chenxi-z/de-drms/README.md

# DE-DRMS — 双电极直流电阻测量仪

> **2026-11-04：直流首板 + 扫频预留。** 当前固件已接通测量、参考校准、TF记录和双通信口，并提供主机回归与CSV解码工具；实板性能尚待验收。见[固件使用流程](firmware/DE-DRMS-Code/README.md)和[设计入口](docs/design/README.md)。IOC与原理图/PCB本轮未改，旧性能与旧引脚描述不能当验收依据。

本工作区用于研发一套**双电极直流电阻测量仪**，对两端 MWCNTs 导电网络传感层做**结构损伤分级监测**，
涵盖上位机软件、下位机固件、硬件电路、结构件，以及配套的校准、测试与生产工艺。

测量原理为**恒流激励 + 双通道同步实测**：恒流同时流过传感层与精密电阻 Rsense，
ADC 同步采两者压降，按 `R = (V_sample / V_Rsense) × Rsense` 计算电阻，
参考校准后以 `R=k×V_sample/V_Rsense` 计算。后续损伤等级须由该批试件的 **R/R₀** 标定曲线确定；
当前LED表示运行/记录状态，没有虚构分级阈值（详见 [`docs/design/`](docs/design/README.md)）。

## 当前状态

- 当前器件为 **STM32U575RGT6（1 MB Flash / 786 KB SRAM，无SMPS）** + ADS131A02 双通道同步 ADC，
  USB外设为 **USB_OTG_FS**，记录走 **SDMMC1 4-bit**。TF常电，无I²C/TMP117，PA4保持ADS_CS。
  硬件实装与最新引脚以主文档附录F、`docs/design/pin-assignment.md`和用户EDA为准。
- 固件已实现 ADC 上电/回读/CRC/DMA、有界采集、参考校准和双页Flash保存、FileX记录/滚动/容错、
  USB/USART控制、RTC/电池、按键与安全软关机。默认 **4 kSPS**。实板实测 **64 kSPS 是无损上限**
  （16/32/64 kSPS 均零丢样、零 CRC 错）；**128 kSPS 受 ADC 读取时序限制不可用**，采集入口直接拒绝。
  64 kSPS 连续记录约 68.65 s / 4,393,647 帧已在单张卡上通过；其他卡、1 GiB 实物轮转与掉电恢复仍待验收。
- [机器协议](shared/protocol/de-drms-v1.json)与[人读说明](docs/protocol/de-drms-v1.md)成对维护；
  [CSV解码工具](tools/de_drms_log.py)保留坏帧/丢帧诊断，不将正常关闭误当无损采集。
- 尚须实板验证精度、连续吞吐、晶振裕量、实际卡与掉电恢复、USB枚举/挂起/唤醒。
  **BQ24074当前模式接线不能仅靠EN1满足USB挂起取电要求**。无温度补偿，损伤阈值仍需试件标定。
- EDA由用户维护；上位机GUI、结构与生产工艺仍是后续工作。当前可用串口/USB终端控制和命令行导出CSV。

## 仓库结构

| 目录 | 归属 | 内容 |
| --- | --- | --- |
| `host/` | 上位机 | 仪器控制、测量流程编排、数据记录、报告导出 |
| `firmware/` | 下位机 | 激励源控制、电压/电流采集、通信从机、自检 |
| `hardware/` | 硬件 | 原理图、PCB、BOM、器件库、硬件设计说明 |
| `mechanical/` | 结构 | 外壳、电极夹具、装配图与 3D 模型 |
| `shared/protocol/` | 共享 | 上下位机通信协议的**机器可读**定义（报文、命令集、错误码） |
| `docs/spec/` | 文档 | 产品需求与技术规格 |
| `docs/design/` | 文档 | 系统设计与详细设计 |
| `docs/protocol/` | 文档 | 通信协议的**可读**说明，与 `shared/protocol/` 配套 |
| `docs/user_manual/` | 文档 | 用户手册、操作与维护说明 |
| `calibration/` | 质量 | 校准方法、校准记录、标准器溯源信息 |
| `test/` | 质量 | 测试计划、测试用例、自动化测试脚本 |
| `production/` | 生产 | 烧录、工装、产线测试与出厂记录 |
| `tools/` | 研发 | 辅助脚本与工程工具 |

### 单一事实来源

通信协议存在两份载体，用于避免定义漂移：

- `shared/protocol/` 存放机器可读的权威定义，供固件与上位机直接引用或生成代码；
- `docs/protocol/` 存放面向人的说明文档。

**修改协议时必须成对更新，并在同一次提交中完成。**

## 开发约定

- **分支**：`main` 保持可交付基线；功能与修复使用 `feat/…`、`fix/…` 短生命周期分支。
- **提交信息**：采用 Conventional Commits 风格，例如
  `feat(firmware): 增加 R_ref 自校准流程`。
- **行尾**：仓库内文本统一为 LF，由 `.gitattributes` 固定；Windows 批处理脚本保留 CRLF。
- **缩进**：由 `.editorconfig` 约束，提交前请确认编辑器已启用 EditorConfig 支持。
- **入库范围**：只提交源文件与文档。固件产物（`hex` / `bin` / `elf`）、EDA 输出、
  3D 导出件与编译目录一律不入库；**器件手册、论文、厂商参数表等外部资料一律放 Obsidian 库**
  （`20-硬件工程/`），本仓库不存放；正式发布件如需留档，在对应目录用局部
  `.gitignore` 的 `!` 规则单独放行。
- **入库守卫**：`.githooks/pre-commit` 会拒绝外部资料（pdf/Office/压缩包）与单个 >1 MiB 的文件；
  每个克隆执行一次 `git config core.hooksPath .githooks` 启用。唯一例外：
  `docs/design/diagram/*@2x.png` 示意图预览（给人看的交付件，经确认保留）。
- **空目录**：以 `.gitkeep` 占位；新增目录请沿用同一约定。
- **语言**：文档与注释以中文为主；代码标识符、协议字段与目录名使用英文。

## 待办与未决事项

**已决策**（依据见 [`docs/design/`](docs/design/README.md)）：测量拓扑（恒流测电阻，不做电桥）、
激励（8 µA + Rsense 150 kΩ）、ADC（ADS131A02 双通道同步）、**MCU（STM32U575RGT6，2026-10-28 换型）**、
电源（1S 锂电 + **BQ24074** + 双 LDO）、**温度传感（本版不做，无 TMP117）**、通信（USB FS 双角色）、
**记录（外部 TF 卡，SDMMC1 4-bit，常电无电源开关，E.11）**、
R_ref 自校准电路（TMUX110x 切换）、引脚/时钟/电源域/交互（主文档 E.6–E.9、E.11；**引脚 2026-10-14 全表重排 + 二轮复核**）。

**未决 / 待实测**：

1. **分档阈值**：绿/黄/橙/红判定对应的 R/R₀ 值——需该批试件的 R/R₀–位移标定曲线（客户暂留空）。
2. **温度系数标定**：需实测（论文值 −4 ~ −10 %/℃ 仅作参考）。
3. ~~R_ref 自校准电路~~ **已定稿**；E.10 挂起项：✅ **#1–#5、#8–#10 已清**；
   **#11 ADC 待机 IOVDD 电流**（合法性已定案，只剩数值待上板实测）；
   **#6 方向性 BOM**（设计侧规格已定，价格/库存/交期由用户核实，**含 TF 卡座与卡型号**）、
   ~~**#7 TMP117 连接器**~~ → ✅ 2026-10-28 关闭（本版不做 I²C）；
   **🔴 2026-10-14 新增 #12–#17，当日晚二轮复核已清两项**：✅ **#12 DS14216/SLUS941 五项**
   （PC0=ADC1_IN1/PC1=ADC1_IN2、高阻源 100 nF 电荷池合法、低功耗表号 Table 62/65/68/70、
   BQ24074 PG 脚 = pin 7、SDMMC 仅 PC8–PC12/PD2）与 ✅ **#15**（CRS 用内部 SOF，不占引脚）已销号；
   ~~#16 IOC 时钟源与免晶振矛盾~~ ✅ **2026-10-28 关闭**（首板贴 HSE 16 MHz，HSE-PLL 合法）；
   **#14 SDMMC 时钟源需把 PLL2Q（258 MHz，`SDMMCFreq_Value` 现值 80 MHz）重配到 48 MHz**（阻塞生成代码）；
   **#17 RM0456 四项**（片内 BCD 使能路径 / SMPS 脚处置 / 复位默认稳压器 / **ADC1 采样时间离散档**，②阻塞原理图，④不阻塞）；
   **#13 TF 持续写实测**（768 KB/s 是否丢帧，上板后）；
   **PB4 复位态（2026-10-16 新增）**：PB4 复位后 = NJTRST + 内部上拉（Table 27 注 4）→ 默认 500 mA 须外部下拉保证，原理图阶段核。
4. **"R₀ 的 1%"适用区间**与量程下限：待客户确认。
5. **上位机功能范围**：曲线显示、温度补偿、数据导出；**新增：TF 卡记录文件的格式与取数方式**（走 USB 还是拔卡）。
6. ~~物理链路细节~~ USB FS 已定；供电与充电管理协同已定（E.8）；
   **充电固定 500 mA**（2026-10-22 简化，BC1.2 判档逻辑已删；详见 E.8.4）。
7. **引用标准**：是否需符合特定标准（待评估）。
8. **项目命名**：`DE-DRMS` 正式英文展开与产品型号；单位 Ω/cm² 与 Ω/sq 定义待统一。
9. **爆炸试验线**（若客户需求落实）：与论文体系不同，待澄清后另立方案。
10. **示意图再核**：2026-10-17 已按当时 E.6 修正；2026-10-20 二次重排（ADC 控制簇 PA1/PA2/PA3、USART1 PA9/PA10）与 TMUX1134 整合需再核一遍。

## 许可

尚未确定。
