chenxi-z/de-drms/hardware/sim/ccsource/README.md

# 恒流源 LTspice 拓扑验证（2026-10-13）

验证对象：E.2 恒流激励源的两种候选接法（LTspice 26.1.1 / wine，`ltspice-sim` 批处理）。

## 结论

**定稿接法（变体 A）**：运放同相端 = VSET，反相端 = BSS138 源极（B），Rsense 自源极到地（E = GND），
BSS138 漏极（X 节点）接负载回线。I = VSET/Rsense，与 R_sample 无关。

| R_sample | I（推导自 V_sample/R） | V(b)=V_Rsense | V_sample | V_DS 裕量 | V_G |
| --- | --- | --- | --- | --- | --- |
| 10 kΩ | 7.857 µA | 1.17857 V | 78.57 mV | 2.043 V | 2.710 V |
| 20 kΩ | 7.857 µA | 1.17857 V | 157.14 mV | 1.964 V | 2.711 V |
| 60 kΩ | 7.857 µA | 1.17857 V | 471.43 mV | 1.650 V | 2.713 V |
| 120 kΩ | 7.857 µA | 1.17857 V | 942.86 mV | 1.179 V | 2.716 V |

（Rsense 与 Rsample 两路电流互推一致 <0.001%；VSET = 3.3×200k/560k = 1.178571 V，与 E.2.1 一致。）

**证伪接法（变体 B，原 E.3.1/rref 图字面链：Rsense 在漏极路径、B 经调整管到地）**：
环路为**正反馈**——V(b) 随栅压升高而降低，仿真显示其锁死在零电流态（调整管关断、V(b) 顶到 3.3 V），
不能恒流。理论平衡点 I = (V_T−VSET)/(R_sample+Rsense) 随 R 变 13.2→7.8 µA，且该点不稳定。

**CURR_DIS 暂态**（3 ms 拉高关断 / 8 ms 释放使能，R_sample = 10 kΩ）：
- 关断：<0.2 ms（τ≈30 µs），残流谷值 0.163 µA（满度 2%；VSET 残压 24 mV，与 E.2.1 "VSET≈0" 相符）
- 使能：**0.871 ms** 回到 ±0.1%，无过冲无振铃 → E.3.3 的 ~1 ms 换路预算内（不宽裕，测量窗口前预留 ≥1 ms）

## 性能指标（cc2 套件，2026-10-13；最新拓扑：R_top/R_b 顶端偏置 + K1 + 源极采样）

模型升级：BSS138 电容按手册（Ciss 12.2p/Crss 1.43p）、OPA333 输入电容（差分 2p/共模 4p）。
网表 `cc2_*.net`，一键报告 `python3 perf_report.py`（六项全量）。

| 指标 | 结果 | 备注 |
| --- | --- | --- |
| 负载调整率（1–130 kΩ） | **0.00000 %** | 源极深度负反馈 + Aol 2e6，理想 |
| 电压调整率（3.20–3.40 V） | **1:1 随轨**（6.25%/0.2V = ΔVS/VS） | VSET 比例分压的**设计特性**：电流线性跟轨；比值测量 V_sample/V_Rsense 中抵消，非精度项 |
| 环路增益 | **fc ≈ 248 kHz，PM = 70.1°**；\|T\| 0.1 Hz 处 123.7 dB | 运放输出串联注入（上游 100 Ω/下游栅极 1 GΩ 旁路）；PM 充裕，**无需补偿** |
| 电源纹波响应 | ΔI/I = 0.3030（=1/3.3，ratiometric 理论值），10 Hz–10 kHz 恒定 | 电流纹波与轨纹波保持精确比例 → 双通道**同步采样**下比值抵消成立；100 kHz 起轻微劣化（0.3248） |
| 负载阶跃 10k↔120k（2 µs 边沿） | 峰值 −2.5 %/+3.1 %，**±0.1 % 恢复 1.3 µs** | 源极负反馈本地自稳，运放只做微调 |
| 轨阶跃 ±100 mV（20 µs 边沿） | 过渡 ∓2.9 %/+3.0 %（相对各自新稳态），**恢复 9–10 µs** | 新稳态=比例跟轨值（见②）；测量窗口 ms 级，µs 级瞬态无害 |

**对设计的含义**：动态响应比准静态测量需求快 3 个数量级（最差 10 µs vs ms 级窗口）；
E.3.3 换路 ~1 ms 预算主要消耗在使能建立（0.87 ms，见上节），负载/轨扰动恢复都在 µs 级。
**注意**：④/② 的"电流随轨"意味着两通道必须同步采样才能在比值中抵消电流波动——
ADS131A02 双通道同钟同沿（E.4）正是为此。

方法备忘：`.tran` 首参数是**步长**非时长（`.tran 0 15m 1m 1u`）；LTspice 的 `tstart` 会把
PULSE 时序前移 tstart，暂态判据一律从激励波形实际边沿起算；AC raw 的频率行带 `,0` 尾巴。

## GUI 原理图（ccsource.asc，2026-10-13）

**LTspice 双击打开即可看图并仿真**：定稿拓扑的可视化版本（R_top/R_b 偏置、CURR_DIS、
Vsm 电流表）。由 `gen_asc.py` 程序化生成（引脚坐标/正交布线/T 接全部显式计算），
改动请改脚本再生成，勿手编辑后混用。已验证：网表与 cc2_dc.net 逐节点一致（零 NC）、
I(Vsm)=+7.857 µA、CURR_DIS 关断残流 0.163 µA、恢复 1 µs（PULSE 5–10 ms 高电平，
15 ms 窗口内含完整关断+恢复）。注意：`opamp` 符号引脚顺序是 (invin, noninvin, out)，
宏 `opa333t3` 已按此定义（arg1=反相）；U1 为 3 脚行为宏（内部固定 3.3 V 轨）。

## 文件与再生成

- `models.inc`——行为级模型：OPA333 宏（Aol=2e6→GBW 350 kHz、输出钳位）与线性版（暂态用）；
  BSS138 level-1（VTO 1.25 V 典型）。**拓扑级保真度**，非厂商宏模型。
  2026-10-13/14 增补：`opa391t3`（OPA391 评估，GBW 1MHz）、`opa388t`（跟随器，GBW 10MHz/RRIO）、
  `swNO`（TMUX 行为级，Ron 2Ω/断态 60GΩ=50pA@3V；2026-10-18 起实物为**单颗 TMUX1134**，开关行为等价）、`swsh`（采样保持开关）
- `cca.tpl` / `ccb.tpl`——两种拓扑模板；`cca_tran.net`——CURR_DIS 暂态
- `cc4_*_opa391.net`——OPA391 对照套件；`cc5_*`/`cc6_*`——10kHz 纹波/斩波；`cc7_*`——100ns 冲击；
  `cc8_ramp10ms.net`——10ms 斜坡；`cc10_rate_*.net`——变化率拐点；`cc11_noise.net`——噪声谱
- `fs1_static.net`/`fs2_shock.net`/`fs3_seq.net`——全链三场景（fs3=零点/校准/测量完整时序，是 fs1/fs2 的母本）；
  `fs4_upper.net`/`fs5_lower.net`/`fs6_upper2.net`（含 ADC 满量程削波）——上下限
- `bode_loop.png`/`tran_10khz.png`/`limits_report.png`/`fullchain_report.png`/`range_limits.png`——交付图
- 再生成：`sed "s/{RL}/10k/" cca.tpl > cca_10k.net && ltspice-sim run cca_10k.net`
- 产物（*.raw/*.log、按 RL 生成的 .net）不入库

## 恒流源拓扑与运放选型评审结论（2026-10-13 首评，2026-10-14 终审封存）

**拓扑：维持"运放+NMOS 源极采样低边恒流源"定稿**（四路独立证据收敛：解空间推理、联网器件普查、行为宏仿真、OPA391 实测对照）。替代方案逐一评审排除：
- Howland 电流泵（2026-10-14 深审修正理由）：①**破坏"同一电流"前提**——泵入口节点的反馈分压网络是样品电流的旁流通路（绕过 Rsense 回地），要压到 0.1% 需百 MΩ 级网络，1pF×100MΩ≈10Hz 主导极点+PCB 漏电不可实现；②合规栈多吃 I×R_B≥0.4–0.9 V（比 BSS138 VDS(sat) 0.2 V 差 0.2–0.7 V，R_max 支持度 216k→130–190k）；③无天然关断（需串开关=开关器件回来）。四电阻失配本身反而**不是**理由（被比值抵消）——原"失配直进误差"表述有误，2026-10-14 勘误
- 专用恒流芯片（BCR/AL 系 LED 驱动）：最小档 10–15 mA（BCR401W 实查 0.91 V 压降、AL5809 2.5 V），8 µA 不覆盖——不可用
- REF200 电流参考：固定 100 µA 镜，8 µA 需分流且精度降级——不适用
- LM334（2026-10-14 定量出局）：比值测量能赦免其 +0.33%/℃ 温漂，但 ~1 V 起始压降使合规栈 = 1.18+0.94+1.0 = 3.1 V > 2.47 V——量程崩
- 比例式基准（Rsense 接 ADC REF，2026-10-14 手册钉死）：ADS131A02 的 REFEXT 外基准虽内部带缓冲（原 ADS127L11 的"基准输入电流致命"理由消失），但 **REFEXT 合法输入 MIN 2.0 V / MAX AVDD−0.5 V**（SBAS590E EC 表 VREF 行；TYP 列的 2.5 V **不是上限**，2026-10-14 勘误），V_Rsense=1.18 V 低于 2.0 V 下限；强行抬到 2.0 V 则 I=13.3 µA、合规栈只剩 ≈0.27 V 给样品 → **R_max 缩到 ≈20 kΩ**（计管压降；不计则 ≈35 kΩ，原文"~30k"取的是后者），远低于 120 kΩ 需求；收益（消内部基准 6 ppm/℃）已被 R_ref 校准+TMP117 覆盖——三重出局（范围/量程/收益）
- 无 MOS 方案（2026-10-14 全否）：BJT（基极电流 1/β≈0.5–1% 破坏串流前提）、JFET 恒流二极管（±10–20%、无 8 µA 档、无使能、压降 1–3 V）、运放输出直驱（合规更差、无使能、环路需重验）
- cascode 双管提输出阻抗：负载调整率已 0.00000%，无空间——无必要
- 高边 PMOS：破坏 T 节点偏置架构（E.10#8 定稿）——不改
- LM7705 负压轨技巧（2026-10-14 联网检索唯一真杠杆）：压的是 Rsense 压降项——那是测量对象本身，不可用

**运放：维持 OPA333 定稿**，对照分析：
- 更快零漂（OPA189 1MHz/Iq450uA、OPA378 900kHz/Iq350uA）：恢复已富余 3 个数量级（1.3us vs 1ms 预算），GBW 翻倍无收益，Iq 贵 20 倍——劣
- 纳米功耗零漂 LPV821（Iq~325nA/GBW~8kHz，参数待核实）：省 ~16.7uA IQ 对电池待机有吸引力，但环路 fc 降至 ~8kHz、CURR_DIS/换路建立变慢，Vos max 略高——记录为**待验证低功耗候选**（需官方模型仿真验证 PM 与关断动态后再定；注意模拟轨受控占空比下平均收益微小，仅连续监测模式有意义）
- 非零漂精密（OPA2277 类）：温漂回归软件补偿压力——劣
- **OPA391（2026-10-13 实测行为宏 cc4 套件，用户要求评估"更快建立"）**：GBW 1MHz（3×）确实把 fc 从 248 kHz 提到 564 kHz、负载阶跃恢复从 1.28/1.32 µs 提到 0.94/0.96 µs；**但 CURR_DIS 使能建立 0.887 ms vs 0.888 ms 完全无改善**——使能建立的瓶颈是栅极 1 nF 滤波 × M2 释放后的 RC 充电，与运放 GBW 无关。代价：非零漂（Vos 45µV max vs 10µV）、Iq 23.5µA（+38%）、PM 从 70.1° 降至 60.8°。**结论：用户想要的"更快建立"通过换 OPA391 买不到，若真要压缩使能建立需减小栅极滤波电容或改 CURR_DIS 机构（另行评估）。维持 OPA333。**
- ISL28133（2026-10-13 联网检索）：纸面 OPA333 平替（Iq 18µA/Vos 8µV），GBW 未核实到权威数据——不值得折腾

## 动态与冲击能力（cc5–cc11 套件，2026-10-14）

| 套件 | 内容 | 结果 |
| --- | --- | --- |
| cc5 | 10 kHz 轨纹波 ±100 mV 暂态 | 电流纹波 6.07%（两款运放一致；VSET 1:1 跟轨特性，ADC ΣΔ 平均+比值抵消） |
| cc6 | 10 kHz 斩波使能（50µs 通断） | **不可行**：开窗内电流只爬到 33%（2.58 µA），锯齿波——使能建立 0.887 ms 瓶颈；斩波式激励与现有 CURR_DIS 机构互斥 |
| cc7 | 100 ns 边沿负载突变（冲击最坏） | 峰值偏差 −42.9%（寄生电容位移电流，与运放无关：OPA333/OPA391 均同值）；±0.1% 恢复 1.2 µs |
| cc8 | **10 ms 斜坡 R 10k→120k（用户实际冲击场景）** | **跟踪误差 <0.000023%**，电流偏差 0.00015%——零改动胜任；用户确认冲击为 10 ms 级 |
| cc10 | 变化率拐点扫描 | ≥10 µs 变化误差 <0.003%；5 µs→0.013%；1 µs→0.29%（µs 级由比值逐点抵消兜底） |
| cc11 | 输出电流噪声谱 | ~0.5 pA/√Hz → 64 kHz 带宽内 0.13 nA RMS = **0.0016% 噪声底** |

**µs 级突变的机理结论**：−43% 尖峰是 C·dV/dt 位移电流（MOS 管仅占寄生一小份，样品分布电容/布线/ADC 前端占大头，换任何激励源都在）；但比值测量逐点抵消电流畸变——**R=(V_sample/V_Rsense)×Rsense 在每个采样点成立，与恒流恢复与否无关**。

## 全链与极限仿真（fs 套件，2026-10-14）

全链 = 恒流源+K1–K4 开关网络（TMUX 行为级含 50 pA 断态漏电）+R_ref 100k+3×OPA388 跟随器+1k/10n RC+ADC 行为模型（130k 差分负载+500 µV 失调+128kSPS 采样保持+满量程削波）。δ0/k/R 全部由 LTspice 内部采样保持电路实时计算（行为源 B_*），probe 只读数。

| 套件 | 场景 | 结果 |
| --- | --- | --- |
| fs3 | 零点→校准→测量完整时序（E.3.3 固件序列） | **δ0=505.4 µV**（500 ADC+5.4 K2 漏电，与 E.3.4 预算逐项吻合）；修正读数 46999.7Ω @真值 47000Ω = **−0.001%**；未校准 +0.094% |
| fs1 | 静态 R 扫描 10k–120k（六点） | 修正后误差 ≤0.0053%（最差 10k 端）；未校准 +0.60%→+0.011% |
| fs2 | 10 ms 冲击全链（含 ADC 采样） | 表面误差 −1.1%@低端为**相位滞后**（全链群时延 ~15 µs = RC 10 µs+采样孔径）；对齐后 **≤±0.045%**，稳定后 0.0000% |
| fs4/fs6 | 上限 120k→1M（fs6 含 ADC 满量程削波） | 比值把上限从合规墙 215k 推到 **~600k**（ADC FS 2.442 V 处 V_sample=2.408 V 贴满）；600k 处 −0.083%，700k 削顶 −1.7%，1M −7.2% |
| fs5 | 下限 10k→10Ω | **恒定 −0.73Ω 偏置**（K2 漏电 5.4 µV 机制实测复现=E.3.4 预算下沿）；1% 线在 **73Ω** |

**测量能力定版（2026-10-14 按手册 INL 修正位定级）**：设计量程 10–120 kΩ（≤0.005%）；1% 可用范围 **~73 Ω–600 kΩ**（4 个十倍程）；定级**随 R 变**——**@120 kΩ ≈4½ 位精度**（fs1 实测 ≤0.0053 % = 53 ppm，恰贴 4½ 位线 50 ppm；INL 折算 21–52 ppm 同量级）、**@10 kΩ 降到 4 位（typ 248 ppm）/ 3½ 位（max 621 ppm）**，INL 主导；**5½ 位分辨率**（准静态，分辨率≠精度，不可混称）；全速冲击 4 位。绝对精度锚定 R_ref 单点（**Rsense 在 k 校准中约掉**，E.3.2 公式展开）。
> INL 手册值 **TYP 8 / MAX 20 ppm FS**（SBAS590E DC PERFORMANCE，best fit）。原文写"4½ 位精度（0.002–0.01 % 测标准电阻）"有两处问题：① 未按 R 分档，② 0.002 % = 20 ppm **低于 INL 硬底**（@120 kΩ 就有 21–52 ppm），故一并更正。位级约定：4½ 位 ≤50 ppm、5½ 位 ≤5 ppm。

**ADC 噪声定级（手册 SBAS590E Table 1，3.3V/2.442V/Gain=1）**：OSR=32（128kSPS）**96.82 µVrms** → 全速单点绝对分辨率 σ_R=96.82µV/7.857µA=**12.3 Ω 恒定**（与 R 无关：σ_V/I）；64 点滑窗（0.5ms）1.5Ω；OSR=4096（1kSPS）1.82µV→0.23Ω。**10Ω 分辨与全速互斥**（单点 SNR<1）；固件策略：冲击全程 128kSPS 采满、按需数字降采样。

**采样保持实现备忘**：LTspice 无内置 sample()/hold()——用 SW 开关+电容自建；保持电容须 ≥10nF（1pF 会被求解器 gmin 漏掉，τ=1s 拉向邻电位）；.step 多段 raw 按 V(rtrue) 唯一值分段解析；首行必须是标题注释（否则 .inc 被吞）。

## 真实器件模型接入状态（2026-10-13）

| 器件 | 状态 |
| --- | --- |
| U1 OPA333 | ⚠️ **TI 官方 OPAx333.LIB（SBOC084G Rev.G）在 LTspice 判不可用**：DC OP 收敛失败，或收敛到**非物理解**（I=+23.3uA，理论 7.857；V(b)=nan）——1F 级建模电容+浮地 MID 节点与 LTspice 求解器不兼容。官方宏接入结构与 wrapper 保留在 models.inc/OPAx333.LIB 备用；**仿真结论以行为宏 opa333t3 为准**。如需官方宏级验证用免费 PSpice for TI |
| M1/M2 BSS138 | 🔸 onsemi 官方模型反爬未获取（直链 403/Nexperia 加密/Wayback 无存档），暂用 `nmosb` 行为级（VTO/KP/电容按手册） |
| K1-K4 | 🔸 实物已整合为**单颗 TMUX1134**（2026-10-18，替换原 TMUX1101×2+TMUX1102×2）；仿真仍用 `swNO` 行为级。TMUX1101 官方 PSpice（SCDM242）曾接入实测：网表连接正常但开关不导通（I=0.15uA 恒定）——TI 导出模型与 LTspice 兼容性问题，未解决。2Ω 电阻/行为开关等效已足够（Ron 已含） |
| TMUX1134 | 🔸 无官方 PSpice；按 `swNO` 行为级（SEL1/2/3 同沿、SEL4 独立）等效 |

**当前使用行为级模型**（手册典型参数），结论对拓扑判定与 DC 精度充分；官方模型接入只需两步：
`SYMATTR Value` 改型号名 + `.include` 官方库。

已尝试失败的自动获取路径（厂商反爬全被挡）：
- TI OPA333：lit/zip 编号无法确定（tools-software 页 JS 渲染，sbom030 猜测为 ISO120 他件）
- onsemi BSS138：pub/Collateral 与 download 直链全 403
- Nexperia BSS138.prm：下载到的是加密 Challenge HTML
- Diodes Inc：403；mikrocontroller 附件：403；Wayback：429 限流
- LTspice 26 内置库（MDX）：实测无 BSS138、无 OPA333

**人工获取路径**（浏览器 30 秒任选其一，拿到文件放本目录即接入）：
1. TI 官网 OPA333 产品页 → Design & development → Simulation models → 下载 zip
2. onsemi BSS138 产品页 → Simulation models → 下载 .lib
3. SnapEDA（免费注册）两个器件都有 SPICE 模型

## 后续

- 官方模型到手后重跑 cc2 套件复核（重点：真实 Vos/Ib 下 DC 精度、PM 定量、SR 暂态）
- 原理图定稿后按实际网表回归
