chenxi-z/de-drms/docs/design/mcu-selection/README.md

# MCU 选型记录

版本 1.5 · 2026-10-14 · 状态：**已定版 STM32U545RET6Q**

> 本文件记录双电极电阻测量仪主控 MCU 的选型过程、候选对比与决策依据。
> 已定型号写入 [信号链文档 附录 E.5](../2026-10-10-universal-signal-chain.md)。
>
> **v1.1 修订（2026-10-12）**：§4 原以裸列编号引用数据手册
> （`DS14217/DS14216/DS12589/DS12288/DS13122`），未标注归属、易被误读
> （尤其 `DS14217` 属 **STM32U535**，并非定版型号的手册号）。
> 已逐份核对 **ST 官方 PDF 页脚**，改为"型号: 手册号"对应写法。
>
> **v1.2 修订（2026-10-13）**：§2、§3 的低功耗数据改为本板适用值——RGT6 不带 SMPS（型号带 `Q` 后缀才带），
> 按 DS13737 的 LDO 版表格、VDD 3.3 V 取值；§5 第 3 项已销号。
>
> **v1.3 修订（2026-10-14 初版）**：定版型号由 RGT6 改为 RET6Q（SMPS 版）。
>
> **v1.4 修订（2026-10-14 定稿）**：定版型号修正为 **STM32U545RET6Q**（U545 系列、LQFP-64、SMPS 版）。
> U545 与 U575 同族同封装同引脚，区别在 Flash/SRAM 容量（512 KB / 274 KB vs 1 MB / 786 KB）；
> 本设计 512 KB Flash + 274 KB SRAM 已足够，无需 U575 的过剩容量。
> 手册号为 **DS14216**（STM32U545xx），非 DS13737（STM32U575xx）。
>
> **v1.5 修订（2026-10-14 二轮复核）**：§2/§3 低功耗数值按 **DS14216** 更正——v1.2 起沿用的
> Shutdown 0.16 / Standby 0.21 / Stop3 1.9/4.3 µA 出自 U575 的 DS13737，在 DS14216 任何表查无出处；
> USB 外设正名 **USB_DRD_FS**（双角色，设备模式片内支持 BC1.2 BCD，非 F4/F7 系 OTG_FS）。

## 1 选型需求

| 需求 | 说明 |
| --- | --- |
| USB | USB FS（设备）以上，用于上位机通信与数据上传 |
| **大 RAM** | 支持"大内存计算"（用户提出），需显著大于 G4 的 32 KB |
| 低功耗 | 手持便携、锂电供电；用户明确"倾向低功耗设计，做一次尝试" |
| SPI / I²C | SPI↔ADS131A02（ADC）、I²C↔TMP117（温度） |
| 定时器 | 触发 ADC 转换、控制模拟开关/校准切换 |
| 存储 | 校准系数持久化（Flash EEPROM 仿真即可） |
| 封装 | 手持设备，优先 7×7 或 10×10 mm |
| 不需要 | G4 那类内置运放/比较器/12 bit ADC（模拟前端为外置专用高精度方案） |

## 2 候选对比

价格取自立创商城（2026-10-12 查询，单位人民币；**价格与库存随时段变化，采购前须复核**）。
规格中标注"手册核实"者来自 ST 官方数据手册；未标注者**尚未从手册核实**，仅供参考。

| 型号 | 内核 | Flash | **SRAM** | USB | 封装 | 价格 | 库存 | 低功耗 |
| --- | --- | --- | --- | --- | --- | --- | --- | --- |
| **STM32U545RET6Q** ✅ | M33 160 MHz | **512 KB**（手册核实） | **274 KB**（手册核实） | FS 双角色（DRD） | LQFP-64 (10×10) | 待查 | 待查 | 旗舰（3.3 V 下 Shutdown 0.40 µA，DS14216 Table 70） |
| STM32U575RGT6 | M33 160 MHz | 1 MB | 786 KB | OTG FS | LQFP-64 (10×10) | ¥35.16 | 64 | 旗舰（同族，容量过剩） |
| STM32U545CET6Q | M33 160 MHz | 512 KB | 274 KB（同族手册核实） | FS 主机/设备 | LQFP-48 (7×7) | 未取（库存 0） | 0 | 旗舰 |
| STM32U545CEU6Q | M33 160 MHz | 512 KB | 274 KB | FS 主机/设备 | UFQFPN-48 (7×7) | ¥36.95 | 0 | 旗舰 |
| STM32U535CEU6 | M33 160 MHz | 512 KB | *(未核实)* | FS 设备 | UFQFPN-48 (7×7) | ¥59.67 | 21 | 旗舰 |
| **STM32G431CBU6** | M4 170 MHz | 128 KB（手册核实） | **32 KB**（手册核实） | FS 设备 | UFQFPN-48 (7×7) | ¥35.99 | **2575** | 中 |
| STM32G474CBT3 | M4 170 MHz | 512 KB | 128 KB *(未核实)* | FS 设备 | LQFP-48 (7×7) | ¥34.58 | 162 | 中 |

### 2.1 关键发现

1. **SRAM 分水岭明显**：G431 仅 32 KB；U535/U545 为 160–274 KB；U575 为 786 KB。
   用户要求"大内存"，G431 直接出局。
2. **U5 系列普遍缺货**：查询时 U535 库存 21、U545 LQFP-48 变体库存 0；
   U575RGT6 库存 64（相对可用）。最终选定 **U545RET6Q**（LQFP-64 SMPS 版）。
3. **U5 同时满足"低功耗尝试"与"大内存"**，把用户先后提出的两个目标统一了。
4. **U545 vs U575**：同族同封装 pin-to-pin 兼容，U545 的 512 KB / 274 KB 对本设计已足够，
   无需 U575 的 1 MB / 786 KB 过剩容量。

## 3 决策：STM32U545RET6Q

**理由**：

- **274 KB SRAM** 满足大内存需求，是 G431 的 8.5 倍；
- **U5 旗舰低功耗**（DS14216，VDD 3.3 V、25 ℃ 典型、LDO 稳压：Shutdown **0.40 µA**（Table 70）、
  Standby **0.52 µA**（Table 68）、Stop 3 **4.6 µA**（8 KB SRAM2）/ **7.7 µA**（全 SRAM）（Table 62）；
  SMPS 稳压可至 1.55/2.30 µA（Table 65），本设计不启用），契合低功耗目标；
- **USB FS 双角色**（USB_DRD_FS，设备/主机；设备模式片内支持 BC1.2 BCD）满足通信，比纯设备模式灵活；
- **512 KB Flash** 容纳固件 + 校准系数 + 数据缓存；
- **LQFP-64（10×10 mm）** 引脚充裕、好焊；
- **SMPS 版**（型号后缀 Q），本设计用外部双 LDO 供电、内部 SMPS 未启用；
- 模拟前端为外置专用方案，**G4 的内置模拟外设对本设计是冗余**，选 G4 不为这些买单。

**放弃理由**：

- **STM32G431CBU6**：RAM 仅 32 KB，不满足大内存（但其生态最成熟、库存最足，可作降级备选）；
- **STM32U535**：RAM 较小、价格最高、库存少；
- **STM32U575RGT6**：1 MB Flash / 786 KB SRAM 过剩，本设计 512 KB / 274 KB 已足够。

## 4 pin-to-pin 兼容性（重要结论）

**STM32U5 与 STM32G4 之间没有官方 pin-to-pin 兼容的型号对。**
经逐引脚比对官方数据手册（**STM32U535: DS14217** / **STM32U545: DS14216** /
**STM32G431: DS12589** / **STM32G474: DS12288** / **STM32G491: DS13122**；
五个编号均经 ST 官方 PDF 页脚逐一核对）：

> 注：上列 5 份是本次逐引脚比对所依据的手册。
> **本设计定版型号 STM32U545xx 的手册号是 `DS14216`，与 U535 的 `DS14217` 不同，勿混淆**；
> U545 未参与上述 U5↔G4 的逐引脚比对（该比对使用 U535 为代表）。

- ST 未发布 U5↔G4 迁移应用笔记（AN5371 是 L5→U5、AN5766 是 U5 系列内、AN5094 是 F3→G4）；
- 最接近的是 **UFQFPN48 下 U535 ↔ G431**，但存在致命冲突：
  **pin21 在 U5 上是 VCAP（内核 LDO 输出，须接 4.7 µF 到地，禁止外供电），
  在 G4 上是 VDDA（须接模拟电源）**——直接互换会损坏 U5 或使 G4 模拟部分断电；
- 另有 pin20（PB2 vs VREF+）、pin5/6（PH0/PH1 vs PF0/PF1 振荡器）、BOOT0 脚位差异；
- LQFP48/LQFP64 下电源引脚整体错位，更无法互换。

**结论：不存在"PCB 一次设计、U5/G4 互换"的方案，本设计按 U545RET6Q 单一定版。**
若未来需要降级到 G4，必须重新设计 PCB。

## 5 待办 / 未核实项

1. STM32U535、G474 的 SRAM 数值**尚未从数据手册核实**（本文件如实标注）；
2. 采购时需复核 U545RET6Q 的价格与库存（立创渠道，PCB 投板前确认）；
3. ~~引脚分配、时钟方案、电源域划分待细化~~ → **已于 2026-10-12 定稿**（信号链文档 E.6–E.8，E.5.5 已销号）。

## 6 数据手册存档

`STM32U545.pdf`（ST 官方 STM32U545xx 数据手册，DS14216）已推送至
Obsidian 库 `20-硬件工程/datasheets/`（Obsidian 的整理由专门会话负责）。
