chenxi-z/de-drms/docs/design/2026-10-10-universal-signal-chain.md

# 双电极电阻测量仪 通用信号链方案（重构式）

> **当前实施以[附录 F](#dc-prototype)为准。以下旧正文/附录 A–E 为历史分析，不能直接当成已确认性能或当前接线。**

版本 V3.0-signal-chain · 2026-10-10 · 状态：**信号链架构，应用参数挂起**

> 本文档替代 V2.2 的单一应用设计。V2.2（MWCNTs 准静态 SHM，按论文参数）**作为本信号链的
> 一种配置挂起**，未作废，见附录 C。
>
> **背景**：需求存在多个互相冲突且未证实的版本——论文（相对量，无绝对电阻）、
> 客户爆炸试验（口头 200 kΩ + 几 kΩ 变化，未证实）、单位歧义（Ω/sq vs Ω/cm vs Ω/cm²，
> 导致 R₀ 估算差 10 倍）。在这些确认前，不锁定任何单一参数。
>
> **设计哲学**：所有不确定的量——被测电阻 R₀（10 Ω – 1 MΩ）、激励电流（1 µA – 10 mA）、
> 增益（×1 – ×128）、采样率（10 SPS – 100 kSPS）——**全部做成可编程**。
> 硬件一次到位覆盖全部情形，应用落地时仅改配置，不改硬件。

## 1 设计目标

| 维度 | 覆盖范围 | 说明 |
| --- | --- | --- |
| 被测电阻 R₀ | **10 Ω – 1 MΩ**（5 个数量级） | 覆盖论文（估 10²–10³ Ω）到客户（200 kΩ） |
| 相对变化分辨 | 0.1% – 1% @ R₀ | 覆盖阶段 I 亚%预警 |
| 动态范围 | ≥ 100×（ΔR/R₀） | 覆盖论文 121.64 |
| 时间尺度 | 准静态（分钟级）– 瞬态（ms 级） | 双模式固件 |
| 激励电流 | 1 µA – 10 mA 可编程 | 按 R₀ 选档 |
| 采样率 | 10 SPS – 100 kSPS 可设 | 准静态/瞬态双模式 |

## 2 信号链总架构

```
                     ┌───────────────── 模拟高压轨 9–12 V ─────────────────┐
                     │                                                      │
  DAC ──▶ VSET ──▶ ┌──────────┐  I_set   ┌────┐   ┌────┐                  │
 (可编程)          │ 恒流源环路 │─────────▶│左钳│──▶│样品│  Rx              │
                   │ OPA192   │  1µA–10mA └────┘   └────┘                  │
                   │ +Q2+MOS  │              │        │                    │
                   │ +Rsense  │              │  电极根部差分取样              │
                   │ (多档切换) │              ▼        ▼                    │
                   └──────────┘      ┌──────────────────┐                 │
                       │             │ 输入保护(低漏电<1nA) │                 │
                       │             │ + 抗混叠 RC         │                 │
                       │             └────────┬─────────┘                 │
                       │ Rsense                │ 差分 V                     │
                       ▼                      ▼                           │
                   ┌──────────────────────────────────┐                  │
                   │   可编程增益前端 (PGA ×1–×128)       │                  │
                   │   CH0: V_sample                    │                  │
                   │   CH1: V_Rsense (实测 I)            │                  │
                   │   CH2: (预留, 温度/参考)             │                  │
                   └────────────────┬─────────────────┘                  │
                                    │                                    │
                   ┌────────────────▼─────────────────┐                  │
                   │  宽带 24bit ADC (同步/多通道)        │                  │
                   └────────────────┬─────────────────┘                  │
                     └───────────────┼───────────────────────────────────┘
                                     │ SPI/LVDS
                     ┌───────────────▼─────────────────┐
                     │  MCU：选档/增益/采样率配置          │
                     │  双速率引擎(抽取+触发)  温度采集     │
                     │  R(t)=V/I  环形缓冲  USB上传       │
                     └───────────────┬─────────────────┘
                                     │ USB / UART
                     ┌───────────────▼─────────────────┐
                     │  上位机：ΔR/R₀ 曲线  温度补偿       │
                     │  阶段识别  数据导出                 │
                     └──────────────────────────────────┘
```

## 3 信号链各级设计

### 3.1 激励级：可编程恒流源

| 参数 | 设计 | 理由 |
| --- | --- | --- |
| 拓扑 | OPA192 + NMOS(BSS138) + 多档 Rsense | 36 V 耐压，低 Ibias(pA) |
| 电流档 | 1 µA / 10 µA / 100 µA / 1 mA / 10 mA（继电器/模拟开关切换 Rsense） | 覆盖 10 Ω–1 MΩ |
| 设定 | DAC（或 PWM+滤波）给 VSET | 电流细调 |
| 关键约束 | 电流档在**静态校准段选定并冻结**，窗口内不切 | 防毛刺/建立缺口 |

**合规电压与模拟轨**：最高档信号决定模拟轨。
- 1 MΩ × 10 µA = 10 V；200 kΩ × 10 µA = 2 V；10 Ω × 10 mA = 0.1 V。
- 取 **模拟高压轨 12 V** 覆盖最不利组合（留 Vds/开关/引线裕量）。

### 3.2 取样级：电极根部差分 + 低漏电保护

- **取样点**：电极根部（沿用论文导电银胶 + 铜电极两端取样），排除引线与开关电阻。
- **输入保护**：低漏电 ESD 器件，漏电 **< 1 nA**。
  > 高阻端（1 MΩ）下 10 nA 漏电 = 1% 误差，必须严控——这是高 R₀ 端的头号误差源。
- **抗混叠 RC**：截止频率按最高采样率模式配置，高阻节点加**保护环（guard）**。

### 3.3 增益级：可编程增益前端

- **PGA ×1 – ×128 可编程**，增益在静态校准段选定并冻结。
- 目标：使基线信号落在 ADC 满度的 10–80%，动态 100× 后仍留余量。
- **V 与 I 通道可不同增益**（基线信号大、Rsense 信号小），增益比固定 → 校准吸收。

### 3.4 转换级：宽带 24 bit ADC

- **推荐 ADS1262/ADS1263（24 bit、38 kSPS、PGA、多通道、50/60 Hz 抑制）**——
  一颗芯片同时覆盖准静态（低速高分辨）与较快瞬态（38 kSPS）。
- 若确认需要 ≥100 kSPS 真瞬态：换 **AD7175-2（250 kSPS）** 或并联 SAR（AD4003）。
- 模拟供电 5 V + 外部基准；SPI 与 3.3 V MCU 间电平转换。
- **V/I 同步采样**（多通道同时或快速交替），逐点 R(t)=V/I。

### 3.5 数字级：双速率引擎 + 可配置

```
ADC 原始流 ──┬── 抽取滤波 → 低速高分辨流（准静态模式，看亚%渐变）
             └── 环形缓冲 → 斜率触发 → 高速原始段（瞬态模式，抓突变）
```

- 采样率、抽取比、触发阈值全部**软件可设**。
- 同一套硬件：配成低速高分辨 = 论文 SHM 模式；配成高速触发 = 瞬态/爆炸模式。

### 3.6 温度级

- 内置温度传感（TMP117 / NTC），贴近被测件，随测量同步采集。
- 上位机按实测温度系数做 ΔR/R₀ 温度归一化（论文：−4 ~ −10 %/℃）。

## 4 全情形覆盖矩阵

| 情形 | R₀ | 激励档 | 增益 | 采样率 | 配置说明 |
| --- | --- | --- | --- | --- | --- |
| **论文 SHM 准静态** | 10²–10³ Ω（估） | 1–10 mA | ×1–×8 | 10–100 SPS | 低速高分辨 + 温度补偿 |
| **论文 SHM（若 R₀ 上探 kΩ）** | 10³–10⁴ Ω | 100 µA–1 mA | ×1–×4 | 10–1000 SPS | 同上 |
| **客户爆炸（若属实）** | 200 kΩ | 10 µA | ×2–×8 | 高速触发 | 小信号叠加大基线，需高分辨 |
| **未知高阻** | 10⁵–10⁶ Ω | 1–10 µA | ×1–×4 | 视速率 | 严控漏电 |
| **未知低阻** | 10–10² Ω | 10 mA | ×8–×128 | 视速率 | 大电流抬信号 |

**结论：一套可编程硬件覆盖全部已设想情形，应用落地仅改配置。**

## 5 误差预算（通用，按最不利情形）

| 误差来源 | 最不利情形 | 量级 | 对策 |
| --- | --- | --- | --- |
| 保护器件漏电 | 高 R₀（1 MΩ） | 1%/10nA | 低漏电器件(<1nA)+保护环 |
| 温度漂移 | 阶段 I 亚%信号 | −4~−10%/℃ | 温度传感+上位机补偿+现场标定 |
| 恒流源稳定性 | 瞬态/长试验 | 慢漂移 | 实测 I 代入，逐点消除 |
| ADC 噪声 | 低速高分辨 | 亚µV(平均后) | PGA+数字平均 |
| 接触电阻 | 低 R₀ 端 | mΩ级 | 相对 kΩ 基线可忽略 |
| 基准漂移 | 全程 | — | 比例测量 V/I 抵消 |
| R₀ 个体离散 | 低浓度配方 | >±10% | 每次实测 R₀ |

## 6 关键器件方向性 BOM

| 位号 | 器件 | 方向性型号 | 说明 |
| --- | --- | --- | --- |
| U1 | 运放 | OPA192/OPA197 | 恒流源，36 V 耐压 |
| Q2 | NMOS | BSS138 | 调整管 |
| U2 | 电流换档 | TMUX61xx/继电器 | 多档 Rsense |
| U3 | ADC | **ADS1262/3**（或 AD7175-2/AD4003） | 宽带 24 bit |
| U4 | MCU | STM32G4/H5/F7 | 双速率引擎+USB |
| U5 | 前置/PGA | 内置于 ADC 或 OPA388 | 可编程增益 |
| U6 | 温度传感 | TMP117 / NTC | 温度补偿 |
| R_sense | 精密电阻 | 多档，0.1%，低温漂 | 电流选档 |

> ⚠️ 上表是 **V3.0 通用框架**的方向性 BOM（为覆盖多应用而列，含多档电流、宽带 ADC 等）。
> **本设计（附录 D / E）的已定型号与此不同**：ADC = **ADS131A02**、MCU = **STM32U575RGT6**（2026-10-28 换型）、
> 恒流源运放 = **OPA333**、跟随器 = **OPA388 ×3**（1S 锂电低压轨）、激励 = **单档 8 µA + Rsense 150 kΩ**。
> **具体实现一律以附录 E 为准。**

## 7 冻结 vs 待定

**冻结（不随应用变）**：信号链拓扑、可编程激励、可编程增益、宽带 24 bit ADC、
双速率引擎、V/I 同步、温度传感、低漏电保护、电极根部取样。

**待定（随应用配置，需实测/客户确认）**：

1. **R₀ 实际范围**——用实际试件万用表实测两端电阻，一次定死（消除 10 倍单位歧义）。
2. **采样率/时间尺度**——论文准静态 vs 客户爆炸瞬态，定固件默认模式。
3. **精度指标**——阶段 I 分辨目标（0.1% / 0.5% / 1%）。
4. **温度系数**——被测材料体系实测标定。
5. **电源形态**——12 V + 5 V + 3.3 V 的供电方式。
6. **爆炸试验线**——200 kΩ 基线、几 kΩ 变化、µs 瞬态、火工品安全约束，待客户澄清。

## 附录 A 单位与 R₀ 估算的不确度

- 论文浓度图纵轴单位（Ω/sq vs Ω/cm vs Ω/cm²）含义不明，导致 R₀ 估算差 **10 倍**。
- 估算（方阻 × 长宽比）：论文项目传感层总电阻约 **10²–10³ Ω**，上探 10⁴ Ω。
- **此估算仅为量级参考，必须实测确认**（见第 7 节待定项 1）。

## 附录 B 与 V2.2 的关系

| 项 | V2.2（单一应用） | V3.0（信号链） |
| --- | --- | --- |
| 定位 | MWCNTs 准静态 SHM 专用 | 通用可重构信号链 |
| 激励 | 1 µA–1 mA 选档 | 1 µA–10 mA 选档（扩） |
| R₀ | 几 kΩ–200 kΩ | 10 Ω–1 MΩ（扩，含估算不确度） |
| 采样率 | 10–1000 SPS | 10 SPS–100 kSPS（扩） |
| ADC | ADS124S08 | ADS1262/3（或更快） |
| 温度补偿 | 有 | 有（沿用） |
| 状态 | **挂起，作为本链一种配置** | 当前主架构 |

## 附录 C V2.2 配置（挂起的论文 SHM 模式）

激励 1 µA–1 mA / 增益 ×1–×8 / 采样率 10–1000 SPS / 温度补偿开 / 双电极两线制 /
阶段 I 亚%分辨 / 阶段 II 120× / ΣΔ 24 bit。参数依据论文，R₀ 待实测。

---

# 附录 D 配置一：结构损伤分级监测仪（客户已确认需求）

> 来源：客户 2026-10-10 书面回复。这是 V3.0 信号链下**第一个需求明确、可落地的具体配置**。
> 与论文体系（图 5.4 位移—ΔR/R₀ 单调上升）一致。本配置只用到 V3.0 可编程框架的一部分，
> 比通用大框架更省、更实。

## D.1 已确认的指标

| 项目 | 指标 | 客户原话/依据 |
| --- | --- | --- |
| 初始电阻 R₀ | **10 – 20 kΩ**，编程可设、每次实测 | "初始电阻可控制在 10–20 kΩ，R₀ 可通过编程修改" |
| 上限电阻 | **60 – 120 kΩ**（30 mm 位移时 R/R₀ ≈ 6×） | "压缩位移 30 mm 时 R/R₀ 一般是 6 倍，即 60–120 kΩ" |
| 动态范围 | **6×**（R/R₀：1 → 6） | 同上 |
| **测量精度** | **R₀ 的 1%** | "精度要求是 R₀ 的 1%"（对 10 kΩ 即 100 Ω，对 R/R₀ 即 0.01） |
| 测量方式 | 双电极两线制，准静态连续 | 压缩 30 mm 为慢过程 |
| 判定输出 | 绿/黄/橙/红四级（**分档阈值留空，待定**） | "分档还没有，先留空" |
| 温度补偿 | **内置温度传感（确认要加）** | "温度传感器要加" |
| 判断基准 | **R/R₀ 无量纲比值**（解决个体离散） | "不同结构制作电阻无法完全一致，判断标准设成 R/R₀" |

## D.2 由指标推导的信号链配置

### D.2.0 拓扑决策（2026-10-10 已确认）

**被测对象确认为论文那种两端 MWCNTs 传感层（导电银胶 + 铜电极引出的电阻条）。**
因此拓扑定为**恒流测电阻**，**不做电桥**——两端电阻条物理上无法自然成桥，
硬加参考电阻反而引入匹配误差与温度补偿难题。
恒流激励 + 实测电流代入（R = V/I_实测）是最自然、最干净的拓扑。

| 环节 | 配置 | 详见/说明 |
| --- | --- | --- |
| **测量拓扑** | **恒流激励 + 双通道同步实测**（不做电桥） | D.2.0、E.4 |
| 激励电流 | **8 µA 固定**（外部 OPA333+MOS 恒流源，不用 ADC 内置 IDAC） | E.2 |
| Rsense | **150 kΩ，0.1% 精密，低温漂** | E.2、E.3 |
| **ADC** | **ADS131A02**（2 通道**同步采样**、24 bit、128 kSPS、内部 2.442 V 基准） | E.4 |
| 增益 | 用 ADS131A02 内置 PGA；本设计信号 80 mV–1.2 V，**增益 1 即落在量程内**（勘误：原文"±1.2 V"有误，实际量程 ±2.442 V，信号占 40–49 % FS） | E.4 |
| 采样率 | 最高 128 kSPS；准静态按需降速 + 数字平均降噪 | E.4 |
| 动态/增益切换 | **测量窗口内不切换**（固定设置） | D.2.0 |
| 模拟轨 | **3.3 V 单轨**（1S 锂电 + 双 LDO） | E.1 |
| 温度传感 | ~~TMP117~~ **本版不做**（2026-10-28）；无温度补偿，测量按恒温/短时口径 | E.5 |
| **MCU** | **STM32U575RGT6**（2026-10-28 换型；M33 160 MHz，**1 MB Flash**，**786 KB SRAM**，USB FS 双角色，LQFP-64） | E.5 |
| 分档逻辑 | **留空**（阈值标定后由上位机/固件配置） | 客户确认"先留空" |

## D.3 温度补偿（必须做，否则精度达标无意义）

论文实测该类材料温度系数 **−4 ~ −10 %/℃**，而精度要求是 **1%**、绿档阈值附近信号约 5%。
**1℃ 漂移即超过精度指标 4–10 倍，会把绿档冲成黄档。**

对策：

- 内置温度传感，每次测量同步记录温度；
- 上位机按实测温度系数对 R/R₀ 做归一化；
- **温度系数需用该批试件现场标定**（论文值 −4.24 %/℃ 仅作参考）。

## D.4 误差预算（对照 1% 精度）

| 误差来源 | 量级 | 是否满足 1% |
| --- | --- | --- |
| **温度漂移** | −4~−10 %/℃ | **不加补偿则不满足 → 温度补偿为必须** |
| ADC 噪声（24 bit + 平均，10–50 SPS） | < 0.01% | ✓ 富余 |
| ADC 失调（500 µV typ，2026-10-13 补列） | 零点校准后残余：典型 ≈0.03 %、最坏 ≈0.12 % | ✓（E.3.3 零点模式，残余明细见 E.3.4） |
| 恒流源稳定性 | 实测 I 代入消除 | ✓ |
| 基准漂移 | 比例测量 V/I 抵消 | ✓ |
| 保护器件漏电（<1 nA） | 120 kΩ × 1 nA = 0.12 mV ≪ 信号 | ✓ |
| 接触电阻（mΩ） | 相对 10 kΩ 基线 ≪0.01% | ✓ |
| R₀ 个体离散 | 每次实测 R₀ + R/R₀ 比值判定 | ✓（设计上消除） |

**结论：除温度外各项均富余；温度补偿是本配置能否达到 1% 精度的决定性环节。**

## D.5 本配置待确认事项

1. **分档阈值**（绿/黄/橙/红对应的 R/R₀ 值）——客户留空，需用该批试件的 R/R₀–位移标定曲线确定。
2. **温度系数标定**——该批试件的实际温度响应曲线。
3. **"R₀ 的 1%"的适用区间**——是全程 1%，还是仅基线附近？（影响低端 R/R₀≈1 处的分辨要求）
4. ~~电源形态~~ → **已定（E.1、E.8）**：1S 锂电 + **BQ24074**（2026-10-28 由 BQ24040 换料）+ 双 3.3 V LDO，无 5 V 轨。
5. **上位机功能**——R/R₀ 曲线、温度补偿、档位显示、数据导出的范围。

## D.6 本配置与 V3.0 通用框架的关系

本配置只启用 V3.0 的一小部分：激励用 8 µA 单档、增益固定（PGA=1）、双通道同步 ADC、
3.3 V 单轨、无多档切换、无双速率引擎。**V3.0 框架保留**，以便后续论文 SHM（附录 C）、
爆炸试验（待澄清）等情形接入；本配置作为**首个落地实现**优先推进。

> 说明：本附录 D 是**应用需求与指标的来源**；具体硬件实现以附录 E（电源/恒流源/自校准/前端/MCU）为准，
> 两者如有冲突，以 E 为准。

---

# 附录 E 原理图方案（2026-10-10 起逐步确定）

> 本附录记录附录 D 配置的原理图级方案，按功能块逐步确定。已定稿块标注 ✅。

## E.1 电源（✅ 定稿）

| 项 | 定案 |
| --- | --- |
| 电池 | 1S 锂电（3.0–4.2 V），**可充电** |
| 充电管理 | **BQ24074**（2026-10-28 换料；带 PowerPath，见 E.8.1/E.8.4）+ 电芯自带保护板 |
| 稳压 | **双 LDO**：数字 TPS7A0233（常开）+ 模拟 TPS7A2033 低噪声（EN 受控），见 E.8.2 |
| 隔离 | 双 LDO 天然隔离数模，无需磁珠 |
| 模拟轨 | 3.3 V：ADS131A02 AVDD 下限 3.0 V（电荷泵关，SBAS590E）；激励合规栈 2.32 V ≤ 栈顶 T 点 2.97 V − 0.5 V（E.2、E.2.1）。（2026-10-13 勘误：原文"ADC≥2.85 V、激励≥2.0 V"与手册及 E.2.1 不符） |

## E.2 恒流激励源（✅ 定稿；2026-10-12 勘误与理由更正）

| 项 | 定案 |
| --- | --- |
| 拓扑 | 运放 + NMOS + Rsense 的**恒流源（低边拓扑）**，单档（勘误：原文"低边电流沉"为生硬直译，弃用）。**接法：运放同相端 = VSET、反相端 = NMOS 源极（B，即 Rsense 顶），Rsense 自源极到地（底端 E=GND），I = VSET/Rsense**；2026-10-13 LTspice 验证：R_sample 10–120 kΩ 全程 I = 7.857 µA（互推一致），VDS 裕量 ≥1.18 V（`hardware/sim/ccsource/`，T 直接接 3.3 V 时；勘误详情见 E.3.1）；加 T 点顶端偏置后复核：10–120 kΩ 内 I 变化 <0.01 %、VDS ≥0.885 V（同一行为级模型，3.3V_A 取 3.25 / 3.35 V 两角）。**动态指标（同日 cc2 套件）**：环路 fc≈248 kHz / **PM 70.1°（无需补偿）**；负载阶跃 10k↔120k 恢复 1.3 µs；轨阶跃 ±100 mV 恢复 9–10 µs；电流 1:1 随轨（VSET 比例分压，**双通道同步采样下比值抵消**，见 sim README「性能指标」） |
| 运放 | **OPA333（✅ 2026-10-13 落定，销 E.10#2）**：Iq 17 µA typ / **28 µA max**、Vos 2/10 µV、漂移 0.02/0.05 µV/℃、Ib ±70/±200 pA、共模超轨 100 mV、GBW 350 kHz、SR 0.16 V/µs、开通 100 µs（TI SBOS351）。**DC 电流环路不需要带宽**，故不选 OPA388（Iq 1.7–2.6 mA，≈100×；其 10 MHz GBW 归 E.4 的 3 颗跟随器） |
| NMOS | BSS138（逻辑电平，50 V 耐压） |
| 电流 | **8 µA**（Rsense = 150 kΩ → V_Rsense = 1.2 V） |
| Rsense | **150 kΩ，0.1% 精密，低温漂（≤25 ppm/℃）**（见 E.3 自校准） |
| VSET | 3.3V_A 经 **360 kΩ / 200 kΩ（1%）** 分压得 **1.179 V**（固定、单档，分压电流 5.9 µA）；**1% 电阻即可**——比值法下电流精度无关，只要求稳定。关断机构见 **E.2.1** |
| 顶端偏置（T 点） | **3.3V_A ─ R_top 10 kΩ ─ T ─ R_b 150 kΩ ─ GND**（1%，0603；**图纸位号 R30 = 10 kΩ（AVCC↔AFE_T）、R40 = 150 kΩ（AFE_T↔AGND）**；2026-10-13 新增，销 E.10#8）：T 是样品与 R_ref 的共用顶端，工作时 2.97–3.07 V、零电流时 3.04–3.15 V，使 T、S、F 各点距 OPA388 电源轨 ≥0.15 V（E.4）；顺带把样品座 T 脚与模拟轨隔开（短路 / ESD 有 10 kΩ 限流）；偏置电流 ≈21 µA，仅模拟域在线时流动 |
| 电流选型依据 | **3.3 V 单轨合规电压决定**（2026-10-12 更正）：合规栈 V_sample(0.96)+V_Rsense(1.2)+管压降 ≈ 2.36 V；栈顶为 **T 点**（经本表"顶端偏置"接 3.3V_A，工作时 ≥2.97 V），余量 ≈0.6 V、满足 ≥0.5 V（全角落精算见 E.2.1）（2026-10-13 勘误：原按"轨 ≥3.44 V、裕量 ≥1 V"计——3.44 V 是电池截止 3.50 V 减数字 LDO 压差，不是栈顶电压）。~~"正好用满内部 1.2 V 基准"~~ 一说**作废**：手册核实内部基准为 **2.442 V**（E.4.2），1.2/0.96 V 仅约 40–49 % FS；两路同时逼近满量程在 3.3 V 轨下物理不可能（理论上限 ~9–10 µA）。曾复核回升 10 µA：合规栈 ≈2.9 V，对栈顶 T（10 µA 时 ≈2.95 V）几乎无余量，**不满足**「≤ 栈顶电压 − 0.5 V」硬约束（2026-10-13 勘误：原文"裕量 ~0.4 V 合法"有误），且无信噪比收益（预算已 >10×），**维持 8 µA** |
| 信号电平 | V_Rsense = 8 µA × 150 kΩ = **1.2 V**（满度）；V_sample = 8 µA × 10 kΩ = **80 mV**（基线）→ 8 µA × 120 kΩ = **960 mV**（满量程），均在 ±2.442 V 量程内（勘误：原文"±1.2 V"有误） |
| 合规电压 | ≈ 2.36 V ≤ T 点 2.97 − 0.5 = 2.47 V ✓（T 取 3.3V_A −1.5% 下限时的工作值；全角落精算见 E.2.1） |
| 关键原理 | R = (V_样品/V_Rsense)×Rsense，**恒流源电流不准不影响 R 精度，只要求稳定** |

> 注：**电流值 8 µA 与 Rsense 150 kΩ 是配套确定的**。改任一值都必须复核：
> ① V_Rsense = I×Rsense ≤ 2.442 V（ADC 基准）；② V_sample = I×R_sample(max) ≤ 2.442 V；
> ③ 合规栈 ≤ 栈顶（T 点）电压 − 0.5 V 裕量；④ T、S、F、B 各点距电源轨 ≥ 0.15 V（跟随器保证区，E.4）——
> T 点由本节"顶端偏置"决定，改 I、Rsense 或模拟轨电压时须一并复核。

> **终审封存（2026-10-14）**：恒流源选型经四路独立证据（解空间推理、联网器件普查、行为宏仿真、
> OPA391 实测对照）收敛，**维持本节定稿，不再评审**。关键补充结论：
> ① 冲击能力（客户 10 ms 级）：R 10k→120k 斜坡全程跟踪误差 <0.000023%，**零改动胜任**；
> 变化率拐点 ≥10 µs 内误差 <0.003%（µs 级突变由比值逐点抵消兜底，尖峰是寄生电容位移电流、
> 与激励源拓扑无关）；② 使能建立 **0.871–0.887 ms**（cc / cc4 两套仿真口径，见 E.3.3）的瓶颈是栅极 1 nF
> 滤波×M2 释放 RC，**换运放不可改善**（OPA391 实测 0.887→0.888 ms）；③ 上限被比值从合规墙 215 kΩ 推到 **~600 kΩ**（ADC 满量程处），
> 下限受 K2 漏电恒定 −0.73 Ω 偏置（E.3.4）；④ 被否方案终版理由（Howland 三条结构理由、
> REFEXT ≥2.0 V、LM334 合规栈 3.1 V、无 MOS 全否、LM7705 打不到本架构）见
> `hardware/sim/ccsource/README.md`「恒流源拓扑与运放选型评审结论」。

### E.2.1 VSET 网络与关断机构（✅ 2026-10-13 定稿，销 E.10#1）

**电路**：`3.3V_A ── R1 360 kΩ ──┬── VSET（→ OPA333 同相端）── R2 200 kΩ ── GND`；
VSET 节点挂 **BSS138**（漏→VSET、源→GND）作关断开关，**栅极经 1 MΩ 下拉**，由 PB10（`CURR_DIS`）驱动。
`CURR_DIS = 高` → NFET 导通 → VSET ≈ 0 → 环路把电流拉至 0；`CURR_DIS = 低` → NFET 关 → 激励正常。

| 项 | 定值 | 依据 / 验算 |
| --- | --- | --- |
| R1 / R2 | **360 kΩ / 200 kΩ，1%，0603** | E24 常用值；分压比 0.357 → VSET = 1.179 V |
| 设定电流 | **7.86 µA** | = VSET / Rsense(150 kΩ)，与标称 8 µA 一致（电流绝对误差无关，E.3.4） |
| 分压电流 | **5.9 µA** | 仅模拟域在线时流动（`ANA_EN` 关断则为 0） |
| 源阻抗 Zth | 129 kΩ | 抗漏电/EMI；OPA333 Ib ≤ ±200 pA(25 ℃)、±150 pA 典型全温 → VSET 偏差 ≤ 26 µV，可忽略 |
| 关断开关漏电 | BSS138 IDSS ≤ 500 nA（@VDS=50 V/25 ℃；此处 VDS≈1.2 V 更低） | 相对分压电流 5.9 µA < 10 %，且电流偏差在比值法中抵消 |
| 栅极下拉 | **1 MΩ** | 复位/高阻时（U5 Ilkg ≤ 200–500 nA，手册 Table 92）栅极 ≤ 0.5 V < Vgs(th) min 0.8 V → **NFET 确定关断 = 复位默认激励开**；关断态耗 3.3 µA |
| 可选滤波 | **≤ 1 nF**（τ ≈ 0.13 ms） | 必须 ≪ E.3.3 的 ~1 ms 换路预算（10 nF → 4 ms 会超） |

**验算**：合规栈 = V_Rsense 1.179 V + V_sample(120 kΩ) 0.943 V + 管压降 ≈ 0.2 V = **2.32 V ≤ T 点 2.97 − 0.5 = 2.47 V** ✓。全角落（3.3V_A 3.25–3.35 V、各电阻 1%、样品 10–120 kΩ）栈顶余量 ≥0.65 V，恒流可维持到 ≈216 kΩ；LTspice 复核 VDS ≥0.885 V（E.2）。栈顶取 T 点：T 经 R_top 10 kΩ / R_b 150 kΩ 接 3.3V_A，不接电池（2026-10-13 勘误：原按 3.44 V 计、裕量 0.62 V；加顶端偏置后改以 T 点为准）。
**`CURR_DIS` 不是节电手段**（2026-10-13 勘误：原文"关断净收益 ≈10.6 µA，对 Idle 目标可观"有误）：BSS138 导通把 VSET 拉到地后，R1 电流由 5.9 µA **升到 9.2 µA**（3.3 V / 360 kΩ），再加栅极下拉 3.3 µA，抵掉激励 7.9 µA 后净省仅 ≈1.3 µA；且只在模拟域上电时成立（此时模拟域自身约 10 mA）——待机时 `ANA_EN` = 0，激励与分压电流本来就是 0。`CURR_DIS` 的价值在功能：提供确定的零电流状态（E.3.3 零点模式、插拔样品）。

**手册依据（2026-10-13 核实）**：
OPA333（TI SBOS351）Ib ±70/±200 pA(25 ℃)、±150 pA 典型全温，共模范围超轨 100 mV（VSET 1.18 V 无虞），Iq 17 µA typ / **28 µA max**，输出可至轨内 50 mV，开通 100 µs；
BSS138 Vgs(th) 0.80/1.25/**1.50 V**、Ciss 12.2 pF typ、IDSS 25 ℃ max 500 nA@50 V（库内手册）；
STM32U575 I/O Ilkg max **200–500 nA**（DS13737，同族同规格）。

> OPA333 手册已放入 Obsidian `20-硬件工程/datasheets/OPA333.pdf`（2026-10-13 核查：文件在库，但尚未提交、未建笔记，由归档会话处理）。
> 备选（记录未采用）：栅极下拉改 4.7 MΩ 可把关断态耗电降到 0.7 µA，但 U5 漏电上限 500 nA 会把栅极抬到 2.35 V > Vgs(th) max，复位默认态翻转为"激励关"——虽无害却语义不确定，故取 1 MΩ。
> 若要同时满足「空闲零栅极电流 + 复位硬零激励」，应改用**高边 PMOS 切断分压**（+1 器件 +2 电阻，代价是 BOM/面积）。

## E.3 自校准（✅ 定稿；2026-10-12 电路细化）

**方案：0.1% 精密 Rsense 打底 + 板上标准电阻 R_ref 自检；校准对象是"Rsense+ADC 增益综合系数"，不是恒流源电流**（电流永远不需要准）。测量精度最终由 R_ref 决定，基准误差在双通道比值中抵消。

### E.3.1 切换拓扑（顶端共用，仅切两处）

恒流源为低边拓扑，样品与 R_ref 顶端**永久并联在 T 节点**（T 经 R_top 10 kΩ 接 3.3V_A、R_b 150 kΩ 对地，见 E.2；2026-10-13 起不再直接挂在 3.3V_A 轨上）——校准时样品回线断开、自然零电流，故**顶端无需切换**。仅切两处：

- **电流回线**（K1/K2，**2026-10-18 起由单颗 TMUX1134 的 SEL1/2/3 同沿 + SEL4 分别控制**）：样品底（S 节点）或 R_ref 底（F 节点）二选一接 **BSS138 漏极（X 节点）**，零点模式两路都断；
  **源极（B 节点）= Rsense 顶**，Rsense 底 = E = GND；运放反相端接 B、同相端接 VSET → I = VSET/Rsense
  （**2026-10-13 勘误 + LTspice 证伪（销 E.10#10）**：原文"接 Rsense 顶（B）"后接调整管到地的画法把 Rsense
  放在漏极路径——该接法环路为**正反馈**，仿真显示其锁死在零电流态（调整管关断、V 顶到轨），不能恒流；
  定稿接法全 R 范围 I = 7.857 µA 恒定，见 `hardware/sim/ccsource/`。rref 图与前端图已按此统一重画）；
- **测量线**（K3/K4）：ADC 通道 0 负端（经跟随器）选 S 或 F；通道 1 测 **Rsense（B–E=GND）压降**永远在线
  （AIN1P = B，经跟随器；**AIN1N = E，直接经 RC 接 Rsense 底端 Kelvin 引线，不经跟随器**，见 E.4）。

R_ref 经**同一套**保护/跟随器/ADC 通道测量——校准的正是真实测量链。示意图见
[diagram/模拟前端与自校准.svg](diagram/模拟前端与自校准.svg)（含测量 / 校准 / 零点三种模式）。

### E.3.2 器件与状态

| 器件 | 选型 | 关键规格 |
| --- | --- | --- |
| **K1–K4 整合（2026-10-18 定版）** | **单颗 TMUX1134**（4 路 SPDT，整合替换原 TMUX1101×2 + TMUX1102×2 分立方案；原理图网表终验通过） | 漏电/Ron 规格沿用原 TMUX1101/1102 族（SCDS410D：断态 ±50 pA@25 ℃ / ±0.2 nA@85 ℃；Ron typ 1.9 Ω / max 9.8 Ω）；**SEL1/SEL2/SEL3 = PB2 同沿**（测量线对 K3/K4、K5、K1 同沿切换）、**SEL4 = PB0**（K2 R_ref 回线；**2026-10-21 三排由 PB8 迁来**，与 SEL_SENSE/CURR_DIS 聚为 24–27 连续簇）；互锁靠固件：**PB2=1 时 PB0 不得为 0**（否则样品与 R_ref 经 X 并联） |
| ~~K1/K3~~ | ~~TMUX1101（SPST 常开 NO）~~ | 已被 TMUX1134 整合取代（2026-10-18） |
| ~~K2/K4~~ | ~~TMUX1102（SPST 常闭 NC）~~ | 已被 TMUX1134 整合取代（2026-10-18） |
| R_ref | **100 kΩ ±0.02%**（PTFR0805Q100KN9，Q 档）、**≤25 ppm/℃**（0805 薄膜精密）。**图纸位号 = R33**（AFE_T ↔ CH1_NC） | 量程中部兼顾两端；校准时压降 0.8 V（33 % FS）；功耗 6.4 µW |

| 模式 | **SEL1/2/3 (PB2)** | **SEL4 (PB0)** | CURR_DIS (PB10) | 导通 | 电流路径 | ch0 / ch1 |
| --- | --- | --- | --- | --- | --- | --- |
| 测量 | 1 | 1 | 0 | K1、K3 | T→样品→K1→X→BSS138→B→Rsense→GND | V_sample + δ0 / V_Rsense |
| 校准 | 0 | 0 | 0 | K2、K4 | T→R_ref→K2→X→BSS138→B→Rsense→GND | V_Rref + δ0 / V_Rsense |
| 零点 | 0 | 1 | 1 | 仅 K4 | 无（K1、K2 均断，恒流关断） | δ0 / — |

**互锁（固件）**：PB2=1 时 PB0 不得为 0——否则样品与 R_ref 经 X 并联。复位时模拟域不上电（E.6 `ANA_EN`），
开关状态由固件在拉高 `ANA_EN` 前设定；控制脚全低 = 校准态，与 rref 图的默认画法一致。

R = **k** × ((V_ch0 − δ0)/V_ch1) × Rsense_标称；校准得 **k = [V_ch1/(V_ch0 − δ0)]cal × (R_ref/Rsense)**。
δ0 = 零点模式下的 ch0 读数，即 ADC 与两颗跟随器的合成失调（ADS131A02 失调 500 µV typ、手册无 max，且无片内失调校准；2026-10-13 新增）。
ch1 的失调在测量、校准两态相同（电流相同），被 k 完全吸收，无需单独校。

### E.3.3 时序与触发（固件）

- 进校准：`CURR_DIS`=1（关流）→ 断 K1 → **零点**（K2 断、SEL_SENSE 低 → K4 接 F）→ 延时 ~1 ms → 丢弃 ΣΔ 滤波器建立期样本（≥2× 群延时）→ 平均得 **δ0**
  → 通 K2 → 延时 ~0.2 ms → `CURR_DIS`=0 → 延时 ≥1 ms（使能建立实测 **0.871 ms（cc 套件）/ 0.887 ms（cc4 套件）**——
  两套仿真口径差 1.8 %，均 <1 ms 但**不宽裕**，故预算取 ≥1 ms 并按较差值留量，见 `hardware/sim/ccsource/`）→ 丢弃 → 平均 → 算 k → 反序退出。
  **切换电流回线一律先关流、先断后通；任何切换都在测量窗口外**（硬约束）。
  零点时恒流环因无负载路径而饱和、BSS138 全通，X≈0，K2 承受约 3 V，其断态漏电流经 R_ref 形成 δ0 误差（LTspice 复核机理，量级计入 E.3.4）。
- 触发（2026-10-13 统一，与 E.9 一致）：**δ0** 在每次测量会话开始及测量窗口间隙自动刷新，只存 RAM、不写 Flash（数据流留几 ms 空档并打标记）；
  **k** 只由上位机指令触发并写 Flash；上电自检 / 周期自检（默认关、可配）只做**只读比对**——测 R_ref、与已存 k 比较，超差报警，不覆盖 k。
- k 存 **MCU Flash（EEPROM 仿真）**：磨损均衡、双区 CRC、带校准时温度戳。

### E.3.4 误差核算（对照 1% 预算）

| 误差源 | 量级 | 备注 |
| --- | --- | --- |
| Rsense 初始 0.1% | **被 k 消除** | 残余 = R_ref 精度 0.02% + 漂移 |
| 温漂（Rsense−R_ref 差分） | ≤25 ppm/℃，ΔT=10 ℃ → ≤0.025% | 周期自校准进一步压制 |
| TMUX 断态漏电（2 路） | ≤0.4 nA @85 ℃ → ≈0.005% | 25 ℃ 时 pA 级 ≈0 |
| TMUX Ron 及其温漂 | **0** | 压降在比值之外（78 µV @max Ron） |
| ADC 噪声（数字平均后） | <0.01% | 沿用 D.4 |
| 基准 / 恒流漂移 | 比值抵消 | 2.442 V 内部基准两路共用 |
| BAV199 保护漏电 | pA 级 | ≪ 信号 |
| 试件引线电阻（两线共享） | mΩ 级 vs 10 kΩ | <0.0001% |
| ADC + 跟随器失调（ADS131A02 500 µV typ） | **被零点 δ0 消除** | 残余见下三行（2026-10-13 新增） |
| 失调温漂（距上次零点 ΔT = 5 ℃） | 2.5 / 4 µV/℃ → 12.5–20 µV → ≤0.025 % | δ0 随测量会话自动刷新 |
| 零点期间 K2 断态漏电 × R_ref | 50 pA@25 ℃ / 0.2 nA@85 ℃ × 100 kΩ → 5–20 µV → ≤0.025 % | 机理见 E.3.3（K2 承受约 3 V） |
| OPA388 偏置电流 × (R_x − R_ref) | ±30 pA typ / ±600 pA max（0–85 ℃）× ≤90 kΩ → 典型 <0.01 %，最坏 0.07 % | 测量与校准两态之差，k 吸收不掉 |
| **ADC INL（积分非线性）** | **8 ppm FS typ / 20 ppm FS max** → @10 kΩ 折 **0.025–0.062 %**、@120 kΩ 折 0.002–0.005 % | 单点 k 校准消不掉的曲线项；按信号占 FS 比例反比放大，**@10 kΩ 时是本表最大项**（2026-10-14 补入，见下「INL 硬底」） |
| ADC 增益漂移 | 0.5 ppm/℃ typ / 2 ppm/℃ max，ΔT=10 ℃ → ≤0.002 % | k 存 Flash、两次校准之间累积；远小于表内其他项（2026-10-14 补入） |

电气项合计（含 INL）**@R₀ = 10 kΩ：典型 ≈0.10 %、最坏 ≈0.23 %**，对 1% 预算裕量典型 ≈10×、最坏 ≈4×；
**@R₀ = 120 kΩ：典型 ≈0.08 %、最坏 ≈0.17 %**（INL 在此仅 0.002–0.005 %，可忽略），裕量典型 >10×、最坏约 6×。
（2026-10-14 补入 INL 与增益漂移两项后重算；原"典型 ≈0.08 %、最坏 ≈0.17 %"未含 INL，仅在 120 kΩ 端成立。）
**材料温度系数（−4~−10 %/℃）仍是唯一决定性项**（D.3）——它比全部电气项之和大一个数量级。

**全链仿真实测（2026-10-14，fs 套件，`hardware/sim/ccsource/`）**——本表逐项得到定量确认：
- δ0 = 505.4 µV（500 µV ADC 失调建模 + **5.4 µV K2 漏电×R_ref——上表「零点期间 K2 断态漏电 × R_ref」一行的机理逐点复现**，落在 5–20 µV 预算下沿）；
- 校准后静态全量程（10k–120k 六点）误差 ≤0.0053%，未校准 +0.60%→+0.011%（零点+R_ref 两层校准压两个数量级，fs1）；
- 下限呈**恒定 −0.73 Ω 偏置**（非百分比）：5.4 µV 零点多减项折算 5.4 µV×(150k/1.179 V)=0.69 Ω+数值项，fs5 实测 10 kΩ 处 −0.53 Ω→10 Ω 处 −0.73 Ω——**1% 线在 73 Ω**；偏置系统性、固件可修（修正后受噪声/漏电温漂限制，85 ℃ 漏电 ×4 → −2.9 Ω）；
- **测量能力定版**：设计量程 10–120 kΩ（≤0.005%）；1% 可用范围 **~73 Ω–600 kΩ**（上限 = V_sample 顶到 ADC 满量程 2.442 V 处，600 kΩ 时 −0.083%、700 kΩ 削顶 −1.7%，fs4/fs6；**比值把上限从恒流合规墙 215 kΩ 推高 2.8×**——电流跌落在比值中抵消，只要求电流非零且不削顶）；
- **位定级（2026-10-14 按手册 INL 修正；位级约定：4½ 位 = ≤50 ppm、5½ 位 = ≤5 ppm）**：
  **@120 kΩ ≈4½ 位**（fs1 实测 ≤0.0053 % = 53 ppm，恰贴在 4½ 位线 50 ppm 上；INL 折 21–52 ppm 同量级）；
  **@10 kΩ 降到 4 位（typ 248 ppm）/ 3½ 位（max 621 ppm）**——INL 主导，须升级口 A④ 多点线性化才能回到 4½；
  **5½ 位分辨率**（准静态 0.014 Ω，**分辨率非精度**，两者不可混称）、全速冲击 4 位（E.4.3）。
  绝对精度锚定 R_ref（**Rsense 在 k 校准中约掉**，本节公式的推论）；
- 10 ms 冲击全链（fs2）：读数 = 真实 R 滞后 ~15 µs（**按旧 AAF 1 kΩ+10 nF 的 τ=10 µs 计**+采样孔径），对齐后 ≤±0.045%、稳定后 0.0000%——**相位滞后非增益误差**。
  **2026-10-20 复核**：AAF 已改 B 案三级阶梯（Σ R·C ≈ 1.2 µs，比旧方案小一个数量级），fs2 的 15 µs 是**偏保守**估计；
  且 ±0.045% 的幅度误差结论与 AAF 参数无关（比值抵消），**无需重跑 fs2**。

**INL 硬底（2026-10-14 手册核实 SBAS590E；同日二次勘误：原文"~3–8 ppm FS"有误——DC PERFORMANCE 表实为
`INL, Best fit → TYP 8 / MAX 20 ppm`，原文把 TYP 当成了上限，且 3 ppm 查无出处）**：
ADS131A02 积分非线性 **8 ppm FS typ / 20 ppm FS max**，是单点 k 校准消不掉的曲线项。
折算按信号占 FS 的比例反比放大：**@120 kΩ（0.943 V = 38.6 % FS）→ 21–52 ppm**、
**@10 kΩ（0.0786 V = 3.22 % FS）→ 248–621 ppm**
（原文"8–21 ppm @120 k、100–250 ppm @10 k"是按错误的 3–8 ppm 推得，一并更正）。
这是 4½→5½ 的物理底，也是 **@10 kΩ 端位定级掉到 4 位**的原因（升级口见下）。

> 升级口 A——**可选精度包（2026-10-14 记录，不动 1% 主规格；位级约定同上：4½ 位 ≤50 ppm、5½ 位 ≤5 ppm）**：① Rsense/R_ref 换 2–5 ppm/℃ 箔电阻（BOM +$10–20，差分温漂 125→15 ppm@5℃）；② 温度门控重校（TMP117 ΔT>0.5 ℃ 触发 k/δ0）；③ 仪器温漂自补偿（复用 D.3 材料补偿管线，需板温传感——现缺，STM32 内部 ±2–5 ℃ 粗略可用）；④ INL 多点线性化（产线 3–5 标准电阻，把 INL 压到 ~5 ppm FS）。
> **四项全做后的实际天花板（2026-10-14 按 INL 8/20 ppm 重算，原"25–50 ppm 踩线 5½"有误——25–50 ppm 只是 4½ 位）**：
> @120 kΩ 合计约 20–30 ppm → **稳在 4½ 位、逼近但未达 5½**（5½ 需总残差 ≤5 ppm，即 INL ≤1.9 ppm FS）；
> @10 kΩ 即便 ④ 把 INL 压到 5 ppm FS，折回读数仍 ~155 ppm → **仍卡在 4 位**（4½ 需 INL ≤1.6 ppm FS，产线线性化不现实）。
> **变现前提**：仅 R_ref 自检分辨率、恒温标定、同温相对监测三场景有意义（材料温漂把整机测量钉在 4½ 以下）。

> 升级口（记录，本次不做）：2× TMUX1104（USON-10，2.5×1.0 mm，4:1）可留**双点 R_ref 校准**通道（如 30 k+300 k），同封装面积更小且天然先断后合。失调已由零点模式解决（2026-10-13），双点 R_ref 仍可用作线性度检查。

## E.4 电压取样与 ADC 前端（✅ 定稿）

> **2026-10-12 重大修订**：ADC 由 ADS127L11 改为 **ADS131A02**，测量方式由"单通道复用"改为
> **双通道同步采样实测**。选型过程与备选见附录 F。

| 环节 | 定案 |
| --- | --- |
| 测量拓扑 | **恒流源激励 + 双通道同步实测**：恒流 I 流过样品与 Rsense，两路电压分别同步测量，软件算 R = (V_sample / V_Rsense) × Rsense |
| 取样 | 样品两端差分（AIN0P = T、AIN0N = M，M 经 K3/K4 选 S 或 F）→ 各经跟随器 → ADC 通道0；Rsense 压差（**AIN1P = B 即 BSS138 源极/Rsense 顶**，经跟随器；**AIN1N = E = GND，直接经 RC 接 Rsense 底端 Kelvin 引线**）→ ADC 通道1（2026-10-13 勘误：Rsense 在源极路径、非漏极路径，见 E.3.1；AIN1N 不经跟随器，见下行） |
| **ADC** | **ADS131A02**（2 通道**同步采样**、24 bit ΣΔ、128 kSPS、模拟 AVDD 3.0–5.5 V、数字 IOVDD 1.65–3.6 V **3.3 V 直连**、内部 **2.442 V** 基准 6 ppm/℃ typ / 20 ppm/℃ max（勘误：原文"1.2 V"有误）、内置负电荷泵（本设计禁用，VNCP 直接 AVSS）、**动态范围 119.5 dB @1 kSPS / 85.1 dB @128 kSPS**（Table 1，Gain=1；2026-10-14 勘误：原文"SNR 115.2 dB"手册查无此数——EC 表的 115 dB 是 Dynamic range 且条件为 AVDD−AVSS=5 V、VREF=4 V，不适用本配置；本配置数值见 Table 1，标题即"3.3-V Analog Supply, 2.442-V Reference, Gain=1"，且随 OSR 变化，与 E.4.3 引用的 µVrms 一致） |
| 前置缓冲 | **3 颗 OPA388（T、M、B 三线）**（2026-10-13 由 4 颗改为 3 颗，销 E.10#8）：OPA388 输出距轨只能到 5–25 mV，AOL 仅在输出距轨 ≥0.15 V 时有保证（SBOS777D），用跟随器缓冲电源轨或地都会产生 mV 级误差——故 AIN1N（地）不加跟随器，T 点改由 E.2 的顶端偏置拉离电源轨。高阻源（样品 10–120 kΩ、Rsense 150 kΩ、T 点约 9.4 kΩ）经跟随器驱动 ADC 开关电容输入（Zin≈130 kΩ）；恒流源运放 OPA333 另计（E.2） |
| 轨压余量 | 跟随器输入：T 2.97–3.07 V（零点时 3.04–3.15 V）、M 2.03–2.99 V、B 1.15–1.21 V；全角落（3.3V_A 3.25–3.35 V、电阻 1%、样品 10–120 kΩ、三种模式）距电源轨 ≥0.199 V（要求 ≥0.15 V），LTspice 复核 ≥0.203 V；ADC 各输入均在 AVSS–AVDD 内（AIN1N 恰为 AVSS，手册允许） |
| 基准 | **内部 2.442 V 带隙基准**（6 ppm/℃ typ，固定）；V、I 两路共用，增益误差抵消；**复位默认选外部基准，固件必须写 INT_REFEN=1** |
| 抗混叠滤波 | **B 案定版（2026-10-19，R5 四轮仿真定档）：每线三级无源阶梯 6.19 Ω + 68 nF → 6.04 Ω + 68 nF → 13.7 Ω + 27 nF（对地，C0G）+ 末级 12 nF 差分**（R 全 E96 1%，ΣR=25.93 Ω；fc ≈ 80 kHz）。取代旧 1 kΩ + 10 nF 方案（下方原文保留备查）。依据：① 扫频需求（正弦 ≤16 kHz，测相位）要求通带平坦 D4=0.185 dB @16 kHz（旧方案 fc 15.9 kHz 会砍掉扫频带）；② 抗混叠锚点是 fMOD=4.096 MHz 而非 128 kSPS（64k~fMOD 折叠带由片内 sinc³ 负责，−3dB≈33.5 kHz，SBAS590E），无源阶梯守 k·fMOD 折叠 + 开关噪声 + 电荷桶；③ R1=6.19 Ω 兼任 OPA388 容性负载隔离（修 C9 有源谐振：跟随器节点 peaking 10.7→4.8 dB）；④ **两线须按 R·C 乘积异向配对**（R×(1+m) 配 C×(1−m)）：1% 单体失配下 CMRR 95.5 dB，不配对仅 48.5 dB——BOM 须加配对工序。实测（真实 OPA388 模型）：DM@fMOD −84.6 dB、CM@fMOD −79.2 dB、DM@MCLK −132.6 dB、建立 73 Ω–600 kΩ 十六点全过（最坏 30.1 µs @220 kΩ）、无源噪声增量 0.64%（总噪声 12 LSB 系跟随器主导，对 80 mV 最小信号折 0.004%）、−20/+85 ℃ 漂移 <0.001 dB。定版图：`docs/design/diagram/抗混叠滤波电路.svg`；过程与评分（十维 min 制 min=0.700，短板 D4）见 `docs/design/spec/2026-10-18-aa-driver.md`（规格 v4）与 `hardware/sim/aaf/r5_report_r4*.md` |
| ~~抗混叠 RC（旧，已被 B 案取代）~~ | ~~每条 ADC 输入线 1 kΩ 串阻 + 10 nF 到 AGND~~（共 4 组：3 组在跟随器输出端，AIN1N 一组从 Rsense 底端 Kelvin 引线引出）→ fc ≈ 15.9 kHz、τ = 10 µs（2026-10-13 定值，销 E.10#4）。**作废原因（2026-10-19）**：fc 15.9 kHz 与 16 kHz 扫频上限重叠，通带边缘衰减 ~3 dB，扫频幅值/相位不可用；且单级 RC 在 fMOD 处仅 ~48 dB 衰减，不足 |
| 同步性 | 两通道同一时钟沿转换，恒流波动在除法中彻底抵消 |
| 模拟轨 | 3.3 V（A02 模拟 3.0–5.5 V，将来要抬激励电压可升至 5 V——届时 E.2 顶端偏置 R_top / R_b 须按新轨重算） |

### E.4.1 输入保护（双线预留，BOM 阶段取舍）

| 方案 | 器件 | 漏电 | 备注 |
| --- | --- | --- | --- |
| 保护一：低漏电 ESD 阵列 | PESD5V0L1BA / SP3003 类 | ~1 nA 级 | 简单便宜，备选焊盘 |
| 保护二：双二极管钳位（**默认**） | **BAV199** 钳到 AVDD/GND + 限流电阻 | **pA 级（最低）** | 默认贴装，漏电最低 |

PCB 并排预留两路焊盘，贴片时按 BOM 二选一。保护放在跟随器**之前**（高阻侧），漏电必须 <1 nA（120 kΩ 源阻下 100 nA=满度 1%）。

### E.4.2 基准（已定；2026-10-12 勘误）

**用 ADS131A02 内部 2.442 V 基准**（温漂 6 ppm/℃ typ / 20 ppm/℃ max，含基准缓冲漂移；**手册无 1.2 V 选项**，原文有误）。
因 V、I 两路共用同一基准做比例运算，基准绝对精度/温漂在除法中抵消，无需外置基准芯片；
本设计信号 0.08–1.2 V 约占满量程 40–49 %，噪声预算富余。

**基准电压为何"固定"2.442 V（2026-10-14 补依据）**：手册提供 2.442 V / 4.0 V 两档，由 `A_SYS_CFG.VREF_4V` 选择，
**复位默认 VREF_4V = 0 即 2.442 V**；且置 1 的前提是 `AVDD − AVSS > 4.5 V`——本设计 3.3 V 单轨**物理上选不了 4.0 V**，
故 2.442 V 是唯一合法档，固件无需（也不得）动这一位。

**内部基准建立时间（2026-10-14 补，手册 EC 表 Start-up time，条件 REFEXT = 1 µF 至 AVSS）**：
到 1% 需 **0.2 ms**、到 0.1% 需 **1.2 ms**、到 0.01% 需 **250 ms**。
比值法下 V_ch0、V_ch1 与 k 的表达式都含同一 VREF，**基准未完全沉降在除法中抵消，对本设计无害**；
但固件上电序列仍应在写 `INT_REFEN = 1` 后留 ≥1.2 ms 再取数（避免任一通道瞬时顶到满量程），
若将来改成单通道或绝对电压测量，则必须按 250 ms 等待。

**外围按手册（引脚表逐字核对，2026-10-14 补全）**：

| 脚 | 手册要求 | 本设计 |
| --- | --- | --- |
| REFP (12) | 模拟输出，"Connect a 1-µF capacitor to REFN" | 1 µF → REFN ✓ |
| REFN (13) | "Connect to AVSS" | 接 AVSS ✓ |
| REFEXT (14) | "Connect a 1-µF capacitor to AVSS **when using the internal reference**" | 1 µF → AVSS ✓（本设计用内部基准） |
| VNCP (11) | 负电荷泵输出；不用时"Connect **directly** to AVSS"；用时需 270 nF | 电荷泵禁用 → 直接接 AVSS ✓ |
| **RESV (16)** | "Reserved pin; **connect to IOVDD**" | **必须接 3.3V_D，不得悬空**（§11.4 解耦图把它画在 AVDD–RESV–IOVDD 之间） |
| **CAP (28)** | "Digital LDO regulator output. **Connect a 1-µF capacitor to GND**" | **必须接 1 µF 到 GND**（内部数字 LDO 输出，漏接会影响数字域） |
| AVDD (9) | "Connect a 1-µF capacitor to AVSS"；§11.4 要求 ≥1 µF 解耦 | 1 µF + 就近去耦，接 3.3V_A |
| IOVDD | §11.4 要求 ≥1 µF 解耦 | 1 µF + 就近去耦，接 3.3V_D |
| **NC (24)** | 是 **digital output**："leave floating or tie to GND through a **10-kΩ pulldown**" | 按 10 kΩ 下拉到 GND（不当普通 NC 处理） |
| **NC (5–8)** | "Leave floating or connect directly to AVSS" | 悬空或直接接 AVSS |

> 2026-10-14 勘误：原文"外围按手册"只列了 REFP/REFN/REFEXT/VNCP 四项（四项本身正确），
> **漏了 RESV、CAP 两个必接脚与 NC(24)/NC(5–8) 的处置**——这类漏项会在原理图/上板阶段才暴露，故补成上表。
> 另 §11.4 建议"模拟地与数字地在器件附近单点相连"，属 PCB 阶段要求，见 E.10#6 之后的布局约定。

若未来需要绝对电压测量，可切换外部基准（REF5025 = 2.5 V；**手册 VREF 合法范围 MIN 2.0 V / TYP 2.5 V / MAX AVDD−0.5 V**，
即 3.3 V 轨下 2.0–2.8 V）。

**接口要点（固件/原理图，2026-10-12 手册核实）**：SPI 仅支持**模式 1**（CPOL=0/CPHA=1）；
IOVDD≥2.7 V 时 SCLK 最高 25 MHz；DOUT 需 100 kΩ 上拉至 IOVDD；M[2:0] 模式脚 **POR 锁存**，
须 <1 kΩ 拉接——本设计 M0=IOVDD（异步中断）、M1=GND（24-bit 字长）、M2=GND（无 Hamming）；
低功耗走 STANDBY/WAKEUP 命令；**无 SYNC 引脚**；无内部振荡器，时钟方案见 E.7。

### E.4.3 噪声、采样率与分辨率定级（✅ 2026-10-14 定稿）

**ADC 噪声（手册 Table 1，3.3 V 供电 / 2.442 V 基准 / Gain=1，输入参考 µVrms）**：
OSR=4096（1 kSPS）1.82 µV；OSR=1024（4 kSPS）3.49 µV；**OSR=32（128 kSPS）96.82 µV**
（OSR<48 时 ΣΔ 环路增益不足、噪声超 √N 劣化）。

**全速 128 kSPS 的绝对分辨率恒定为 12.3 Ω**（与被测 R 无关）：
σ_R = σ_V/I = 96.82 µV / 7.857 µA——电压噪声折回电阻的唯一"汇率"是激励电流，
分子分母的 R 相消。相对值 = 12.3/R：@10k 为 0.12%、@120k 为 0.010%。

| 工作模式 | 绝对分辨率 | 适用 |
| --- | --- | --- |
| 128 kSPS 单点 | 12.3 Ω | 冲击流 R(t) 每点 |
| 全速 64 点滑窗（0.5 ms/点） | 1.5 Ω | **10 ms 冲击推荐工作点**（20 点/曲线） |
| OSR=4096 单点（1 kSPS） | 0.23 Ω | 准静态 |
| OSR=4096 + 256 平均（0.26 s） | 0.014 Ω | 标定/自检 |

**固件策略（定稿）**：冲击试验全程 128 kSPS 采满、按需数字降采样——时间分辨率与电阻分辨率在
数据获取后再选，硬件层不预决策。**10 Ω 级分辨与全速互斥**（单点 SNR=78.6/96.8<1），
10 Ω 场景须降速（OSR≥1024 + 平均）。10 ms 冲击的全链群时延按旧 AAF ~15 µs（τ=10 µs+采样孔径），**B 案 AAF 下约 1–2 µs**（Σ R·C≈1.2 µs，E.4.4）
为读数时间轴偏移 0.15%、幅度无失真（fs2 实测）。

### E.4.4 抗混叠滤波定版与扫频扩展（✅ 2026-10-19 定档，R5 四轮仿真）

**新增需求（用户 2026-10-18 确认）**：直流之外叠加单相正弦（不换向），扫频上限 **16 kHz**
（每周期 8 点 @128 kSPS 实用下限；精密区 ≤8 kHz = 每周期 16 点），**扫频目的是测相位**
（复阻抗谱）——因此通道间群延迟匹配同为硬指标。本节只定「跟随器输出 → ADC 引脚」段
（含跟随器）；规格全文见 `docs/design/spec/2026-10-18-aa-driver.md`（v4，2026-10-24 与实施计划合一）。

**定版 B 案（三级无源阶梯，用户按能力包线选定）**：

| 项 | 值 |
| --- | --- |
| 每线阶梯 | 6.19 Ω + 68 nF → 6.04 Ω + 68 nF → 13.7 Ω + 27 nF（对地）+ 末级 12 nF 差分 |
| 器件 | R 全 E96 1%（ΣR=25.93 Ω）；C 全 C0G/NP0（68/68/27 nF E12 + 12 nF） |
| fc | ≈ 80 kHz（D4 通带平坦 0.185 dB @16 kHz；及格线 0.5 dB） |
| 衰减（真实 OPA388 模型实测） | DM@fMOD −84.6 dB、CM@fMOD −79.2 dB、DM@MCLK −132.6 dB |
| CMRR @通带 | **95.5 dB（前提：两线 R·C 乘积异向配对**，R×(1+m) 配 C×(1−m)，1% 单体；不配对仅 48.5 dB）→ **BOM 必须加配对工序** |
| C9 有源谐振 | R1 2.74→6.19 Ω 修复：跟随器节点 peaking 10.7→4.8 dB（≤6 dB 限，278.6 kHz 处）；成因 = OPA388 闭环输出阻抗中频负实部 × 阶梯电容（手册曲线不可见，须 TI 模型实测） |
| 建立时间 | 73 Ω–600 kΩ 十六点全建立（最坏 30.1 µs @220 kΩ，0.01% 带，含 600 kΩ∥8.5 pF 与容差角；三种数值设置交叉验证） |
| 噪声 | 无源网络增量 D6a=0.64%（限 10%）；总噪声 12.0 LSB ≈3.5 µVrms 为跟随器主导（9.9 nV/√Hz × 16 kHz 通带的物理下限 4.3 LSB 砖墙极限之上），对最小信号 80 mV 折 0.004%，软参考不淘汰 |
| 温度 | −20/+85 ℃ 全维漂移 <0.001 dB（C0G ±30 ppm/℃），免补偿 |
| 评分 | 规格 v4 十槽位 min 制：**min=0.700**（短板 D4 距满分线 0.135 dB）；C 案（四级）min=0.710 但 C9/D5 硬约束不成立被否；A 案（二级）D1 结构性上限 77.9 dB 判死 |

**四轮迭代要点（防重蹈）**：① 0 Ω 理想源口径在 fMOD 处偏差 16–22 dB，**所有 AC 评分必须用
真实 OPA388 模型**（TI 宏模型 lib/ 不入库，仿前从 TI 官网取）；② 原 D6「总噪声 ≤1 LSB」与
16 kHz 通带物理冲突 16.5×，经用户裁决拆为 D6a（无源增量，硬）+ D6b（总噪声，软参考）；
③ 无源 RC 阶梯第一级电阻兼任跟随器容性负载隔离——**取值由 C9 peaking 约束决定，不是自由参数**；
④ LTspice 中间源阻抗（50–220 kΩ）出现过宏模型大信号极限环，须以多数值设置交叉验证甄别真伪。

## E.5 MCU、温度传感与数据接口（✅ 定稿）

### E.5.1 主控：STM32U575RGT6（2026-10-28 换型，原 U545RET6Q 缺货）

**规格（依据 ST 数据手册 STM32U575xx DS13737）**：

| 参数 | 数值 | 对比原 U545RET6Q |
| --- | --- | --- |
| 内核 | Arm Cortex-M33 + TrustZone + FPU，160 MHz | 相同 |
| Flash | **1 MB** | 512 KB → **翻倍** |
| **SRAM** | **786 KB** | 274 KB → **2.9 倍** |
| USB | **USB 2.0 full-speed 双角色**（外设 USB_DRD_FS） | 相同（同名同型） |
| 封装 | **LQFP-64（10 × 10 mm）** | **相同封装** |
| 内部电源 | **仅 LDO，无 SMPS**（无 VLXSMPS/VDDSMPS/VDD11 脚） | 简化 |

**换型原因（2026-10-28）**：STM32U545RET6Q 立创库存 **0**（C20033865，已查证），
STM32U575RGT6（**C5270980**）现货可购。**Flash/RAM 双双翻倍，属升级。**

**pin-to-pin 兼容性（按 CubeMX DB 逐脚比对 + PCB 焊盘实测，均已通过）**：

> 两片 LQFP-64 **共 11 脚定义不同**，但本工程只撞到 **4 个 GPIO**，
> 且都是"物理脚位不变、只换信号名"——**PCB 走线一根不改**。

| 脚位 | 原 U545 | 现 U575 | 本工程实际连接（PCB 焊盘实测） |
| --- | --- | --- | --- |
| 24 | PB0 | **PC4** | **CURR_DIS**（原 PB0 的功能移到 26 脚） |
| 25 | PB1 | **PC5** | **PWR_BTN**（保留 PWR_WKUP5 唤醒） |
| 26 | PB2 | **PB0** | **SEL_K2** |
| 27 | PB10 | **PB1** | **SEL_SENSE** |
| 28 | VLXSMPS | **PB2** | 悬空（NC） |
| 29 | VDDSMPS | **PB10** | 悬空（NC） |
| 30 | VSSSMPS | **VCAP** | **2.2 µF 到 GND**（C4，已布） |
| 31 | VDD11 | **VSS** | 接地 |
| 32 | VSS | **VDD** | 接 VCC |
| 33 | VDD | **PB12** | 接 VCC（可作 GPIO） |
| 62 | VDD11 | **PB9** | 悬空（NC，可作 GPIO） |

**换型的附带收益**：PB9/PB12/PC4/PC5 全部可用（原 545 的 LQFP64_SMPS 上四脚未引出或作电源）；
且**不再需要 SMPS 切换流程**（REGSEL、升频前降 <110 MHz 那一整套 E.10 #16/#17 待办
随 575 无 SMPS 而自动作废）。

**选型理由**（沿用）：

1. **786 KB SRAM** 远超"大内存计算"需求，128 kSPS 环形缓冲余量充足；
2. **USB FS 双角色**满足数据上传；
3. **1 MB Flash** 容纳固件 + 校准系数（EEPROM 仿真）+ 触发数据缓存；
4. 模拟前端为外置专用高精度方案（ADS131A02 + 跟随器），不需要内置运放/ADC。

**放弃的候选**：STM32G431CBU6（RAM 仅 32 KB）；STM32U535（RAM 160 KB、贵且库存少）；
STM32U545RET6Q（原定版，**现已缺货**）。

> ⚠️ **pin2pin 提示**：STM32 的 U5 与 G4 **无官方 pin-to-pin 兼容对**，
> 不存在"PCB 一次设计、U5/G4 互换"的方案。

### E.5.2 温度传感（⚠️ 2026-10-28 用户决定：**本版不做**，不装 TMP117）

> **决定（2026-10-28，用户原话"这次 I2C 就先不要了"）**：直流首板**不贴 TMP117、不布 I²C**，
> PB6/PB7 保留为空（不做 I²C 复用，主程序不初始化 I2C1）。
> **后果须记录在案**：D.3 的材料温度系数为 −4 ~ −10 %/℃，而精度指标 1%，
> **无温度补偿时，样品温漂会直接吃掉精度指标**。因此本版测量结果按"恒温/短时"口径使用，
> 或降温后再读；温度补偿留作后续版本升级项（引脚已预留，加装不需要改 MCU 侧布线与固件架构）。
> 下表保留完整选型论证，供后续恢复时直接沿用。

**TMP117**（I²C，±0.1 ℃，SMBus 兼容），**外置四线探头（VDD/GND/SDA/SCL），贴装于被测样品附近，测样品侧温度**（用户定稿：外置探头、连接器自选）；与电阻测量**同步采集**。
用途见 D.3：该类材料温度系数 −4 ~ −10 %/℃，而精度指标仅 1%，温度补偿是达标的关键环节。
温度系数需用该批试件现场标定。

**（以下为选型记录，本版不实施）**

**传感器选型决策（2026-10-14 定稿：维持 TMP117，不上 PT100）**——温度补偿误差账：
传感器与样品的**贴装温差（野外 0.5–2 ℃）→ 2–8%**，是 TMP117 精度项（±0.1 ℃ → 0.4%）
的 5–20 倍；PT100 AA 级元件精度与之持平，且需自带模拟子系统（激励/开尔文四线/参考电阻/
专用 ADC 通道——A02 两通道已被电阻测量占用），系统链误差（引线、自热 25–100 µW）反吃掉
纸面优势。**钱应花在贴装工程**（同面、同辐射环境、导热接触）而非传感器升级。
PT100 唯一合理场景：薄膜型（2×2 mm）直接贴试件、紧贴传感层——**若标定数据证明温度跟踪
滞后是主因再走此路，理由是贴装不是精度**。

> 升级口 B——**同位参考试件（2026-10-14 记录，架构级选项）**：同一夹具上放一片未受损
> 同批材料，开关阵列加一对（K5/K6，TMUX 同款）复用同一测量链。两片同温同批，
> 温度与批次差异在 R_被测/R_参考 比值中**构造性抵消**（Rsense 比值技巧在材料端的复制），
> 把整个温度补偿问题勾销。代价：两开关+一夹具位。损伤分级监测若遭遇温补瓶颈，此为首选解。

### E.5.3 数据接口

**USB FS**（设备模式，外设 USB_DRD_FS；片内 BC1.2 BCD 见 E.8.4）直连上位机：上传测量曲线、接收配置、下发校准指令。
USB 供电与 1S 锂电充电管理协同（见 E.1）。

### E.5.4 存储

**两层，各司其职（2026-10-14 定）**：

| 层 | 介质 | 存什么 | 理由 |
| --- | --- | --- | --- |
| **校准系数** | **MCU Flash（EEPROM 仿真）** | Rsense+ADC 综合增益系数、零点系数、R_ref 自检结果 | 数据量小、写频率极低（仅上位机下发校准时写）；含磨损均衡；U5 无独立 EEPROM，不使用外部 EEPROM 芯片 |
| **测量数据** | **外部 TF (micro SD) 卡** | 冲击全程 128 kSPS 原始波形、准静态时序记录、事件快照 | 768 KB/s 级突发与长时间记录远超 512 KB Flash 容量与擦写寿命；详见 **E.11** |

MCU RAM 274 KB 作触发前环形缓冲（E.4.3），写卡由 SDMMC 4-bit 承担。

### E.5.5 本块待细化（✅ 2026-10-12 全部销号）

1. ~~引脚分配~~ → **已完成，见 E.6**；
2. ~~时钟方案~~ → **已完成，见 E.7**；
3. ~~电源域划分~~ → **已完成，见 E.8**。

## E.6 引脚分配（✅ 2026-10-28 按 STM32U575RGT6 已布线图纸重写）

**STM32U575RGT6 LQFP-64。本节以 PCB 焊盘网络表为准**（2026-10-28 用 EDA API 逐焊盘实测，
115 个网络 / U10 全部 64 焊盘），不再沿用 U545 时期的旧映射。

> ⚠️ **与旧表的差异来源**：U545RET6Q 与 U575RGT6 虽同为 LQFP-64，但 **24–27 脚信号名不同**
> （545: PB0/PB1/PB2/PB10 → 575: PC4/PC5/PB0/PB1）。**物理脚位不变**，图上走线未改，
> 只是同一根铜线在 575 上叫另一个名字。旧表按 545 命名写的功能对不上实物，本表已按 575 改正。

| 引脚 | 网络 | 方向/模式 | 连接与说明 |
| --- | --- | --- | --- |
| **PA1**（15） | ADS_DONE | 输入 | 无内部上下拉；经 33 Ω（R61）至 ADC DONE |
| **PA2**（16） | ADS_RESET | 输出 Low | 经 33 Ω（R62）；外部 10 kΩ 下拉（R78） |
| **PA3**（17） | ADS_DRDY | EXTI3 下降沿 | 内部上拉；经 33 Ω（R60） |
| **PA4**（20） | ADS_CS | 输出 High | 经 33 Ω（R56）；软件 NSS。**本版不作 DAC**（575 上 PA4 具备 DAC1_OUT1，但不用） |
| **PA5/PA6/PA7**（21/22/23） | ADS_CLK / ADS_MISO / ADS_MOSI | SPI1 AF5 | 模式 1（CPOL=0/CPHA=1，即 2Edge）；各经 33 Ω（R57/R58/R59） |
| **PC4**（24） | **CURR_DIS** | 输出 High | 恒流源抑制（BSS138 拉低 VSET）。**原 545 用 PB0，575 上 PB0 在 26 脚，24 脚改 PC4** |
| **PC5**（25） | **PWR_BTN** | 输入 上拉 | 内部上拉、下降沿；**PWR_WKUP5** 可从低功耗唤醒。**原 545 用 PB1** |
| **PB0**（26） | **SEL_K2** | 输出 Low | TMUX1134 SEL4（K2 回线）。**原 545 用 PB2** |
| **PB1**（27） | **SEL_SENSE** | 输出 Low | TMUX1134 SEL1/2/3（测量线对 K3/K4）。**原 545 用 PB10** |
| **PB2**（28） | — | NC | 575 上是普通 GPIO；**545 时代此处为 VLXSMPS** |
| **PB10**（29） | — | NC | 575 上是普通 GPIO；**545 时代此处为 VDDSMPS** |
| **VCAP**（30） | — | **2.2 µF 到 GND** | C4（CL21B225KAFNNNE）。575 内核稳压器输出，**必须接电容，不可接地短路** |
| **PB12**（33） | VCC | — | 575 上此脚是 GPIO，图上接 VCC；**545 时代此处为 VDD** |
| **PB13/PB14/PB15**（34/35/36） | LED_GREEN / LED_YELLOW / LED_ORANGE | 输出 High（低亮） | 灌电流驱动 |
| **PC6 / PC7**（37/38） | LED_RED / PWR_LED | 输出 High（低亮） | 五灯簇 34–38 连续 |
| **PC8/PC9/PC10/PC11**（39/40/51/52） | SD_D0 / SD_D1 / SD_D2 / SD_D3 | SDMMC1 AF12 | 各经串阻（R44/R45/R13/R39）+ 10 kΩ 上拉（R53/R63/R16/R49）到 VCC |
| **PC12**（53） | SD_CLX（=SD_CK） | SDMMC1 AF12 | 经 R43 + 上拉 R52。**网络名为 `SD_CLX`（图上笔误，实为 CK）** |
| **PD2**（54） | SD_CMD | SDMMC1 AF12 | 经 R41 + 上拉 R50 |
| **PA15**（50） | SD_CD | EXTI15 双沿 | 内部上拉；经 R46 至卡座 CD，R64 上拉 VCC。插卡低 |
| **PA8**（41） | — | **NC** | **本版不用**（原计划 SD_PWR_EN，已取消——TF 卡常电，见 E.11.3） |
| **PB4**（56） | — | NC | 预留 |
| **PB6 / PB7**（58/59） | — | **NC** | **不接 I²C**（本版无 TMP117，见 E.5.2）。保留为将来温度补偿升级口 |
| **PB8**（61） | — | NC | 预留 |
| **PB9**（62） | — | NC | 575 上可用；**545 时代此处为第二 VDD11** |
| **PA9 / PA10**（42/43） | USART1_TX / USART1_RX | AF7 | 调试串口 115200 |
| **PA11 / PA12**（44/45） | PA11 / PA12（USB_DM/DP） | USB_DRD_FS | Type-C；网络名沿用引脚别名 `PA11`/`PA12` |
| **PA13 / PA14 / PB3**（46/49/55） | SWDIO / SWCLK / SWO | 调试 | Trace_Asynchronous_SW |
| **PA0**（14） | MEAS_BTN | EXTI0 下降沿 上拉 | **WKUP1** |
| **PC13**（2） | PC13 | 输入 上拉 | USB_VBUS 检测（外部 NPN 集电极，低 = VBUS 在） |
| **PC0**（8） | VBAT_MON | ADC1_IN1 | 电池分压；采样 68 周期 |
| **PC1**（9） | BQ_EN | 输出 Low | BQ24074 EN1 |
| **PC2**（10） | BQ_CHG | 输入 上拉 | 低 = 充电中 |
| **PB5**（57） | BQ_PG | 输入 上拉 | 低 = 输入电源有效 |
| **PC3**（11） | ANA_EN | 输出 Low | 模拟 LDO（U4）EN + R81 100 kΩ 下拉 |
| **VREFINT** | 内部通道 | — | 反推 VDDA；采样 391 周期（≥320 判据） |
| **PH3**（60） | BOOT0 | — | 10 kΩ 下拉 |
| **PC14/PC15、PH0/PH1** | 晶振扩展焊盘 | — | 不贴；系统 MSI→PLL，USB/SD 用 HSI48 |

**MCU 电源脚映射（STM32U575RGT6 LQFP-64，按 PCB 焊盘实测）**：

| 脚 | 名称 | 连接 |
| --- | --- | --- |
| 1 | VBAT | VCC（无后备电池） |
| 12 / 13 | VSSA / VDDA | GND / VCC（各 100 nF + 1 µF） |
| 18 / 19 | VSS / VDD | GND / VCC |
| 30 | **VCAP** | **2.2 µF 到 GND（C4）** |
| 31 / 32 | VSS / VDD | GND / VCC |
| 47 / 48 | VSS / VDDUSB | GND / VCC |
| 63 / 64 | VSS / VDD | GND / VCC |

> **VDDUSB（48 脚）接 VCC**：2026-10-28 确认，**USB 电源不单独断电**（用户决定）。
> VDDUSB 与 VCC 同轨合法（DS13737 要求 1.8–3.6 V），代价是 USB 外设无法独立断电省电；
> 若将来要极致低功耗，此处需改成受控轨（会增加"数字脚失电倒灌"的固件约束，不推荐）。
>
> **与 545 的关键差异**：575 **无 SMPS**，所以没有 545 的 VLXSMPS(28)/VDDSMPS(29)/VSSSMPS(30)/VDD11(31,62)。
> 取而代之：28/29 变 GPIO（本设计 NC）、30 变 **VCAP（须接电容）**、31 变 VSS、62 变 PB9。
> **不再需要任何 SMPS 切换流程**（REGSEL / 升频前降频那一套作废）。

**预留脚（2026-10-28 按 PCB 实测）**：PB2(28)、PB10(29)、PA8(41)、PB4(56)、PB6(58)、PB7(59)、PB8(61)、PB9(62) 全部 NC。

> **PB6/PB7 的用途说明**：原规划为 I²C1 + TMP117 温度补偿。**2026-10-28 用户决定本版不做 I²C**
> （见 E.5.2），两脚保留为空。将来若要补温度补偿，只需加 4.7 kΩ 上拉 + TMP117 探头，
> **不需要改 MCU 侧布线**，固件里 GUI 重新启用 I2C1 即可。

> **PB2/PB10 说明**：575 上这两脚是普通 GPIO（545 时代为 VLXSMPS/VDDSMPS）。本设计不启用内部 SMPS，
> 故悬空即可。**注意**：将来若换回 545 系列（SMPS 版），这两脚需按 SMPS 手册处置。

## E.7 时钟方案（✅ 2026-10-28 修订：首板贴 HSE）

> **2026-10-28 用户决定**：**首板验证贴装 HSE 16 MHz 晶振**（板上 X4 + C1/C2 20 pF + R1 1 MΩ 全部已布）。
> 原"免晶振、HSE 焊盘不贴"的结论**改为"首板贴装、PLL 源按实测选定"**。
> 对应地，原 **E.10 #16（"IOC 用 HSE-PLL 但 HSE 不贴"矛盾，阻塞固件）就此关闭**——
> 既然贴了晶振，IOC 里 `RCC_PLLSOURCE_HSE` 不再自相矛盾，**两种时钟源都可用**。

```
首选（默认）：HSE 16 MHz → PLL1 → SYSCLK 160 MHz
              └ 板上 X4 = 16 MHz（YSX321SL 3225 12 pF），C1/C2 = 20 pF，R1 = 1 MΩ 反馈
备选（晶振异常时）：MSIS 16 MHz → PLL1 → SYSCLK 160 MHz（固件一行改 PLL 源即可回退）
USB（两条路都必须有）：HSI48 ──CRS ← USB SOF──→ 48 MHz
              └ USB 精度只认 CRS，与 SYSCLK 用 HSE 还是 MSI 无关
ADS131A02：XTAL1/XTAL2 自挂 16.384 MHz 晶振（X1，C40/C44 = 33 pF）
          （手册规定晶振模式 16.384–16.5 MHz 且 IOVDD>3.0 V，3.3 V 满足；
          ⚠️ ADS131M02 的 8.192 MHz 是另一家族规格，勿混用）
LSE 32.768 kHz（X2 + C15/C16 20 pF）：RTC 掉电计时用，已布已贴
测量为比例法，时钟精度不进误差预算
```

**为什么仍然必须保留 CRS**：USB FS 要求 ±0.25 %，而 HSE 16 MHz 晶振虽好（±10~30 ppm），
但 USB 用的是 **HSI48**（不是 PLL 分频出来的），HSI48 出厂精度 ±1 %，**必须靠 CRS 从主机 SOF 校准**。
只有把 USB 时钟源改成 PLL 的 48 MHz 输出才能免 CRS——本设计不走这条路（CRS 成本为零，且是 ST 官方免晶振路径）。

**HSE 负载电容注意**：X4 规格负载电容 12 pF，板上 C1/C2 = 20 pF。
按 `CL = C1×C2/(C1+C2) + Cstray` 反算，**20 pF 对 12 pF 晶振偏大**（实际负载 ≈10 pF + 杂散 3–5 pF ≈ 13–15 pF，
略高于 12 pF），频偏约 +10~30 ppm——对 SYSCLK 应用无影响，但**若日后切 USB 时钟到 PLL，需把 C1/C2 改到 10 pF**。
实测时若发现 HSE 起振慢或不稳，优先怀疑此处。

## E.8 电源域与电池管理（✅ 2026-10-12 定稿）

### E.8.1 电源树（2026-10-28 修订：充电 IC 改 **BQ24074**）

> **2026-10-28 换料（采购原因）**：原定 BQ24040 改为 **BQ24074**（QFN-16 3×3，1.5 A，
> 带**电源路径管理 PowerPath**）。此前的"OUT 脚即电池节点"结论基于 BQ24040，
> BQ24074 是**真 PowerPath**：系统输出与电池由芯片内部自动切换，系统侧不再与电池直接并联。
> 依据 PCB 焊盘实测接线：`VBAT`(2/3) = 电池、`VOUT`(10/11) = 系统输出、`IN`(13) = 输入。

```
Type-C VBUS 5 V ──D1── BQ24074 IN(13)
                        ├─ VBAT(2,3) ── 1S 电芯（经 CN3 1x3P，含 NTC → TS(1)）
                        └─ VOUT(10,11) ─┬─ U18（3.3 V 500 mA）── VCC / 3.3V_D（数字域，常开）
                                        └─ L2 磁珠 ── U4（3.3 V 300 mA, EN=ANA_EN）── AVCC / 3.3V_A
```

**PowerPath 的实际好处**：电池深度亏电时系统仍可由 USB 立即供电（不必等电池充到可用电压），
且充电电流与系统负载解耦——这对"插上 USB 就要能连上位机"的场景比 BQ24040 更合适。

**BQ24074 关键脚（PCB 实测）**：

| 脚 | 名称 | 连接 |
| --- | --- | --- |
| 1 | TS | CN3 电池座 NTC（电芯自带） |
| 2,3 | BAT | VBAT（电芯 + 10 µF C8 + 100 nF C6） |
| 4,5,8,17 | GND / EP | GND |
| 6 | EN1 | `BQ_EN` ← MCU PC1；R47 10 kΩ 下拉（默认关闭） |
| 7 | PG | `BQ_PG` ← MCU PB5（开漏，100 kΩ 上拉 VCC） |
| 9 | CHG | `BQ_CHG` ← MCU PC2（开漏，100 kΩ 上拉 VCC） |
| 10,11 | OUT | VOUT（系统输出；2.2 µF C30） |
| 12 | ILIM | **R8+R10+R11 = 3 kΩ 串联到 GND**（输入限流） |
| 13 | IN | VBUS 经 D1（40 V/1 A） |
| 16 | ISET | **R2+R9 = 2 kΩ 串联到 GND**（充电电流编程） |
| 14,15 | NC | 未接 |

### E.8.2 LDO 选型与压降（手册核实）

| 域 | 器件 | **Iq** | 规格（手册核实） | 负载 | 预算 |
| --- | --- | --- | --- | --- | --- |
| 3.3V_D | **TPS7A0233PDBVR** | **25 nA** | 200 mA、Iq 25 nA（nanopower）、输出噪声 ≈130 µVrms（@0.8 V/30 mA；3.3 V 条件 ≈270 µVrms）、PSRR 55 dB@1 kHz、压差 max 270 mV@200 mA（→50 mA 时 ≈68 mV）、精度 ±1.5%（全温）、VIN 1.5–6.0 V、UVLO max 1.41 V、EN VIH 1.1 V + smart pulldown、SOT-23-5（DBV）或 X2SON-4（DQN 1×1 mm）、1 µF 稳定 | MCU 13.5 mA typ@160 MHz、ADS131A02 IOVDD 0.6 mA、TMP117、LED 峰值 ~20–30 mA | <50 mA |
| 3.3V_A | **TPS7A2033PDBVR** | **6.5 µA** | 300 mA、7 µVrms、PSRR 95 dB@1 kHz、压差 max 145 mV@300 mA（→15 mA 时 ≈7 mV）、精度 ±1.5% max、VIN 1.6–6.0 V、UVLO max 1.59 V、EN VIH 0.9 V + smart pulldown、SOT-23-5、1 µF 稳定 | ADS131A02 AVDD 3.2 mA typ、OPA388×3 + OPA333、TMUX×4、VSET 分压、T 点偏置 ≈21 µA | <15 mA |

压降按**Rds(on) 上界换算**（非手册直接保证值，量产前用板上监测实测标定）：
TPS7A0233 Rds ≈1.35 Ω（270 mV@200 mA 反推）→ 50 mA 时 ≈68 mV；TPS7A2033 Rds ≈0.48 Ω（145 mV@300 mA）→ 15 mA 时 ≈7 mV。
两轨在电池截止 3.50 V 下允许 200 mV，**均裕量充足**；充电时 OUT 最高 4.23 V，裕量更大。

**2026-10-13 决策：数字轨 TPS7A0233 + 模拟轨 TPS7A2033**（原 3.3V_D 用 SGM2210-3.3，同日换掉）。判据：
① **只有常开轨的静态电流才真计费**：3.3V_D 常开，Iq 6.5 µA → 25 nA，已知待机项由 ≈24 µA 降到 ≈17.6 µA（**−27 %**，口径见 E.8.6；原文"≈23 → 16.5 µA、−28 %"漏计 BQ24040、TMP117 等小项）；
② **模拟轨由 `ANA_EN` 门控**，其 LDO 静态电流只在测量窗口内计费（≈0），3.3V_A 用 25 nA 器件**无收益**；
③ 相反 3.3V_A 需要低噪声。**论据（2026-10-14 更正）**：手册 EC 表**确实有** AVDD PSRR 规格——
   `AVDD supply, fPS = 50 Hz 和 60 Hz → 80 dB typ`（IOVDD 为 105 dB），但**只在 50/60 Hz 两个点上给值、宽带无保证**；
   更关键的是 **PSRR 管不住 LDO 自身的输出噪声**——那是直接串进 AVDD 的，不经"抑制"这一环：
   TPS7A2033 输出噪声 **7 µVrms**，TPS7A0233 ≈**270 µVrms**（3.3 V 条件），**差约 39×**，
   且后者 PSRR 也低 40 dB。对数字轨这些无所谓，对模拟轨则是白白让出裕量。
   （原文引修订记录"Deleted separate AVDD PSRR specification for the ADS131A02"推出"AVDD 有多脏会被抑制多少
   **无手册依据**"——引文本身无误（Rev C→D，p.10），但该结论**过强**：删掉的是 A02 专属条目，
   家族通用行仍在表内。结论不变、论据换成上面这条。）
落选备选（记录，手册已核）：**TLV755P**（500 mA、Iq 25 µA、压差 238 mV@500 mA、噪声 71.5 µVrms）；
SGM2210（Iq 36 µA，20 V VIN 余量对本设计无用）；**两轨全用 TPS7A0233**（模拟轨纯亏，已排除）；
TPS7A8033（1 A 过剩、噪声反高）、TPS7A3901（±双路，无负轨需求）、TPS7A2050（5.0 V 版本，电压不符）。

**域划分**：ADS131A02 AVDD→3.3V_A、IOVDD→3.3V_D；TMUX110x VDD→3.3V_A（SEL 由 3.3V_D 驱动，
Fail-Safe 逻辑容忍）；OPA/VSET→3.3V_A；MCU 全部电源脚、LED、TMP117→3.3V_D。

### E.8.3 电池工作区间与电压监测（核心策略）

**不在电池尾段工作**——低电即报警停测，换取所有器件全程在规格中央区：

| 阈值（电池电压） | 动作 | 依据 |
| --- | --- | --- |
| ≤3.65 V | 低电报警（状态灯 + 上位机提示） | 约剩 20–30 % 容量 |
| ≤3.50 V | **停止测量、软关机** | 两轨仍在稳压区（数字轨 3.50 V − 68 mV ≈ 3.43 V > 3.3 V，TPS7A0233 @50 mA；模拟轨压差仅 ≈7 mV）；AVDD = 3.3V_A（3.25–3.35 V），距 ADS131A02 下限 3.0 V 余 ≥0.25 V；合规栈相对栈顶 T 点余量 ≥0.65 V（满足 ≥0.5 V，见 E.2.1）。（2026-10-13 勘误：原文"AVDD ≥3.43 V、余 0.43 V，合规栈裕量 >1 V"把 LDO 输入侧余量当成了轨压） |
| 充电在线（USB） | 不报警不关机，仅上报电池电压 | 低电动作仅在电池供电状态执行 |

监测通道：**轨压**用 STM32 内部 VREFINT 通道反推（ADC 基准即 VDDA，外部分压测轨是恒等式测不出）；
**电池电压**用 PC0 分压（2×1 MΩ + 100 nF，常通 ~2 µA）；
**USB 在线状态**用 **PC1 的 VBUS 分压**（1 MΩ / 1 MΩ + 100 nF，比 0.5）→ 同一 ADC1 读，
判据阈值 **3.70 V**（对应 ADC 节点 1.85 V、12-bit 码 ≈2296），阈值做成固件可配置常量。

> **VBUS 检测方式勘误（2026-10-14）**：原设计写"PA9 = OTG_FS_VBUS 检测"。实测与核查均不成立：
> ① **STM32U5 的 USB_OTG_FS 在 CubeMX 里没有 VBUS sensing 选项**（该勾选框属 F4/F7 系），
>    用户已在 CubeMX 6.18.1 现场确认；
> ② 原附注"PA9 为 5 V 容忍脚"**未经 DS14216 核实**，属我此前凭记忆写入的失实断言。
> 故改用**电阻分压 + 内部 ADC**：阈值自定、USB 未枚举时也能读、与 USB 协议栈状态解耦，
> 且不占死 PA9。分压电流 2.6 µA **仅在 VBUS 存在时流通**，不计入电池供电的待机口径（E.8.6）。
>
> 曾评估的两条替代路：**纯软件判 SOF/枚举**——不成立，插充电头不接 PC 时无 SOF，
> 会被误判为"未插 USB"，本条"在线不报警"逻辑失效；**复用 OTG 硬件 VBUS**——该功能在本芯片不可用。

启动无门槛：LDO 的 VIN/EN/UVLO 下限
（TPS7A0233：VIN 1.5 V / UVLO 1.41 V；TPS7A2033：VIN 1.6 V / UVLO 1.59 V；EN VIH 均 ≤1.1 V，手册值）远低于电池任何合法电压，深放电池插入照样上电，MCU 起来后读 PC0 决策。

### E.8.4 充电管理（2026-10-28 换料 **BQ24074**，采购原因）

> **型号变更**：原定 BQ24040DSQR（C81080）改为 **BQ24074**（QFN-16 3×3 + EP，1.5 A，
> 输入 4.35–10.2 V，**带 PowerPath 电源路径管理**）。采购原因，非设计变更。
> **两者引脚不可互换**（BQ24040 是 WSON-10 2×2；BQ24074 是 QFN-16），
> 选型比较与引脚细节见 E.8.1 表。**以下参数按 BQ24074 的实际接线陈述**。

- **选型结论**：BQ24074 相比 BQ24040 多出**真 PowerPath**（系统与电池自动切换、充电与负载解耦），
  价格略高但换来"电池亏电也能立即上电通信"。原 BQ24040 的"OUT 即电池节点"简化在 BQ24074 上不适用。
- **备选梯队**（切换触发条件）：成本极限→TP4056（立创该料号库存 0、杂牌风险）；
  需 I²C 智能充电→SGM41511。排除：I²C 类依赖固件存活；TP5000 开关式充电纹波窜模拟域。
- **充电电流与输入限流（2026-10-28 按图纸实测 + BQ24074 手册核实）**：
  依据 TI **BQ24074 手册**（SLUS812）电气表与 §9.3.5：
  `I_CHG = K_ISET / R_ISET`（K_ISET = **890 A·Ω** typ，797–975），`I_IN-MAX = K_ILIM / R_ILIM`
  （K_ILIM = **1610 A·Ω** @500 mA–1.5 A 档 / 1525 @200–500 mA 档）。

  | 参数 | 图纸实际 | 计算值 | 手册有效范围 |
  | --- | --- | --- | --- |
  | **R_ISET** | **R2+R9 = 1 kΩ+1 kΩ = 2 kΩ**（串联到 GND） | **I_CHG = 445 mA**（typ；398–488 mA） | 590 Ω – 8.9 kΩ ✅ |
  | **R_ILIM** | **R8+R10+R11 = 1 kΩ×3 = 3 kΩ**（串联到 GND） | **I_IN-MAX = 508–537 mA** | 1.1 kΩ – 8 kΩ ✅ |

  **结论：充电电流 ≈445 mA、输入限流 ≈520 mA，`I_IN > I_CHG` 成立**（手册要求输入限流必须大于充电电流，
  否则按输入限流充）。这与原"固定 500 mA"的设计意图高度一致，属**可用配置**。
  > ✅ **E.10 #18 就此关闭**（2026-10-28 按 BQ24074 手册核实）。
  > 注意：串联电阻链（2 kΩ / 3 kΩ）是图纸实现方式，**BOM 上是 5 个 1 kΩ**，
  > 若日后要改电流只需改其中一颗，无需改走线。
- - **EN1（6 脚）**：`BQ_EN` ← MCU **PC1**，R47 10 kΩ 下拉（**默认关闭充电**，固件拉高使能）。
  > 注意 BQ24074 有两个使能脚 EN1/EN2，本设计**只接 EN1**（EN2 在本板上未单独引出，按手册默认即可）。
- **TS（1 脚）**：电芯自带 NTC 经 CN3（1×3P）直连。BQ24074 的 TS 逻辑与 BQ24040 同为 JEITA 温区监测；
  **若改用不带 NTC 的电芯，TS 需接固定电阻到地**（具体阻值按 BQ24074 手册）。
- - **充电状态监测（2026-10-22 重构）**：**CHG / PG 双开漏信号接入 MCU**——
  **BQ_CHG（U2-8）→ PC2**、**BQ_PG（U2-5）→ PB5**，各经 **100 kΩ 上拉到 VCC**（图上 R11/R10）；
  两脚同时直驱 LED（灌电流，LED 阳极接 BQ_x、阴极经 10 kΩ 到 VBAT），灯态与 MCU 读数一致。
  固件读法：**PB5 低 = USB 插入且 VBUS 正常**；**PC2 低 = 正在充电**、PC2 高阻（读高）= 未充/已充满。
  配合 VBUS_MON（E.8.3）分压阈值可区分"插充电头"与"插 PC"。
  > CHG 是"正在充电"而非"输入有效"：电充满时 CHG 释放，故不能用 CHG 判"USB 是否插着"——
  > 该职责由 **PB5=BQ_PG**（输入电压窗口指示）与 VBUS_MON 共同承担。

### E.8.5 软开关与保护

开/关机（2026-10-13 勘误：原文"PWR_BTN 经二极管强制拉高 ANA_EN（及数字域保持路径）→ MCU 上电"与定稿矛盾——
按键对地、低有效，经二极管拉不高 EN；数字轨 TPS7A0233 常开，MCU 始终有电，不存在按键上电。该二极管路径删除）：
**数字域常开，"关机"即 MCU 关模拟域（`ANA_EN` = 0）后进入低功耗模式**；PWR_BTN（PB1 = WKUP4）唤醒 MCU，
固件确认后拉高 `ANA_EN` 开机；长按关机。电芯自带保护板（过充/过放/过流）。
低功耗策略：**只预留手段不深做**（2026-10-28 用户决定"不需要极致低功耗"，TF 卡改常电）。
模拟轨 EN 受控、LED 可关、MCU 可进 Stop 3；**不追求 µA 级待机指标**，
待机预算见 E.8.6（已按 575 + TF 常电口径重算）。续航指标待装机实测。

### E.8.6 待机电流预算（2026-10-13 新增，手册核实）

口径：电池供电、无 USB；`ANA_EN` = 0（模拟域断电）；MCU Stop 3（GPIO 输出不保持，控制脚靠下拉为低）；
**本版无 TMP117**；**TF 卡常电（无 SD_PWR_EN，见 E.11.3）**；LED 全灭；VDD 3.3 V、25 ℃ 典型值，电池按 3.8 V 计。

> ⚠️ **2026-10-28 口径变更**：本表从"追求 µA 级待机"改为"工程实用口径"。
> 用户明确不需要极致低功耗，**TF 卡不再断电**（省掉高边开关与 PA8 控制），
> 代价是待机电流增加 TF 卡自身待机（50–100 µA，**且卡不在位时为 0**）。
> 下表数值保留原实测依据，但**合计已不再代表设计目标**，仅供参考。

| 项 | 电流 | 依据 |
| --- | --- | --- |
| MCU Stop 3 | **7.7 µA**（全部 SRAM）/ **4.6 µA**（只留 8 KB SRAM2） | DS14216 **Table 62**（Stop 3 on LDO、RTC 停、3.3 V/25 ℃，2026-10-14 二轮复核；原 4.3/1.9 与 14.5/5.3 两组值均非本芯片手册数值）。内部 SMPS 稳压可降至 2.30 / 1.55 µA（Table 65），本设计不启用 |
| VBAT_MON 分压（2×1 MΩ） | 1.9 µA（电池 3.5–4.2 V 时 1.75–2.1 µA） | 计算 |
| **VBUS_MON 分压（1 MΩ/1 MΩ）** | **≈ 0 µA** | 接在 VBUS 上；本口径"无 USB"→ VBUS 侧无源、无回路，**不计入电池预算**。USB 插着时 2.6 µA，但那会儿设备由 USB 供电 |
| BQ24074（VIN = 0，BAT 端漏电） | ≤ 1 µA（按上限计） | BQ24074 手册 IQ(off)；**换料后需按新手册复核**（原 SLUS941 为 BQ24040 数据） |
| ~~TMP117 关断~~ | **0 µA（本版不装）** | 2026-10-28 取消 I²C/TMP117，见 E.5.2 |
| TPS7A2033 关断（EN = 0） | 0.07 µA（max 0.2） | TPS7A20 手册 ISHDN |
| TPS7A0233 静态电流 | 0.025 µA | TPS7A02 手册 |
| **TF 卡（常电，2026-10-28 改）** | **50–100 µA（卡在位）/ 0 µA（无卡）** | 已取消 SD_PWR_EN 高边开关，TF 卡直连 VCC。**这是本版最大待机项**，属用户明确接受的取舍（不需要极致低功耗）。若要恢复 µA 级待机，需重新加回高边开关 |
| **已知项合计（旧口径，仅供参考）** | ~~≈ 10.8 µA~~ | **2026-10-28 旧口径作废**：现口径下 TF 卡常电 +50–100 µA、TMP117 取消 −0.15 µA，**实际合计约 60–110 µA（卡在位）** |
| ADS131A02 IOVDD（AVDD 断电、IOVDD 常开） | **未知，待实测** | **此工况合法**（§11.3 原文："The power supplies can be sequenced in any order"），手册只是没给该工况的电流数；工作态 IOVDD 0.5–0.8 mA，带 16.384 MHz 时钟的待机态整片功耗 2.6 mW（SBAS590E）。若断 AVDD 后晶振与数字核仍在运行，此项会比上面合计大一个数量级以上 |
| 电芯保护板 | 待电芯选定 | E.10#6 |

> 在 ADS131A02 IOVDD 一项实测或定方案之前，**不能**按上面合计估算续航；E.8.2 的"−27 %"也只对已知项成立。
> **2026-10-28 变化说明**：本表口径已从"µA 级待机"改为"工程实用"。主要变化：
> ① MCU 换 575（无 SMPS，Stop 3 取 DS13737 值，与 545 同族水平）；② **TF 卡改常电**（取消 SD_PWR_EN，
> 这是 +50–100 µA 的最大单一项，但用户明确接受）；③ TMP117 取消（−0.15 µA）。
> **旧版"≈10.8 µA 合计"不再适用**，保留该行仅为追溯历史决策。
> 若将来要回到低功耗路线，第一优先恢复 TF 卡断电（收益 50–100 µA，远大于其他项）。
>
> **合法性已定（2026-10-14，手册核实，销 E.10#11 的安全性部分）**：§11.3 Power-Supply Sequencing 原文
> *"The power supplies can be sequenced in any order but the analog or digital inputs must never exceed the
> respective analog or digital power-supply voltage limits."* → **AVDD 由 `ANA_EN` 门控、IOVDD 常开是允许的**，
> 唯一约束是"输入不得超过各自电源"，本设计**天然满足**：
> ① 数字脚（SCLK/CS/MOSI/M[2:0]/RESET）对标 IOVDD——IOVDD 常开 3.3 V，MCU 照常驱动，不违规；
> ② 模拟脚（AIN0P/0N、AIN1P/1N）对标 AVDD——3.3V_A 断电时整个前端（R_top 偏置、3 颗跟随器、恒流源）
>    都失电，T/M/B 经 R_b 与各 RC 自然归零、E 本就是 AGND，**没有别的电源能把它们抬起来**，故 ≤AVDD = 0 V 成立。
>
> 因此 **E.10#11 缩窄为纯功耗数值实测项**：只需测"AVDD 断电后 IOVDD 还剩多少电流"。
> 原备选"把 IOVDD 改接受控轨"**建议放弃**——它反而会引入"断电期间 MCU 不得向 ADC 数字脚输出高电平"的
> 固件约束（数字脚失电时输出高会经 ESD 二极管倒灌），比现状更麻烦且无收益。
> 若实测待机 IOVDD 过大，对策改为：待机前发 **STANDBY** 命令并保持 nRESET 低（Stop 3 下需用 PWR 下拉维持），
> 必要时停掉 16.384 MHz 晶振（`CLK_SRC` 相关位），仍不改电源走线。

## E.9 交互、指示与连接器（✅ 2026-10-12 定稿）

| 项 | 定案 |
| --- | --- |
| 按键 | 2 键：电源（长按开/关机）+ 测量（启停记录/锁定读数）；校准仅上位机指令触发（防现场误触发写坏系数）。**电气（2026-10-13 定值）**：按键对地，每键 **100 nF 硬件去抖**（τ≈4 ms，配固件 20 ms 确认）；上拉用 MCU 内部（固件配置，省 2 电阻；低功耗模式下需在 PWR 中保持上拉）；两键接 WKUP 脚（PB1 = WKUP4、PA0 = WKUP1，见 E.6），无二极管软开机路径（E.8.5） |
| LED | 档位 4 颗 **0603 AlInGaP**（红/黄/橙/绿，Vf 2.0–2.2 V；**不可用 InGaN 绿/蓝**——Vf≈3.0 V 在 3.3 V 轨上电流不足）+ **1 kΩ** → If 1.1–1.3 mA，四档亮度一致；灌电流驱动（阳极经 R 到 3V3_D，GPIO 低电平点亮），同一时刻只亮一档。电源/USB 状态 1 颗同族 1 kΩ；充电 1 颗见 E.8.4（VBUS+2.2 kΩ→CHG）。**引脚（2026-10-14 重排，二轮复核修正）**：绿=PC2、黄=PC3、橙=**PB14**、红=PC6、状态=PC7（LQFP64_SMPS 无 PC4/PC5；DRDY 已改 PA9，橙灯改 PB14，见 E.6） |
| 被测件接入 | **4 × SMA 母座（J5–J8），两线/四线兼容**（2026-10-17 用户定）：J5=I+（→T）、J6=V+（→OPA388(T)→AIN0P）、J7=I−（→K1/K2→X）、J8=V−（→K3/K4→M→OPA388(M)→AIN0N）；**JP1（J5↔J6）/ JP2（J7↔J8）跳线**：焊上 = 两线制（只接 J5、J7 两根线），不焊 = 四线制（4 根线 + 2 只 Kelvin 夹）；接线示意与误差表见 `docs/design/diagram/两电极四线制接法.svg` |
| USB | **Type-C 母座**，CC1/CC2 各 5.1 kΩ 下拉（纯 UFP） |
| 调试 | 6P 排针（3V3/GND/SWDIO/SWCLK/NRST/SWO）+ LPUART1 TX/RX 预留焊盘（U545 无 USART2，见 E.6） |
| 温度探头 | **外置成品 TMP117 探头，4 线到板**（VDD/GND/SCL/SDA）；连接器**用户自选**（板侧留 4P 焊盘，建议 1.25 mm 间距）；采购要求 ADD0 接地版（地址 0x48，否则固件扫 0x48–0x4B） |
| **TF 卡座** | **micro SD 8P 卧贴**（含卡检测开关，CD 接 **PA15**；**不接 WP**，写保护由固件标志承担）。供电**直连 VCC（常电）**——2026-10-28 取消高边开关；详见 **E.11**。料号由用户在 E.10#6 BOM 阶段定 |
| ~~NTC 备选~~ | ❌ **2026-10-14 撤销**：原占位 PC1 让给 **VBUS_MON**（E.8.3）——TMP117 已定稿、PT100 已否（E.5.2），板载 NTC 备选的实用价值低于"USB 在线检测"这一功能需求。PT100+MAX31865 的预留 SPI2 亦因 PB9/PB13 转予 SDMMC 而失效，见 E.6 |

## E.10 挂起项（定版前需清；2026-10-12 用户挂起 → 2026-10-13 起逐项清理）

| # | 项 | 结论 / 推荐值（2026-10-13 更新） |
| --- | --- | --- |
| ~~1~~ | ~~VSET 分压网络细化 + 关断机构~~ | ✅ **2026-10-13 定稿 → 见 E.2.1**（360 kΩ/200 kΩ 1%；BSS138 + 1 MΩ 栅极下拉；信号由 `CURR_EN` 正名 `CURR_DIS`） |
| ~~2~~ | ~~恒流源运放落定~~ | ✅ **2026-10-13 落定 OPA333**（Iq 17 µA vs OPA388 1.7–2.6 mA；DC 环路不需要 10 MHz GBW）→ 见 E.2 |
| ~~3~~ | ~~TS 脚网络 R 值~~ | ✅ 已定：**本设计用带 NTC 的电芯**，TS 经 CN3 直连电芯 NTC，**板上不设固定电阻**（E.8.4）。2026-10-28 换 BQ24074 后此结论不变 |
| ~~4~~ | ~~抗混叠 RC 定值~~ | ✅ **2026-10-13 定值**：每线 **1 kΩ + 10 nF 到 AGND** → fc≈15.9 kHz、τ=10 µs（原 100 nF → 7τ≈700 µs 过紧；E.4 与 E.10 原值互相矛盾，已统一） → 见 E.4 |
| ~~5~~ | ~~LED/按键参数（颜色、限流、去抖）~~ | ✅ **2026-10-13 定值**：AlInGaP 0603 + 1 kΩ（1.1–1.3 mA，禁 InGaN 绿/蓝）；按键 100 nF 去抖 + 内部上拉；充电灯 VBUS+2.2 kΩ→CHG → 见 E.9 / E.8.4 |
| 6 | 方向性 BOM 核实 | 🔸 **设计侧已定（2026-10-13）**：Rsense 150 kΩ/0.1%/≤25 ppm/℃、R_ref 100 kΩ/0.02%/≤25 ppm/℃（R33 = PTFR0805Q100KN9，0805 薄膜精密）；**晶振按 ADS131A02 手册 Table 5 推荐料**（ECS-163-18-5PXEN-TR / Abracon ABM3C-16.384MHZ-D4Y-T / ABLS-16.384MHZ-L4Q-T，负载电容按手册 Figure 36b）；Type-C 16P（USB2.0 + CC×2 5.1 kΩ）；电芯 103450 1S + 保护板（**是否带 NTC 决定 E.8.4 主/备方案**）；K2/K4 的 NC 开关如需二供，可选 pin 兼容的 TPTMUX1102 类。**价格/库存/交期由用户负责核实** |
| ~~7~~ | ~~TMP117 探头连接器选型~~ | ✅ **2026-10-28 关闭**：本版**不做 I²C/TMP117**（用户决定），该连接器取消；将来恢复温度补偿时重新选型 |
| ~~8~~ | ~~前端跟随器轨压余量（2026-10-13 审查新增）~~ | ✅ **2026-10-13 定稿**：T 点加顶端偏置 R_top 10 kΩ / R_b 150 kΩ（E.2）；跟随器 4 → 3 颗，AIN1N 直接经 RC 接 Rsense 底端（E.4）；全角落距电源轨 ≥0.199 V（要求 ≥0.15 V），LTspice 复核 ≥0.203 V。原问题：T 即 OPA388 正轨、E 即负轨、基线时 S 距正轨仅 80 mV，ch0 误差 mV 级 |
| ~~9~~ | ~~ADC 失调校准（2026-10-13 审查新增）~~ | ✅ **2026-10-13 定稿**：新增零点模式（K1、K2 均断 + `CURR_DIS` = 1，ch0 读 δ0）；SEL_CURR 拆为 SEL_K1 / SEL_K2（**2026-10-14 引脚重排：原 PC5/PC3 → 现 PB5/PB8**，见 E.6）；残余典型 ≈0.03 %、最坏 ≈0.12 % R₀ → 见 E.3.2–E.3.4。原问题：ADS131A02 失调 500 µV typ、无片内失调校准，单点 R_ref 只校增益 |
| ~~10~~ | ~~恒流源 / Rsense 拓扑与两张图统一（2026-10-13 审查新增）~~ | ✅ **2026-10-13 LTspice 定案（变体 A）**：运放反相端接 BSS138 **源极（B=Rsense 顶）**、Rsense 底端 E=GND、漏极经 K1/K2 接 S/F——I=VSET/Rsense 全 R 恒定 7.857 µA；**Rsense 在漏极路径的画法为正反馈、锁死零电流（仿真证伪）** → 见 E.3.1 勘误与 `hardware/sim/ccsource/`；rref 图与前端图已按此重画，并同步 #8、#9 结论（2026-10-13） |
| 11 | ADS131A02 待机 IOVDD 电流（2026-10-13 新增；**2026-10-14 缩窄**） | 🔸 **合法性已定、只剩数值待实测**：§11.3 明示 "power supplies can be sequenced in any order"，**AVDD 门控 + IOVDD 常开合法**，且"输入不得超过各自电源"本设计天然满足（逐条推导见 E.8.6）。故**"改 IOVDD 供电方式"备选已放弃**（反而引入数字脚倒灌约束、无收益），本项**不阻塞原理图**；上板后测待机 IOVDD 电流，过大则改用 STANDBY + 停晶振对策（不改电源走线） |
| ~~12~~ | ~~DS14216 / SLUS941 待核项~~ | ✅ **2026-10-14 二轮复核全清（均按手册原文，不再凭记忆）**：① PC1 = **ADC1_IN2**、PC0 = **ADC1_IN1**（Table 27，E.6 已改）；② **ADC 高阻源合法**：Table 106 的 RAIN 上限注 3 明示 "Values without external capacitor"，两路监测节点 100 nF ≫ 2^12×CADC(5 pF)≈20.5 nF；代价转为采样间隔约束（τ=50 ms，≥100 ms 级轮询，已写入 E.6）；**采样时间的离散档 DS14216 未列 → 转 #17④**；③ 低功耗表号已补：**Stop3 LDO=Table 62（4.6/7.7 µA）**、SMPS=Table 65（1.55/2.30 µA）、**Standby=Table 68（0.52 µA）**、**Shutdown=Table 70（0.40 µA）**，E.8.5/E.8.6 已按 Table 62 更正；④ ~~BQ24040 确有 PG 脚~~ → 2026-10-28 换 **BQ24074**，PG 为 **7 脚**（开漏低有效）；⑤ SDMMC1 D0–D3/CK/CMD **全手册仅映射 PC8–PC12/PD2**（Table 28），E.11.2"只能落 PC 口"成立。**另清出 4 处换脚**（LQFP64_SMPS 无 PC4/PC5/PB9/PB12：DRDY→PA9、SD_CD→PA15、ANA_EN→PB15、LED 橙→PB14）与电源脚更正（无 VCAP；VDD=19/33/64、VSS=18/32/47/63），均见 E.6 |
| ~~18~~ | ~~BQ24074 ISET/ILIM 系数待核~~ | ✅ **2026-10-28 关闭（按 TI BQ24074 手册 SLUS812 核实）**：K_ISET = **890 A·Ω** typ、K_ILIM = **1610 A·Ω**（500 mA–1.5 A 档）/1525（200–500 mA 档）。图纸实测 **R_ISET = R2+R9 = 2 kΩ** → **I_CHG = 445 mA**（398–488）；**R_ILIM = R8+R10+R11 = 3 kΩ** → **I_IN ≈508–537 mA**。**输入限流 > 充电电流，配置合法**，与原"固定 500 mA"意图一致。详见 E.8.4 |
| **13** | **TF 卡持续写性能实测（2026-10-14 新增）** | 🔸 冲击态需求 **768 KB/s**（128 kSPS × 2 ch × 3 B，E.4.3）。4-bit SDMMC @ 24 MHz 纸面 1.5–2 MB/s，但 FatFS 簇对齐、擦除阻塞、卡质量差异都可能吃掉余量。**上板实测**：连续写 60 s 无丢帧 + 平均吞吐 ≥1 MB/s。不合格对策（按序）：加大 RAM 环形缓冲 → 冲击态降采样存储 → 分片写多文件避免单簇擦除长阻塞。见 E.11 |
| **14** | **SDMMC 时钟源配置（2026-10-14 新增；2026-10-16 补现值）** | 🔸 SDMMC1 kernel clock **不能取 PLL1R（SYSCLK）**。现 IOC 中 `RCC.PLL2QoutputFreq_Value = 258 MHz`、**`RCC.SDMMCFreq_Value = 80 MHz`**（2026-10-16 直接读 IOC 文件核实）——**80 MHz 远超 24 MHz 限值，比"PLL2Q=258"本身更直白地说明现在是错的**。需在 Clock Configuration 里把 PLL2Q 重配到 48 MHz（或改选 CLK48/HSI48 供 SDMMC），并确认改后不影响其它 PLL2 负载。**原理图不受阻，生成代码前必须处理** |
| ~~15~~ | ~~USB SOF 与 PA8 冲突检查~~ | ✅ **2026-10-14 二轮复核销号**：CRS 的 SOF 同步走**内部信号**、不占引脚；PA8 的 USB_SOF(AF10) 仅为可选观测输出，本设计不使能 → **PA8 = ADC_nRESET 无冲突** |
| ~~17~~ | ~~RM0456 待核项~~ | ✅ **2026-10-22 全清**：① BCD 使能路径——随 BC1.2 判 DCP 逻辑删除作废；② SMPS 不启用的 VLXSMPS/VDDSMPS 处置——随 SMPS 启用（IOC `PWR_SMPS_SUPPLY`，与图上 L1 一致）作废；③ **复位后默认稳压器 = LDO（范围 4）**（RM0456 §10.5.2 明文），固件经 REGSEL 切 SMPS，**切换前须先把系统频率降至 110 MHz 以下**（同节；适用型号条款未明写 U545，固件照此流程最稳）；④ **ADC12 采样时间 8 档（SMP[2:0]）= 5 / 6 / 12 / 20 / 36 / 68 / 391 / 814 周期**（RM0456 §33）——对照 E.6 判据：**VBAT/VBUS 选 68 档**（≥64）、**VREFINT 选 391 档**（≥320）；CubeMX 清单里的 47.5/247.5 Cycles 系凭惯例误填 |
| ~~16~~ | ~~IOC 时钟源与 E.7 定稿矛盾~~ | ✅ **2026-10-28 关闭**：用户决定**首板贴装 HSE 16 MHz 晶振**（板上 X4/C1/C2/R1 已布已贴），E.7 已改写为"首板贴 HSE、MSIS 作备选"。**既然晶振实装，IOC 里 `RCC_PLLSOURCE_HSE` 不再自相矛盾**——HSE-PLL 与 MSIS-PLL 两条路都可用，固件改一行即可切换。**注意仍需 CRS**：USB 用的是 HSI48（非 PLL 分频），HSI48 ±1 % 必须靠 CRS 从 SOF 校准到 ±0.25 % |

**外部输入依赖（不阻塞原理图）**：分档阈值（R/R₀–位移标定曲线）、温度系数实测、"R₀ 1%"适用区间。

## E.11 TF 卡数据记录子系统（✅ 2026-10-14 定稿）

### E.11.1 为什么需要外置存储

| 场景 | 数据量 | 512 KB Flash / 274 KB RAM 够吗 |
| --- | --- | --- |
| 冲击全程采满（E.4.3） | 128 kSPS × 2 ch × 3 B = **768 KB/s**；10 ms 冲击 ≈ 7.7 KB，但若需记录前后各 50 ms ≈ 77 KB | RAM 勉强够单次事件，**Flash 存不了历史**（512 KB 含固件+校准+磨损均衡余量） |
| 准静态长期监测 | 1 kSPS ≈ 6 KB/s，连续 1 h = **21.6 MB** | 完全不够 |
| 多次冲击事件归档 | 视现场试验次数 | 不够 |

→ **必须外置大容量非易失存储**。TF 卡相对 QSPI NAND / eMMC：免焊死、可现场换卡取数、成本极低、FatFS 生态成熟。

### E.11.2 接口选择：SDMMC 4-bit（否决 SPI 模式）

| 方案 | 实测可持续吞吐 | 判定 |
| --- | --- | --- |
| SPI 模式（SPI2 @ 20 MHz） | 250–500 KB/s | ❌ **低于 768 KB/s 需求，冲击态必丢样**；且 SPI 模式卡内时序退化 |
| **SDMMC 1-bit @ 24 MHz** | 1.5–2 MB/s | ✅ 够用，仅 3 信号脚；曾作首选 |
| **SDMMC 4-bit @ 24 MHz** | 3–8 MB/s | ✅ **2026-10-14 用户定稿采用**，余量 4–10×，为后续提高记录通道数/采样率留空间 |

> 1-bit → 4-bit 的引脚代价：D0–D3 / CK / CMD 在本芯片**全手册仅映射 PC8–PC12 / PD2**（DS14216 Table 28，
> 2026-10-14 二轮复核；原注"PB4/PB10/PB3 备选被占用"系误记——这三脚**根本没有** SDMMC 映射），
> 因此把 LED_ORANGE、LED_RED 从 PC8/PC9 挪走（E.6）。
> 这是本次重排的唯一"被动改动"，其余均为主动聚堆优化。

### E.11.3 电气与走线规则

```
3.3V_D ── TF 卡 VDD          ← 2026-10-28：取消高边开关，TF 常电

PC8 D0 ──33 Ω──┐
PC9 D1 ──33 Ω──┤
PC10 D2 ──33 Ω─┼──→ TF 卡座（走线等长 ±5 mm）
PC11 D3 ──33 Ω─┤
PC12 CK ──33 Ω─┤   （CK 单独 ±10 mm，是时序参考）
PD2  CMD ─33 Ω─┘   + CMD 10 kΩ 上拉到 VCC
PA15 CD  ←── 卡座内置机械开关（插卡拉低），内部上拉，EXTI15 下降沿
```

| 项 | 定值 / 规则 |
| --- | --- |
| 串阻 | 每根 **33 Ω**，**靠 MCU 端**放置（不是卡座端） |
| 等长 | D0–D3 + CMD **±5 mm**；CK **±10 mm**（CK 为参考，允许略短不允许长） |
| CMD 上拉 | 10 kΩ 到 **VCC**（TF 常电后不再有断电倒灌问题）；图上为 R41 串阻 + R50 上拉 |
| 卡电源去耦 | 卡座 VDD 处 **1 µF + 100 nF**（写瞬态 80–100 mA） |
| ~~高边开关~~ | **2026-10-28 取消**：TF 卡直连 VCC（用户不需要极致低功耗，见 E.8.6）。PA8 悬空 |
| 参考时钟 | SDMMC kernel clock 走 PLL2Q=48 MHz 或 CLK48，**不得用 SYSCLK**（E.10#14） |
| CKIN | **不接**——SDR12/SDR25 以下不需反馈时钟，本设计 24 MHz 起步 |
| WP | **不接**（E.9） |
| 布局 | 卡座靠板边便于换卡；6 根信号**不跨板分区**，从 MCU PC 端口一侧直接扇出；**不得穿越模拟区**（RS 级噪声对数字线无所谓，但走线占位会挤压模拟布局） |

### E.11.4 软件栈与数据组织

| 层 | 选择 | 说明 |
| --- | --- | --- |
| 驱动 | CubeMX **SDMMC1** + **FATFS**（Interface = SDMMC） | 启用 SDMMC DMA（SDMMC 自带），避免 CPU 搬运拖累 768 KB/s |
| 文件系统 | **FAT32**（exFAT 在 FatFS 需授权且 MCU 端支持参差） | 簇大小 **32 KB**：大簇减少 FAT 链遍历与擦除频次，利于持续写 |
| 组织 | 按会话建目录/文件；冲击波形与准静态时序分文件类型 | 上位机解析格式在 `shared/protocol/` 定义（改协议须成对更新，见 AGENTS.md） |
| 写入策略 | **双缓冲 + 空闲时刷盘**；卡不在位则退回 RAM 环形缓冲并可经 USB 补传 | 防止擦除阻塞卡住采样中断链 |
| 掉电安全 | TF 常电后**无 MCU 侧断电动作**，掉电安全只剩"正常卸载（`fx_media_close` / flush）"一道防线 | 异常掉电（拔电池）仍可能丢 FAT 表，建议定期 flush；这是常电方案的固有代价 |
| 卡状态 | PA15 CD 中断 → 触发挂载/卸载；固件在卡不在位时**禁止任何写路径**并把记录改走 USB/RAM | 避免空转报错 |

### E.11.5 待验证（不阻塞原理图）

E.10 **#13**（持续写实测）、**#14**（SDMMC 时钟源）。
卡型号建议 A2 级 / 支持 4-bit high-speed 的工业级 TF（写吞吐与耐用度显著好于普通消费卡）；
**具体料号与库存由用户在 BOM 阶段核实**（E.10#6 口径）。

## 附录 F 直流首板实施基线（2026-10-24，优先于旧正文与附录 D/E）

### F.1 范围与证据

> **2026-11-04 固件更新**：已实现直流首板采集、参考校准/持久化、SD记录、USB/串口控制、RTC/电池和安全软关机，
> 见[固件说明](../../firmware/DE-DRMS-Code/README.md)与[实施记录](2026-11-04-firmware-implementation.md)。
> 原文的硬件/EDA快照保留用于追溯，不能将其“只有初始化/没有代码”的状态沿用到当前工作区。
> 默认4 kSPS，高速采集与约2.048 MB/s@128 kSPS记录、精度、待机唤醒均未做实板验收；不增加性能承诺。

用户选择先做直流工程验证板，预留扫频扩展。本节与当前引脚表、重绘说明图为本轮目标；
旧正文和附录 A–E 保留设计历史，不再代表当前 BOM、引脚或已经达到的性能。
原理图/PCB 由用户修改；此次没有修改 `.epro2`。核查基线为 `9aa1a5f`，其中 V1.2 工程仍与
`1efa97a` 相同，U10 17/18 脚本地修正尚未进入该工程。本节不是投板放行记录。

- 客户反馈初始电阻约 10–20 kΩ，最大电阻未定；120 kΩ 是分析点，不是确认的上限。
- 分辨率、绝对准确度、动态跟踪误差分别验收；不再承诺旧文中的 0.005%、4½ 位或 600 kΩ 量程。
- 爆炸试验动态要求待客户定案，128 kSPS 是采集设计目标，不证明事件带宽已满足。
- 16 kHz 本机 DAC 扫频留后续阶段；直流偏置叠加小正弦可测该偏置点附近的复阻抗，
  但须交流电压/电流相量之比、线性与稳定性验证、频带覆盖及模型辨识，不能拿瞬时 V/I 当 CPE。
- 首板无 TMP117、无 TF 电源开关、无 VBUS ADC 分压；不沿用原低待机功耗预算。

### F.2 直流链路与控制

> **2026-10-25 用户确认，以当前已布线图纸为准：** PA4=ADS_CS，PA8预留；
> PB0=CURR_DIS、PB2=SEL_K2、PB10=SEL_SENSE。四根均用GPIO，SPI1软件NSS。
> 本节旧PB2/PB0控制表应按SEL_SENSE/SEL_K2语义读，即新表头PB10/PB2；
> 旧“CS迁PA8、PA4留DAC”计划取消。固件宏及已有IOC引脚配置已同步，
> 完整CubeMX复存/重新生成仍须核验，不能把旧IOC直接覆盖到当前源码。

AVCC=3.3 V，R27=360 kΩ、R28=200 kΩ，名义 VSET=1.17857 V；
R26=150 kΩ，名义电流约 7.857 µA。OPA333+BSS138 为低边恒流源。
T 顶端由 10 kΩ/150 kΩ 偏置；有限合规电压约束量程，不能把 600 kΩ 当成该电流下的恒流量程。
三颗 OPA388 缓冲 V_P、AFE_M、AFE_B；Rsense 底端 Kelvin 地直接进第二通道的 RC，不能缓冲地电位。
U7 物理通道名用 AIN1P/N、AIN2P/N；仿真 CH0/CH1 是同两通道的零基编号。

首板保留激励抑制管（V1.3 为 Q3，V1.4 重编号为 **Q2**）：D→VSET，S→AGND，G→PB10；高电平压低激励设定，不宣称精确零电流。
**激励抑制管栅极偏置从 1 MΩ 下拉改为 100 kΩ 上拉到数字 VCC**（V1.3 位号 R29，V1.4 重编号为 **R17**，管子 Q2），使 MCU 复位时默认抑制激励；
ANA_EN 外加 100 kΩ 下拉。此选择适用于固定分压直流首板，未来接 DAC 时须重新设计隔离/限流，
不可把 DAC 输出直接并到仍受 Q3 钳位的 VSET。当前固件保持 ANA_EN=0、CURR_DIS=1、ADS_RESET=0。

U10 连接（待用户在新版工程落实并复核）：PB2→SEL1/3/4（1/11/20 脚），PB0→SEL2（10 脚）。
17 脚 S4B→Rref 下端 F，18 脚 D4→AFE_M，19 脚 S4A→V_N。

| PB2 | PB0 | 目标状态（按 SEL=0 选 A、1 选 B，最终须核器件真值表） |
| --- | --- | --- |
| 0 | 0 | 测量：样品回流接 X，参考回流断开 |
| 1 | 1 | 参考：样品回流断开，参考接 X |
| 1 | 0 | 中间隔离/零点候选：两条回流均断开；零点有效性与恢复待验证 |
| 0 | 1 | 禁止：样品和参考同时接入 |

换路顺序：测量→PB2=1→PB0=1；参考→PB0=0→PB2=0。
换路前抑制激励、屏蔽数据有效标志，完成切换和恢复建立后再放行样本；建立时间须包含运放恢复与数字滤波。
**2026-11-04**：固件已按当前 SEL_SENSE/SEL_K2 真值表实现测量/参考切换；
隔离支路仍是未验证零点候选，不提供自动零点校准。
R32/R33 保留焊盘：四线 Kelvin 接法不贴，二线接法可装 0 Ω；两电极接触阻抗仍包含在测量中。

### F.3 AAF：T2 为首板候选，未全项达标

每根输入线：100 Ω 串联→10 nF 对 AGND→120 Ω 串联→10 nF 对 AGND；
每通道末端 P/N 间 820 pF。两通道共 8 颗电阻、8 颗 10 nF、2 颗 820 pF。
电容 C0G/NP0；0402 封装按已确认采购条件。电阻采用精密薄膜，容差与温漂记录进 BOM。
这组器件替换原 RC 群，不叠加在旧滤波器后面。两线镜像、末端电容靠 ADC、Kelvin 回路短，
完整地平面，远离 SPI/SDMMC/SMPS 高频回流；尚未完成板内布线和 DRC。

来源：六方案报告（本机 `hardware/sim/signalchain/aaf_pkg_review/REPORT.md`；该目录按 .gitignore 不入库，可由套件内 `gen_*.py`/`run_all.py` 重跑再生）。
T2：D1=62.33 dB（要求80，失败），D2=61.05 dB（要求60），D3=94.74 dB（要求100，失败）；
16 kHz 衰减标称0.412 dB、A5角0.461 dB，建立约32 µs均为该台架结果。
D6 正交增量 ch1=44.6% 超30%，不能只摘线性口径的通过值。
D8 理想整线配对约90.5 dB，不代表普通贴装量产；脚本精确相关偏差没有覆盖实际选配误差。
Kelvin 结构 L2 约56 dB仍未达80 dB。D10 是单通道群延迟平坦性，不是通道间时延。
选择 T2 是工程折中，禁止修改报告门槛或改写历史 FAIL 为 PASS。

台架 `pkg_subs.inc` 有 VSET 对地100 pF、Q2栅极对地1 nF，`ac_family.py` 有 F 对地100 pF，
原 V1.2 三处均无电容。**这三颗不进入必补清单**：先核稳定性与最终网表的一致性；
尤其 F 对地电容会使交流参考支路不再是纯100 kΩ。OPA333仍是行为模型，OPA388的PM不等于恒流环PM。
整链 AC 的串联 Vex 注入也不等于 DAC 调 VSET；未重跑 LTspice，报告数值仅做源码/CSV口径核对。

### F.4 电源与 USB 检测（已接受方案）

USB 原始 VBUS→D1 阳极，外部受限5 V→D16阳极，阴极汇合→BQ24074 IN；
BQ OUT直接供数字 TLV75533，并经原磁珠供模拟 TPS7A2033。OUT不加串联二极管。
外部5 V可供整机，也可能充电；本方案不保证外部5 V禁止充电。不并联调试器3.3 V与VCC。
BQ_PG仅说明BQ输入电源状态，不能区分 USB 与外部5 V，也不能授予USB取电电流。

数字VBUS检测参考：**MMBT3904（SOT-23）**或同类普通NPN（具体厂牌脚序、低电流饱和和漏电须按采购手册复核）：
USB插座原始VBUS、D1之前→100 kΩ→B；B→1 MΩ→E；E→GND；C→PC13；C→10 kΩ→VCC。
低=检测到USB供电，高=未检测到。PC13仅作输入，不作负载驱动。
约5 V时基极电流约42 µA、集电极上拉约330 µA，为器件选型核算点，并非全温保证。
这是存在检测，不是精密VBUS有效电压监控。不要接二极管OR之后，否则外5 V会误报USB。

**2026-11-04**：当前用户生成描述符为自供电 `bmAttributes=0xC0`、`bMaxPower=250`（500 mA），
VBUS附着/脱离和枚举后500 mA授权已接入固件；复位/挂起/未配置时撤销授权。
**BQ24074 EN2接地、EN1由PC1控制时，Low=USB100，High=USB500，Low不是禁止充电**。
仅此控制脚无法进入EN1=EN2=1的Standby；USB挂起取电合规及整机电流预算仍需硬件解决与实测，
不能仅凭描述符或软件分支宣称合规。

### F.5 用户改图清单

| 类别 | 元件/信号 | 操作与连接 |
| --- | --- | --- |
| 新增上拉 | ADS_CS | 10 kΩ→VCC，33 Ω的ADC侧；CS迁PA8，PA4留DAC |
| 新增下拉 | ADS_RESET | 10 kΩ→GND，33 Ω的ADC侧；固件完成启动后再释放 |
| 新增下拉 | SEL_SENSE、SEL_K2 | 各100 kΩ→AGND，共2颗 |
| 新增下拉 | ANA_EN | 100 kΩ→GND |
| 新增上拉 | BQ_CHG | 10 kΩ→VCC，LED支路不替代逻辑上拉 |
| 新增上拉 | SD_DAT0/1/2/3 | 各10 kΩ→VCC，共4颗（2026-10-24 用户定：与既有 10 kΩ 同料，不再引入 47 kΩ 新料；CMD 同为 10 kΩ） |
| 新增上拉 | SD_CD | 10 kΩ→VCC，卡座switch就是CD检测 |
| 修改 | 激励抑制管栅极偏置（V1.3 为 R29，V1.4 重编号为 **R17**，管子为 Q2） | 100 kΩ 上拉 VCC（原 1 MΩ 下拉取消；复位期 Q2 默认导通压低 VSET） |
| 修改 | R48 BQ_PG | 保留10 kΩ，把上端从VOUT移至VCC |
| 保留 | R25、R47 | MISO100 kΩ上拉、BQ_EN10 kΩ下拉 |
| 保留 | R56–R62 | 全部33 Ω；MCU输出信号靠MCU，ADS输出信号靠ADS |
| 删除 | C41 | 原两端同为AGND，无电气作用；C40有效去耦保留 |
| 替换 | AAF旧RC群 | 按F.3；不要沿用旧三/四级梯形值 |
| 新增 | USB检测 | NPN×1 +100 kΩ串基极 +1 MΩ基极下拉 +10 kΩ集电极上拉 |
| 修改 | U10（V1.4 重编号为 **U8**） | 17/18脚网络按F.2；已在 V1.3/V1.4 工程落实 |
| 预留 | PA4、VSET、AGND | 测试点；VSET固定分压路径留可断开0 Ω，DAC侧默认不接 |

明确必补的逻辑上下拉是11颗；USB检测另3颗电阻+1颗NPN；激励抑制栅极偏置（R17，旧编号R29）与R48为修改现有件。
AAF数量为替换后总数，不是额外叠加数量。暂不强制增加其他补偿/去耦电容。
C9/C10/C57现1 µF X7R须结合具体料号直流偏压与LDO稳定性要求复核；不据“可能不够”统一改值。
**Rref 精度冲突已解决（V1.3/V1.4）**：旧 R17 库料号 PTFR0805A100KN9（±0.05%）与旧图 ±0.01% 不符，
V1.4 已换 **R33 = PTFR0805Q100KN9（100 kΩ，Q 档）**，图注按该实际料号口径。
**2026-11-12 用户据实物核定：Q 档为 ±0.02%，不是 ±0.01%**（早前记录有误，已同步全文与 E.10 #6）。
因此校准后全量程的绝对精度天花板 = **0.02%**，`firmware/DE-DRMS-Code/README.md` 的能力描述按此口径。

**V1.4 对齐记录（2026-10-24）**：图纸 `hardware/ProPrj_双电极电阻仪_2026-10-24_V1.4.epro2` 已入库；
F.5 清单除预留测试点（暂留）外全部落实。全图重编号后的关键映射：激励抑制管 Q3→**Q2**、
其栅极上拉 R29→**R17**（100 kΩ→VCC 已改对）、TMUX U10→**U8**、Rref→**R33**（Q 档）、
OPA333 U13→**U3**；恒流源参数不变，V1.4 位号为 VSET 分压上臂 **R26=360 kΩ**、下臂 **R27=200 kΩ**、
Rsense **R32=150 kΩ**，Kelvin 焊盘 R28/R29=0 Ω（旧 R32/R33）；顶端偏置 R30=10 kΩ / R40=150 kΩ。
SD 数据线上拉按用户决定统一 10 kΩ（不新增 47 kΩ 料）；原“删除 C41”随重编号失效，
该位号已作 T2 对地电容，不得再按旧清单删除。

### F.6 软件状态与首板待验证

本轮修正GPIO方向、上电电平、PC1与ADC冲突，CS迁PA8、PA4保留模拟态；启用已有SMPS硬件的供电配置，
在升频前调用HAL供电切换；不再初始化不存在的温度探头。SPI引脚改High速率，33 Ω保留，上板检验20 MHz边沿。
SD初始化改在FileX打开介质时进行；无卡/初始化失败返回存储错误，挂载失败工作线程退出，不再关中断卡死整机。
卡热插拔恢复、错误上报、自动重试尚未实现，后续应在线程中实现，不能在CD中断中挂载文件系统。

~~`.ioc`仍是旧GUI基线，未手工增删IP；按[CUBEMX_SETUP](../../firmware/DE-DRMS-Code/CUBEMX_SETUP.md)复存后再生成代码，
否则覆盖本轮外设初始化修复。本轮编译通过只证明构建一致性，不证明仪器功能完整。~~
**2026-11-03 更新**：固件工程已按 STM32U575RGT6 重建为 `firmware/DE-DRMS-Code/DE-DRMS-Code.ioc`（TrustZone 关、
外设已在 GUI 勾选），上述"旧 IOC 复存"问题随之作废；但旧 545 源码里本节列出的手工修复（GPIO 上电电平、
SDMMC 无卡容错、FileX 挂载失败退出、SPI 输出速率）**不会自动带过来**，需向新生成的源码树逐条移植。
CubeMX 无 UI 的能力边界见 [CUBEMX_SETUP](../../firmware/DE-DRMS-Code/CUBEMX_SETUP.md) 顶部 2026-11-03 小节。

出板/上板待办：最终网表与模型一致性、U10切换/开短路恢复、参考校准、全链噪声/温漂、USB充电干扰、
真实PCB DRC与回流、输入保护漏电、低电与写卡尖峰时LDO余量。
固件尚缺ADS初始化与连续采样/DMA、校准状态机、记录格式和缓冲管线、USB电源状态机。
双通道128 kSPS仅6字节原始值已768 kB/s；12字节记录达1.536 MB/s，不能承诺USB FS同步全量上传。
TF保全量，USB做控制与降采样显示；主RAM256 KiB与SRAM4 16 KiB须按链接布局实际安排。
标记校准/建立/丢帧窗口，记录序号与配置版本；不能靠10 µF电容保证掉电刷盘。

### F.7 本轮验证记录

- ARM GCC编译、链接并生成ELF/HEX/BIN成功：text 63912、data 182、bss 36904字节。
- `python3 -m unittest discover -s test -p 'test_sd_startup.py' -v`：3项通过，编译实际`sdmmc.c`并模拟HAL，覆盖无卡、初始化错误/忙/超时、失败后再次初始化成功；不代表实物卡验证。
- 七张当前说明图的SVG门禁通过（XML、文字、缺字、导线和结点），同步更新生成器与2倍PNG并目视检查。
- 原理图/PCB、旧仿真CSV/报告和IOC未修改；无LTspice重跑、无硬件运行测试。
- 复核确认BQ_EN实际连BQ24074 EN1（6脚），EN2（5脚）与CE#（4脚）当前接地。
  因此不能把BQ_EN当作通用充电开关；需按具体数据手册真值表核实该接法能覆盖哪些USB限流/挂起状态，未核前不编写自动切档逻辑。
