chenxi-z/de-drms/docs/design/2026-11-04-firmware-implementation.md

# 2026-11-04 固件修复与验证记录

依据：用户授权处理复核中发现的软件问题；附录 F、当前引脚表、CubeMX 配置清单。
不修改 IOC、EDA、历史仿真，不自动提交或推送。

## 实施顺序

1. 恢复 SD 初始化状态的定义和声明；无卡、坏卡可返回并重试，FileX 等待期间让出 CPU。
2. 修正 RGT6 的 Flash 链接容量；接通 USBX 栈、OTG FIFO、PCD 启停及 PC13 检测。
3. 接上持续运行的应用线程、可观察的诊断状态和 CDC 通信；保持模拟电源和激励默认安全。
4. 对实际生产代码运行主机回归测试，进行 ARM 完整构建，再独立复核错误路径和重新生成边界。

## 用户追加：继续全部完成

2026-11-04 用户明确要求继续完成应用层，后续阶段纳入：

5. ADS131A02 上电、寄存器回读、固定 24-bit 帧与 CRC、DRDY/SPI DMA、丢帧统计。
6. 默认保持模拟电源关闭；通过命令启动，安全切换样品/参考；参考校准与 Flash 持久化。
7. 有界采集/记录缓冲，FileX 文件写入、正常停止 flush、错误降级；机器与人读协议成对更新。
8. 内部 ADC 电池检测、RTC 设置/有效标志、按键与诊断集成；扩展主机测试和完整构建。

实现默认采用低速上板调试采样档，128 kSPS 是可选待验收目标，不承诺逐帧 HAL DMA 路径已达到。
零点支路仍是附录 F 的待实测候选，不能通过软件将未验证的物理状态标为已校准零点。

## 验收边界

这些修复须通过无硬件测试与交叉编译。USB 枚举、电流预算、SD 卡实物兼容性、晶振启动、
ADS131A02 采样与持续记录吞吐量必须另外上板验证；不得以编译成功代替。
测量、校准、掉电持久化与记录协议需有可测试实现后才能声明完成；不虚构损伤分级阈值。

## 执行记录

- 修复前：`test_sd_startup.py` 编译生产 `sdmmc.c` 失败，`sd_init_status` 未定义。
- 已恢复状态定义/导出；无卡、坏卡、后续恢复可返回，FileX失败退让重试，取消/卸载不再被坏卡状态拦住。
- 独立审查发现并已修复：USB旧CONFIGURED快照恢复授权；首次插卡抖动导致NULL SD Instance清理；
  USBX实际软件超时返回码与残留端点/完成信号问题。CDC改为独立线程无限等待并用取消唤醒。
- 随后逐层复核修复：SD残留IDMA清理、DCD“已取消请求重新arm”竞态、CDC参数/会话边界、UART溢出重同步与DMA缓冲归属。
- 已实现源模块 `Core/Src/drms_*.c`：采集/DMA、CRC、比值测量、参考校准、双页Flash日志、
  FileX记录与约1GiB滚动、RTC/电池、命令队列、双通信口、按键/低电/安全Standby。
- 采集队列溢出主动抑制激励并停采，防止未经验证的高采样档造成IRQ饱和；记录队列溢出明确计数。
- 机器协议与人读协议已成对新增；C编码器产物交给Python解码器回归，损坏/丢帧/截断不伪装成有效测量。
- 测试覆盖真实生产C代码与真实SDK关键驱动；HAL、卡、USB主机、Flash介质通过边界替身模拟。
  测试包含并发SPSC、序号回绕、每个校准提交前缀中断、记录切换期间收样、低电/按键释放/迟到USB取消待机。
- 最终补充保护：SDMMC 在未进行高速模式协商时使用 24 MHz；ADS 启动前校验 SPI 为
  8-bit、Mode 1、MSB、软件 NSS，并先配置数字帧/CRC，再写模拟配置。
- 2026-11-04 最终本机门禁：`python3 -m unittest discover -s test -p 'test_*.py'`
  共 104 项全部通过；`python3 tools/firmware_postgenerate.py` 只读检查通过。
- ARM 构建通过，构建日志无 `warning:` / `error:`；ELF 的 text=114888 B、data=320 B、
  bss=709088 B。构建目录为 `/tmp/de-drms-release-check-20261104`，未把产物放入仓库。
- `git diff --check` 通过。本轮未修改 IOC/EDA，未自动提交或推送；本机测试不代替下述实板验收。

## 实施取舍

- 默认4 kSPS；128 kSPS只是可选待验收档。代价：首板不能把高速采集配置当成已经无损。
- 记录保留12字节完整ADC帧和4字节序号。代价：128 kSPS写卡约2.048 MB/s，须按此更高负载验收，不能沿用768 KB/s的纯通道载荷预算。
- 零点模式仍未进行物理验证；仅做参考比例校准，不虚构零点系数或损伤分档阈值。
- Flash仅接受本器件默认双Bank未交换映射，不自动改Option Bytes；不支持的布局返回显式保存失败。
- BQ24074当前EN2接地，软件无法进入USB Standby电流模式；这项留作硬件整改/验收，不称代码已解决。
