chenxi-z/de-drms/docs/design/2026-10-25-信号链论文构思.md

# 信号链设计论文构思（素材整理 + 可发表性评估）

> 2026-10-25。素材截止：V1.4 图纸、aaf_pkg_review/fo1_rc_review 两轮复核完成、首板未出。
> 本文按 howtoSCI 流程的"选题与构思"阶段整理：A 素材总表 → B 三个候选定位 → C 推荐定位与 IMRaD 骨架 → D 图表规划 → E 期刊候选 → F 缺口与两阶段策略 → G 下一步。

---

## A. 素材总表：设计过程与细节（逐项映射证据）

### A.1 测量原理层（为什么这样测）

| 决策 | 结论与理由（否决项） | 证据 |
| --- | --- | --- |
| 测量原理 | 恒流激励 + 双通道同步比值测量 R=(V_sample/V_Rsense)·R_sense；冲击 10ms 跟踪误差 <0.000023% | 主文档附录 E.1–E.4 |
| 否决电桥 | 两端电阻条物理上无法成桥 | AGENTS 已否决清单 |
| 否决分压激励 | 电流随 R 变 50%、自热不一致、断裂输出不定 | 同上 |
| 否决比例式（R_sense 即 ADC 基准） | ADS127L11 基准输入电流 ±2 µA 致命；换 ADS131A02 后 REFEXT 合法窗口 2.0–2.8 V vs V_Rsense 1.18 V，抬则量程崩——三重出局（范围/量程/收益） | sim README、aaf/ |
| 应用需求 | MWCNTs 导电网络结构损伤分级；R₀ 10–20 kΩ 起步、量程 10–120 kΩ、1% 精度、−4~−10 %/℃ 温度系数是决定性误差源（→比值+自校准） | 附录 D |

### A.2 恒流源（拓扑筛选全程）

| 候选 | 结局 | 一句话理由 |
| --- | --- | --- |
| OPA333 + BSS138 低边（**定稿**） | ✅ C3 双档终案 | 使能建立 0.093 ms（10.8× 余量）、PM 66.9–79.8°（288 步）、关断残流 0.195 nA |
| 改进型 Howland 电流泵 | ❌ | 反馈分压网络是样品电流旁路（破坏"同一电流"比值前提）；合规栈 +0.2–0.7 V；无天然关断 |
| LM334 | ❌ | ~1 V 起始压降 → 合规栈 3.1 V > 2.47 V，量程崩 |
| JFET 恒流二极管 | ❌ | ±10–20%、无 8 µA 档、无使能 |
| BJT 电流沉 | ❌ | 基极电流 0.5–1% 破坏串流前提 |
| 运放输出直驱 | ❌ | 合规差、无使能 |
| OPA391 换装 | ❌ | 实测使能建立无改善（瓶颈是栅极 1 nF 非 GBW），代价非零 |
| 真问题闭环 | ✅ | 校准态 147 kHz 自持振荡的判别实验（fs_disc A–D）：源阻抗阈值型，F 节点 100 pF 完全消振 | 

证据：`hardware/sim/ccsource/`、`signalchain/cc_*`、`fs_fullchain/README`。

### A.3 模拟前端与自校准

- 3×OPA388 跟随器（T/M/B 三线），**第 4 颗不做**：AIN1N 经 RC 直连 Rsense 底端 Kelvin 地——真实非对称接线，后成为 CMRR 结构地板的来源（A.6）。
- T 顶端 R_top 10 kΩ / R_b 150 kΩ 偏置；BAV199 低漏保护；R32/R33 Kelvin 焊盘（四线不贴/二线 0 Ω）。
- 自校准三层：0.1% R_sense 打底 + 0.02% R_ref（PTFR0805Q100KN9）+ 零点模式；单颗 TMUX1134 切换；k 校准中 R_sense 约掉、绝对精度锚定 R_ref。
- 证据：附录 E.2/E.3、`模拟前端与自校准.svg`。

### A.4 ADC 选型（否决链）

ADS131A02 定稿（2 ch 同步、24 bit、128 kSPS、内基准 2.442 V、3.3 V 直连、sinc³、fMOD 4.096 MHz）；否决 ADS127L11（比例式致命，见 A.1）、ADS1262（需 4.75 V）、AD779x（无基准缓冲）、ADS1235（500 nA + 5 V）。采样策略：冲击全程 128 kSPS 采满、按需数字降采样；768 kB/s → TF 记录（SDMMC 4-bit）。证据：附录 E.4、`adc-selection` 历史。

### A.5 AAF 四轮演进（本文最有发表价值的暗线）

| 轮 | 方案 | D1/D2/D3 (dB) | 件/通道对 | 状态 |
| --- | --- | --- | --- | --- |
| r1–r5 引擎寻优 | lad4r 四级（定案） | 91.3 / 90.7 / 149.9 | 17 | 全门槛过，面积大 |
| BOM 简化 | k3b 三级 FIN | 83.9 / 77.6 / 131.7 | 13 | 备选 |
| 布局极限 | 一阶 FO1（47Ω+47n+820p） | 40.7 / 46.4(F) / 62.7(F) | 5 | D1–D3 天花板 ≈−45 dB |
| 小封装六方案 | **二阶 T2（100+120Ω/10n×2/820p 全 0402）** | 62.3(F) / **61.05(P)** / 94.7(F) | 9 | Pareto 首选（首板采纳） |

证据：`aaf/`（r1–r5）、`signalchain/aaf_first_order/`、`fo1_rc_review/`、`aaf_pkg_review/`。

### A.6 验证方法学（论文的"方法"核心）

1. **十维门槛框架** D1–D10 + C9（衰减/通带/建立/噪声增量/容差 σ/CMRR/kickback/群延迟/peaking），门槛全程不降、FAIL 如实保留。
2. **三层验证**：L1 理想 RC（解析/线性 MC）→ L2 真实宏模型 LTspice（TI OPAx388.LIB + 恒流源 + 3 跟随器 + Kelvin 非对称接线 + ADC 等效负载与采样开关）→ L3 离线 sinc³ 系统层（比值链、折叠风险）；纪律：**理想 RC 结果不得冒充 LTspice 结果**。
3. **T00 回归锚定**：每轮复跑基线对锚定值（六项全中，偏差 <0.03 dB）。
4. **容差双配对口径**：未配对量产（R±1%C±5% MC n=1000 + ≥30 LTspice 角点）vs 配对（逐级各自配 / **整线同 m**）；发现二阶 R1·C2 交叉乘积项 → 逐级配对只 51 dB，整线同 m 恢复 90.5 dB。
5. **CMRR 双口径**：RC 自身（配对可控）vs 整链 Kelvin 结构地板 56.08–56.31 dB（拓扑决定、配对不可修复）。
6. **kickback**：3.5 pF 差分采样开关、4.096 MHz 双相 50%、Ron 扫 1/100/1000 Ω（声明假设）。
7. **混叠有界风险**：4.096/16.384 MHz ±{1k,8k,16k} 注入；16.384M 族瞬态实测为交流预测 1.65–8.5×；sinc³ 合成仅 −61~−64 dB。
8. **真实占地 vs 本体面积**：EasyEDA 工程副本实画六方案布局（184 焊盘读回验证），发现二阶全 0402 真实占地反小于一阶含 0805（32.62 vs 39.05 mm²/通道，−16.5%）。
9. **物理极限定量**：D4≤0.5 dB 把 fc 钉死 50–70 kHz → 4.096M/fc≈1.8 dec → 无源二阶理想极限 ~76 dB < 80；D1/D3 与 D4 在无源一/二阶内互斥（参数微调无解，需三阶/有源/数字合成口径）。

### A.7 系统集成素材（阶段二用）

MCU/存储/电源/USB/引脚/SMPS/六层叠层——首板 V1.4 已入库；附录 F 为实施基线。

---

## B. 三个候选定位

| 定位 | 内容 | 素材充分性 | 缺口 |
| --- | --- | --- | --- |
| **P1 方法学论文**：ΣΔ ADC 前端 AAF 的门槛化多目标选型与三层验证框架 | A.5+A.6 为主，A.1–A.3 做背景 | **现在就齐**（全部有 CSV/网表可复现） | 无实物数据（可定位为 design/methodology） |
| **P2 仪器论文**：面向压敏 CNT 网络 SHM 的双电极直流电阻测量仪设计 | A 全部 + 首板实测（噪声底、线性度、温度实验、标定） | 设计+仿真齐 | **实物实测全缺**（首板未出） |
| **P3 应用论文**：MWCNTs 传感层损伤分级的 R/R₀ 标定与监测 | P2 + 试件实验 | 最远 | 试件、拉伸台、分级阈值（需外部输入） |

**判断：素材完全支撑 P1 立即成文；P2 是更强的最终形态但必须等首板；P3 依赖客户试件。** P1 与 P2 不构成切香肠（salami）——P1 的对象是选型方法学（含物理极限证明），P2 的对象是整机与实测，二者问题不同、数据不同、结论不同；P1 发表后 P2 引用它即可。

> **2026-10-26 起本节为 v1 历史**——正式大纲已按文献终盘（168 条/A 级 19）重排，见论文独立仓库 `paper/outline.md`（IMRaD 大纲 v2，含逐段引用槽位与幽灵引用门禁；2026-10-29 起 `paper/` 为独立本地仓库）。

## C. 推荐定位与 IMRaD 骨架（P1，英文题名草稿）【v1 历史】

**题名草稿**（label 式、无废词、具体到器件与判据）：
- "Gated multi-objective selection of passive anti-aliasing filters for a 24-bit ΣΔ dual-channel resistance measurement front end: passband–attenuation–CMRR–area trade-offs verified by macro-model simulation"
- 备选（更短）："Passive anti-aliasing filter selection for ΣΔ ADC front ends under simultaneous passband, attenuation, CMRR, and footprint constraints"

| IMRaD | 内容（素材映射） |
| --- | --- |
| **Introduction** | SHM/压敏 CNT → 两端电阻测量 → ΣΔ 前端 AAF 设计困境（通带平坦 vs 高频衰减 vs 共模 vs 面积）；文献缺口：商用 ΣΔ 手册只给"RC>0.5·Rd"式粗则，系统化的多目标门槛化选型与 Kelvin 非对称通道的 CMRR 结构极限鲜有定量报告；本文目标与主要结论（T2 折中 + 无源一/二阶物理不可达证明） |
| **Methods** | ① 装置背景一段（恒流+双通道比值，引 P2/附录）；② 十维门槛定义表；③ 三层验证架构（L1/L2/L3、T00 锚定）；④ 容差 MC 双配对口径；⑤ CMRR 双口径定义；⑥ kickback 与混叠注入协议；⑦ 真实占地测量法（EDA 副本实画+读回验证） |
| **Results** | ① 基线回归表；② 六方案判定总表（D1–D10/C9）；③ CMRR 配对矩阵（交叉乘积项发现）；④ Kelvin 结构地板；⑤ Pareto（占地/电气）；⑥ 物理极限推导与实测印证；⑦ 混叠有界风险 |
| **Discussion** | 无源一/二阶 D1/D3–D4 互斥的机理与推广条件；Kelvin 单端直连通道的 CMRR 上界对同类双通道比值系统的意义；出路四方向（三阶/有源/数字合成/系统对策）；局限（仿真-only、宏模型温度窗、Ron/vcm 无手册值、真实板内落位未验证） |
| **Conclusions** | 三条：框架可复现（全部网表/CSV 开源式列出）；T2 为该约束族的首选折中；物理极限结论 |

## D. 图表规划（DRAW 轨道，全部英文重绘，Times New Roman，tpl_* 模板）

| 编号 | 内容 | 数据源 | 模板 |
| --- | --- | --- | --- |
| Fig.1 | 测量架构框图（恒流+双通道+Kelvin 非对称标注） | 整体方案框图重绘 | schematic |
| Fig.2 | AAF 拓扑族（一阶/二阶 T2/四级）与节点定义 | 现有 SVG 重绘 | schematic |
| Fig.3 | 验证流程（三层+T00 锚定+门槛） | 方法节 | `tpl_protocol_flowchart.py` |
| Fig.4 | 六方案差模/共模 Bode 矩阵 | `t01/t02 CSV` | `tpl_curve_matrix.py` |
| Fig.5 | D8 配对矩阵 MC 分布（未配对/逐级/整线同 m） | `t06 CSV` | `tpl_notched_boxes.py` |
| Fig.6 | 占地–电气 Pareto（真实 vs 本体面积） | `layout_area_report` | `tpl_fit_panel.py` 变体 |
| Table.1 | 门槛定义 D1–D10/C9 | spec | — |
| Table.2 | 六方案判定总表 | REPORT §③a | — |
| Table.3 | 方案演进与件数/占地 | A.5 | — |

## E. 期刊候选（按 skill 原则：先匹配读者群，再看声望/速度）

| 期刊 | 匹配度 | 备注 |
| --- | --- | --- |
| **Measurement（Elsevier）** | ★★★ | 设计+仿真验证友好，仪器读者群对口 |
| **IEEE TIM** | ★★★（若等首板并入实测升为 P2 投此） | 声望最高，纯仿真偏弱 |
| **Review of Scientific Instruments** | ★★ | 设计型论文传统阵地 |
| **Sensors & Actuators A** | ★★ | 偏 MEMS/传感执行器 |
| 仪器仪表学报 / 电子测量与仪器学报 | ★★ | 中文快通道，设计+仿真接受度高 |
| 会议：IEEE I2MTC | ★★ | 快、可先行发布再扩刊（注意不与期刊版重复投稿） |

**建议主攻：Measurement（P1 现在写）；TIM 留给 P2。**

## F. 缺口清单与两阶段策略

**P1 现在可写，缺的只有**：英文正文（方法/结果已在库）、图 D 节 9 项重绘、文献综述段（ΣΔ AAF 设计惯例、CMRR 配对工艺文献——需补 10–20 篇近文）；伦理项：作者/单位/ORCID 定案，仿真值与实测值在文中严格分层（现有 NOT VERIFIED 纪律直接映射为 Limitations）。
**P2 等首板**：噪声底、线性度（标准电阻箱）、温度实验、恒流建立、SD 连续写、USB 供电干扰；投稿 TIM/Measurement。
**P3 等试件**：R/R₀–位移标定、分级阈值（客户输入）。

## H. 文献侦察（2026-10-25 联网检索，六条轴）

| 轴 | 现状 | 对本文的意义 |
| --- | --- | --- |
| H1 ΣΔ 前端 AAF 设计 | **应用笔记/论坛层**：TI E2E FAQ（fMOD 附近抑制、建立 vs 衰减）、ADI Analog Dialogue 驱动指南、Microchip AN699、StackExchange/EDABoard；学术侧仅 Rogillio 2007（OSTI 技术报告）。主流共识"单极 RC 通常够用" | **与本文定量结论直接冲突**（单极在平坦度+CMRR+面积同时约束下不可达）→ gap 成立，且有一句好打的靶子 |
| H2 差分 RC 失配→CMRR 退化 | 经验法则层："共模转差模 ≈ 相对失配量"（EEVblog/StackExchange/TI E2E THP210 帖）+ 一篇老 IEEE 基础文（Basics of Analog Differential Filters）+ ADI 差分滤波器文 | **多级梯形配对机制（R1·C2 交叉项、整线同 m 不变量）无人系统分析** → SQ2 是真空区 |
| H3 CT-ΣΔ 内在抗混叠 | **真学术热点**：Breems 2023 IEEE 综述、级联 CT 调制器隐式抗混叠论文、ADI CTSD 系列、多项专利 | 属**芯片架构层**解法；本文面对的是 COTS 离散开关电容 ADC 的板级问题 → 最佳相关工作锚点 + Discussion 出口（"换 CT-ΣΔ 芯片"作为出路之一引用） |
| H4 多目标滤波器选型方法学 | 学术侧多目标滤波器选型在**光谱成像**（Styles 2008 Applied Optics、MDPI Sensors 2018 MLI 法）；AAF 只有 TI SBOA114/ADI/Microchip 的配方式 app note | **AAF 域无系统化多目标框架** → P1 方法论新颖性成立 |
| H5 输入 kickback/建立 | TI sprpeo2（SAR/ΣΔ 驱动）、ADI CTSD 教程（电荷注入机理）、kickback 专利、JSSC 芯片级 Switched-RC | 系统级"Ron 不确定扫值 + 半周期回稳双判据"处理无人做 → SQ5 支点 |
| H6 CNT-SHM 测量硬件 | 应用文献丰富（Sánchez-Romate 2021、MDPI Electronics 2018、Augustin 博士论文 2018、Paleari 2021）但测量环节**全部商品化**（万用表/DAQ/静电计）；通用无线感知平台（Nedelcu 2022、Khalifeh 2022 综述）无前端方法学 | P2 定位成立：专用仪器的 ΣΔ 前端严谨设计是该应用域空白 |

### 由现状提炼的科学问题（写 Intro/讨论用）

- **SQ1（可达性极限）**：通带平坦度约束下，面向离散开关电容 ΣΔ 的 N 阶无源 RC 抗混叠网络，衰减上界的解析形式是什么？（本文已给 N=1,2 的实测印证：两阶理想 ~76 dB < 80 dB @ 4.096M/fc≈1.8 dec）
- **SQ2（配对不变量）**：多级差分 RC 梯形的共模抑制由什么配对不变量决定？（发现：级间独立配对不保持 R1·C2 交叉乘积 → 逐级配 51 dB vs 整线同 m 90.5 dB）
  **2026-10-26 校准**：单级失配公式已有（TI SBAA230 app note），差分网络共模响应已有定性分析（Hornero Ocaña 2021, AEU）——SQ2 的新颖性收窄为多级配对不变量 + Kelvin 结构地板 + 可达性边界，写作时 SBAA230/Hornero 为最近前作正面引用；go/no-go = 精读此二者及其引文链。
- **SQ3（结构地板）**：双通道比值系统中，负端 Kelvin 无源直连接道的 CMRR 是否存在与配对无关的拓扑上界？（实测 ~56 dB）
- **SQ4（比较度量学）**：衰减/平坦/CMRR/噪声/建立/kickback/真实 PCB 占地互相冲突时，候选滤波器如何被公平裁决？（门槛框架 + 三层验证 + EDA 实画占地 Pareto）
- **SQ5（残余风险定界）**：模拟段不达标而依赖 sinc³ 数字滤波时，fMOD/MCLK 邻域折叠风险如何定界？（16.384M 族瞬态为交流预测 1.65–8.5× 的有界评估方法）

### 竞争与风险

未发现与本文组合重合的工作。风险两处：① 检索为广域 web 扫描，**写作前仍需 Google Scholar/IEEE Xplore 定向深扫**（沿 Rogillio 2007 与 Breems 2023 的引文链向前向后），排除细分期刊遗漏；② TI/ADI app note 覆盖部分子结论，写作时按"工程配方 vs 系统验证"定位引用，不贬低。

## G. 下一步（howtoSCI 流程）

0. **Scholar 定向深扫**（H 节风险①）：沿 Rogillio 2007 / Breems 2023 / Sánchez-Romate 2021 引文链扫 IEEE Xplore + Google Scholar，确认无撞车后再动笔。
1. 定期刊（Measurement？）与作者名单 → 2. 英文 Methods 起草（按 `drafting-contract.md` 逐段过 `lint_contract.py` 门禁 + 三专家面板 L/G/F）→ 3. Results 段 → 4. 图按 D 节出（DRAW 轨道门禁）→ 5. Intro/Discussion/Abstract/Title 收尾 → 6. 投稿材料。Methods 最易先写：素材=A.6 直接翻译扩写。
