chenxi-z/de-drms/hardware/sim/Zcode_LTspice_一阶RC四方案复核任务书.md

# Zcode 任务书：ADS131A02 一阶抗混叠 RC 参数替代方案的 LTspice 复核

> **交付对象**：Zcode（能够操作本机文件、终端与 LTspice 的编码 Agent）  
> **任务类型**：真实执行仿真、提取结果、分析并推荐参数；**不是**让 Agent 仅编写仿真计划或凭公式口头判断。  
> **优先级**：面积受限，`47 nF C0G` 只能取得 `1210`；接受 `0805`，优先兼顾性能和面积；`820 pF C0G` 可用 `0603`。  
> **关键纪律**：真实跑 LTspice；区分已仿真、理论估算、未验证；不得伪造波形、性能或实验结果。

---

## 0. 你的任务与成功标准

你是 **Zcode**，可操作装有 **LTspice** 的电脑。请在当前工程目录中查找既有信号链模型、网表、原始仿真记录和器件模型，**复用真实 OPA388 宏模型以及现有完整信号链**，对下列四个一阶 RC 方案进行公平的、可复现的完整复核。若缺少模型/数据，标注缺失并完成可执行的其余部分，不要自行捏造。

请做到：
1. 找到现有 LTspice 可运行项目和真实 TI OPA388 模型，梳理实际 ADC 接线。
2. 构建四个**仅改变 RC 参数，其余条件完全相同**的变体。
3. 先做理想线性 RC/理想源交叉检查，再在**真实 OPA388 + 已有恒流源/前端 + ADC 等效负载**下复测。
4. 逐项跑 AC、共模转换、瞬态、稳定性、噪声、容差角、蒙特卡洛、双通道幅相匹配、ADC 采样 kickback 以及 MHz 注入/潜在混叠风险验证。
5. 导出网表、批处理命令/脚本、数据 CSV、关键曲线、报告；**保留未通过项**，按实际结果推荐或不推荐。
6. **不要未经确认直接修改生产原理图/BOM**。在单独工作目录生成试验版本。

## 1. 必须先阅读的工程材料

按以下优先级查找并阅读；若路径不同，全文搜索文件名/关键词：

- `docs/design/2026-10-23-signal-chain-variants.md` —— 最新方案对比，FO1 原始 LTspice 结果与未测项。
- `docs/design/2026-10-10-universal-signal-chain.md` —— 主文档；硬件实现以**附录 E** 为权威。
- `docs/design/spec/2026-10-18-aa-driver-design.md` —— D1–D10 评判定义，M1–M7，V1–V9 测试思路。
- `docs/design/diagram/抗混叠滤波电路_一阶.svg` —— 一阶接法（若有其生成器/网表，也读取）。
- `docs/design/diagram/模拟前端与自校准.svg` —— 当前完整前端连接。
- `hardware/sim/signalchain/` —— 全链仿真工程、2026-10-22 结果和现成模型。
- `hardware/sim/signalchain/aaf_first_order/` —— 2026-10-23 一阶方案原始仿真。
- `hardware/sim/aaf/` —— 先前 AAF 测试引擎、元件模型、核实记录。
- `hardware/sim/aaf/r5_datasheet_facts.md`（若存在）—— ADC/OPA388 的手册核对值。

**优先采用本机现存真实电路和 TI 模型，不要重新画一个简化电路后冒充“整链复测”。**
若不同文档相互冲突：记录冲突；以附录 E 为硬件连接的默认权威，但 2026-10-23 文件对**最新候选参数**更晚，用户此次明确允许更改一阶参数。不得悄悄采用旧三级/四级方案。

### 特别核对 ADC 实际连接

ADS131A02 为**2 路同步差分**采样：

- `AIN0P`：测量 T 节点，经 OPA388；
- `AIN0N`：测量 M 节点，经 OPA388；
- `AIN1P`：测量 B / Rsense 顶端，经 OPA388；
- `AIN1N`：Rsense 底端 E / Kelvin 地，**不经过第四颗 OPA388**。

因此共有 **3 颗 OPA388** 而不是 4 颗。`AIN1N` 需要保留真实的接地回路/源阻抗及 RC 接法；请勿把四条线全部改成理想对称运放输出。完整通道归一化以及 `Vsample/VRsense` 测量必须按实际接线。

## 2. 四组待测方案：必须全部跑完

保持同一个一阶差分结构：

```text
前端驱动 P ─ R_P ─●───────── ADC AINxP
                  │
                 C_GP
                  │
                 AGND

                    C_D
           AINxP ──||── AINxN

前端驱动 N ─ R_N ─●───────── ADC AINxN
                  │
                 C_GN
                  │
                 AGND
```

为避免 ASCII 图歧义：**每条输入线各串一颗 R、各有一颗对地 C_G；C_D 仅跨接 ADC 的 AINxP 与 AINxN，位置在串联电阻之后。** 每个差分通道共 2 R + 2 C_G + 1 C_D = 5 件；两个通道共 10 件。所有器件值对两个差分通道一致，仅角差/容差测试时偏移。

| ID | 方案 | 每线 R | 每线对地 C_G | 每差分通道 C_D | 面积假设 | 说明 |
|---|---|---:|---:|---:|---|---|
| `FO1_BASE` | 原始基线 | 47 Ω | 47 nF | 820 pF | C_G 为 1210；C_D 为 0603 | 作为回归校验，不可跳过 |
| `FO1_A` | **首选待证** | **100 Ω** | **22 nF** | **820 pF** | C_G 暂按 0805；C_D 为 0603 | 差模/共模时间常数都接近原方案 |
| `FO1_B` | 0603 保留 Cd | **200 Ω** | **10 nF** | **820 pF** | C_G、C_D 都可考虑 0603 | 需格外检查 ADC 负载、kickback、失真 |
| `FO1_C` | 0603 改差分 C | **100 Ω** | **10 nF** | **6.8 nF** | 两类 C 均考虑 0603 | 差模接近，但共模截止频率显著变高 |

**器件库存/封装都是待核实的采购假设**，不能以此表代替 BOM 验证。尤其检查 22 nF/0805、10 nF/0603、6.8 nF/0603 的实际 C0G/NP0 料号、耐压、SRF/阻抗曲线、容差、焊盘面积。若 22 nF 0603 C0G 真实可得，可以额外增加 0603 子变体，**但不可替代上述四组必测**。

### 理想 RC 自检基准（不是 LTspice 验收真值）

使用下式，差模与共模**分别**检查：

\[
C_{\mathrm{DM}} = C_G+2C_D,\qquad
f_{c,\mathrm{DM}}=\frac{1}{2\pi R(C_G+2C_D)},\qquad
f_{c,\mathrm{CM}}=\frac{1}{2\pi RC_G}
\]

| ID | 理想差模 fc | 理想共模 fc | 理想差模衰减 @16 kHz（约） |
|---|---:|---:|---:|
| FO1_BASE | 69.62 kHz | 72.05 kHz | −0.224 dB |
| FO1_A | 67.32 kHz | 72.34 kHz | −0.239 dB |
| FO1_B | 68.37 kHz | 79.58 kHz | −0.232 dB |
| FO1_C | 67.44 kHz | 159.15 kHz | −0.238 dB |

这些数基于理想对称 RC 且忽略 ADC 输入负载、运放闭环输出阻抗及 PCB 寄生。若实测偏离较大，**首先检查接线、单位、模型、激励归一化与测点**，不能为了对齐数值修改仿真数据。

## 3. 模型、激励和计算口径

### 3.1 主仿真模型

- MCU/采样链工作目标：`fCLKIN = 16.384 MHz`，ADC `fMOD = 4.096 MHz`，输出 `128 kSPS`，`OSR = 32`。
- ADC：**ADS131A02**（不要与 ADS131M02/M04 混淆）。
- ADS131A02 参考：内部基准约 `2.442 V`；手册中 ADC 输入采样电容 `C_S≈3.5 pF`（差分）、输入等效阻抗 `Zin≈130 kΩ typ`。**均需核对现有设计文档及官方手册的适用条件**。
- 采样开关模型的 `Ron` 未由文档确证：只允许作为**声明过的参数假设**扫值，不得称为手册实测。
- 缓冲器：使用真实 **TI OPA388 SPICE 宏模型**。切忌只用 0 Ω 理想源给出最终结论。
- 真实完整链路包含恒流源、Rsense、OPA388、AIN1N 的 Kelvin 地路径；沿用工程已有拓扑。
- 频率扫描建议：`0.1 Hz ~ 100 MHz`（必要时分段加密），保存 8 kHz、16 kHz、64 kHz、128 kHz、4.096 MHz、16.384 MHz 的精确插值值。
- 工况：常温标称先跑，再运行供电、输入共模、源阻抗、R/C 容差等角点；高源阻抗样品工况须涵盖 600 kΩ（若工程实际模型另有限值，记录来源）。
- R 容差参考 ±1%，C0G 电容容差参考器件真实规格（优先 ±5%，另跑 ±1% 目标/配对方案），不要默认所有电容零误差。

### 3.2 三层结果不得混为一谈

对每种方案分别输出：

**层 L1（理想无源网络）**：确认拓扑/截止频率/幅相。

**层 L2（模拟实际网络）**：OPA388 / 恒流源 / ADC 等效电路，测 ADC 引脚前的模拟信号，完成原 D1–D10 口径。**D4 仅评价模拟段相对 DC 的通带衰减，不纳入 sinc³**，遵守原规格。

**层 L3（系统测量）**：考虑 ADC sinc³ 数字滤波、两测量通道比值 `R = (Vsample/VRsense)*Rsense`、扫频相位与高频可能折叠后的误差。可用离线 Python 按 datasheet 传递函数处理，但必须注明这不是 LTspice 直接包含 ADC 全数字内核的仿真。

对 ADC 的数字滤波，特别检查 **4.096 MHz 附近注入可能在采样阶段折叠回低频**：不能把“sinc³ 在数字域有阻带”当成 fMOD 附近模拟抗混叠已通过的证明。没有可信开关采样/数字滤波模型时，只给出有界风险与测试建议，不宣称“验证了混叠”。

### 3.3 比值和共模指标定义

要求输出以下复数频率响应及幅相：

- `H0(f)`：ADC CH0 差分输出 `V(AIN0P)-V(AIN0N)` 相对 CH0 对应模拟激励的传递函数。
- `H1(f)`：ADC CH1 差分输出 `V(AIN1P)-V(AIN1N)` 相对 CH1 对应模拟激励的传递函数。
- `Hratio(f) = H0(f)/H1(f)`：直接用于 V/I 比值链的相对幅频与相频误差；说明归一化定义，不能简单用不同幅度激励的两个原始电压相除。
- `H_DM(f)`：单个差分通道的差模输入→差模输出，记录幅度/相位。
- `H_CM→DM(f)`：共模输入→差模输出；定义 `CMRR_RC = 20log10(|H_DM/H_CM→DM|)`，必要时另列 CM→DM 抑制比。**不要把输出共模衰减 D2 误写为 CMRR D8**。
- 对真实 CH1 的 AIN1N Kelvin 接地结构，另给出“真实接线”结果，不能依靠假设的全对称 P/N 覆盖这一问题。

## 4. 必跑仿真项目及交付数值

每项均应对 4 组方案运行，除非明确说明物理模型不足并保留未验证标记。

| 测试 | 仿真/分析 | 必须输出 |
|---|---|---|
| T00 环境/回归 | 找到可运行原模型，复跑 `FO1_BASE`；对比 2026-10-23 报告 | LTspice 版本、模型哈希/来源、网表路径、基线差异表 |
| T01 差模 AC | `.ac`，理想源与真实 OPA388 两套 | fc、8k/16k 幅度和相位、D1@4.096M、D3@16.384M、峰值/peaking |
| T02 共模 AC | `.ac`，共模输入 1 V AC，注意偏置/输入范围 | D2@4.096M、CM→DM 泄漏；分别写绝对传递函数和 dB 归一化 |
| T03 通道匹配 | CH0、CH1 同条件与实际模拟源条件 | `H0/H1` 在 DC、1k、8k、16k 的幅度比误差与相位差；含 AIN1N 特殊连接 |
| T04 瞬态建立 | `.tran`，标称 + 高 R + 温度/供电与容差角 | 0.1% / 0.01% 建立时间；阶跃幅度与判稳方法 |
| T05 噪声 | `.noise`，必要时后处理积分 | 带内及宽带噪声；RC 增量；与 OPA388/ADC 噪声区分 |
| T06 RC 容差 | Monte Carlo ≥1000 组 **线性 RC 计算** + ≥30 组完整 LTspice 角点/抽样（能力允许增加） | 每项均值/σ/P1/P99，16k 衰减、Hratio 幅相、CMRR；注明分布 |
| T07 运放稳定性 | 真实 OPA388 反馈环路稳定性 + 闭环峰值 | 相位裕量（说明断环方式、注入点）、全频 peaking、瞬态过冲；真实 AIN1N 不当作运放 |
| T08 ADC kickback | 3.5pF 差分采样开关模型，4.096MHz，双相 50%，`Ron` 扫值 | 稳态时每半周期(约122ns)的回稳误差；不同 R、Cd、ADC输入共模下结果 |
| T09 高频耦合/折叠 | 对 4.096MHz ± {1k,8k,16k}、16.384MHz ±{1k,8k,16k} 做模拟 AC/瞬态注入 | ADC 引脚残余干扰及可折叠风险；**只有具有可信采样模型才声称算出折叠后的输出** |
| T10 频相 / 群延迟 | `.ac` + 展相位 + 数值微分 | 0.1Hz–16kHz 的群延迟变化、CH0/CH1 相位失配；至少报 1k/8k/16k |
| T11 温度与供电角 | 相关器件模型允许的温度/供电扫描 | 低/常/高温、模拟轨角点下 D4/幅相/PM 及异常 |
| T12 BOM / 面积 | 真实厂商料号与 footprint；独立于电路计算 | R、C_G、C_D 的容差、介质、额定电压、封装、SRF(如有)、本体/焊盘面积及可采购性 |

### 必须跑的两类容差模型

**A. 未配对量产**：P/N 两路的电阻/电容独立随机偏差，C_G 取料号实际容差（例如 ±5%）。汇报频率响应与 CMRR 的真实散布。

**B. 匹配/标定后**：以可实施的 P/N 配对精度（例如电容 ±1% 或实测 RC 时间常数配对）重算；说清楚其工艺成本与如何验证。不能因原报告写“一阶免配对”就跳过未配对 CMRR 测试。

## 5. 评分与硬约束

### 5.1 原规格门槛：保留、不擅自放宽

沿用 `2026-10-18-aa-driver-design.md` 中 D1–D10 / C1–C9 原定义，至少列出：

| 旧指标 | 判定依据 |
|---|---|
| D1 差模 @4.096 MHz | 衰减 ≥80 dB；满分目标 120 dB |
| D2 共模 @4.096 MHz | 衰减 ≥60 dB；满分目标 100 dB |
| D3 差模 @16.384 MHz | 衰减 ≥100 dB；满分目标 150 dB |
| D4 模拟段 @16 kHz | 相对 DC 幅度衰减 ≤0.5 dB；满分 ≤0.05 dB |
| D5 0.01% 建立 | ≤900 µs，满分 ≤500 µs |
| D6a 无源噪声增量 | ≤30%，满分 ≤10%；按源文档口径测 |
| D7 @16 kHz 容差引起增益 σ | ≤0.05 dB，满分 ≤0.01 dB |
| D8 CMRR @10Hz–16kHz | ≥80 dB，满分 100 dB；必须注明匹配条件 |
| D9 ADC kickback | fMOD 半周期内回稳到 0.01%；Ron 不确定需扫值 |
| D10 群延迟变化 | ≤5 µs，满分 ≤1 µs |
| C9 运放峰值 | 真实 OPA388 模型下 peaking ≤6 dB |

**注意：原一阶基线报告已经明确 D1–D3 不达标。** 新方案也可能失败；请**如实保留 FAIL**，不能为了选一个方案而更改指标。

### 5.2 本次设计决策的额外视图（与原规格 PASS/FAIL 分开）

因为用户明确存在 PCB 面积约束，须额外给出一个**实际取舍矩阵**，但不得把“面积上更合适”写成“全部原指标通过”。

至少评估：
- 47nF/1210 → 22nF/0805 的实际面积收益；
- 22nF/0805 对比 10nF/0603 的面积收益是否值得增加 R 或 C_D；
- `FO1_A` 相对 BASE 的差模、共模、Hratio、CMRR、kickback、噪声、稳定性差异；
- `FO1_B` 200Ω 的 ADC 输入加载/畸变风险；
- `FO1_C` 共模 fc 明显变高的风险；
- 高 fMOD alias 风险：需提出 PCB 和实物测试措施，不能虚构数字滤波“兜底”。

最终建议可为 `FO1_A` / `FO1_B` / `FO1_C` / `保留基线` / `一阶不满足需求，须重新设计`，但要有完整数据支撑。

## 6. 自动化执行方法（Zcode 操作 LTspice）

1. **探测实际工具环境**：列出操作系统、LTspice 可执行文件和版本、模型库位置、Python 版本、当前 repo 路径。
2. **先执行现成基线**：直接运行工作目录现有 FO1 案网表/原图；记录原始曲线与结果，核验 `D1≈−40.7dB / D2≈−46.4dB / D3≈−62.7dB / D4≈0.230dB / t≈21µs / PM≈98.6°`。偏差明显时先排查测试口径，不得直接写“复现成功”。
3. **创建隔离目录**：如 `hardware/sim/signalchain/fo1_rc_review/`，避免覆盖旧 `.asc/.net/.raw/.log` 和生产图。
4. **克隆基线并参数化**：将每方案电阻、电容做成参数或网表副本；维持所有其余电路、模型、供电、激励、分析设置一致。
5. **批量调用本机 LTspice**：优先使用本机可用的批处理能力，支持 `.net` 时优先直接运行网表（既有计划注明 `.asc` 有时依赖 GUI 解锁）。**先查询本机 LTspice 版本的实际 CLI 支持**，例如支持时可采用 `LTspice.exe -b <netlist>`；`-ascii` 仅在本机版本确认有效时使用。若命令行不可用，Zcode 通过 UI 打开/运行并导出，记录步骤。
6. **结果解析**：`.meas`/`.log` 输出定量值；`.raw` 可通过 LTspice 导出文本/CSV 或经可靠解析程序处理。对复数 AC 结果要正确处理 dB、相位 unwrap、群延迟微分和幅度归一化。
7. **一致性校验**：同一方案抽查 `.raw`、`.log`、CSV 三者数值；独立 RC 理论基准用于发现错误但不能替代 LTspice 结果。
8. **异常处理**：仿真不收敛、模型缺失、数字采样模型不足、宏模型不支持 `.noise` 时必须标记并归因；先把其他项目跑完，再提出补救，而不是宣告全部通过。
9. **禁止误导**：不要自动复制历史三阶/四阶仿真数据冒充一阶；不要把 47Ω+47nF 的结果直接套给其他三组；不要只画图不导出可重复计算的数值。

## 7. 交付物：请全部保存在隔离目录

建议输出：

```text
hardware/sim/signalchain/fo1_rc_review/
├── README.md                 # 环境、复现方法、模型来源与路径
├── models/                   # 可再分发的模型；无法再分发的写明获取步骤
├── netlists/                 # 4方案×各项测试，或参数化可复现源
├── run_all.*                 # 一键批量运行的 .py/.ps1/.bat 等
├── logs/                     # LTspice 原始 .log
├── raw/                      # LTspice 原始 .raw
├── csv/                      # 提取的 AC、瞬态、噪声、容差及比值数据
├── plots/                    # 差模/共模频响、相位、Hratio、kickback、容差图
├── bom_footprint_check.md    # 器件与占地核实（附料号/来源）
├── assumptions.md            # 模型简化、未证实参数、风险清单
└── REPORT.md                 # 最终报告
```

`REPORT.md` 必须包含：
1. **结论摘要**：是否建议采用 `100Ω+22nF+820pF`，与其他方案相比的实测优缺点。
2. **回归表**：原 FO1 数值 vs 本轮 FO1_BASE 复测，所有明显偏差说明。
3. **四案总表**：D1–D10、C9、8k/16k 幅相、共模、Hratio、实际 CMRR、采样回稳、ADC 加载、噪声、PCB 占地、PASS/FAIL/NOT VERIFIED。
4. **方案排序**：原规格是否合格、面积约束下建议、牺牲了哪些指标。
5. **关键问题**：4.096MHz 附近混叠风险、AIN1N Kelvin 接地非对称、16kHz 双通道幅相误差、是否需要匹配/标定。
6. **数据证据**：每个重要结论的日志/CSV/图像/网表链接；显示运行命令或 UI 操作步骤。
7. **遗留/未测**：不隐瞒模型限制，清楚写出 PCB 寄生、真实 ADC THD、射频耦合、实物 EMC、温度实物测试等不能由当前仿真证明的项目。

## 8. 最终给用户的回答格式

先给一张表（四个方案为行），至少包含：

| 方案 | C_G 实际封装 | 差模 fc | 模拟衰减@16k | D1/D2/D3 | D8/比值相位 | PM / peaking | kickback | 占地 | 判断 |
|---|---|---:|---:|---|---|---|---|---|---|

然后按优先级回答：

1. **100 Ω + 22 nF + 820 pF，是否可替代现有 47 Ω + 47 nF + 820 pF？**
2. 如果仍失败，限制来自 D1–D3 的一阶先天不足、CMRR、真实 ADC 输入，还是其他？
3. 若 0805 允许，是否值得为了 0603 改用 B/C？如果不值得，说清楚。
4. PCB 推荐布置（C_D 靠 ADC AIN，P/N 尽量对称，对地电容接完整地平面，不在敏感区下方穿高速线）。
5. 哪些结论必须首板实测才能最终关闭。

**执行要求：**现在开始在本机查找工程并实际操作 LTspice；不需要等待额外确认。若找不到整个工程，至少用可信的真实 OPA388 模型与明确声明的 ADC 负载模型完成可运行的二级复核，并在报告中标为“简化模型”，**不能冒充完整信号链已验证**。
