chenxi-z/de-drms/docs/design/2026-10-10-dual-electrode-dc-resistance-meter-design.md

# 双电极直流电阻测量仪 技术设计文档

版本 V2.2-draft · 2026-10-10 · 状态：**草案，待评审**

> 本文档依据文杰《基于多壁碳纳米管的紫外光/热双固化修复材料的力学及传感性能研究》
> 学位论文（下称"论文"）的实测参数修订。V1.0/V2.0/V2.1 中的部分设想（CR2032 直供、
> 5000× 变化、<5 ms 高速瞬态、固定 10 kΩ 基线）与论文不符，已在附录 B 逐条标注废弃理由。
> 保留的核心设计思想：比例测量、实测电流代入、钳口/电极根部取样。
> 器件型号为方向性建议；精度数值为预算量级，以实测标定为准。

## 1 概述

本文档定义一款双电极直流电阻测量仪的技术方案。仪器用于 **MWCNTs（多壁碳纳米管）导电网络
传感层**的结构健康监测（SHM）：复合材料修复层在加载损伤过程中，导电网络被逐步破坏，
电阻由基线 R₀ 上升。仪器记录该过程的 **ΔR/R₀–时间曲线**，重点分辨两个阶段：

- **阶段 I（0–极限载荷）**：电阻缓慢渐变，变化仅 **0.5%–1.84%**（论文图 5.4、4.4 节）。
  这是损伤预警价值最高的区间，也是测量最难的区间。
- **阶段 II（超过极限载荷）**：电阻**指数级**上升，最大 **ΔR/R₀ = 121.64（≈120×）**（论文摘要）。

测量方法为**双电极两线制直流激励**（与论文一致：传感层两端涂导电银胶 + 粘铜电极），
仪器输出恒定电流，同步采样样品压降 V(t) 与回路电流 I(t)，逐点计算 R(t) = V(t)/I(t)。

## 2 规格指标（依据论文实测）

| 项目 | 指标 | 论文依据 |
| --- | --- | --- |
| 测量对象 | MWCNTs 导电网络传感层总电阻 | 论文 2.3 节 |
| 基线 R₀ | **几 kΩ – 200 kΩ 宽范围**（每次实测） | 几何/浓度不同导致，见 2.1 |
| 阶段 I 分辨 | **0.5% @ R₀**（亚%级，重点指标） | 论文：顶层仅 0.54%/1.84% |
| 阶段 II 动态 | **≥ 120×**（ΔR/R₀ = 121.64），指数增长 | 论文摘要 |
| 激励电流 | 1 µA – 1 mA **自动选档**（按 R₀） | 见 3.2 |
| 采样率 | 10 – 1000 SPS **可设** | 准静态，见 3.4 |
| 测量方式 | 双电极两线制 | 论文 2.3.1 节 |
| 温度补偿 | 内置温度传感，按 −4.24 %/℃（无水）参考 | 论文摘要，**关键** |
| 数据接口 | USB / UART | |
| 电源 | 9 V + 5 V + 3.3 V 三轨 | 由最高 R₀ 反推 |

### 2.1 为什么 R₀ 是宽范围而非固定值

论文试件为细长弧状（跨距 155 mm、宽 15 mm、长宽比 ~10），总电阻 = 方阻 × 长宽比。
浓度图（图 a）显示材料本征电阻 ~1–10（Ω/cm² 或 Ω/sq 量级），经几何放大后：

- 论文典型试件 R₀ ≈ **几 kΩ – 几十 kΩ**；
- 客户爆炸试验元件 R₀ ≈ **200 kΩ**（几何/浓度不同的同体系元件）。

低浓度（0.2 wt%）配方电阻最高且**压阻灵敏度最高**（GF 达 14.76），做传感恰恰选高阻配方，
故 R₀ 偏大是常态。且 0.2 wt% 时个体电阻误差棒 >±10%，**R₀ 一致性差，必须每次实测**。

## 3 关键设计决策与理由

### 3.1 阶段 I（亚%级分辨）是设计的重心，不是阶段 II

阶段 II 的 120× 突变信号巨大，任何方案都能抓到。**真正难的是在几 kΩ–200 kΩ 基线上
稳定分辨 0.5% 的缓慢变化**——这要求低噪声、低温漂、以及最关键的温度补偿（见 3.3）。

### 3.2 激励电流自动选档

R₀ 宽范围（几 kΩ–200 kΩ），单一电流无法兼顾信号大小与功耗/合规电压：

| R₀ 区间 | 激励电流 | 满度信号 | 说明 |
| --- | --- | --- | --- |
| < 10 kΩ | 1 mA | ~10 V 上限按 10 V 轨 | 大电流抬信号 |
| 10 – 100 kΩ | 100 µA | 1 – 10 V | |
| > 100 kΩ | 1 – 10 µA | 0.2 – 5 V | 小电流防超压 |

**选档在静态校准段一次性完成并冻结，测量窗口内不切档**（避免毛刺/建立缺口）。
恒流源绝对精度不构成误差——实测 I 代入计算。

### 3.3 温度补偿是头等大事（论文揭示）

论文实测材料温度系数 **−4.24 %/℃（无水）、−10.67 %/℃（有水）**，
而阶段 I 机械信号仅 0.5%–1.84%。**1℃ 波动即淹没机械信号**。

对策：

- 仪器内置**温度传感器**（贴近被测件），每次测量同步记录温度；
- 上位机按论文温度响应曲线做**温度归一化/补偿**；
- 现场标定：被测材料体系的具体温度系数需用该批试件实测（论文值仅作参考）；
- 温度剧烈波动的现场，数据需标注温度有效性。

### 3.4 采样率按准静态设计

论文用**普通数字万用表 DM3068（低速）**即完成准静态加载监测，论文中**没有任何
µs/ms 级高速瞬态**。因此采样率按准静态设计：**10 – 1000 SPS 可设**，
对应加载速率从极慢到较快。高采样率用于数字平均降噪声，而非捕捉瞬态。

> 注：客户爆炸试验若确有 µs/ms 瞬态需求，属另一应用线，待需求澄清后另行评估，
> 不影响本方案（见第 10 节）。

### 3.5 固定增益 + 宽动态 ADC

窗口内一切模拟设置冻结（不跳档、不换向、不改增益）。基线随 R₀ 变化大，
选档后单档内需覆盖阶段 II 的 120×：选 **24 bit ADC**，在选定的电流档下，
用增益使基线信号落在 ADC 满度的 10–80%，120× 后仍留有余量（顶端开路判定见 5）。

### 3.6 ADC 选型回归 24 bit ΣΔ

准静态 + 高分辨（亚%）+ 需 50/60 Hz 抑制 → **ΣΔ 路线重新成为最优**，
V2.0/V2.1 为捕捉 5 ms 瞬态而选的 SAR 路线**废弃**（该需求论文不支持）。

- **推荐：ADS124S08（24 bit、4 kSPS、5 V、PGA、多通道、50/60 Hz 抑制）**；
- 备选：AD7124-8（24 bit、19.2 kSPS）；低成本：ADS1220（2 kSPS，速率偏紧）。
- 24 bit + PGA + 数字平均，在 10–100 SPS 下噪声可达亚 µV，满足 0.5% @ 几 kΩ 分辨。

## 4 系统架构

```
        ┌─────────────────────────────────────────────┐
        │              9–10 V 模拟轨                    │
        │  ┌──────────┐  I(选档)  ┌────┐  ┌────┐       │
VSET ──▶│ 恒流源环路  │─────────▶│左钳│─▶│样品│       │
        │ OPA192+Q2  │ (1µA–1mA) └────┘  └────┘       │
        │ +Rsense    │              │        │         │
        └──────────┘              │        │         │
                                   │  电极根部取样      │
                                   ▼        ▼         │
        ┌──────────────────────────────────────┐     │
        │  保护(低漏电<10nA) → 增益=1/PGA         │     │
        │  I通道: V(Rsense) ────────────┐        │     │
        │                               ▼        │     │
        │         24bit ΣΔ ADC (ADS124S08)       │     │
        └──────────────────────────────────────┘     │
                                   │ SPI             │
                                   ▼                 │
        ┌──────────────────────────────────────┐     │
        │  MCU：选档控制、采样、数字平均、          │     │
        │       温度采集、USB/UART 上传            │     │
        │  温度传感器(NTC/数字) ──────────┘        │     │
        └──────────────────────────────────────┘     │
                                   │                 │
                                   ▼                 │
                    上位机：ΔR/R₀ 曲线 + 温度补偿 + 拟合 │
```

## 5 测量原理

- **恒流激励**：I = VSET / Rsense，电流档按 R₀ 自动选定。实测 I 代入计算。
- **逐点比值**：R(t) = V(t) / I(t)。恒流源绝对精度与慢漂移被实测 I 消除。
- **静态校准段**（试验前）：正反测得 R₀、失调 V_os、选电流档；测量窗口内冻结。
- **正反平均（可选）**：对阶段 I 的亚%测量，可周期性 ±I 正反平均消热电势；
  对快速阶段 II，固定极性连续采。
- **开路/超量程判定**：逾渗网络完全断裂时 R → ∞，输出开路指示而非简单超量程。
- **温度记录**：每次测量同步记录温度，供上位机补偿。

## 6 硬件设计

### 6.1 电源（需求由最高 R₀ 反推）

| 轨 | 电压 | 用途 |
| --- | --- | --- |
| 模拟高压轨 | 9–10 V | 恒流源激励（200 kΩ × 10 µA = 2 V，1 mA × 10 kΩ = 10 V 上限） |
| ADC 轨 | 5 V | ADC 模拟供电 + 基准 |
| 数字轨 | 3.3 V | MCU、接口 |

> 若需支持 1 mA × 高 R₀，满度信号大，需相应抬高模拟轨；具体上限待 R₀ 范围确认后定。

### 6.2 恒流源（多档）

- 拓扑：运放（**OPA192/OPA197**，36 V、低 Ibias）+ NMOS + 可切换 Rsense。
- 多档 Rsense 对应 1 µA / 10 µA / 100 µA / 1 mA。
- 切换在静态校准段完成，窗口内冻结。
- 运放耐压 ≥ 模拟轨；输入偏置 ≪ 最小电流档（1 µA）。

### 6.3 ADC（ΣΔ 回归）

- **ADS124S08**：24 bit、4 kSPS、5 V、PGA 1–128、多通道、50/60 Hz 抑制。
- 5 V 模拟供电 + 外部基准；SPI 与 3.3 V MCU 间电平转换。

### 6.4 电压取样与保护

- 取样点：**电极根部**（沿用论文导电银胶+铜电极的两端取样）。
- 保护：低漏电 ESD 器件，漏电 **< 1–10 nA**（200 kΩ 源阻下 100 nA = 5% 误差，必须严控）。
- 高阻节点 + 保护环 + 屏蔽，工频拾取靠布局 + ADC 50/60 Hz 抑制。

### 6.5 温度传感

- NTC 或数字温度传感器（如 TMP117），贴近被测件安装，随测量同步采集。

### 6.6 关键器件方向性 BOM

| 位号 | 器件 | 方向性型号 | 说明 |
| --- | --- | --- | --- |
| U1 | 运放 | OPA192/OPA197 | 恒流源 |
| Q2 | NMOS | BSS138 | 调整管 |
| U2 | 电流换档开关 | TMUX61xx | 多档 Rsense 切换 |
| U3 | ADC | **ADS124S08** | ΣΔ 24 bit |
| U4 | MCU | STM32（待定） | USB/UART + 选档控制 |
| U6 | 温度传感 | TMP117 / NTC | 温度补偿 |
| R_sense | 精密电阻 | 多档，0.1%，低温漂 | 电流选档 |

## 7 软件设计

### 7.1 测量状态机

```
休眠 → 静态校准段（实测 R₀、选电流档、测 V_os、记录初始温度）
     → 测量段（固定档/增益，10–1000 SPS 连续采 V/I/T）
     → 上位机：R(t)、ΔR/R₀(t)、温度补偿、阶段 I/II 识别
```

### 7.2 数据处理

- 逐点 R(t) = V(t)/I(t)，扣 V_os。
- 数字平均降噪声（高采样率换取平均增益）。
- **温度补偿**：按实测温度系数对 ΔR/R₀ 归一化，分离机械信号与温度干扰。
- 阶段识别：阶段 I 斜率分析（预警），阶段 II 指数拟合（破坏）。
- 输出：ΔR/R₀–时间曲线、GF（灵敏度系数）、断裂时刻、温度曲线。

## 8 误差预算（量级，待实测标定）

| 误差来源 | 量级 | 处理方式 |
| --- | --- | --- |
| **温度漂移** | **−4 ~ −10 %/℃（最大项）** | **内置温度传感 + 上位机补偿 + 现场标定** |
| 保护器件漏电 | <1–10 nA | 低漏电器件 + 保护环 |
| 钳口接触电阻 | mΩ 级 | 相对 kΩ 基线可忽略 |
| 恒流源稳定性 | 慢漂移 | 实测 I 代入，逐点消除 |
| ADC 噪声 | 亚 µV（平均后） | 满足 0.5% @ 几 kΩ |
| 基准漂移 | — | 比例测量抵消 |
| R₀ 个体离散 | >±10%（低浓度） | 每次实测 R₀，不假定标称值 |

## 9 风险与对策

| 风险 | 影响 | 对策 |
| --- | --- | --- |
| 温度淹没机械信号 | 阶段 I 误判 | 温度补偿 + 现场标定 + 恒温环境 |
| R₀ 范围过宽 | 单档信号不佳 | 多档激励 + 自动选档 |
| 爆炸瞬态需求 | 本方案速率不够 | 另立应用线评估，不影响本方案 |
| 漏电超标 | 高 R₀ 端误差 | 严控保护器件漏电 |
| 24 bit 指标虚高 | 实际有效位不足 | 按选定 ADC 数据表核有效位与噪声 |

## 10 待确认事项

1. **爆炸试验线**：200 kΩ 基线、几 kΩ 变化、µs/ms 瞬态——与论文体系不同，待客户澄清后另立方案。
2. **R₀ 实际上限**：决定最高模拟轨电压与激励档划分。
3. **温度系数标定**：被测材料体系的具体温度响应需用该批试件实测。
4. **采样率需求**：实际加载速率决定 10–1000 SPS 的具体取值。
5. **电源形态**：9–10 V + 5 V + 3.3 V 的供电方式（适配器/USB PD/电池）。
6. **上位机功能**：曲线显示、温度补偿算法、数据导出、GF 计算的范围。

## 附录 A 依据论文的关键参数

| 参数 | 论文值 | 章节 |
| --- | --- | --- |
| 测量方法 | 双电极两线制，导电银胶+铜电极 | 2.3.1 |
| 测量仪器 | 数字万用表 DM3068 + 鳄鱼夹 + 计算机 | 表 2.2 |
| 试件 | 弧状，宽 15 mm，跨距 155 mm | 5.x |
| 传感层厚度 | 0.90 mm | 4.4.1 |
| 最大 ΔR/R₀ | 121.64（≈120×），指数增长 | 摘要 |
| 阶段 I 变化 | 0.54% / 1.84%（顶层） | 图 5.4、4.4 |
| 压阻灵敏度 GF | 最大 14.76（0.2 wt%） | 4.4.1 |
| 温度系数 | −4.24 %/℃（无水）、−10.67 %/℃（有水） | 摘要 |
| 浓度—电阻 | 0.2 wt% 最高、误差棒最大（近逾渗阈值） | 图 4.2、图 a |

## 附录 B 相对 V2.1 的变更与废弃理由

| 项 | V2.1 | V2.2 | 变更理由 |
| --- | --- | --- | --- |
| 动态范围 | 50× | **120×** | 论文摘要 ΔR/R₀=121.64 |
| R₀ | 固定 ~10 kΩ | **几 kΩ–200 kΩ 宽范围** | 论文几何放大 + 客户 200 kΩ |
| 阶段 I | 未强调 | **亚%分辨为重点** | 论文：极限载荷前仅 0.5–1.84% |
| 温度补偿 | 无 | **新增（头等大事）** | 论文：−4~−10 %/℃ ≫ 机械信号 |
| 采样率 | ≥100 kSPS | **10–1000 SPS** | 论文用万用表，无高速瞬态依据 |
| ADC | SAR 18 bit（AD4003） | **ΣΔ 24 bit（ADS124S08）** | 准静态+高分辨+工频抑制 |
| 双速率采集 | 抽取+触发 | **废弃** | 无 5 ms 瞬态需求 |
| 5 ms 高速 | 核心需求 | **废弃** | 论文不支持，属爆炸线（待澄清） |
| 通道 B（×32） | 可选 | **废弃** | 选档后基线信号足够 |
| 激励电流 | 固定 10 µA | **1 µA–1 mA 自动选档** | R₀ 宽范围 |
