chenxi-z/de-drms/hardware/sim/signalchain/fo1_rc_review/assumptions.md

# assumptions.md — 声明假设、未证实参数与风险清单（终版 2026-10-24，T00–T12 全量跑完）

> 原则（任务书 §3.1 / r5_datasheet_facts.md:238）：手册没给的值一律
> 「显式假设 + 明示」，不得伪装成手册实测。下表每条注明来源层级。
> 层级标记：**[LTspice]** 本轮实跑 ｜ **[解析]** 理论估算未仿真 ｜ **[假设]** 声明参数 ｜ **[手册]** 页码级可查。

## A. 声明假设（工程口径，非手册值）

| # | 参数 | 采用值 | 来源 / 层级 | 处置与实测结果 |
| --- | --- | --- | --- | --- |
| A1 | ADC 采样开关 Ron | 手册无规格；扫 **1 / 100 / 1k Ω** | SBAS590E grep 0 命中（r5:158）；spec V8 缺省 1Ω（aa-driver:140,184）；fs_subs.inc fsadc 实际用 swsh 100Ω（models.inc:85） | T08 已扫三档 × vcm 三档（`csv/t08_kickback.csv`）；D9 通道判据对 Ron 不敏感（最坏 ron1000 余量仍 ≥4×） |
| A2 | ADC 引脚电容 C_pin | **5 pF/端** | lad4b FIN 工程口径（aaf_lad4b/README:116），fsadc 沿用 | [假设] 维持；D1/D4 对其不敏感（R≪130k） |
| A3 | Z_IN 差分输入阻抗 | **130 kΩ**（typ） | SBAS590E p10 EC 表（r5:113）；Eq.5 复算 139.5k 差 +7.3%（r5:114-115） | 主口径 130k；敏感性档未加（影响 CH1 DC 分压 −0.18~−0.75% 量级，t08 dm_ss_v） |
| A4 | DUT 线缆寄生 | CTOT 200p/端、CTT 30p 线间（集总） | fs_fullchain 保守假设（fs_subs.inc:18-27） | [假设] 维持（整链网表用；台架口径未含） |
| A5 | Cff 稳定电容 100p（F 节点对地） | 挂载 | fs_fullchain 判别 D 定档（147kHz 自持振荡消振） | [假设] 回填 E.3.2/BOM 前须设计 Owner 确认 |
| A6 | 理想 fc 自检基准（任务书 §2 末表） | C_DM=C_G+2C_D 等公式 | 任务书给定；忽略 ADC 负载/运放闭环输出阻抗/PCB 寄生 | ✅ 已闭环：L1 重算与表格一致（0.0066%）；2 节点 MNA 第二路径自洽（`csv/l1_ideal_rc.csv`） |
| A7 | **600 kΩ 高源阻抗角** | 跟随器输入侧串联 600 kΩ（r5 V9f 家法，TI 宏自带输入电容 → τ≈6 µs 主导） | [假设]（tran 族声明） | ⚠️ 8 µA×600 kΩ=4.8 V 超 3.3 V 合规栈——该 DUT 值**系统里不可运行**，台架极限角；结果见 t04 600k 行（ts01 ≤30.5 µs 仍 PASS） |
| A8 | **ADC 采样电容复位电位 vcm** | 扫 **0 / 0.6 / 2.0 V** | 手册无值（与 A1 同查无果） | T08 已扫（`csv/t08_kickback.csv`）；vcm2 角 kick 最大（C 案 243.9 µV），通道判据仍 PASS |
| A9 | **R 温漂** | ±100 ppm/℃（厚膜档） | [假设]——AAF 电阻料号未定稿无法取实测 TCR（薄膜档 ±50 ppm/℃ 已列 BOM 备选） | T11 代入（−20/85 ℃ → D4 ∓1.1%/+1.5%）；C0G ±30 ppm/℃ 为 spec 值（spec:93） |
| A10 | **MC 分布形态** | 均匀独立（uniform），R±1%、C±5%/±1% 三档；模式 B = R·C 乘积异向配对 m~U±1% | 任务书 §3.1/§4 两类容差模型 | `csv/t06_mc_all.csv`（n=1000×12 组合）+ LTspice 31 确定性角点（A5）/8 角点（A1）；分布形态声明于 dist 列 |
| A11 | **sinc³ 数字滤波器** | H(z)=[(1−z⁻³²)/(32(1−z⁻¹))]³，fMOD=4.096M、OSR=32 全局同设 | SBAS590E 手册闭式（r5_datasheet_facts §数字滤波器）；[解析] | 四锚点自证过（f3dB 33487.6 Hz / 8k −0.1675 / 16k −0.6726 / DC 群延迟 11.3525 µs）；**非 LTspice 数字内核仿真** |
| A12 | **孔径衰减 / 折叠增益** | 孔径时间无手册规格 → 不建模；折叠增益按最坏 0 dB（理想冲激采样） | [假设]（最坏界） | 真实折回幅度只可能低于本界；上板注入实测关闭 |
| A13 | **共模 AC 台架直流工作点 2 V** | gen_fo 母本口径 | [假设] | 整链真实共模（CH0≈2.4V / CH1≈0.6V）偏置依赖未专项扫描（LTI 假设下预期极小） |
| A14 | **D6a 判罚口径** | r4 冻结线性口径 (n1−n3)/n3（r5_results_r4_B.json D6_detail 同式、lad4b 定案同法） | 工程 冻结口径 | 正交口径 √(n1²−n3²)/n3 并列列出（`csv/t05_noise.csv` note_3）：fo1_b CH1=36.78% 超 30%——判罚维持线性，分歧交裁决方 |
| A15 | **D9 双判据** | ownss（字面：残余≤0.01%·本脚 v_ss）+ chan（物理主判据：≤0.01%·通道差分稳态） | 任务书字面 + Kelvin na1 脚 v_ss≈1mV 近地致 ownss 退化的实测发现 | 双判据并列保留（`csv/t08_kickback.csv` pass01_ownss / pass01_ch 列）；主判罚 = chan |

## B. 层级标记约定（三层不得混谈，任务书 §3.2）

- **L1 理想无源网络**：理想源 + 纯 RC——`csv/l1_ideal_rc.csv`（自检基准，非验收真值）；
- **L2 模拟实际网络**：TI OPAx388 宏 + 恒流源基座（fs_subs）+ fsadc 等效负载，
  D1–D10/C9 原口径（**D4 仅模拟段相对 DC，不含 sinc³**，spec §5.3 口径边界）；
- **L3 系统测量**：sinc³ 数字滤波 + Vsample/VRsense 比值——离线 Python（`l3_hratio_alias.py`），
  **非 LTspice 直接仿真**；4.096 MHz 折叠只给有界风险，不宣称「验证了混叠」。

## C. 勘察阶段缺口的闭环状态（原 C1–C5，2026-10-24 终版）

1. ~~fo_results.json 空字段 / T00 须重跑~~ ✅ **已闭环**：T00 六项锚定复现（`csv/t00_regression.csv`）；
   根因三项（.meas dB 元组格式 / ts01 物理不可达 / ltspice-sim 复数 raw 崩溃）实测确认并记录；
2. ~~fs_fullchain 场景网表缺失~~ ⚠️ **部分闭环**：`netlists/full_fo1_{base,a,b,c}_static.net`
   已生成过静态 lint，**整链场景 .tran 未运行**（本轮 L2 为通道台架口径）——遗留项，见 REPORT §7.1；
3. ~~AIN1N Kelvin 接线保真~~ ✅ **已闭环**：kelvin 口径贯穿 T01–T10（RKN/CGN 直连 E，无第四运放），
   结构性代价已量化（D1 −2.3 dB、CMRR_RC 56 dB、CM→DM 1279–1327 ppm/V@16k）；
4. ~~.noise 支持性未验证~~ ✅ **已闭环**：TI 宏 Final 1.4 实测可用（40 网表 + 逐器件归属
   attr_xcheck=0.0%），T05 全跑；
5. ~~PCB 寄生/真实 ADC THD/EMC/温度实物~~ ❌ **仿真不可证明**——REPORT §7.10–15，首板实测关闭。

## D. 器件库存/封装假设（T12 已独立核实，2026-10-24 快照）

- 22nF/0805 C0G：可采购（LCSC 现货仅 ±1% 档 521 只 = GCM21B5C1H223FA16L；±5% 商用档在
  DigiKey）——样机够用，量产 ±5% 需锁渠道；
- 10nF / 6.8nF / 820pF 三档 0603 C0G：村田 GRM1885C1H 系大量现货（207,500 / 85,750 / 4,600 只）；
- 47nF/1210 C0G：**LCSC 今日 0 库存**（现货仅 DigiKey/Mouser/Arrow）；
- **冲突记录**：任务书「47nF C0G 只能取得 1210」与事实不符——47nF/1206（村田
  GRM31M5C1H473JA01L，C21812）现货 51,375 只，生产 BOM 自用 68nF/1206；选档归用户；
- 全部库存为快照，下单前复核（E.10 #6 归用户）。详见 `bom_footprint_check.md`。

## E. 已实测排除的「伪 NOT VERIFIED」（避免重复排查）

- 宏模型 .noise 支持性：已实测可用（C.4）；
- ltspice-sim AC 复数 raw rc=1：环境缺陷非仿真失败（logs 完整、以 LTspice 产物判定）；
- OPAx388 宏 .temp 25–27 ℃ 窗口限制：宏模型缺陷（DC 环路增益塌 1000×，与方案无关），
  PM 温度趋势不报告——不是电路问题，勿在电路侧排查。
