chenxi-z/de-drms/hardware/sim/aaf/README.md

# 抗混叠滤波 LTspice 验证（2026-10-18，两轮迭代）

验证对象：E.4 ADS131A02 前端抗混叠滤波器。LTspice 24.1（`LTspice.exe -b -ascii` 批处理，Windows 路径），
网表 `.net` 纯文本，结果 `.log`（.meas）+ `.raw`（ASCII，`parse_and_plot.py` 解析出图与评分）。

## 结论（三轮迭代，2026-10-18 最终）

**定稿 FIN1**（第四轮升级，覆盖 W9）：每通道 `330 Ω-(47 nF + 47 nF 差分)-2.7 kΩ-(6.8 nF + 5.6 nF 差分)`，引脚侧 C 靠 ADC；
回退位 W9（少 20 dB 裕量但建立快 95 µs）、V0（最简最快）。

| 指标 | W9 实测 | 目标线 | 裕量 |
| --- | --- | --- | --- |
| DM @ fMOD 4.096 MHz | **−102.0 dB** | 80 dB | +22 dB |
| CM @ fMOD | **−85.1 dB** | 60 dB | +25 dB |
| DM @ MCLK 16.384 MHz | **−126.1 dB** | 120 dB | +6 dB |
| 建立 0.1% / 0.01% | **494 / 649 µs** | ≤900 µs（真实预算） | 1.4× |
| 部件/通道 | 10 件无源 | — | 无感无运放，四线同构可镜像 E 线 |

W9 = V6r **只改一个值**（引脚侧 Ccm 10n→15n）——共模从 −48 直接跳到 −85 dB（新极点落在 220 Ω
低阻节点，几乎不花建立时间），差模再 +2 dB，建立 510→649 µs 仍在预算内。
这是本设计空间的可达最优：分数构成 58/60 中唯一失分项"部件"（8/10）是两级结构的固有代价，
砍部件必回 V0 家族（衰减项丢 15+ 分），数学上无解。

评分制说明：v1 保守制（建立 300 µs 满分、衰减封顶）下 V0 仍居首——若量产追求最简/最快，V0 回退位保留。

## 设计依据：香农落点

模拟域采样在 fMOD = 4.096 MHz（16.384 MHz ÷ 4），128 kSPS 只是数字抽取（OSR=32）输出——
抽取级抗混叠由数字滤波器阻带承担，模拟 RC 只需覆盖 k·fMOD ± fB 折叠区与开关噪声。
教科书式"64 kHz 前深阻带"对一阶 RC 既不必要也做不到（fc 须压到 640 Hz，τ=250 µs，冲击跟踪报废）。

## 最终实测（六强）

| 变体 | 拓扑（每通道） | DM@fMOD | CM@fMOD | DM@MCLK | 建立 0.1%/0.01% | v1 分 | v2 分 |
| --- | --- | --- | --- | --- | --- | --- | --- |
| **V0** | 1k-(10n‖10nd) | −57.8 | −48.2 | −69.8 | 235 / 298 µs | **59.6** | 51.0 |
| V1 | 容量 ×2.2 | −64.6 | −55.1 | −76.7 | 495 / 654 µs | 54.6 | 53.7 |
| V3 | 备用运放隔离两级 | −115.6 | −96.4 | −139.6 | 308 / 373 µs | 49.1 | 51.0（同构 ✗） |
| V5r | 三级交错 1k(2.2n)1k(6.8n)1k(10n) | −112.3 | −93.1 | −137.9 | **>1.59 ms 慢尾** | 44.6 | 44.6 |
| **V6r** | 两级交错 1k(8.2n+8.2nd)220Ω(10n+10nd) | **−100.4** | −48.4 | **−131.6** | 399 / 510 µs | 55.4 | **56.9** |
| V6r2 | V6r 中段 15n+5.6nd / 330Ω | −104.0 | −48.9 | −135.6 | 385 / 421 µs | 55.7 | 56.3 |

采样 kick 纹波（Q=3 pC @ fMOD）：V0 实测 89 µVpp（0.007% FS）；V6r 储罐更大，只会更好。
网络噪声：V0 积分 0.52 µV rms（ADC 底噪 ~412 µV @128 kSPS 的 1/800）；V6r 的 R 串阻同量级。

## 两轮迭代与教训

**第一轮（V0–V4，5 变体）**：V1（容量 ×2.2）建立掉到 654 µs；V4（仅差分加大）负收益；
**π 型无源两级（V2/V2b）证伪**——AC +25 dB 诱人，但无隔离的两级 RC 电荷再分配产生慢极点（480 µs 仍差 0.8%）。

**第二轮（V5–V9 + 精修，响应"切比雪夫/巴特沃斯"需求）**：
- **复数极点在纯 RC 里物理不存在**（无源 RC 极点全在负实轴）——巴特沃斯/切比雪夫只有三条路：
  LC、有源、或 RC 交错实极点近似。
- **LC（V8/V8r/V9，巴特沃斯/切比雪夫 LC）两次失败**：直流耦合精密前端不能终接（双端接 1 kΩ 会把
  DC 增益砍半），不终接则 CM 模 Q≈20 欠阻尼振铃；V8r 改旁路臂阻尼后 droop@1 kHz 恶化到 −8 dB。
  加上磁件容差/磁拾取/BOM ×4——**LC 在本仪器判死**。
- **有源（Sallen-Key/MFB）**：全项目仅 1 颗备用运放，且 ch1 的 E 线（地参考）无法镜像 → 破坏四线
  同构（V3 的 1 kHz ch0/ch1 失配 ~1.7%），弃用。
- **RC 交错实极点（V5r/V6r/V6r2）**：唯一的胜出路线。三级（V5r）慢尾仍超窗；**两级交错（V6r）
  恰好是"RC 世界里的巴特沃斯替身"**——实极点最平坦配置，通带内影响被比值吸收。
- **twin-T 陷波（V7）**：被后级负载化（fMOD 处仅 +5.3 dB）且元件容差敏感（±1% → 频点漂移），
  慢尾拖累建立，弃用。

**收敛判据**：第三轮打磨（V6r2）未超越 V6r（部件扣分 > CM 微增益）→ 收敛。

**第三轮（W1–W11，响应"提阶/多方案"）——低阻节点提阶法**：
弱项分析锁定 V6r 的短板是共模（−48 dB），而提阶的正确姿势不是加级数（V5 三级已证慢尾死路），
而是**把新极点放在低阻抗节点**——220 Ω 后面加电容，τ = R_node×C 几乎不花建立时间：

| 变体 | 结构 | DM@fMOD | CM@fMOD | DM@MCLK | 建立0.01% | 分 |
| --- | --- | --- | --- | --- | --- | --- |
| W1 | V6r 钉端 Ccm 10→22n | −103.6 | **−88.5** | −127.6 | 722 µs | 58.0* |
| W2 | 钉端 Ccm→47n | −107.7 | −95.0 | −131.7 | 1019 µs ✗ | 48 |
| W3 | 真三阶几何递减 R（1k/470/100） | **−137.5** | **−118.5** | −173.6 | 864 µs | 56.0 |
| W4 | 真四阶（1k/470/100/47） | −155.6 | −127.1 | −203.7 | 1044 µs ✗ | 44 |
| W7 | W1 一级差分 8.2→4.7n | −100.7 | −88.5 | −124.7 | 658 µs | 58.0* |
| **W9** | **V6r 钉端 Ccm 10→15n** | **−102.0** | **−85.1** | **−126.1** | **649 µs** | **58.0** ✅ |
| W10 | W1 二级 R 220→150 | −100.3 | −85.1 | −124.3 | 701 µs | 57.6 |
| W11 | W9 减去一级差分 8.2n | −92.5 | −85.1 | −116.5 | 492 µs | 57.7 |

（*W1/W7 与 W9 同分 58.0；W9 以两项占优胜出：DM −102>−100.7、建立 649<658/722。）

结论：**阶数确实能提性能，但只在低阻节点堆**；真三阶（W3）虽把衰减推到 −137 dB，
建立贴预算上限（864 µs）且 14 件/通道——分数反而不及 W9。四阶（W4）越界出局。
勘误：第二轮 V6r 与 V6r2 的部件分统计有误（两者同为 10 件/通道，此前误计 V6r 7 件），
本轮统一口径后 V6r=56.1、V6r2=56.2，排名不受影响但分差归零。

## 三个反哺设计文档的发现

1. **Zin 直流分压 −1.5%**：ADS131A02 差分输入阻抗 130 kΩ 与串阻构成分压（实测 g_100 吻合）。
   E.4"串阻压降可忽略"指采样瞬态压降；直流项由 k 校准 + ch0/ch1 同构比值双重吸收。建议 E.4 补一句。
2. **建立与使能并行而非串行**：RC 建立与恒流源使能（0.871–0.887 ms）由同一 CURR_DIS 释放触发，
   预算 = max(0.887 ms, RC 建立) ≤ 1 ms ✓。V6r 的 510 µs 在此口径下成立。
3. **kick 纹波是 fMOD 周期性纹波**，由调制器开关电容采样产生、被 sinc 抽取滤波天然平均，不是误差项；
   ≥10 nF 储罐使其 <0.01% FS。

## W9 全指标验证套件（verify_w9.py，2026-10-18）

标称 AC / 噪声 / 阶跃（最坏 + 实际换路幅度）/ 10 ms 斜坡 / kick / 蒙特卡洛（R ±1%、C ±5%，60 AC + 30 tran）：

| 指标 | 实测 | 备注 |
| --- | --- | --- |
| DC 增益 | −0.162 dB | Zin 130 kΩ 分压，k + 比值吸收 |
| DM fc(−3 dB) | 2.52 kHz | 两交错极点（~1.9k/12k）复合 |
| droop | 100 Hz −0.007 dB；1 kHz −0.48 dB（相对）；10 kHz −12.2 dB | ch0/ch1 同构 → 比值抵消 |
| DM@fMOD / @MCLK | −101.8 / −125.9 dB | |
| CM@fMOD / @MCLK | −84.9 / −109.0 dB | |
| DM−CM 差 @fMOD | 16.9 dB | 共模是较弱侧，但绝对值已达标 |
| 群延迟 @1 kHz | 47.4 µs | ch0/ch1 同构 → 比值中抵消 |
| 噪声积分 10 Hz–1 MHz | 0.438 µV rms（4.3 nV/√Hz @1 kHz） | ADC 底噪（~412 µV @128 kSPS）的 1/900 |
| 阶跃 2.4 Vpp（最坏） | 0.1% 484 µs / 0.01% 639 µs，误差单调降无过冲，底 17.9 µV | |
| 阶跃 0.71 V（真实换路幅度） | 0.1% 450 µs / 0.01% 601 µs | 模式切换的真实等待 |
| 10 ms 斜坡跟踪 | 单通道最大 15.6 mV | ch0/ch1 同构 → R(t)=比值逐点精确，不影响 R |
| kick @引脚 | 单次物理 kick = Q/C_local ≈ 140 µV @4.096 MHz | 注入模型含直流堆积伪影（PP 3.9 mV 不可直接引用）；周期性纹波被 sinc 平均，非误差项 |
| **MC DM@fMOD**（60 样本） | min −102.4 / max −101.2 dB | ±5% C 全部吃下 |
| **MC CM@fMOD** | min −85.9 / max −84.3 dB | |
| **MC DM@MCLK** | min −126.5 / max −125.3 dB | |
| **MC 建立 0.01%**（30 样本） | min 621 / 均值 641 / max 663 µs | worst 663 < 900 µs 预算 ✓ |

**裁决**：全部指标过线且蒙特卡洛分布极紧（容差不侵蚀任何裕量）——W9 从"仿真最优"升级为"容差验证最优"。
唯二注意项：① DM@MCLK 裕量 +6 dB 依赖钉端 15 nF 的低感接地，布局纪律项；② kick 的精确量化需要
ADC 采样开关行为模型，一阶验证已给出上限。

## 第四轮（goal 复测）：理论引擎 + 参数/结构联合优化 → 新冠军 FIN1

方法升级：**解析理论引擎**（对称网络模态分解——CM 差分电容开路、DM 差分电容 ×2 + Rin/2 虚地，
任意阶梯网络的传函/建立时间全部解析可算，极点全实）与 LTspice 互证后，用理论引擎做
Nelder-Mead 连续寻优（目标 = 最大最小裕量 min(DM/80, CM/60, MCLK/120, 900µs/建立_worst)，
硬约束 = 容差最坏角建立 ≤900 µs、C0G ≤47 nF、总串阻 ≤5 kΩ、部件 ≤14、四线同构），
连续最优解 snap 到 E24/E12 实际值，再回 LTspice 终验 + MC30。

**过程中修掉的引擎 bug**（理论 vs 仿真差 46 dB 的根源）：阶梯节点数少一层（末级 R 被接成对地分流）、
H() 返回了中间节点、以及一轮**建立时间单位错误**（秒 vs µs，导致约束失效、优化器退化成纯衰减最大化）。

**新冠军 FIN1**（每通道）：`330 Ω-(47 nF + 47 nF 差分)-2.7 kΩ-(6.8 nF + 5.6 nF 差分)`，全 E24/E12、C0G 可购。

| 指标 | V0（1k+10n） | W9（上轮冠军） | **FIN1（本轮）** | 理论 vs 仿真差 |
| --- | --- | --- | --- | --- |
| DM@fMOD | −57.8 | −102.0 | **−123.5 dB** | 0.4 dB |
| CM@fMOD | −48.2 | −85.1 | **−105.5 dB** | 0.0 dB |
| DM@MCLK | −69.8 | −126.1 | **−147.6 dB** | 0.4 dB |
| CM@MCLK | — | −109.2 | **−129.6 dB** | 0.0 dB |
| 建立 0.1% / 0.01%（标称） | 235 / 298 µs | 494 / 649 µs | 542 / 702 µs | — |
| 建立 0.01%（容差最坏角） | — | 654 µs | **744 µs** | 理论 721（差 3%） |
| MC30 建立 0.01% | — | 621–663 µs | **677–722 µs** | 全部 ≤900 µs ✓ |
| 噪声积分 | 0.52 µV | 0.44 µV | 0.65 µV | 均 ≪ ADC 底噪 1/600 |
| droop@1 kHz（相对） | −0.48 dB | — | −0.70 dB | 比值吸收 |
| 部件/通道对 | 10 | 10 | 10 | 持平 |
| min-margin（v2 制） | 1.05 中 DM 短板 | 1.05 | **1.21** | +15% |

四项裕量均衡化：FIN1 = min(123.5/80, 105.5/60, 147.6/120, 900/744) = min(1.54, 1.76, 1.23, 1.21)，
W9 的 MCLK 短板（126/120 = 1.05）被消除。仿真 vs 理论全频段差 ≤0.4 dB（叠加图 fin1_bode_overlay.png）。

**物理极限声明**：继续加阶数（理论可到 −200 dB）在 PCB 寄生耦合（~0.1 pF 级，等效 −80~−100 dB）
面前无意义；FIN1 的 −123.5 dB 已越过该地板。优化到此收敛。

## 第五轮（回应"六阶不行吗"）：阶数-部件帕累托前沿（全部 LTspice 实测）

修正第四轮的认知错误：W3/W4 多阶失败的真正原因**不是阶数**，是单级 RC 积太大（3–14 µs 造成慢极点尾）。
把每级 RC 压到 ≤3 µs 后，多级阶梯趋近分布式 RC 行为——**衰减与建立时间同时改善**（低总 R 又压低噪声）。

阶数-部件前沿（每通道对，容差最坏角建立，全部 LTspice 实测，E 线可镜像同构）：

| 方案 | 阶数 | 拓扑（每线） | DM@fMOD | CM@fMOD | DM@MCLK | 建立wc 0.1%/0.01% | 件/对 | minM |
| --- | --- | --- | --- | --- | --- | --- | --- | --- |
| V0 | 1+差分 | 1k(10n+10nd) | −58 | −48 | −70 | 298* / 308 µs | 10 | 0.58 |
| W9 | 2 | 1k(8.2n+8.2nd)-220(15n+10nd) | −102 | −85 | −126 | — / 649 µs | 10 | 1.05 |
| FIN1 | 2 | 330(47n+47nd)-2k7(6.8n+5.6nd) | −123 | −106 | −148 | — / 744 µs | 10 | 1.21 |
| **V11** | **4** | **240(6.8n)×4 + 差分10n×2** | **−154** | **−130** | **−202** | **313 / 406 µs** | **18** | **1.68** |
| V10a | 6 | 170(4.7n)×6 + 差分6.8n×3 | −199 | −171 | −271 | 302 / 392 µs | 27 | 2.21 |
| （7 阶理论） | 7 | 120(6.8n)×7 + 差分6.8n×3 | −214 | −186 | −298 | 365 µs | 31 | 2.46 |

（* V0 的建立为标称值；minM = min(DM/80, CM/60, MCLK/120, 900µs/建立wc)。）

要点：
- **低总 R + 小单级 RC 的多级阶梯严格占优**：阶数↑ → 衰减↑ 且建立反而更快（396 µs < FIN1 的 744 µs），
  噪声 ~0.7 µV 持平。物理原因：小单级 RC 无慢极点尾，趋近分布式 RC 的 cosh 衰减。
- **但 −120 dB 以下越过布局寄生地板**（板级 ~0.1 pF 级耦合等效 −80~−100 dB）：4 阶以后的衰减是
  纸面冗余。4 阶是"用 +8 件买 30 dB 保险"的位置；6/7 阶纯粹加件不加实际性能。
- 部件代价：4 阶 36 件全板、6 阶 54 件（0402，面积约 20–30 mm²）+ 四线匹配布线工作量。

**最终推荐**：工程首选 **FIN1**（10 件，越过寄生地板，裕量 1.21）；若想要布局保险，**V11 四阶**（18 件，
裕量 1.68、建立反而更快）是性价比最高的加强位；6/7 阶不推荐（纸面分数，无物理收益）。

## 落地清单

- 原理图采集页：4 处 100 Ω+2.7 nF 差分 → **V6r**（或回退 V0）网络；C 全 C0G/NP0、四线同批同值；
  R 靠源侧、C 靠 ADC 引脚侧；四组走线同长同构。
- E.4 抗混叠行：数值按定稿方案更新 + 补香农落点依据（fMOD 折叠 + 数字抽取分工）。
- 待核一项：SBAS590 Filter Characteristics 的 OSR=32 阻带曲线（只影响 64k–fMOD 区间裕量的具体数字）。

## 文件清单

| 文件 | 内容 |
| --- | --- |
| `aa1_v0_*`（ac_dm/ac_cm/tran/kick/noise） | V0 基线四件套 |
| `aa2_v1_*` `aa3_v2_*` `aa4_v3_*` | 第一轮：V1/V2(π)/V3(缓冲两级) |
| `aa6_v2b_*` `aa7_v4_*` | 第一轮精修：V2b/V4 |
| `aa8_v5_*` `aa9_v6_*` `aa10_v7_*` | 第二轮：三级交错 / 两级交错 / twin-T |
| `aa11_v8_*` `aa12_v9_*` | 第二轮：LC 巴特沃斯 / 切比雪夫（判死，留证） |
| `aa13_v5r_*` `aa14_v6r_*` `aa15_v8r_*` | 第二轮精修：V5r/V6r/V8r |
| `aa16/17/18_*_tran1.net` | 单沿长窗口瞬态（精确建立测量） |
| `aa19_v6r2_*` | 第二轮打磨 |
| `probe_round3.py` / `probe_round3b.py` / `probe_round3c.py` | 第三轮探针生成器（W1–W11，变体表在脚本头部，可复用继续扫） |
| `aa20_w*_*` | 第三轮 11 个变体的网表与结果 |
| `parse_and_plot.py` | ASCII .raw 解析 → Bode/建立/kick 图 + 数值汇总 |

图：`aa_bode_dm.png`（六强 DM 对比）、`aa_bode_cm.png`、`aa_settle.png`（对数建立）、`aa_kick.png`。

## 方法备忘（踩坑记录）

1. `-ascii` 出文本 raw；头是纯 ASCII，值区每点首行带**点序号**（`0\t\tval`），解析须跳过序号。
2. `.tran` 用 PULSE 周期信号时 .meas 的 FALL/RISE 会被多沿干扰——**精确建立时间用单沿 PWL +
   长窗口，从 raw 的 V(e) 直接量取**。
3. `V(e)`（B 源 abs 误差）本身就是误差信号，别再减参考值；阶跃满度是 **2.4 V 峰峰**（两线反相各 1.2 V）。
4. LTspice 网表电阻不允许 0 Ω；行首字母决定器件类型（`Eb1` 是 4 节点 VCVS，行为源要写 `B`）。
5. `.meas NOISE ... INTEG ONOISE` 报错——噪声从 raw 自己梯形积分。
6. AC .meas 直接输出 dB（`(-57.76dB,0°)`），可作解析锚点；`FIND MAX mag(...)` 语法不支持，
   峰值从 raw 取。
7. LTspice 的 `-v` 不是版本号，会拉起 GUI 阻塞终端。
