chenxi-z/de-drms/docs/design/2026-11-05-msc-plan.md

# 只读 MSC Implementation Plan

> **For agentic workers:** REQUIRED SUB-SKILL: Use superpowers:subagent-driven-development or superpowers:executing-plans to implement this plan task-by-task. Steps use checkbox (`- [ ]`) syntax for tracking.

**Goal:** 在保留 CDC 和采集能力的同时，安全地将 TF 卡作为只读磁盘导出。

**Architecture:** 存储线程保持介质唯一所有者，MSC 回调通过有界请求访问它。
导出前关闭 FileX，释放导出时等待在途读完成，再重新挂载。

**Tech Stack:** C、ThreadX、USBX、FileX、STM32U5 HAL、Python unittest、ARM GCC。

**Spec:** [已确认规范](2026-11-05-msc-design.md)

## Global Constraints

- 不改 IOC、EDA、历史仿真或已有 BIN 布局。
- CDC 保持可用；MSC 只读；记录中拒绝导出，导出中禁止所有记录入口。
- 不在中断上下文执行 SD 或 FileX 操作；只有存储线程操作 TF 外设。
- 逻辑扇区 512 字节，FIFO 总量不超过 320 个 32-bit 字。
- 队列有界；超时不能导致仍在使用的缓冲或请求槽被复用。
- 不实现新二进制协议、R₀、分档或实时数据订阅。
- 当前工作区大量文件已有用户修改；仅提交本任务明确拥有的改动，不打包用户文件，不推送。

## Review Focus

- 导出接受与按键启动同一时刻发生：记录只能被接受一次且不能穿过导出屏障（任务 1、4）。
- USBX 读超时后晚到完成：旧代次不能写入新请求缓冲（任务 2）。
- 换入不同容量卡：旧容量与旧请求不能用于新介质（任务 2、3）。
- reset/unconfigure/物理断线发生在读取中：撤销就绪并排空后再挂载（任务 3、4）。
- CubeMX 重生成恢复了可写默认值：保护检查应拒绝验收（任务 5）。

## 文件职责

- 新增 `Core/Inc/drms_msc.h`、`Core/Src/drms_msc.c`：导出状态、代次、单请求邮箱及取消/完成协议。
- 修改 `drms_storage.c/.h`：存储线程中的 FileX 交接、原始 SD 初始化、轮询读取、清理和重挂载。
- 修改 `USBX/App/ux_device_msc.c/.h`：SCSI 回调、LUN 只读、实际容量更新。
- 修改 `drms_usb.c`、`USBX/App/app_usbx_device.c`：FIFO、类初始化及连接状态通知。
- 修改 `drms_command.c/.h`、`drms_application.c`、`drms_console.c`、`FileX/App/app_filex.c`：调试命令、状态、所有记录入口互锁及存储服务。
- 修改 `tools/firmware_postgenerate.py`、Makefile、协议定义/说明、固件 README：生成保护和操作说明。
- 新增 `test/test_msc_lifecycle.py`、`test/test_msc_callbacks.py`；扩展现有存储、应用、USB 和生成保护测试。
- SDK 若需适配，只修改实际验证不足的状态/容量路径，补实际源码测试并将恢复规则纳入工具。

### Task 1: 导出状态及记录互锁

**Interfaces:** `int drms_msc_request_export(void)`、`int drms_msc_request_release(void)` 返回接受/忙/未就绪；
`int drms_msc_blocks_recording(void)` 查询互锁；`void drms_msc_service(void)` 仅存储线程调用。
状态使用规范中的五个值，错误独立；对外头文件明确枚举，值发布后不复用。

- [ ] 先添加生命周期失败用例；断言 `export_accepted => recording_rejected`，LOCAL 且卡可用时记录仍能开始；记录 state=1/2/3 均拒绝导出。
- [ ] 运行 `python3 -m unittest discover -s test -p 'test_msc_lifecycle.py' -v`，确认因缺失生产实现失败。
- [ ] 实现原子请求接纳与重复请求规则；应用线程和按键共用记录互锁，存储线程复查后才 flush/close；覆盖转换中反向请求和 flush 失败。
- [ ] 运行该测试及 `test_application.py`、`test_storage_lifecycle.py`，确认通过后审查任务差异，只提交本任务自有文件。

### Task 2: 存储所有者中的有界读取

**Interfaces:** `int drms_msc_read(uint32_t lba, uint32_t blocks, uint8_t *out)` 是 USBX 线程同步入口，
不直接访问 HAL；任务 1 的 service 消费请求。`void drms_msc_cancel(void)` 撤销就绪并请求排空；
`int drms_msc_media_info(uint32_t *blocks)` 只在已导出时提供当前容量。

- [ ] 添加用例：最后一个合法扇区内容正确；`lba=UINT32_MAX, blocks=2` 拒绝；读超时后的旧完成不能覆盖新请求；清理前必须确认在途读结束。
- [ ] 运行任务 1 的测试文件，确认上述新增行为失败。
- [ ] 实现单在途邮箱、对齐专用 512 字节缓冲、代次及取消确认；轮询读每扇区有界等待，初始超时 1000 ms；每步检查掉卡和取消并让出 CPU。调用方总等待按块数有界计算，超时后不重用未确认释放的槽。
- [ ] 导出使用已关闭 FileX 的 SD 外设；重新初始化保留 24 MHz；读取卡实际逻辑容量。释放时先撤销就绪、排空读、deinit，再挂载 FileX。
- [ ] 测试读错误、初始化失败、掉卡、无卡、卡容量变化、重新挂载失败和关机等待，全部通过后审查并仅提交本任务改动。

### Task 3: USBX 回调与双类运行

**Interfaces:** 继续使用 CubeMX 生成的 `USBD_STORAGE_*` 签名；读取调用任务 2 API，
状态/容量使用同一导出代次。`void drms_msc_usb_lost(void)` 可在 IRQ 中仅投递取消，不操作介质。

- [ ] 添加生产回调测试：未导出 NOT READY、导出后读取真实内容、写入 DATA PROTECT 且 HAL 写次数为 0、非法 LUN 拒绝、通知响应不含未初始化数据。
- [ ] 运行 `python3 -m unittest discover -s test -p 'test_msc_callbacks.py' -v`，确认模板无法通过。
- [ ] 实现回调与只读标记；注册阶段块大小固定 512，实际容量在导出就绪前写入有效 LUN 实例。无卡不阻止 CDC 初始化。
- [ ] 审查并测试 USBX READ CAPACITY、TEST UNIT READY、读写和 START STOP 实际路径；只为缺失的介质就绪检查补 SDK 适配；不在主机弹出路径直接重挂载 FileX。
- [ ] 按 RX128/TX0=32/TX1=64/TX2=16/TX3=64 配置并验证 FIFO 最小值，总量 304；MSC OUT4 用共享 RX。双类注册、FIFO 和线程分配失败均不附着。
- [ ] 扩展实际 SDK/USB 测试覆盖 suspend 保留所有权、reset/unconfigure/断线撤销导出、在途取消、重连不自动导出；通过后审查并提交本任务改动。

### Task 4: 命令和存储工作流闭环

**Interfaces:** 新命令 ID 追加在现有 ID 之后，不更改旧编号；解析 `MSC EXPORT`、`MSC RELEASE`。
STATUS 追加 msc_state、msc_error，继续沿用当前接受/最终结果语义。

- [ ] 添加命令和应用测试：语法精确匹配、记录中拒绝导出、导出请求与按键记录竞争、导出时 STOP 不隐式收回磁盘、释放不自动开始记录。
- [ ] 运行相应 command/application/storage 测试，确认新增用例失败。
- [ ] 接入存储循环与命令调度；所有本机记录入口先检查互锁，FileX 在原始介质所有权期间不调用 log_poll 或自动挂载；关机先排空读取。
- [ ] 在真实生产模块集成测试中执行 LOCAL→EXPORTING→EXPORTED→RELEASING→LOCAL，以及每一步故障；确认 CDC 和采集仍可推进，FileX/原始 SD 从不同时操作。
- [ ] 同步机器/人读控制协议；不将未来协议能力误称已实现；审查并仅提交本任务改动。

### Task 5: 生成保护、全量验证与交付

- [ ] 扩展 postgenerate 失败夹具：类数量回退 1、只读标记丢失、MSC 回调钩子丢失、MSC 源文件缺失及 SDK 保护回退必须被检测。
- [ ] 更新已知模板恢复和 USER 钩子验证，未知模板继续拒绝；执行 --apply 两次，第二次不得产生改动。
- [ ] 更新固件说明：导出/释放示例、记录互锁、掉卡恢复、只读限制及 Windows/Linux 实板验收清单。
- [ ] 运行 `python3 -m unittest discover -s test -p 'test_*.py'`、`python3 tools/firmware_postgenerate.py`、`make -C firmware/DE-DRMS-Code -j6 BUILD_DIR=/tmp/de-drms-msc-final`、`git diff --check`；测试全部通过，构建无新警告。
- [ ] 复核超时/取消时的内存归属、类注册和状态边界；记录软件验证证据与未进行的实板验收，不声明已通过实际枚举或复制测试。

## 执行选择

建议在本会话由主 agent 顺序执行，任务间验证共享接口，最后进行整体复核。
也可由子 agent 分任务实现与复核；需要用户选择执行方法并审阅本计划后开始。
