chenxi-z/de-drms/hardware/sim/AAF_基于已确认封装的候选参数与Zcode复核_2026-10-24.md

# AAF 一阶/二阶小封装候选参数与 Zcode 复核指令

> 版本：2026-10-24。**本文件只提出电气候选参数；封装是否真正可采购、型号、库存、价格，由设计者自行核实和最终确定。**

## 1. 已由设计者确认的可找到封装

| 电容容量 | 已确认可找到的封装 |
|---|---|
| 820 pF | 0402、0603 |
| 2.2 nF | 0402、0603、0805 |
| 4.7 nF | 0402、0603、0805 |
| 6.8 nF | 0402、0603、0805 |
| 10 nF | 0402、0603、0805 |
| 22 nF | 0805、1206、1210 |
| 47 nF | 0805 及以上，无 0603 |

所有候选电容继续限定 C0G/NP0。电阻优先 0402，但是否可买到满足容差及 TCR 的器件也由设计者确认。最大电容封装不超过 0805；更优先全 0402。

## 2. 需测试的参数方案

所有 R、CG 都是**每条 P/N 输入线各一份**；Cd 为每个差分通道 P/N 之间共用的一只差分电容。两路差分 ADC 通道共计两套。

一阶：OPAx388 → R1 → ADC；在 ADC 输入节点 CG 对地，P/N 间跨 Cd。

二阶：OPAx388 → R1 → 节点1 → R2 → 节点2/ADC；CG1 在节点1对地，CG2 在节点2对地，Cd 跨节点2 P/N。

| ID | 拓扑 | 每线 R1 | 每线 CG1 | 每线 R2 | 每线 CG2 | 每通道 Cd | 目标封装 | 器件数/差分通道 |
|---|---|---:|---:|---:|---:|---:|---|---:|
| S0 | 一阶原基线重新封装 | 47 Ω | 47 nF | — | — | 820 pF | CG 0805，其余优先0402 | 5 |
| S1 | 一阶 Zcode 已验证 | 100 Ω | 22 nF | — | — | 820 pF | CG 0805，其余优先0402 | 5 |
| T1 | 二阶平坦度优先 | 100 Ω | 10 nF | 100 Ω | 10 nF | 820 pF | **全0402** | 9 |
| T2 | 二阶均衡（优先） | 100 Ω | 10 nF | 120 Ω | 10 nF | 820 pF | **全0402** | 9 |
| T3 | 二阶分阻值 | 68 Ω | 10 nF | 150 Ω | 10 nF | 820 pF | **全0402** | 9 |
| T4 | 二阶高抑制边界 | 82 Ω | 10 nF | 160 Ω | 10 nF | 820 pF | **全0402** | 9 |

T4 的16 kHz通带容差余量较小，专门用来检测边界；不是预定胜者。不需要因为 4.7 nF、6.8 nF、2.2 nF 也有0402，就先加入十余组几乎同占地的新组合。只有 T1–T4 出现真实电气问题时，再以这些较小电容为优化变量。

## 3. 独立理想 RC 数值对照（非 LTspice）

模型：完全对称 P/N；ADC 130 kΩ 典型**差分电阻**、不含ADC采样开关；C0G视作理想电容；源为理想低阻电压源。增益以 DC 归一化。最坏角只指**R全+1%、C全+5%** 的简化同向高时间常数角，而非全面蒙特卡洛，也不包括运放模型。

| ID | @16kHz 衰减 (dB) | @16kHz 相位 (°) | @4.096MHz DM 衰减 (dB) | @4.096MHz CM 衰减 (dB) | @16.384MHz DM 衰减 (dB) | +1%R/+5%C 时16kHz衰减 (dB) |
|---|---:|---:|---:|---:|---:|---:|
| S0 | 0.223 | -12.93 | 35.39 | 35.10 | 47.43 | 0.250 |
| S1 | 0.238 | -13.35 | 35.67 | 35.06 | 47.71 | 0.267 |
| T1 | 0.366 | -18.66 | 57.76 | 56.47 | 81.80 | 0.410 |
| T2 | 0.412 | -19.90 | 59.33 | 58.04 | 83.38 | 0.461 |
| T3 | 0.335 | -18.08 | 57.92 | 56.63 | 81.97 | 0.375 |
| T4 | 0.423 | -20.31 | 60.10 | 58.81 | 84.15 | 0.473 |

**注意：** S0 与 S1 已有的 Zcode 实际 TI OPAx388 模型仿真给出更好的高频抑制；上表理想源结果**不能**与旧报告真实模型的 D1/D2/D3 横向混为一个实测排名。二阶同样要进行真实模型实测。各方案均不能事先声明满足原 D1≥80、D2≥60、D3≥100 dB。

## 4. 面积对照规则

以统一封装估算**仅本体面积**，不代表真实 PCB 放置面积：0402 为1.0×0.5=0.5 mm²；0805 为2.0×1.25=2.5 mm²。

- S0/S1：2×0402 电阻 + 2×0805 对地电容 + 1×0402 Cd = **6.5 mm²/差分通道**。
- T1–T4：4×0402 电阻 + 4×0402 对地电容 + 1×0402 Cd = **4.5 mm²/差分通道**。
- 两个差分通道分别 **13.0 与 9.0 mm² 本体面积**。但二阶多四个元件/通道，需要更多焊盘、过孔、间距与布线，**真实占地不一定更小**。
- S0 与 S1 在 CG 都选 0805 时，**占地应作为同一封装等级比较**，不能再因为旧 S0 用1210就把 S1 算作有面积优势。实际是否同面积由 EasyEDA 布局确认。

## 5. 要求 Zcode 做的事情

1. 从 `hardware/sim/signalchain/fo1_rc_review/` 复用经过 T00 回归校验的真实 LTspice 26.1.1 及 TI OPAx388 库，复制原网表创建候选；不得改坏基线。
2. 用完整的恒流源 + 3×OPA388 + ADS131A02 130kΩ/3.5pF/采样开关负载运行，**CH1 AIN1N 必须保留 Kelvin RC 直连，不能假造第四颗运放**。
3. 逐一测 D1/D2/D3、16kHz D4、D5、D6a、D7、D8（未配对和实际匹配两种）、D9 Kickback、D10 双通道延迟、C9 peaking、OPA388相位裕量、4.096MHz±{1k,8k,16k} 高频注入折回；标注适用模型、测点、频率和条件。CMRR 必须区分“RC自身”和“整链Kelvin”口径。
4. 在同样真实 TI 模型条件下检查各案未失稳，检查开关电容输入驱动和 THD；不能把理想 RC 结果称为 LTspice 结果。
5. 同时评估双通道 V/I 比值幅度及相位误差，并对 10k–120kΩ 工作量程和合理扩展工况做必要检查。
6. 将 S0 的 CG 改成 0805 只用于*模拟相同理想参数的封装方案*；要核实实际供方所选 47nF/0805 的 SRF、ESL、温度及容差，不得默认 1210 与 0805 在MHz频率下完全等效。
7. 在 EasyEDA 工程**副本**中，用用户确认的封装画出 S0/S1/T1/T2/T3/T4 的可制造布局，完整考虑焊盘、地过孔、P/N对称性和模拟敏感区，分别报告每差分通道面积与两通道合计面积；不可直接改写原图纸。
8. 给出 Pareto 候选：最小真实面积、最优电气折中、以及未满足原D1-D3要求的原因。不得用“更小封装”替代“实际 PCB 总占地”测量。

## 6. 当前建议

- **若面积优势需要立即落地而不想增加新的仿真风险：**一阶 S0 =47Ω/47nF/820pF，47nF 换为用户核实的 **0805**，先核实电容型号寄生；再和 S1 相同0805布局比较。一阶 S0 既有仿真数据在部分指标上优于 S1，但实际0805器件需再次验证。
- **若希望通过级数换高频抑制：**优先 T1/T2（全0402）；T3 作为不同首级阻值的稳定性对照；T4 作为高频抑制边界。
- **仍然以 D1-D3 原指标判定通过与否，不擅自降低。**
