chenxi-z/de-drms/docs/design/spec/2026-10-18-aa-driver.md

# 抗混叠与采集驱动子系统设计与实现计划（跟随器输出 → ADC 输入）

- **文档状态**：待用户审阅（DRAFT v1）
- **日期**：2026-10-18
- **作用域**：信号链四个测量点出口之后、含跟随器、至 ADS131A02 引脚入口的完整子系统
- **上游约束**：`docs/design/2026-10-10-universal-signal-chain.md` 附录 E（E.2 前端、E.4 ADC）、`docs/design/pin-assignment.md`
- **冲突仲裁**：本规格与附录 E 冲突时，以附录 E 为准并提请用户修订本规格

---

## 1. 设计目标（一句话）

在 128 kSPS 输出码率下，把直流 + 单相正弦叠加信号（正弦分量 ≤16 kHz）完整、平坦、低噪地送达 ADS131A02 采样电容，同时对 fMOD=4.096 MHz 及以上的混叠源提供远超物理底的衰减。

## 2. 信号规格（输入条件）

| 项 | 值 | 来源 |
|---|---|---|
| 信号类型 | 直流电平 + 单相正弦叠加（不换向） | 用户 2026-10-18 确认 |
| 直流测量对象 | 设计量程 10–120 kΩ（≤0.005%）；1% 可用范围 ~73 Ω–600 kΩ（下限 = K2 漏电恒定 −0.73 Ω 偏置；上限 = 比值机制把恒流合规墙 215 kΩ 推到 ADC 满量程处，600 kΩ 时电流自动跌落、比值抵消，E.3.4 fs4/fs6 实测） | 附录 E.3.4 |
| 正弦分量频率上限 | **16 kHz**（每周期 8 点 @128 kSPS，实用下限） | 用户 2026-10-18 确认 |
| 精密扫频工作区 | ≤8 kHz（每周期 ≥16 点） | 推导 |
| 激励 | 8 µA 恒流（直流模式）；正弦激励模式为将来扩展，本段不感知激励极性 | 附录 E |
| 满量程 | ±2.442 V（ADS131A02 内部基准） | 附录 E.4 |

### 2.1 每周期点数判据（128 kSPS 下）

| 频率 | 每周期点数 | 判定 |
|---|---|---|
| 2 kHz | 64 | 波形级还原 |
| 8 kHz | 16 | 精密扫频（幅值 <1% 误差） |
| **16 kHz** | **8** | **实用下限（幅值 <5% 误差）——设计上限** |
| 32 kHz | 4 | 不可用（幅值误差 ~30%） |
| 64 kHz | 2 | 香农极限，工程不可用 |

## 3. 频率规划（三层分工）

| 层 | 频段 | 责任人 | 手段 |
|---|---|---|---|
| 通带 | DC ~ 16 kHz | 模拟阶梯让路 | fc = 50~80 kHz（给 16 kHz 留 3~5 倍余量） |
| 过渡带 | 16 kHz ~ 64 kHz | 模拟 + 数字共同 | 模拟平缓滚降 + sinc³ 数字滤波器 |
| 数字阻带 | 64 kHz ~ fMOD | **sinc³ 数字滤波器**（OSR=32） | fMOD 谐波处深陷波 |
| **模拟主战场** | **fMOD = 4.096 MHz 及以上** | **模拟阶梯**（唯一防线） | 采样混叠无法被数字纠正 |

**关键澄清**：抗混叠锚点是 fMOD，不是 64 kHz。64 kHz 只是奈奎斯特折叠边界；64 kHz~fMOD 之间的带由数字滤波器负责，模拟阶梯只需守住 fMOD 及其谐波。

## 4. 架构定稿（不再变更的结构性决策）

```
每线： 跟随器(OPA388)输出 ── R_iso ── 无源RC阶梯(2~4级) ── ADC引脚
每通道(差分对)：两线末级之间跨接 C_diff（兼电荷桶）；每线末级对地 C_cm
通道数：2（CH1 = AIN1P/AIN1N，CH2 = AIN2P/AIN2N），共 4 线，全配同一标准单元
```

已定稿决策（前轮已论证，不再重开）：

1. **四线统一全配**：AIN1N（Rsense 底端低阻参考）也配全阶梯。比值测量精度来自两线对称，失配转 CMRR/增益误差。
2. **跟随器只当缓冲，不进反馈环路**：OPA388 GBW=10 MHz，在 fMOD 主战场环路增益 ~8 dB，Sallen-Key 阻带翘曲，判死。跟随器贡献 = ①把源阻抗从 ≤150 kΩ 压到近零（阶梯电阻可取几百欧）；②阶梯首级电阻兼任其容性负载隔离电阻（一件顶两职）。
3. **末级 C_diff 三职合一**：差分衰减主电容 + ADC 采样电荷桶（容值 ≥ 采样电容 20~50 倍）+ 通道噪声带宽设定。
4. **无源 RC 阶梯**是 fMOD 频段唯一可靠滤波手段（该频率处性能只由 R/C 本身决定）。

## 5. 多维评分标准（核心，用于方案打分排序）

每个候选方案按以下 **10 个评分槽位** 评分（D6 拆为 D6a/D6b 两个子维度，D6b 仅报告不进 min），归一化到 [0,1]，**取最小值**作为总分（短板制——任何一维不及格则整体不及格）。维度权重通过阈值设定体现。**评分主口径 = 真实 OPA388 模型**（第 1 轮复核发现 0Ω 理想源口径在 fMOD 处偏差 16–22 dB，不可用）。

### 5.1 评分维度表

| # | 维度 | 符号 | 测量/计算方法 | 满分阈值（得 1.0） | 及格线（越线淘汰） | 归一化方式 |
|---|---|---|---|---|---|---|
| D1 | **DM 衰减 @fMOD** | A_dm | AC 仿真，差分激励，4.096 MHz 处增益 | ≥120 dB | <80 dB | `min(A_dm/120, 1)` |
| D2 | **CM 衰减 @fMOD** | A_cm | AC 仿真，共模激励，4.096 MHz 处增益 | ≥100 dB | <60 dB | `min(A_cm/100, 1)` |
| D3 | **DM 衰减 @MCLK** | A_mclk | AC 仿真，16.384 MHz 处增益（晶振泄漏路径） | ≥150 dB | <100 dB | `min(A_mclk/150, 1)` |
| D4 | **通带平坦度 @16 kHz** | ΔG | AC 仿真，16 kHz 处增益相对 DC 的偏差绝对值（dB） | ≤0.05 dB | >0.5 dB | ΔG≤0.05 得 1.0；0.05<ΔG≤0.5 线性插值 `1 − (ΔG−0.05)/0.45` |
| D5 | **建立时间（最坏角）** | t_s | 瞬态仿真，0.01% 建立带，1%R + C 容差最坏角；**测试须覆盖高源阻抗工况（样品 600 kΩ 端）** | ≤500 µs | >900 µs | `min(500/t_s, 1)` |
| D6a | **无源网络噪声增量**（本段可控项，硬指标） | ΔV_n | 真实 OPA388 模型下总积分噪声 vs 跟随器自身噪声（同带宽）的增量比例 | ≤10% | >30% | `min(10/ΔV_n[%], 1)` |
| D6b | **总积分噪声**（软参考，不进 min） | V_n | 真实 OPA388 模型 AC 噪声仿真，积分 0.1 Hz~fMOD/2 | ≤4.3 LSB（砖墙极限，见下注） | 不设淘汰线，仅报告 | — |
| D7 | **容差敏感度 @通带** | σ_ΔG | 蒙特卡洛 AC 30 次（R 1% + C 容差随机），16 kHz 处增益偏差的标准差 | ≤0.01 dB | >0.05 dB | σ≤0.01 得 1.0；0.01<σ≤0.05 线性插值 `1 − (σ−0.01)/0.04` |
| D8 | **CMRR @通带（R·C 乘积配对条件）** | CMRR_pb | AC 仿真，共模注入测差分输出，10 Hz~16 kHz 最差值；**考核条件：两线按 R·C 乘积配对（1% 单体失配，R×(1+m) 配 C×(1−m) 异向配对）** | ≥100 dB | <80 dB | `min(CMRR_pb/100, 1)` |
| D9 | **Kickback 回稳** | t_kb | 瞬态 + ADC 采样开关模型，fMOD 半周期（122 ns）内回稳到 0.01% 带内 | 完全回稳 | 半周期内未回稳淘汰 | 二值：回稳 1.0 / 未回稳 0 |
| D10 | **群延迟平坦度 @通带** | Δτ | AC 仿真群延迟，0.1~16 kHz 变化量 | ≤1 µs | >5 µs | Δτ≤1 得 1.0；1<Δτ≤5 线性插值 `1 − (Δτ−1)/4` |

**总分 = min(D1, D2, D3, D4, D5, D6a, D7, D8, D9, D10)**（D6b 仅报告）。所有仿真以真实 OPA388 模型为主口径；D5/D7/D8 在容差角下进行。

**单位约定**：LSB = 2 × 2.442 V / 2²⁴ ≈ **291 nV**（双极性满量程跨度计算）；dB 均为 20log₁₀(电压比)。

**标准测试条件**（V1–V7 共用，执行者不得改动）：

| 项 | 规定值 | 说明 |
|---|---|---|
| 共模激励 | AC 幅度 1 V，直流偏置 2.0 V | 直流偏置取 T 点实际共模电平（E.3：T ≈2.97 V、M ≈2–3 V，取 2.0 V 代表通带内最不利工况）；D2/D8 统一用此 |
| 差分激励 | AC 幅度 1 V（差分），直流偏置同上 | D1/D3/D4 |
| 源阻抗（V1–V6 理想源阶段） | 0 Ω（跟随器闭环输出近似） | V7 真实 OPA388 模型阶段自动覆盖非理想源阻抗 |
| 温度 | 标称 25 ℃；另报 −20 ℃ / +85 ℃ 两角的 D4/D7 趋势（C0G ±30 ppm/℃、电阻按选型温漂代入） | 不做全维度温度角，只看通带相关项 |
| 高源阻抗工况（仅 D5） | 样品 600 kΩ 端（1% 可用范围上限） | 建立时间最坏情况 |

> **D10 为正式评分维度**（用户 2026-10-18 确认：扫频就是为了测相位/复阻抗谱）。群延迟不平坦 = 相位失真 = 阻抗角误差，直接吃掉扫频的核心产出。判据参考：Δτ=1 µs @16 kHz 相当于全通带相位离散 ±5.8°，阈值按此锚定。
>
> **相位测量的进一步含义**：既然要测相位，通道间（CH1 vs CH2）的群延迟**匹配**同样关键——相位是 V_sample 与 V_Rsense 两通道的相对值，通道间延迟差直接变成相位误差。此项由四线统一全配（§4 决策 1）+ D7/D8 的失配考核覆盖；复测时须在报告中单列"CH1 vs CH2 群延迟差 @通带"数据供核查。

### 5.1a 维度说明（为什么要有 D7–D10）

- **D7 容差敏感度**：扫频测量最怕 fc 漂移——1% R 容差会让不同频率点的增益不一致，直接变成扫频幅值误差。标称值好看没用，要看离散。
- **D8 CMRR @通带**：电阻测量是比值测量，精度依赖两线对称性。两线阶梯失配会把共模电压（T 点约 2 V）转成假差分信号——0.1% 失配 → 2 mV 假信号，对 80 mV 样品信号 = 2.5% 误差。**2026-10-19 修订（R5 第 2 轮求解阶段发现）**：同向 1% 失配下任何拓扑 CMRR 只有 48–49 dB（物理上限），但**两线按 R·C 乘积异向配对**（R 偏大的线配 C 偏小的）可把失配转化为时间常数匹配，1% 单体下达 110–112 dB。考核条件据此改为配对后失配；BOM 须加配对工序要求（实测每对 R、C 值后按乘积配对贴片，或采购配对网络）。
- **D9 Kickback**：ΣΔ ADC 采样电容以 fMOD 速率吞吐电荷，末级网络若回稳不充分，直接变成非线性误差。原先是验证项，提级为正式维度（实际板子最常见翻车点之一）。
- **D10 群延迟**：扫频测相位（复阻抗谱），群延迟不平坦 = 相位失真 = 阻抗角误差。正式维度（用户 2026-10-18 确认）。

### 5.1b D6 拆分的物理依据（2026-10-19，R5 第 2 轮实测）

原 D6（总积分噪声 ≤1 LSB）**物理不可达**：跟随器噪声 9.9 nV/√Hz（OPA388 定稿器件）× D4 要求的 16 kHz 通带决定 ENBW ≥14.3 kHz ⇒ 总噪声 ≥4.3 LSB（理想砖墙极限，实际更高）。1 LSB 阈值相当于要求噪声带宽 ≤864 Hz，与 D4 冲突 16.5 倍。据此拆分：

- **D6a 考核本段可控的部分**：无源阶梯自身的约翰逊噪声增量（跟随器之外新增多少）。阶梯总电阻 ≤5 kΩ（C2）时约翰逊噪声 ~9 nV/√Hz 级但经低通后贡献小，10% 增量是合理要求。
- **D6b 报告总噪声供参考**：4.3 LSB ≈ 1.25 µVrms，对最小信号 80 mV（10 kΩ 样品）是 0.0016%，对测量精度无实质影响；但须报告确认无异常放大（如有源谐振——R5 第 2 轮曾实测到 283 kHz 处 +30.7 dB peaking 把噪声放大 6 倍的案例，见硬约束 C9）。

### 5.2 工程约束（硬门槛，不满足直接淘汰，不参与评分）

| # | 约束 | 限值 | 理由 |
|---|---|---|---|
| C1 | ~~每通道器件数~~ | **软参考**：不设淘汰线，评分报告列出器件数供决策 | 用户 2026-10-18：器件数无所谓 |
| C2 | 每线串联电阻总和 | ≤5 kΩ | 直流压降 + 约翰逊噪声 |
| C3 | 单电容最大值 | ≤100 nF | C0G 可购性放宽（用户 2026-10-18）；**>47 nF 时必须核查自谐振频率（SRF）>fMOD，否则考虑薄膜电容** |
| C4 | 电容介质 | 必须 C0G/NP0（或薄膜） | X7R 等二类介质的压电/直流偏压效应不可接受 |
| C5 | 电阻精度 | 1% 起步（E24），关键位 0.1%（E96）；**两线阶梯须按 R·C 乘积配对**（D8 的达标前提，见 §5.1a） | 成本与匹配 |
| C6 | （并入 D9，Kickback 回稳即驱动能力考核） | — | — |
| C7 | 跟随器输出摆幅 | 距轨 ≥0.15 V（AOL 保证区） | SBOS777D |
| C8 | 漏电 @高阻侧 | <1 nA（跟随器输入侧，由 E.2 保证，本段继承） | 源阻抗 ≤600 kΩ（宽范围端） |
| C9 | **有源谐振（peaking）** | 真实 OPA388 模型下全频段增益峰值 ≤6 dB | OPA388 闭环输出阻抗中频负实部可与阶梯电容形成谐振（R5 第 2 轮实测案例：283 kHz 处 +30.7 dB，积分噪声 12→75 LSB）；解析手册曲线查不出，必须用 TI 模型实测输出阻抗表 |

### 5.3 待手册核实项 —— ✅ **2026-10-18 已全部核实**

> 详细证据（页码/图号/矢量读数/复现方法）见 `hardware/sim/aaf/r5_datasheet_facts.md`。
> **文献号勘误**：ADS131A02 的正确手册是 **SBAS590E**（Rev. E, 2020-06）；原表所写 **SBAS890 实为 ADS131M04 的手册**（已下载核对标题）。

| # | 项 | 手册 | 章节（页码） | **已核实值** | 影响维度 |
|---|---|---|---|---|---|
| M1 | sinc³ 滤波器 −3 dB 频率 @OSR=32 | ADS131A02 **SBAS590E** | Figure 46 (p34) / Eq.7 (p33) | **33.79 kHz**（图读数 0.264×fDATA）/ **33.49 kHz**（Eq.7 解析，K=1.0）→ 取 **≈33.5 kHz** | D4 通带判定基准 |
| M2 | ADS131A02 输入采样电容值 | 同上 | EC 表 (p10) / Fig.38 (p29) | **C_S = 3.5 pF**（差分；每侧 C_S/2） | C_diff 电荷桶尺寸 |
| M3 | ADS131A02 输入电流/阻抗规格 | 同上 | EC 表 (p10) / Eq.5 (p29) | **Z_IN = 130 kΩ typ @4.096 MHz**（Eq.5 复算 139.5 kΩ，+7.3%）；**模拟输入偏置电流手册未给数**（仅 p85 定性；p11 的 10 µA 是**数字脚**） | C6 |
| M4 | OPA388 开环增益 @4 MHz | OPA388 **SBOS777D** | Figure 6-8 (p12) | **A_OL ≈ 7.0 dB（2.24 V/V）** @4.096 MHz；GBW 近似值 7.75 dB，偏差 −0.75 dB ✅ | D1-D3 模型准确性 |
| M5 | fMOD 确切值（fCLKIN/4 或 /8，依配置） | ADS131A02 | Fig.35 (p27) / Table 28-30 (p67-69) / EC 表 (p11) | **fMOD = 4.096 MHz = fCLKIN/2/2**（CLK1 `CLK_DIV=001`、CLK2 `ICLK_DIV=001`、`OSR=1111`）→ fDATA=128 kSPS。⚠️ **两处分频复位值均为 100=/8，必须在固件里显式改写** | D1-D3 频率锚点 |
| M6 | ADS131A02 输入开关等效电阻与时序 | 同上 | Figure 37/38 (p29) / Layout (p79) | 时序：**S1/S2 180° 反相，周期 t_MOD=1/fMOD，各占 50%**；**R_on 与孔径时间手册全文未给** → V8 按 §7 缺省 `Ron=1 Ω` 建模并明示假设（实算 1 kΩ 时 τ=3.5 ns ≪ 122 ns，非瓶颈） | D9 模型构建 |
| M7 | OPA388 输出阻抗（闭环，随频率） | OPA388 SBOS777D | Fig.6-25 (p15) / EC 表 (p9) | **手册只有开环曲线，无闭环曲线**：Z_O,ol @4.096 MHz ≈ **110 Ω**（EC 表 100 Ω typ @1 MHz 与曲线 155 Ω 不符，手册自身矛盾）。**闭环（单位增益，本设计推导）**：16 kHz ≈17 mΩ、1 MHz ≈18 Ω、**4.096 MHz ≈34 Ω** | 阶梯首级驱动假设 |

**纪律**：M1–M7 在 LTspice 复测前必须查手册填入实际值；若手册值与本文档推算值冲突，以手册为准并更新评分阈值。

> ⚠️ **核实后的口径提醒（不阻塞复测）**
>
> sinc³ 在通带内有**固有跌落**：8 kHz **−0.17 dB**、**16 kHz −0.67 dB**（−0.05 dB 点仅 4.37 kHz），
> 属**数字域**衰减，模拟阶梯既无法补偿也不应补偿。
> D4 按 §5.1 定义为「AC 仿真」——即 V1 的**模拟段**（跟随器→阶梯→ADC 引脚）**相对 DC** 的偏差，**本身已不含 sinc³**，口径正确。
> **执行者须守住这条边界**：不得把 D4 扩展成"整链/含数字滤波"的平坦度（那样 16 kHz 处 −0.67 dB 会超阈值 13 倍）；
> 同理，实测端到端频响与 D4 的比对须先反算掉 sinc³ 的固有响应。
> 本条不影响 D1–D3/D5–D10，也不影响 fMOD 与 sinc³ −3 dB 的冲突判据（两项均未超 20%）。

## 6. 候选方案框架（三档，fc 统一在新口径下重评）

| 方案 | 阶数 | 结构 | 预期器件/通道 | 定位 |
|---|---|---|---|---|
| A | 二级 | 2×(R+C_gnd) + C_diff | ~10 件 | 器件最少 |
| B | 三级 | 3×(R+C_gnd) + C_diff | ~14 件 | 折中 |
| C | 四级 | 4×(R+C_gnd) + C_diff | ~18 件 | 衰减最大 |

**定档原则**：不预判档位，三案全部求解、全部评分，以 §5 总分排序定档。若 A 及格（**D1–D10 全过线**）则优先选 A（器件少）；A 不及格再看 B，依此类推。

**注意**：上一战役的 FIN1/V11/V10a 参数是按旧 fc（直流导向，~20-50 kHz）优化的，**本规格下三案全部需要用优化引擎在新 fc 约束（50~80 kHz）+ 新评分口径（加入 D4 平坦度、D6 噪声）下重新求解**，不得直接沿用旧参数。

## 7. 验证方法（LTspice 复测清单）

每个候选方案必须通过以下全部仿真，脚本化、可复现、可分发。**每个评分维度至少有一项仿真覆盖**（对照表右侧）：

| # | 仿真 | 类型 | 目的 | 覆盖维度 |
|---|---|---|---|---|
| V1 | 标称 AC 差分 | .ac | 差分衰减 @fMOD/MCLK、通带平坦度、群延迟 | D1 / D3 / D4 / D10 |
| V2 | 标称 AC 共模 | .ac | 共模衰减 @fMOD | D2 |
| V3 | 失配角 AC 共模 | .ac（两线阶梯 1% 失配） | CMRR @通带 | D8 |
| V4 | 最坏角瞬态建立 | .tran（R/C 容差角 + 600 kΩ 高源阻抗工况） | 建立时间 | D5 |
| V5 | 蒙特卡洛 AC 30 次 | .ac（R/C 容差随机） | 通带增益离散 σ_ΔG | D7 |
| V6 | 蒙特卡洛瞬态 30 次 | .tran（R/C 容差随机） | 建立时间统计稳健性 | D5 补充 |
| V7 | 噪声 | .noise + 积分 0.1 Hz~fMOD/2 | 积分噪声 | D6 |
| V8 | Kickback 回稳 | .tran + ADC 采样开关模型（参数来自 M2/M6） | fMOD 半周期内回稳判定 | D9 |
| V9 | 真实 OPA388 模型 | 替换理想源后重跑 V1/V2/V4/V7 | 跟随器非理想性影响（GBW、输出阻抗随频率） | 全部交叉验证 |

**维度-仿真覆盖矩阵自检**：D1→V1，D2→V2，D3→V1，D4→V1，D5→V4+V6，D6→V7，D7→V5，D8→V3，D9→V8，D10→V1。十维全覆盖，无遗漏。

**ADC 采样开关模型（V8）构建规范**：采样电容 C_s 与开关电阻 R_sw 取自手册（M2/M6）；开关以 fMOD 频率、手册给定的采样占空比通断；判稳窗口 = fMOD 半周期（@4.096 MHz = 122 ns）；判据 = 回稳到稳态值 0.01% 带内。若手册未给 R_sw/时序，用 LTspice 默认开关（Ron=1 Ω）+ C_s 建模，并在报告中明示假设。

**模型要求**：V9 必须使用 TI 官方 OPA388 SPICE 模型（非理想压控源），以捕捉 GBW=10 MHz 在通带/阻带交界处的二阶效应。

## 8. 理论交叉验证

LTspice 结果必须与理论引擎（`hardware/sim/aaf/opt_engine.py`，模态分解 + MNA）交叉比对：

- AC 衰减偏差 ≤0.5 dB
- 建立时间偏差 ≤5%
- 超出偏差时，以 LTspice 为准并修正理论引擎（历史偏差：≤0.2 dB / ~1.5%）

## 9. 交付物清单

| # | 交付物 | 路径 |
|---|---|---|
| 1 | 本规格文档（含实现计划，2026-10-24 合一） | `docs/design/spec/2026-10-18-aa-driver.md` |
| 2 | 优化引擎（新 fc + 新评分） | `hardware/sim/aaf/opt_round5.py` |
| 3 | 三案 LTspice 网表 + .asc | `hardware/sim/aaf/r5_{A,B,C}_*.{net,asc}` |
| 4 | 复测报告（含 **D1–D10 十维评分表** + 每维对应仿真数据 + CH1/CH2 群延迟差专项数据） | `hardware/sim/aaf/r5_report.md` |
| 5 | 三案图纸 SVG + PNG | `hardware/sim/aaf/图纸_r5_{A,B,C}_抗混叠.{svg,png}` |
| 6 | **BOM 可购性核查表**（所有阻值/容值 → E24/E96 标准档映射 + C0G/薄膜介质标注 + >47 nF 电容的 SRF 核查结论） | `hardware/sim/aaf/r5_bom_check.md` |
| 7 | 定稿后同步 | `docs/design/diagram/抗混叠滤波电路.svg` + E.4 文档 + 采集页原理图 |

## 10. 分发说明（给子代理/其他模型）

本文档自足，可整包分发。执行者需要：

1. **环境**：Windows + LTspice 24.1（`C:\Users\chenx\AppData\Local\Programs\ADI\LTspice\LTspice.exe`），命令行批处理 `LTspice.exe -b -ascii <file.net>`；Python 3 + numpy/scipy。
2. **输入**：本规格 + `hardware/sim/aaf/opt_engine.py`（理论引擎）+ TI OPA388 SPICE 模型（需自行从 TI 官网下载，不入库）。
3. **流程**：查手册填 M1-M7 → 运行 opt_round5 求三案参数 → 生成网表 → 跑 V1-V9 → 按 §5 评分 → 产出 r5_report + r5_bom_check。
4. **禁区**：不得修改附录 E 已定稿决策；不得引入本规格未列的新器件（新器件需用户批准）；不得凭记忆填写手册值。
5. **输出判据**：三案评分表 + 推荐方案 + 全部原始 .raw/.log 文件。

## 11. 未决事项（需用户在迭代中决定）

| # | 事项 | 影响 |
|---|---|---|
| U1 | 正弦激励源设计（产生 16 kHz 正弦的电路） | 不在本段范围，属 E.2/E.3 扩展 |
| U2 | 扫频模式下的数字域处理（幅值/相位提取算法） | 上位机/固件，不影响模拟设计 |
| U3 | 若复测发现 D4 与 D1 强冲突（fc 抬高导致 D1 不及格），是否接受四级方案或回压频率上限 | 决策点 |
| U4 | ~~扫频是否测相位~~ **已定：测相位（复阻抗谱），D10 为正式维度**（用户 2026-10-18） | 已销号 |

---

**版本历史**：
- v1 (2026-10-18) 首版，基于前六轮 AA 仿真战役结论 + 用户确认的 16 kHz 扫频需求。
- v2 (2026-10-18) 评分维度 6→10（新增 D7 容差敏感度、D8 CMRR@通带、D9 Kickback、D10 群延迟）；C1 器件数改软参考、C3 放宽至 100 nF（附 SRF 核查）；测量范围按 E.3.4 精确化（比值机制 215 kΩ→600 kΩ）；D10 定级为正式维度（用户确认测相位）。
- v3 (2026-10-18) 疏漏修复：新增标准测试条件表（共模电平/激励/源阻抗/温度/高阻工况、LSB 定义）；验证清单 V1-V7→V1-V9（每维度全覆盖 + 覆盖矩阵自检）；ADC 采样开关模型构建规范；M 项扩至 M7（开关电阻时序、OPA388 输出阻抗）；新增 BOM 可购性核查交付物；修复 §6 定档原则残留旧表述。
- v4 (2026-10-19) **R5 两轮迭代后的规格修订（用户裁决）**：① D6 拆分为 D6a（无源网络噪声增量 ≤10%/30%，硬指标）+ D6b（总噪声软参考，砖墙极限 4.3 LSB）——原 1 LSB 阈值与 D4 物理冲突 16.5 倍；② D8 考核条件改为 R·C 乘积异向配对（1% 单体 → 110+ dB，同向失配物理上限仅 48-49 dB）；③ 评分主口径改为真实 OPA388 模型（0Ω 理想源在 fMOD 偏差 16-22 dB）；④ 新增硬约束 C9（peaking ≤6 dB，防 OPA388 输出阻抗负实部引发的有源谐振）；⑤ M1-M7 全部核实回填（手册号勘误：ADS131A02 是 SBAS590E 非 SBAS890）。
- v4 (2026-10-18) **M1–M7 手册核实完成**（证据链见 `hardware/sim/aaf/r5_datasheet_facts.md`）：ADS131A02 文献号勘误 **SBAS890→SBAS590E**（SBAS890 实为 ADS131M04）；填实 sinc³ −3 dB ≈33.5 kHz、C_S=3.5 pF、Z_IN=130 kΩ、fMOD=4.096 MHz（须显式写 CLK_DIV/ICLK_DIV/OSR）、S1/S2 50% 反相、OPA388 A_OL@4.096 MHz≈7.0 dB、Z_O,cl≈34 Ω；并标注 R_on/孔径/闭环 Z_O 三项**手册无值**。**冲突判据双否**（fMOD 一致、sinc³ 偏差 <1%）。§5.3 加"D4 口径边界"提醒（模拟段不含 sinc³；sinc³ 16 kHz 固有 −0.67 dB）。

---

## 12 实现计划（Round 5，2026-10-24 并入本文件）

> **For agentic workers:** REQUIRED SUB-SKILL: Use superpowers:subagent-driven-development (recommended) or superpowers:executing-plans to implement this plan task-by-task. Steps use checkbox (`- [ ]`) syntax for tracking.

**Goal:** 按规格文档 v3 完成抗混叠采集子系统的三案参数求解、LTspice 十维评分复测、图纸产出，为用户定档决策提供完整数据包。

**Architecture:** 理论引擎（模态分解 + MNA，已有 `opt_engine.py`）在新约束下求解三案参数 → LTspice 批处理复测（V1–V9）→ 十维评分表 + 图纸。理论预测与 LTspice 实测双向交叉验证，偏差点亮即停。

**Tech Stack:** Python 3 + numpy/scipy（优化与解析）、LTspice 24.1 命令行批处理（`-b -ascii`）、cairosvg（图纸渲染）、`tools/svg_schematic_check.py`（图纸门禁）。

**Spec:** 即本文件 §1–§11（设计与计划合一后单文件分发）

### Global Constraints

- 抗混叠锚点 **fMOD = 4.096 MHz**（M5 核实后以此为准），MCLK = 16.384 MHz
- 扫频上限 16 kHz（每周期 8 点 @128 kSPS）；精密区 ≤8 kHz；**测相位**（D10 正式维度）
- 模拟 fc 目标区间 50~80 kHz；四线统一全配（含 AIN1N）
- 跟随器只当缓冲不进反馈环路（OPA388 GBW=10 MHz 判死有源拓扑）
- 电容必须 C0G/NP0 或薄膜；单电容 ≤100 nF（>47 nF 须核 SRF>fMOD）
- 每线串联电阻总和 ≤5 kΩ；LSB = 291 nV（2×2.442/2²⁴）
- 标准测试条件表（共模 1V AC + 2.0V DC 偏置等，§5.1a 后）执行者不得改动
- **手册值纪律**：M1–M7 不查手册不得开跑；凭记忆填值 = 返工
- 文本 LF；仿真产物（.raw/.op.raw/.net）不入库；图纸 SVG 必须过门禁
- **锁屏风险**：LTspice `-b` 对 `.net` 可直接跑；`.asc` 需要 GUI 会话解锁（历史教训：锁屏时 .asc 批处理挂死）。所有批处理一律走 `.net`

---

### Task 1: 手册核实 M1–M7 + 更新规格锚点

**Files:**
- Modify: `docs/design/spec/2026-10-18-aa-driver.md`（§5.3 表填入实测值）
- Create: `hardware/sim/aaf/r5_datasheet_facts.md`

**Interfaces:**
- Produces: `FACTS` 字典（后续所有任务的脚本 import 此文件的数据）——
  `FMOD_HZ, MCLK_HZ, SINC3_F3DB_HZ, ADC_CS_PF, ADC_RSW_OHM, ADC_SW_DUTY, OPA388_AOL_4M_DB, OPA388_ZOUT_CURVE_REF`

- [ ] **Step 1: 查 ADS131A02 手册（SBAS890）填 M1/M2/M3/M5/M6**

  需查：sinc³ −3 dB 频率 @OSR=32（滤波器响应图）；输入采样电容（输入结构节）；输入电流/阻抗；fMOD = fCLKIN/4 还是 /8；开关等效电阻与时序。手册在 Obsidian `20-硬件工程/datasheets/`（若缺，从 TI 官网下载放 Obsidian，**不入库**）。

- [ ] **Step 2: 查 OPA388 手册（SBOS777）填 M4/M7**

  AOL @4 MHz（验证 GBW=10 MHz 近似）；闭环输出阻抗随频率曲线（记下参考图号）。

- [ ] **Step 3: 写 `r5_datasheet_facts.md`**

  格式：每项一行 = 值 + 手册页码/图号 + 与规格推算值的偏差（如有）。同时把值填回规格文档 §5.3 表（标注"已核实"）。

- [ ] **Step 4: 冲突仲裁检查**

  若 fMOD ≠ 4.096 MHz 或 sinc³ −3 dB 与推算偏差 >20%，**停下报告用户**（阈值可能要改）；否则继续。

- [ ] **Step 5: Commit**

```bash
git add docs/design/spec/2026-10-18-aa-driver.md hardware/sim/aaf/r5_datasheet_facts.md
git commit -m "docs(sim): M1-M7手册核实值回填规格锚点"
```

---

### Task 2: 优化引擎升级（opt_round5.py）

**Files:**
- Create: `hardware/sim/aaf/opt_round5.py`
- Modify: `hardware/sim/aaf/opt_engine.py`（仅在交叉验证发现 bug 时）
- Test: `hardware/sim/aaf/test_opt_round5.py`

**Interfaces:**
- Consumes: Task 1 的 `FACTS`；`opt_engine.ladder_matrices(stages, mode, tol_r, tol_c)`、`H()`、`settle_time()`（现有签名不变）
- Produces: `solve_candidate(n_stages: int, seed: int) -> dict`，返回 `{"stages": [(R_ohm, C_gnd_F, C_diff_F), ...], "pred": {"A_dm": dB, "A_cm": dB, "A_mclk": dB, "dG_16k": dB, "t_settle_wc_s": s, "group_delay_flat_s": s}}`

- [ ] **Step 1: 写失败测试（理论引擎自洽性）**

```python
# test_opt_round5.py
from opt_engine import ladder_matrices, H, settle_time
from opt_round5 import solve_candidate

def test_two_stage_solvable():
    r = solve_candidate(2, seed=0)
    assert len(r["stages"]) == 2
    # 通带平坦度必须达标（这是新约束下最容易崩的维度）
    assert r["pred"]["dG_16k"] <= 0.5

def test_engine_regression():
    # 旧参数回放：FIN1 二级在新引擎下预测值应与旧战役一致（±0.5 dB）
    from opt_engine import H
    h = H([(330, 47e-9, 47e-9), (2700, 6.8e-9, 5.6e-9)], mode="dm")
    import math
    assert abs(20*math.log10(abs(h(4.096e6))) - (-123.5)) < 0.5
```

- [ ] **Step 2: 跑测试确认失败**（`solve_candidate` 不存在）

- [ ] **Step 3: 实现 opt_round5.py**

  Nelder-Mead 多起点（沿用 opt_round4 框架），目标函数 = min(D1..D10) 的**理论预测版**（D6 噪声/D9 kickback 理论不可测，用代理：D6_proxy = 末级 R 约翰逊噪声积分；D9_proxy = 末级 τ 与 122 ns 之比）。硬约束：fc∈[50k,80k]（由 dG_16k≤0.5 dB 反推）、rsum≤5k、C≤100nF。
  **单位纪律**：`settle_time()` 返回秒，与 µs 预算比较前必须 `*1e6`（前战役踩过的坑）。

- [ ] **Step 4: 测试通过 + 三案求解**

  `solve_candidate(2)`, `(3)`, `(4)` 各跑多起点，打印帕累托前沿。

- [ ] **Step 5: Commit**

```bash
git add hardware/sim/aaf/opt_round5.py hardware/sim/aaf/test_opt_round5.py
git commit -m "feat(sim): round5优化引擎——新fc约束+十维理论预测"
```

---

### Task 3: E 系列取整 + 三案参数冻结

**Files:**
- Create: `hardware/sim/aaf/snap_round5.py`
- Create: `hardware/sim/aaf/r5_candidates.json`

**Interfaces:**
- Consumes: Task 2 `solve_candidate()`
- Produces: `r5_candidates.json` —— `{"A": {"stages": [...], "pred": {...}}, "B": {...}, "C": {...}}`（E24 电阻/E12 电容取整后，邻域枚举重评分后的冻结值）

- [ ] **Step 1: 写 snap_round5.py**（沿用 snap_round4 逻辑：E24/E12 取整 + 邻域 ±1 档枚举 + 理论重评分）

- [ ] **Step 2: 运行并生成 r5_candidates.json**，打印三案取整前后的理论评分对比（取整损失 >5% 的维度标红）

- [ ] **Step 3: 人工检查**：任一维度取整后跌破及格线 → 该档方案标记"取整后不及格"，报告用户（可能需要降档诉求或放宽约束）

- [ ] **Step 4: Commit**

```bash
git add hardware/sim/aaf/snap_round5.py hardware/sim/aaf/r5_candidates.json
git commit -m "feat(sim): 三案E系列取整与参数冻结"
```

---

### Task 4: LTspice 网表生成器（.net 直出）

**Files:**
- Create: `hardware/sim/aaf/gen_netlists_r5.py`
- Create: `hardware/sim/aaf/r5_{A,B,C}_{v1..v9}.net`（生成物，不入库——`.net` 已 gitignore；保留生成脚本即可复现）

**Interfaces:**
- Consumes: `r5_candidates.json`
- Produces: 九个仿真类型的网表模板函数 `gen_v1(cand)`, `gen_v2(cand)`, ... `gen_v9(cand)`，每个返回网表字符串

- [ ] **Step 1: 实现网表模板**

  关键拓扑（单通道差分对，两线对称）：
  ```
  * V1: AC 差分 —— VP/VN 源经阶梯到 AINP/AINN 探针
  V1 VP 0 AC 1 DC 2.0
  V2 VN 0 AC -1 DC 2.0
  R1a VP n1 {R1}  / C1a n1 0 {C1} / C1d n1 n2 {Cd1}（若有）
  ...逐级...
  ```
  V3（失配角）= 两线 R 值分别 ±1%。V5/V6 = `.step param` 或 Python 循环生成 30 个网表。V8 kickback = 开关模型：`S1 AINP 0 swp 0 SW` + `.model SW SW(Ron={RSW} ...)`，开关频率 fMOD、占空比按 M6。V9 = OPA388 子电路 `.include OPA388.lib`（TI 模型，执行者自行下载放入 `hardware/sim/aaf/lib/`，该目录 gitignore）。

- [ ] **Step 2: 冒烟测试**——生成方案 A 的 V1 网表，`LTspice.exe -b -ascii r5_A_v1.net`，确认 `.raw` 产出且 `.log` 无报错

- [ ] **Step 3: Commit**

```bash
git add hardware/sim/aaf/gen_netlists_r5.py
git commit -m "feat(sim): r5九类仿真网表生成器"
```

---

### Task 5: LTspice 批量复测 + 结果解析

**Files:**
- Create: `hardware/sim/aaf/run_r5.py`、`hardware/sim/aaf/parse_r5.py`
- Create: `hardware/sim/aaf/r5_results.json`

**Interfaces:**
- Consumes: Task 4 网表生成器
- Produces: `r5_results.json` —— 三案 × 九仿真 × 十维实测值

- [ ] **Step 1: run_r5.py**——遍历三案 × V1-V9，调 `LTspice.exe -b -ascii`（Windows 路径），超时 300 s/个；锁屏检测：先试跑一个 .net，若 60 s 无产出则中止并提示用户解锁

- [ ] **Step 2: parse_r5.py**——ASCII .raw 解析（复用 parse_and_plot.py 的头部/点索引处理）；提取十维值：AC 取 4.096M/16.384M/16k 频点、群延迟 = −d(phase)/dω、瞬态建立时间（0.01% 带）、噪声积分（trapz 电压噪声谱²）、kickback 判稳（122 ns 窗内 0.01% 带）

- [ ] **Step 3: 理论 vs LTspice 交叉验证**（规格 §8）——AC ≤0.5 dB、建立 ≤5%；超标 → 停，查引擎或模型，修后重跑

- [ ] **Step 4: 产出 r5_results.json + Commit**

```bash
git add hardware/sim/aaf/run_r5.py hardware/sim/aaf/parse_r5.py hardware/sim/aaf/r5_results.json
git commit -m "feat(sim): r5批量复测与十维实测数据"
```

---

### Task 6: 十维评分报告 + 图纸

**Files:**
- Create: `hardware/sim/aaf/score_r5.py`、`hardware/sim/aaf/r5_report.md`、`hardware/sim/aaf/r5_bom_check.md`
- Create: `hardware/sim/aaf/图纸_r5_{A,B,C}_抗混叠.svg` + `@2x.png`（复用 gen_schematics.py 框架）

**Interfaces:**
- Consumes: `r5_results.json`、`r5_candidates.json`
- Produces: 十维评分表（min 制总分 + 每维 LTspice 实测 vs 理论预测双列）、BOM 核查表、图纸

- [ ] **Step 1: score_r5.py**——按规格 §5.1 阈值逐项归一化，min 总分，排序

- [ ] **Step 2: r5_report.md**——评分表 + CH1/CH2 群延迟差专项 + 交叉验证偏差表 + 推荐结论（不预判，按分数说话）

- [ ] **Step 3: r5_bom_check.md**——每元件 E24/E96 档映射、介质、>47 nF 的 SRF 结论

- [ ] **Step 4: 图纸**——三案 SVG，`python tools/svg_schematic_check.py <svg>` 必须 PASS（exit=0），cairosvg 出 @2x.png，read_image 分区目视

- [ ] **Step 5: Commit**

```bash
git add hardware/sim/aaf/score_r5.py hardware/sim/aaf/r5_report.md hardware/sim/aaf/r5_bom_check.md hardware/sim/aaf/图纸_r5_*
git commit -m "feat(sim): r5十维评分报告+BOM核查+三案图纸"
```

---

### Task 7: 迭代回路（条件触发，最多 3 轮）

**触发条件**（Task 6 后检查）：
- 三案 min 总分全 <1.0 → 进入迭代：分析短板维度 → 调整约束（如 fc 区间、级数）→ 回 Task 2
- A 案及格 → 不迭代，直接推荐 A
- D4 与 D1 强冲突（fc 抬高后 D1 <80 dB）→ **触发规格 U3 决策点，停下问用户**：接受四级方案 or 回压频率上限

**每轮迭代**：只重跑受影响的任务（改约束 → Task 2 起；改参数 → Task 4 起），在 r5_report.md 追加迭代记录。

- [ ] **Step 1: 判定触发条件并向用户报告迭代必要性**
- [ ] **Step 2: 执行迭代（回相应 Task）**
- [ ] **Step 3: 追加迭代记录 + Commit**

---

### Task 8: 定稿同步（用户选定方案后）

**Files:**
- Modify: `docs/design/diagram/抗混叠滤波电路.svg`（更新为定稿参数）
- Modify: `docs/design/2026-10-10-universal-signal-chain.md` E.4 节
- EasyEDA 采集页原理图（替换旧 100Ω+2.7nF 网络；顺带修 C34→GND、C35→GND 两处已知错）

- [ ] **Step 1: 用户选定 A/B/C 后才启动本任务**
- [ ] **Step 2: 更新示意图 + 过门禁**
- [ ] **Step 3: E.4 文档同步**（新参数 + 十维评分结论摘要 + 定稿日期）
- [ ] **Step 4: EasyEDA 采集页更新**（经 bridge API；改前备份当前页网络清单，改后重跑并查集网表验证）
- [ ] **Step 5: Commit + push**

---

### 自审记录

- **规格覆盖**：M1-M7→Task 1；三案求解→Task 2/3；V1-V9→Task 4/5；十维评分→Task 6；交叉验证→Task 5 Step 3；BOM 核查→Task 6 Step 3；图纸→Task 6 Step 4；U3 决策点→Task 7；E.4/示意图/原理图同步→Task 8。全覆盖。
- **占位符扫描**：无 TBD/TODO；所有脚本步骤给出了关键实现要点或复用来源。
- **类型一致性**：`solve_candidate` 返回结构在 Task 2/3 一致；`FACTS` 键名在 Task 1 定义、Task 2 消费。
