chenxi-z/de-drms/docs/design/spec/2026-10-23-signal-chain-variants.md

# 信号链方案对比总表（新旧全部留档 · 2026-10-23）

- **作用域**：恒流源 / 跟随器 / 抗混叠滤波（AAF）三段的全部候选方案，供综合取舍
- **数据来源**：`hardware/sim/signalchain/`（工作流全链寻优 2026-10-22）+ `hardware/sim/signalchain/aaf_first_order/`（一阶补充实测 2026-10-23）；数值全部 ltspice-sim 实测，未测项如实标注
- **图纸索引**（`docs/design/diagram/`，新旧并存互不覆盖）：

| 文件 | 方案 | 状态 |
| --- | --- | --- |
| `抗混叠滤波电路.svg` | lad4r 四级（R1A=10 Ω 整链落地） | **定案** |
| `抗混叠滤波电路_k3b三级.svg` | k3b 三级 FIN | BOM 简化备选 |
| `抗混叠滤波电路_一阶.svg` | 一阶（47 Ω+47 nF+Cd 820 p） | 布局最紧凑档 |
| `一阶方案影响对比.svg` | 四案实测衰减伯德图 + 实测值表/图注（SCI 版式；B 案曲线来源勘误为 `baseline_aaf/aaf_b_ac_dm.raw`，−84.6/−132.6 dB 与锚定值一致） | 选型参考 |
| `抗混叠滤波电路_旧B案三级.svg` | B 案三级（旧定版） | 零改动回退档 |
| `恒流源电路图.svg` | C3 整合终案（双档） | **定案** |
| `恒流源电路图_旧版单档.svg` | 旧版单档（Cf 1 n 单档） | 留档对照 |
| `模拟前端与自校准.svg` | v4（C3 双档 + Cff + AAF lad4r） | **定案** |
| `模拟前端与自校准_旧版v3.svg` | 旧版 v3 | 留档对照 |
| `整体方案框图.svg` / `电源树.svg` / `两电极四线制接法.svg` / `四线制前端接法.svg` | 系统级框图 | 同规格重绘 |

> **图纸规格（2026-10-23 统一）**：`docs/design/diagram/` 下全部图为 800×800 视图框（A4 单栏幅面），
> 西文 Times New Roman + 中文 Noto Serif CJK SC（按字符脚本拆 run），字号下限 11 pt；
> 生成器在 `docs/design/diagram/_lib/`（`scistyle.py` 公共排版 + 每图一个 `gen_*.py`）。
> 交付前跑 `python3 tools/svg_schematic_check.py <svg>`，必须 PASS。

---

## 一、AAF 四案对比（每通道对口径；十维阈值：D1≥80 / D2≥60 / D3≥100 dB、D4≤0.5 dB）

| 指标 | **lad4r 四级（定案）** | k3b 三级 FIN | 一阶 FO1 | B 案三级（旧） |
| --- | --- | --- | --- | --- |
| 拓扑/线 | 10+4.3+8.2+45.3 Ω / 33+33+33+22 nF + Cd 820 p | 7.5+6.04+13.7 Ω / 82+56+22 nF + Cd 12 n | 47 Ω+47 nF + Cd 820 p | 6.19+6.04+13.7 Ω / 68+68+27 nF + Cd 12 n |
| 件/通道对 | 17 | 13 | **5** | 13 |
| D1 DM@fMOD | **91.3 dB** | 83.9 dB | ❌ −40.7 dB | 84.6 dB |
| D2 CM@fMOD | **90.7 dB** | 77.6 dB | ❌ −46.4 dB | 79.2 dB |
| D3 DM@MCLK | 149.9 dB | 131.7 dB | ❌ −62.7 dB | 132.6 dB |
| D4 @16 kHz | 0.195 dB | 0.190 dB | **0.230 dB** | 0.185 dB |
| D5 建立(0.01%) | 29.1 µs | 28.4 µs | **≈21 µs** | 30.1 µs |
| 环路 PM | 59.4°（72.3°@整链 10 Ω） | 57.0° | **98.6°** | 49.9° |
| C9 peaking | 4.67 dB（wc） | **4.85 dB（wc，余 1.15）** | +1.4 dB | 5.77 dB（wc 贴线） |
| D8 CMRR(配对) | 92.1 dB | 95.4 dB | 免配对（单级） | 95.5 dB |
| fc | 74.6 kHz | 78.4 kHz（贴窗沿） | 72.3 kHz | 80.0 kHz（贴窗沿） |
| 十维 min 分 | **0.679–0.725** | 0.688 | 不适用（D1–D3 不过） | 0.700 |

### AAF 各案优缺点

**lad4r 四级（定案）**——`抗混叠滤波电路.svg`
- ✅ 唯一 D1/D2/D3 三项衰减都有 ≥10 dB 实裕量的档；PM/C9/fc 三项同步有余量；短板 D4 仍远过线
- ✅ 低阻节点堆级法：单级 RC ≈0.3–1 µs 无慢极点尾，建立反而比三级快
- ❌ 17 件/通道对最多；−120 dB 以下衰减受 PCB 寄生地板（~0.1 pF 级）限制属纸面冗余
- ❌ 需 R·C 乘积配对工序（不配对 CMRR 掉到 ~46 dB）

**k3b 三级 FIN**——`抗混叠滤波电路_k3b三级.svg`
- ✅ 件数 13（比定案少 4 件/通道）；C9 余量全场最好；配对 CMRR 95.4 略高
- ❌ D1 83.9 dB 裕量薄（余 3.9）；R−1%/C−5% 负角 fc 出窗 3.6%
- ❌ C1=82 nF SRF 未核——须改 0603 或 10n∥68n 后才能进 BOM

**一阶 FO1（47 Ω+47 nF+Cd 820 p）**——`抗混叠滤波电路_一阶.svg`
- ✅ **5 件/通道对，布局面积约 1/3**；建立 21 µs 最快；PM 98.6° 最厚；C9 仅 +1.4 dB；ΣR 47 Ω 噪声最低；免配对
- ✅ D4 0.230 dB 与定案相当——16 kHz 扫频幅相仍可用
- ❌ **D1/D2/D3 三项衰减全不过线**（−40.7/−46.4/−62.7 dB）：fMOD 折叠带防护只剩 sinc³ 一层
- ❌ 一阶物理天花板 ≈−45 dB：Cd 加到 12 n（FO1c）仅 −44 dB 且 D4 恶化到 0.469；22 Ω+100 nF（FO3）−44.3 dB 触容值上限
- 适用：准静态/低频测量 + 布局极端受限；不适用于 16 kHz 扫频混叠环境苛刻或 MCLK 泄漏敏感场合

**B 案三级（旧）**——`抗混叠滤波电路_旧B案三级.svg`
- ✅ 零改动回退（已冻结、有 R5 全套历史数据）；D4 0.185 最优
- ❌ PM 49.9° 最低、C9wc 5.77 dB 贴线（余 0.23）；fc 80.0 kHz 贴窗沿
- ❌ 被 lad4r 在衰减/稳定性两方向同时超越，无独立优势位

## 二、恒流源三案对比

| 指标 | **C3 整合终案（定案）** | C1/B′ 快建立 | 基线+P4（旧定稿） |
| --- | --- | --- | --- |
| 变化点 | Cf 100 p+1n 占位、Rx=20 k 双档、M2 nmosw | Cf 1n→100 p | Cf=Cg=1 n（原值）+ nmosw 勘误 |
| 电流 | 7.86 / 1.06 µA 双档 | 7.86 µA | 7.86 µA |
| 使能建立 | **0.093 ms**（10.8× 余量） | 0.092 ms | 0.89 ms（吃预算 89%） |
| 环路 PM | 66.9–79.8°（288 步） | 61.7–81.9° | 68.7° |
| 量程 | 高档 215 k / 低档 ≈2.31 MΩ | 215 k | 215 k |
| 关断残流 | 0.195 nA typ（≤0.6 max-Rds） | 同 | 0.195 nA（P4 勘误后） |

- **C3（定案）**：✅ 能力超集 + 全门禁过线；❌ 代价项 PSRR 6.3×/噪声 2.9×（比值抵消，仍 ≪ADC 底噪）、新增 RNG 开关与固件互锁、低档 fs6 台架须按 Rx=20 k 重跑（挂账 B2）
- **C1/B′**：✅ 快建立与 C3 同源（是其子集）；❌ 无双档
- **基线+P4**：✅ PSRR/噪声最优、结构最简（零新增件）；❌ 使能 0.89 ms 吃掉换路预算 89%，nmosb 旧宏残流 2.07%FS 数据作废（P4 勘误）

## 三、跟随器三案对比（R1 = AAF 首级电阻，兼任容性负载隔离）

| 指标 | **R1=10 Ω+C1=68 nF（定案档）** | R1=10 Ω+C1=47 nF | R1=8.25 Ω+Ccomp 15 pF |
| --- | --- | --- | --- |
| PMmin | 51.0° | 52.5° | **57.6°** |
| C9 | 3.21 dB | 3.06 dB | 3.54 dB |
| D1 / D4 | 85.1 / 0.313 dB | 82.0 / 0.282 dB | 未补测（须联动改 AAF） |
| 噪声 | 基准 | 同 | 降 10–43% |
| 附注 | 68 nF SRF 已核（0603） | 免 SRF | 600 k 档带宽收窄 13 kHz；漏贴 Ccomp 则 42.4° FAIL |

- 三案全过门；基线 6.19 Ω **出局**（PMmin 30.25° FAIL + C9 5.82 dB 贴线）——R1=10 Ω 是必须的 PM 门修复
- 47 n/68 n 之争在整链定案（lad4r C1=33 nF）形态下自动消解；三级回退形态默认 68 nF、免-SRF 互换 47 nF
- 8.25 Ω+Ccomp 仅作 PM 厚化 fallback，须与 AAF R1 联动改值 + 补测 D1/D4

## 四、选择指引（综合考虑速查）

| 场景 | 推荐 |
| --- | --- |
| 全指标求稳（默认） | **lad4r 四级 + C3 双档 + R1=10 Ω**（当前定案） |
| BOM/布局求简、接受衰减裕量变薄 | k3b 三级（先清 82 nF SRF 与负角 fc 两条） |
| 布局极端受限 / 纯准静态低频 | **一阶 FO1**（接受 D1–D3 不过线，靠 sinc³+窄带宽兜底） |
| 只想不动已冻结设计 | B 案三级零改动回退 |

## 五、未测/挂账项（如实声明）

- 一阶：D7 蒙特卡洛 / D9 kickback / D10 群延迟未专项实测（预期宽松，未验证）；噪声仅解析估算
- k3b：82 nF SRF 未核；负角 fc 出窗 3.6% 容差策略未定
- 全部方案：PCB 寄生提取未做（−120 dB 以下无意义）；温度全角仅 AAF 通带项
- 挂账总表见 `hardware/sim/signalchain/REPORT.md` §5（B 组：低档 fs6 重跑、残流口径统一、C3 PSRR/噪声复测、Cff 回填 E.3.2 等）

---
**版本**：v1（2026-10-23）；一阶台架与代码：`hardware/sim/signalchain/aaf_first_order/gen_fo.py`、`fo_results.json`
