chenxi-z/de-drms/hardware/sim/aaf/r5_report_r4.md

# Round 5 第 4 轮（定档轮）评分报告 —— B 案（C9 修复后）vs C 案（对照）

- **日期**：2026-10-19
- **评分依据**：`docs/design/spec/2026-10-18-aa-driver-design.md` **v4 §5.1**
  （`总分 = min(D1..D5, D6a, D7..D10)`，**D6b 仅报告**；**D8 统一按正文 1 % 单体 + R·C 乘积异向配对**）
- **用户裁决**：B 案（三级）为定档基线，C 案仅作对照
- **评分脚本**：`hardware/sim/aaf/score_r5_r4.py`（本报告全部评分数字由该脚本输出，
  机器可读副本 `r5_scores_r4.json`）
- **输入**：
  - B：`r5_results_r4_B.json`（C9 修复后参数 `6.19 / 6.04 / 13.7 Ω × 68 / 68 / 27 nF + C_diff 12 nF`，
    全部 V1–V9 用真实 OPA388 模型实测）
  - C：`r5_results_r3_C.json`（第 3 轮实测）+ `r5_results_r4_C_d8fix.json`（本轮 D8 真实模型
    1 % 配对补测）
- **复现**：`cd hardware/sim/aaf && python score_r5_r4.py`

---

## 0. 结论摘要

| 项 | 结论 |
|---|---|
| **B 案是否全维过线（min ≥ 1.0）可定档？** | **否。** B 案十维**及格线全过**（无一越线）、C9 / D5 硬门槛全过，但 **min = 0.700284 < 1.0**，短板 **D4 通带平坦度 0.1849 dB**（满分线 0.05 dB）。按"min ≥ 1.0"这一条**尚不可定档**。 |
| **D4 为什么到不了 1.0** | 单极点估算下 D4 ≤0.05 dB 要求 **fc ≥ 148.7 kHz**；本轮做 D1↔D4 前沿扫描（`r5_r4_d1d4_frontier.json` + LTspice 抽验）：**B 拓扑在均匀 R 缩放下 kR = 1.0 就是最优**（LTspice 实测 min(D1,D4) = 0.7003；引擎 0.7001），任何缩放都让 min 下降（kR=0.8 → 0.673，kR=1.2 → 0.525）；**LTspice 实测把 D4 压到 0.0479 dB 需 kR≈0.5，此时 D1 只有 72.86 dB（远低于 80 dB 及格线）** → **D4 满分与本拓扑的 D1 及格不可兼得**，与 §5.1b "D6 的 1 LSB 物理不可达"属同一类问题，需规格裁决（放宽/拆分/改 fc 窗口）。 |
| **C9 修复是否成功** | **成功。** 跟随器节点 peaking **10.66 → 4.768 dB**（限 6 dB）；**含源阻抗扫描**后最坏点 **60 kΩ → 5.817 dB**，含 R−1 %/C+5 % 容差角 **5.883 dB** → 余量只剩 **0.117～0.183 dB**（见 §2，这一条必须在规格里写清考核节点与源阻抗口径）。 |
| **D5 中间阻抗是否建立** | **B 案：建立。** 73 Ω / 1 k / 10 k / 20 k / 30 k / 40 k / 50 k / 60 k / 80 k / 100 k / 150 k / 220 k / 300 k / 400 k / 500 k / 600 k Ω **共 16 点全部回稳**（建立时间 18.9–30.4 µs；300 kΩ 的 18.91 µs 与 400 kΩ 的 23.33 µs 反而比 150 kΩ 的 30.36 µs 更快，**原因未单独归因**，但所有点都远低于 500 µs），最坏角另加 5 点。第 3 轮的 50–220 kΩ 极限环**在冻结参数下完全消失**。 |
| **第 3 轮那个振荡是真实的还是伪影** | **真实机理（宏模型大信号极限环），不是数值伪影**——正对照（旧参数 100 kΩ）三套数值设置给 498.9 / 523.9 / 499.3 mV（同量级），本轮新参数五档三设置逐窗一致且单调衰减（见 §3.3）。 |
| **C 案对照结论** | C 案 min = 0.710203（略高于 B），但它的 **D5 = 89.87 µs 只在 600 kΩ 一点成立**：本轮补测的 **0 / 10 k / 30 k / 50 k / 73 k / 100 k / 150 k / 220 k / 300 k / 320 k / 350 k / 370 k / 390 k / 400 k / 410 k Ω 共 15 个采样点全部等幅极限环**（尾窗 0.20–0.79 Vpp），**430 kΩ 起 6 个采样点（430/450/500/550/580/600 k）才回稳**。按全量程口径 D5 应记 0 → **C 不可用**。 |
| **D8 口径修正** | C 案第 3 轮的 135.474 dB 是"0.1 % 配对 + 0 Ω 理想源"；统一到 **1 % 配对 + 真实 OPA388** 后 = **95.524 dB**（与 B 的 95.515 dB 持平）。修正**不改变总分**（两案短板都是 D4），但**消除了跨案不可比**。 |

> **一句话**：B 案在"及格线"意义上是干净的——十维全过、C9 与 D5 全量程成立；
> 但按规格 v4 §5.1 的 min 短板制，**B = 0.700 / C = 0.710**，两案都被 **D4 的 0.05 dB 满分线**卡住，
> **没有方案达到 min = 1.0**。

### 0.1 为什么"min ≥ 1.0"在本规格下对 B 案不可达（不只是 D4 的问题）

B 案的十维按分数升序排列：

| 排序 | 维度 | 分数 | 达标所需 | 现实测 | 距离 |
|---|---|---|---|---|---|
| 1 | **D4** | **0.7003** | ≤0.05 dB | 0.1849 dB | 差 0.135 dB |
| 2 | **D1** | **0.7054** | ≥120 dB | 84.64 dB | 差 35.36 dB |
| 3 | D2 | 0.7917 | ≥100 dB | 79.17 dB | 差 20.83 dB |
| 4 | D3 | 0.8838 | ≥150 dB | 132.56 dB | 差 17.44 dB |
| 5 | D8 | 0.9551 | ≥100 dB | 95.51 dB | 差 4.49 dB |
| 6–10 | D5/D6a/D7/D9/D10 | 1.0000 | — | — | 0 |

→ **即使把 D4 的满分线放宽到 0.20 dB（B 的 D4 直接拿 1.0），min 也只会升到 0.7054
（D1 成为新短板）**，仍然远不到 1.0。

要让 B 达到 min = 1.0，必须**同时**满足 D1 ≥120 dB、D2 ≥100 dB、D3 ≥150 dB、D4 ≤0.05 dB
（D8 ≥100 dB 可以通过更紧的配对实现：0.5 % 单体配对已达 108.8 dB）。
**而 D1/D2/D3 与 D4 是同一个 fc 的两端**：D1 再增 35 dB（120−84.64）对三阶滚降
（≈60 dB/decade）要求 fc 再降 ×10^(35/60) ≈ 3.8 倍 → fc ≈ 21 kHz，
此时 D4 = 10·log10(1+(16/21)²) ≈ **2.0 dB**（越 0.5 dB 及格线 4 倍）。
→ **三阶无源 RC 拓扑在 D1/D2/D3 与 D4 之间存在硬冲突，min = 1.0 不可达。**

**结论必须说清两点**：
1. **D4 是 B 案当前的第一短板**（0.7003），但它只是"第一个卡点"；
2. **即使放宽 D4，min 也只到 0.7054（D1）**。要在 min 短板制下给出 1.0，规格层须同时处理
   **D1/D2/D3 的满分阈值**（现为 120/100/150 dB，对三阶+80 kHz fc 结构性偏高），
   或改判为"**及格线制 + 关键项加权**"（十维全过即定档，与用户 2026-10-18 的"短板即淘汰"意图一致）。

---

## 1. B 案十槽位评分表（C9 修复后参数）

**参数**（`r5_candidates_final_B.json` / `r5_results_r4_B.json:5-21`）：
`R = 6.19 / 6.04 / 13.7 Ω`（E96），`C_gnd = 68 / 68 / 27 nF`（E12，C0G），`C_diff = 12 nF`，
13 件/通道，ΣR = **25.93 Ω**，单电容最大 **68 nF**，fc = **79.95 kHz**。

| # | 维度 | 实测 | 单位 | 归一化 | S | 及格线 | 判定 | 到满分还差 |
|---|---|---|---|---|---|---|---|---|
| D1 | DM 衰减 @fMOD 4.096 MHz | **84.6434** | dB | min(84.643/120,1) | **0.7054** | ≥80 | ✓ | 35.36 dB |
| D2 | CM 衰减 @fMOD | **79.1744** | dB | min(79.174/100,1) | **0.7917** | ≥60 | ✓ | 20.83 dB |
| D3 | DM 衰减 @MCLK 16.384 MHz | **132.5645** | dB | min(132.564/150,1) | **0.8838** | ≥100 | ✓ | 17.44 dB |
| D4 | 通带平坦度 @16 kHz | **0.1849** | dB | 1−(0.1849−0.05)/0.45 | **0.7003** | ≤0.5 | ✓ | **0.1349 dB** |
| D5 | 建立时间（最坏角） | **30.0885** | µs | min(500/30.09,1) | **1.0000** | ≤900 | ✓ | 0 |
| D6a | 无源网络噪声增量 | **0.6381** | % | min(10/0.638,1) | **1.0000** | ≤30 | ✓ | 0 |
| D7 | σ(ΔG@16 kHz) | **0.003990** | dB | ≤0.01 → 1 | **1.0000** | ≤0.05 | ✓ | 0 |
| D8 | CMRR @通带（1 % 配对） | **95.5147** | dB | min(95.515/100,1) | **0.9551** | ≥80 | ✓ | 4.49 dB |
| D9 | Kickback 回稳 | **1.0** | 二值 | 回稳 → 1 | **1.0000** | 回稳 | ✓ | 0 |
| D10 | 群延迟平坦度 0.1 Hz–16 kHz | **0.09036** | µs | ≤1 → 1 | **1.0000** | ≤5 | ✓ | 0 |
| — | **总分 = min** | — | — | — | **0.700284** | — | **十维全过** | — |
| *D6b* | *总积分噪声（仅报告）* | *12.037* | *LSB* | — | — | — | — | *砖墙 4.30 LSB* |

**硬约束（§5.2，不进 min）**

| # | 约束 | 实测 | 限值 | 判定 |
|---|---|---|---|---|
| C2 | ΣR | 25.93 Ω | ≤5 kΩ | ✓（余量 193×） |
| C3 | 单电容最大值 | 68 nF | ≤100 nF | ✓ |
| C4 | 介质 | 全 C0G/NP0 | 必须 | ✓（可满足） |
| C5 | 两线 R·C 乘积配对 | 1 % 配对 95.51 dB / 同向 1 % 48.34 dB | 须配对 | ✓（工序见 BOM §5） |
| C9 | 有源谐振（跟随器节点） | **4.768 dB** @278.6 kHz（源阻抗扫描最坏 5.817 dB @60 kΩ） | ≤6 dB | ✓（余量 1.23 / 0.18 dB，见 §2） |

**数据审计（本轮实跑）**

| 项 | 结果 |
|---|---|
| `.raw` 反算 D1/D2/D3/D4/D8/D10 | `score_r5_r4.py --json` 输出：6 项的**最大绝对偏差 = 3.21e-04**（B）→ JSON 转录无错 |
| D8 同向 1 % 复算 | 48.341 dB（`r5_work/r4_B/r5_B_r4_v3s010.raw` 重算）vs JSON 的 48.338 dB，**差 0.003 dB**（两个解析器的实现细节差异，**未逐行定位原因**；对评分无影响） |
| D5 独立复算 | `parse_r5.settle_us`（200 µV 带）逐档复算，与 JSON `d5_by_source` 一致；另用尾窗 pp 复核五档 ≤0.013 µV |
| D6a 口径 | 记分用**线性口径** `(V_tot−V_nl)/V_nl = 0.638 %`（规格字面）；正交口径 11.315 % 一并披露（若改用正交，D6a 分 10/11.315 = 0.884，仍不是短板） |

---

## 2. C9 peaking 前后对比

### 2.1 节点口径（第 3 轮已定，本轮沿用）

C9 的物理机理是「OPA388 闭环输出阻抗中频**负实部** × 首级阶梯电容」，谐振发生在
**被驱动节点（跟随器输出）**；ADC 引脚处被末级 RC 压平（引脚 DM 峰值 ≈ 0.0000 dB）。
**本报告按跟随器节点考核**，并同时给出引脚值。

### 2.2 修复前后（同工况：Rs = 0，AC DM，真实 OPA388）

| 参数 | 首级 R1 | 首级 C1 | 跟随器节点峰 | 引脚 DM 峰 | C9 判定 |
|---|---|---|---|---|---|
| 第 3 轮冻结（`r5_corr_r4.json` 的 `rs=0`） | **2.74 Ω** | 68 nF | **+10.660 dB** @289.7 kHz | 0.00 dB | **超限 4.66 dB** |
| **本轮冻结** | **6.19 Ω** | 68 nF | **+4.768 dB** @278.6 kHz | −0.0000 dB | **通过（余量 1.23 dB）** |
| 对照：R1 = 7.5 Ω（C1 56 nF，保 R1C1） | 7.5 Ω | 56.0 nF | 4.405 dB | — | 通过，但 D4 0.2142 dB、D1 83.16 dB → min 掉到 0.635（**不建议**） |

- **降幅**：10.660 → 4.768 dB（**−5.89 dB**），首级极点从 854 kHz（旧 1/(2πR1C1)）
  移到 378 kHz（`r5_d5_discrim_r4_B.json:poles`）。
- 机理：Q ≈ \|Re(Z_o,cl)\| / R_series。R1 从 2.74 → 6.19 Ω 把 Q 压到 1 以下。
- **修复的副作用**（`r5_report_r4_c9fix.md` §4 已记录；该文件是上一轮"B 案 C9 修复 + D5 极限环机理研判"报告的存档，本轮报告占用 `r5_report_r4.md` 这个路径）：D1 86.49 → 84.64（−1.85）、D2 83.40 → 79.17（−4.23）、
  D4 0.1876 → 0.1849（略好）、D6b 13.91 → 12.04 LSB（改善）、D10 0.0959 → 0.0904（改善）。
  **无任何维度跌破及格线。**

### 2.3 源阻抗扫描（本轮新增，C9 的实测口径应含源阻抗）

`gen_netlists_r5_r4.gen_ac_rs` + `LTspice -b -ascii`，扫 `V(fpa)/V(fna)` 相对 DC 的峰值
（数据：`r5_r4_c9_source_sweep.json` / `..._corner.json`）：

| Rs | 0 | 20 k | 30 k | 40 k | **50 k** | **60 k** | 80 k | 100 k | 150 k | 220 k | 300 k | 600 k |
|---|---|---|---|---|---|---|---|---|---|---|---|---|
| **B 标称** | 4.768 | 5.281 | 5.498 | 5.666 | 5.774 | **5.817** | 5.722 | 5.433 | 4.244 | 2.281 | 0.201 | 0.0 |
| **B 最坏角** R+1 %/C+5 % | 4.719 | 5.222 | 5.434 | 5.599 | 5.703 | **5.745** | 5.649 | 5.362 | 4.183 | 2.235 | 0.166 | 0.0 |
| **C 标称** | 11.191 | — | 14.876 | — | 17.810 | — | — | 23.731 | **24.621** | 20.877 | 16.424 | 7.077 |
| **C 最坏角** | 11.339 | — | 15.077 | — | 18.110 | — | — | 24.645 | **26.066** | 22.188 | 17.458 | 7.740 |

**读法**

1. **B 的 C9 最坏点不在 Rs = 0，而在 Rs ≈ 60 kΩ**（5.817 dB）。原因是输入侧 Rs∥C_in 极点
   改变了到达跟随器输入的边沿形状，使首级谐振被更强地激发。
   **只看 Rs = 0 会漏掉这个点**（0 Ω 只有 4.768 dB，比最坏点低 1.05 dB）。
2. **容差方向对 C9 不利的是 R−1 %**（R 变小 → Q 升高）：R−1 %/C+5 % 时 Rs=60 kΩ 达 **5.883 dB**，
   余量仅 **0.117 dB**。按 BOM 的 **0.1 % 电阻**实际最坏值是 **5.820 dB @60 kΩ（余量 0.180 dB）**
   （`r5_r4_c9_sensitivity.json` 的 `R-0.1%_C+5%`）。**这是 B 案最紧的一项硬约束**，
   比 D5 的 30 µs（对 900 µs 及格线余量 30×）紧得多。
3. **C 案**：最坏 24.6 dB @150 kΩ，**超限 18.6 dB**；即使 Rs = 0 也有 11.19 dB（超限 5.19 dB）。
   C 案的 C9 在任何源阻抗下都不达标。

### 2.4 与 D5 的关系（同一根杠杆）

| | 第 3 轮（R1=2.74） | 本轮（R1=6.19） |
|---|---|---|
| C9 跟随器峰（Rs=0） | 10.66 dB（超限） | 4.77 dB（通过） |
| D5 中间阻抗（50–220 kΩ） | 44.9–77.2 mV 极限环 | **全部回稳** |
| D5 全量程（73 Ω–600 kΩ，16 点） | 未覆盖 | **16/16 回稳** |

→ **C9 达标 ⇒ D5 中间阻抗缺口自动消失**。但**反向不成立**：C 案把 R1 提到 3.3 Ω 后
D5 在 gear 下回稳、trap 下 100 kΩ 仍振（见 §3.4），C9 也只降到 **6.13 dB（标称 Rs=0，仍超 6 dB）**
——**门槛在 C9**。

---

## 3. D5 五档源阻抗明细（重点：中间阻抗是否建立 / 振荡真伪）

### 3.1 规格工况（R×1.01 / C×1.05 最坏角，真实 OPA388，2 V 差分阶跃 / 10 ns 沿 / 0.01 % = 200 µV 带）

**B 案（冻结参数）** —— 数据：`r5_results_r4_B.json` 的 `d5_by_source` / `D5_detail`

| Rs | gear20n 400 µs | trap 60 µs | gear 5 n 150 µs | 三设置离散 | 尾窗 pp | 判定 |
|---|---|---|---|---|---|---|
| 10 kΩ | 26.834 µs | 26.720 µs | 26.835 µs | 0.43 % | 0.0021 µV | ✓ 建立 |
| 50 kΩ | 27.166 µs | 27.046 µs | 27.162 µs | 0.44 % | 0.0021 µV | ✓ 建立 |
| 100 kΩ | 29.064 µs | 29.035 µs | 29.056 µs | 0.10 % | 0.0038 µV | ✓ 建立 |
| **220 kΩ** | **30.089 µs** | 30.067 µs | 30.082 µs | 0.07 % | 0.0053 µV | ✓ 建立（**记分值**） |
| 600 kΩ | 28.179 µs | 28.251 µs | 28.180 µs | 0.25 % | 0.0131 µV | ✓ 建立 |

### 3.2 本轮补测的中间/边界阻抗（`r5_r4_d5_gap_sweep.json` / `r5_r4_B_d5_full_coverage.json`）

| Rs | 73 Ω | 1 kΩ | 20 kΩ | 30 kΩ | 40 kΩ | 60 kΩ | 80 kΩ | 150 kΩ | 300 kΩ | 400 kΩ | 500 kΩ |
|---|---|---|---|---|---|---|---|---|---|---|---|
| tset（µs） | 27.87 | 27.87 | 27.76 | 27.66 | 27.68 | 28.20 | 28.89 | 30.36 | 18.91 | 23.33 | 25.60 |
| 尾窗 pp（µV） | 0.0023 | 0.0023 | 0.0023 | 0.0024 | 0.0025 | 0.0026 | 0.0044 | 0.0070 | 0.0116 | 0.0058 | 0.0068 |
| 判定 | ✓ | ✓ | ✓ | ✓ | ✓ | ✓ | ✓ | ✓ | ✓ | ✓ | ✓ |

**结论：B 案在 1 % 可用范围（73 Ω–600 kΩ）的 16 个采样点全部建立**，
最慢 **30.36 µs**（150 kΩ），远低于 500 µs 满分线。

> **记分口径说明（如实标注）**：`r5_results_r4_B.json` 的 `dims.D5 = 30.0885 µs` 是
> **规格 §5.1 点名的 5 档（10k/50k/100k/220k/600k）内的最大值**（220 kΩ）。
> 本轮补测把采样点扩到 16 个后，全样本最大值是 **30.36 µs**（150 kΩ）。
> 两者都远低于 500 µs，**D5 归一化分均为 1.0**，不影响评分；但若规格采纳"扩到 16 点"的口径，
> **D5 的披露值应改为 30.36 µs**。

另做**C9 最坏角方向**（R−1 %/C+5 %）复核（`r5_r4_d5_negcorner.json`）：
0 / 50 k / 100 k / 220 k / 600 k = 27.67 / 27.93 / 29.62 / 30.80 / 28.40 µs，**全部回稳**。

> **中间阻抗"是否建立"的判定：建立。** 不是"只测了两端所以看起来没问题"——
> 除规格点名的 10 k / 50 k / 100 k / 220 k / 600 k 之外，本轮另实跑了
> **73 Ω、1 k、20 k、30 k、40 k、60 k、80 k、150 k、300 k、400 k、500 k 共 11 个点**，
> 全部有对应 `.raw`（`r5_work/r4_B/r5_B_r4_v9f_s*.raw`、`r5_work/r4_gap/B_gap_s*.raw`、
> `r5_work/r4_B/Bfull_s*.raw`）。

### 3.3 振荡真伪判定（第 3 轮 50–220 kΩ 那个 0.5 Vpp 现象）

**判据链与正对照**（`r5_d5_discrim_r4_B.py` → `r5_d5_discrim_r4_B.json`）：

| 检验 | 做法 | 结果 | 结论 |
|---|---|---|---|
| **正对照（判据敏感性）** | 旧参数 R1=2.74，Rs=100 kΩ，**三套独立数值设置** | 498 930 / 523 925 / 499 323 µV（FFT 峰 205 / — / 240 kHz）→ **三设置全报失稳** | 判据不是只在某一积分法下才报警 |
| **积分方法** | gear reltol 1e-5 vs trap reltol 1e-4 | 498.93 vs 523.93 mV（同量级，差 5 %） | **不是积分方法伪影** |
| **步长** | maxstep 20 ns vs 5 ns | 498.93 vs 499.32 mV | 不是步长伪影 |
| **同窗一致性** | gear vs trap 在 30–60 µs 的 6 个 5 µs 窗 | 逐窗一致（100 kΩ：45–50 µs 28.90 vs 28.85 µV；55–60 µs 5.16 vs 5.13 µV）且**单调衰减** 8429→1258→102→29→9→5 µV | 是**指数衰减尾**，不是积分器纹波 |
| **本轮新参数** | 5 档 × 3 设置 | 尾窗 pp 最大 **43.5 µV**（trap 60 µs 窗的 45–60 µs 段）；gear 400 µs 窗末降到 **0.004 µV** | 新参数**无极限环** |
| **自治性（F1）** | 输入纯 DC 不阶跃 | 尾段 **0.0033 µV**（完全安静） | 平衡点本身稳定 → 是**边沿激发的极限环**，不是自激 |
| **单腿振幅** | 对称激励下分开看两条腿 | `V(fpa)` 9.57 mV vs `V(fna)` **986.6 mV** | **只有一条腿振** → 必是大信号非线性（线性对称网络不会） |
| **幅度/边沿依赖** | 0.05/0.1/0.2 V 稳定；10 µs 沿稳定 | 1.0 V 失稳；10 ns/1 µs 沿失稳 | 阈值型非线性 |

**判定：**
> **是（a）真实的失稳机理，但只在 TI 宏模型的大信号非线性区被激发；不是（b）数值伪影。**
>
> 机理：OPA388 宏模型的单位增益跟随器闭环输出阻抗在 **100 kHz–1 MHz 为负实部**
> （−0.9 Ω@100 k、−2.78 Ω@275 k，`r5_zout_opa388_ti.json`），与首级 C_gnd 构成负阻谐振；
> R1 = 2.74 Ω 时 Q > 1（跟随器峰 10.66 dB），2 V 快沿把输出级推进钳位/限幅区后形成自持极限环。
> **R1 ≥ 6.19 Ω 时 Q < 1（峰 4.77 dB），极限环消失**——这与 C9 是同一根杠杆。
>
> **对真实硅片：** 未做硅验证。但 Re(Z_o,cl) < 0 是单位增益反馈在 A_OL→1 处相位裕度不足的
> 物理表现，**不依赖"硅片可能不会振"来做设计**（保持 R1 ≥ 6.19 Ω 即可）。

### 3.4 C 案对照：同样的判据用在 C 上

| 检验 | 结果（`r5_r4_C_d5_discrim.json`） | 结论 |
|---|---|---|
| C 冻结 R1=1.8，Rs=0，三设置 | 203 392 / 205 151 / 203 214 µV（387/395/395 kHz）→ **三设置全失稳** | **真实振荡，非伪影** |
| C 冻结 R1=1.8，Rs=100 k，三设置 | 691 732 / 697 235 / 692 966 µV（272/—/218 kHz）→ **三设置全失稳** | 真实振荡 |
| C 缓解 R1=3.3（C1 18 nF），Rs=0 | gear 0.0015 µV / trap 26.5 µV / gear5n 0.014 µV → **稳** | 该点稳 |
| C 缓解 R1=3.3，Rs=100 k | gear 0.003 µV **稳** / trap **102 784 µV 失稳** / gear5n 0.015 µV 稳 | **三设置不一致 → 处于临界，不可靠** |

C 案 D5 稳定性边界（`r5_r4_C_d5_sources.json` / `_bracket.json` / `r5_r4_d5_gap_sweep.json`）：

| Rs | 0 | 10 k | 30 k | 50 k | 73 k | 100 k | 150 k | 220 k | 300 k | 320 k | 350 k | 370 k | 390 k | 400 k | 410 k | **430 k** | 450 k | 500 k | 550 k | 580 k | 600 k |
|---|---|---|---|---|---|---|---|---|---|---|---|---|---|---|---|---|---|---|---|---|---|
| 尾窗 pp (V) | 0.20 | 0.25 | 0.32 | 0.41 | 0.52 | 0.69 | 0.70 | **0.79** | 0.74 | 0.74 | 0.74 | 0.74 | 0.73 | 0.73 | 0.73 | **<1e-6** | <1e-6 | <1e-6 | <1e-6 | <1e-6 | <1e-6 |
| 判定 | 振 | 振 | 振 | 振 | 振 | 振 | 振 | 振 | 振 | 振 | 振 | 振 | 振 | 振 | 振 | **稳** | 稳 | 稳 | 稳 | 稳 | 稳 |

→ **C 案受影响区间 = 0–410 kΩ（15 个采样点全部等幅极限环，0.20–0.79 Vpp），
430 kΩ 起（6 个采样点）才回稳。** 设计量程 10–120 kΩ **整段落在失稳区内**。
C 的 D5 = 89.87 µs 是**只在 600 kΩ 一点**取到的——按第 3 轮本报告提出的"扩到中间阻抗"口径，
C 的 D5 应记 **0**（淘汰）。

---

## 4. C 案 D8 口径修正对照

| 口径 | 模式 | 源模型 | CMRR | 说明 |
|---|---|---|---|---|
| 第 3 轮 `dims.D8` | 0.1 % 配对 | **0 Ω 理想源** | **135.474 dB** | 原网表 `gen_v3` 从未实例化 OPA388（`grep -c OPAx388 = 0`） |
| 第 3 轮 1 % 配对 | 1 % 配对 | 0 Ω 理想源 | 94.660 dB | 同网表族 |
| 第 3 轮 1 % 同向 | 1 % 同向 | 0 Ω 理想源 | 48.512 dB | 物理上限 |
| **本轮 1 % 配对（记分）** | **1 % 配对** | **真实 OPA388** | **95.524 dB** | `r5_work/r4_C_d8/r4_C_d8_v9b_p010.raw`，理论 95.503，Δ=0.021 dB ✓ |
| 本轮 0.5 % 配对 | 0.5 % 配对 | 真实 OPA388 | 108.624 dB | 参考 |
| 本轮 0.1 % 配对 | 0.1 % 配对 | 真实 OPA388 | 138.093 dB | 参考（与 B 的 136.88 同量级） |
| 本轮 1 % 同向 | 1 % 同向 | 真实 OPA388 | 48.471 dB | 对照（配对收益 **+47.05 dB**） |

**修正的影响**

| 项 | 修正前 | 修正后 | 变化 |
|---|---|---|---|
| C 的 D8 实测 | 135.474 dB（0.1 % 档） | **95.524 dB**（1 % 档） | −39.95 dB |
| C 的 D8 归一化分 | 1.0000（封顶） | **0.9552** | −0.0448 |
| **C 的总分（min）** | 0.710203 | **0.710203** | **不变**（短板仍是 D4） |

→ **口径修正不改变排序与总分**，但**改变了"两案可比"这件事**：修正前 B（95.51 dB @1 %）
与 C（135.47 dB @0.1 %）不是同一档位，任何"B 的 D8 比 C 差 40 dB"的读法都是错的；
修正后两案 **95.515 vs 95.524 dB，差 0.009 dB，实质持平**。

**同向对照的价值**：1 % 同向只有 48.3–48.5 dB（物理上限 48–49 dB，与规格 §5.1a 一致）。
**配对把 1 % 单体从"必淘汰"抬到 95 dB（+47 dB）——配对工序是 D8 过线的唯一途径，不是优化项。**

---

## 5. B vs C 最终对比表

**同口径**：真实 OPA388、D8 = 1 % 配对；D5 = 规格 5 档最坏角实测（B = 220 kΩ 的 30.089 µs；
C = 600 kΩ 的 89.872 µs）。B 的全 16 点最慢值是 30.36 µs（150 kΩ），差别不影响归一化分。

| 维度 | B（3 级，定档基线） | C（4 级，对照） | 差（B−C） | B 分 | C 分 |
|---|---|---|---|---|---|
| D1 DM@fMOD | 84.643 dB | **93.223 dB** | −8.58 | 0.7054 | 0.7769 |
| D2 CM@fMOD | 79.174 dB | **89.127 dB** | −9.95 | 0.7917 | 0.8913 |
| D3 DM@MCLK | 132.564 dB | **152.202 dB** | −19.64 | 0.8838 | 1.0000 |
| D4 平坦度@16 kHz | 0.1849 dB | **0.1804 dB** | +0.0045（B 略差） | **0.7003** | **0.7102** |
| D5 建立时间 | **30.089 µs**（16 点全稳） | 89.872 µs（**仅 600 kΩ 稳**） | −59.78 | 1.0000 | 1.0000¹ |
| D6a 噪声增量 | 0.638 % | 0.594 % | +0.044 | 1.0000 | 1.0000 |
| D7 σ(ΔG) | 0.003990 dB | 0.004915 dB | −0.0009 | 1.0000 | 1.0000 |
| D8 CMRR@通带（1 % 配对） | 95.515 dB | 95.524 dB | −0.009 | 0.9551 | 0.9552 |
| D9 Kickback | 1.0 | 1.0 | — | 1.0000 | 1.0000 |
| D10 群延迟 | 0.0904 µs | 0.0865 µs | +0.0039 | 1.0000 | 1.0000 |
| *D6b 总噪声* | *12.037 LSB* | *13.740 LSB* | *−1.70* | *仅报告* | *仅报告* |
| **总分 = min** | **0.700284** | **0.710203** | −0.0099 | 短板 **D4** | 短板 **D4** |
| **C9（跟随器节点，硬约束）** | **4.77 dB（最坏 5.82）** ✓ | **11.19 dB（最坏 24.62）** ✗ | — | — | — |
| **D5 全量程（73 Ω–600 kΩ）** | **16/16 稳** ✓ | **0–410 kΩ 振，≥430 kΩ 稳** ✗ | — | — | — |
| 件数/通道 | **13** | 17 | −4 | — | — |
| ΣR | 25.93 Ω | 37.70 Ω | — | — | — |

¹ C 的 D5 = 89.87 µs **只在 600 kΩ 一个点上成立**；按全量程口径应记 0（详见 §3.4）。

**读法**

1. **纯评分看，C 略高 0.0099**（D4 好 0.0045 dB + D1/D2/D3 余量更大），但这个差距
   **小于 D4 的测量/模型不确定度**，不构成选型依据。
2. **加上硬约束后 B 明显更优**：C9 与 D5 全量程两项 C 都不成立，且这两项是**上板必翻车**的项
   （C9 是噪声放大器，D5 是量程内的建立失败）。
3. **B 的代价是 D1/D2 余量较小**（D1 距及格线 +4.64 dB，D2 +19.17 dB）——仍有余量，
   但若后续再为 D4 动 R/C，要盯住 D1 不得跌破 80 dB。
4. **D1/D4 前沿（本轮新增，`r5_r4_d1d4_frontier.json` + `r5_r4_d1d4_frontier_ltspice.json`）**：

   | 全局 R 缩放 kR | fc | D1（LTspice） | D4（LTspice） | min(D1,D4) 归一化 |
   |---|---|---|---|---|
   | 0.50 | — | 72.86 dB | 0.0478 dB（**D4 满分**） | 0.607（D1 越 80 dB 及格线） |
   | 0.65 | — | 77.19 dB | 0.0797 dB | 0.643（D1 越线） |
   | 0.75 | — | 79.63 dB | 0.1054 dB | 0.664（D1 **越线**） |
   | 0.80 | — | 80.74 dB | 0.1196 dB | 0.673（D1 距及格线 0.74 dB） |
   | **1.00（冻结）** | 79.95 kHz | **84.64 dB** | **0.1849 dB** | **0.700** |
   | 引擎：kR=1.05 | 71.4 kHz | 85.17 dB | 0.2034 dB | 0.659 |
   | 引擎：kR=1.20 | 64.7 kHz | 87.55 dB | 0.2635 dB | 0.525 |

   → **kR = 1.0 就是 B 拓扑 D1↔D4 的平衡点**（两条约束的归一化分几乎相等：0.7054 / 0.7003）。
   继续缩 R 抬 fc 会让 **D1 跌破 80 dB 及格线**（kR=0.8 时 D1=80.74，kR=0.75 时 79.63 已越线）；
   继续增 R 压 fc 会让 D4 迅速恶化。**没有第二组参数能把 min 推过 0.71。**
   对 C 做同样扫描（`r5_r4_d1d4_frontier.json` 的 `C`），kR=0.9 时 min14 = **0.754**
   （D1 90.43 dB / D4 0.1469 dB）——**若 C 将来复用，应先把 R 整体缩 10 %**。

---

## 6. 定档建议

### 6.1 判定（明确回答）

> **B 案没有达到 min ≥ 1.0，按该条不可"全维过线定档"。**
>
> - **十维及格线：全过**（D1–D10 无一越线）；**C9 / C2 / C3 / C4 硬约束：全过**；
>   **D5 全量程：16/16 建立**；**D8 配对 1 %：95.51 dB（≥80）**。
> - **总分 min = 0.700284**，短板 **D4 = 0.1849 dB**（满分线 0.05 dB，距满分 0.1349 dB）。
> - **D4 的 0.05 dB 与 D1 的 80 dB 及格线在三阶拓扑下不可同时满足**（LTspice 实测，真实 OPA388）：
>   把全局 R 缩到 kR = 0.80 时 **D4 降到 0.1196 dB 但 D1 只剩 80.74 dB**（距及格线 0.74 dB）；
>   再缩到 kR = 0.75 → D1 = 79.63 dB（**越线**）；kR = 0.65 → D4 才 0.0797 dB，而 D1 = 77.19 dB。
>   单极点估算下 D4 ≤0.05 dB 需 fc ≥ 148.7 kHz，此时 B 的 D1 按前沿外推只有 ~73 dB。
>   → **这是规格阈值问题，不是方案缺陷**，与 §5.1b 已裁决的"D6 的 1 LSB 不可达"同构。

### 6.2 建议

| # | 建议 | 理由 |
|---|---|---|
| **1** | **B 案（6.19 / 6.04 / 13.7 Ω × 68 / 68 / 27 nF + 12 nF）作为定档基线冻结** | 十维全过、C9 与 D5 全量程成立、13 件/通道、全 E96/E12。它是本轮唯一"硬约束全过"的方案。 |
| **2** | **把 D4 的处理方式提交规格裁决**（三项择一）：(a) 满分线由 0.05 dB 放宽到 **0.20 dB**（B=0.1849 → 满分）；(b) 拆成 D4a（及格/硬指标 ≤0.5 dB）+ D4b（报告值，不进 min，同 D6a/D6b 先例）；(c) 保持 0.05 dB 但明确"该项仅对 fc ≥149 kHz 的方案可满分"，即承认三阶在 50–80 kHz 窗口内的 D4 得分上限 ≈0.70（fc=80 kHz 时） | 现 min 完全由 D4 定义，而 D4 的满分线与 D1 的满分线在三阶/四阶无源 RC 下互斥。**不裁决，任何方案都定不了档。** |
| **3** | **C9 的实测口径写死为「跟随器输出节点 + 0–600 kΩ 源阻抗扫描 + R−1 % 容差角」** | B 在 Rs=0 时 4.77 dB，最坏 5.88 dB——**只测 0 Ω 会漏掉 1.05 dB**；0.1 % 电阻实配下最坏 5.82 dB，余量 0.18 dB。这条必须在规格与 BOM 里同时约束。 |
| **4** | **D5 的工况点写死为「73 Ω / 10 k / 50 k / 100 k / 220 k / 600 k」六点** | 第 3 轮 0 Ω + 600 kΩ 两点恰好都在稳定区，会漏判 C 案；B 用六点全过，C 用六点有 5 点失稳。 |
| **5** | **不采用 C 案**（即使它的 min 高 0.0099） | C9 24.6 dB、D5 全量程 0–410 kΩ 失稳——两项硬约束不成立；且 17 件/通道。 |
| **6** | **不建议为追 D4 调 R** | kR=1.0 已是前沿；任何缩放都让 min 下降（§5 读法 4）。R1 再加大（7.5 Ω）虽把 C9 降到 4.41 dB，但 D4 升到 0.2142 → min 掉到 0.635。 |

### 6.3 若"D5 中间阻抗判定为真实不稳定"这一前提成立（假设性回答）

本轮的实测**否定**了该前提（B 案 16/16 建立）。但若把第 3 轮的判定原样套到各案：

| 案 | 受影响源阻抗区间（实测） | 缓解选项 | 代价 |
|---|---|---|---|
| **B（冻结）** | **无**（73 Ω–600 kΩ 全稳；含 R±1 %/C+5 % 角） | 无需 | — |
| **C（R1=1.8）** | **0–410 kΩ 失稳**，≥430 kΩ 稳定 | ① R1 1.8 → **4.7 Ω** 且 C1 33 → **12.64 nF**（保 R1C1）：D5 0/10 k/30 k/50 k/100 k/220 k/600 k **全部回稳**（18.9–29.9 µs）；C9 4.49 dB（Rs=0）/ **5.42 dB**（最坏 50 kΩ） | D4 0.1804 → **0.2561**、D1 93.22 → **88.70** → **min ≈ 0.541**（D4 主导）；C9 合格。**代价是把 C 从 0.710 拉到 0.541。** |
| **C** | 同上 | ② R1 = 3.3 Ω（C1 18 nF）：gear 下稳、trap 下 100 kΩ 仍振（三设置不一致＝临界）；C9 **6.13 dB（Rs=0）/ 7.70 dB（100 kΩ）** | **不可靠，不推荐** |
| **C** | 同上 | ③ 限制使用范围到 ≥430 kΩ | 与 1 % 可用范围（73 Ω–600 kΩ）冲突，**不可接受** |

数据：`r5_r4_C_mitigation.json` / `r5_r4_C_mitigation_d5_sweep.json` /
`r5_r4_C_mitigation_c9_sweep.json`。

---

## 7. 复现与新增文件

| 文件 | 内容 |
|---|---|
| **`score_r5_r4.py`** | **本报告全部评分**（十槽位 + D8 口径对照 + C9 源阻抗扫描汇总 + D5 明细 + B/C 对比） |
| `r5_scores_r4.json` | 机器可读评分副本（cases + extra.d5_B / extra.c9_source_sweep / extra.c_d8_calibration） |
| `r5_r4_c9_source_sweep.json` / `_corner.json` | B 案 C9 跟随器峰 vs 源阻抗（标称 / 最坏角） |
| `r5_r4_c9_source_sweep_C.json` / `_C_nominal.json` | C 案同一扫描（对照） |
| `r5_r4_c9_sensitivity.json` | C9 对 R±/C+5 % 容差的敏感性（含 0.1 % 电阻实配点） |
| `r5_r4_d5_gap_sweep.json` | B/C 的 D5 中间阻抗补测（20–300 kΩ） |
| `r5_r4_B_d5_full_coverage.json` | B 的 73 Ω / 1 k / 400 k / 500 k 补点 |
| `r5_r4_d5_negcorner.json` | B 在 C9 最坏角方向（R−1 %/C+5 %）的 D5 复核 |
| `r5_r4_C_d5_sources.json` / `_bracket.json` | C 的 D5 全量程 + 稳定/失稳边界（410/430 kΩ） |
| `r5_r4_C_d5_discrim.json` | C 的振荡真伪判别（R1=1.8 / 3.3 各三套数值设置） |
| `r5_r4_C_mitigation*.json` | C 的缓解方案（R1=4.7 / 6.19 / 7.5）的 C9、D5、D4、D1 |
| `r5_r4_B_c9_margin_options.json` | B 的 C9 余量增强选项（R1=7.5 / 9.09）及其 D4/D1 代价 |
| `r5_r4_d1d4_frontier.json` / `_ltspice.json` | D1↔D4 前沿（引擎 + LTspice 三点抽验） |
| `r5_r4_corner_c9_d4.json` | 0 / 50 k / 600 k 的最坏角 C9+D1/D3/D4 |
| `r5_r4_B_c1_direction.json` | B 首级 C1 偏离方向（62 / 68 / 75 nF）对 C9/D4/D1 的影响 |
| `r5_r4_C_highz_d4.json` | C 在 600 kΩ 端的 D4（0.4878 标称 / 0.5045 最坏角） |
| `r5_bom_esl_esr_r4.json` | **冻结参数的 ESL/ESR 敏感性重跑**（L 只串在电容支路，与 r3 BOM 同构） |
| `r5_work/r4_B/`、`r5_work/r4_gap/`、`r5_work/r4_C_d5/`、`r5_work/r4_C_mit/`、`r5_work/r4_C_c9/` | 上述全部仿真的网表、`.raw`、`.log` |

**复现命令**

```bat
cd hardware\sim\aaf
python score_r5_r4.py                       :: 评分 + .raw 反算 + 全部对照表
python score_r5_r4.py --no-recheck          :: 跳过 .raw 反算
```

**数据来源标注**：B 的十维主数据来自 `r5_results_r4_B.json` 的 `dims`（该文件 `sources` 段逐项列出
对应的 `.raw` 名），本轮已用 `parse_r5.py` 从 `.raw` 独立复算 6 项（max|Δ| = 3.21e-04）；
C 的 D1–D7/D9/D10 来自 `r5_results_r3_C.json`、D8 来自 `r5_results_r4_C_d8.json` 的
`D8_detail_r4`（已从 `r5_work/r4_C_d8/r4_C_d8_v9b_p010.raw` 复算，5.29e-04）。

---

## 8. 本轮未做 / 不能确认的项（如实标注）

| 项 | 状态 |
|---|---|
| **硅验证** | **未做**。C9/D5 的结论全部基于 TI 宏模型（`lib/OPAx388.LIB`，SBOS777D Rev D）。宏模型的大信号块是行为级近似，"真实 OPA388 是否同样在 60 kΩ 处到 5.8 dB"需上板实测。 |
| **D6b 的砖墙极限 4.30 LSB 是否可达** | 未评估。B 实测 12.037 LSB（2.8×），由跟随器 9.9 nV/√Hz 决定，**无优化空间**（规格 §5.1b 已裁决为仅报告）。 |
| **CH1 vs CH2 通道间群延迟差** | **未做**。现有网表是同一差分通道的两条腿（p/n），不是两个独立通道。§5.1a 点名的"CH1 vs CH2 群延迟差"仍需四线全仿。 |
| **电阻温漂** | **未代入**。温度角只折 C0G −30 ppm/℃（`r5_results_r4_B.json` 的 `temperature_corners.note`）；R 温漂待 E.10 #6 定料后补。 |
| **D7 的 C 容差 5 %** | 按 §7 V5 规定，未含介质老化/焊接漂移。 |
| **B 案 E96 实配值** | 冻结参数三值 **6.19 / 6.04 / 13.7 本身就是 E96 的精确标称值**（619 / 604 / 137 均在 E96 24 点表内）→ **无需取整，实物即可照仿真值采购**。仅当供应商只给三位有效数字（6.19→6.19、6.04→6.04、13.7→13.7）时才有 ±0.5 % 的显示误差，不影响设计。 |
| **D4 的 600 kΩ 端** | 按 §5.1 记分口径是 0 Ω；600 kΩ 端实测 **0.4924 dB**（`highz`，距 0.5 及格线 **0.0076 dB**），来源是 600 kΩ×(OPA388 C_in≈4.5 pF) 的输入极点，**与本段阶梯无关**，属必须向用户披露的使用工况项。 |
| **C 案温度角** | 未跑（无 `r4_C` 温度角网表）。 |
| **C 案 600 kΩ 端的 D4** | 本轮补测（`r5_r4_C_highz_d4.json`）：**0.4878 dB（标称）/ 0.5045 dB（R+1 %/C+5 %）**——最坏角**越 0.5 dB 及格线**。按 §5.1 的 0 Ω 记分口径不计入 D4，但与 B 的 0.4924 dB 一样属使用工况披露项，且 C 在容差角下已越线。 |
| **规格未裁决项** | D4 满分线、C9 考核节点、D8 严格倒数口径（1 % 时 111.10 dB vs 字面 95.51 dB）——**三项均需规格方定**，本报告按现行正文执行。 |
