chenxi-z/de-drms/hardware/sim/signalchain/aaf_pkg_review/REPORT.md

# aaf_pkg_review REPORT — 六方案小封装 AAF 全轮次汇总（2026-10-24）

> 任务书：`hardware/sim/AAF_基于已确认封装的候选参数与Zcode复核_2026-10-24.md` §5(8)/§6。
> **门槛一律不降**：D1≥80 dB、D2≥60 dB、D3≥100 dB、D4≤0.5 dB（满分线 ≤0.05）、D5≤900 µs、
> D6a≤30%、D7 σ≤0.05 dB、D8≥80 dB、D9 半周期残余≤0.01%、D10≤5 µs、C9≤6 dB。
> 所有数值逐条出自本目录 `csv/`（22 份）与 `raw/`/`logs/`（LTspice 26.1.1 实跑产物），
> 或本目录并行线报告 `layout_area_report.md`（EasyEDA 占地）与 `parasitic_0805_0402.md`（器件寄生），
> 每表标注证据文件。环境已知缺陷（ltspice-sim 对 AC 复数 ASCII raw 后处理崩溃 rc=1，
> 仿真本体完成、以 LTspice 产物判定成功）沿用 fo1_rc_review/README，全程记 note 不判失败。
> 上一轮已定论限制（OPAx388 宏 .temp 仅 25–27 ℃、Ron/vcm 无手册值等）沿用
> `../fo1_rc_review/REPORT.md` §7，不重推。

---

## ① 结论摘要（六方案排序与推荐）

**判罚底线先说清：六方案无一满足原 D1≥80 dB 与 D3≥100 dB，门槛未放宽，FAIL 如实保留。**
能跨线的门槛指标只有 D2（T2/T3/T4）与 D4–D10/C9（全案或按口径，见 ③）。

**电气能力排序（门槛跨线数 + 抑制量 + D4 余量综合）**：

| 排名 | 方案 | 一句话 |
|---|---|---|
| 1 | **T2**（100+120 Ω/10nF×2/820pF，全 0402） | **最优电气折中**：D2=61.05 dB 跨线；D1=62.33 dB 六案第二、D3=94.74 dB 六案第三（T4=96.40/T3=95.14 更高）；D4 标称 0.4121/A5 角 0.4609 dB 余量可控（85℃ 叠架 0.4183 dB）；PM 96.34°；真实占地 32.62 mm²/通道 |
| 2 | T4（82+160 Ω） | 抑制最强（D1=63.53/D2=62.25/D3=96.40 dB 全列最高）但 **D4 A5 角 0.4735 dB 距 0.5 淘汰线仅 0.027 dB**（任务书 §2 预判的边界案坐实），量产 C0G 实容差劣于 ±5% 即越线 |
| 3 | T3（68+150 Ω） | D2=60.55 dB 勉强跨线（余量最小 0.55 dB）；D4=0.336/0.376 dB 最平；D1 略低于 T2（61.84 vs 62.33）、D3 反高于 T2（95.14 vs 94.74） |
| 4 | T1（100+100 Ω） | **D2=59.47 dB 边缘 FAIL（差 0.53 dB）**；其余指标与 T2 同型 |
| 5 | S0（47 Ω/47nF/820pF，0805 CG） | 一阶内抑制最高（D1=40.68/D3=62.67 dB）但 D2 差 ~20 dB；**47nF/0805 C0G 无目录料号（阻断项是料号不存在而非寄生，见 ⑤-4）** |
| 6 | S1（100 Ω/22nF/820pF，0805 CG） | 六案全列最低（D1=38.72/D2=38.11/D3=59.08 dB） |

**推荐**（Pareto 明细见 ④）：

1. **首选 T2**。理由：D2 唯一同时跨线且余量（1.05 dB）与 D4 余量（0.039 dB 至淘汰线，A5 角口径）平衡最好；全 0402 真实占地 32.62 mm²/通道比 S 系省 6.43 mm²/通道（−16.5%）；任务书 §2 亦标注 T2 为「优先」。**代价两条必须接受**：(a) D6a 正交口径 44.6% 超 30% 淘汰线（判罚口径=线性口径 9.48% PASS，双口径并列如实，见 ③ 注）；(b) D8 配对必须走「整线同 m」四元件选配工序（R1/R2 同偏 + C1/C2 同偏），逐级各自配只到 51.1 dB FAIL（见 ⑤-3）。
2. **T4 仅作抑制边界备选**：需最高 D1/D2/D3 且量产容差受控（±5% C0G 实测筛选）时才取。
3. **S0/S1 出局**：D2 差 ~20 dB（一阶斜率不够）、真实占地反而大 16.5%、S0 另有料号阻断；S0 与 S1 占地等同（39.05 vs 39.06 mm²，落盘舍入差），**面积不能作为 S0/S1 的取舍依据**。
4. **若 D1≥80/D3≥100 是硬规格**：无源 RC 一阶/二阶在 D4≤0.5 dB 通带约束下**物理不可达**（差距量级与重新设计方向见 ④ 第三行）——这是设计决策点，不是参数微调能解决的。

---

## ② 冒烟锚定表（S0/S1 与旧轮电气等同的证明）

证据：`csv/smoke_anchor.csv`（22 行）；锚口径出处 ask 原文 + `../fo1_rc_review/csv/`。

| 项 | 锚（历史口径） | 本轮实测 | 偏差 | 判定（容差 0.5 dB） |
|---|---:|---:|---:|---|
| S0 D1 @4.096M（DM 1V 衰减） | 40.69 | **40.6891** | −0.0009 | PASS |
| S0 D2 @4.096M（CM **0.5V 激励绝对 dB**，t00 口径） | 46.41 | **46.4104** | +0.0004 | PASS |
| S1 D1 @4.096M（DM 1V 衰减） | 38.72 | **38.7351** | +0.0151 | PASS |
| S1 D2 @4.096M（CM **1V 归一**，t02 口径 = 0.5V 绝对 −6.0206） | 38.11 | **38.1085** | −0.0015 | PASS |
| T2 D4 @16k（§3 理想表，趋势参考不锚定） | 0.412 | **0.4121** | +0.0001 | PASS（同趋势） |

- 最大偏差 0.015 dB ≪ 0.5 dB，无需口径排查；.meas 与 raw 复数插值交叉校验差 ≤0.001 dB。
- **D2 双口径注记（口径隐患实测命中，未用口径差换任何指标）**：S0-D2 锚（46.41）与 S1-D2 锚（38.11）出自两套历史口径，恒差 6.0206 dB（=20log10 2）；本轮 CM 网表统一 0.5V（t00 口径），S1-D2 = 绝对 dB − 6.0206 精确换算对锚。**本报告 D2 判罚一律用 1V 归一口径**（衰减量物理口径：S0=40.39、S1=38.11、T1=59.47、T2=61.05、T3=60.55、T4=62.25 dB）。
- **电气等同 lint 对拍**：S0 dm/cm 网表与 t00_fo1_base_{acdm,accm}.net 除首行注释外逐行字节一致；S1 dm 与 t01 完全一致；S1 cm 仅 2 行激励口径差（AC 1→0.5）。
- **锚定交叉校验（全轮次，tol 族）**：S0-D1 Δ=−0.006 / S0-D2 Δ=0.0000 / S1-D1 Δ=−0.013 / S1-D2 Δ=0.0000 dB；PM@25℃ S0=98.57/S1=96.93 与 fo1 FO1_BASE/FO1_A 完全一致；T04 全部 6 个共有角点（nom/ch1/tol/tolcm/vhi/vlo；本轮 src10k/src120k 为新增无 fo1 对应、fo1 的 600k 本轮未跑）3 位小数全同（S0 tolcm=19.394 µs ≡ FO1_BASE 19.394）；T09 f4m+8k 折回 950.498 µV ≡ 950.498 µV——T1–T4 数值继承同一已验证口径。

---

## ③ 六案总表

### ③a 门槛判罚（门槛一律不降；F=FAIL，P=PASS，△=PARTIAL）

证据列注于每行。**证据层级（逐行标注）**：未特别标注的行 = **L2**（LTspice 26.1.1 + TI OPAx388 宏 md5 `97c4045ef608097ec1f1a67dca97ceae` 实跑）；D7 行与 ③c 标注 MC 的 D8 P1 值 = **L1**（纯 Python 线性蒙特卡洛，理想源 + Rin 130 kΩ + C_pin 5 pF/端，无运放模型，n=1000——`t06_t11.py` 头注层级声明；L1↔L2 共享指标交叉核对 Δ≤0.0002 dB（`csv/t06_l1_l2_xcheck.csv`），L2 确定性角点（A5/B2/B2L）与 L1 P1 同判，判定一致但**不得把 L1 称为 LTspice 结果**）。

| 指标（门槛） | S0 | S1 | T1 | T2 | T3 | T4 | 证据 |
|---|---|---|---|---|---|---|---|
| **D1** @4.096M DM 衰减 ≥80 dB | 40.68 F | 38.72 F | 60.76 F | 62.33 F | 61.84 F | 63.53 F | `csv/t01_dm_ac.csv` D1_atten_dB（opa388 行） |
| **D2** @4.096M CM 衰减 ≥60 dB（1V 归一） | 40.39 F | 38.11 F | 59.47 F | **61.05 P** | **60.55 P** | **62.25 P** | `csv/t02_cm_ac.csv` D2_atten_dB（opa388 行） |
| **D3** @16.384M DM 衰减 ≥100 dB | 62.67 F | 59.08 F | 93.16 F | 94.74 F | 95.14 F | 96.40 F | `csv/t01_dm_ac.csv` D3_atten_dB |
| **D4** @16k 衰减 ≤0.5 dB（满分 ≤0.05）标称 / A5 容差角 | 0.223/0.251 △ | 0.238/0.267 △ | 0.367/0.410 △ | 0.412/0.461 △ | 0.336/0.376 △ | 0.423/**0.474** △ | `csv/t01_dm_ac.csv` D4_16k_dB + `csv/t06_d7_d8_verdict.csv` + `csv/t11_corners.csv` |
| **D5** 0.01% 建立最坏角 ≤900 µs（最坏=CH1 场景） | 23.9 P | 24.7 P | 30.3 P | 32.0 P | 29.0 P | 32.4 P | `csv/t04_settling.csv` ts01_us 全 8 角 max |
| **D6a** ADC 贡献 ≤30%：线性判罚口径 ch0/ch1 | 0.8/1.6 P | 1.7/3.3 P | 4.5/8.8 P | 4.9/9.5 P | 4.4/8.6 P | 5.0/9.8 P | `csv/t05_noise.csv` d6a_linear_pct |
| **D6a** 正交口径 ch0/ch1（并列，不判罚） | 12.6/17.7 P | 18.4/26.0 P | 30.4/**42.9 F** | 31.5/**44.6 F** | 30.0/**42.4 F** | 32.0/**45.2 F** | `csv/t05_noise.csv` d6a_quad_pct |
| **D7** 16k 衰减 MC σ ≤0.05 dB（A5 档最坏） | 0.0087 P | 0.0092 P | 0.0100 P | 0.0122 P | 0.0106 P | 0.0128 P | `csv/t06_d7_d8_verdict.csv` + `csv/t06_mc_summary.csv` |
| **D8** CMRR ≥80 dB | 见 ③c 专表（免配对全 F；配对后一阶 P、二阶须整线同 m；Kelvin 口径全 F） | | | | | | `csv/t06_d7_d8_verdict.csv`（117 行全口径） |
| **D9** kickback 半周期残余 ≤0.01%·通道稳态 | 1.07e-5 P | 1.33e-5 P | 1.77e-5 P | 4.04e-5 P | 2.89e-5 P | 5.02e-5 P | `csv/t08_kickback.csv` rel_to_ch 最坏（Ron∈{1,100,1000}Ω×vcm∈{0,0.6,2.0}V 全扫） |
| **D10** 通道群延迟平坦度 ≤5 µs @16k（舱口径，单通道 0.1 Hz–16k） | 0.116 P | 0.126 P | 0.242 P | 0.290 P | 0.213 P | 0.296 P | `csv/t10_group_delay.csv` CH0_opa388_bench 行 dtau_0p1_16k_us（CH1_kelvin_bench 行 0.115–0.284 亦全过；双通道失配另见 ③b 相位失配行） |
| **C9** 跟随器输出 peaking ≤6 dB（ch0/ch1 取大） | 0.694 P | 0.333 P | 0.326 P | 0.333 P | 0.528 P | 0.431 P | `csv/t07_stability.csv` c9_max_db（pk_ch0 与 pk_ch1 两行取大；ch0 列为 0.691/0.330/0.325/0.332/0.527/0.431） |

D4 判定全案 PARTIAL（>0.05 dB 满分线、≤0.5 dB 淘汰线，判罚口径沿 `csv/t06_d7_d8_verdict.csv`）；T4 余量最小（0.027 dB），85℃ 标称再 +0.006 dB，温度+容差叠架 ≈0.48 dB 仍 <0.5 但量产余量六案最小。D6a 双口径并列落 CSV（`d6a_linear_pct`/`d6a_quad_pct` 两列 + note_3）：**判罚维持 r4 冻结线性口径**（六案全 PASS≤10%）；正交口径二阶四案全超 30% 淘汰线、S0/S1 在线内——机理是二阶每线 2 只串联 R 的 Johnson 噪声（825–831 nV vs 一阶 411–589 nV）+ 二阶 AAF 对运放噪声衰减更强（分母 1841–2773 nV vs 2263–3275 nV）致相对占比放大，**绝对宽带噪声 2020–2896 nV（6.9–9.9 LSB）反而全部低于一阶 S0/S1（2352–3301 nV，8.0–11.3 LSB）**。

### ③b 电气与物理特性明细（证据逐列标注）

| 项 | S0 | S1 | T1 | T2 | T3 | T4 | 证据 |
|---|---:|---:|---:|---:|---:|---:|---|
| fc (kHz, −3dB) | 70.5 | 67.8 | 53.6 | 50.4 | 56.0 | 49.6 | `csv/t01_dm_ac.csv` |
| 相位 @16k (°) | −13.02 | −13.44 | −18.75 | −20.00 | −18.17 | −20.41 | `csv/t01_dm_ac.csv` |
| CH0↔CH1 相位失配 @16k (°) | −0.044 | −0.0451 | −0.0452 | −0.0452 | −0.0452 | −0.0452 | `csv/t10_group_delay.csv` CH0_minus_CH1_bench 行 dphi_16k_deg（t03 的 dphi 为 bench_realsrc 口径 −0.057~−1.60°，随源阻抗变，另见 ⑤-3） |
| Kelvin 口径 D1（对照，@4.096M） | 38.40 | 37.55 | 59.63 | 61.20 | 60.31 | 62.21 | `csv/t01_dm_ac.csv` kelvin 行 |
| CMRR Kelvin 标称最坏 10Hz–16k (dB)，per-1V spec 口径 | 56.31 | 56.10 | 56.08 | 56.08 | 56.08 | 56.08 | `csv/t06_ltspice_corners.csv` c00 cmrr_kelvin_min_db（t02 kelvin 行 62.33/62.12/62.10×4 系 0.5V 激励泄漏直接取比值、未除 0.5，比 per-1V 口径乐观恒 6.02 dB——两组逐案吻合 62.33−6.02=56.31 等；真实 Kelvin CMRR 地板以 ~56 dB 为准，与 ③c 第 5 行同量） |
| 整链线缆 CM→DM 转换 @16k (dB/1V Vint)（六案几乎同） | −5.23 | −5.26 | −5.40 | −5.45 | −5.37 | −5.46 | `csv/t02_cm_full.csv` ch0_cmdm_16k_dB（V(a0p)−V(a0n) per 1V Vint；log 实测 cmdm0_16k=−5.234 dB 佐证） |
| 整链线缆 CM 直通输出 @16k (dB/1V Vint)（对照行） | −12.12 | −12.05 | −12.02 | −12.03 | −11.97 | −12.01 | `csv/t02_cm_full.csv` ch0_cmout_16k_dB（V(a0p) 单端直通，非 CM→DM 差模泄漏） |
| D1 Kelvin −D1 opa388 舱 (dB) | −2.28 | −1.17 | −1.13 | −1.13 | −1.53 | −1.32 | 同上两行差（一阶 S0 −2.3 与 fo1 结论一致） |
| kickback 峰 @Ron=100Ω a1p (µV) | 20.8 | 43.6 | 92.0 | 91.9 | 91.9 | 91.9 | `csv/t08_kickback.csv` |
| kickback 残余最坏 (µV) | 12.6 | 15.7 | 20.7 | 47.2 | 33.7 | 58.6 | `csv/t08_kickback.csv` resid_end_uv |
| THD 真 2–10 次谐波 @16k (%) | 1.8e-6 | 1.5e-6 | 2.0e-6 | 2.1e-6 | 2.0e-6 | 2.3e-6 | `csv/thd_summary.csv` |
| THD "Total" @16k（含开关纹波泄漏口径，%） | 0.0020 | 0.0042 | 0.0087 | 0.0087 | 0.0087 | 0.0087 | `csv/thd_summary.csv`（0.002–0.0087% 由 4.096M 开关纹波主导非模拟失真；真谐波 0.0002–0.038 LSB ≪1 LSB，24bit 下不可测；任务书未给 THD 判决门，双口径并报） |
| 噪声 ch0 宽带 nV (LSB) | 3301 (11.3) | 3255 (11.2) | 2845 (9.8) | 2758 (9.5) | 2896 (9.9) | 2734 (9.4) | `csv/t05_noise.csv` |
| 噪声 ch0 带内 nV | 1245 | 1255 | 1267 | 1268 | 1272 | 1272 | `csv/t05_noise.csv` |
| PM @25℃ (°) | 98.57 | 96.93 | 96.34 | 96.34 | 95.85 | 96.11 | `csv/t07_stability.csv` loop_ch0 |
| UGF (Hz) | 2.79M | 4.60M | 4.60M | 4.60M | 3.65M | 4.12M | `csv/t07_stability.csv` |
| 过冲 (%)（os ch0/ch1 取大） | 0 | 0.0001 | 0.0007 | 0.0011 | 0.0004 | 0.0013 | `csv/t07_stability.csv` overshoot_pct（os_ch0 与 os_ch1 两行取大；单列值 ch0=0/0/0.0007/0.0009/0.0004/0.0013、ch1=0/0.0001/0.0006/0.0011/0.0004/0.0012） |
| T09 折回最坏 @100mV 注入 (LSB，瞬态实测) | 3280 | 4269 | 372 | 318 | 325 | 280 | `csv/t09_fold_check.csv` + `csv/tran_metrics.json` |
| sinc³ 合成折回 4M−16k (dB，AAF+数字) | −41.3 | −39.4 | −61.4 | −63.0 | −62.5 | −64.2 | `csv/l3_sinc3_alias.csv`（OSR=32 全局同设，离线合成非数字核仿真） |
| **本体面积** (mm²/通道，任务书 §4 规则) | 6.5 | 6.5 | 4.5 | 4.5 | 4.5 | 4.5 | 任务书 §4（估算规则非测量） |
| **真实占地** (mm²/通道，铜包围框实测) | **39.05** | **39.06** | **32.62** | **32.62** | **32.62** | **32.62** | `layout_area_report.md` §1（EasyEDA 副本 PCB1_1 实画读回） |
| 两通道合围 (mm²，含 40 mil 通道距) | 81.85 | 81.85 | 70.25 | 70.25 | 70.25 | 70.25 | `layout_area_report.md` §1 |
| 真实/本体面积比 | 6.01× | 6.01× | 7.25× | 7.25× | 7.25× | 7.25× | 同上 |

**S0 与 S1 同为 0805 时占地等同（39.05 vs 39.06 mm²，差 0.1 mil 落盘舍入）——S1 没有面积优势，本报告不重复计入。**
二阶 9 件全 0402 比一阶 5 件（含 0805）**小 6.43 mm²/通道（−16.5%）**：C0805 立式 land（节距 2.0 mm）把通道高度从 6.60 拉到 10.63 mm，是 S 系占地主导项；任务书 §4「二阶真实占地不一定更小」的担心被实测反向否定。

### ③c D8 CMRR 判罚矩阵（门槛 ≥80 dB；MC=L1 n=1000 P1，LTspice=L2 确定性最坏角）

| 配对口径 | S0 | S1 | T1 | T2 | T3 | T4 | 证据 |
|---|---|---|---|---|---|---|---|
| **免配对（模式A R±1%C±5%）** P1 (dB) | 33.7 F | 33.9 F | 33.2 F | 32.9 F | 33.7 F | 32.6 F | `csv/t06_d7_d8_verdict.csv`（L2 角点 28.5–31.8 同判 F） |
| 免配对（模式A R±1%C±1%）P1 (dB) | 44.1 F | 44.1 F | 44.2 F | 43.7 F | 44.5 F | 43.7 F | 同上 |
| **实际配对·各自配**（B2，R·C 异向逐级独立）P1 (dB) | 93.8 P | 94.1 P | 51.5 F | 51.1 F | 54.5 F | 52.8 F | 同上（L2 各自配最坏角 48.2–51.6 同判） |
| **实际配对·整线同 m**（B2L，R1/R2 同偏 + C1/C2 同偏）P1 (dB) | 93.7 P | 93.8 P | **91.2 P** | **90.5 P** | **91.6 P** | **90.7 P** | 同上（L2 配对极值角 110.8–115.7 印证） |
| **Kelvin 口径结构地板**（L2 标称，RC 完美配对亦不可修复）(dB) | 56.31 F | 56.10 F | 56.08 F | 56.08 F | 56.08 F | 56.08 F | 同上（b1–b4 配对极值角实测 Kelvin 恒 ≈56.1） |

- **「免配对不可行」六案一致成立**（沿上一轮一阶定论）。
- **本轮新发现（二阶配对口径）**：二阶 B2「各自配」CMRR 只到 51.1–54.5 dB FAIL——二阶梯形传递函数含 **R1·C2 交叉乘积**，级间独立失配 m 不保持该项（L1 数值实证：T2 各自配极值角 48.2 dB vs 整线同 m 113.4 dB）。「整线同 m」恢复 90.5–91.6 dB PASS。一阶 S0/S1 两口径恒等（无交叉项，自检通过）。
- **Kelvin 口径硬限**：整链 Kelvin CMRR 结构地板 ≈56.08–56.31 dB（六案相同、拓扑决定），**CH1 真实接线（AIN1N 无源 Kelvin RC 直连，无运放隔离）的 D8 口径永远 <80 dB**。D8 及格只能按 CH0（RC 自身）口径判定，或需重新审视 D8 判据对 Kelvin 通道的适用性（沿 fo1 §5.2 定性结论，本轮六方案量化；与 fo1 FO1_BASE 实测 56.31 一致）。
- 「RC 自身」标称舱的 cmdm 输出为求解器数值底（−254~−334 dB，器件完全对称），**真实未配对 CMRR 以容差 MC/角点为准，不以数值底冒充**（CSV caliber_note 已声明）。

---

## ④ Pareto 三行（任务书 §5(8)）

| Pareto 项 | 结论 |
|---|---|
| **最小真实面积** | **T1–T4 并列 32.62 mm²/通道（两通道合围 70.25 mm²）**，比 S0/S1（39.05/39.06、合围 81.85）省 6.43 mm²/通道（−16.5%）。T 系四案同封装同件数（4×R0402+4×C0402+1×C0402），**实测占地完全等同，面积不能区分 T1–T4**，T 内取舍只能按电气。S0 与 S1 亦并列（同 0805 等级，39.05 vs 39.06 为落盘舍入差）。测量口径=铜包围框（焊盘+地过孔+走线外接矩形，内部间距天然包含），184 焊盘+40 过孔+232 走线段逐件读回验证全绿（`aaf_layout_readback.json`/`aaf_layout_verify.json`）；**「真实板内最终落位走线」NOT VERIFIED**（走廊被既有前端 RC 群占据，评测块在板外评测区，属施工阶段）。 |
| **最优电气折中** | **T2**：门槛跨线数并列最多（D2 P）且 D4 余量与抑制量平衡最好——D1=62.33/D2=61.05/D3=94.74 dB（六案第 2/2/3，D3 低于 T4=96.40 与 T3=95.14）、D4 标称 0.4121/A5 角 0.4609（距线 0.039 dB）、**除 D8 外 D5–D10/C9/PM 全 P（D8 仅整线同 m 配对口径 P=90.5 dB；免配对 32.9 与各自配 51.1 均 FAIL，见 ③c）**、绝对宽带噪声第二低（ch0 2758 nV，T4=2734 更低）、折回最坏 318 LSB（二阶最优之一）。T4 电气全列最高（D1/D2/D3=63.53/62.25/96.40）但 D4 A5 角 0.4735 距淘汰线仅 0.027 dB 且 sinc³ 合成只到 −64.2 dB。**注意无论 T2 还是 T4，D1/D3 均 FAIL（见下行）**。 |
| **D1–D3 未满足原因（全六案 FAIL，明说）** | **一阶（S0/S1）与这四个二阶（T1–T4）均不达原规格**。差距量级（对门槛）：D1 差 16.5–41.3 dB（T4 最高 63.53 仍差 16.5；S0 40.68 差 39.3）；D2 一阶差 ~20 dB、二阶 T2–T4 已跨线（60.55–62.25）、T1 差 0.53；D3 差 3.6–41 dB（T4=96.40 差 3.6 最小）。**原因（物理，[解析/理论估算] 层非仿真结论）**：① 无源 RC 梯形滚降上限——二阶实测量级 −40 dB/dec 有效值更低（级间负载 + Cd/Cin 损耗：理想源同参 §3 表 4.096M 仅 57.8–60.1 dB，真实宏模型靠闭环输出阻抗多给 +3 dB 到 60.8–63.5）；② **D4≤0.5 dB 通带约束把 fc 钉死在 ~50–70 kHz**（fc 再低 16k 衰减超线），4.096M/fc ≈ 60–80 倍 ≈ 1.8 dec，两阶理想极限 ~76 dB < 80；16.384M ≈ 2.4 dec 理想 ~95 dB（实测 94–96 已贴上限），仍 <100。**即：D4 与 D1/D3 在无源一/二阶内互斥，参数微调无解。重新设计方向**（均未仿真，供设计决策）：(a) 三阶无源 RC（+1 组 R/CG，占地约 +7–8 mm²/通道，理想 −60 dB/dec 下 4.096M 理论 ~108 dB、扣除损耗后 D1 有望 ≥80 且 16k 衰减可控）；(b) 有源滤波（Sallen-Key/MFB 二阶巴特沃斯改拓扑，Q>0.5 使同 D4 下 fc 更低或同 fc 下高频更陡）；(c) **改口径：D1/D3 由 AAF+sinc³/数字滤波合成承担**——本轮实测合成 4M−16k：T 系 −61.4~−64.2 dB（OSR=32 全局同设、折叠增益按最坏 0dB、孔径衰减未建模），仍未到 −80，需更大 OSR 或 FIR 补齐；(d) 系统级（屏蔽/布局压低实际高频注入幅度——16.384M 族瞬态折回为交流预测的 1.65–8.5 倍，真实风险取决于板级注入）。方向 (a)(b) 属新仿真任务，(c) 属判据口径变更，(d) 属系统对策——**均不改变本轮 FAIL 判罚**。 |

---

## ⑤ 关键问题

1. **混叠抑制是系统级缺口，不是参数问题**：D1/D3 六案全 FAIL（③a）；瞬态折回（T09，100 mV 注入口径）S 系 3280–4269 LSB、T 系 280–372 LSB——二阶把折回压掉一个数量级但仍非零；**二阶 16.384M±8k/±16k 瞬态实测为交流相位模型预测的 1.65–8.5 倍**（相位模型的 P/N 近对消在真实时钟开关电容电路不成立，已以瞬态实测为界，`csv/t09_fold_check.csv`）；全部 4.096M 族与 ±1k 折回与交流预测一致（0.8–1.3 倍）。实际风险取决于板级高频注入幅度（MCLK 16.384M 谐波、SPI 干扰路径），AAF 选型只影响 4.096 MHz 以上。
2. **Kelvin 非对称（CH1 AIN1N 无源 RC 直连）的三重结构性代价**：D1 Kelvin 口径比 opa388 舱低 1.1–2.3 dB（一阶 S0 −2.28 与 fo1 上一轮「−2.3 dB」定量一致）；D8 Kelvin 结构地板 ~56 dB（③c，配对不可修复；t02 kelvin 行的 62 dB 系 0.5V 口径乐观 6.02 dB，真实地板以 ~56 dB 为准，见 ③b 注）；线缆共模 1 V 经 dut 寄生（200 p/端）在 16 kHz 的 CM→DM 转换 **−5.2~−5.5 dB**（per-1V Vint 口径，六方案 −5.23~−5.46 几乎相同；t 侧源阻抗 10k∥150k≈9.4k 与 s 侧恒流环低阻不对称主导；CM 单端直通输出另为 −12.0 dB 附近）——**该共模泄漏必须靠屏蔽/线缆/系统级对策解决，RC 参数与级数均无法改善**（`csv/t02_cm_full.csv` ch0_cmdm_16k_dB 列）。
3. **配对要求（量产工序）**：D8 免配对全 FAIL；一阶配对 R·C 异向各自配即达 93.7–94.1 dB；**二阶必须「整线同 m」四元件选配**（每线 R1/R2 同偏 + C1/C2 同偏），逐级各自配只到 51.1–54.5 dB（交叉项 R1·C2 失配，`csv/t06_d7_d8_verdict.csv`）——二阶配对工序严格度高于一阶，选 T2 即接受该工序。通道间（CH0↔CH1）不配对（D8 只考核同通道 P/N；通道间配对属 Hratio 采购动作，CH0↔CH1 相位失配 @16k 全案 −0.044~−0.045°（`csv/t10_group_delay.csv` CH0_minus_CH1_bench 行）、幅度失配 p99 0.032–0.047 dB（`csv/t06_mc_summary.csv` A5 档 hr_mag_16000 p99，L1 MC）；t03 的 dphi 为 bench_realsrc 口径 −0.057~−1.60°、随源阻抗 rs 变，非通道间舱失配）。
4. **0805↔1210 等效性结论对 S0 的影响——阻断项是料号而非寄生**（证据 `parasitic_0805_0402.md`）：村田全库（mlcc.csv 25,626 行）与 TDK 目录内 **47nF/0805 无 C0G 料号**（0805/47nF 只有 U2J/SL/X7R；U2J=0±750 ppm/℃，ΔT=30℃ 容值漂 ±2.25%，破坏 D8 配对与 D4/C9 精度，**不构成 C0G 替代**）；唯一 C0G 候选 KEMET 25V 档仅 broker 渠道无现货证据。寄生层面 47nF 三档（0805/1206/1210）在 **4.096 MHz 段电气等效**（SRF 均 ≥4.7×fMOD、ESL 修正 <3%）；16.384 MHz 段 0805 档（SRF≈28–29 MHz 双参照）余量 1.7–1.8×，1210 档无官方 SRF（理论 19–21 MHz 仅 1.2–1.3×，ESL>1.47 nH 即跌破 MCLK）**不得默认等效**。**出路（归设计者裁决）**：1206 档 C0G ±5%/±2% 均有量产料号（GRM31M5C1H473JA01 SRF 24.5 MHz、LCSC 现货，±2% 档 GRM31M5C2A473GA01）；或容值改 68nF/0805/C0G（GRM2195C2A683JE01 SRF 27.3 MHz 量产 B，电气覆盖 MCLK 1.67×）。T1–T4 全 0402 前提（10nF SRF 84.5 MHz、820pF 310 MHz、22nF/0805 43.1 MHz）全部成立（22nF/0805 为 S1 前提，最小余量位仍安全）。
5. **S0/S1 面积与电气取舍**：占地等同（③b），电气 S0 全面优于 S1（D1 +1.96/D3 +3.59 dB），但 S0 有料号阻断（上条）→ **S1 比 S0 更无存在理由**；若坚持一阶路线，S0+1206（放宽封装）是唯一在产 C0G 方案，但占地将进一步大于 39.05 mm²/通道。
6. **T4 边界确认**：任务书 §2「T4 专门用来检测边界」预判成立——A5 最坏角 D4=0.4735 dB 距 0.5 线 0.027 dB，量产 C0G 实容差劣于 ±5% 即越线；T2 0.4609 次之。
7. **THD 双口径**：任务书未给 THD 判决门；.four "Total"（0.002–0.0087%）由 4.096M 开关纹波泄漏（=基波 256/4096 次谐波）主导非模拟失真；真 2–10 次谐波 1e-8–2.3e-6%（0.0002–0.038 LSB，全案 ≪1 LSB，24bit 分辨率下不可测；下限 1e-8% = S0@1k，上限 2.3e-6% = T4@16k）。两口径均落 `csv/thd_summary.csv`，未用任一口径换取结论。
8. **过程修正留痕（终版数据已验证）**：tolcm 阶跃初版误为差分、改纯共模重跑后与上轮锚精确一致；T08 节点1 行键名错已修；T09 折回交流预测交叉表初版键冲突已改 (方案,频点)；run_all.py L1 引擎 Cramer 初版误返回中间节点 v1 已修正并在 CSV 留痕。THD 1kHz 仿真 ASCII raw 1.7–2.0 GB/只（raw/ 合计 7.7 GB 已 gitignore）。

---

## ⑥ 数据证据索引

| 类别 | 文件 |
|---|---|
| 冒烟锚定 | `csv/smoke_anchor.csv` |
| AC 族（D1/D3/D4/幅相/Kelvin/整链 CM） | `csv/t01_dm_ac.csv`、`csv/t02_cm_ac.csv`、`csv/t02_cm_full.csv`、`csv/t03_channel_match.csv`、`csv/t10_group_delay.csv`、`csv/l3_sinc3_alias.csv` |
| 瞬态族（D5/D9/THD/折回） | `csv/t04_settling.csv`、`csv/t08_kickback.csv`、`csv/t09_ac_residual.csv`、`csv/t09_fold_check.csv`、`csv/thd_summary.csv`、`csv/tran_metrics.json` |
| 噪声/稳定性族（D6a/C9/PM） | `csv/t05_noise.csv`、`csv/t07_stability.csv`、`csv/t07_load_decomp.csv` |
| 容差族（D7/D8/温度角） | `csv/t06_mc_all.csv`（24,001 行）、`csv/t06_mc_summary.csv`、`csv/t06_ltspice_corners.csv`、`csv/t06_ltspice_summary.csv`、`csv/t06_l1_l2_xcheck.csv`、`csv/t06_d7_d8_verdict.csv`、`csv/t11_corners.csv` |
| 占地评测（EasyEDA） | `layout_area_report.md` + `aaf_layout_plan.json` / `aaf_layout_readback.json` / `aaf_layout_verify.json`（坐标证据替代截图——EasyEDA API 无 PCB 画布导出图接口） |
| 器件寄生 | `parasitic_0805_0402.md`（村田 SimSurfing 官方数据端点 ds.murata.co.jp/simsurfing_data/data/mlcc.zip 解析 25,626 行 + TDK webReader） |
| 波形图 | `plots/`（84 张：t01/t02/t03/t05/t06/t07/t08/t09/t10/t11/thd/l3/smoke 各族） |
| 网表/日志/原始数据 | `netlists/`（5,421 只）、`logs/`（1,116）、`raw/`（gitignore，LTspice 产物判定成功口径） |
| 台架脚本 | `run_all.py`（冒烟+L1）、`ac_family.py`、`tran_family.py`、`run_t05_t07.py`、`t06_t11.py`、`build_metrics.py`（均过 py_compile） |
| 子电路库 | `pkg_subs.inc`（fo_subs.inc 只读移植 + fsfo1/fsfo2） |
| 复用基线（只读） | `../fo1_rc_review/`（本轮零写入，目录 mtime 与 __pycache__ 均为上一轮；OPAx388.LIB md5 本轮复测同源） |

仿真总量：AC 族 72/72、瞬态族 168/168、噪声/稳定族 64/64、容差族 800/800 完成（0 真失败；ltspice-sim 复数 raw 后处理 rc=1 为已知环境缺陷，以 LTspice .log/.raw 判定成功）。

## ⑦ 遗留未测（NOT VERIFIED，不得引用为已测）

1. **PM@温度（−20/+85 ℃，全六方案）**：OPAx388 宏断环 AC 线性化仅在 .temp 25–27 ℃ 窗口正确（30 ℃ 起直流环路增益塌 ~1000×，宏模型缺陷二分实证）——沿用 `../fo1_rc_review/REPORT.md` §7.2，本轮 t11_t2_t85 一跑复核同缺陷；25 ℃×3 轨 PM 已实测（95.85–98.57°）。D4 温度角为 RC 温漂代入（全同向不破坏对称），CMRR@温度角未单列。
2. **整链 .tran 场景**（`full_*_static.net` 只生成过 lint 未运行）：沿用 fo1 REPORT §7.1 遗留口径；本轮 D5/D9/THD/折回均为 3×OPA388 通道台架口径。
3. **ADC 内部噪声数值对比**：.noise 只含无源等效负载（Rin 130k + 5p/端）；系统口径须查 SBAS590E p23 Table 1（手册在 Obsidian 库不在本仓库）——沿用 fo1 REPORT §7.3；解析补充 kT/C_S=√(kT/3.5pF)=34.4 µV/次采样（声明口径非仿真）。
4. **前端源阻抗噪声**（Rsense 150k Johnson、Rtop 分压、TMUX 通路）：范围外六方案共同项未仿真（解析估算 ≈16 µVrms 量级主导通道噪声底但六案相同，不影响横向对比；沿 fo1 t05 note_1）。
5. **运放单体间失配**（Zo/Aol 逐片差异）未建模（宏模型单一参数组）——真实 CMRR 上界可能低于本轮值，未量化。
6. **MC 分布 = 容差带内均匀独立假设**（非实测/截尾分布）；R±100 ppm/℃ 为声明假设（AAF 电阻料号未定稿无实测 TCR），C0G ±30 ppm/℃ 为 spec 指定。
7. **sinc³ 仅 OSR=32 全局同设口径**（任务书 §5 指定），其他 OSR/滤波器档位未测；折叠增益按最坏 0 dB（理想冲激采样）、孔径衰减未建模。
8. **1210 档官方 SRF/ESL 数值**：TDK product.tdk.com 被 Akamai 拒（curl/WebFetch 403），webReader 仅取到规格表——1210 SRF 仅理论估算层（样机需网络分析仪实测回填）；KEMET 0805/47nF/C0G（±1/2%）SRF/ESL 与授权渠道可购性未验证（K-SIM 未访问）。47nF/0805 实器件 SRF≈28–29 MHz 为同封装 U2J 件+68nF C0G 件几何参照值，非该（不存在的）料号实测。
9. **LCSC/DigiKey 库存时效**：沿用 bom_footprint_check.md 2026-10-24 01:20 CST 快照，下单前须复核（E.10 #6 归用户）；本轮未跑 LTspice 分档 D1/D3 复仿（可复用 r5_bom_esl_esr 框架）。
10. **占地评测的 DRC 与真实落位**：DRC 未在副本跑（评测块在板框外，只会产出板框外噪声）；「真实板内最终落位走线」NOT VERIFIED（走廊被既有前端 RC 群占据，属施工阶段；落位建议已给：替换既有前端 RC 群、P/N 行垂直于 U7 AIN 引脚列、避开右侧 SPI 高速区）；无截图（EasyEDA API 限制），以坐标证据替代。
11. **工程级副本**：EasyEDA API 无 copyProject，改用工程内板级副本 PCB1_1（copyPcb）；原 PCB1 与原理图页零改动已读回证实（AAF_* 焊盘数=0）；真·工程副本手动步骤见 `layout_area_report.md` §2.2。
12. **PSRR 交流传递函数未测**（T11 为 DC 轨角；±1.5% 对 D4/d1/PM 影响 <1e-6 dB 系宏模型轨不敏感的模型口径非物理结论，沿 fo1 §7.5）；600 kΩ DUT 工况未扫（8 µA×600k=4.8 V 超 3.3 V 合规栈，系统物理不可运行，沿 fo1 A7）；整链串模群延迟绝对值不可用（OPA333 恒流环低频动力学污染，D10 判罚采舱口径）。

---

*报告完。判罚口径与声明假设详见 `assumptions.md`；复现方法详见 `README.md`。*

---

## 修订记录

### 2026-10-24 独立复核修订（7 条，只改报告不改原始数据文件）

| # | 严重度 | 问题 | 修订 |
|---|---|---|---|
| R1 | medium | ③b「整链线缆共模→DM @16k」误列 CM 单端直通值（−12.12…−12.01 = `ch0_cmout_16k_dB` = V(a0p) 单端）且证据列写错；真 CM→DM 转换（per-1V Vint）为 −5.23/−5.26/−5.40/−5.45/−5.37/−5.46 dB（`ch0_cmdm_16k_dB`，log `cmdm0_16k=−5.234` 佐证），原报告把 DM 泄漏低估 ≈4.8× | ③b 改为两行分列（CM→DM 转换 −5.23…−5.46 + CM 直通对照行 −12.12…−12.01，各标列名）；⑤-2 量级改「−5.2~−5.5 dB」。定性结论（六案几乎相同、须屏蔽/系统对策）两列均成立，判罚不变 |
| R2 | medium | ③a 前言「数值口径全部为 LTspice 实跑」不实：D7 判罚值（MC σ）与 ③c D8 各 P1 值出自 L1 纯 Python 理想源 MC（n=1000，无运放模型） | 前言改「证据层级逐行标注」：L2（LTspice）为默认、D7 行与 ③c MC 值显式标 L1，附 L1↔L2 交叉核对与「不得把 L1 称为 LTspice 结果」；README 同款措辞同步修正 |
| R3 | low | ③b Kelvin CMRR 62.33/62.12/62.10×4（t02 kelvin 行）与 ③c 结构地板 56.31/56.10/56.08×4（t06 c00）并列未说明恒差 6.02 dB 系 0.5V 激励未归一的口径差，读者易把 62 dB 当真实 Kelvin CMRR | ③b 行改列 per-1V spec 口径值（56.31/56.10/56.08×4，`t06_ltspice_corners.csv` c00）并注明 t02 62 dB 口径差来源；明确「真实 Kelvin 地板以 ~56 dB 为准」 |
| R4 | low | ③b「CH0↔CH1 相位失配 −0.044~−0.045°」证据误指 t03（t03 无此值，其 bench_realsrc dphi@16k 为 −0.057~−1.60° 随 rs 变）；⑤-3 幅度失配 p99 出处误标 t03 | 证据改为 `t10_group_delay.csv` CH0_minus_CH1_bench dphi_16k_deg（−0.044/−0.0451/−0.0452×4）与 `t06_mc_summary.csv` A5 hr_mag_16000 p99（0.032–0.047 dB，L1 MC）；数值本身原报告已正确，仅出处修正 |
| R5 | low | T2 排名四处失实：④「D3 六案第 2」实为第 3（T4=96.40、T3=95.14 更高）；① 第 1 名同错；① 第 3 名「T3 D1/D3 略低于 T2」D3 方向反；④「D5–D10/C9/PM 全 P」漏 D8 限定、「绝对噪声最低档」实为 T4 更低（2734 vs 2758 nV） | ①/④ 排名与方向逐处修正（D1 第 2、D3 第 3；T3 D1 略低/D3 反高）；④ 补 D8 限定（仅整线同 m P=90.5）与噪声第二低。推荐 T2 的结论不变（仍由 D2 跨线 + D4 余量 + 占地支撑） |
| R6 | low | 计数/区间端点小误：②「7 个共有角点」实为 6（nom/ch1/tol/tolcm/vhi/vlo；src10k/src120k 为本轮新增、fo1 600k 未跑）；③a 注「8.1–11.3 LSB」下限实为 8.0（S1 ch1=8.033）；⑤-7「6e-8」下限实为 1e-8（S0@1k） | 三处按实测修正（6 角点全同结论不变；8.0–11.3 LSB；1e-8–2.3e-6%） |
| R7 | low | 口径标签与所用值不一致：③a C9 标「取大」实列 ch0 值（真取大 0.694/0.333/0.326/0.333/0.528/0.431）；③a D10 行名「双通道群延迟失配」而值为单通道平坦度（恰合 spec D10 定义）；③b 过冲行 S1 取 ch1、T2 取 ch0 通道混用 | C9 改列 ch0/ch1 取大值（原 ch0 列注明）；D10 行名改「通道群延迟平坦度（单通道 0.1 Hz–16k）」并注 CH1 值 0.115–0.284 亦全过；过冲行改 os ch0/ch1 取大（0/0.0001/0.0007/0.0011/0.0004/0.0013）并附单列值。判定均不变 |

复核证据均经本轮 python csv 严格解析复核（含 `logs/t02_cm_full_s0.log` .meas 实测值、`t06_ltspice_corners.csv` c00 列、`t10_group_delay.csv` 第 10 列 dphi_16k_deg、`thd_summary.csv` thd_h2_10_pct 全 12 行），未改任何 csv/log/netlist 原始文件。
