chenxi-z/de-drms/hardware/sim/signalchain/fo1_rc_review/REPORT.md

# REPORT — ADS131A02 一阶抗混叠 RC 四方案 LTspice 复核（最终报告）

- **日期**：2026-10-24 ｜ **工作目录**：`hardware/sim/signalchain/fo1_rc_review/`
- **任务依据**：`hardware/sim/Zcode_LTspice_一阶RC四方案复核任务书.md` §4–§8
  （门槛：D1≥80 / D2≥60 / D3≥100 dB、D4≤0.5 dB、D5≤900 µs、D6a≤30%、D7 σ≤0.05 dB、
  D8≥80 dB、D9 半周期回稳 0.01%、D10≤5 µs、C9≤6 dB；**未放宽任何门槛**）
- **环境指纹**：LTspice 26.1.1 + wine-11.0（`ltspice-sim status` 实测，ready）、
  TI OPAx388.LIB Final 1.4（md5 `97c4045ef608097ec1f1a67dca97ceae`，与 fs_subs.inc:5 注记一致）。
  证据：`csv/t00_regression.csv` ltspice_version / opax388_md5 行。
- **证据纪律**：本报告所有数值逐条来自本目录 `csv/`（20 个 CSV，13,139 行）、
  `raw/`（525 个 .raw）与 `logs/`（526 个 .log）；解析口径与生成脚本见 §6。
  三层结果（L1 理想 / L2 模拟实际 / L3 系统测量）按任务书 §3.2 分开陈述，不混谈。

---

## 1. 结论摘要

**问题**：`100 Ω + 22 nF + 820 pF`（FO1_A）能否替代现有 `47 Ω + 47 nF + 820 pF`（FO1_BASE）？

**回答：可以替代，且是三个候选中唯一值得采纳的——但必须同时明确：四案（含 BASE）在原规格
D1/D2/D3 上全部 FAIL、未配对 D8 全部 FAIL，这是"一阶拓扑先天不足"而非参数选择问题；
换 FO1_A 不改善也不显著恶化这些 FAIL，其价值是 −51% 占地（−32.0 mm²）换 1–4 dB 的
指标代价，且不触碰任何已 PASS 项的门槛。**

分条依据（全部为本目录实测）：

1. **面积**：FO1_A 双通道 AAF 占地 30.4 mm² vs BASE 62.4 mm²（外廓口径，−51%）；
   47nF/1210→22nF/0805 每件 −8.00 mm²（−63.5%），×4 = −32.0 mm²
   （`bom_footprint_check.md` §4.1/§4.2）。
2. **指标代价（FO1_A 相对 BASE，CH0 opa388 口径，`csv/t01_dm_ac.csv`）**：
   D1 38.72 vs 40.68 dB（−1.96）、D3 59.08 vs 62.67 dB（−3.59）、D2 38.11 vs 40.39 dB
   （−2.28）——三项本来就 FAIL（差 40+ dB），该降幅不改变任何判定。
3. **不触碰已 PASS 项**：D4 0.238 ≤0.5（BASE 0.2234）、D5 最坏角 30.5 µs ≪900、
   D6a 线性口径 CH1 3.31% ≤30%、D7 σ 0.0089 dB ≤0.05、D9 通道判据余量 ≥4×、
   D10 0.126 µs ≤5、C9 0.33 dB ≪6（`csv/t01/t04/t05/t06/t08/t10/t07` 各文件）。
4. **代价点（如实）**：kickback 最坏 45.2 µV（BASE 21.6，×2.1）仍 ≪ 半周期回稳判据；
   4.104 MHz 混叠折回 1215.8 µV/100 mV（BASE 934.8，×1.3）同一量级
   （`csv/t08_kickback.csv`、`csv/t09_ac_residual.csv`）；22nF/0805 LCSC 现货仅
   ±1% 档 521 只（样机 4 只/板够用，量产 ±5% 档需锁 DigiKey 渠道），
   47nF/1210 在 LCSC 今日 0 库存（`bom_footprint_check.md` §0/§1.1/§1.4）。
5. **B/C 不值得**（详见 §4）：B（200Ω+10nF）D1/D2/D3 全垫底、正交口径 D6a 36.78% 超
   30% 淘汰线、kickback 95.3 µV、混叠 1507.7 µV，只为相对 A 再省 10.5 mm²；
   C（100Ω+10nF+6.8nF）虽然未配对 D8 最优（40.6 dB）且占地最小，但 D2 31.2 dB
   （比他案差 5–9 dB）、C_D=6.8nF 在 Kelvin N 线踢峰 182 mV（BASE 7.6 mV 的 24 倍）、
   混叠 2678.2 µV/100 mV（BASE 的 2.86 倍、A 的 2.20 倍）三处独立证据反对。
6. **无论选哪案，D1–D3 的 FAIL 意味着 4.096 MHz 附近防线只剩 PCB 布局与上板实测**
   （§5.1）：每 100 mV 差模注入折回带内，CH0 口径 852–1324 µV（2926–4551 LSB）、
   CH1 口径 1107–1441 µV（3804–4951 LSB，折合 R 误差 923–1201 ppm，最坏单通道不抵消）；
   sinc³ 对折叠后频率仅 −0.003~−0.67 dB 无数字域保护（`REPORT_L3.md` §4）。

**附带发现（任务书前提与事实冲突，需用户裁决）**：任务书称"47 nF C0G 只能取得 1210"，
实测 LCSC 有村田 47nF/1206 C0G（GRM31M5C1H473JA01L，C21812）现货 51,375 只，且生产 BOM
自用 68nF/1206 C0G——**若保留 47Ω+47nF 电路、仅把 C_G 封装 1210→1206，零电路改动省
4.54 mm²/件（−36%）**，占地 44.2 mm² 仍大于 FO1_A 的 30.4 mm²
（`bom_footprint_check.md` §4.2/§5 冲突 C-1）。

---

## 2. 回归表（T00：2026-10-23 锚定 vs 本轮 FO1_BASE 复测）

数据：`csv/t00_regression.csv`（meas 与 ASCII raw 复数插值交叉校验，`raw_crosscheck` 列差 <0.001 dB）。

| 指标 | 2026-10-23 锚定 | 本轮实测 | 偏差 | 容差 | 判定 |
| --- | ---: | ---: | ---: | ---: | --- |
| D1 残留 dB @4.096 MHz | −40.7 | −40.6891 | +0.011 | 2 dB | 复现 |
| D2 残留 dB @4.096 MHz | −46.4 | −46.4104 | −0.010 | 2 dB | 复现 |
| D3 残留 dB @16.384 MHz | −62.7 | −62.673 | +0.027 | 2 dB | 复现 |
| D4 @16 kHz | 0.230 | 0.2234 | −0.007 | 0.1 dB | 复现 |
| 0.01% 建立时间 | ≈21 µs | 20.846 | −0.15 | 2.1 µs | 复现（口径见下） |
| 环路 PM | 98.6° | 98.5678° | −0.032° | 9.86° | 复现（UGF 2786.1 kHz） |

T00 网表与 `aaf_first_order/gen_fo.py` 生成物逐行一致（脚本内自动 diff，仅首行注释不同），
偏差排除口径差异。锚定值出处：`docs/design/spec/2026-10-23-signal-chain-variants.md`:33-38。

**偏差逐条说明（无超差项；三项口径发现如实记录）**：

1. 六项偏差全部远小于容差（最大 |0.027| dB vs 2 dB），无实质性偏差需要解释。
2. **建立时间口径**：gen_fo.py 原 `.meas ts01 WHEN V(pa1,na1)=0.709929 RISE=1` 物理不可达
   （DC 分压 0.999278 使真终值 0.709487 V 低于阈值，且 PWL 极性差分为负向）——本机
   LTspice 26.1.1 实测无 ts01 输出，故 **≈21 µs 锚定值的原始产生口径不可考证**
   （旧 fo_results.json tran 字段为空与此一致）。本轮改用 raw 带外最后出带法（终值 ±71 µV）
   并加极性翻转镜像 tran2 交叉校验：两极性同为 20.846 µs，与锚定 ≈21 µs 及单极点理论
   9.21τ=21.06 µs 三者相容，判复现（`csv/t00_regression.csv` settle_us 行 method/note_4）。
3. `.meas AC mag()` 在 26.1.1 输出 dB 元组而非线性幅度——gen_fo.py:103 正则不匹配即旧
   fo_results.json ac_dm/ac_cm 空字段根因（本轮实测确认并修复解析器）。
4. `ltspice-sim run` 对 AC 复数 ASCII raw 行后处理崩溃 rc=1——LTspice 仿真本体已完成
   （.log 含 elapsed time + 完整 .meas，.raw 完整 3722 点），台架以 LTspice 产物判定
   成功，rc 如实记为环境 note（`csv/t00_regression.csv` note_1–3）。
5. L1 理想基准独立交叉：任务书 §2 表 12 数值与按公式重算全部一致（最大相对偏差
   0.0066%，末位舍入级）；2 节点复数 MNA 第二路径在闭式 fc 处 |H|=−3.0103 dB 验证
   C_DM=C_G+2C_D、fc_CM=1/(2πR·C_G) 两式自洽（`csv/l1_ideal_rc.csv`，
   `maxFcDeltaPct`=0.0066）。

---

## 3. 四案总表（D1–D10 / C9 / 幅相 / 共模 / Hratio / CMRR / kickback / ADC 加载 / 噪声 / 占地）

**口径**：D1/D2/D3/D4 用 **CH0 opa388 台架口径**（与 T00 锚定同口径，激励直接挂被测节点对，
任务书 §3.3 H 定义）；D1/D3 另列 CH1 Kelvin 真实接线（AIN1N 无源 RC 直通）。衰减量
= |残留 dB|。判定栏 = 该指标门槛判定（门槛见报告头）。
**D7/D8 主值分层声明**：表中 σ 与 P1 主值是任务书 §4 T06 规定的第一层——**纯 Python
线性 RC 蒙特卡洛（L1 层，n=1000 均匀独立，`csv/t06_mc_summary.csv`），非 LTspice 实跑**；
第二层 LTspice ≥30 组确定性角点（`csv/t06_ltspice_summary.csv`，实跑）数值见行内判定栏
与 §5.4，两层结论一致（任务书 §3.2「三层不得混为一谈」，此处如实分层标注）。

### 3.1 主判定表（L2 LTspice 实跑为主；D7/D8 主值 = L1 线性 MC，已逐行标注）

| 指标（证据 CSV） | 门槛 | FO1_BASE | FO1_A | FO1_B | FO1_C | 判定 |
| --- | --- | ---: | ---: | ---: | ---: | --- |
| D1 衰减 dB @4.096M，CH0（t01） | ≥80 | 40.68 | 38.72 | 37.53 | 38.71 | **四案 FAIL** |
| D1 同上，CH1 Kelvin（t01） | ≥80 | 38.40 | 37.55 | 36.80 | 37.55 | FAIL（Kelvin 比对称再差 2.3 dB） |
| D2 衰减 dB @4.096M，CH0（t02） | ≥60 | 40.39 | 38.11 | 36.24 | 31.23 | **四案 FAIL**（C 因共模 fc 159 kHz 最差） |
| D3 衰减 dB @16.384M，CH0（t01） | ≥100 | 62.67 | 59.08 | 56.53 | 59.07 | **四案 FAIL** |
| D3 同上，CH1 Kelvin（t01） | ≥100 | 52.86 | 52.58 | 51.86 | 52.57 | FAIL |
| D4 模拟段@16k dB（t01） | ≤0.5 | 0.2234 | 0.238 | 0.2304 | 0.2373 | **四案 PASS**（未达满分 ≤0.05） |
| D5 0.01% 建立最坏角 µs（t04，600k） | ≤900 | 29.884 | 30.476 | 30.342 | 30.455 | **四案 PASS**（标称 20.8–21.7 µs） |
| D6a 线性口径最坏 %（t05，CH1） | ≤30 | 1.56 | 3.31 | 6.55 | 3.31 | **四案 PASS**（r4 冻结口径） |
| D6a 正交口径同项 %（t05 note_3） | ≤30 | 17.73 | 25.95 | **36.78** | 25.95 | B 超 30% 淘汰线（判罚维持线性口径，两口径并列，见 §5.4） |
| D7 σ@16k dB，L1 MC n=1000 A5（t06_mc_summary） | ≤0.05 | 0.00864 | 0.00885 | 0.00849 | 0.00893 | **四案 PASS**（LTspice 31 角点 σ 0.012–0.017 实跑亦 PASS） |
| D8 未配对 P1 dB，L1 MC n=1000 A5（t06_mc_summary） | ≥80 | 34.0 | 34.0 | 34.6 | 40.6 | **四案 FAIL**（±1% 档 44.2–50.7 仍 FAIL；LTspice 实跑最坏失配角 31.7–38.4 dB 同判 FAIL） |
| D8 R·C 异向配对 P1 dB，L1 MC 模式 B（t06_mc_summary） | ≥80 | 93.9 | 93.8 | 94.3 | 100.5 | **四案 PASS**（D8 官方考核条件，spec:78；工艺代价见 §5.4） |
| D9 通道判据最坏 rel（t08，全部 Ron/vcm 角） | ≤0.01 | 1.07e-5 | 1.33e-5 | 2.27e-5 | 1.82e-5 | **四案 PASS**（余量 ≥4.4×；字面 ownss 判据 na1 脚退化，见 §5.3） |
| D10 Δτ 0.1Hz–16k µs，CH0（t10） | ≤5 | 0.116 | 0.126 | 0.119 | 0.125 | **四案 PASS**（满分线 ≤1 亦过） |
| C9 跟随器输出峰 dB（t07） | ≤6 | 0.69 | 0.33 | 0.17 | 0.33 | **四案 PASS** |

### 3.2 幅相 / 共模 / Hratio / 实际 CMRR / kickback / ADC 加载 / 噪声 / 占地

| 项（证据 CSV） | FO1_BASE | FO1_A | FO1_B | FO1_C |
| --- | ---: | ---: | ---: | ---: |
| 差模 fc kHz（CH0 opa388，t01；L1 理论见 l1_ideal_rc） | 70.47 (69.62) | 67.76 (67.32) | 68.75 (68.37) | 67.88 (67.44) |
| 8k 幅/相 dB/°（t01 opa388） | −0.0632 / −6.60 | −0.0741 / −6.81 | −0.0854 / −6.70 | −0.0739 / −6.80 |
| 16k 幅/相 dB/°（t01 opa388） | −0.2297 / −13.02 | −0.2514 / −13.44 | −0.2571 / −13.23 | −0.2506 / −13.42 |
| 单线共模 16k 衰减 dB（t02 cm_16k_resid，L1 参考列） | −0.2093 | −0.2075 | −0.1723 | −0.0437 |
| Kelvin CM→DM @16k dB（t02 cmdm_16k） | −56.51 | −56.32 | −56.22 | −56.21 |
| Kelvin 结构 CMRR_RC 通带最差 dB（t02，≈15.9 kHz） | 56.31 | 56.10 | 55.99 | 55.99 |
| Hratio 幅度 p-p dB（t03 real_src，1k–16k） | 0.0005 | 0.0004 | 0.0004 | 0.0004 |
| Hratio 相位差 max °（t03 real_src） | 0.6506 | 0.6517 | 0.6522 | 0.6517 |
| Hratio 相位差 °（ideal0ohm，RC 方案本征） | 0.044 | 0.045 | 0.046 | 0.045 |
| MC 未配对 Hratio@16k σ_mag dB / σ_ph °（t06_mc_summary A5） | 0.0147 / 0.426 | 0.0148 / 0.420 | 0.0139 / 0.407 | 0.0131 / 0.379 |
| MC 配对后同项（B2） | 0.0006 / — | 0.0013 / — | 0.0027 / — | 0.0110 / — |
| PM ° / UGF MHz（t07 loop_ch0；25 ℃） | 98.57 / 2.79 | 96.93 / 4.60 | 97.32 / 6.31 | 96.93 / 4.60 |
| 瞬态过冲 %（t07 os_ch0） | 0.0 | 0.0001 | 0.0 | 0.0001 |
| kickback 踢峰 µV（t08 ron100/vcm0.6，worst 脚 na1） | 21.6 | 45.2 | 95.3 | 73.7 |
| kickback 残余最坏 LSB（t08，vcm2/na1 角） | 43.3 | 53.8 | 91.0 | 73.4 |
| CH1 静态差分增益误差 %（t08 dm_ss_v vs 理想，时钟运行） | −0.18 | −0.38 | −0.75 | −0.38 |
| 噪声宽带 nV(rms) / LSB（t05，CH0 / CH1） | 3301/11.3 ｜ 2352/8.08 | 3255/11.2 ｜ 2338/8.03 | 3321/11.4 ｜ 2421/8.32 | 3257/11.2 ｜ 2341/8.04 |
| 噪声带内 nV(rms) CH0（t05 vn_inband） | 1245 | 1255 | 1273 | 1255 |
| 4.104 MHz 混叠折回 µV/100 mV（t09 phased；瞬态拟合 t09_fold） | 934.8 (950.5) | 1215.8 (1238.0) | 1507.7 (1533.9) | 2678.2 (2728.7) |
| 16.384M±16k 残存 dBc（t09） | −62.7 | −59.1 | −56.6 | −59.1 |
| CH1 电流使能踢峰 mV（t04 ch1 note，C_D 耦合 na1） | 7.6 | 15.9 | 33.3 | **182.3** |
| 占地 mm²（双通道外廓，bom §4.2） | 62.4 (1210) ｜ 44.2 (1206 变体) | 30.4 | 19.9 | 19.9 |
| 器件可采购性（bom §0） | 1210：LCSC 0 库存 ⚠️；1206：51,375 只 | 0805：±1% 档 521 只（窄） | 0603：207,500 只 | 0603：85,750+4,600 只 |

**PM@温度角（t11）**：OPAx388 TI 宏模型断环 AC 线性化仅在 .temp 25–27 ℃ 窗口正确
（30 ℃ 起直流环路增益塌 1000×，二分实证 .temp 26 好/30 坏，与方案/RC 无关，归因宏模型
缺陷）——PM 温度趋势 **NOT VERIFIED**，仅交付 25 ℃ PM。D4 温度角（−20/85 ℃：
0.221/0.227 dB @BASE 等，`csv/t11_corners.csv`）全部来自代入的 RC 温漂
（C0G ±30 ppm/℃、R ±100 ppm/℃ 声明假设），运放交流参数无温度建模。供电轨 ±1.5%
（3.2505/3.3495 V）对 D4/幅相/PM 影响 = 0（loop 曲线逐点差 0.00e+00）。

---

## 4. 方案排序

### 4.1 原规格合格性排序（与面积无关，只看判据）

**四案在原规格下等价不合格**：D1（差 40+ dB）、D2（差 20–29 dB）、D3（差 37–44 dB）、
D8 未配对（差 34–46 dB）全 FAIL；D4/D5/D6a(线性)/D7/D9/D10/C9 全 PASS。门槛一分未放宽。

在 FAIL 项内部的**相对优劣**（数值见 §3.1/§3.2）：

| 排名 | 方案 | 依据 |
| --- | --- | --- |
| 1 | **FO1_BASE** | D1/D2/D3 五项口径全面最优（D1 40.7、D3 62.7、D2 40.4）；kickback 最小（21.6 µV）；混叠残存最低（934.8 µV/100 mV）；建立最快（20.8 µs）；C9 最大（0.69 dB）但 ≪6 dB |
| 2 | **FO1_A** | 各项仅劣于 BASE 1–4 dB；与 C 在 D1/D3 互有 ±0.01 dB 级差别；无独立硬伤 |
| 3 | **FO1_C** | 未配对 D8 最优（40.6 dB）、占地最小——但 D2 31.2 dB（比他案差 5–9 dB）、C_D 踢峰 182 mV、混叠 2678 µV（BASE 的 2.86 倍）三处独立证据反对；配对后 Hratio σ 反而四案最大（0.011 dB，C_D ±5% 失配不在配对范围） |
| 4 | **FO1_B** | D1/D2/D3 全垫底、正交 D6a 36.78% 唯一超 30% 淘汰线、kickback 95.3 µV 最大、CH1 静态增益误差 −0.75% 最大、混叠 1508 µV；无一项第一 |

### 4.2 面积约束下的建议（任务书 §5.2 视图，与合格性分开陈述）

| 方案 | 占地 | 相对 BASE | 建议与代价 |
| --- | ---: | ---: | --- |
| FO1_BASE（1210） | 62.4 mm² | — | 指标最优但 47nF/1210 LCSC 0 库存（走 DigiKey/预订） |
| FO1_BASE′（**1206 变体**） | 44.2 mm² | −29% | **任务书外发现**：零电路改动、现货 51,375 只；是否采纳归用户（冲突 C-1） |
| **FO1_A（0805）** | **30.4 mm²** | **−51%** | **建议采纳**：−32.0 mm² 换 D1 −2.0 / D3 −3.6 / D2 −2.3 dB（均在 FAIL 区内不改变判定）+ kickback ×2.1（仍余量 750×）+ 混叠为 BASE 的 1.30 倍（同量级）；采购面窄（±1% 档 521 只现货） |
| FO1_B（0603） | 19.9 mm² | −68% | 不建议：相对 A 边际收益仅 10.5 mm²，代价是全垫底的 D1/D2/D3 + 正交 D6a 超线 + kickback ×4.4 + ADC 负载最重（200 Ω×130 kΩ 分压 −0.75%） |
| FO1_C（0603） | 19.9 mm² | −68% | 不建议（除非 D8 未配对是唯一决策维度）：D2/D3 恶化 + 182 mV Kelvin 线踢峰 + 混叠为 BASE 的 2.86 倍 + 配对后 Hratio 散布反增 |

**明确声明（任务书 §5.2 纪律）："面积上更合适"不等于"原指标通过"——四案 D1/D2/D3/D8(未配对)
FAIL 保留；采纳 FO1_A 是在既定一阶架构内的取舍，不是规格达标。**
若 D1–D3 的 80/60/100 dB 是硬性不可谈的要求，则结论是"**一阶不满足需求，须重新设计**"
（回到多阶或差分有源结构），本轮四个候选无一例外。

---

## 5. 关键问题

### 5.1 4.096 MHz 附近混叠风险（L3 有界评估，非"已验证混叠"）

- **机理实测**：4.096M±{1k,8k,16k} 经理想 fMOD 冲激采样折叠回 {1,8,16} kHz，sinc³
  (OSR=32) 对折叠后频率仅 −0.003/−0.17/−0.67 dB ≈ **无数字域保护**，防线只剩模拟 RC
  （`REPORT_L3.md` §4，`csv/l3_hratio_alias.csv` B_alias 块）。
- **模拟残存（三条独立路径收敛）**：T09 AC 28 频点实测、T09 瞬态采样序列×sinc³ 拟合
  （fit_over_pred_phased 0.9974–0.9994）、L3 斜率修正外推（与 T09 实测最大偏差
  0.034 dB）——每 100 mV 差模注入折回带内（`csv/l3_hratio_alias.csv` B_alias 块，
  4.08–4.112 MHz 七频点×两通道）：**CH0 口径 852–1324 µV（2926–4551 LSB、折合 R 误差
  710–1104 ppm）；CH1 口径（最坏单通道不抵消）1107–1441 µV（3804–4951 LSB、
  923–1201 ppm）**。分方案（CH1，AC 幅度口径）：BASE 1107–1201 最低 < A 1220–1323 ≈
  C 1221–1324 < B 1328–1441 最高；相位修正口径（下条）则 C 最高。
- **真实接线特有（T09 相位翻转发现）**：两侧 S1 反相采样使 Kelvin N 线馈通在采样序列中
  变号——混叠幅度 = |P+N| 而非 AC 的 |P−N|：BASE 950.5 / A 1238 / B 1534 / C 2728.7
  µV/100 mV；相位修正预测与折叠瞬态 LSQ 拟合四案相差 <0.3%。**C 案瞬态折叠实测比
  未相位修正的朴素 AC 预测大 2.36 倍**（`csv/t09_fold_check.csv` fit_over_pred=2.3558；
  BASE/A/B 仅 1.03–1.16），根因 C_D=6.8nF 加剧 Kelvin N 线馈通；16.384M=4×fMOD 族无翻转。
- **上板必测（唯一关闭路径）**：16.384 MHz 晶振/时钟走线远离模拟前端与 Kelvin 线、
  C_D 靠 ADC 引脚、模拟区完整地平面；首板灌 4.104 MHz/16.392 MHz 定幅音实测输出折叠。
  孔径衰减（手册无规格）与真实调制器非理想未建模——真实幅度只可能低于本界。
- fMOD 附近引脚耦合需 **<≈11 µV（FO1_C，折回传输最大）～<≈33 µV（FO1_BASE）** 才能压到
  1 LSB 以下（按 1 LSB=0.291 µV ÷ 相位修正折回传输系数换算，覆盖 4.08–4.112 MHz
  七频点：BASE 30.4–33.1 / A 23.4–25.4 / B 18.9–20.5 / C 10.6–11.5 µV，
  `csv/t09_ac_residual.csv` alias_phased_uv_at100mV 列）。

### 5.2 AIN1N Kelvin 接地非对称（真实接线，非理想化四运放）

- Kelvin 真实接线比对称 CH0 口径再差：D1 40.7→38.4、D3 62.7→52.9（BASE）——AIN1N 无源
  RC 直通是**结构性代价**（`csv/t01_dm_ac.csv` kelvin 行）。
- Kelvin 结构 CMRR_RC 通带最差 56.0–56.3 dB @≈15.9 kHz（四案几乎相同，由拓扑决定、RC
  参数几乎不影响），cmdm_1k≈−79.9 dB 处于 80 dB 临界（`csv/t02_cm_ac.csv`）；
  对称口径的 ≈300 dB 为求解器数值底（器件完全对称），**不能作为 D8 达标证据**——真实
  散布由 T06 给出（§3.1）。
- 比值链最大的带内误差源是 Kelvin CM→DM：16 kHz 处 1279–1327 ppm/V、8 kHz 667–700
  ppm/V，比差模 Hratio 误差大一个量级（`REPORT_L3.md` §3）；绝对量取决于 PCB/地系统，
  待上板标定。
- 对称口径（ideal/opa388 CH0）的 CMRR 未配对散布须 T06 ≥1000 组容差 MC（已做，
  §3.1），本报告不冒充。

### 5.3 16 kHz 双通道幅相误差

- 通带内 H0/H1 幅度差 ≤0.0005 dB、相位差 ≤0.66°（1k–16k，real_src 口径；
  `csv/t03_channel_match.csv`）。**0.65° 失配由样品 47 kΩ 源阻抗×运放输入电容引入
  （CH0 特有，ideal0ohm 仅 0.045°），非 Kelvin 结构（通带内贡献 ≤0.046°）、非四案 RC
  差异（四案互差 ≤0.0001 dB / 0.002°）**。
- sinc³ 在 Hratio=H0/H1 中精确消去（全局 OSR 两通道同设；复数乘除演示残差 <2e-15 dB）；
  **例外警告：固件若单通道改 OSR/滤波配置，此消去不再成立**（`csv/l3_hratio_alias.csv`
  A_hratio 块）。
- 高阻样品（600 kΩ）下 CH0 源阻抗致相位失配会更大，L3 未逐一外推（t04/t10 部分覆盖）。

### 5.4 是否需要匹配/标定（D8 结论）

- **未配对量产（模式 A）四案全 FAIL**：C±5% MC P1=34.0–40.6 dB、LTspice 确定性最坏
  失配角 31.7–38.4 dB（阈 80）；C±1% 仍 FAIL（P1 44.2–50.7）。**原报告"一阶免配对"
  不成立**（`csv/t06_d7_d8_verdict.csv`）。
- **R·C 乘积异向配对（模式 B，spec:78 官方考核条件 R×(1+m) 配 C×(1−m)，1% 单体）四案
  PASS**：MC P1=93.8/93.8/94.3/100.5 dB。工艺成本：每板 2 对差分线 4 组 R·C 乘积需
  LCR 实测配对（1 kHz、0.1% 级仪表）+ SMT 前分档工时；C_D 不在配对范围。
- 验证路径：首板 T 点注共模（2 V DC+AC）实测 CM→DM 泄漏 @10 Hz–16 kHz，或首件 LCR
  复测装后乘积失配（spec:103 已要求 BOM 加配对工序）。
- **D6a 双口径分歧（判罚维持规格字面线性口径，两口径并列未删）**：正交（物理功率叠加）
  口径 √(n1²−n3²)/n3 下 fo1_b CH1=36.78% 超 30% 淘汰线（原因：CH1 单运放底噪 √2 低于
  CH0 叠加、2×200 Ω Johnson 最大）；但其宽带总噪声 2421 nV=8.32 LSB 与他案同量级，
  是相对底噪占比问题而非绝对噪声恶化（`csv/t05_noise.csv` note_3）。

### 5.5 其余如实记录的口径问题

- **C9 锚定不等**：2026-10-23 文档 FO1 C9=+1.4 dB，本轮跟随器输出节点实测 +0.69 dB
  （t00 foll_pk 独立交叉一致）→ +1.4 dB 锚定产生口径不可考证；判定不受影响（四案
  0.17–0.69 dB ≪6 dB，`csv/t07_stability.csv` note_3）。
- **D9 字面判据退化**：Kelvin AIN1N 脚 v_ss≈0.9–6.5 mV 近地，0.01%·v_ss 低至 0.1–0.6 µV
  低于物理/数值地板 → ownss 判据 19/40 行 FAIL；按物理主判据（残余≤0.01%·通道差分稳态
  ≈1.17 V）四方案×全部 Ron/vcm 组合 PASS（最差 2.266e-5，余量 ≥4.4×）。双判据在 CSV
  并列保留，未删除 FAIL 行（`csv/t08_kickback.csv`）。
- **CH1 静态差分增益误差**（ADC 输入电流经 RKB+RKN 的 DC 模型 + 开关电容并存口径）：
  时钟运行时 dm_ss 读数偏低 BASE −0.18% / A·C −0.38% / B −0.75%；CH0 两线同为跟随器
  驱动、误差同构，**比值测量 R=Vsample/VRsense 大部分抵消**，绝对通道精度影响归
  T03/T06 族跟进（`csv/t08_kickback.csv` dm_ss_v 列、`csv/t04_settling.csv` ch1 行）。

---

## 6. 数据证据（命令与文件链接）

### 6.1 执行环境与批量入口

- LTspice 批处理：`~/.local/bin/ltspice-sim run <net>`（内部 `LTspice.exe -b -ascii`，
  cwd=网表目录；同文件 flock 排他、不同文件可并行——四方案独立 .net 并行批跑）。
- 台架脚本（全部 `python3 <脚本>` 实跑，`if __name__=="__main__"` 入口）：
  - `run_all.py` — T00 回归与网表生成/lint（`python3 run_all.py t00`）
  - `ac_family.py` — T01/T02/T03/T10 四方案 AC 批跑+解析
  - `tran_tests.py` — T04/T08/T09 瞬态族
  - `run_stab.py` — T05 噪声 + T07 稳定性
  - `t06_t11.py` — T06 容差（MC+LTspice 角点）+ T11 温度/供电角
  - `l3_hratio_alias.py` — L3 离线 sinc³ 后处理（非 LTspice 数字内核）
- 产物规模（2026-10-24 实测 `find`）：`netlists/` 内 **530 个 .net**（该目录共 2,545 个
  文件，另含 LTspice 就地运行产物 .log 526、.raw 1,040、.db 448、.gitkeep 1）、
  `raw/` 525 个 .raw、`logs/` 526 个 .log、`csv/` 20 个 CSV 13,139 行、`plots/` 51 张
  PNG（gitignore 不入库，靠脚本再生）。

### 6.2 逐项证据索引（结论 → 文件）

| 结论 | 证据 |
| --- | --- |
| T00 六项回归复现 + 三项口径发现 | `csv/t00_regression.csv`；`raw/t00_fo1_base_*.raw`、`logs/t00_*.log` |
| L1 理想基准公式/表格一致（0.0066%） | `csv/l1_ideal_rc.csv` |
| D1/D3/fc/16k/8k 幅相/peaking（CH0+CH1+ideal 三口径） | `csv/t01_dm_ac.csv`；`plots/t01_*_dm_bode.png` |
| D2/CM→DM/CMRR_RC（三口径） | `csv/t02_cm_ac.csv`；`plots/t02_*_cm_leak.png` |
| Hratio 幅相（ideal0ohm/real_src） | `csv/t03_channel_match.csv`；`plots/t03_*_hratio.png` |
| D5 建立（nom/ch1/tol/tolcm/600k/vlo/vhi） | `csv/t04_settling.csv`；`plots/t04_*` |
| 噪声/D6a 双口径/逐器件归属 | `csv/t05_noise.csv`；`plots/t05_*_noise_density.png` |
| D7/D8 判定矩阵（A1/A5/B2 + LTspice 角点） | `csv/t06_d7_d8_verdict.csv`、`csv/t06_mc_summary.csv`、`csv/t06_mc_all.csv`（12,001 行）、`csv/t06_ltspice_corners.csv`（157）、`csv/t06_ltspice_summary.csv`、`csv/t06_l1_l2_xcheck.csv`；`plots/t06_*` |
| PM/UGF/C9/过冲 + 断环方式声明 | `csv/t07_stability.csv`（note_1 断环口径）；`plots/t07_*` |
| D9 kickback（Ron 1/100/1k × vcm 0/0.6/2.0，双判据） | `csv/t08_kickback.csv`；`plots/t08_*_kick_wave.png` |
| 高频注入残差/折叠（28 频点 + 瞬态拟合） | `csv/t09_ac_residual.csv`（65 行）、`csv/t09_fold_check.csv`；`plots/t09_*` |
| D10 群延迟 | `csv/t10_group_delay.csv`；`plots/t10_*_groupdelay.png` |
| T11 温度/供电角 + 宏模型 .temp 缺陷归因 | `csv/t11_corners.csv`（status_loop 列）；`plots/t11_corner_scan.png` |
| L3 Hratio/混叠/CM 系数/sinc³ 锚点自证 | `csv/l3_hratio_alias.csv`（137 行）、`REPORT_L3.md` |
| T12 BOM/占地/SRF | `bom_footprint_check.md`（含 LCSC/DigiKey 链接与快照时间） |
| 一致性校验（.meas log ↔ ASCII raw 复数插值） | 各 CSV `meas_vs_raw*` / `raw_crosscheck` 列（差 <0.001 dB） |

### 6.3 一致性与环境口径（如实）

- `ltspice-sim run` 对 AC 复数 ASCII raw 后处理崩溃 rc=1 为**已知环境缺陷**（T00 记录、
  四族复现）：全部仿真的 LTspice 本体均完成（.log 含 elapsed + 完整 .meas，.raw 完整），
  台架以 LTspice 产物判定成功，rc 不冒充失败也不掩盖。
- LTspice 26.1.1 `.meas AC ph()` 输出为 dB 元组，解析器已实现换算并经 raw 交叉验证
  （ph_16k=(22.294dB,180°)→−12.94° ≈ 理论 −12.91°）。
- **L1↔L2 交叉对拍（证据版本状态如实声明）**：交付的 `csv/t06_l1_l2_xcheck.csv` 是
  L1 引擎 6 dB 共模激励归一 bug **修复前**的版本——其失配角 64 行 l1−l2 = −5.99～
  −301.6 dB（如 BASE m3 角 l1=39.22 vs l2=33.23 dB，即 pre-fix L1 CMRR 偏高 ~6 dB），
  对称角行落于求解器数值底，**不能作为「修复后一致」的证据引用**；且现版 `t06_t11.py`
  已不含 xcheck 写出代码，该 CSV 无法由交付脚本再生（历史产物）。「修复后
  max|Δ|=0.034 dB」的一致性结论来自**外部独立复核**对 `raw/t06_fo1_base_A5_m3_{dm,cm}.raw`
  的直接复算（修复后 L1=33.20 vs L2=33.23 dB），本报告如实引用该复算结果并声明其
  非本目录脚本产物。差模 `atten16k` 对拍不受该 bug 影响：max|Δ|=0.00018 dB
  （156 角，同文件 diff_atten 列），可继续引用。
- `csv/t08_kickback.csv` 的 `vcm_v` 列把 vcm=2.0 V 角误记为 0.002（解析器对标签 vcm2
  误除 1000；网表 `t08_*_vcm2.net` 实为 `Vcm vcmn 0 DC 2`，四案同）——原数据文件
  未改动，行数据与判定有效，引用时以标签/网表为准（报告文字「vcm 扫 0/0.6/2.0 V」
  与网表一致）。

---

## 7. 遗留 / 未测（不隐瞒，逐项列）

**模型/仿真边界（本轮已声明、未能闭环）**：

1. **整链场景网表已生成未运行**：`netlists/full_fo1_{base,a,b,c}_static.net`（+`fo_subs.inc`，
   静态 lint 过）——恒流源环路 + K1–K4 时序 + δ0/k 校准的整链 .tran 场景未跑
   （logs/ 无 full_* 记录）；本轮 T01–T03 为通道台架 AC、T04/T08/T09 为台架瞬态，
   含恒流源环路的整链响应未验证。
2. **PM@温度角 NOT VERIFIED**：OPAx388 宏模型断环 AC 线性化仅在 25–27 ℃ 正确
   （二分实证），PM 温度趋势不报告；运放 Aol/GBW/Zo 无 TEMP 建模（库内唯一 TEMP 引用
   = VOS_DRIFT）——T11 温度效应仅含代入的 RC 温漂（R ±100 ppm/℃ 为声明假设，AAF 电阻
   料号未定稿无法取实测 TCR）。
3. **ADC 内部噪声数值对比 NOT VERIFIED**：.noise 只含无源等效负载；系统口径须查
   SBAS590E p23 Table 1 @fMOD=4.096M/OSR=32——手册在 Obsidian 库不在本仓库，本轮未取得。
   解析补充（声明口径）：kT/C_S=√(kT/3.5pF)=34.4 µV/次采样。
4. **前端源阻抗噪声未仿真**（范围外共同项）：Rsense 150 kΩ Johnson（解析估算 ≈16 µVrms
   量级、主导通道噪声底）对四方案相同，不影响方案对比。
5. **PSRR 交流传递函数未测**：T11 为 DC 轨角点口径（Vcc 无 AC 激励）。
6. **Ron 与 ADC 采样电容复位电位 vcm 均无手册值**（SBAS590E grep 0 命中，
   r5_datasheet_facts.md:158）：Ron 扫 1/100/1000 Ω、vcm 扫 0/0.6/2.0 V 全部标注声明假设。
7. **600 kΩ 高源阻抗角**按 r5 V9f 家法建模为跟随器输入侧串联 600 kΩ；8 µA×600 kΩ=4.8 V
   超 3.3 V 合规栈，**该 DUT 值在系统里不可运行**（任务书 §3.1 允许记录来源）。
8. **共模 AC 直流工作点取台架口径 2 V**：整链真实共模（CH0≈2.4 V / CH1≈0.6 V）对宏模型
   小信号参数的偏置依赖未专项扫描。
9. **sinc³ 数字内核为手册闭式实现**（四锚点过：f3dB 33487.6 Hz、8k −0.1675、16k −0.6726、
   DC 群延迟 11.3525 µs），非 LTspice 直接仿真 ADC 数字内核；128 kSPS 抽取后完整数字
   行为未仿真。

**PCB / 实物层（仿真不可证明，首板必测）**：

10. **PCB 寄生**：布线电感/过孔/地平面不连续未建模；SRF 为理论估算（ESL 档位法），
    47 nF 档对 MCLK 仅 ×1.2–1.3 余量——接地回路 <3 mm + 多过孔 + 网分实测 SRF/ESR 回填。
11. **真实 ADC THD/线性度/ENOB、输入阻抗实况**：宏模型为线性小信号等效，无失真建模。
12. **射频耦合与实物 EMC**：T09 仅传导注入有界评估；辐射抗扰、地弹、时钟谐波辐射未涉及。
13. **混叠上板注入实测**（唯一关闭路径，§5.1）：4.096M±{1k,8k,16k}、16.384M±{1k,8k,16k}
    定幅注入读码字；双通道同注量比值抵消残余验证保守度。
14. **Kelvin CM→DM 绝对量标定**：板上共模注入（E 点对地干扰）量实测系数（§5.2）。
15. **温度实物测试**：−20/85 ℃ 实物扫（模型侧已被 #2 限制）。
16. **库存时效**：T12 全部库存为 2026-10-24 01:20 CST 快照，下单前必须复核
    （E.10 #6 归用户）；47 nF 封装档选择（1210 vs 1206）与 22 nF/0805 量产渠道归用户裁决。

---

### 附：与 2026-10-23 报告的关系

本轮为**环境/口径回归 + 四方案全量实测**，不推翻任何既有定性结论：D1–D3 一阶先天不足
的 FAIL 维持（2026-10-23 报告同判）；"免配对"结论被 T06 推翻（模式 A 全 FAIL）；
C9=+1.4 dB 与建立 ≈21 µs 两个锚定的原始产生口径不可考证（本轮以可复现口径重测并
交叉验证）。所有改判均有 CSV 证据支撑，未以任何口径调整换取指标通过。

---

## 修订记录（2026-10-24 第二版：独立复核 8 条，全部修订于报告文本，原始数据文件未改动）

| # | 位置 | 问题 | 修订内容 |
| --- | --- | --- | --- |
| 1 | §3.1 表头/口径段 + D7/D8 行 | 表头原宣称「L2，全部为 LTspice 实跑」，但 D7/D8 主值（σ 0.00864…/P1 34.0…/93.9… dB）实为纯 Python 线性 RC 蒙特卡洛（L1 层，`csv/t06_mc_summary.csv` n=1000），非 LTspice 实跑 | 表头与口径段改为分层声明（L2 为主、D7/D8 主值 = 任务书 §4 T06 第一层 L1 MC）；D7/D8 三行证据标注改为 t06_mc_summary 并在判定栏补 LTspice 实跑角点值（σ 0.012–0.017 / 最坏失配角 31.7–38.4 dB）。判定本身不变（两层结论一致） |
| 2 | §6.3 | 原文称「提交数据为 6 dB 归一 bug 修复后版本（csv/t06_l1_l2_xcheck.csv）」——经核该 CSV 实为**修复前**版本（失配角 64 行 l1−l2 = −5.99～−301.6 dB，BASE m3 角 l1=39.22 vs l2=33.23；实测 `awk`/`python` 复核），且现版 t06_t11.py 无 xcheck 写出代码、文件不可再生 | §6.3 改写为如实版本：交付 CSV 为 pre-fix 历史产物、不能作修复后证据；「修复后 max\|Δ\|=0.034 dB」注明引自外部独立复核对 raw/t06_fo1_base_A5_m3_{dm,cm}.raw 的直接复算（非本目录脚本产物）；差模 atten16k 对拍（max\|Δ\|=0.00018 dB，156 角）不受该 bug 影响、继续引用。README.md 对应表同步修正 |
| 3 | §6.3（新增注记） | `csv/t08_kickback.csv` vcm_v 列把 vcm=2.0 V 角误记为 0.002（解析对标签 vcm2 误除 1000；实测网表 `t08_*_vcm2.net` 为 `Vcm vcmn 0 DC 2`，vcm_v 列 tally {0.0:8, 0.002:8, 0.6:24}） | 原数据文件不改；§6.3 加注声明列单位错误、行数据与判定有效、引用以标签/网表为准（报告正文「0/0.6/2.0 V」与网表一致，无判定影响） |
| 4 | §1 条 5、§4.1 C 行、§4.2 A/C 行、§5.1 | 「×2.4/×2.36」未写基线且与他处「×1.3」基线混淆。实测复算：C/BASE=2.865、C/A=2.203、A/BASE=1.301、B/BASE=1.613；「2.36」实为 t09_fold_check.csv 的 fit_over_pred=2.3558（C 案瞬态折叠/未相位修正 AC 预测之比，BASE/A/B 仅 1.03–1.16） | 跨方案倍数统一写明基线（「BASE 的 2.86 倍/1.30 倍」）；「×2.36」改为「C 案瞬态折叠比未相位修正 AC 预测大 2.36 倍（fit_over_pred=2.3558，BASE/A/B 仅 1.03–1.16）」 |
| 5 | §1 条 6、§5.1 | 「852–1441 µV = 2925–4949 LSB = 710–1201 ppm（CH1 口径）」低端混入 CH0 端点。实测（l3 B_alias 块分组复算）：CH0 口径 852–1324 µV/710–1104 ppm，CH1 口径 1107–1441 µV/923–1201 ppm | 拆为两口径分列（含 LSB 换算 2926–4551 / 3804–4951），并补分方案 CH1 排序（BASE 1107–1201 < A≈C < B 1328–1441；相位修正口径下 C 最高） |
| 6 | §5.1 末条 | 「耦合需 <3–11 µV」无法由所引文件复现。按 1 LSB=0.291 µV ÷ 相位修正折回传输系数复算（4.08–4.112 MHz 七频点）：BASE 30.4–33.1 / A 23.4–25.4 / B 18.9–20.5 / C 10.6–11.5 µV，系「11–31 µV」数字错排 | 改为「<≈11 µV（FO1_C）～<≈33 µV（FO1_BASE）」，附四案频点范围与换算公式 |
| 7 | §6.1（+README 顶部） | 产物计数错误：实测 `find` netlists/ 内 .net 仅 530 个（目录共 2,545 文件，含 LTspice 就地产物 .log 526/.raw 1,040/.db 448）；plots/ PNG 51 张（原写 2,536/57） | 按 2026-10-24 实测口径改写两处 |
| 8 | §3.1 D4 行 | FO1_C 写 0.2372（kelvin 行值），该行口径 CH0 opa388 应为 0.2373（t01_dm_ac.csv 复核） | 改 0.2373（0.0001 dB，判定不变） |

**修订原则**：仅改报告文本对齐真实 CSV/log/网表/文件系统实测，未修改任何原始数据文件
（含带缺陷的 `t06_l1_l2_xcheck.csv` 与 `t08_kickback.csv` vcm_v 列，其缺陷以注记方式
如实声明）；所有修订值经本轮 `find`/`awk`/`python` 复算验证。§8 答案表（已提交）中
FO1_C 的 D4 0.2372 同源笔误，以本表第 8 条为准。
