chenxi-z/de-drms/docs/protocol/host-integration.md

# 上位机接入指南

供上位机开发者和接续工作的 agent 使用。固件与上位机独立开发，当前尚无上位机程序。本文概述设备工作流及接入现状；消息号、类型、单位、CRC 和测试字节以[CDC v2 协议](de-drms-cdc-v2.md)及[机器定义](../../shared/protocol/de-drms-cdc-v2.json)为准。

## 设备规划与现状

- **使用场景**：双电极电阻监测，依据用户主动建立的基线 R₀ 计算 R/R₀，再按试件的区间配置判断等级。客户阈值和基线稳定容限需要实测标定，不应由客户端臆造。
- **本机交互**：设备没有显示屏，使用两个按键和五个 LED。开机自动监测，不自动记录；无卡仍可监测，有可用 TF 卡才可开始记录。按键和 CDC 均可发起记录，结束后继续监测。USB 断开不应自动终止本机记录。
- **本机验证过的固件能力**：CDC v2 支持握手、状态/操作/记录查询、开始和结束记录、配置读取与修改、基线、参考校准、校时、文件列表和下载、MSC 导出/交还、安全停止、恢复监测，以及 CURVE 周期订阅（`SUBSCRIBE` opcode 64）；具体条件和异步结果以[协议现状](de-drms-cdc-v2.md)为准。模拟测试通过不等于板卡实测通过。
- **尚未接通**：RAW 原始流订阅（显式返回 `INVALID`，不做降级）、故障事件优先发送、USB 固件升级。CURVE 订阅已可用但只做过短时单次验证，客户端仍应以 `GET_STATUS` 轮询为主、订阅为可选加速，依据新鲜度和有效标志显示结果，不能把旧等级当作当前状态。
- **存储互斥**：记录期间不下载历史文件、不导出 MSC；MSC 导出期间继续监测但不能开始记录。本机和上位机共用同一张卡的所有权由固件裁决，客户端应处理 BUSY、失败和介质代次变化。
- **当前卡记录实测（2026-11-12）**：64 kSPS 连续约 68.65 s、4,393,647 帧，记录/采集丢失为零并正常收尾；16/32 kSPS 各约 26.6 s 通过。限定条件与文件核验见[固件实测记录](../../firmware/DE-DRMS-Code/README.md#高速记录吞吐排查与修复2026-11-12)，不能外推其他卡或模拟精度。
- **实物仍需验证**：USB 枚举与拔插、TF 卡读写和持续吞吐、采样完整性、模拟精度及 SRAM4 使用等。协议能力或软件配置成功不代表实测性能达标。

## 客户端工作流

| 工作流 | 客户端责任 |
| --- | --- |
| 接上设备 | 打开 CDC、置 DTR，发送 HELLO。读取硬件身份、启动标识、会话和能力列表，再用 GET_STATUS 建立初始视图。相同设备可多次重启，端口名不能作设备编码。 |
| 打开已有试验 | 按快照中的 record 查询 GET_RECORD。允许记录来自物理按键。进入界面只是观察，不隐式开始、停止或接管试验。 |
| 发起或结束记录 | 分别用 BEGIN_RECORD、END_RECORD；结束请求携带目标记录号。保存请求编号和返回的操作、记录标识。受理后按事件或 GET_OPERATION 查结论；GET_RECORD 查整场试验。显示文件关闭情况和采样损失两项结果。 |
| 超时、重连 | 同会话内原编号重发必须保持内容一致。重连先握手、查快照，比较启动标识。确认同一次启动后可按原业务标识查询，先前未收到回复的启动动作不能自动重放。订阅按新会话重新建立。 |
| 显示读数和曲线 | 默认通过 GET_STATUS 读取有效电阻、基线、区间状态和新鲜度，过期时撤销正常等级。可选用 `SUBSCRIBE`（stream=CURVE）按实际返回周期接收 MEAS_EVENT，按 `sequence`/`lost` 识别缺口，重连后重新订阅；RAW 订阅尚不可用，收到 `INVALID` 时回落到轮询。 |
| 修改配置 | 先读完整配置及版本，带期望版本提交修改。分别展示运行版本和已保存版本；版本冲突先重新读取。记录期间配置修改会被拒绝。 |
| 取历史文件 | 记录空闲时用 FILE_LIST/OPEN/READ/CLOSE，按介质代次校验、绝对偏移读块；或显式 MSC_EXPORT/RELEASE 交接只读磁盘。解析内容按[BIN 文件规格](../design/2026-11-06-record-v2-format.md)识别版本。 |

## U 盘切换交互（2026-11-12 已确认，客户端待实现）

采用**用户发起、客户端自动编排**，固件执行互锁和实际交接。
插入 USB、打开客户端或重连均不自动导出，不打断本机记录。

- **“打开 U 盘”**：记录空闲且没有冲突文件访问时发送 MSC_EXPORT，跟踪操作并核对介质就绪；记录中提示先结束记录，不自动替用户发送 END_RECORD。
- **“交还设备”**：停止客户端磁盘访问，先安全卸载电脑端 MSC 磁盘/卷，再发送 MSC_RELEASE；保持 CDC 通道。卸载被占用时提示关闭文件重试，不强制交还。
- **界面确认**：已受理显示处理中，GET_OPERATION 与 GET_STATUS 确认重挂载完成且介质可用后才显示可记录；超时、失败显示真实状态，不能把电脑端卸载成功当作设备接管成功。
- **自动恢复**：设备有供电时物理拔线，由固件安全撤销导出并尝试收回；成功后不自动记录。USB 唯一供电时按掉电/重新启动处理。USB 挂起、CDC 关闭和磁盘空闲不作为收回依据；复位/取消遵守固件既有规则。

完整边界及验收条件见[MSC 交接交互策略](../design/2026-11-05-msc-design.md#交接交互策略2026-11-12-用户确认)。
当前已有 EXPORT/RELEASE 固件命令；本文按钮、电脑端卸载及异常提示是后续上位机实现要求，不能标为已交付界面。

联调可先用机器定义里的四条向量核对编解码，再回放一条“设备已由按键开始记录”的状态序列，覆盖中途连接与重连。真实 USB 枚举、DTR、拔插及磁盘交接须与支持对应能力的固件联测。现有 ASCII 调试口不能用于验证 v2 互通。

进一步了解业务需求和交互，可阅读[设备行为与验收](../spec/device-behavior.md)；了解记录文件解析，可阅读 [BIN v2 格式](../design/2026-11-06-record-v2-format.md)。固件内部线程与模块规划见[固件架构](../design/2026-11-05-firmware-architecture.md)，其中目标设计不能直接当作已交付能力。

[角色索引](../README.md)
