chenxi-z/de-drms/docs/design/diagram/frontend-ads131a02-final@2x.png

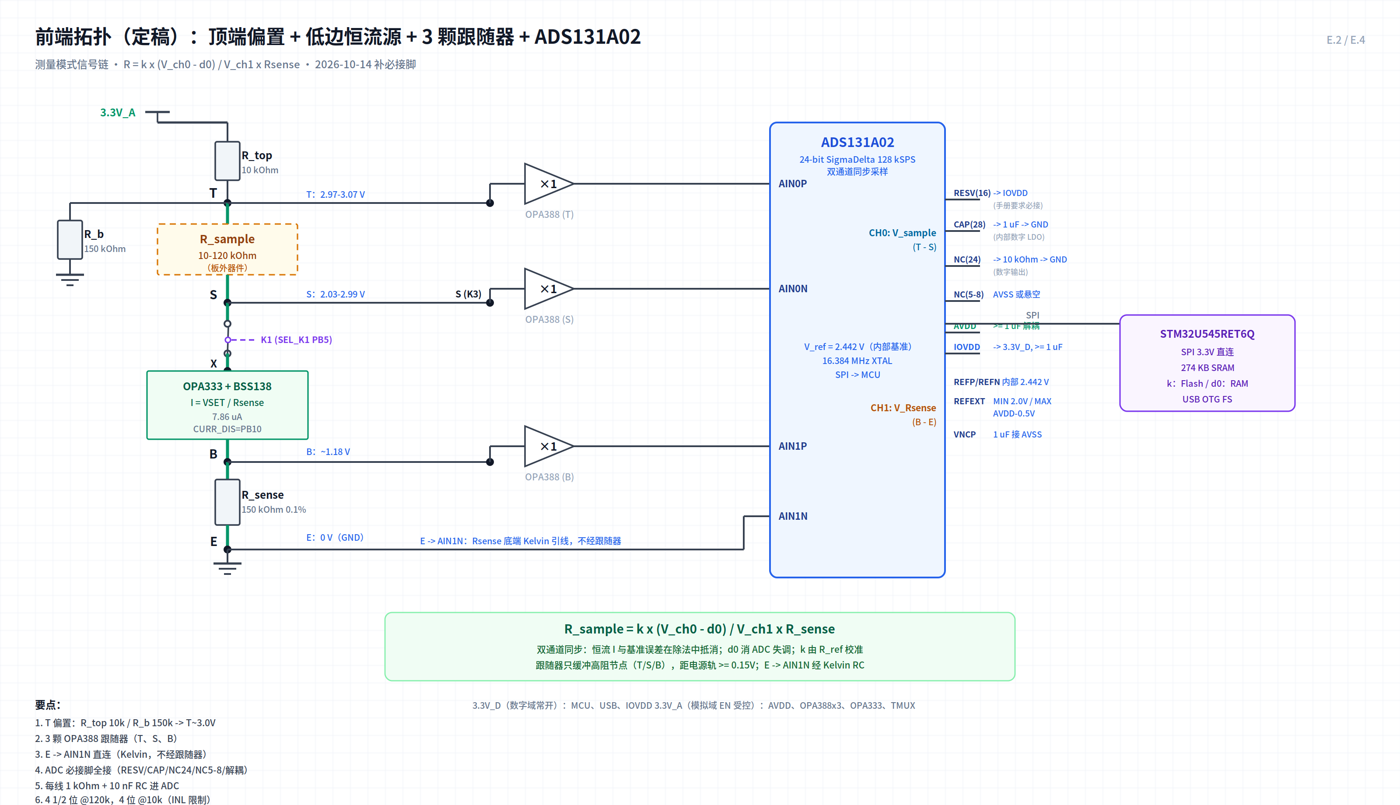
docs/design/diagram/frontend-ads131a02-final@2x.png
