chenxi-z/de-drms/docs/design/diagram/system-block-diagram@2x.png

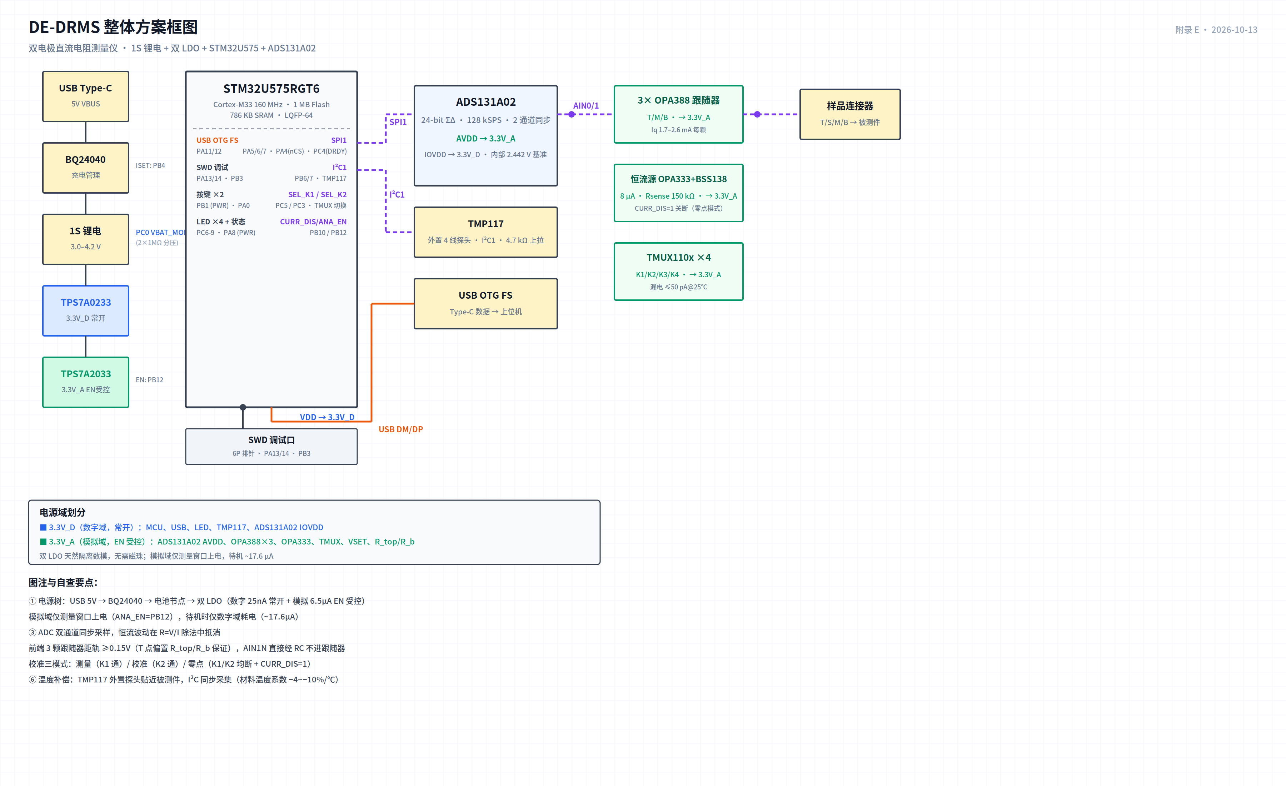
docs/design/diagram/system-block-diagram@2x.png
