chenxi-z/de-drms/docs/design/diagram/一阶方案影响对比@2x.png

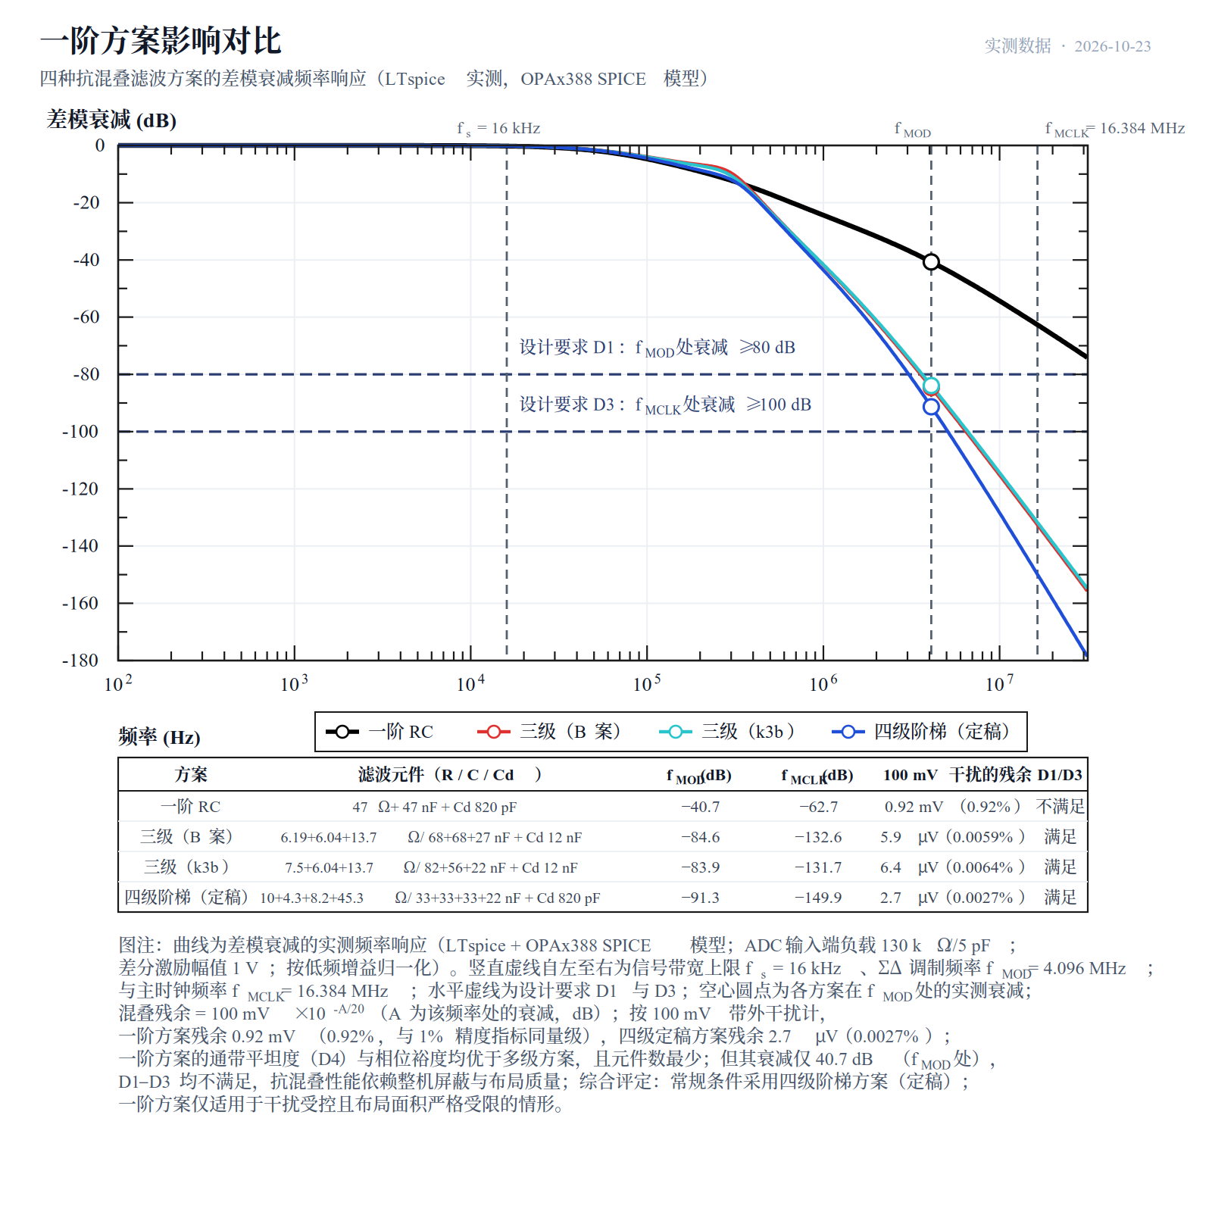
docs/design/diagram/一阶方案影响对比@2x.png
