chenxi-z/de-drms/docs/design/diagram/两电极四线制接法@2x.png

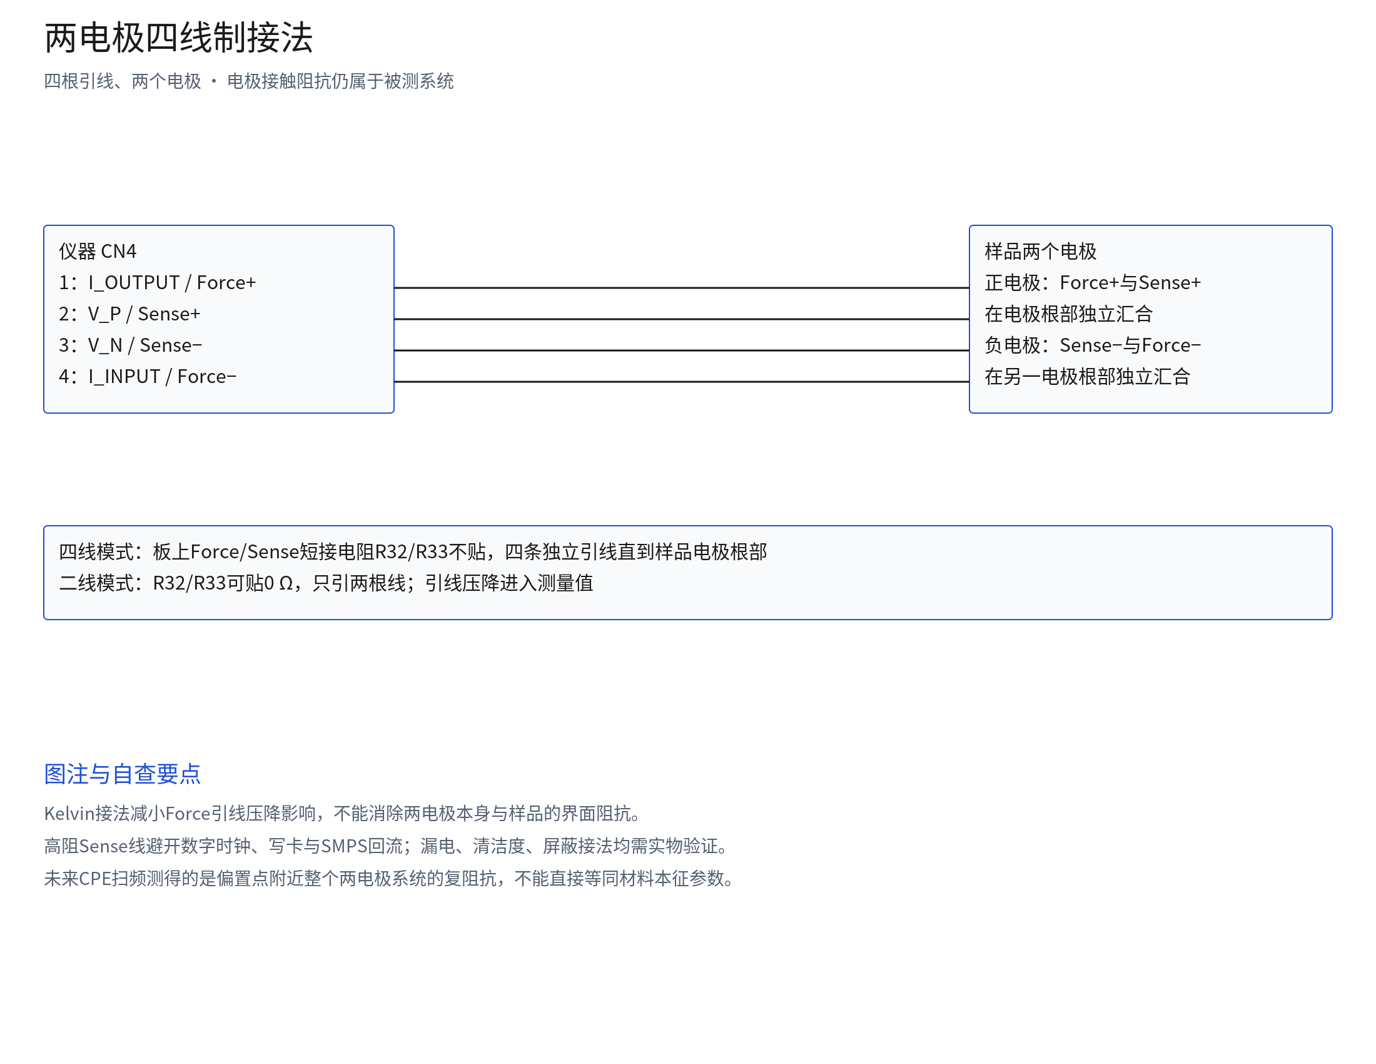
docs/design/diagram/两电极四线制接法@2x.png
