chenxi-z/de-drms/docs/design/diagram/四线制前端接法@2x.png

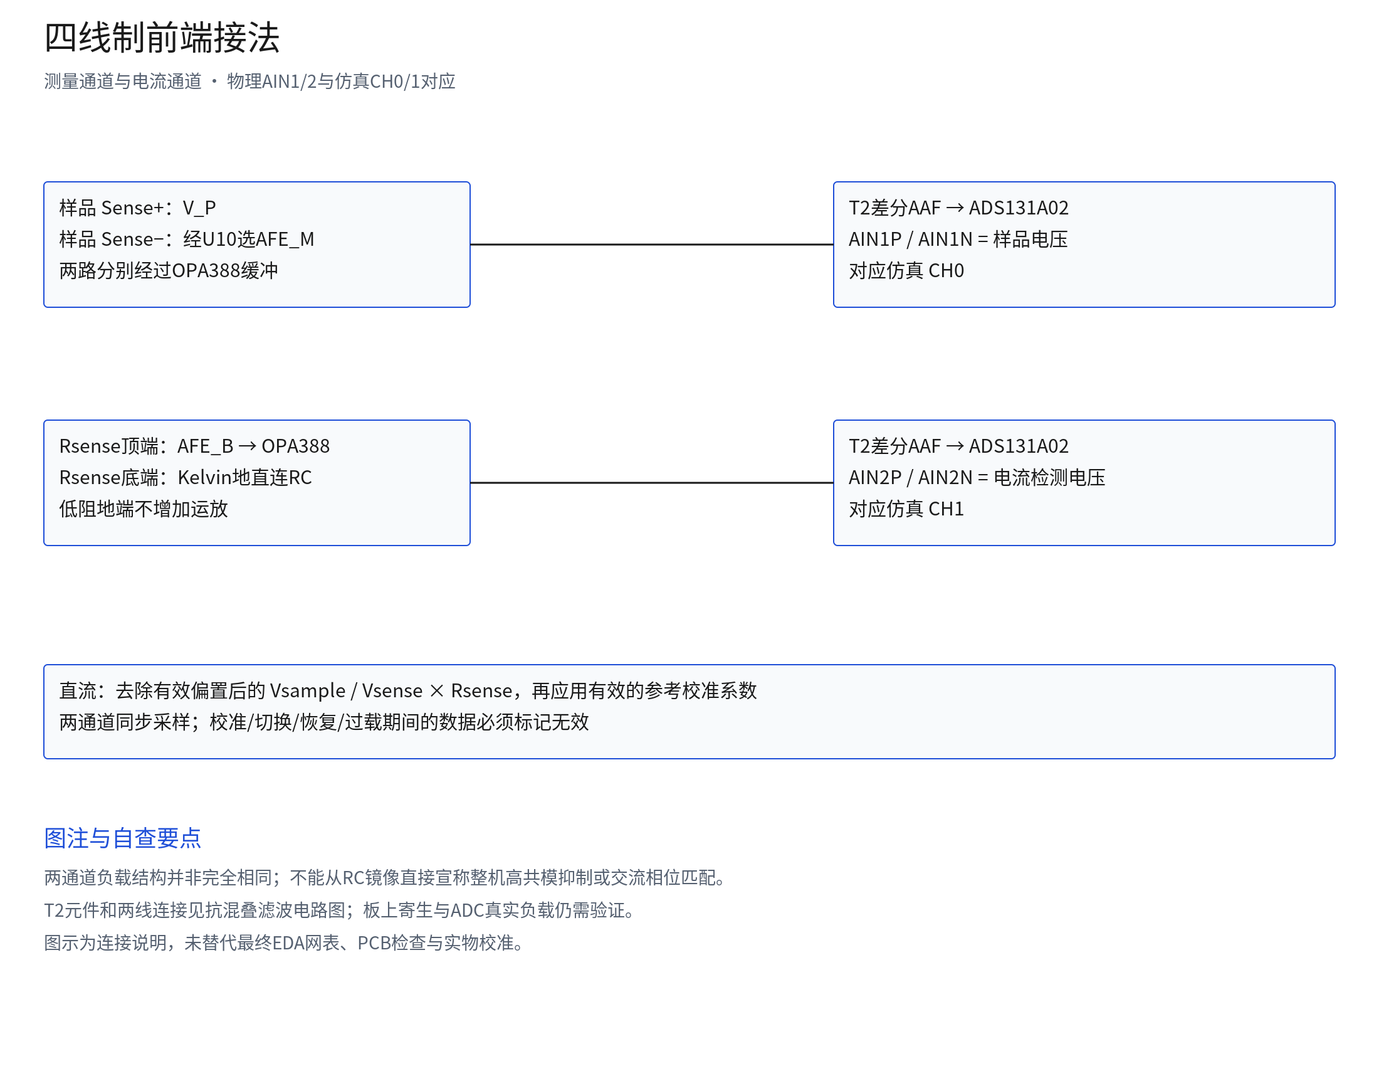
docs/design/diagram/四线制前端接法@2x.png
