chenxi-z/de-drms/docs/design/diagram/固件任务架构@2x.png

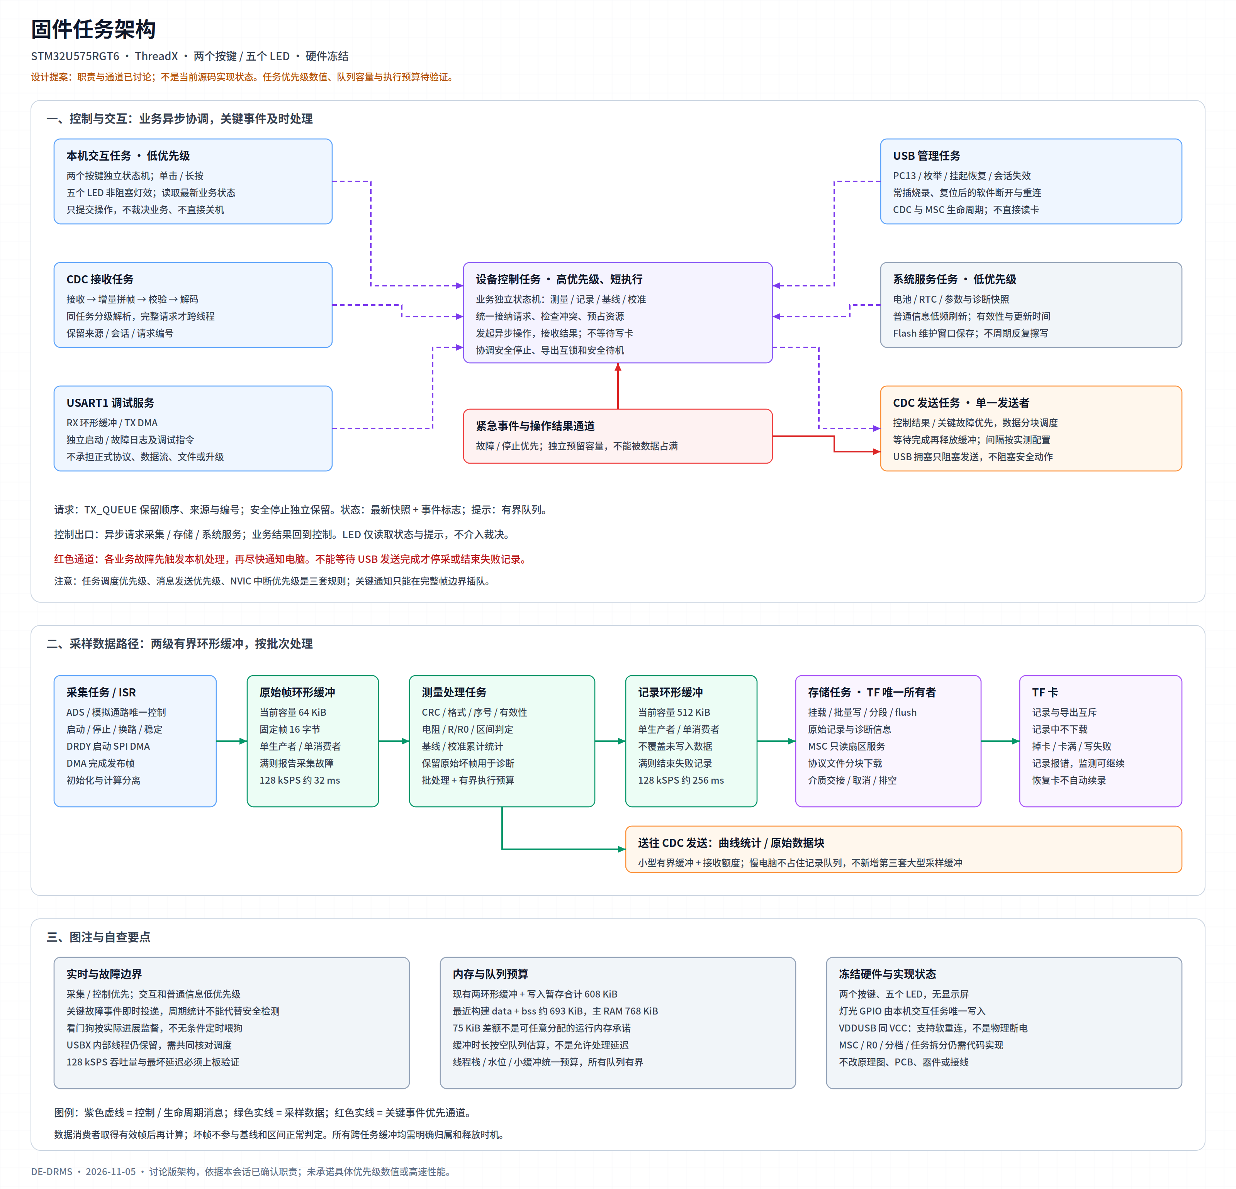
docs/design/diagram/固件任务架构@2x.png
