chenxi-z/de-drms/docs/design/diagram/恒流源拓扑@2x.png

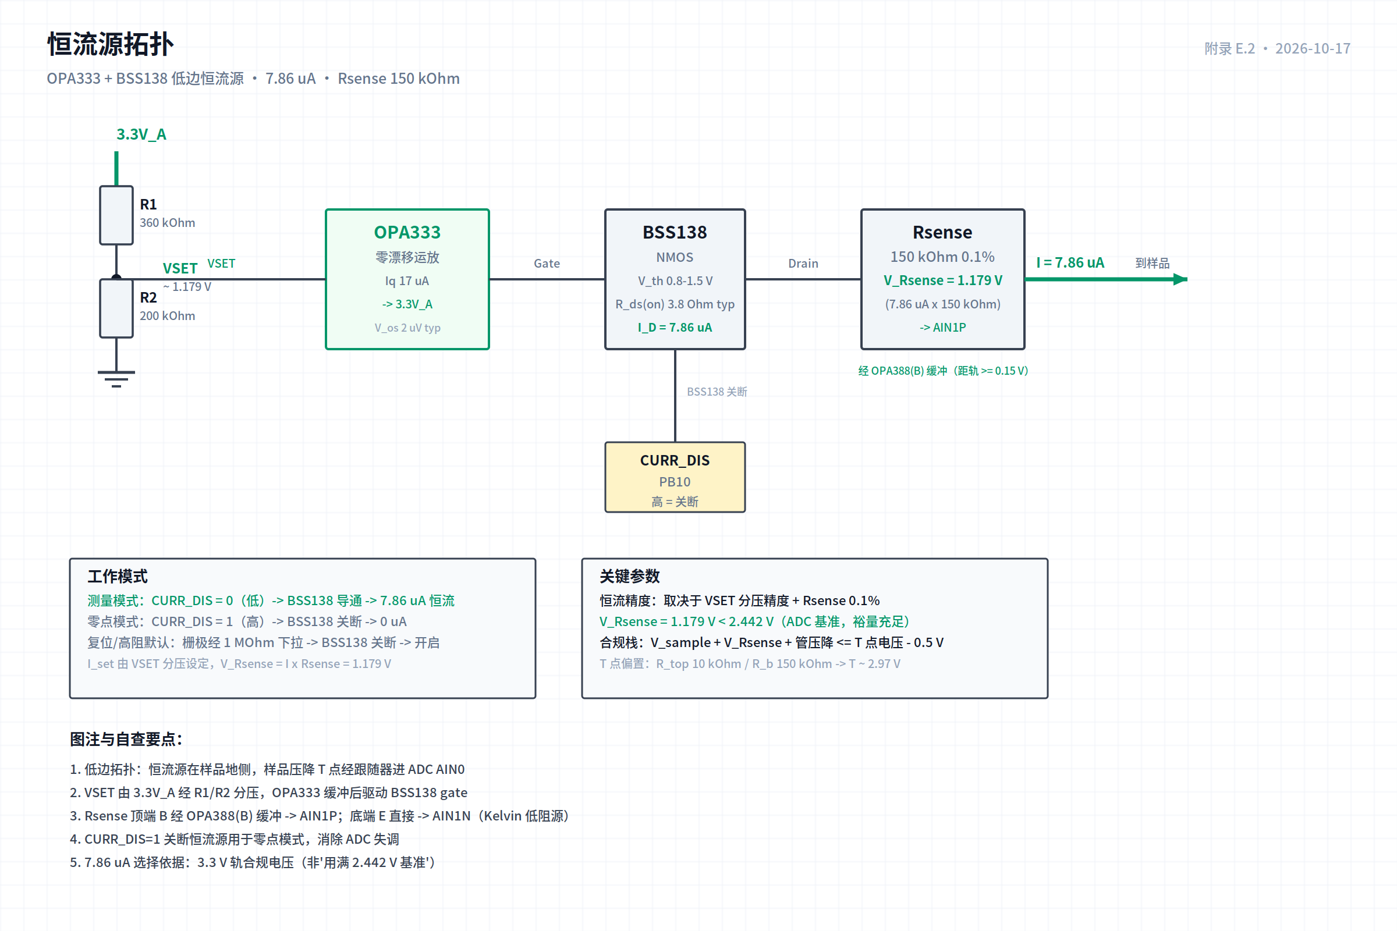
docs/design/diagram/恒流源拓扑@2x.png
