chenxi-z/de-drms/docs/design/diagram/恒流源电路图@2x.png

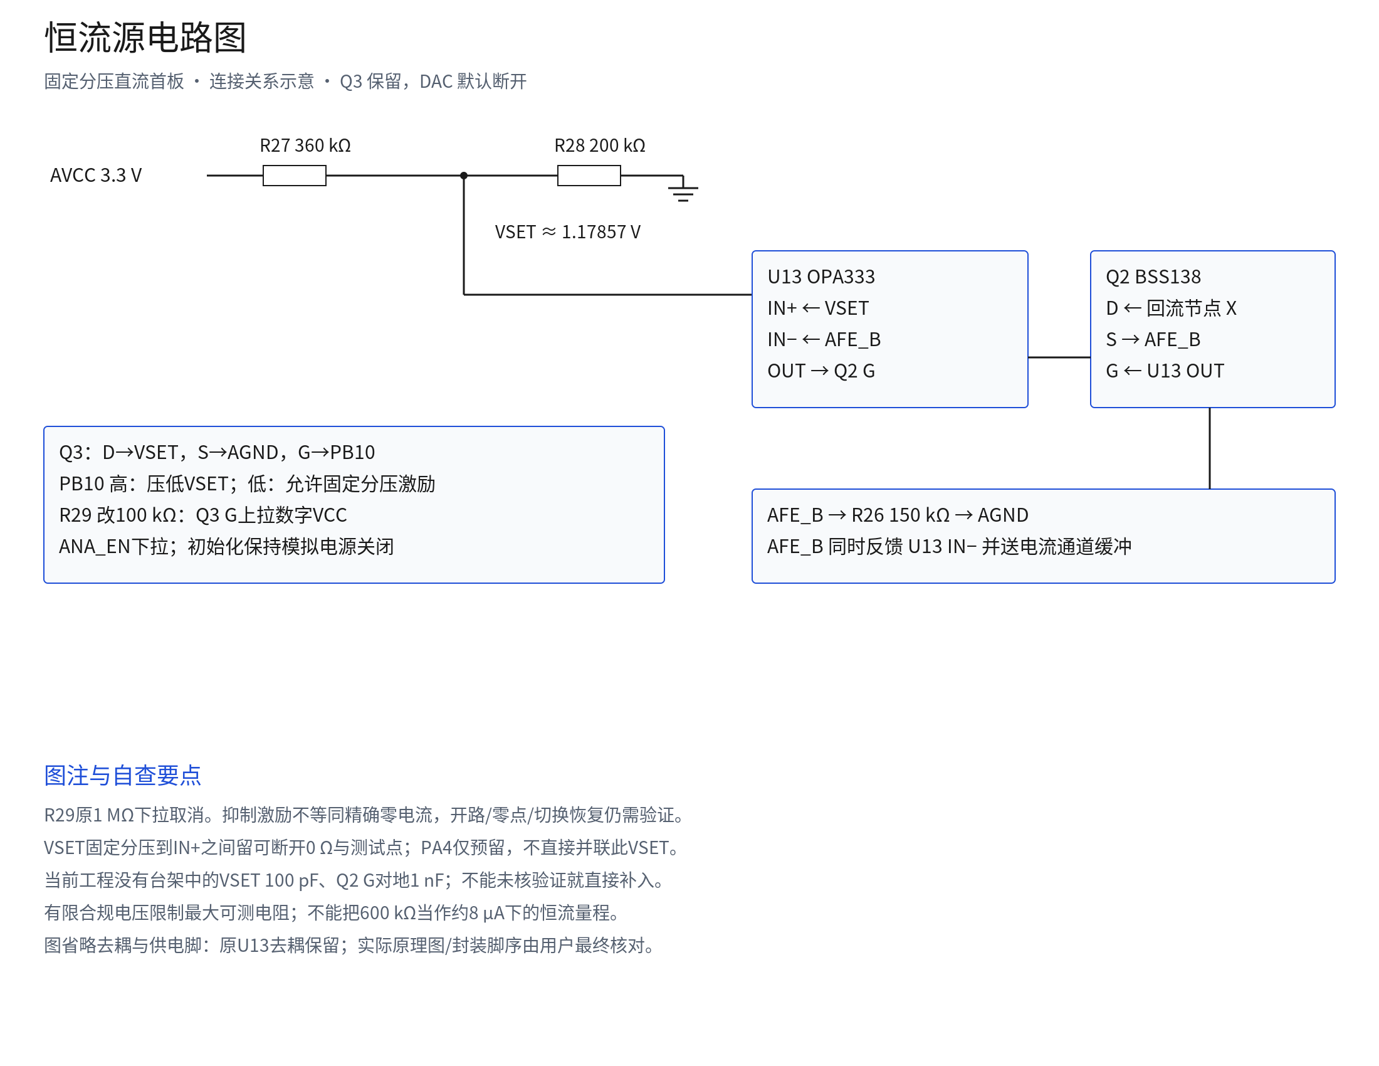
docs/design/diagram/恒流源电路图@2x.png
