chenxi-z/de-drms/docs/design/diagram/抗混叠滤波电路_k3b三级@2x.png

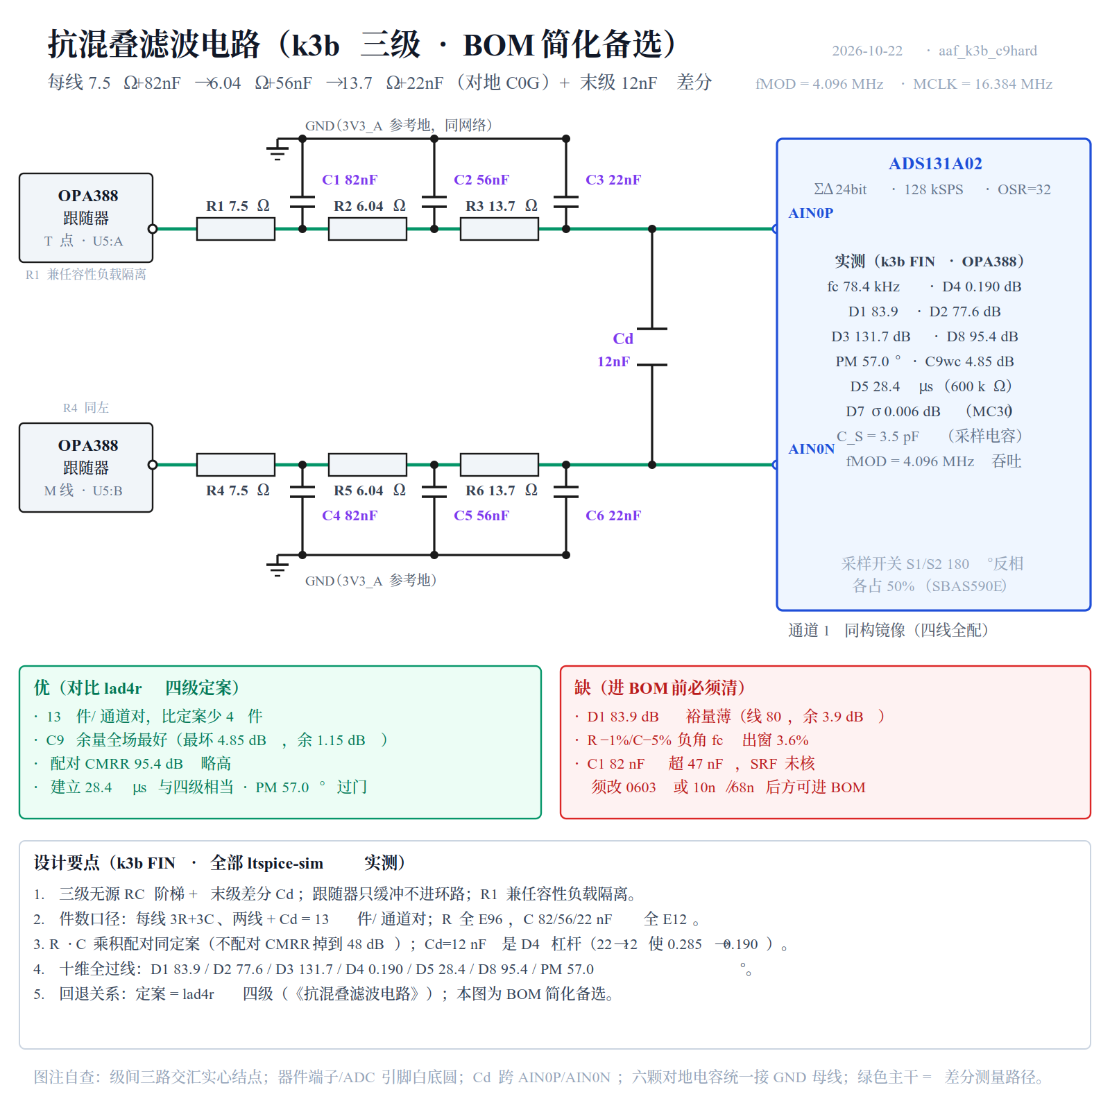
docs/design/diagram/抗混叠滤波电路_k3b三级@2x.png
