chenxi-z/de-drms/docs/design/diagram/抗混叠滤波电路_一阶@2x.png

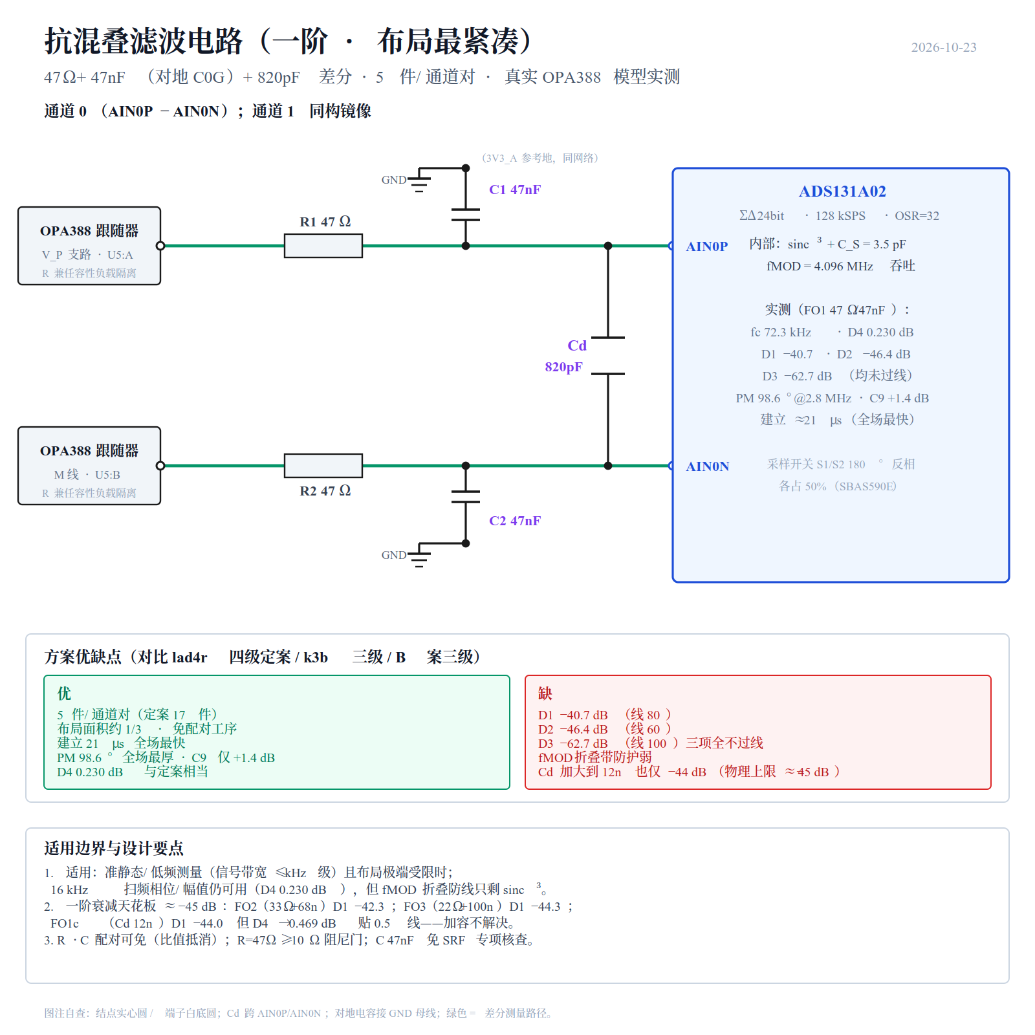
docs/design/diagram/抗混叠滤波电路_一阶@2x.png
