chenxi-z/de-drms/docs/design/diagram/抗混叠滤波电路_二阶T2@2x.png

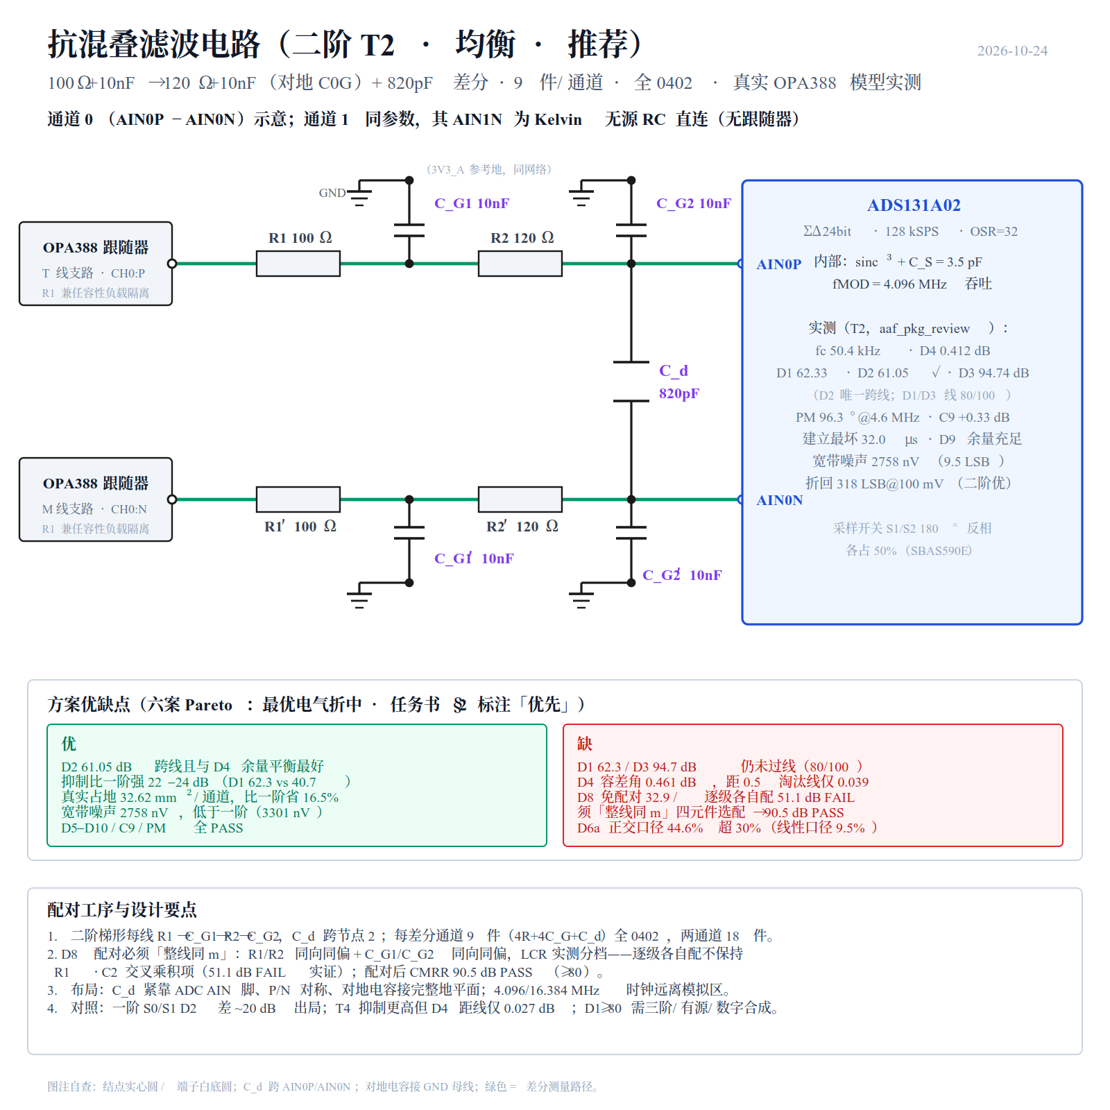
docs/design/diagram/抗混叠滤波电路_二阶T2@2x.png
