chenxi-z/de-drms/docs/design/diagram/整体方案框图@2x.png

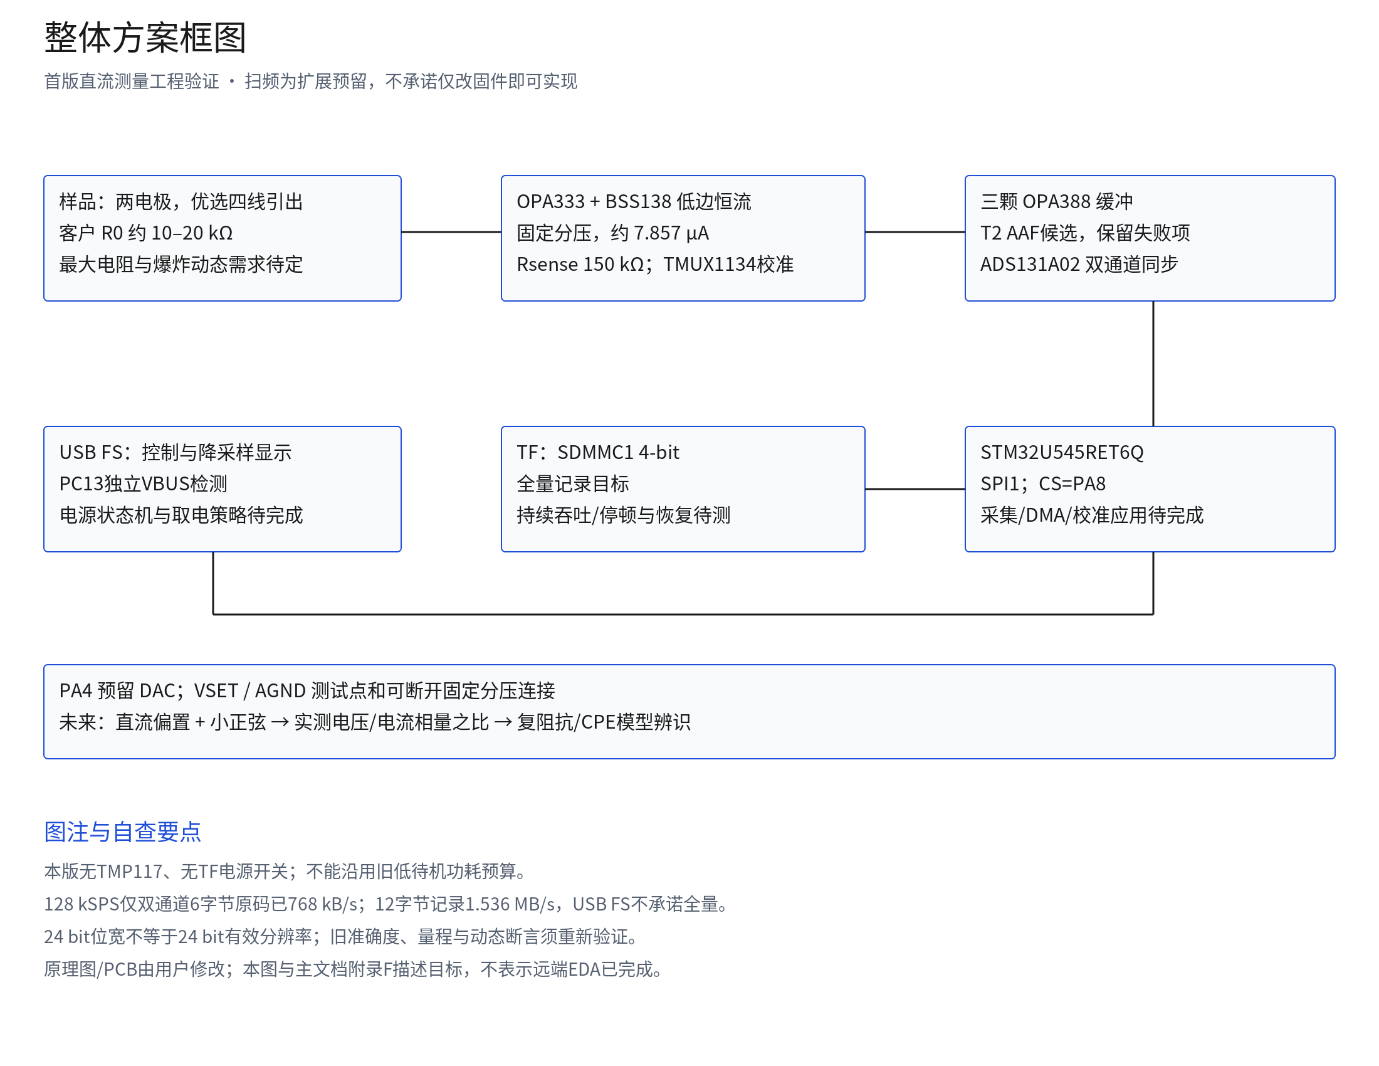
docs/design/diagram/整体方案框图@2x.png
