chenxi-z/de-drms/docs/design/diagram/模拟前端与自校准@2x.png

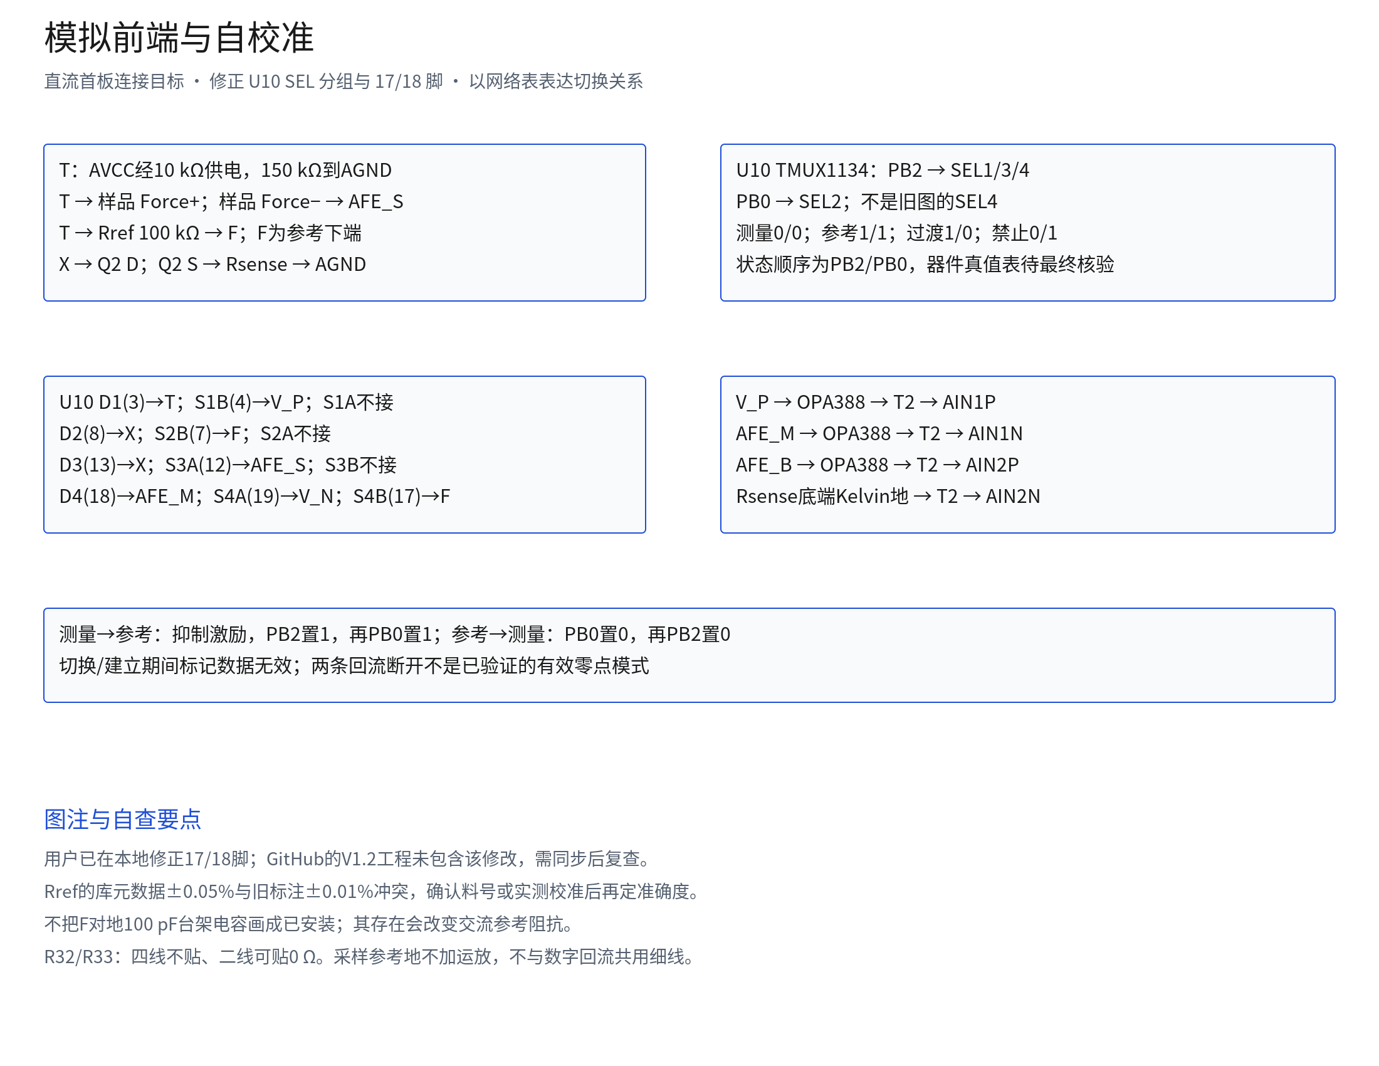
docs/design/diagram/模拟前端与自校准@2x.png
