chenxi-z/de-drms/docs/design/diagram/电源树@2x.png

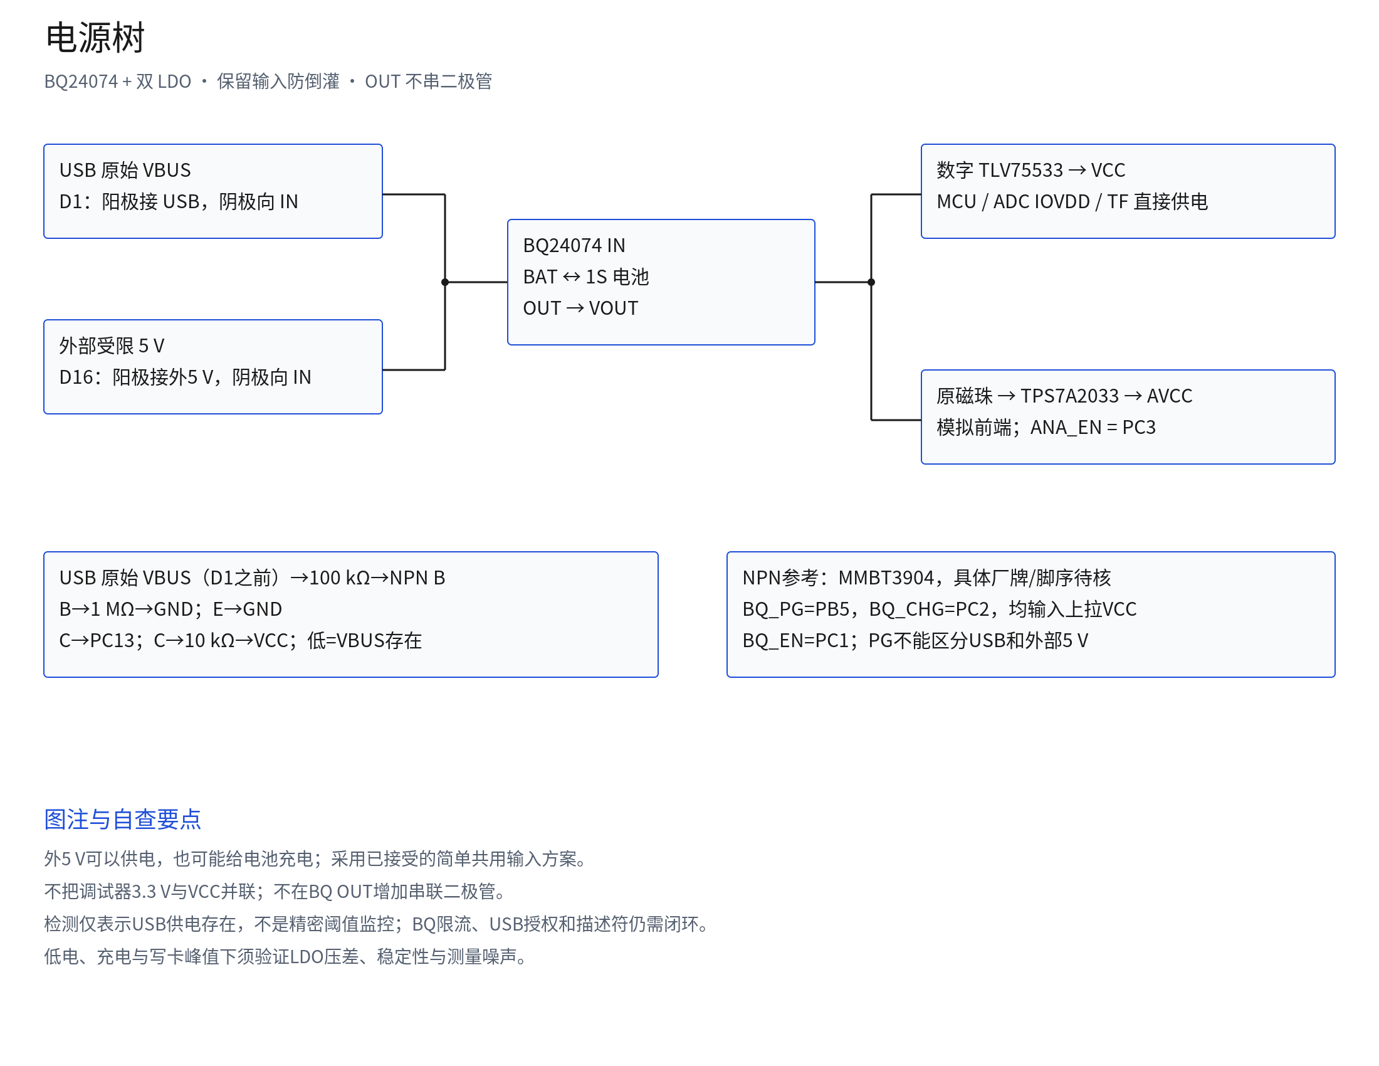
docs/design/diagram/电源树@2x.png
