chenxi-z/de-drms/docs/design/diagram/自校准与零点电路@2x.png

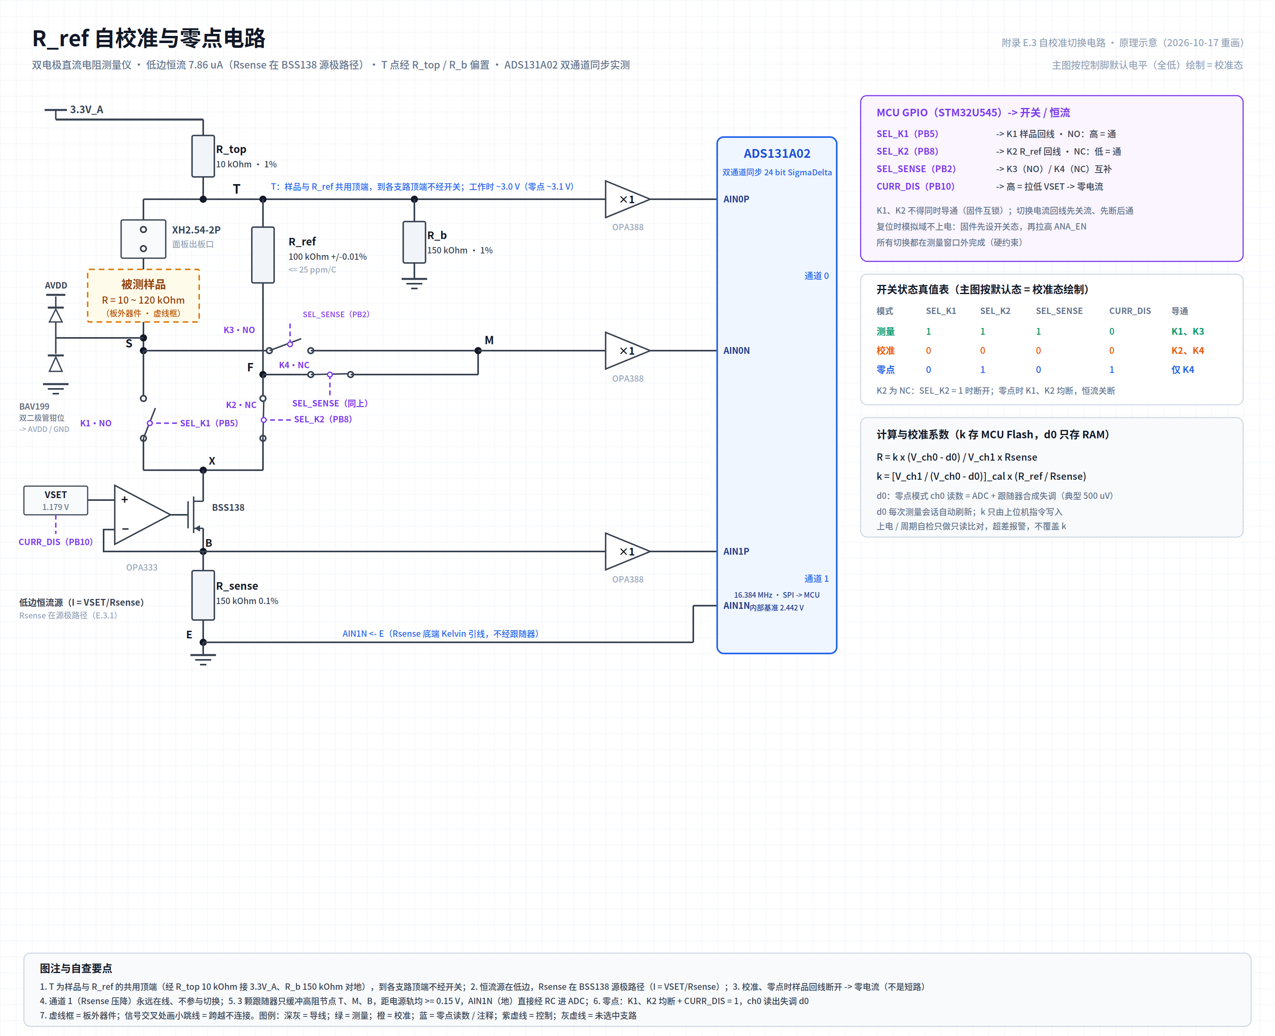
docs/design/diagram/自校准与零点电路@2x.png
