chenxi-z/de-drms/hardware/sim/aaf/aa_bode_cm.png

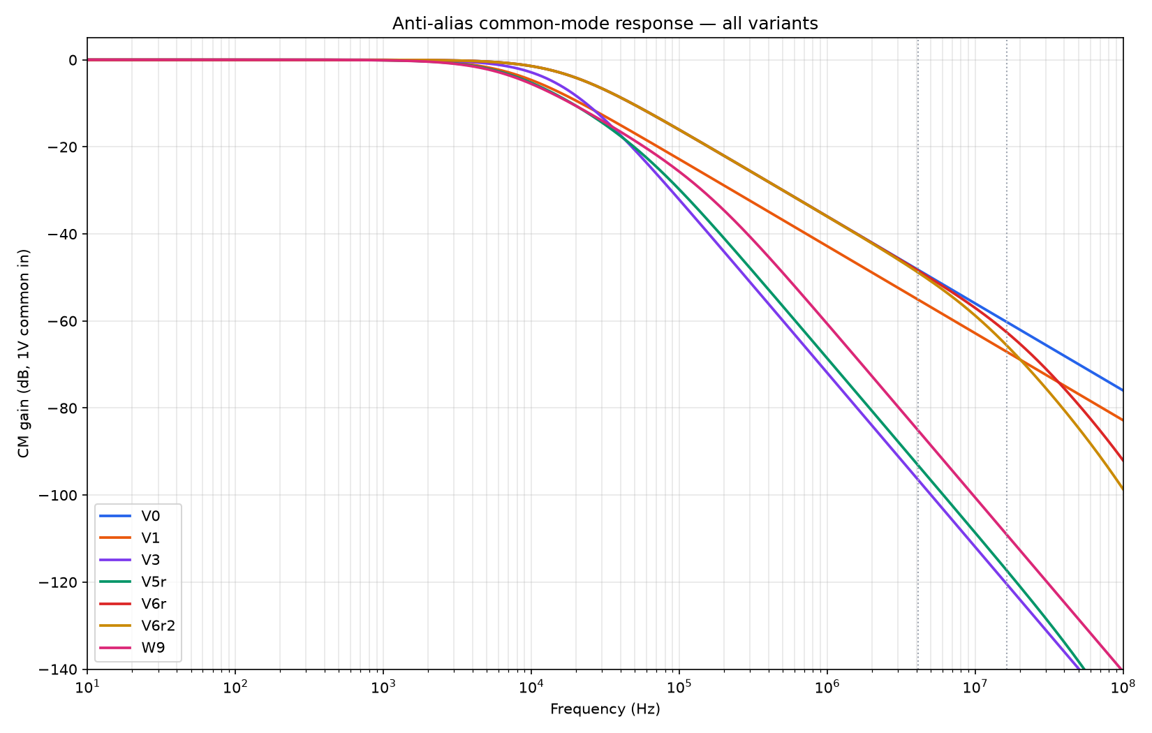
hardware/sim/aaf/aa_bode_cm.png
