chenxi-z/de-drms/hardware/sim/aaf/aa_bode_dm.png

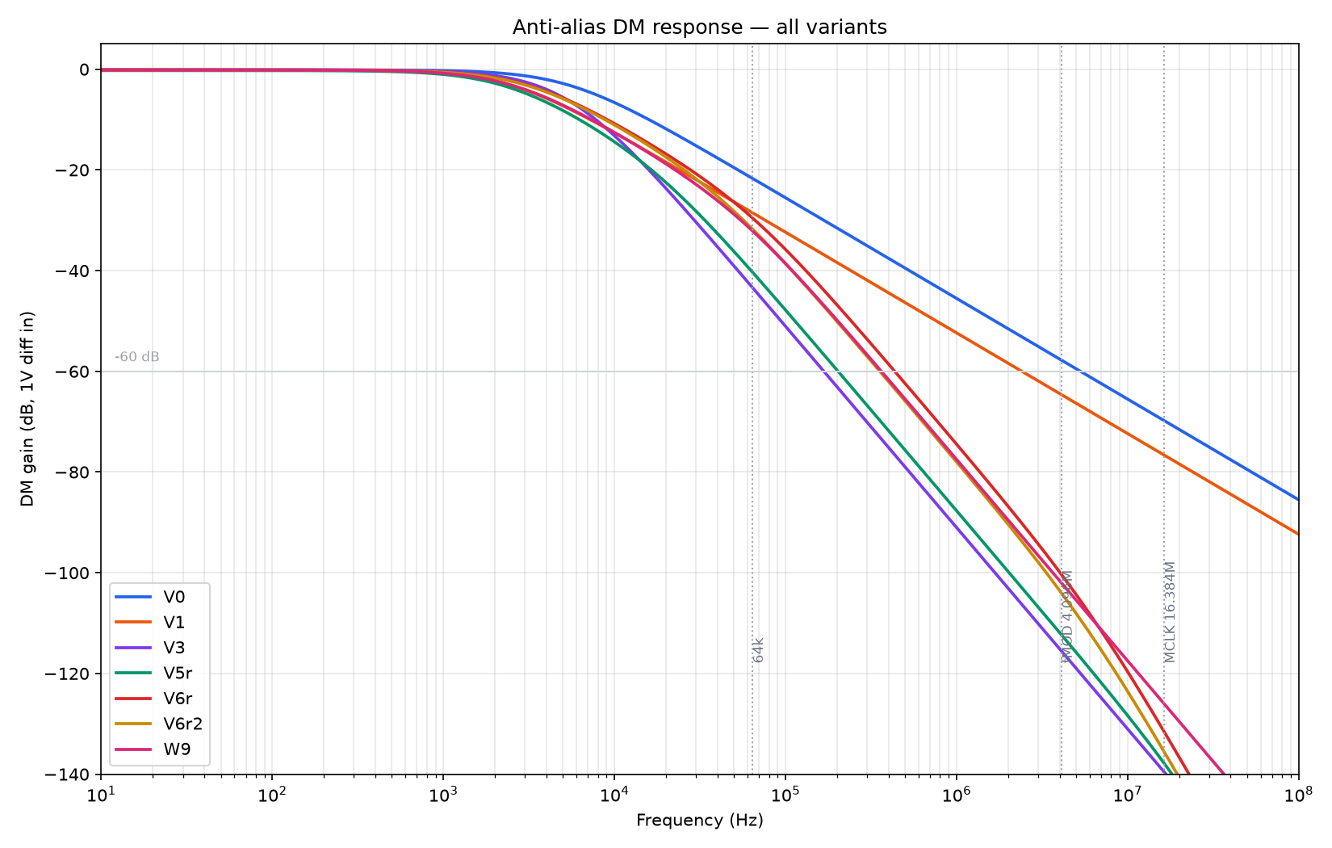
hardware/sim/aaf/aa_bode_dm.png
