chenxi-z/de-drms/hardware/sim/aaf/aa_kick.png

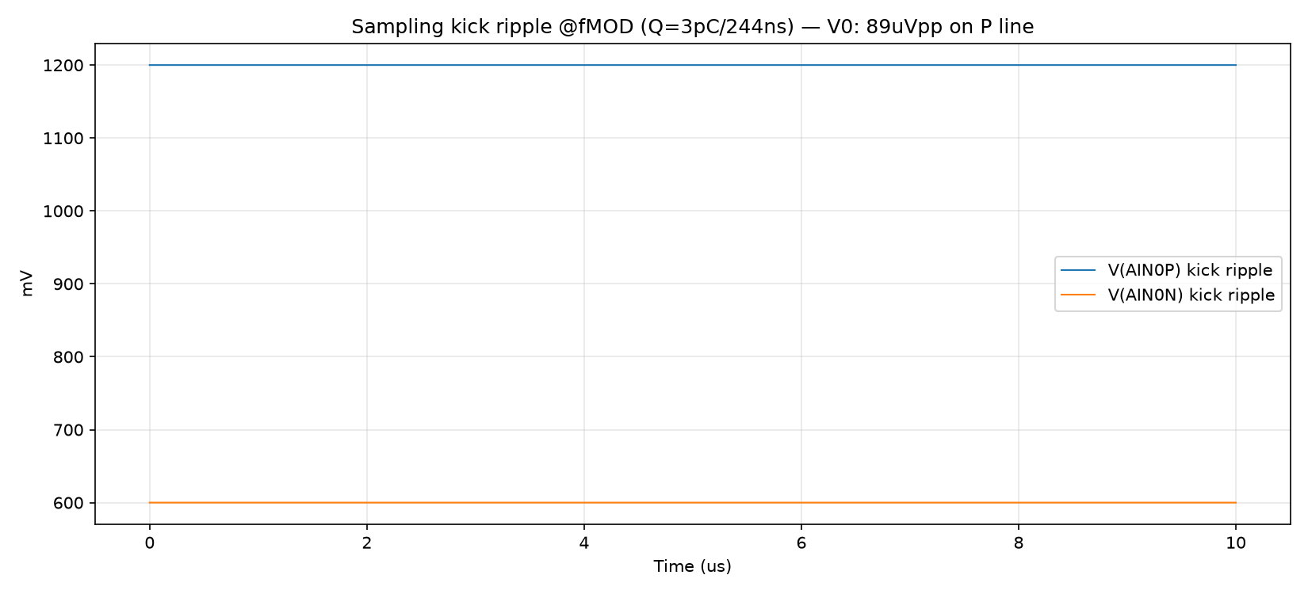
hardware/sim/aaf/aa_kick.png
