chenxi-z/de-drms/hardware/sim/aaf/aa_settle.png

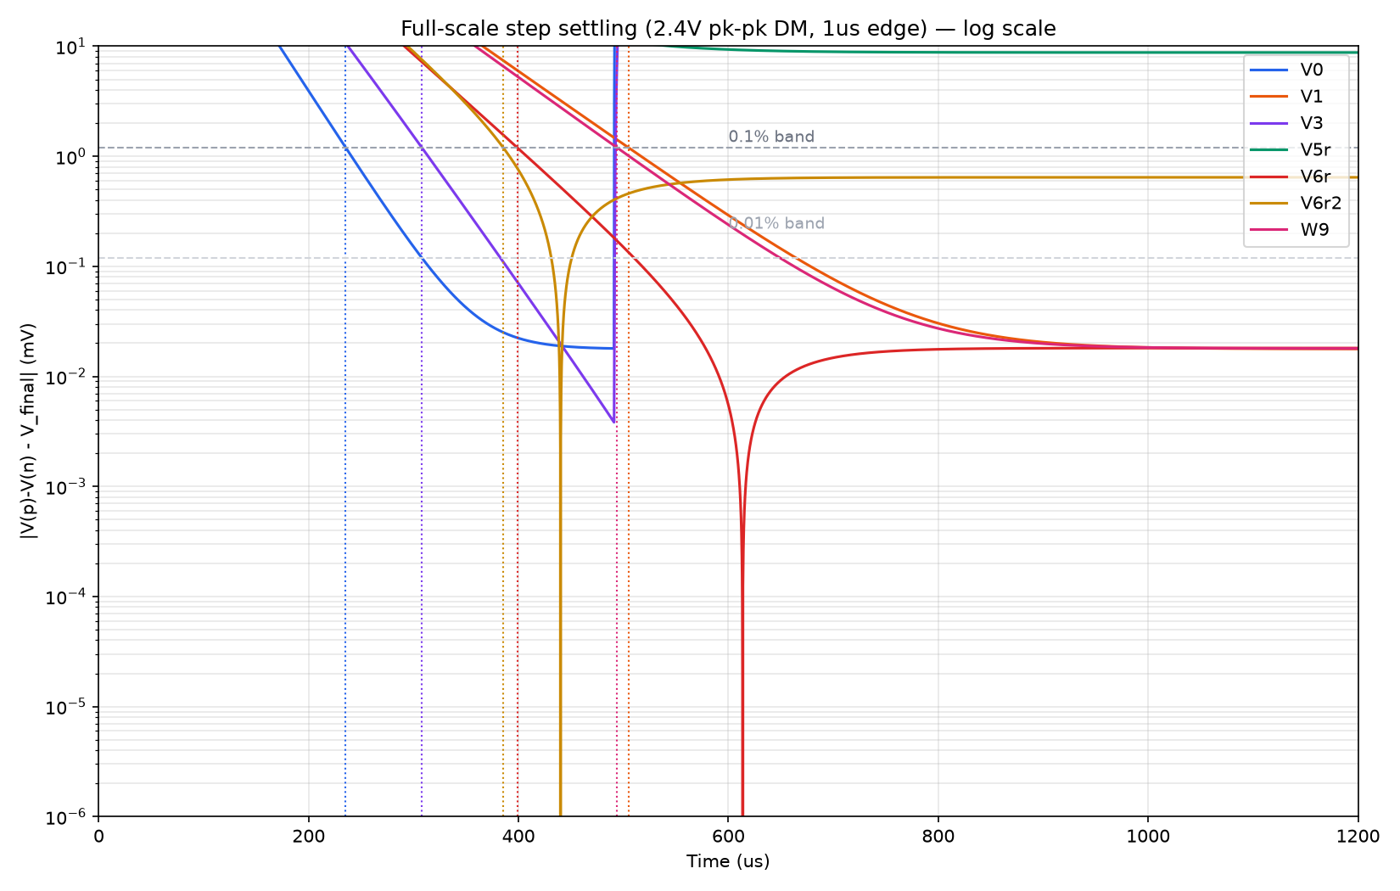
hardware/sim/aaf/aa_settle.png
