chenxi-z/de-drms/hardware/sim/aaf/Fig_aa_filter_b.png

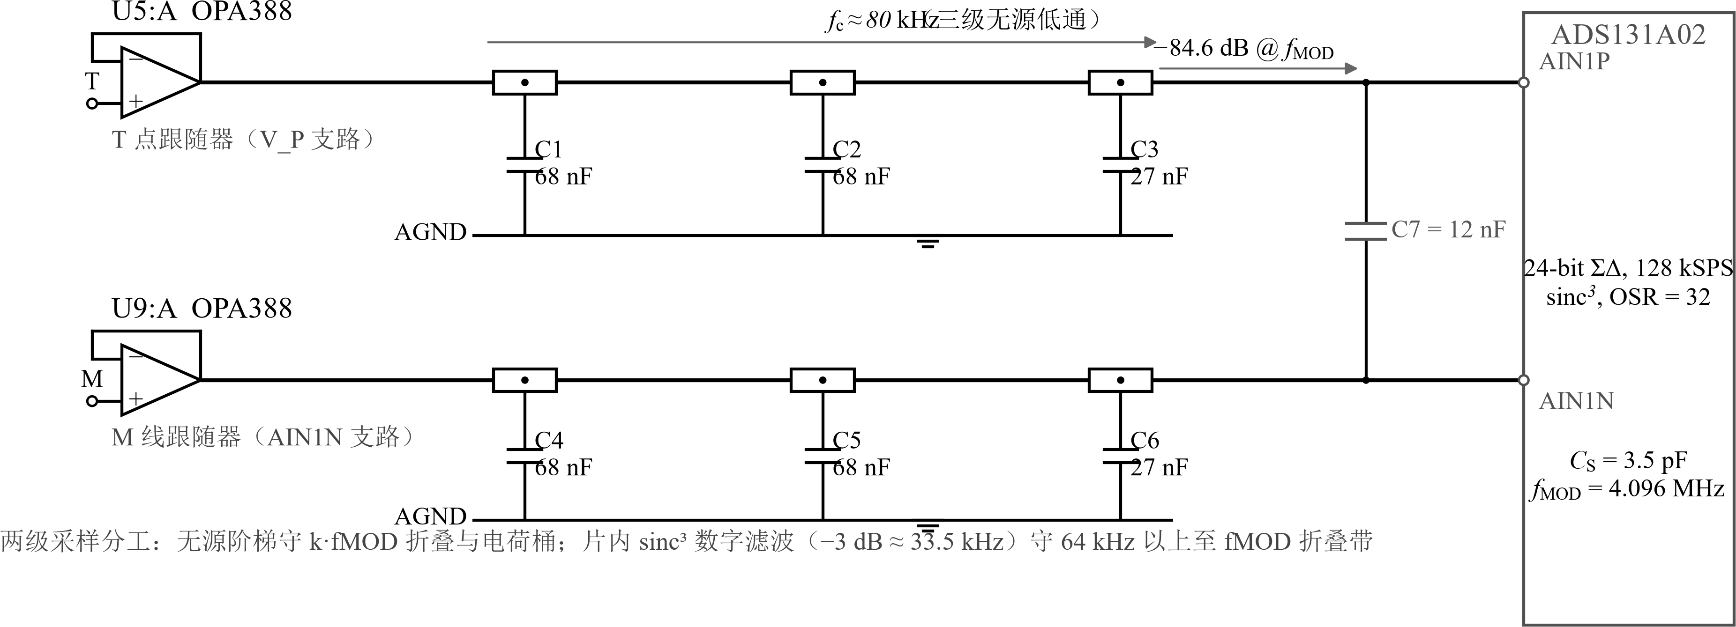
hardware/sim/aaf/Fig_aa_filter_b.png
