chenxi-z/de-drms/hardware/sim/aaf/fin1_bode_overlay.png

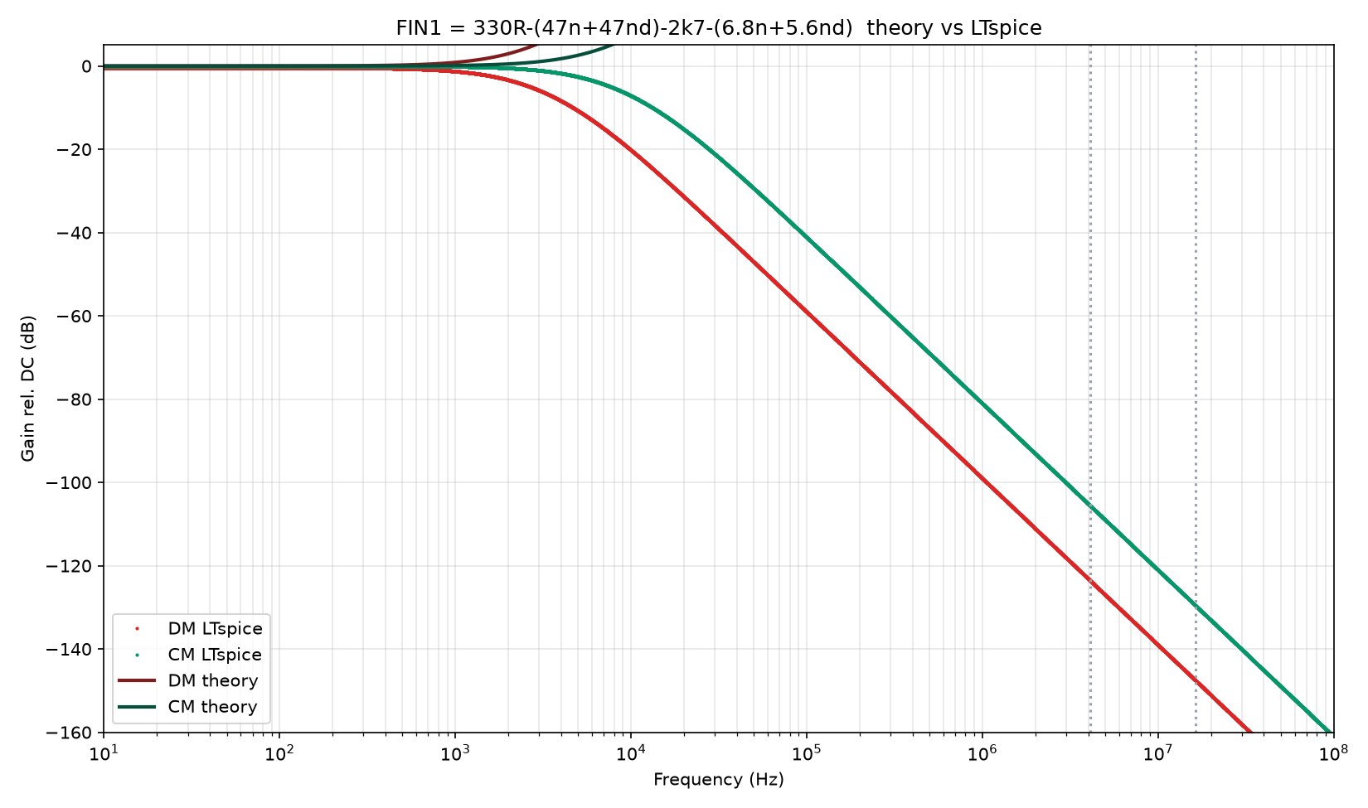
hardware/sim/aaf/fin1_bode_overlay.png
