chenxi-z/de-drms/hardware/sim/aaf/r5_radar.png

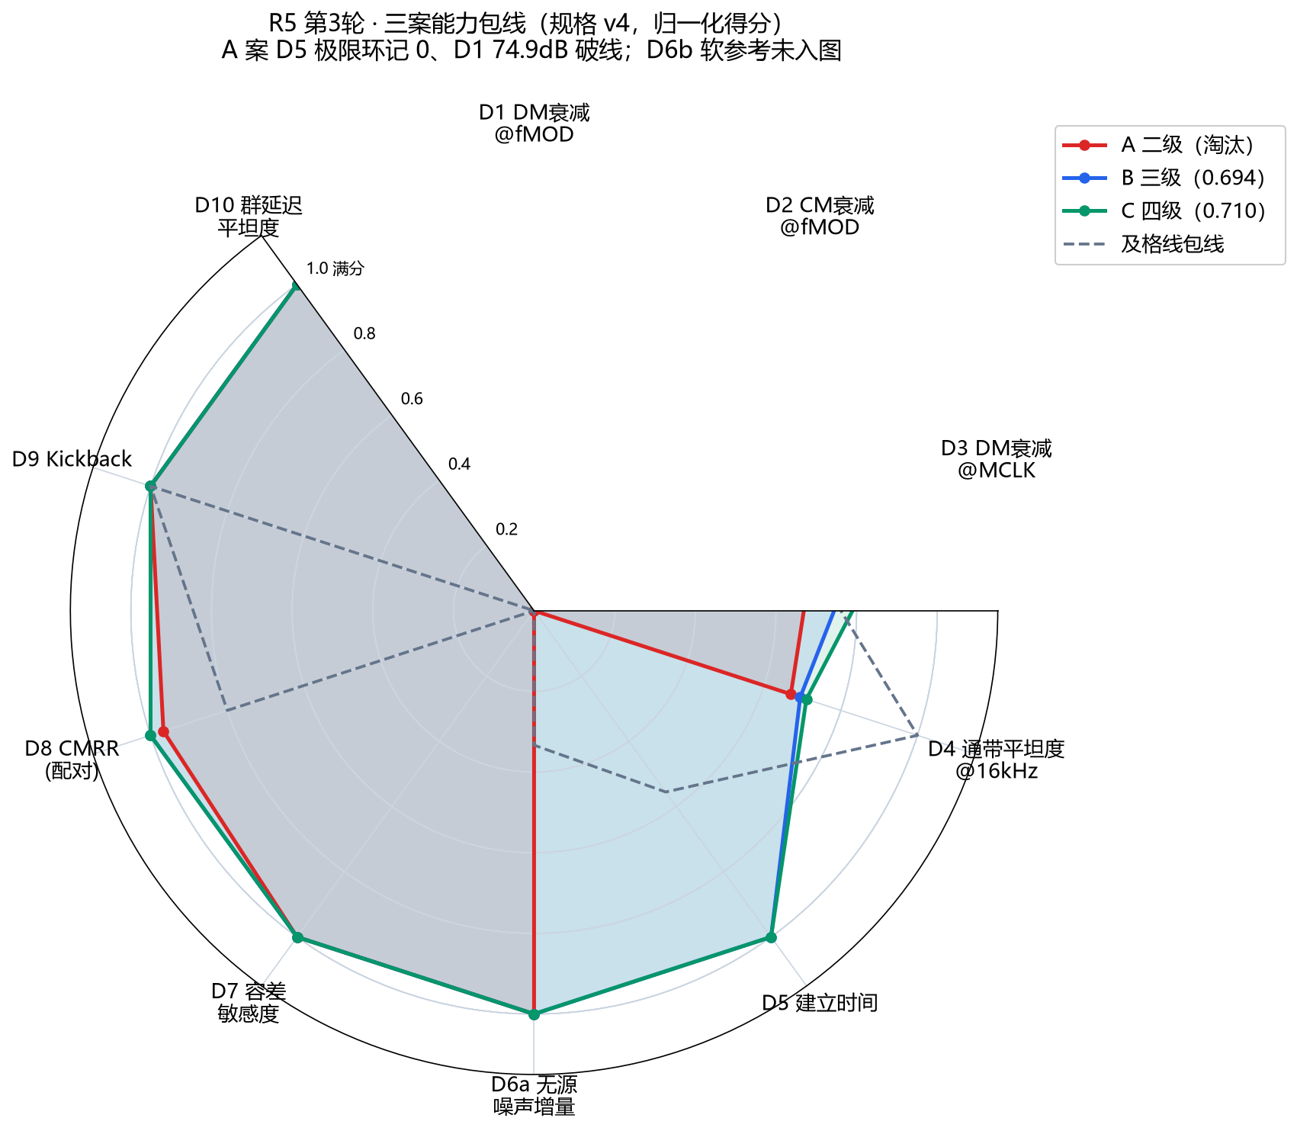
hardware/sim/aaf/r5_radar.png
