chenxi-z/de-drms/hardware/sim/aaf/w9_cmrr.png

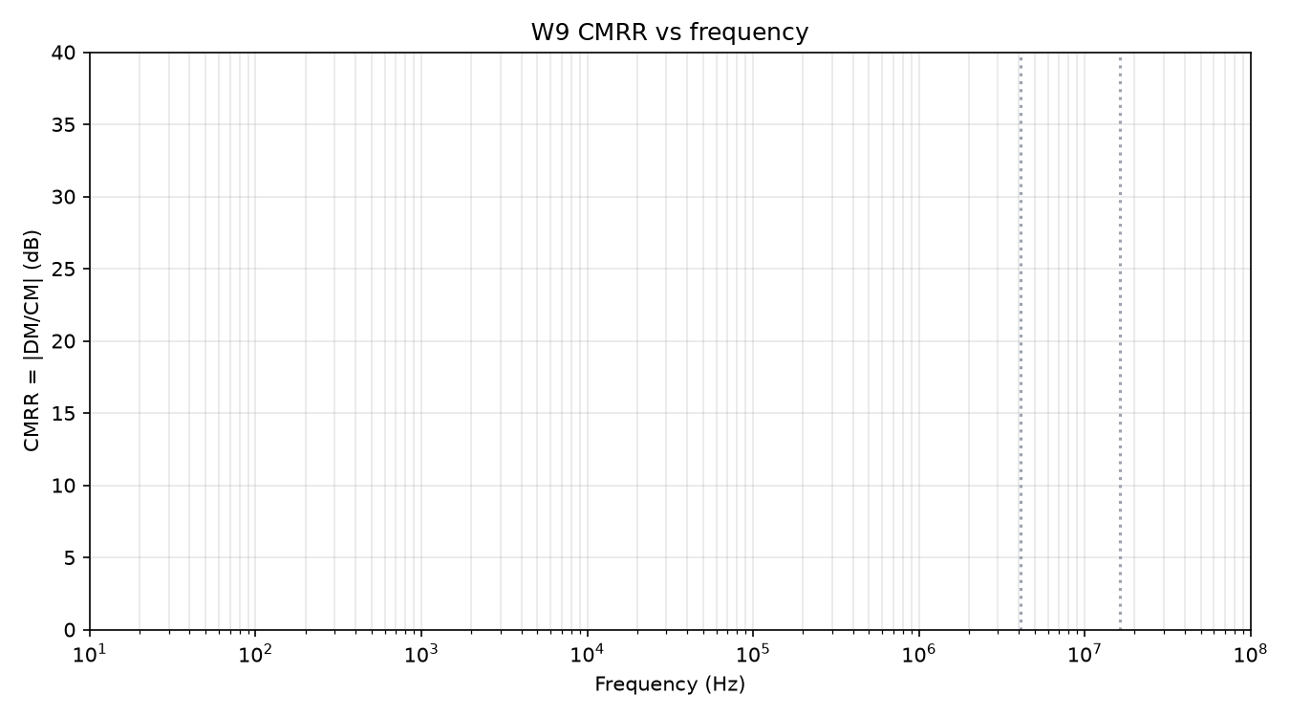
hardware/sim/aaf/w9_cmrr.png
