chenxi-z/de-drms/hardware/sim/aaf/w9_mc_hist.png

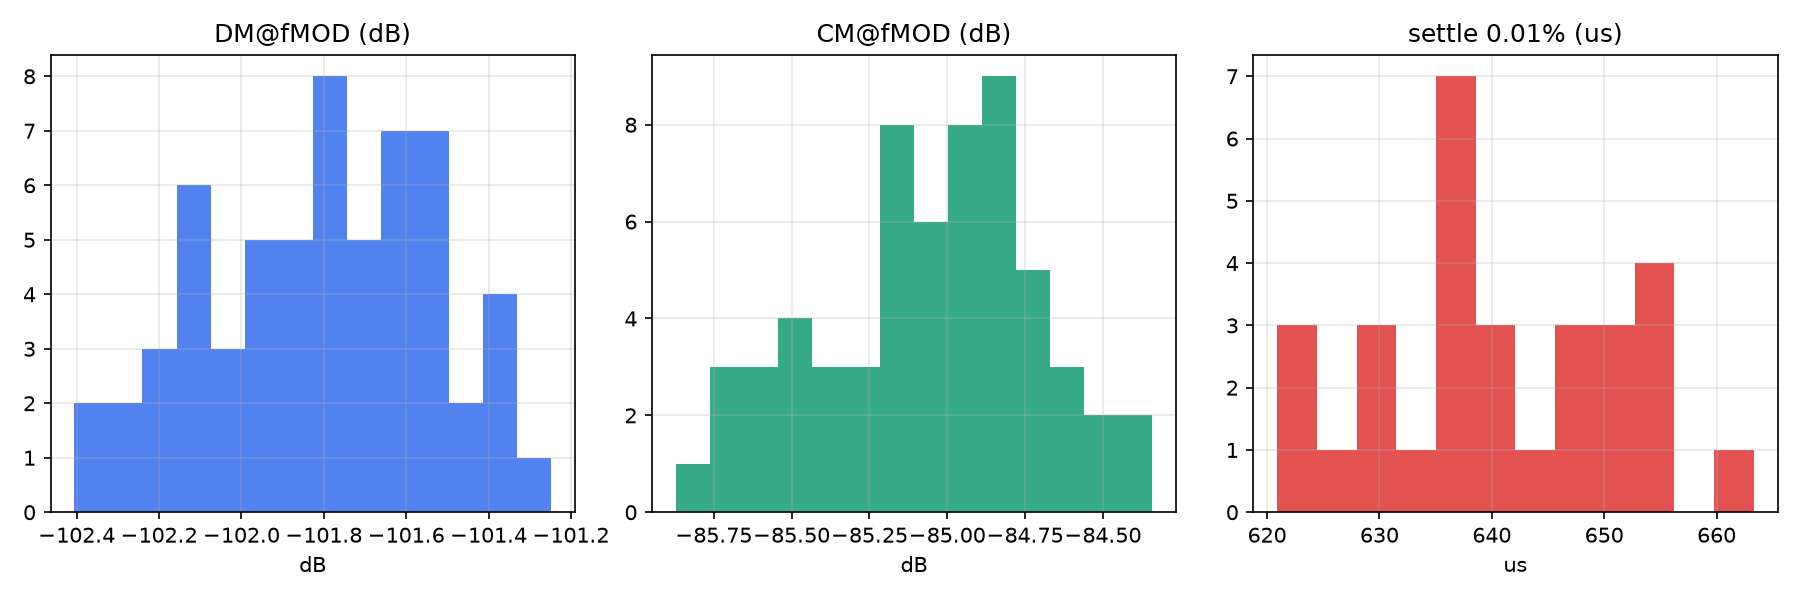
hardware/sim/aaf/w9_mc_hist.png
