chenxi-z/de-drms/hardware/sim/aaf/图纸_FIN1_抗混叠@2x.png

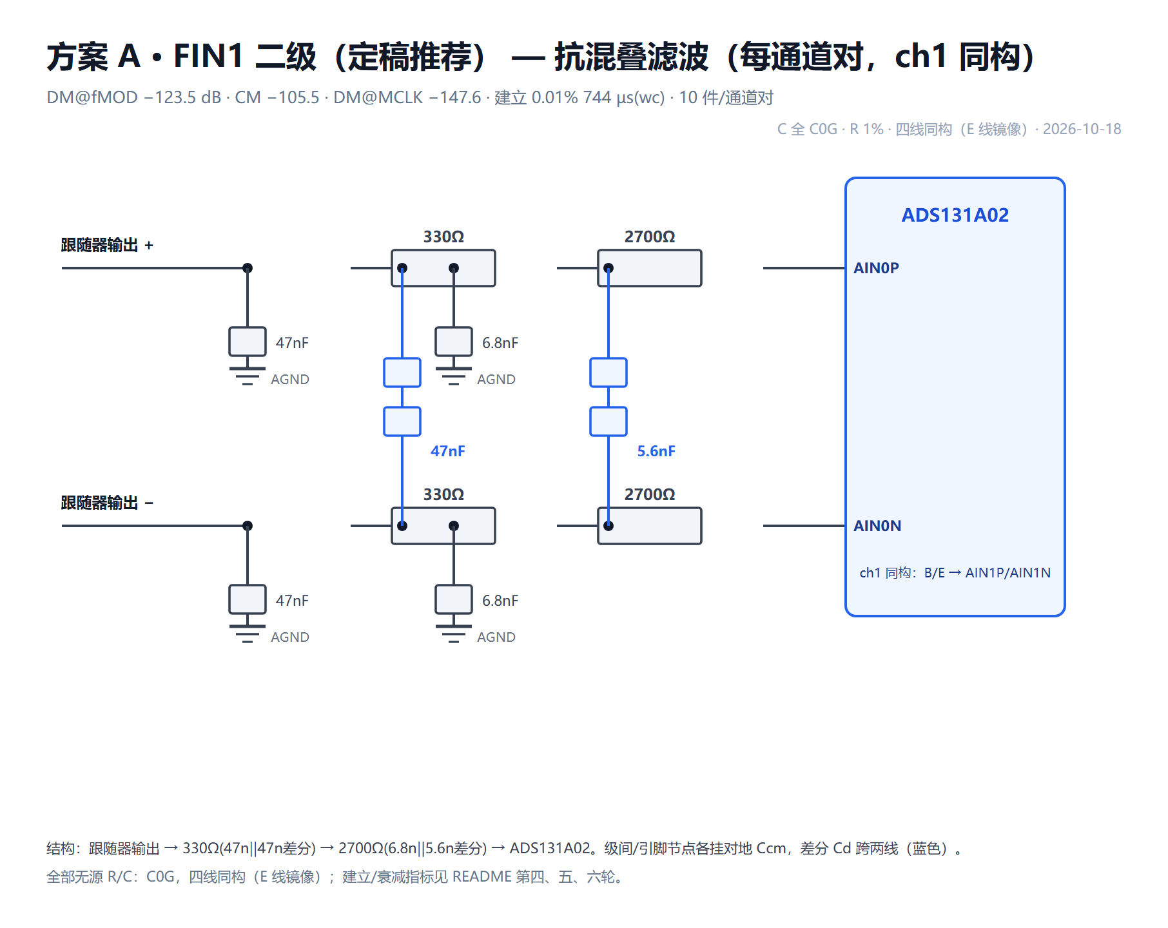
hardware/sim/aaf/图纸_FIN1_抗混叠@2x.png
