chenxi-z/de-drms/hardware/sim/aaf/图纸_V11_抗混叠@2x.png

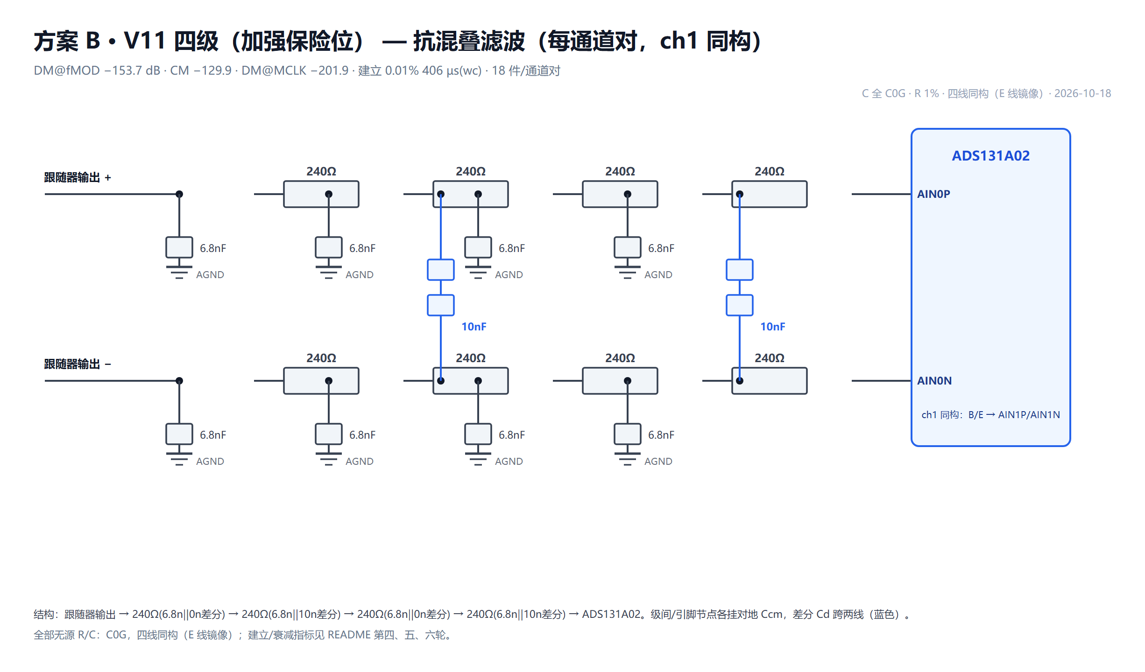
hardware/sim/aaf/图纸_V11_抗混叠@2x.png
