chenxi-z/de-drms/hardware/sim/aaf/抗混叠滤波电路@2x.png

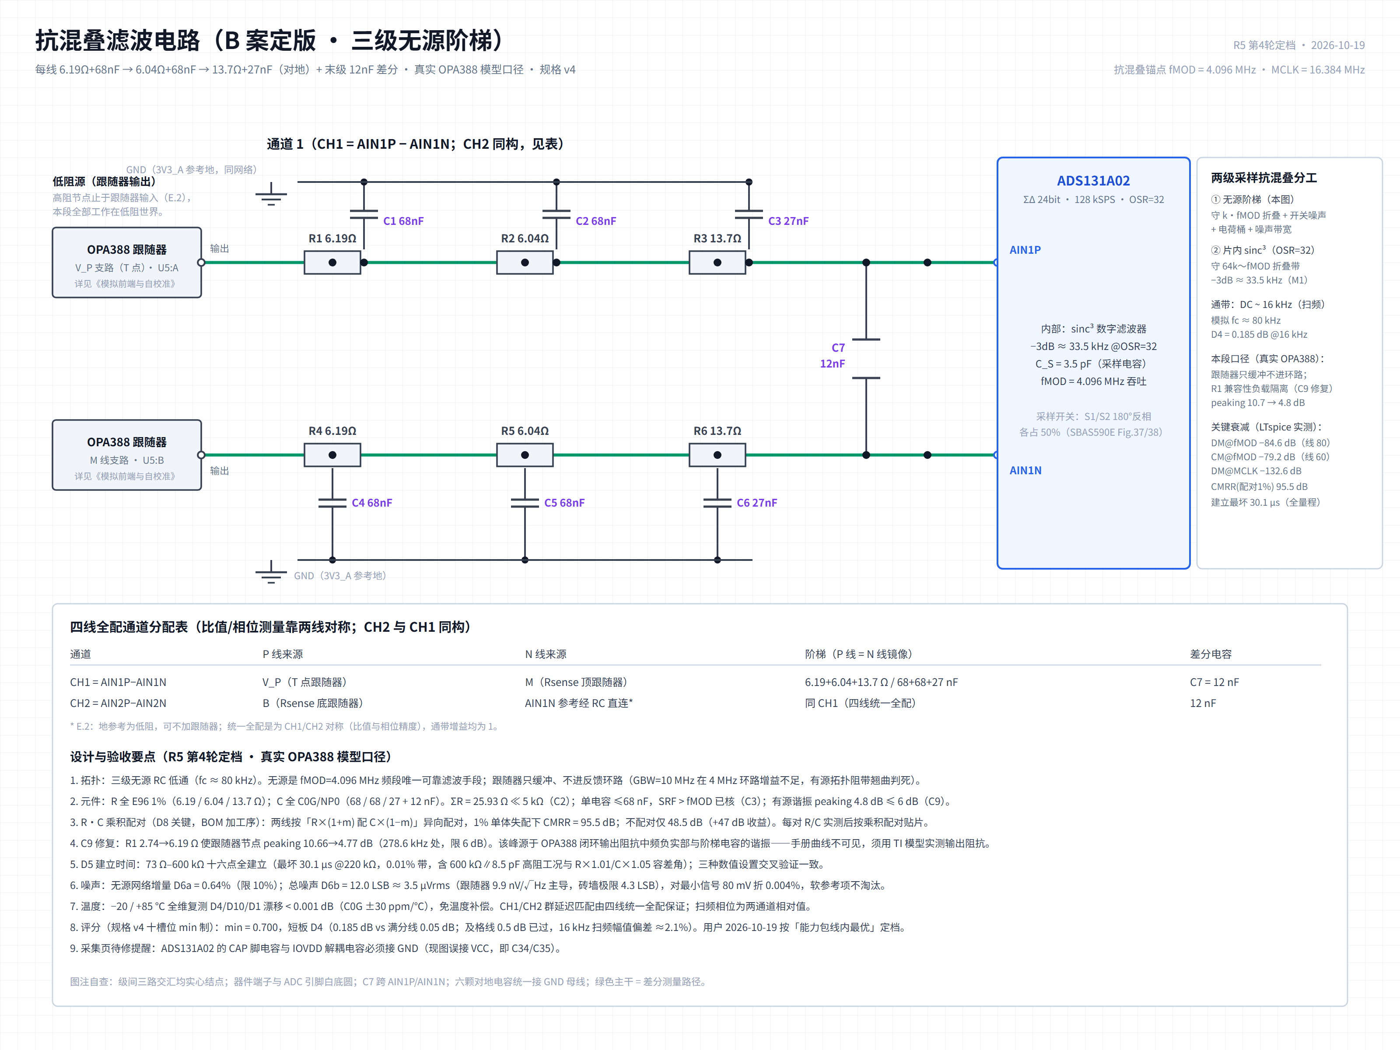
hardware/sim/aaf/抗混叠滤波电路@2x.png
