chenxi-z/de-drms/hardware/sim/ccsource/bode_loop.png

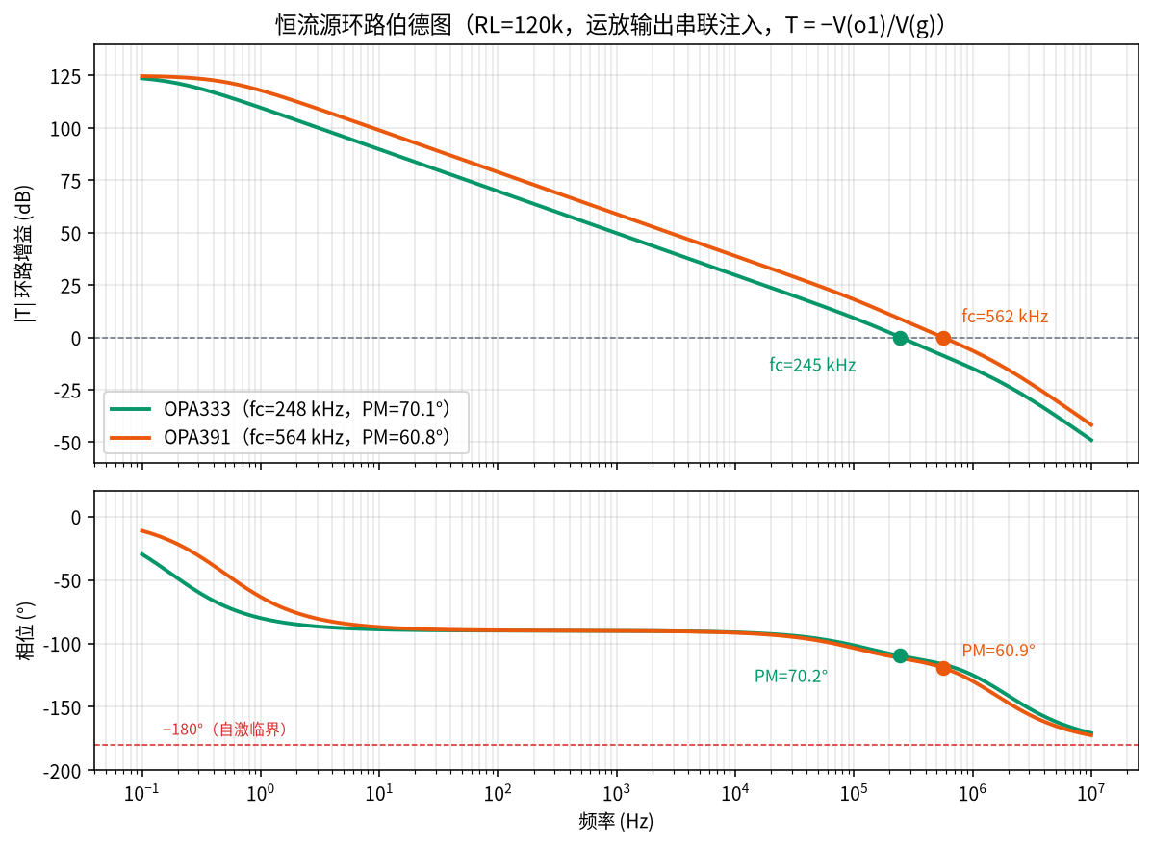
hardware/sim/ccsource/bode_loop.png
