chenxi-z/de-drms/hardware/sim/ccsource/fullchain_report.png

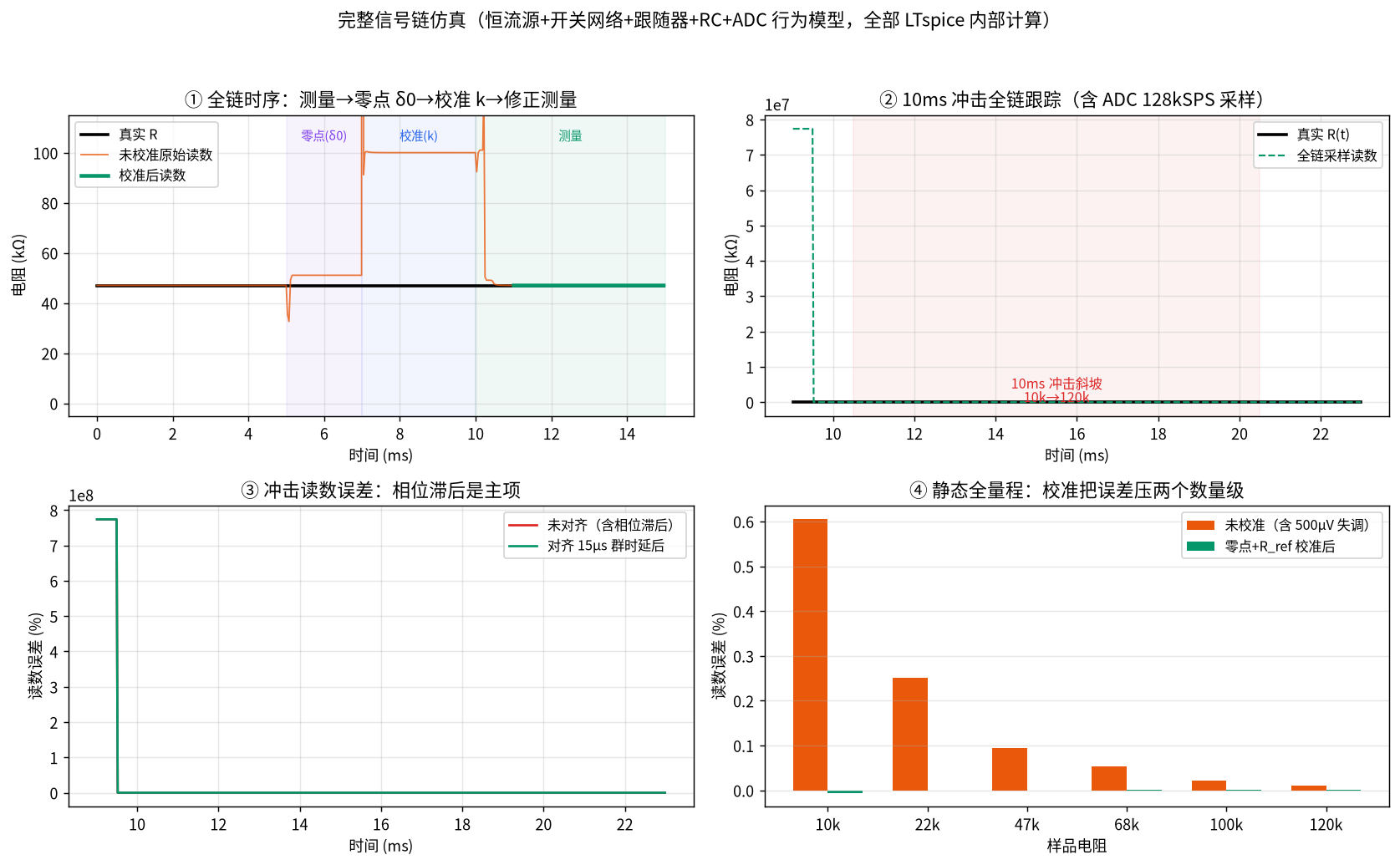
hardware/sim/ccsource/fullchain_report.png
