chenxi-z/de-drms/hardware/sim/ccsource/limits_report.png

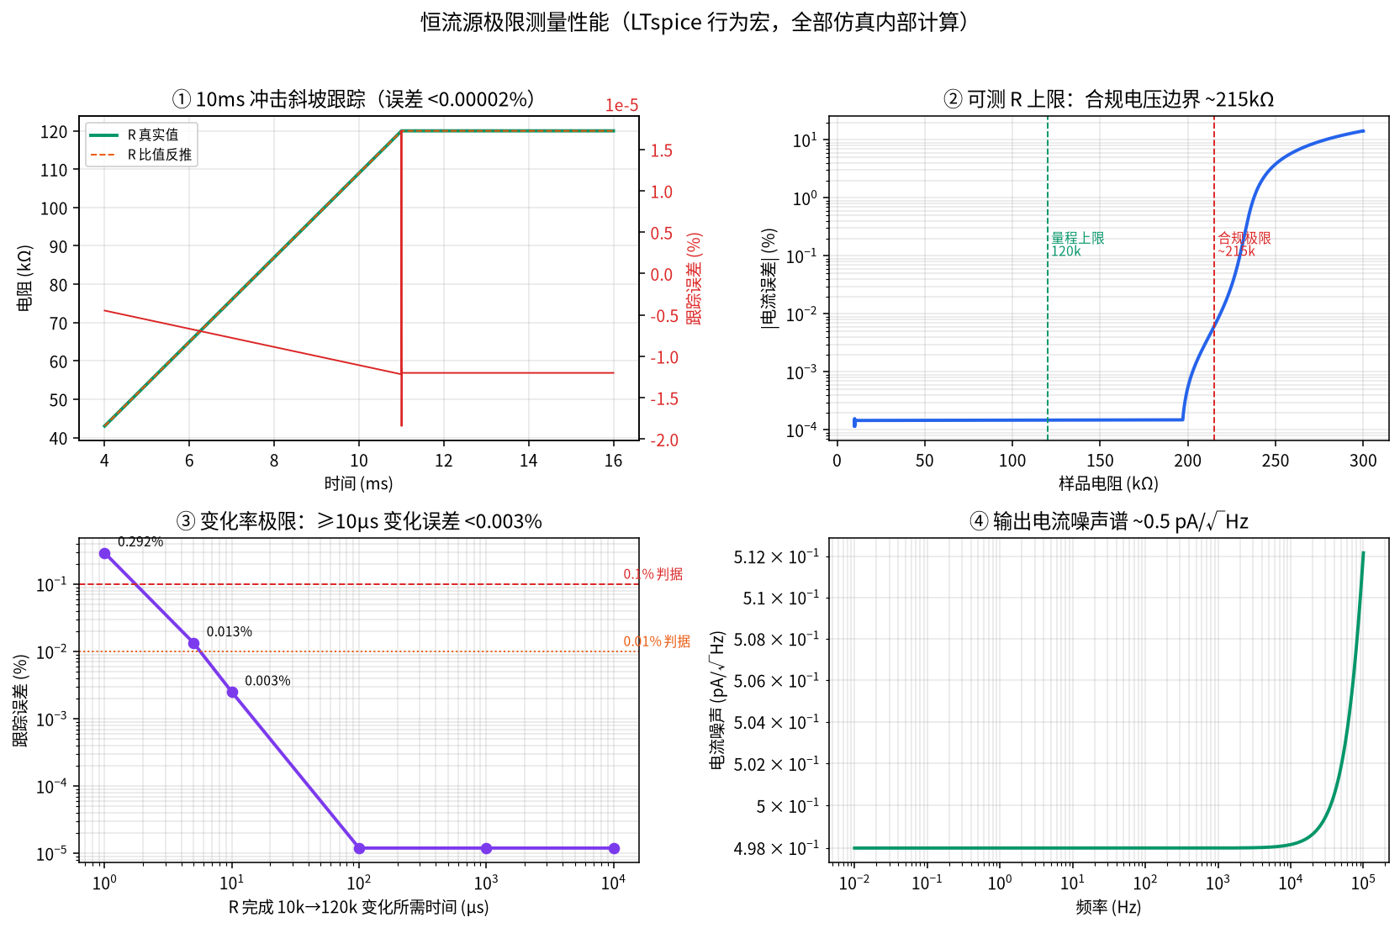
hardware/sim/ccsource/limits_report.png
