chenxi-z/de-drms/hardware/sim/ccsource/range_limits.png

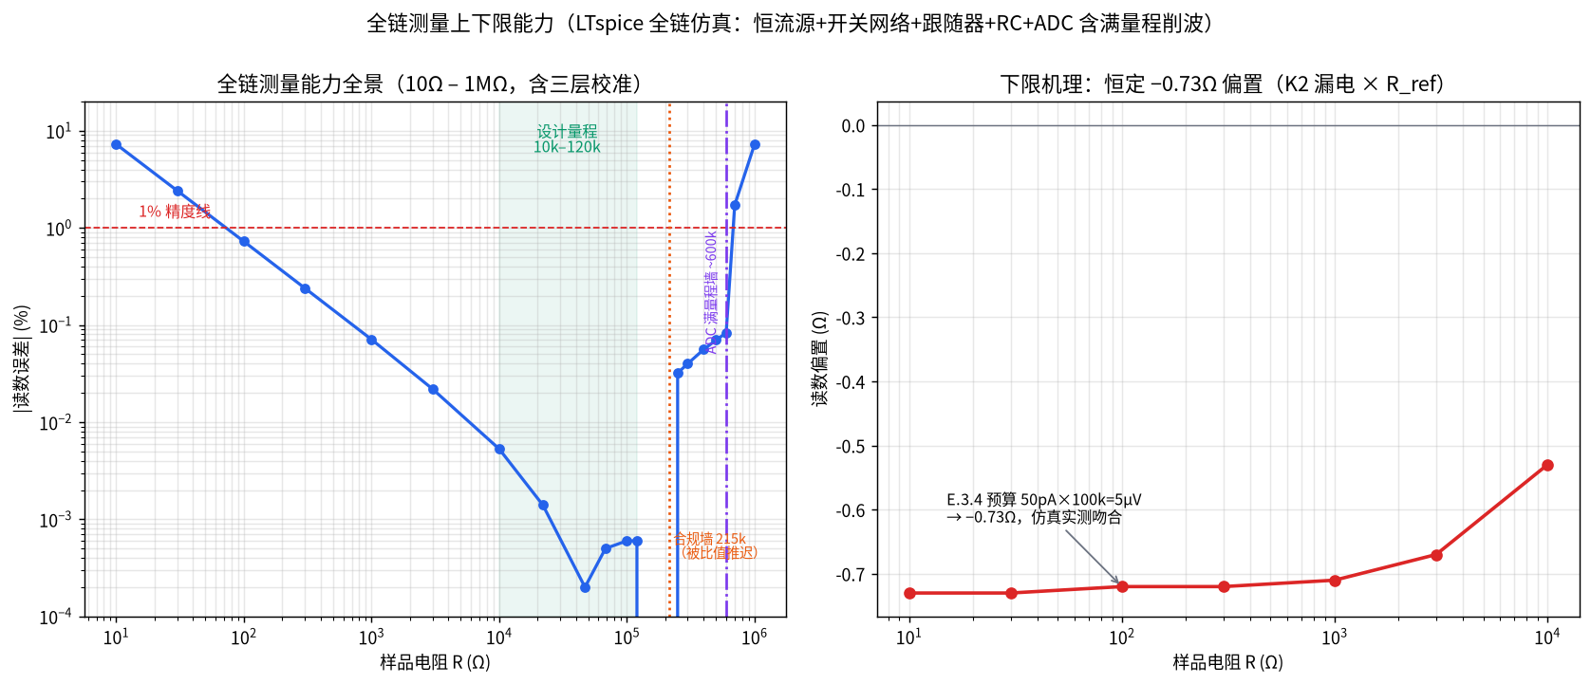
hardware/sim/ccsource/range_limits.png
