chenxi-z/de-drms/hardware/sim/ccsource/tran_10khz.png

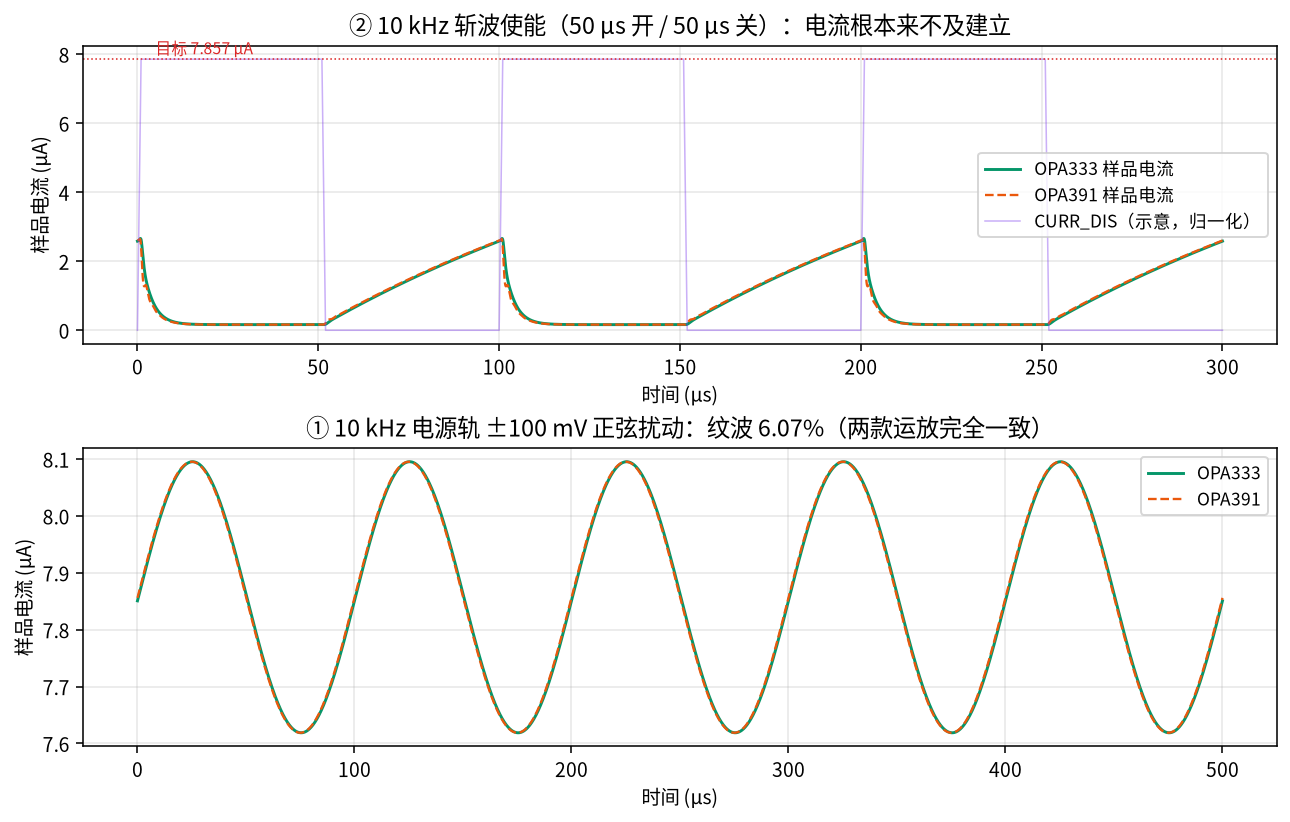
hardware/sim/ccsource/tran_10khz.png
