chenxi-z/de-drms/docs/design/component-selection.md

# 器件选型记录（ADC · MCU）

版本 1.0 · 2026-10-12 · 状态：主方案定稿，备选挂起

> 本文件记录双电极电阻测量仪的器件选型全过程、被否方案及原因、挂起的备选方案。
> （2026-10-24 由 `adc-selection/` 与 `mcu-selection/` 两目录合一，内容原样保留。）
> 主方案见 [信号链文档 附录 E.4](2026-10-10-universal-signal-chain.md)。

## 上篇：ADC 选型（ADS131A02）

### A1 选型约束（硬性）

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

### A2 选型决策链（按时间顺序）

```
ADS1220(太慢) → ADS124S08(多通道复用/4kSPS) → AD7175-2(排除) 
  → ADS127L11(单通道高速, 比例式Rsense当基准) 
      ✗ 否决：基准输入电流 ±2µA(缓冲开)/190µA/V(缓冲关)，对150kΩ源阻抗致命(SBAS946C核实)
  → 换思路：双通道实测，各用固定基准
      → AD7124-4(多通道复用) → ADS131M02(双通道同步, 但用户会加跟随器)
      → ADS131A02(加跟随器后阻抗差异抹平, 综合更优)
  ✓ 定稿 ADS131A02
```

### A3 主方案：ADS131A02（定稿）

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

### A4 备选方案（挂起）

#### 备选一：ADS131M02（挂起）

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

#### 备选二：ADS127L14（评估后未选，记录原因）

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

#### 备选三：AD7124-4（评估后未选，记录原因）

四通道**复用**（非同步），基准缓冲电流 nA 级适合比例式。但复用型 V/I 不同时采样，且用户已定双通道同步实测路线，故未选。

### A5 被否决方案记录

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

### A6 关键教训（存档防重踩）

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

### A7 TI 参数筛选表存档

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

---

## 下篇：MCU 选型（STM32U545RET6Q）

版本 1.5 · 2026-10-14 · 状态：**已定版 STM32U545RET6Q**

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

### M1 选型需求

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

### M2 候选对比

价格取自立创商城（2026-10-12 查询，单位人民币；**价格与库存随时段变化，采购前须复核**）。
规格中标注"手册核实"者来自 ST 官方数据手册；未标注者**尚未从手册核实**，仅供参考。

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

#### M2.1 关键发现

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

### M3 决策：STM32U545RET6Q

**理由**：

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

**放弃理由**：

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

### M4 pin-to-pin 兼容性（重要结论）

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

**结论：不存在"PCB 一次设计、U5/G4 互换"的方案，本设计按 U545RET6Q 单一定版。**
若未来需要降级到 G4，必须重新设计 PCB。

### M5 待办 / 未核实项

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

### M6 数据手册存档

`STM32U545.pdf`（ST 官方 STM32U545xx 数据手册，DS14216）已推送至
Obsidian 库 `20-硬件工程/datasheets/`（Obsidian 的整理由专门会话负责）。
