chenxi-z/de-drms/hardware/sim/signalchain/fo1_rc_review/bom_footprint_check.md

# T12 · BOM / 占地核查 —— 一阶 RC 四方案器件真实可采购性与面积估算

- **日期**：2026-10-24 01:20 CST（LCSC 库存快照时间，见 §7）
- **任务依据**：`hardware/sim/Zcode_LTspice_一阶RC四方案复核任务书.md`
  - §4 T12 行（:156）：「真实厂商料号与 footprint；独立于电路计算 | R、C_G、C_D 的容差、介质、额定电压、封装、SRF(如有)、本体/焊盘面积及可采购性」
  - §5.2（:187–192）：估算 **47nF/1210 → 22nF/0805** 与 **22nF/0805 → 10nF/0603** 的面积收益
- **既有事实来源**：
  - `hardware/sim/aaf/r5_bom_check.md`（B 案 BOM 口径、ESL/SRF 档位表 :120–126、配对工序 §5）
  - `hardware/sim/aaf/r5_datasheet_facts.md`（ADC/OPA388 手册核对值；T12 与电路计算无关，仅背景）
  - `hardware/BOM_Board1_Schematic1_2026-10-22.csv`（**生产 BOM 口径**：AAF 电容=村田 GRM C0G 走 LCSC；
    AAF 串联 R=0603 厚膜 1%（UNI 厚声 0603WAF / YAGEO AC 系）与薄膜（UNI TC 系）混用，:29–36；
    68nF/1206、27nF/0805、12nF/0805 三档 C0G 已在册，:6–9）
- **纪律**：T12 属任务书明确要求逐料核查可采购性；但按 `AGENTS.md` E.10 #6 口径，
  **价格/库存/交期的最终确认仍归用户**——本文库存为 2026-10-24 快照，下单前须复核。
  本文未收到任何回扣/推广激励，链接仅为证据。

---

## 0. 结论摘要

| 核查项 | 结论 | 一句话依据 |
|---|---|---|
| **22nF/0805 C0G** | ✅ **可采购**（现货窄、全球宽） | LCSC 现货仅村田 GCM21B5C1H223FA16L（**±1%**，521 只，C1864305）；商用 GRM21B5C1H223JA01L（±5%）DigiKey 有售（586677）；TDK ±5% 档 LCSC 今日 0–8 只 |
| **10nF/0603 C0G** | ✅ 可采购（量大） | 村田 GRM1885C1H103JA01D，LCSC 现货 207,500 只（C85973） |
| **6.8nF/0603 C0G** | ✅ 可采购（量大） | 村田 GRM1885C1H682JA01D，LCSC 现货 85,750 只（C162241） |
| **820pF/0603 C0G** | ✅ 可采购 | 村田 GRM1885C1H821JA01D，LCSC 现货 4,600 只（C701305） |
| **47nF/1210 C0G** | ⚠️ **全球可采购，LCSC 今日 0 库存** | TDK C3225C0G1H473J200AA：DigiKey ≈3,136 + Mouser ≈1,009 + Arrow 有货；LCSC（C3846358）0 只 preSale |
| **47nF/1206 C0G（任务书外发现）** | ✅ 可采购（量大） | 村田 GRM31M5C1H473JA01L，LCSC 现货 **51,375 只**（C21812）——与任务书「47nF C0G 只能取得 1210」前提**冲突**，见 §5 |
| **R=47/100/200Ω** | ✅ 两口径均大量现货 | 厚膜 1% 0603（YAGEO RC0603FR 系 / UNI 0603WAF 系，47Ω 还是 Basic 料）；薄膜 0.1% 0603（YAGEO RT0603BRE 系，±50ppm） |
| **§5.2 面积收益①** | 1210→0805：外廓 **−8.00 mm²/件（−63.5%）**，双通道 ×4 = **−32.0 mm²** | §4 |
| **§5.2 面积收益②** | 0805→0603：外廓 **−2.62 mm²/件（−57.0%）**，×4 = **−10.5 mm²** | §4 |

---

## 1. 电容逐项核查

> 通用口径：介质一律 **C0G/NP0**（无直流偏压跌落，符合 r5 规格 C4）；耐压全选 **50V** 档
> （本应用节点电压 ≤3.3 V，50V 档余量 >15×；25V 档备选亦可满足，见各行）。
> 本体尺寸取 LCSC 元件库 3D 模型名（如 `C0805_L2.0-W1.3-H1.3`）；焊盘面积取嘉立创EDA
> 标准封装库实测几何（§3，与生产 BOM「Footprint」列同库）。

### 1.1 22 nF / 0805 / C0G（FO1_A 的 C_G）

| 项 | 值 | 来源 |
|---|---|---|
| 主选料（LCSC 现货） | **村田 GCM21B5C1H223FA16L**：±1%、50V、C0G、0805 | LCSC C1864305 |
| 备选（全球渠道） | 村田 GRM21B5C1H223JA01L（±5%，商用 GRM，≈$0.29@1pcs）；GCM21B5C1H223JA16K（±5%）；TDK C2012C0G1H223J125AA/AE（±5%，LCSC 今日 0/8 只） | DigiKey 586677 / 4903978；LCSC C2170238 / C3839805 |
| 容差 | ±1%（GCM 主选）/ ±5%（备选）——±1% 档对 D8 配对是加分项（任务书 §3.1「优先 ±5%，另跑 ±1%」） | LCSC 目录参数 |
| 介质 / 耐压 | C0G（NP0）/ 50V（TDK 25/35/100V 档亦在目录） | LCSC 目录参数 |
| 封装 / 本体 | 0805（2012 公制）/ **2.0 × 1.3 × 1.3 mm**（3D 模型名） | LCSC 库 `C0805_L2.0-W1.3-H1.3` |
| 焊盘（嘉立创EDA `C0805`） | 单焊盘 1.41 × 1.35 mm，中心距 2.00 mm → 图形外廓 **3.41 × 1.35 mm**；铜面积 2×1.90 = **3.81 mm²**；外廓面积 **4.60 mm²** | §3 实测 |
| SRF 估算 | ESL 0.9–1.2 nH → **31–36 MHz**（> fMOD 4.096 MHz ×7.6，> MCLK 16.384 MHz ×1.9）——理论估算，ESL 档取 r5_bom_check.md :120–126 | §4.3 |
| 可采购性 | **可采购**。LCSC 现货 521 只（快照 2026-10-24，$0.331）；TDK ±5% 档 LCSC 0–8 只/preSale；DigiKey/TME 全球有货。样机（4 只/板）够用，量产备货建议锁定 DigiKey 商用 GRM ±5% 或预订 | LCSC C1864305 页 + DigiKey 链接（§7） |

### 1.2 10 nF / 0603 / C0G（FO1_B、FO1_C 的 C_G）

| 项 | 值 | 来源 |
|---|---|---|
| 主选料 | **村田 GRM1885C1H103JA01D**：±5%、50V、C0G、0603 | LCSC C85973 |
| 容差 / 介质 / 耐压 | ±5% / C0G / 50V | LCSC 目录参数（村田 SBAS 系数据手册，页面附 datasheet 链接） |
| 封装 / 本体 | 0603（1608）/ **1.6 × 0.8 × 0.8 mm** | LCSC 库 `C0603_L1.6-W0.8-H0.8` |
| 焊盘（`C0603`） | 单焊盘 0.80 × 0.90 mm，中心距 1.40 mm → 外廓 **2.20 × 0.90 mm**；铜面积 **1.44 mm²**；外廓面积 **1.98 mm²** | §3 实测 |
| SRF 估算 | ESL 0.5–0.9 nH → **53–71 MHz**（> fMOD ×13） | §4.3 |
| 可采购性 | **可采购**：LCSC 现货 207,500 只（$0.0196）；DigiKey 同料 ≈32.5 万只（4421555） | LCSC/DigiKey（§7） |

### 1.3 6.8 nF / 0603 / C0G（FO1_C 的 C_D）

| 项 | 值 | 来源 |
|---|---|---|
| 主选料 | **村田 GRM1885C1H682JA01D**：±5%、50V、C0G、0603 | LCSC C162241 |
| 封装 / 本体 | 0603 / 1.6 × 0.8 × 0.8 mm | LCSC 库 3D 名 |
| 焊盘 | 同 §1.2（`C0603`） | §3 |
| SRF 估算 | ESL 0.5–0.9 nH → **64–86 MHz** | §4.3 |
| 可采购性 | **可采购**：LCSC 现货 85,750 只（$0.0121） | LCSC C162241 页 |

### 1.4 47 nF / 1210 / C0G（FO1_BASE 的 C_G，按任务书指定封装）

| 项 | 值 | 来源 |
|---|---|---|
| 指定料 | **TDK C3225C0G1H473J200AA**：±5%、50V、C0G、1210 | LCSC C3846358 |
| 容差 / 介质 / 耐压 | ±5% / C0G（0±30ppm/℃）/ 50V | LCSC 目录 + DigiKey 页 |
| 封装 / 本体 | 1210（3225）/ **3.2 × 2.5 mm**，厚 ≤2.5 mm（LCSC 3D `H2.5`；DigiKey 摘要写 max 2 mm，**两处不一致，标 NOT VERIFIED**——不影响 X-Y 占地，但影响回流与外壳间隙） | LCSC 库 `C1210_L3.2-W2.5-H2.5` |
| 焊盘（`C1210`） | 单焊盘 1.635 × 2.70 mm，中心距 3.035 mm → 外廓 **4.67 × 2.70 mm**；铜面积 **8.83 mm²**；外廓面积 **12.61 mm²** | §3 实测 |
| SRF 估算 | ESL 1.2–1.5 nH → **19–21 MHz**（> fMOD ×4.6–5.2；> MCLK 仅 ×1.2–1.3，**贴近**，PCB 走线需短） | §4.3 |
| 可采购性 | **⚠️ 全球可采购、LCSC 今日 0 库存**：DigiKey ≈3,136（$4.99 起）、Mouser ≈1,009、Arrow 有货；LCSC 0 只（preSale，$0.074）。本项目 SMT 走嘉立创/LCSC 渠道，**若坚持 1210 需改走 DigiKey/Mouser 或预订** | DigiKey 970469 / Mouser（§7） |
| 同值更小封装（任务书外） | **1206**：村田 GRM31M5C1H473JA01L（C21812，LCSC 现货 **51,375** 只）、TDK C3216C0G1H473J115AA（C2170734，0 只）——见 §5 冲突记录 | LCSC 页 |

### 1.5 820 pF / 0603 / C0G（四方案共用的 C_D）

| 项 | 值 | 来源 |
|---|---|---|
| 主选料 | **村田 GRM1885C1H821JA01D**：±5%、50V、C0G、0603 | LCSC C701305 |
| 封装 / 本体 | 0603 / 1.6 × 0.8 × 0.8 mm | LCSC 库 3D 名 |
| 焊盘 | 同 §1.2 | §3 |
| SRF 估算 | ESL 0.5–0.9 nH → **185–249 MHz** | §4.3 |
| 可采购性 | **可采购**：LCSC 现货 4,600 只（$0.0077） | LCSC C701305 页 |

### 1.6 目录在册但今日 0 库存的 22nF/0805 备选（如实列出）

TDK C2012C0G1H223J125AA（C2170238，preSale）、C2012C0G1V223J060AC（35V，C3839201，preSale）、
C2012C0G1E223J125AA（25V，C3887789，preSale）、C2012C0G2A223J125AC（100V，C2170006，0 只）、
CGA4J2C0G1H223J125AE（车规，C3892060，preSale）、KEMET C0805C223J3GALTU（25V，C2315046，preSale）；
另 KEMET **C0805X473F3GEC（47nF/0805/NP0 ±1% 25V，C19554891）目录在册、0 库存**——
若将来有货，BASE 可直落 0805，**当前不视为可采购**。

---

## 2. 电阻逐项（R = 47 / 100 / 200 Ω，按既有 BOM 口径）

既有 BOM 口径（`BOM_Board1_Schematic1_2026-10-22.csv:29–36` + `r5_bom_check.md` §5.5）：
AAF 串联 R 用 **0603**；普通位厚膜 1%（UNI 厚声 0603WAF / YAGEO AC、RC 系），
D8/C9 关键位薄膜 0.1%（r5_bom_check §5.5 规定首级 0.1% 薄膜）。任务书 §3.1 取 R 容差 ±1%。
→ **两口径都给**：厚膜 1% 为默认（任务书口径），薄膜 0.1% 为 D8 配对升级（r5 口径）。

| 阻值 | 口径 A：厚膜 1%（默认） | 口径 B：薄膜 0.1%（D8 升级） |
|---|---|---|
| 47 Ω | YAGEO **RC0603FR-0747RL**（C114623，现货 850,600，$0.0025）；UNI 厚声 **0603WAF470JT5E**（C23182，现货 952,200，**Basic 料**）；抗硫化 YAGEO AC0603FR-0747RL（C144656，600 只，与 BOM 6.19Ω 同系） | YAGEO **RT0603BRE0747RL**（C705861，现货 2,160，$0.0164） |
| 100 Ω | YAGEO **RC0603FR-07100RL**（C105588，现货 1,350,900） | YAGEO **RT0603BRE07100RL**（C705801，现货 9,700） |
| 200 Ω | YAGEO **RC0603FR-07200RL**（C114664，现货 4,351,300） | YAGEO **RT0603BRE07200RL**（C861744，现货 4,320） |

公共参数（两口径同）：封装 0603；本体 1.6 × 0.8 × 0.8 mm（1.28 mm²）；
额定功率 100 mW；**最大工作电压 75 V**（本应用压降 ≤200Ω×~30µA ≪ 1 mV 量级，毫无压力）；
焊盘（嘉立创EDA `R0603`）：单焊盘 0.806 × 0.864 mm、中心距 1.507 mm → 外廓 **2.31 × 0.86 mm**，
铜面积 1.39 mm²，外廓面积 **2.00 mm²**（§3）。
温漂：厚膜 ±100 ppm/℃、薄膜 ±50 ppm/℃（LCSC 目录参数）。
「介质」对应口径：厚膜（thick film）/ 薄膜（thin film，镍铬溅射）。
**UNI 厚声 0603WAF 的 100Ω/200Ω 精确料号本次未在库中命中**（0603WAF1000JT5E / 0603WAF2000JT5E 查无），
不影响结论——YAGEO RC0603FR 同规格大量现货，且 BOM 中两品牌本就混用。

---

## 3. 焊盘几何原始数据（嘉立创EDA 专业版标准封装库实测）

**取证方法**：本机 EasyEDA Pro 桥接（`http://127.0.0.1:49620/execute`）调
`eda.lib_Footprint.getDocumentSource(footprintUuid)`，读取生产 BOM 所用同名封装
（`C0603` / `R0603` / `C0805` / `C1206` / `C1210`）的 PAD 原始 JSON。
坐标单位 1 unit = 1 mil = 0.0254 mm（库内数值如 39.37 ↔ 1.0000 mm，自洽验证通过）。

| 封装 | PAD 原始值（mil：cx=中心X，w×h=宽×高） | 单焊盘（mm） | 中心距（mm） |
|---|---|---|---|
| `C0603` | cx=±27.56，w=31.496，h=35.433 | 0.800 × 0.900 | 1.400 |
| `R0603` | cx=±29.66，w=31.751，h=34.016 | 0.806 × 0.864 | 1.507 |
| `C0805` | cx=±39.37，w=55.512，h=53.15 | 1.410 × 1.350 | 2.000 |
| `C1206` | cx=±62.70，w=58.465，h=68.031 | 1.485 × 1.728 | 3.185 |
| `C1210` | cx=±59.74，w=64.37，h=106.299 | 1.635 × 2.700 | 3.035 |

**面积口径**（三种，全部按上表几何计算）：

| 封装 | 本体面积（mm²） | 焊盘铜面积（mm²） | 焊盘图形外廓（mm） | 外廓面积（mm²） |
|---|---:|---:|---|---:|
| C0603 | 1.28 | 1.44 | 2.20 × 0.90 | 1.98 |
| R0603 | 1.28 | 1.39 | 2.31 × 0.86 | 2.00 |
| C0805 | 2.60 | 3.81 | 3.41 × 1.35 | 4.60 |
| C1206 | 5.12 | 5.13 | 4.67 × 1.73 | 8.07 |
| C1210 | 8.00 | 8.83 | 4.67 × 2.70 | 12.61 |

> 外廓面积 = 焊盘图形轴向总长 × 宽，**不含丝印/ courtyard 间距**；实际贴装节距收益略小于外廓比例
>（相邻件间至少留 0.2–0.5 mm 间隙，同族件间隙近似常数，大件省的绝对面积略被吃掉一点）。
> 计算脚本与原始输出存证见 §7。

---

## 4. §5.2 面积收益估算

### 4.1 两档指定收益（每件 → 双通道 4 件 C_G）

| 换档 | 本体（mm²） | 焊盘铜（mm²） | 图形外廓（mm²） |
|---|---|---|---|
| **① 47nF/1210 → 22nF/0805** | 8.00 → 2.60，**Δ −5.40/件（−67.5%）**，×4 = **−21.6** | 8.83 → 3.81，**Δ −5.02/件（−56.9%）**，×4 = −20.1 | 12.61 → 4.60，**Δ −8.00/件（−63.5%）**，×4 = **−32.0** |
| **② 22nF/0805 → 10nF/0603** | 2.60 → 1.28，**Δ −1.32/件（−50.8%）**，×4 = −5.3 | 3.81 → 1.44，**Δ −2.37/件（−62.2%）**，×4 = −9.5 | 4.60 → 1.98，**Δ −2.62/件（−57.0%）**，×4 = **−10.5** |

**解读（与「值不值」相关的面积侧事实，非性能结论）**：
档② 相对档① 的**边际**外廓收益只有 10.5 mm²（双通道合计），且是「0805 已拿到」之后的增量；
档② 的真实动机只能是「全链 0603 化」（B/C 案 C_G、C_D 与 R 全部 0603，备料/贴装统一），
单为 10.5 mm² 不值得为它付出 R 47→200Ω 的 ADC 加载/畸变风险或 C_D 改 6.8nF 的共模 fc 代价
——那两笔账归 D 系判据（其他子任务），本文只给面积数字。

### 4.2 四方案占地总表（双通道 = 4R + 4C_G + 2C_D，mm²，外廓口径）

| 方案 | R（0603×4） | C_G（×4） | C_D（0603×2） | 本体合计 | 铜合计 | **外廓合计** |
|---|---|---|---|---:|---:|---:|
| FO1_BASE（47nF/**1210**） | 2.00 | 12.61 | 1.98 | 39.68 | 43.77 | **62.4** |
| FO1_BASE′（47nF/**1206** 变体，§5 冲突发现） | 2.00 | 8.07 | 1.98 | 28.16 | 28.98 | **44.2** |
| FO1_A（22nF/0805） | 2.00 | 4.60 | 1.98 | 18.08 | 23.68 | **30.4** |
| FO1_B（10nF/0603） | 2.00 | 1.98 | 1.98 | 12.80 | 14.21 | **19.9** |
| FO1_C（10nF+6.8nF/0603） | 2.00 | 1.98 | 1.98 | 12.80 | 14.21 | **19.9** |

A 相对 BASE 省 32.0 mm²（−51%）；B/C 相对 BASE 省 42.5 mm²（−68%）；
B/C 相对 A 再省 10.5 mm²（−35%）。**注意任务书 §5.2 纪律：面积更合适 ≠ 指标通过，D1–D3 判定另见 REPORT.md。**

### 4.3 SRF 理论估算（T12「SRF(如有)」，非实测）

f_SRF = 1/(2π√(L·C))，ESL 取 `r5_bom_check.md:120–126` 的封装档位
（0603：0.5–0.9 nH；0805：≈0.9 nH，本文放宽至 0.9–1.2；1206：≈1.2；1210：按 1.2–1.5）：

| 器件 | ESL 档（nH） | SRF 估算 | vs fMOD 4.096 MHz | vs MCLK 16.384 MHz |
|---|---|---|---|---|
| 820pF/0603 | 0.5–0.9 | 185–249 MHz | ×45–61 | ×11–15 |
| 6.8nF/0603 | 0.5–0.9 | 64–86 MHz | ×16–21 | ×3.9–5.3 |
| 10nF/0603 | 0.5–0.9 | 53–71 MHz | ×13–17 | ×3.2–4.3 |
| 22nF/0805 | 0.9–1.2 | 31–36 MHz | ×7.6–8.7 | ×1.9–2.2 |
| 47nF/1210 | 1.2–1.5 | 19–21 MHz | ×4.6–5.2 | **×1.2–1.3（贴近）** |
| 47nF/1206 | ≈1.2 | 21 MHz | ×5.2 | ×1.3 |

全部 ≫ fMOD；47nF 档对 MCLK 只有 1.2–1.3× 余量——沿用 r5_bom_check §3.4 的既有要求：
**接地回路 <3 mm + 多过孔，样机阶段网络分析仪实测 SRF/ESR 回填**。此为理论估算层（非 LTspice、非实测）。

---

## 5. 冲突记录（任务书 vs 仓库/市场事实）

| # | 任务书表述 | 实测事实 | 处理 |
|---|---|---|---|
| C-1 | 优先级行：「47 nF C0G **只能取得 1210**」 | ① 生产 BOM 自己就在用 **68nF/1206 C0G**（GRM31C5C1H683JA01L，C77084，现货 6,000）——更大容值都在 1206；② LCSC 目录 **47nF/1206 C0G** 有村田 GRM31M5C1H473JA01L（C21812，**现货 51,375**）与 TDK C3216C0G1H473J115AA（C2170734，0 只）；③ KEMET 47nF/0805/NP0 ±1%（C19554891）目录在册但 0 库存 | 按任务书指定仍以 **47nF/1210** 出正式行（§1.4），另立 **1206 变体行**（§4.2）：BASE 若改 1206，**零电路改动**即省 4.54 mm²/件（外廓 −36%）、且 LCSC 现货充足。是否采纳归用户/主报告裁决 |
| C-2 | 「47nF/1210」隐含可购 | 该档 **LCSC 今日 0 库存**（TDK C3225C0G1H473J200AA preSale）；现货只在 DigiKey/Mouser/Arrow（≈3.1k/1.0k/有） | 如实标注 ⚠️：走 LCSC/嘉立创 SMT 需预订或改 1206/0805 档 |
| C-3 | 「22nF/0805 C_G 暂按 0805」假设 | 成立但 LCSC 现货只有 **±1%** 档（GCM21B5C1H223FA16L，521 只）；±5% 商用档（GRM21B5C1H223JA01L）在 DigiKey | 面积假设✅；容差比假设更好（±1%），采购面窄，量产需锁渠道 |

---

## 6. NOT VERIFIED 清单（不编造，缺什么写什么）

| 项 | 缺什么 |
|---|---|
| LCSC/DigiKey 库存的**时效性** | 快照 2026-10-24 01:20 CST；下单前必须复核（E.10 #6 归用户） |
| 47nF/1210 的**本体最大厚度** | LCSC 3D 模型 H=2.5 mm vs DigiKey 摘要 "max 2 mm"，两源矛盾；需查 TDK 官方图纸（CGA/C 系列 dimension 表）定案。不影响 X-Y 占地结论 |
| **SRF/ESL 实测值** | §4.3 为理论估算（ESL 用 r5 档位）；厂商 S 参数/阻抗曲线未逐料下载，样机实测前不得当实测值引用 |
| KEMET C0805X473F3GEC（47nF/0805/NP0 ±1%）| 仅目录在册（C19554891），0 库存、无现货渠道证据；**不列为可采购** |
| UNI 厚声 100Ω/200Ω 0603WAF 精确料号 | 库内未命中（YAGEO 同规格替代已覆盖，不影响四方案成立） |
| 1210 档在嘉立创 SMT 的**长期组装可得性**（Basic/Extended 之外的经济性） | 未评；所有候选件均为 Extended Part |
| 22nF/0805 ±5% 档的 LCSC 长期供货 | 今日仅 ±1% 档有货，量产 BOM 若要 ±5% 需改 DigiKey/预订，成本模型未建 |

---

## 7. 证据与复现路径

**本机资料**
- 任务书：`hardware/sim/Zcode_LTspice_一阶RC四方案复核任务书.md`（T12=:156；§5.2=:187–198；四方案表=:73–80）
- BOM 口径：`hardware/BOM_Board1_Schematic1_2026-10-22.csv`（68nF/1206=:6、27nF/0805=:8、12nF/0805=:9、AAF R=:29–36）
- ESL/SRF 方法：`hardware/sim/aaf/r5_bom_check.md:120–126`（§3.2 封装 ESL 档位）、§3.4（样机实测要求）
- 手册背景：`hardware/sim/aaf/r5_datasheet_facts.md`（ADC Cs/Zin——与 T12 无直接耦合，仅链路背景）

**本轮执行的操作（全部真实运行）**
1. LCSC 元件库检索：本机 EasyEDA Pro 桥接 `POST http://127.0.0.1:49620/execute`，
   `eda.lib_Device.search(<MPN 或容值关键词>)`（只读），命中含 `supplierId`（LCSC C 号）、目录参数、3D 模型名、datasheet 链接
2. LCSC 实时库存/价格：`curl -sL https://www.lcsc.com/product-detail/<C号>.html`，解析产品 JSON 块
   `"stockNumber"`/`"isPreSale"`/`"price"`（快照 2026-10-24 01:20 CST；例：C1864305→521、C21812→51375、C3846358→0+preSale）
3. 焊盘几何：同桥接 `eda.lib_Footprint.getDocumentSource(uuid)` 取 `C0603/R0603/C0805/C1206/C1210` PAD 原始 JSON（§3 表即原始值）
4. 面积/SRF 计算：Python 脚本（mil→mm、面积、Δ、SRF），数字见 §3/§4，无手算环节
5. 全球渠道交叉：WebSearch 命中 DigiKey/Mouser/Arrow/TME 产品页（链接如下）

**关键外链（检索所得，2026-10-24 访问）**
- 22nF/0805 C0G ±1%（LCSC 现货）：https://www.lcsc.com/product-detail/C1864305.html
- 22nF/0805 C0G ±5% 商用 GRM（DigiKey）：https://www.digikey.com/en/products/detail/murata-electronics/GRM21B5C1H223JA01L/586677
- 10nF/0603 C0G：https://www.lcsc.com/product-detail/C85973.html ；DigiKey https://www.digikey.com/en/products/detail/murata-electronics/GRM1885C1H103JA01D/4421555
- 6.8nF/0603 C0G：https://www.lcsc.com/product-detail/C162241.html
- 820pF/0603 C0G：https://www.lcsc.com/product-detail/C701305.html
- 47nF/1210 C0G TDK：LCSC https://www.lcsc.com/product-detail/C3846358.html ；DigiKey https://www.digikey.cn/en/products/detail/tdk/C3225C0G1H473J200AA/970469 ；Mouser https://www.mouser.com/en/ProductDetail/TDK/C3225C0G1H473J200AA
- 47nF/1206 C0G 村田（冲突发现主证据）：https://www.lcsc.com/product-detail/C21812.html
- 电阻：RC0603FR-0747RL https://www.lcsc.com/product-detail/C114623.html ；RT0603BRE0747RL https://www.lcsc.com/product-detail/C705861.html （100/200Ω 同系 C105588/C114664/C705801/C861744）
- 生产 BOM 既有 C0G 档对照：C77084（68nF/1206）、C3882413（27nF/0805）、C97906（12nF/0805）
