chenxi-z/de-drms/hardware/BOM_Board1_Schematic1_2026-10-22.csv

No. | Quantity | Comment | Designator | Footprint | Value | Manufacturer Part | Manufacturer | Supplier Part | Supplier
1 | 6 | 20pF | C1,C2,C15,C16,C26,C27 | C0603 | 20pF | CL10C200JB8NNNC | SAMSUNG(三星) | C1648 | LCSC
2 | 10 | 2.2uF | C3,C4,C12,C13,C17,C24,C63,C64,C65,C66 | C0805 | 2.2uF | CL21B225KAFNNNE | SAMSUNG(三星) | C19110 | LCSC
3 | 21 | 100nF | C5,C6,C7,C14,C18,C19,C20,C21,C22,C23,C37,C38,C39,C40,C41,C44,C56,C59,C60,C61,C62 | C0402 | 100nF | CL05B104KB54PNC | SAMSUNG(三星) | C307331 | LCSC
4 | 14 | 1uF | C8,C9,C10,C11,C25,C28,C31,C32,C33,C34,C35,C55,C57,C58 | C0603 | 1uF | CL10B105KB8NQNC | SAMSUNG(三星) | C5199872 | LCSC
5 | 8 | 68nF | C29,C36,C42,C43,C48,C49,C50,C51 | C1206 | 68nF | GRM31C5C1H683JA01L | muRata(村田) | C77084 | LCSC
6 | 1 | 270nF | C30 | C0603 | 270nF | TCC0603X7R274K500CT | CCTC(三环) | C376826 | LCSC
7 | 4 | 27nF | C45,C46,C52,C53 | C0805 | 27nF | GRM2165C1H273JA01D | muRata(村田) | C3882413 | LCSC
8 | 2 | 12nF | C47,C54 | C0805 | 12nF | GRM2195C1H123JA01D | muRata(村田) | C97906 | LCSC
9 | 1 | TF PUSH | CARD1 | TF-SMD_TF-PUSH |  | TF PUSH | SHOU HAN(首韩) | C393941 | LCSC
10 | 1 | HC-ZH1.5-3AW | CN1 | CONN-TH_3P-P1.50_HCTL_HC-ZH1.5-3AW |  | HC-ZH1.5-3AW | HCTL(华灿天禄) | C2845566 | LCSC
11 | 1 | 1.25-8P WT | CN2 | CONN-SMD_8P-P1.25-L4.4-W14.8 |  | 1.25-8P WT | SHOU HAN(首韩) | C2681529 | LCSC
12 | 1 | ZX-XH2.54-4PZZ | CN3 | CONN-TH_4P-P2.50_4PIN |  | ZX-XH2.54-4PZZ | Megastar(兆星) | C7429634 | LCSC
13 | 11 | 0402ESDA-05N | D1,D2,D3,D4,D9,D10,D11,D12,D13,D14,D15 | D0402-BI |  | 0402ESDA-05N | BORN(伯恩半导体) | C316049 | LCSC
14 | 4 | BAV199-QR | D5,D6,D7,D8 | SC-70-3_L2.1-W1.3-P1.30-LS2.2-BR |  | BAV199-QR | Nexperia(安世) | C7507588 | LCSC
15 | 1 | B5819WS | D16 | SOD-323_L1.7-W1.3-LS2.5-FD |  | B5819WS | R+O(宏嘉诚) | C7420331 | LCSC
16 | 1 | 2.2uH | L1 | L0805 | 2.2uH | LQM21PN2R2MGHL | muRata(村田) | C341781 | LCSC
17 | 1 | BLM18KG601SN1D | L2 | L0603 |  | BLM18KG601SN1D | muRata(村田) | C85833 | LCSC
18 | 3 | GL0603UW01 | LED1,LED2,LED5 | LED0603-R-RD |  | GL0603UW01 | Guiguang light(桂光光电) | C51933297 | LCSC
19 | 1 | GL0603UG01 | LED3 | LED0603-RD |  | GL0603UG01 | Guiguang light(桂光光电) | C51933293 | LCSC
20 | 2 | GL0603UR01 | LED4,LED7 | LED0603-FD |  | GL0603UR01 | Guiguang light(桂光光电) | C51933292 | LCSC
21 | 1 | GL0603UO01 | LED6 | LED0603-FD |  | GL0603UO01 | Guiguang light(桂光光电) | C51933298 | LCSC
22 | 2 | BSS138L | Q2,Q3 | SOT-23-3_L2.9-W1.3-P1.90-LS2.4-BR |  | BSS138L | ElecSuper(静芯) | C5224264 | LCSC
23 | 9 | 1MΩ | R1,R2,R3,R6,R7,R15,R29,R53,R70 | R0402 | 1MΩ | 0402WGF1004TCE | UNI-ROYAL(厚声) | C26083 | LCSC
24 | 2 | 5.1kΩ | R4,R5 | R0402 | 5.1kΩ | 0402WGF5101TCE | UNI-ROYAL(厚声) | C25905 | LCSC
25 | 18 | 1kΩ | R8,R9,R10,R11,R12,R14,R16,R18,R19,R20,R31,R42,R52,R63,R64,R65,R66,R67 | R0402 | 1kΩ | 0402WGF1001TCE | UNI-ROYAL(厚声) | C11702 | LCSC
26 | 3 | 100kΩ | R13,R21,R50 | R0402 | 100kΩ | 0402WGF1003TCE | UNI-ROYAL(厚声) | C25741 | LCSC
27 | 1 | 100kΩ | R17 | R0805 | 100kΩ | PTFR0805A100KN9 | RESI(开步睿思) | C19679999 | LCSC
28 | 4 | 6.19Ω | R22,R23,R36,R37
 | R0603 | 6.19Ω | AC0603FR-076R19L | YAGEO(国巨) | C228034 | LCSC
29 | 4 | 6.04Ω | R24,R25,R38,R39 | R0603 | 6.04Ω | TC0325B604KT5F | UNI-ROYAL(厚声) | C53109433 | LCSC
30 | 2 | 150kΩ | R26,R30 | R0805 | 150kΩ | RT0805BRD07150KL | YAGEO(国巨) | C136927 | LCSC
31 | 1 | 360kΩ | R27 | R0805 | 360kΩ | RT0805BRE07360KL | YAGEO(国巨) | C723663 | LCSC
32 | 1 | 200kΩ | R28 | R0805 | 200kΩ | RT0805BRD07200KL | YAGEO(国巨) | C728645 | LCSC
33 | 3 | 0Ω | R32,R33,R51 | R0603 | 0Ω | 0603WAF0000T5E | UNI-ROYAL(厚声) | C21189 | LCSC
34 | 4 | 13.7Ω | R34,R35,R40,R41 | R0603 | 13.7Ω | 0603WAF137JT5E | UNI-ROYAL(厚声) | C22794 | LCSC
35 | 14 | 33Ω | R43,R44,R45,R46,R47,R48,R49,R56,R57,R58,R59,R60,R61,R62 | R0402 | 33Ω | RC-02K33R0FT | FH(风华) | C324773 | LCSC
36 | 2 | 22Ω | R54,R55 | R0402 | 22Ω | RC0402FR-0722RL | YAGEO(国巨) | C114765 | LCSC
37 | 2 | 4.7kΩ | R68,R69 | R0402 | 4.7kΩ | 0402WGF4701TCE | UNI-ROYAL(厚声) | C25900 | LCSC
38 | 4 | - | RF1,RF2,RF3,RF4 | SMA-TH_BWSMA-KWE-Z001 | - | BWSMA-KWE-Z001 | BAT WIRELESS(蝙蝠无线) | C496551 | LCSC
39 | 2 | SKRPACE010 | SW1,SW2 | KEY-SMD_4P-L4.2-W3.2-P2.20-LS4.6 |  | SKRPACE010 | ALPSALPINE(阿尔卑斯阿尔派) | C139797 | LCSC
40 | 2 | SKSCLDE010 | SW3,SW4 | KEY-SMD_4P-SKSCLXX010 |  | SKSCLDE010 | ALPSALPINE(阿尔卑斯阿尔派) | C115362 | LCSC
41 | 1 | BQ24040DSQR | U2 | WSON-10_L2.0-W2.0-P0.40-BL-EP |  | BQ24040DSQR | TI(德州仪器) | C81080 | LCSC
42 | 1 | TPS7A0233PDBVR | U3 | SOT-23-5_L2.9-W1.6-P0.95-LS2.8-BR |  | TPS7A0233PDBVR | TI(德州仪器) | C2887324 | LCSC
43 | 1 | TPS7A2033PDBVR | U4 | SOT-23-5_L2.9-W1.6-P0.95-LS2.8-BR |  | TPS7A2033PDBVR | TI(德州仪器) | C2862740 | LCSC
44 | 2 | OPA2388IDGKT | U5,U9 | VSSOP-8_L3.0-W3.0-P0.65-LS4.9-BL |  | OPA2388IDGKT | TI(德州仪器) | C2876415 | LCSC
45 | 1 | STM32U545RET6Q | U6 | LQFP-64_L10.0-W10.0-P0.50-LS12.0-BL |  | STM32U545RET6Q | ST(意法半导体) | C20033865 | LCSC
46 | 1 | ADS131A02IPBS | U7 | TQFP-32_L5.0-W5.0-P0.50-LS7.0-BL |  | ADS131A02IPBS | TI(德州仪器) | C1520680 | LCSC
47 | 1 | TPS22917DBVR | U8 | SOT-23-6_L2.9-W1.6-P0.95-LS2.8-BR |  | TPS22917DBVR | TI(德州仪器) | C2681320 | LCSC
48 | 1 | TMUX1134PWR | U10 | TSSOP-20_L6.5-W4.4-P0.65-LS6.4-BL |  | TMUX1134PWR | TI(德州仪器) | C2866620 | LCSC
49 | 1 | OPA333AIDBVR | U13 | SOT-23-5_L3.0-W1.7-P0.95-LS2.8-BR |  | OPA333AIDBVR | TI(德州仪器) | C30878 | LCSC
50 | 1 | TYPE-C 16PIN 2MD(073) | USB1 | USB-C-SMD_TYPE-C-16PIN-2MD-073 |  | TYPE-C 16PIN 2MD(073) | SHOU HAN(首韩) | C2765186 | LCSC
51 | 1 | 32.768kHz | X2 | FC-135R_L3.2-W1.5 | 32.768kHz | Q13FC13500004 | EPSON(爱普生) | C32346 | LCSC
52 | 1 | 16.384MHz | X3 | CRYSTAL-SMD_4P-L3.2-W2.5-BL | 16.384MHz | XL2EL89CSI-111YLC-16.384M | YXC(扬兴晶振) | C19711731 | LCSC
53 | 1 | 16MHz | X4 | CRYSTAL-SMD_4P-L3.2-W2.5-BL | 16MHz | X322516MOB4SI | YXC(扬兴晶振) | C12668 | LCSC
