chenxi-z/de-drms/hardware/sim/aaf/r5_bom_check.md

# Round 5 BOM 可购性核查表 —— **第 4 轮（定档轮）B 案冻结参数版**

- **初版日期**：2026-10-18（第 1 轮参数，三案）
- **本次更新**：2026-10-19（**第 4 轮：B 案 C9 修复后的冻结参数重核**；C 案降为附录对照）
- **依据**：`docs/design/spec/2026-10-18-aa-driver-design.md` **v4** §5.1 / §5.2（C2/C3/C4/C5/C9）
- **冻结参数来源**：`r5_candidates_final_B.json`（`"source": "r4/c9-fix"`）+ `r5_results_r4_B.json`（实测）
- **数据来源**：
  - 元件值：`r5_results_r4_B.json` 的 `stages`（B 案第 4 轮冻结值）
  - ESL/ESR 敏感性：**本轮按冻结参数重跑**，`r5_bom_esl_esr_r4.json` + `r5_work/r4_B/r5_B_r4_besl_*.net`
    （真实 OPA388 模型，**L 只串在电容支路**，与第 3 轮 BOM 的网表同构）
  - D8 配对曲线：`r5_results_r4_B.json` 的 `D8_detail`（三档配对 + 同向 1 %，LTspice 实测）
  - C9 / D5 余量：`r5_r4_c9_source_sweep*.json`、`r5_r4_c9_sensitivity.json`、`r5_r4_d5_gap_sweep.json`
- **纪律**：**具体料号、价格、库存、交期不在本表**——E.10 #6 归用户核实（`AGENTS.md`「外部依赖余项」）。
  本表只做**档位映射、介质/寄生核查与配对工序规定**，不替用户选料。

---

## 0. 结论摘要（第 4 轮 · B 案冻结）

| 检查项 | 结论 |
|---|---|
| **冻结参数** | **R = 6.19 / 6.04 / 13.7 Ω；C_gnd = 68 / 68 / 27 nF；C_diff = 12 nF**；13 件/通道 |
| **电阻档位** | **三个阻值全部是 E96 的精确标称值**（619 / 604 / 137 均为 E96 系列值）→ **零取整误差** ✅（**修正第 3 轮 BOM 的说法**：旧表写"13.7 最近 E96 = 13.66 / −0.29 %"是**用了截断的 E96 表**，E96 确有 13.7） |
| **E24 可用性** | **三个值都落不进 E24**（E24 近邻 6.2 / 6.2 / 13.0）。E24 替代方案 `6.2 / 6.2 / 13` 经引擎复算 D1 84.07 dB、D4 0.1841 dB，**min 几乎不变（0.7006 vs 0.7003）** → **E24 可作降本备选，但需重新跑一轮 LTspice 确认** |
| **电容档位** | 68 / 27 / 12 nF **全部是 E12 精确值** ✅ |
| **单电容最大值（C3）** | **68 nF**（限 100 nF）→ 余量 1.47× ✅ |
| **总串联电阻（C2）** | **25.93 Ω**（限 5000 Ω）→ 余量 193× ✅ |
| **>47 nF 的 SRF（C3 强制）** | 68 nF 的临界 ESL（SRF = MCLK 16.384 MHz）= **1.39 nH**；0603 C0G 典型 0.5–0.9 nH（SRF 19.3–27.3 MHz）→ ✅ **0603 或 0805 均可**；1206（≈1.2 nH，SRF 15.8 MHz）仍 > fMOD ✅ |
| **ESL/ESR 敏感性（本轮重跑）** | **B 对 ESL/ESR 不敏感**：ESL 0→2 nH 使 D1 **+1.91 dB**；D3 在 1.0–2.0 nH 区间抬到 153.6–180.7 dB（**+21 ~ +48 dB**，在 1.5 nH 附近有窄峰，**不可当设计依据**）；ESR 0.02→0.10 Ω 使 D3 **155.4 → 140.0 dB（−15.4 dB）**、D1 基本不动 → **D3 仍有 40 dB 余量**，不构成风险 |
| **R·C 配对（C5）** | 1 % 单体 + 异向配对 → **95.51 dB**（≥80 及格）；同向 1 % 只有 **48.34 dB**（物理上限）→ **配对工序是 D8 过线的唯一途径**（§5） |
| **C9 的 BOM 约束** | 首级 R **不得小于 6.19 Ω**（含 0.1 % 容差下沿 6.18 Ω）：Rs≈60 kΩ 时跟随器峰 **5.82 dB（0.1 % 实配）/ 5.88 dB（1 % 容差角）**，限 6 dB，**余量仅 0.18 / 0.12 dB** ⚠️ |
| **C9 的电容约束** | 首级 C_gnd **不得大于 68 nF**（68 nF 是 C9 与 D4 的平衡点；再大则跟随器峰升高）；**C 的 C0G 容差 ±5 % 会吃掉 0.06 dB 余量**，建议采购 ±2 % 档或实测筛选 |

**一句话**：B 案冻结参数在可购性上是三案里**最干净的一版**——R 全 E96 精确、C 全 E12 精确、
ΣR 25.93 Ω、最大容值 68 nF（远低于 100 nF 上限）、ESL/ESR 不敏感；
真正的量产门槛只有两条：**① 首级 R ≥ 6.19 Ω 且 C1 ≤ 68 nF（C9）**、**② R·C 乘积配对工序（D8）**。

---

## 1. B 案元件清单与标准档位映射（**第 4 轮冻结参数**）

### 1.1 逐件映射

| 位号 | 类型 | 设计值 | **E24 最近** | 偏差 | **E96 精确值** | 偏差 | 介质 / 精度 | 备注 |
|---|---|---|---|---|---|---|---|---|
| Ra1/Rb1 | R | **6.19 Ω** | 6.2 Ω | +0.16 % | **6.19 Ω** | **0.00 %** | 薄膜 0.1 % | **C9 关键位**：不得 <6.19 Ω |
| Ra2/Rb2 | R | **6.04 Ω** | 6.2 Ω | +2.65 % | **6.04 Ω** | **0.00 %** | 薄膜 0.1 % | |
| Ra3/Rb3 | R | **13.7 Ω** | 13.0 Ω | −5.11 % | **13.7 Ω** | **0.00 %** | 薄膜 0.1 % | |
| Ca1/Cb1 | C | **68 nF** | 68 nF | 0.00 % | — | — | **C0G/NP0** | **C9 关键位**：不得 >68 nF |
| Ca2/Cb2 | C | **68 nF** | 68 nF | 0.00 % | — | — | **C0G/NP0** | |
| Ca3/Cb3 | C | **27 nF** | 27 nF | 0.00 % | — | — | **C0G/NP0** | |
| Cd | C | **12 nF** | 12 nF | 0.00 % | — | — | **C0G/NP0** | 跨接两线，**不参与逐线配对** |

- **ΣR = 6.19 + 6.04 + 13.7 = 25.93 Ω**（C2 限 5000 Ω，余量 **193×**）✅
- **件数 = 13 件/通道**（3R + 3C）×2 线 + 1 Cd ✅（C1 已软化为参考项）
- **最大电容 = 68 nF**（C3 限 100 nF）✅
- **容值全部 E12**、**阻值全部 E96** → **无任何取整误差**（这是本轮相对第 3 轮的唯一档位改善）

### 1.2 E24 降本备选（**需重新实测确认，本表未验证**）

| 方案 | R1/R2/R3 | 引擎 D1 | 引擎 D4 | min(D1,D4) | 说明 |
|---|---|---|---|---|---|
| **冻结（E96）** | 6.19 / 6.04 / 13.7 | **84.302 dB** | **0.18494 dB** | **0.70013** | 基准 |
| E24 全部取近邻 | **6.2 / 6.2 / 13** | 84.072 dB | 0.18409 dB | 0.70056 | min **略升**（D4 略好、D1 略差，两者几乎抵消） |
| E24 混合 | 6.2 / 6.04 / 13.7 | 84.303 dB | 0.18523 dB | 0.69947 | R1 用 E24、R2/R3 用 E96 |
| E24 备选 | 6.2 / 5.6 / 15 | 84.451 dB | 0.18508 dB | 0.69980 | 需要重解 fc |

> **结论**：`6.2 / 6.2 / 13` 这套纯 E24 组合在引擎口径下 **min 不降反升 0.0004**，
> 是可行的降本路径；但 **R1 从 6.19 → 6.2（+0.16 %）对 C9 有利（Q 降低）**，
> 而 **R3 从 13.7 → 13（−5.11 %）会让末级极点略移**——**上板前须用 LTspice 复跑一次
> D1/D4/D8/C9 四维**（本表只给引擎预测，**未跑**）。

---

## 2. 介质与 C2/C3/C4/C5 合规

| 约束 | 要求 | B 案冻结现状 | 判定 |
|---|---|---|---|
| **C2** 每线串联电阻总和 | ≤5 kΩ | **25.93 Ω** | ✅ 余量 193× |
| **C3** 单电容最大值 | ≤100 nF | **68 nF** | ✅ 余量 1.47× |
| **C3 附则** >47 nF 的 SRF | > fMOD（4.096 MHz） | 68 nF：SRF（ESL 1.2 nH）**15.8 MHz > 4.096 MHz** | ✅ 见 §3 |
| **C4** 介质 | 必须 C0G/NP0（或薄膜） | 68 / 68 / 27 / 12 nF 全 C0G | ✅ 可满足（68 nF 是 C0G 常见上限档，0603/0805 有货） |
| **C5** 电阻精度 | 1 % 起步，关键位 0.1 %；**两线 R·C 乘积配对** | R 全 0.1 % 薄膜；配对工序见 §5 | ✅（工序为前置条件） |
| **C9** 首级 R / C1 | R 不得小、C1 不得大 | **R1 ≥ 6.19 Ω、C1 ≤ 68 nF** | ⚠️ 见 §4.3 |

### 2.1 68 nF C0G 的可购性

- 68 nF 是 C0G 的**常见档**，0603（50 V）/ 0805（50/100 V）/ 1206 均有量产。
- **建议 0603**：ESL 0.5–0.9 nH，SRF 19.3–27.3 MHz，对 fMOD 有 4.7–6.7 倍余量。
- **不接受 X7R/X5R**：直流偏压与压电效应（C4 明令）；且容值随电压掉 30–50 % 会直接击穿 D7/D8。
- **容差**：C0G 常见 ±5 %。实测（`r5_r4_c9_sensitivity.json`）**C+5 % 本身不恶化 C9**
  （Rs=60 kΩ：5.813 dB vs 标称 5.817 dB，略降）；**真正的不利方向是 R 偏小**——
  R−0.1 %/C+5 % 时 5.820 dB、R−1 %/C+5 % 时 **5.883 dB**。故 **C 建议 ±5 % 实测筛选**（不必买 ±2 %），
  **R 必须 0.1 %**。
- **C1 的偏离方向**（`r5_r4_B_c1_direction.json`，R1=6.19 固定）：

  | C1 | C9 最坏峰 | D4 | D1 |
  |---|---|---|---|
  | 62 nF（−8.8 %） | **5.688 dB** | 0.1813 dB | 83.85 dB |
  | **68 nF（冻结）** | 5.817 dB | 0.1849 dB | 84.64 dB |
  | 75 nF（+10 %） | **5.939 dB** | 0.1892 dB | 85.49 dB |

  → **C1 变小同时改善 C9 与 D4，但牺牲 D1**（62 nF 时 D1 = 83.85 dB，距 80 dB 及格线只剩 3.85 dB）；
  **C1 变大则 C9 与 D4 两项都恶化**。
  工艺卡应写「**C1 ∈ [62, 68] nF，不得 >68 nF**」，而不是"标称 68 nF ±5 %"。
  **C1 与 R1 的联合容差角（C1 取下限 + R1 取上限）本轮未测**，若采购到这类组合需补测 D1。

---

## 3. >47 nF 电容的 SRF 核查（C3 强制项）

### 3.1 逐容值：容抗与临界 ESL

| C | Xc@fMOD (4.096 MHz) | Xc@MCLK (16.384 MHz) | 使 SRF = fMOD 的 ESL | **使 SRF = MCLK 的 ESL** |
|---|---|---|---|---|
| **68 nF**（B·C1/C2） | 0.571 Ω | 0.143 Ω | 22.2 nH | **1.39 nH** |
| **27 nF**（B·C3） | 1.439 Ω | 0.360 Ω | 55.9 nH | 3.49 nH |
| **12 nF**（B·Cd） | 3.238 Ω | 0.810 Ω | 125.8 nH | 7.86 nH |

### 3.2 SRF 随封装 ESL 的实测范围（0603 0.5–0.9 nH / 0805 ≈0.9 / 1206 ≈1.2 nH）

| C | ESL 0.5 nH | ESL 1.0 nH | ESL 1.5 nH | ESL 2.0 nH |
|---|---|---|---|---|
| **68 nF** | 27.3 MHz | **19.3 MHz** | 15.8 MHz | 13.6 MHz |
| 27 nF | 43.3 MHz | 30.6 MHz | 25.0 MHz | 21.7 MHz |
| 12 nF | 65.0 MHz | 45.9 MHz | 37.5 MHz | 32.5 MHz |

### 3.3 判定

| 项 | B 案 | 判定 |
|---|---|---|
| 含 >47 nF 的容值 | **68 nF × 2（每线，C1/C2）** | — |
| 0603（0.9 nH）下的 SRF | **19.3 MHz** | ✅ **> fMOD 4.7×**，也 > MCLK 1.18× |
| 0805（1.2 nH）下的 SRF | 15.8 MHz | ✅ > fMOD 3.9×（略低于 MCLK，但 C3 只要求 > fMOD） |
| 1206（≈1.2–1.5 nH）下的 SRF | 17.6–13.0 MHz | ✅ > fMOD 3.2–4.3×，仍满足 C3；**不推荐**（靠近 MCLK） |
| **推荐封装** | **0603**（或 0805） | **接地回路 <3 mm + 多过孔**（§3.4） |

### 3.4 共同要求

1. **PCB 走线电感必须计入**：0402 的 0.4 nH 器件 ESL 容易被 2–3 mm 走线（≈1 nH/mm）翻倍。
   **C1（68 nF）的接地回路应短于 3 mm**，并用多个过孔。
2. **不许用 2×33 nF 并联替代 68 nF**：并联降 ESL 但改变 SRF 以上的容性行为，
   且**会改变 D8 的配对基线**（每线变 2 个电容，配对对象翻倍）——**需重新仿真，本表未验证**。
3. **样机阶段实测 SRF / ESR**（网络分析仪或阻抗分析仪），把实测值回填仿真。
4. **ESR 优先级高于 ESL**：§4.2 显示 ESR 0.02→0.10 Ω 会让 D3 掉 15.4 dB，
   而 ESL 增大在同范围内反而**抬高** D1/D3（不是稳健增益，见 §4.2 第 2 条）。

---

## 4. ESL / ESR 敏感性（**本轮按冻结参数重跑**）

### 4.1 方法与口径

- 网表：`r5_work/r4_B/r5_B_r4_besl_{ESL}_{ESR}.net`，**真实 OPA388 模型**（`lib/OPAx388.LIB`），
  **L 只串在每个电容支路**（`Ra_i → 节点 → La_i → Ca_i → 0`），与第 3 轮 BOM 网表同构；
  C_diff 两侧各 1×ESL（即跨接件共 2×ESL），ESR 用 LTspice `C ... Rser=`。
- 数据：`r5_bom_esl_esr_r4.json`（机器可读）。
- 命令：`LTspice.exe -b -ascii <net>`，`.ac dec 400 0.1 200Meg`。

### 4.2 实测结果（B 案冻结参数）

| ESL | ESR | **D1 @fMOD** | **D3 @MCLK** | D4 @16 kHz |
|---|---|---|---|---|
| 0（理想） | 0 | **84.647** | **132.568** | 0.18489 |
| 0.5 nH | 0 | 85.109 | 141.588 | 0.18489 |
| **1.0 nH** | 0 | **85.581** | **157.454** | 0.18489 |
| 1.5 nH | 0 | 86.064 | **180.694** | 0.18489 |
| 2.0 nH | 0 | 86.557 | 153.606 | 0.18489 |
| 1.0 nH | **0.02 Ω** | 85.642 | 155.394 | 0.18508 |
| 1.0 nH | **0.10 Ω** | 85.643 | **140.014** | 0.18583 |
| 2.0 nH | 0.10 Ω | 86.591 | 141.846 | 0.18583 |

### 4.3 结论（B 案专属）

1. **ESL 对 D1 是单调轻微改善**（84.65 → 86.56 dB @2 nH）：fMOD 远低于所有 SRF，
   +jωL 只是略微增加串联阻抗。
2. **D3 在 ESL ≈ 1.5 nH 附近有窄带峰**（180.7 dB），**这不是稳健增益**：
   0.5 nH 时 141.6 dB、2.0 nH 时 153.6 dB。**量产不能把"落在峰上"当设计依据**；
   **但最差点 132.57 dB（ESL=0）仍远高于 100 dB 及格线**，所以 ESL 对 B 不构成风险。
3. **ESR 是一阶敏感项，但 B 的余量足够**：ESL 固定 1 nH，ESR 0.02 → 0.10 Ω 使
   **D3 155.4 → 140.0 dB（−15.4 dB）**；配合最坏 ESL=0 的本底 132.57 dB，
   **本轮 8 个组合里最低的 D3 = 132.568 dB（ESL = 0、ESR = 0 的理想基准，即最差情况）**，限 100 dB，余量 32.6 dB。**D1 几乎不动（+0.15 dB）**。
4. **D4 对 ESL/ESR 几乎不敏感**（0.18489 → 0.18583 dB，变化 0.0009 dB）——因为 ESL/ESR
   的影响集中在 fMOD 附近，而 D4 在 16 kHz。
5. **C9（首级谐振）与 ESL 的耦合**：本表 ESL 只串在电容支路，**首级 68 nF + 6.19 Ω 的
   跟随器峰对 ESL 不敏感**（谐振频率 279 kHz ≪ SRF 19 MHz）——C9 的余量问题
   来自 **R/C 的容差，不是 ESL**（§4.3 末表）。

### 4.4 C9 余量（BOM 必须写进工艺卡的数字）

| 条件 | Rs | 跟随器峰 | 余量（限 6 dB） |
|---|---|---|---|
| 标称 | 0 | 4.768 dB | +1.232 dB |
| 标称 | **60 kΩ（最坏源阻抗）** | **5.817 dB** | **+0.183 dB** |
| **R−0.1 %/C+5 %（0.1 % 薄膜实配）** | **60 kΩ** | **5.820 dB** | **+0.180 dB** |
| R−1 %/C+5 %（1 % 薄膜的最坏角） | 60 kΩ | **5.883 dB** | **+0.117 dB** |

数据：`r5_r4_c9_source_sweep.json` / `r5_r4_c9_source_sweep_corner.json` / `r5_r4_c9_sensitivity.json`。

**BOM 要求**：
- **Ra1/Rb1 精度必须 0.1 %（薄膜，E96 6.19 Ω）**——用 1 % 料会把 C9 余量从 0.18 dB 压到 0.12 dB；
- **Ca1/Cb1 精度 ≥±5 %，优先 ±2 %**；
- **首级 R 只允许向上偏（6.19 → 6.2 Ω 可接受；不得 <6.19 Ω）**；
- **首级 C 只允许向下偏（68 → 62 nF 可接受；不得 >68 nF）**；
- 若采购到 R < 6.19 Ω 的批次，**必须换料或重测 C9**（跟随器峰对 R 是单调反比）。

---

## 5. **R·C 配对工序要求（D8 的达标前提）**

> 本章是规格 v4 §5.1a / §5.2 C5 的**落地工序**。D8 的达标前提不是"买高精度料"，
> 而是"**每对电阻电容实测后按乘积异向配对贴片**"。

### 5.1 为什么必须是"配对"而不是"高精度"（B 案实测）

第 4 轮实测（`r5_results_r4_B.json` 的 `D8_detail`，真实 OPA388，LTspice）：

| m（单体失配） | **同向失配**（无配对） | **R·C 异向配对** | 配对收益 |
|---|---|---|---|
| 0.1 % | — | **136.884 dB** | — |
| 0.5 % | — | **108.755 dB** | — |
| **1 %** | **48.338 dB** | **95.515 dB** | **+47.18 dB** |

- **同向 1 % 失配的物理上限是 48–49 dB**（与规格 §5.1a 记载一致），**远低于 80 dB 及格线**。
- **只要把 R 偏大的线与 C 偏小的线配成一对（乘积配对），1 % 单体料也能到 95.5 dB**。
- 这不是"买 0.01 % 电阻"能替代的：0.01 % 同向失配也只有约 88 dB（−20 dB/decade 外推），
  而**配对后 0.1 % 单体就能到 136.9 dB**。

### 5.2 工序定义（可照抄进工艺文件；B 案专用数字）

**术语**：一个"标准单元" = 一条线上的 **3 个 R + 3 个 C_gnd**（B 案是三级）；
`C_diff`（12 nF）跨接两线，**不参与逐线配对**（见 §5.6）。

```
步骤 1  入库实测
        每批 R、C 逐件用 4½ 位以上 LCR 表实测，记录到配对表：
            R_meas（Ω）、C_meas（F）、测量温度、仪表编号
        测量条件：1 kHz（C）、DC 四线（R < 100 Ω 必须四线）

步骤 2  计算乘积
        对每个标准单元 i、每一级 k：
            p_ik = R_meas,ik × C_meas,ik        （k = 1,2,3）

步骤 3  异向配对（核心）
        把 4 套标准单元（CH1P / CH1N / CH2P / CH2N）两两配对：
            选 (i, j) 使 max_k |p_ik − p_jk| / p_ik 最小
            —— 即 R 偏大的配 C 偏小的
        配对目标（1 % 单体料）：
            逐级 |Δ(RC)/RC| ≤ 1×10⁻⁴（0.01 %）   → 实测 CMRR ≈ 95.5 dB
            逐级 |Δ(RC)/RC| ≤ 2.5×10⁻⁵（0.0025 %）→ 实测 CMRR ≈ 108.8 dB
            逐级 |Δ(RC)/RC| ≤ 1×10⁻⁶（0.0001 %）  → 实测 CMRR ≈ 136.9 dB

步骤 4  贴片
        按配对结果贴装，**同一对必须贴在同一通道的两条腿上**
        （CH1: Ra1–Ra3 / Rb1–Rb3；CH2: 另两套）。配对表随板归档，与 SN 绑定。

步骤 5  复检
        贴装后测两线对地电容与串联电阻（治具），复核三级 RC 乘积仍在容差内；
        整机做一次共模注入测试（DC 2 V ± 1 V，10 Hz–16 kHz），
        实测 CMRR 应 ≥ 90 dB（留 5 dB 余量对 95.5 dB 仿真值）。
```

### 5.3 配对精度的量化要求（B 案实测锚点）

| 单体失配 m | 配对后**残余 RC 乘积失配** | 实测 CMRR（B） | 相邻档斜率 |
|---|---|---|---|
| 1 % | **0.0100 %** | **95.515 dB** | — |
| 0.5 % | 0.0025 % | 108.755 dB | +22.0 dB/decade |
| 0.1 % | 0.0001 % | 136.884 dB | +20.1 dB/decade |

（字面配对 `R×(1+m)` 配 `C×(1−m)` 的残余乘积误差是 **m²**：1 %→0.01 %、0.5 %→0.0025 %、0.1 %→0.0001 %。）

**反解**（锚定实测的 0.01 % → 95.515 dB，按 **20 dB/decade**）：

| 目标 CMRR | **需要的 RC 乘积匹配** | 等效单体失配 m |
|---|---|---|
| 80 dB（及格线） | ≤ **0.060 %** | 2.44 % |
| 90 dB | ≤ 0.019 % | 1.38 % |
| **95.5 dB（1 % 单体 + 配对实测）** | **0.010 %** | **1.00 %** |
| 100 dB（满分线） | ≤ 0.0060 % | 0.77 % |
| 110 dB | ≤ 0.00060 % | 0.24 % |
| 136.9 dB（0.1 % 单体 + 配对实测） | 0.0001 % | 0.10 % |

**关键推论**：

1. **1 % 单体料 + 配对（残余 0.01 %）落在 95.5 dB**，与实测吻合 —— 这是"1 % 料就能过线"的定量依据。
2. 想要 **100 dB 满分**，只需**单体失配 ≤0.77 %**（残余 0.006 %）——**不必买 0.1 % 电阻**，
   1 % 料筛到 0.8 % 以内即可（E24 厚膜实测分布通常 ±1 %，筛选合格率约 60–70 %）。
3. **B 案实际用的是 0.1 % 薄膜 R**（为了 C9 的余量，见 §4.4）——这使配对更容易：
   0.1 % 单体料配对后可到 **136.9 dB**（远超 100 dB 满分线），**D8 因此不是 B 的短板**。
4. **想要 110 dB 以上必须严格倒数配对**（C/(1+m)）或 0.1 % 单体档 + 配对。

### 5.4 若采用严格倒数配对（B 案第 3 轮实测：110.43 dB）

规格 v4 §5.1a 引用的 "110–112 dB" 对应 `C/(1+m)`（严格倒数）而非 `C×(1−m)`。
第 3 轮 B 案（旧参数）1 % 严格倒数 = **110.43 dB**（vs 字面 95.65 dB）。**本轮未对冻结参数重测该口径**
（`r5_results_r4_B.json` 的 D8 只做字面配对三档 + 同向 1 %）。

**实现方式**：C 不能"按标称值筛"，只能**用可调/并联微调**：
- 方案 A：每个 C_gnd 位并联一个 0–2 pF 微调电容（C0G 或薄膜），贴片后调到目标值；
- 方案 B：**采购 0.1 % 单体 C**（C0G 的 0.1 % 档极贵且交期长），再按 §5.2 配对。

**成本对比**：方案 A 的微调工时 vs 方案 B 的采购成本，**需用户裁决**。

### 5.5 对 BOM 的具体标注要求（B 案）

| 位号类别 | 精度档 | 介质 | 配对要求 | 备注 |
|---|---|---|---|---|
| **Ra1/Rb1（首级）** | **0.1 % 薄膜（E96 6.19 Ω）** | 薄膜（低温度系数、低噪声） | **按 §5.2 配对** | **C9 关键位：不得 <6.19 Ω、不得 >6.2 Ω 太多** |
| **Ra2/Rb2** | **0.1 % 薄膜（E96 6.04 Ω）** | 薄膜 | **按 §5.2 配对** | |
| **Ra3/Rb3** | **0.1 % 薄膜（E96 13.7 Ω）** | 薄膜 | **按 §5.2 配对** | |
| **Ca1/Cb1（首级）** | **±5 % 实测筛选（容值上限 68 nF）** | **C0G/NP0** | **按 §5.2 配对** | **C9 关键位：不得 >68 nF** |
| **Ca2/Cb2** | ±5 % 实测筛选 | **C0G/NP0** | **按 §5.2 配对** | |
| **Ca3/Cb3** | ±5 % 实测筛选 | **C0G/NP0** | **按 §5.2 配对** | |
| **C_diff（12 nF）** | ±5 % | **C0G/NP0** | **不参与逐线配对**（§5.6） | 跨接件，两线共享 |

### 5.6 C_diff 的处理（易错点）

**C_diff 是跨接两线的共享件，不能"每线各贴一个"**。
B 案冻结网表（`r5_work/r4_B/r5_B_r4_v1.net`）里：**`Cd pa3 na3 1.2e-08`（单个，跨接）**。
即**配对只作用于每条腿上的 R 与 C_gnd**。
**如果误把 C_diff 也按"两条腿各一份"配对，会把共享件拆成两个串联电容，容值减半、D8 基线改变**。

### 5.7 工序质量的验收判据

| 检查项 | 判据 | 方法 |
|---|---|---|
| 配对表完整性 | 4 套单元 × 3 级 R/C 逐件实测 | 表格 + 仪表编号 |
| 逐级 RC 乘积匹配 | ≤0.01 %（1 % 单体料）/ ≤0.0001 %（0.1 % 单体料） | 计算 |
| 贴装一致性 | 配对对必同通道 | 目视 + 配对表核对 |
| **整机 CMRR** | **≥90 dB @10 Hz–16 kHz** | 共模注入（DC 2 V ±1 V） |
| 温度跟踪 | 同批同封装，−20~+85 ℃ 漂移 <0.01 % | 抽检（C0G ±30 ppm/℃） |

---

## 6. 汇总核查清单（第 4 轮 · B 案冻结）

| # | 检查项 | B 案现状 | 判定 |
|---|---|---|---|
| 1 | 电阻落 E96 | **6.19 / 6.04 / 13.7 全 E96 精确值** | ✅ 零取整误差 |
| 2 | 电阻落 E24 | 三者均不落 E24（近邻 6.2 / 6.2 / 13.0） | ⚠️ 可降本为 E24 组合（§1.2，需实测确认） |
| 3 | 电容落 E12 | 68 / 27 / 12 nF 全 E12 | ✅ |
| 4 | 单电容 ≤100 nF（C3） | **68 nF** | ✅ 余量 1.47× |
| 5 | 介质 C0G/NP0（C4） | 全部 C0G | ✅ |
| 6 | ΣR ≤5 kΩ（C2） | **25.93 Ω** | ✅ 余量 193× |
| 7 | **>47 nF 的 SRF > fMOD** | 68 nF：0603 下 19.3 MHz（>fMOD 4.7×） | ✅ 推荐 0603/0805 |
| 8 | **ESR 敏感性（D3）** | 0.02→0.10 Ω：155.4 → 140.0 dB（−15.4），**仍 ≥130 dB** | ✅ 余量充足 |
| 9 | **R·C 配对工序（C5/D8）** | 1 % 单体 + 配对 → **95.515 dB** | ✅ **必需工序**（§5） |
| 10 | **首级 R / C1 的 C9 约束** | R1 ≥6.19 Ω、C1 ≤68 nF；最坏 5.82 dB（余量 0.18 dB） | ⚠️ **工艺卡必须写死** |
| 11 | 件数/通道 | **13** | 仅参考（C1 已软化） |
| 12 | 温度角 | C0G −30 ppm/℃ 已折（D4 −20/85 ℃ 为 0.1852/0.1844）；**R 温漂未代入**（待 E.10 #6 定料） | ⚠️ 待料号确定后补 |

---

## 7. 未在本表核查的事项（如实标注）

| 项 | 原因 |
|---|---|
| 具体料号 / 价格 / 库存 / 交期 | **E.10 #6 归用户核实**（`AGENTS.md`）；本表不做选料 |
| 供应商 ESR/ESL 的实测数据 | 需选定料号后查厂商 S 参数或实测；本节用的是**典型值扫描** |
| **E24 降本组合的 LTspice 验证** | §1.2 只给引擎预测，**未跑 LTspice**；上板前须复跑 D1/D4/D8/C9 |
| **严格倒数配对（110 dB）** | 第 3 轮旧参数实测 110.43 dB；**本轮冻结参数未重测** |
| 磁珠 / 磁珠替代方案 | 规格 §4 未列入；未评估 |
| 温度系数对匹配的影响 | C0G ±30 ppm/℃、R 25 ppm/℃；**未做温度角下的 D8 复算** |
| 薄膜电容替代的完整仿真 | §3 只做定性判断，**未跑 LTspice**（只扫 ESL/ESR，不含介质损耗角） |
| 配对工时的成本 | 属工艺成本，本表只给工序与判据，不估工价 |
| **C9 的硅验证** | 宏模型结论，**未上板** |

---

## 附录 A：C 案对照参数（第 3 轮冻结，**仅作对照，不推荐**）

| 位号 | 类型 | 值 | 档位 | 备注 |
|---|---|---|---|---|
| Ra1/Rb1 | R | 1.8 Ω | E24 ✅ | **C9 11.19 dB（超限）**；需提到 4.7 Ω（代价 D4 0.256） |
| Ra2/Rb2 | R | 3.9 Ω | E24 ✅ | |
| Ra3/Rb3 | R | 10 Ω | E24 ✅ | |
| Ra4/Rb4 | R | 22 Ω | E24 ✅ | |
| Ca1–Ca4 | C | 33 / 39 / 39 / 27 nF | E12 ✅ | 最大 39 nF，**无 SRF 约束** |
| Cd | C | 8.2 nF | E12 ✅ | |
| — | — | ΣR = 37.7 Ω，17 件/通道 | — | |

**不推荐的理由**：C9 在任何源阻抗下都 >6 dB（最坏 24.6 dB @150 kΩ）；
D5 在 **0–410 kΩ 全部等幅极限环**（≥430 kΩ 才稳）。
若复用，**必须先把 R1 提到 4.7 Ω 并把 C1 降到 12.64 nF**（D5 全量程回稳、C9 5.42 dB），
代价是 D4 0.1804 → 0.2561、D1 93.22 → 88.70（min ≈ 0.541，由 D4 主导）。
