chenxi-z/de-drms/firmware/DE-DRM/CUBEMX_SETUP.md

# CubeMX 当前修正清单（2026-10-24）

当前源代码已按直流首板目标修正，**DE-DRM.ioc仍为旧GUI基线**，不要直接Generate覆盖源码。
在CubeMX完成以下修改、Save并核对差异后再生成；本轮未手工增删IOC的IP块。

| GUI项 | 目标 |
| --- | --- |
| PA1 | ADS_DONE，GPIO_Input、NoPull |
| PA2 / PA3 | ADS_RESET输出Low；ADS_DRDY下降沿EXTI3、PullUp |
| PA4 / PA8 | PA4模拟态预留DAC；PA8从SD_PWR_EN改ADS_CS输出High |
| PC1 | 从ADC1_IN2释放为BQ_EN输出Low |
| PC2 / PB5 | 从ISET_HI/BQ_TS改BQ_CHG/BQ_PG输入、PullUp |
| PC13 | USB_VBUS_N输入、PullUp（外部NPN检测） |
| PC3 / PB10 | ANA_EN输出Low；CURR_DIS输出High |
| PB0 / PB2 | SEL_K2 / SEL_SENSE输出Low；实际接SEL2与SEL1/3/4 |
| LED | PB13/14/15、PC6/7初始High（低亮） |
| 按键 | PA0/PB1下降沿、PullUp |
| SD_CD | PA15双沿、PullUp |
| ADC1 | 2个rank：IN1采样68周期、VREFINT采样391.5周期；删除IN2，不动PC1 |
| SPI1 | Mode1；SCK/MISO/MOSI引脚High速度，保留33 Ω，上板验证边沿 |
| I²C1 | 无TMP117，不在主程序初始化；以后需要时GUI重新启用 |
| PWR | RET6Q现有SMPS电感；升频前HAL_PWREx_ConfigSupply(PWR_SMPS_SUPPLY) |
| SYSCLK | MSI→PLL 160 MHz，不启用未装的外部晶振 |
| SDMMC1 | 禁止在main外设初始化阶段调用；由FileX打开介质时初始化 |

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

USB描述符/取电策略尚未定稿：不要沿用“自供电+0mA”作验收，也不能仅改数字500mA就算合规。
PC13状态与USBX附着/脱离、BQ输入电流授权需要应用层联动，当前只有GPIO配置。
ADC采集/DMA/校准/TF连续记录尚缺，编译成功不等于整机已可测量。

以下旧清单保留作历史，和上表冲突时以上表为准。

---

# DE-DRM CubeMX 工程配置清单

> STM32U545RET6Q LQFP-64 · 配套 `DE-DRM.ioc` · **2026-10-14 重排定稿 + 二轮复核**
>
> 这份清单是把 `firmware/DE-DRM/DE-DRM.ioc` 配齐到**可生成代码、引脚零警告**
> 所需的全部 CubeMX GUI 操作。设计依据见
> [主文档 E.6–E.11](../../docs/design/2026-10-10-universal-signal-chain.md)、
> [引脚分配总表](../../docs/design/pin-assignment.md)。
>
> **使用方式**：在 CubeMX 里打开 `DE-DRM.ioc`，逐项打勾 `[x]`。
> 全部勾完 → `File → Save Project`（让 CubeMX 重写 IOC，固化格式）
> → `Project Manager → Generate Code`。
>
> ⚠️ **不要手改 IOC 加 IP**：CubeMX 6.18 的 IOC 有内部"指纹"格式，
> 手写 IP 块会被**静默丢弃**（本仓已实测踩坑并回滚，见 AGENTS.md「已被否决」末条）。
> 必须走 GUI 操作。

---

## 0. 工程基础（Project Manager）

- [x] MCU：STM32U545RET6Q（已配）
- [x] Project Name：DE-DRM（已配）
- [x] Toolchain：Makefile（已配）
- [x] Heap 0x800 / Stack 0x800（IOC 已设）
- [ ] 标准库：STM32Cube FW_U5 V1.9.0+
- [ ] `File → Save Project` 后**核对 git diff**，确认 CubeMX 没把你刚配的东西又丢掉

---

## 1. 时钟方案（RCC + Clock Configuration）— 🔴 本节有一处必改错误

设计依据：E.7。**MCU 免晶振**（HSE 焊盘不贴），USB 用 HSI48+CRS 校准。

### 1.1 RCC 模块（System Core → RCC）

- [ ] 🟥 **HSE 必须改为 `BYPASS Clock Source` 或干脆 `Disable`** ——
  **当前 IOC 是 `Crystal/Ceramic Resonator` 且 `RCC_PLLSOURCE_HSE`，但 E.7 定稿 HSE 晶振不贴！**
  照现状生成代码 → HSE 不起振 → PLL 锁不住 → **SYSCLK 无输出，MCU 跑不起来**（主文档 E.10 #16）
- [ ] 🟥 **PLL 源改 `MSIS`（MSI）**：`PLL Source Mux = MSI`，`PLLN` 相应重算使 SYSCLK = 160 MHz
  （MSI 出厂 4 MHz；`4 × N / R = 160`）。改完再确认 `HSE_VALUE` 不再被 PLL 链路引用
- [ ] HSI：**ON**
- [ ] MSI：**ON**（现作 SYSCLK 主路径）
- [ ] HSI48：**ON**（USB / CRS 用）
- [x] LSE：**Crystal/Ceramic Resonator**（PC14/PC15 已配，给 RTC）
- [x] LSI：**ON**
- [ ] 若坚持"贴 16 MHz 晶振走 HSE"，则必须**回改主文档 E.7 的免晶振结论**并在 E.10 记录理由——
  二选一，不可维持"文档说不贴、IOC 用 HSE"的矛盾状态

### 1.2 Clock Configuration 标签页

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

### 1.3 CRS（System Core → CRS）— 当前 IOC 缺这个 IP

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

---

## 2. 外设（Connectivity 栏）

### 2.1 SPI1 — ADS131A02（🟥 当前 IOC 有 PA6/PA7 信号但 **SPI1 IP 未启用** = 孤儿信号，打开会报冲突）

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

### 2.2 USART1 — 调试日志（🟥 当前 IOC 完全没有）

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

### 2.3 USB（USB_DRD_FS）— Type-C 数据上行（🟥 当前 IOC 完全没有）

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

### 2.4 I2C1 — TMP117（已配，核对即可）

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

### 2.5 SDMMC1 — TF 卡 4-bit（2026-10-21 已配置，核对）

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

### 2.6 ADC1 — 电池 + VBUS 监测（2026-10-21 已配置，核对）

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

---

## 3. 系统模块（System & Core）

### 3.1 SYS

- [x] Debug：**SWD**（PA13/PA14/PB3 + NRST）
- [ ] Timebase Source：**SysTick**（不要占用 TIM，本设计要留定时器）

### 3.2 PWR — 唤醒引脚（🟥 决定能否"关机后用按键开机"）

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

### 3.3 RTC（已启用，核对）

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

### 3.4 NVIC — 中断优先级

| 中断 | Enable | Preempt | 说明 |
|---|---|---|---|
| **EXTI15_10** | ✓ | **4** | PA15 SD_CD |
| **SDMMC1** | ✓ | **4** | 持续写吞吐敏感，优先级最高 |
| **EXTI3** | ✓ | 5 | PA3 ADC_DRDY |
| SPI1 | ✓ | 6 | ADS131A02 |
| I2C1 event / error | ✓ | 7 | TMP117 |
| **USART1** | ✓ | 8 | 调试日志（PA9/PA10, AF7） |
| USB | ✓ | 9 | USB（USB_DRD_FS） |
| ADC1 | ✓ | 10 | 电池/VBUS 监测 |
| SysTick | ✓ | **15** | HAL 时基，最低 |

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

---

## 3.5 ADC1 采样时间（2026-10-21 修正）

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

---

## 4. GPIO 配置（按 E.6 重排定稿；Label 必须设，固件 `main.h` 会生成宏）

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

### 4.1 输出（GPIO_Output，Push-Pull，Speed Low）

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

### 4.2 输入（含上拉，按键/开关对地，低有效）

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

### 4.3 复用（勾 IP 后自动占用，只确认无黄/红）

| 引脚 | 信号 | 来自 |
|---|---|---|
| **PA9 / PA10** | **USART1_TX/RX（AF7）** | § 2.2（2026-10-20 由 LPUART1 改，J3 扩 8P） |
| PA5 / PA6 / PA7 | SPI1_SCK/MISO/MOSI | § 2.1 |
| PA11 / PA12 | USB_DM/DP（USB_DRD_FS） | § 2.3 |
| PA13 / PA14 / PB3 | SWDIO / SWCLK / SWO | § 3.1 |
| PB6 / PB7 | I2C1_SCL/SDA | § 2.4 |
| PC0 / PC1 | ADC1 通道（VBAT / VBUS） | § 2.6 |
| PC8–PC12 / PD2 | SDMMC1 D0–D3 / CK / CMD | § 2.5 |
| PC14 / PC15 | LSE | § 1.1 |
| PH0 / PH1 | HSE（焊盘预留不贴，见 § 1.1 红色项） | § 1.1 |

### 4.4 不配置（保持 Reset State 即正确）

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

---

## 5. 电源脚（不在 CubeMX 配置，由原理图保证）

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

---

## 6. 生成代码后必查（逐项人工确认）

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

---

## 7. 待办依赖（不清会导致返工）

| 项 | 状态 |
|---|---|
| ~~**E.10 #12** DS14216/SLUS941 五项待核~~ | ✅ **2026-10-14 二轮复核全清**：① PC0=ADC1_IN1 / PC1=ADC1_IN2；② 高阻源合法（Table 106 注 3，见 § 2.6）；③ 低功耗表号 Table 62/65/68/70；④ BQ24040 PG 确有（pin 5）；⑤ SDMMC 全手册仅 PC8–PC12/PD2。另清出 4 处换脚（PC4/PC5/PB9/PB12 未引出）+ 电源脚更正 |
| **E.10 #16** IOC 时钟源与免晶振矛盾（现配 HSE-PLL，但 HSE 不贴） | 🔴 **阻塞固件**，§ 1.1 已列改法 |
| **E.10 #14** SDMMC 时钟源（现 IOC：PLL2Q 258 MHz、`SDMMCFreq_Value` 实测 **80 MHz** → 需重配到 48 MHz） | 🟥 阻塞生成代码 |
| ~~**E.10 #15** USB SOF 是否占 PA8~~ | ✅ **销号**：CRS 用**内部 SOF** 信号，不占引脚，PA8=ADC_nRESET 无冲突 |
| **E.10 #17**（新增）RM0456 四项：① USB_DRD_FS 片内 BCD 使能路径（固件项）；② SMPS 不启用时 VLXSMPS(28)/VDDSMPS(29) 引脚处置（**原理图前须确认**）；③ 复位后默认稳压器模式；④ **ADC1 采样时间离散档**（DS14216 未列，47.5/247.5 系凭惯例，按 GUI 实际档就近取大：VBAT/VBUS ≥64、VREFINT ≥320） | 🟥 ② 阻塞原理图；①③④ 固件/核对项，④ **不阻塞原理图** |
| **PB4 复位态（2026-10-16 新增，Table 27 注 4）**：PB4 复位后 = NJTRST + **内部上拉使能**，非 Low → "上电默认 500 mA"取决于外部 ISET 网络 | 🟥 **原理图阶段核**（需外部下拉或反相驱动，见 § 4.1） |
| **E.10 #13** TF 持续写实测（768 KB/s 是否丢帧） | 🔸 上板后 |
| 四张示意图按新 E.6 重画（SEL_K1/SEL_K2/LED 簇/ADC_nRESET 标注 + 加 TF 与 VBUS 支路；旧图中 DRDY(PC4)/SD_CD(PB9) 亦需改 PA9/PA15） | 🟥 交付门禁必跑 `tools/svg_schematic_check.py` |

---

## 8. 排障提示

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

---

## 9. 2026-10-21 IOC 集中审查与回填（按官方例程对齐）

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

### 9.1 本轮 IOC 自动修改项（已写入 `firmware/DE-DRM/DE-DRM.ioc`，需 GUI 复存确认）

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

| IRQ | 新优先级 | 原因 |
|---|---|---|
| SDMMC1 | **4** | 持续写吞吐最敏感，**但 < 5 意味着 ISR 内不可调 `tx_*`/`fx_*`**，只能在 ISR 里 `tx_semaphore_put`（允许） |
| EXTI15（SD_CD） | 5 | 拔插卡唤醒 |
| EXTI3（ADS_DRDY） | 5 | 128 kSPS 数据就绪 |
| SPI1 | 6 | ADS131A02 通信 |
| USB | **7** | 官方 U545 CDC_ACM 例程就是 7 |
| I2C1_EV / I2C1_ER | 8 | TMP117 |
| USART1 | 9 | 调试日志 |
| ADC1 | 10 | 慢速电池/VBUS 监测 |
| EXTI0/EXTI1（MEAS_BTN/PWR_BTN） | 11 | 按键，最低 |

### 9.2 未决 / 需 GUI 复存确认项

| 项 | 状态 | 说明 |
|---|---|---|
| **IOC 已被 CubeMX GUI 复存** | 🟥 **必须做** | 手改 IOC 后**首次**用 GUI 打开，GUI 会按键值重绘界面；**Save** 后本表所有改动才真正"入指纹"。若 GUI 打开后某项回落到默认，说明该键被归一化覆盖，需 GUI 重设。 |
| **代码生成** | 🟥 **本机 headless 不可用** | 实测 `xvfb-run STM32CubeMX -s script.txt` / `-q` 在本环境均无法生成代码（脚本加载但不写盘）。请在 GUI 里 File → Generate Code。 |
| `ProjectManager.StackSize=0x800 / HeapSize=0x800` | 🟨 未改 | 主栈+堆各 2 KB 对 ThreadX 偏小；建议 GUI → Project Manager → Project → Linker Settings 把 HeapSize 调到 0x1000 |
| **GPDMA1** | ✅ **不需要配置** | 2026-10-21 查证：SDMMC 用片上 IDMA（`IDMABASER`），不经 GPDMA1/LPDMA1；SPI1 当前是 polling（20 MHz × 8 bit 远低于 GPDMA 必要阈值）；USB_DRD_FS 内嵌专用 DMA 也不经 GPDMA |
| **FreeRTOS/RT-Thread 残留** | ✅ 已清 | `Mcu.ThirdPartyNb=0` |
| **USB Class 已定为 CDC_ACM** | ✅ 与官方例程对齐 | 与 § 2.3 旧文"建议 Custom_HID"冲突——**以本表（CDC_ACM）为准**，理由：U545 官方有完整 CDC_ACM 例程可直接抄，Custom_HID 需自写报告描述符 |
| **E.10 #16 IOC 时钟源** | 🟥 **未修** | 需 GUI → RCC → PLL Source Mux 改 **MSIS**（IOC 里**没有** `RCC.PLLSourceVirtual` 键——已被 GUI 删，符合"HSE 不贴"定稿） |
| **E.10 #14 SDMMC 时钟源** | ✅ **已默认 = CLK48**（`RCC.SDMMCClockSelection=RCC_SDMMCCLKSOURCE_CLK48`，`SDMMCFreq_Value=48000000`） | 与本设计一致，无需改 |

### 9.3 时钟树复核（2026-10-21）

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

### 9.4 已知 Bug 记录（本次修复过程中发现并已改正）

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
