chenxi-z/de-drms/hardware/sim/aaf/FIN1.asc

C1a: cap; 47n
C1b: cap; 47n
C2a: cap; 6.8n
C2b: cap; 6.8n
Cd1: cap; 47n
Cd2: cap; 5.6n
R1a: res; 330
R1b: res; 330
R2a: res; 2700
R2b: res; 2700
Vn: voltage; PWL(0 0.6  9.9u 0.6  10.4u -0.6  1.6m -0.6)
Vp: voltage; PWL(0 -0.6  9.9u -0.6  10.4u 0.6  1.6m 0.6)
Named nets: AGND, 0, sp, sn, AIN0P, AIN0N
.tran 0 1.6m 0 200n
