chenxi-z/de-drms/hardware/sim/aaf/mini.asc

R1: res; 1k
V1: voltage; PWL(0 -0.6  9.9u -0.6  10.4u 0.6  1.6m 0.6)
Named nets: 0, A
.tran 0 1.6m 0 200n
