chenxi-z/de-drms/hardware/sim/aaf/tst.asc

C1: cap; 10n
R1: res; 1k
V1: voltage; PWL(0 -0.6 10m -0.6 10.01m 0.6 20m 0.6)
Named nets: 0, OUT
.tran 0 20m 0 1u
