chenxi-z/de-drms/hardware/sim/aaf/V10a.asc

C1a: cap; 4.7n
C1b: cap; 4.7n
C2a: cap; 4.7n
C2b: cap; 4.7n
C3a: cap; 4.7n
C3b: cap; 4.7n
C4a: cap; 4.7n
C4b: cap; 4.7n
C5a: cap; 4.7n
C5b: cap; 4.7n
C6a: cap; 4.7n
C6b: cap; 4.7n
Cd2: cap; 6.8n
Cd4: cap; 6.8n
Cd6: cap; 6.8n
R1a: res; 170
R1b: res; 170
R2a: res; 170
R2b: res; 170
R3a: res; 170
R3b: res; 170
R4a: res; 170
R4b: res; 170
R5a: res; 170
R5b: res; 170
R6a: res; 170
R6b: res; 170
Vn: voltage; PWL(0 0.6  9.9u 0.6  10.4u -0.6  1.6m -0.6)
Vp: voltage; PWL(0 -0.6  9.9u -0.6  10.4u 0.6  1.6m 0.6)
Named nets: AGND, 0, sp, sn, AIN0P, AIN0N
.tran 0 1.6m 0 200n
