chenxi-z/de-drms/hardware/sim/aaf/V11.asc

C1a: cap; 6.8n
C1b: cap; 6.8n
C2a: cap; 6.8n
C2b: cap; 6.8n
C3a: cap; 6.8n
C3b: cap; 6.8n
C4a: cap; 6.8n
C4b: cap; 6.8n
Cd2: cap; 10n
Cd4: cap; 10n
R1a: res; 240
R1b: res; 240
R2a: res; 240
R2b: res; 240
R3a: res; 240
R3b: res; 240
R4a: res; 240
R4b: res; 240
Vn: voltage; PWL(0 0.6  9.9u 0.6  10.4u -0.6  1.6m -0.6)
Vp: voltage; PWL(0 -0.6  9.9u -0.6  10.4u 0.6  1.6m 0.6)
Named nets: AGND, 0, sp, sn, AIN0P, AIN0N
.tran 0 1.6m 0 200n
