chenxi-z/de-drms/hardware/sim/ccsource/ccsource.asc

M1: nmos; nmosb
M2: nmos; nmosb
R1: res; 360k
R2: res; 200k
R3: res; 10k
R4: res; 150k
Rg: res; 1Meg
Rk1: res; 2
Rsamp: res; 10k
Rsense: res; 150k
U1: opamp; opa333t3
V1: voltage; 3.3
Vdis: voltage; PULSE(0 3.3 5m 10u 10u 5m 15m)
Vsm: voltage; 0
Named nets: 3V3A, 0, VSET, CURR_DIS, T, S, B, VG
DE-DRMS constant current source (E.2/E.2.1): I = VSET/Rsense = 7.857uA
VSET = 3.3V x 200k/560k (R1/R2) ; M1 BSS138 pass ; Rsense 150k source-to-GND
T-node bias R3 10k + R4 150k (E.10#8) ; CURR_DIS: high -> M2 pulls VSET low
U1 = macro opa333t3 (models.inc) ; Vsm = 0V ammeter ; Rg 1Meg = gate bleed (reset-safe)
Nets: 3V3A=analog rail ; VSET=1.179V ref ; T=sample top ; S=sample bottom ;
X=M1 drain ; B=M1 source (=Rsense top, op-amp in-) ; VG=M1 gate
.include models.inc
.tran 15m
.ac dec 100 0.1 10meg
