chenxi-z/de-drms/firmware/DE-DRMS-Code/Core/Src/main.c

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
/* Includes ------------------------------------------------------------------*/
#include "app_threadx.h"
#include "main.h"
#include "adc.h"
#include "gpdma.h"
#include "icache.h"
#include "rtc.h"
#include "spi.h"
#include "usart.h"
#include "usb_otg.h"
#include "gpio.h"


void SystemClock_Config(void);
/**
  * @brief  The application entry point.
  * @retval int
  */
int main(void)
{

  /* MCU Configuration--------------------------------------------------------*/

  /* Reset of all peripherals, Initializes the Flash interface and the Systick. */
  HAL_Init();

  /* Configure the system clock */
  SystemClock_Config();

  /* Initialize all configured peripherals */
  MX_GPIO_Init();
  MX_GPDMA1_Init();
  MX_ADC1_Init();
  MX_SPI1_Init();
  MX_USART1_UART_Init();
  MX_USB_OTG_FS_PCD_Init();
  MX_RTC_Init();
  MX_ICACHE_Init();
  /* USER CODE BEGIN 2 */
  /* Early board bring-up marker, sent before ThreadX starts. */
  static const uint8_t boot_banner[] = "\r\nDE-DRMS: USART1 initialized; starting RTOS\r\n";
  (void)HAL_UART_Transmit(&huart1, boot_banner, sizeof(boot_banner) - 1u, 100u);
  HAL_PWR_EnableWakeUpPin(PWR_WAKEUP_PIN1_LOW_0);
  HAL_PWR_EnableWakeUpPin(PWR_WAKEUP_PIN5_LOW_0);
  /* HAL 毫秒时基（TIM7）必须高于采集中断。
   *
   * 2026-11-12 实机定位：TIM7 原用默认优先级 15（最低），而 4 kSPS 采集时
   * DRDY(EXTI3)=7、GPDMA=6 每秒各来 4000 次，TIM7 每次都被它们抢先，
   * 大量更新中断被压在 pending 里合并，于是 uwTick 每秒只前进约 91 次
   * 而不是 1000 次——HAL_GetTick() 慢了整整一个数量级，所有超时、
   * CDC 推送周期、记录时长都跟着失真（表现为 100 ms 的订阅只发出 2 条/秒）。
   *
   * 提到最高优先级 0 之后，tick 精确回到 1 kHz（实测事件间隔与
   * 设备单调时间逐拍对齐）。TIM7 的 ISR 只是 HAL_IncTick() 加一，
   * 耗时几微秒，放在最高优先级不会挤压采集时间预算。
   *
   * 注意：这与 EXTI3 必须低于 GPDMA(6) 的规则不冲突——那条约束管的是
   * 采集内部两个中断的先后，TIM7 完全在采集环路之外。 */
  HAL_NVIC_SetPriority(TIM7_IRQn, 0, 0);
  /* USER CODE END 2 */

  MX_ThreadX_Init();

  /* We should never get here as control is now taken by the scheduler */

  /* Infinite loop */
  /* USER CODE BEGIN WHILE */
  while (1)
  {
    /* USER CODE END WHILE */

    /* USER CODE BEGIN 3 */
  }
  /* USER CODE END 3 */
}

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
/**
  * @brief  Period elapsed callback in non blocking mode
  * @note   This function is called  when TIM7 interrupt took place, inside
  * HAL_TIM_IRQHandler(). It makes a direct call to HAL_IncTick() to increment
  * a global variable "uwTick" used as application time base.
  * @param  htim : TIM handle
  * @retval None
  */
void HAL_TIM_PeriodElapsedCallback(TIM_HandleTypeDef *htim)
{
  if (htim->Instance == TIM7)
  {
    HAL_IncTick();
  }
}

/**
  * @brief  This function is executed in case of error occurrence.
  * @param None
  * @retval None
  */
void Error_Handler(void)
{
  /* USER CODE BEGIN Error_Handler_Debug */
  /* User can add his own implementation to report the HAL error return state */
  __disable_irq();
  while (1)
  {
  }
  /* USER CODE END Error_Handler_Debug */
}
#ifdef USE_FULL_ASSERT
/**
  * @brief  Reports the name of the source file and the source line number
  *         where the assert_param error has occurred.
  * @param  file: pointer to the source file name
  * @param  line: assert_param error line source number
  * @retval None
  */
void assert_failed(uint8_t *file, uint32_t line)
{
  /* USER CODE BEGIN 6 */
  /* User can add his own implementation to report the file name and line number,
     ex: printf("Wrong parameters value: file %s on line %d\r\n", file, line) */
  /* USER CODE END 6 */
}
#endif /* USE_FULL_ASSERT */
