chenxi-z/de-drms/firmware/DE-DRMS-Code/DE-DRMS-Code.ioc

Mcu.UserName=STM32U575RGTx
PA0.GPIO_Label=MEAS_BTN
PA0.Signal=GPXTI0
PA1.GPIO_Label=ADS_DONE
PA1.Signal=GPIO_Input
PA10.Signal=USART1_RX
PA11.Signal=USB_OTG_FS_DM
PA12.Signal=USB_OTG_FS_DP
PA2.GPIO_Label=ADS_RESET
PA2.Signal=GPIO_Output
PA3.GPIO_Label=ADS_DRDY
PA3.Signal=GPXTI3
PA4.GPIO_Label=ADS_CS
PA4.Signal=GPIO_Output
PA5.Signal=SPI1_SCK
PA6.Signal=SPI1_MISO
PA7.Signal=SPI1_MOSI
PA9.Signal=USART1_TX
PB0.GPIO_Label=SEL_K2
PB0.Signal=GPIO_Output
PB1.GPIO_Label=SEL_SENSE
PB1.Signal=GPIO_Output
PB13.GPIO_Label=LED_GREEN
PB13.Signal=GPIO_Output
PB14.GPIO_Label=LED_YELLOW
PB14.Signal=GPIO_Output
PB15.GPIO_Label=LED_ORANGE
PB15.Signal=GPIO_Output
PB5.GPIO_Label=BQ_PG
PB5.Signal=GPIO_Input
PC0.Signal=ADC1_IN1
PC1.GPIO_Label=BQ_EN
PC1.Signal=GPIO_Output
PC10.Signal=SDMMC1_D2
PC11.Signal=SDMMC1_D3
PC12.Signal=SDMMC1_CK
PC13.GPIO_Label=USB_VBUS_N
PC13.Signal=GPIO_Input
PC2.GPIO_Label=BQ_CHG
PC2.Signal=GPIO_Input
PC3.GPIO_Label=ANA_EN
PC3.Signal=GPIO_Output
PC4.GPIO_Label=CURR_DIS
PC4.Signal=GPIO_Output
PC5.GPIO_Label=PWR_BTN
PC5.Signal=GPXTI5
PC6.GPIO_Label=LED_RED
PC6.Signal=GPIO_Output
PC7.GPIO_Label=PWR_LED
PC7.Signal=GPIO_Output
PC8.Signal=SDMMC1_D0
PC9.Signal=SDMMC1_D1
PD2.Signal=SDMMC1_CMD
