chenxi-z/de-drms/firmware/DE-DRMS-Code/Core/Inc/main.h

#define USB_VBUS_N_Pin GPIO_PIN_13
#define USB_VBUS_N_GPIO_Port GPIOC
#define BQ_EN_Pin GPIO_PIN_1
#define BQ_EN_GPIO_Port GPIOC
#define BQ_CHG_Pin GPIO_PIN_2
#define BQ_CHG_GPIO_Port GPIOC
#define ANA_EN_Pin GPIO_PIN_3
#define ANA_EN_GPIO_Port GPIOC
#define MEAS_BTN_Pin GPIO_PIN_0
#define MEAS_BTN_GPIO_Port GPIOA
#define MEAS_BTN_EXTI_IRQn EXTI0_IRQn
#define ADS_DONE_Pin GPIO_PIN_1
#define ADS_DONE_GPIO_Port GPIOA
#define ADS_RESET_Pin GPIO_PIN_2
#define ADS_RESET_GPIO_Port GPIOA
#define ADS_DRDY_Pin GPIO_PIN_3
#define ADS_DRDY_GPIO_Port GPIOA
#define ADS_DRDY_EXTI_IRQn EXTI3_IRQn
#define ADS_CS_Pin GPIO_PIN_4
#define ADS_CS_GPIO_Port GPIOA
#define CURR_DIS_Pin GPIO_PIN_4
#define CURR_DIS_GPIO_Port GPIOC
#define PWR_BTN_Pin GPIO_PIN_5
#define PWR_BTN_GPIO_Port GPIOC
#define PWR_BTN_EXTI_IRQn EXTI5_IRQn
#define SEL_K2_Pin GPIO_PIN_0
#define SEL_K2_GPIO_Port GPIOB
#define SEL_SENSE_Pin GPIO_PIN_1
#define SEL_SENSE_GPIO_Port GPIOB
#define LED_GREEN_Pin GPIO_PIN_13
#define LED_GREEN_GPIO_Port GPIOB
#define LED_YELLOW_Pin GPIO_PIN_14
#define LED_YELLOW_GPIO_Port GPIOB
#define LED_ORANGE_Pin GPIO_PIN_15
#define LED_ORANGE_GPIO_Port GPIOB
#define LED_RED_Pin GPIO_PIN_6
#define LED_RED_GPIO_Port GPIOC
#define PWR_LED_Pin GPIO_PIN_7
#define PWR_LED_GPIO_Port GPIOC
#define SD_CD_Pin GPIO_PIN_15
#define SD_CD_GPIO_Port GPIOA
#define SD_CD_EXTI_IRQn EXTI15_IRQn
#define BQ_PG_Pin GPIO_PIN_5
#define BQ_PG_GPIO_Port GPIOB
#define DRMS_SD_DIAGNOSTIC_IGNORE_CD 1
