chenxi-z/de-drms/firmware/DE-DRMS-Code/Core/Src/drms_measurement.c

/*****************************************************************************
 * 文件：drms_measurement.c
 * 职责：测量算法——把 12 字节原始帧变成"多少欧姆"，以及相关的判据。
 *
 * 在整机中的位置：
 *   ADC 原始帧 → drms_decode_frame（拆包、校验、判量程）
 *              → drms_excitation_ok（激励是否正常）
 *              → drms_resistance（算电阻）
 *              → 监测管线（滤波、判级）
 *
 * 一个必须理解的前提：R = k × V_sample / V_Rsense
 *
 *   V_Rsense 是已知阻值 Rsense 上的压降，它与样品上的压降流过**同一个电流**
 *   （恒流源串联），所以两者之比就是电阻之比。
 *   系数 k 由参考校准确定：用已知的 R_ref 测一次，算出 k = R_ref × sum(CH2)/sum(CH1)。
 *   这样一来 Rsense 的绝对误差被完全消掉——它只影响比值中的分母和分子，两边同时出现。
 *   最终绝对精度锚定在 R_ref 上（本板 ±0.02%）。
 *
 * 为什么分成好几个小函数：
 *   解码、激励检查、算电阻各自独立，可以单独测试、单独调用。
 *   尤其 32 kSPS 以上的纯直录模式会跳过全部三个——那条路径只搬字节。
 *****************************************************************************/

#include "drms_measurement.h"
#include <math.h>

/* 计算一帧的 CRC-16（CRC-CCITT-FALSE）。
 *
 * 参数来自 TI SBAS590E §9.5.1.7：多项式 0x1021、初值 0xFFFF、
 * 不做位反射、无最终异或。ADC 在每帧末尾附上这个校验值，
 * 我们算一遍比对，不一致说明传输被打断。
 *
 * 实现用字节查表：每字节只查一次表，减少高速采集的处理开销。
 * 这在高速档很关键——128 kSPS 时每帧都要算一次。 */
uint16_t drms_crc16(const uint8_t *bytes, size_t length)
{
  /* Flash 常量表；按字节查表，保留每一帧的 CRC 校验。 */
  static const uint16_t table[256] = {
    0x0000,0x1021,0x2042,0x3063,0x4084,0x50a5,0x60c6,0x70e7,
    0x8108,0x9129,0xa14a,0xb16b,0xc18c,0xd1ad,0xe1ce,0xf1ef,
    0x1231,0x0210,0x3273,0x2252,0x52b5,0x4294,0x72f7,0x62d6,
    0x9339,0x8318,0xb37b,0xa35a,0xd3bd,0xc39c,0xf3ff,0xe3de,
    0x2462,0x3443,0x0420,0x1401,0x64e6,0x74c7,0x44a4,0x5485,
    0xa56a,0xb54b,0x8528,0x9509,0xe5ee,0xf5cf,0xc5ac,0xd58d,
    0x3653,0x2672,0x1611,0x0630,0x76d7,0x66f6,0x5695,0x46b4,
    0xb75b,0xa77a,0x9719,0x8738,0xf7df,0xe7fe,0xd79d,0xc7bc,
    0x48c4,0x58e5,0x6886,0x78a7,0x0840,0x1861,0x2802,0x3823,
    0xc9cc,0xd9ed,0xe98e,0xf9af,0x8948,0x9969,0xa90a,0xb92b,
    0x5af5,0x4ad4,0x7ab7,0x6a96,0x1a71,0x0a50,0x3a33,0x2a12,
    0xdbfd,0xcbdc,0xfbbf,0xeb9e,0x9b79,0x8b58,0xbb3b,0xab1a,
    0x6ca6,0x7c87,0x4ce4,0x5cc5,0x2c22,0x3c03,0x0c60,0x1c41,
    0xedae,0xfd8f,0xcdec,0xddcd,0xad2a,0xbd0b,0x8d68,0x9d49,
    0x7e97,0x6eb6,0x5ed5,0x4ef4,0x3e13,0x2e32,0x1e51,0x0e70,
    0xff9f,0xefbe,0xdfdd,0xcffc,0xbf1b,0xaf3a,0x9f59,0x8f78,
    0x9188,0x81a9,0xb1ca,0xa1eb,0xd10c,0xc12d,0xf14e,0xe16f,
    0x1080,0x00a1,0x30c2,0x20e3,0x5004,0x4025,0x7046,0x6067,
    0x83b9,0x9398,0xa3fb,0xb3da,0xc33d,0xd31c,0xe37f,0xf35e,
    0x02b1,0x1290,0x22f3,0x32d2,0x4235,0x5214,0x6277,0x7256,
    0xb5ea,0xa5cb,0x95a8,0x8589,0xf56e,0xe54f,0xd52c,0xc50d,
    0x34e2,0x24c3,0x14a0,0x0481,0x7466,0x6447,0x5424,0x4405,
    0xa7db,0xb7fa,0x8799,0x97b8,0xe75f,0xf77e,0xc71d,0xd73c,
    0x26d3,0x36f2,0x0691,0x16b0,0x6657,0x7676,0x4615,0x5634,
    0xd94c,0xc96d,0xf90e,0xe92f,0x99c8,0x89e9,0xb98a,0xa9ab,
    0x5844,0x4865,0x7806,0x6827,0x18c0,0x08e1,0x3882,0x28a3,
    0xcb7d,0xdb5c,0xeb3f,0xfb1e,0x8bf9,0x9bd8,0xabbb,0xbb9a,
    0x4a75,0x5a54,0x6a37,0x7a16,0x0af1,0x1ad0,0x2ab3,0x3a92,
    0xfd2e,0xed0f,0xdd6c,0xcd4d,0xbdaa,0xad8b,0x9de8,0x8dc9,
    0x7c26,0x6c07,0x5c64,0x4c45,0x3ca2,0x2c83,0x1ce0,0x0cc1,
    0xef1f,0xff3e,0xcf5d,0xdf7c,0xaf9b,0xbfba,0x8fd9,0x9ff8,
    0x6e17,0x7e36,0x4e55,0x5e74,0x2e93,0x3eb2,0x0ed1,0x1ef0,
  };
  uint16_t crc = 0xffff;
  for (size_t i = 0; i < length; ++i)
    crc = (uint16_t)((crc << 8) ^ table[(crc >> 8) ^ bytes[i]]);

  return crc;
}

/* 计算 CRC-32（ISO-HDLC，即 zlib 参数）。
 *
 * 用于：记录文件的整体校验、配置块的完整性、协议帧的尾部。
 * 与 CRC-16 不同，这一套是我们自己定的（不是 ADC 要求的），
 * 所以参数必须与协议文档严格一致，否则主机验不过。
 *
 * 用右移版本（反射多项式 0xEDB88320），与 Python 的 zlib.crc32 等价——
 * 这样上位机和测试脚本能直接复用标准库校验。 */
/* Slicing-by-4: process four bytes per iteration with Flash-only tables.
 * CRC parameters and output stay identical to zlib; byte loads make arbitrary
 * alignment and host endianness safe. No shared hardware CRC state or IRQ mask. */
static const uint32_t crc32_table[4][256] = {
  {
    0x00000000U,0x77073096U,0xee0e612cU,0x990951baU,
    0x076dc419U,0x706af48fU,0xe963a535U,0x9e6495a3U,
    0x0edb8832U,0x79dcb8a4U,0xe0d5e91eU,0x97d2d988U,
    0x09b64c2bU,0x7eb17cbdU,0xe7b82d07U,0x90bf1d91U,
    0x1db71064U,0x6ab020f2U,0xf3b97148U,0x84be41deU,
    0x1adad47dU,0x6ddde4ebU,0xf4d4b551U,0x83d385c7U,
    0x136c9856U,0x646ba8c0U,0xfd62f97aU,0x8a65c9ecU,
    0x14015c4fU,0x63066cd9U,0xfa0f3d63U,0x8d080df5U,
    0x3b6e20c8U,0x4c69105eU,0xd56041e4U,0xa2677172U,
    0x3c03e4d1U,0x4b04d447U,0xd20d85fdU,0xa50ab56bU,
    0x35b5a8faU,0x42b2986cU,0xdbbbc9d6U,0xacbcf940U,
    0x32d86ce3U,0x45df5c75U,0xdcd60dcfU,0xabd13d59U,
    0x26d930acU,0x51de003aU,0xc8d75180U,0xbfd06116U,
    0x21b4f4b5U,0x56b3c423U,0xcfba9599U,0xb8bda50fU,
    0x2802b89eU,0x5f058808U,0xc60cd9b2U,0xb10be924U,
    0x2f6f7c87U,0x58684c11U,0xc1611dabU,0xb6662d3dU,
    0x76dc4190U,0x01db7106U,0x98d220bcU,0xefd5102aU,
    0x71b18589U,0x06b6b51fU,0x9fbfe4a5U,0xe8b8d433U,
    0x7807c9a2U,0x0f00f934U,0x9609a88eU,0xe10e9818U,
    0x7f6a0dbbU,0x086d3d2dU,0x91646c97U,0xe6635c01U,
    0x6b6b51f4U,0x1c6c6162U,0x856530d8U,0xf262004eU,
    0x6c0695edU,0x1b01a57bU,0x8208f4c1U,0xf50fc457U,
    0x65b0d9c6U,0x12b7e950U,0x8bbeb8eaU,0xfcb9887cU,
    0x62dd1ddfU,0x15da2d49U,0x8cd37cf3U,0xfbd44c65U,
    0x4db26158U,0x3ab551ceU,0xa3bc0074U,0xd4bb30e2U,
    0x4adfa541U,0x3dd895d7U,0xa4d1c46dU,0xd3d6f4fbU,
    0x4369e96aU,0x346ed9fcU,0xad678846U,0xda60b8d0U,
    0x44042d73U,0x33031de5U,0xaa0a4c5fU,0xdd0d7cc9U,
    0x5005713cU,0x270241aaU,0xbe0b1010U,0xc90c2086U,
    0x5768b525U,0x206f85b3U,0xb966d409U,0xce61e49fU,
    0x5edef90eU,0x29d9c998U,0xb0d09822U,0xc7d7a8b4U,
    0x59b33d17U,0x2eb40d81U,0xb7bd5c3bU,0xc0ba6cadU,
    0xedb88320U,0x9abfb3b6U,0x03b6e20cU,0x74b1d29aU,
    0xead54739U,0x9dd277afU,0x04db2615U,0x73dc1683U,
    0xe3630b12U,0x94643b84U,0x0d6d6a3eU,0x7a6a5aa8U,
    0xe40ecf0bU,0x9309ff9dU,0x0a00ae27U,0x7d079eb1U,
    0xf00f9344U,0x8708a3d2U,0x1e01f268U,0x6906c2feU,
    0xf762575dU,0x806567cbU,0x196c3671U,0x6e6b06e7U,
    0xfed41b76U,0x89d32be0U,0x10da7a5aU,0x67dd4accU,
    0xf9b9df6fU,0x8ebeeff9U,0x17b7be43U,0x60b08ed5U,
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
  },
  {
    0x00000000U,0x191b3141U,0x32366282U,0x2b2d53c3U,
    0x646cc504U,0x7d77f445U,0x565aa786U,0x4f4196c7U,
    0xc8d98a08U,0xd1c2bb49U,0xfaefe88aU,0xe3f4d9cbU,
    0xacb54f0cU,0xb5ae7e4dU,0x9e832d8eU,0x87981ccfU,
    0x4ac21251U,0x53d92310U,0x78f470d3U,0x61ef4192U,
    0x2eaed755U,0x37b5e614U,0x1c98b5d7U,0x05838496U,
    0x821b9859U,0x9b00a918U,0xb02dfadbU,0xa936cb9aU,
    0xe6775d5dU,0xff6c6c1cU,0xd4413fdfU,0xcd5a0e9eU,
    0x958424a2U,0x8c9f15e3U,0xa7b24620U,0xbea97761U,
    0xf1e8e1a6U,0xe8f3d0e7U,0xc3de8324U,0xdac5b265U,
    0x5d5daeaaU,0x44469febU,0x6f6bcc28U,0x7670fd69U,
    0x39316baeU,0x202a5aefU,0x0b07092cU,0x121c386dU,
    0xdf4636f3U,0xc65d07b2U,0xed705471U,0xf46b6530U,
    0xbb2af3f7U,0xa231c2b6U,0x891c9175U,0x9007a034U,
    0x179fbcfbU,0x0e848dbaU,0x25a9de79U,0x3cb2ef38U,
    0x73f379ffU,0x6ae848beU,0x41c51b7dU,0x58de2a3cU,
    0xf0794f05U,0xe9627e44U,0xc24f2d87U,0xdb541cc6U,
    0x94158a01U,0x8d0ebb40U,0xa623e883U,0xbf38d9c2U,
    0x38a0c50dU,0x21bbf44cU,0x0a96a78fU,0x138d96ceU,
    0x5ccc0009U,0x45d73148U,0x6efa628bU,0x77e153caU,
    0xbabb5d54U,0xa3a06c15U,0x888d3fd6U,0x91960e97U,
    0xded79850U,0xc7cca911U,0xece1fad2U,0xf5facb93U,
    0x7262d75cU,0x6b79e61dU,0x4054b5deU,0x594f849fU,
    0x160e1258U,0x0f152319U,0x243870daU,0x3d23419bU,
    0x65fd6ba7U,0x7ce65ae6U,0x57cb0925U,0x4ed03864U,
    0x0191aea3U,0x188a9fe2U,0x33a7cc21U,0x2abcfd60U,
    0xad24e1afU,0xb43fd0eeU,0x9f12832dU,0x8609b26cU,
    0xc94824abU,0xd05315eaU,0xfb7e4629U,0xe2657768U,
    0x2f3f79f6U,0x362448b7U,0x1d091b74U,0x04122a35U,
    0x4b53bcf2U,0x52488db3U,0x7965de70U,0x607eef31U,
    0xe7e6f3feU,0xfefdc2bfU,0xd5d0917cU,0xcccba03dU,
    0x838a36faU,0x9a9107bbU,0xb1bc5478U,0xa8a76539U,
    0x3b83984bU,0x2298a90aU,0x09b5fac9U,0x10aecb88U,
    0x5fef5d4fU,0x46f46c0eU,0x6dd93fcdU,0x74c20e8cU,
    0xf35a1243U,0xea412302U,0xc16c70c1U,0xd8774180U,
    0x9736d747U,0x8e2de606U,0xa500b5c5U,0xbc1b8484U,
    0x71418a1aU,0x685abb5bU,0x4377e898U,0x5a6cd9d9U,
    0x152d4f1eU,0x0c367e5fU,0x271b2d9cU,0x3e001cddU,
    0xb9980012U,0xa0833153U,0x8bae6290U,0x92b553d1U,
    0xddf4c516U,0xc4eff457U,0xefc2a794U,0xf6d996d5U,
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
  },
  {
    0x00000000U,0x01c26a37U,0x0384d46eU,0x0246be59U,
    0x0709a8dcU,0x06cbc2ebU,0x048d7cb2U,0x054f1685U,
    0x0e1351b8U,0x0fd13b8fU,0x0d9785d6U,0x0c55efe1U,
    0x091af964U,0x08d89353U,0x0a9e2d0aU,0x0b5c473dU,
    0x1c26a370U,0x1de4c947U,0x1fa2771eU,0x1e601d29U,
    0x1b2f0bacU,0x1aed619bU,0x18abdfc2U,0x1969b5f5U,
    0x1235f2c8U,0x13f798ffU,0x11b126a6U,0x10734c91U,
    0x153c5a14U,0x14fe3023U,0x16b88e7aU,0x177ae44dU,
    0x384d46e0U,0x398f2cd7U,0x3bc9928eU,0x3a0bf8b9U,
    0x3f44ee3cU,0x3e86840bU,0x3cc03a52U,0x3d025065U,
    0x365e1758U,0x379c7d6fU,0x35dac336U,0x3418a901U,
    0x3157bf84U,0x3095d5b3U,0x32d36beaU,0x331101ddU,
    0x246be590U,0x25a98fa7U,0x27ef31feU,0x262d5bc9U,
    0x23624d4cU,0x22a0277bU,0x20e69922U,0x2124f315U,
    0x2a78b428U,0x2bbade1fU,0x29fc6046U,0x283e0a71U,
    0x2d711cf4U,0x2cb376c3U,0x2ef5c89aU,0x2f37a2adU,
    0x709a8dc0U,0x7158e7f7U,0x731e59aeU,0x72dc3399U,
    0x7793251cU,0x76514f2bU,0x7417f172U,0x75d59b45U,
    0x7e89dc78U,0x7f4bb64fU,0x7d0d0816U,0x7ccf6221U,
    0x798074a4U,0x78421e93U,0x7a04a0caU,0x7bc6cafdU,
    0x6cbc2eb0U,0x6d7e4487U,0x6f38fadeU,0x6efa90e9U,
    0x6bb5866cU,0x6a77ec5bU,0x68315202U,0x69f33835U,
    0x62af7f08U,0x636d153fU,0x612bab66U,0x60e9c151U,
    0x65a6d7d4U,0x6464bde3U,0x662203baU,0x67e0698dU,
    0x48d7cb20U,0x4915a117U,0x4b531f4eU,0x4a917579U,
    0x4fde63fcU,0x4e1c09cbU,0x4c5ab792U,0x4d98dda5U,
    0x46c49a98U,0x4706f0afU,0x45404ef6U,0x448224c1U,
    0x41cd3244U,0x400f5873U,0x4249e62aU,0x438b8c1dU,
    0x54f16850U,0x55330267U,0x5775bc3eU,0x56b7d609U,
    0x53f8c08cU,0x523aaabbU,0x507c14e2U,0x51be7ed5U,
    0x5ae239e8U,0x5b2053dfU,0x5966ed86U,0x58a487b1U,
    0x5deb9134U,0x5c29fb03U,0x5e6f455aU,0x5fad2f6dU,
    0xe1351b80U,0xe0f771b7U,0xe2b1cfeeU,0xe373a5d9U,
    0xe63cb35cU,0xe7fed96bU,0xe5b86732U,0xe47a0d05U,
    0xef264a38U,0xeee4200fU,0xeca29e56U,0xed60f461U,
    0xe82fe2e4U,0xe9ed88d3U,0xebab368aU,0xea695cbdU,
    0xfd13b8f0U,0xfcd1d2c7U,0xfe976c9eU,0xff5506a9U,
    0xfa1a102cU,0xfbd87a1bU,0xf99ec442U,0xf85cae75U,
    0xf300e948U,0xf2c2837fU,0xf0843d26U,0xf1465711U,
    0xf4094194U,0xf5cb2ba3U,0xf78d95faU,0xf64fffcdU,
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
  },
  {
    0x00000000U,0xb8bc6765U,0xaa09c88bU,0x12b5afeeU,
    0x8f629757U,0x37def032U,0x256b5fdcU,0x9dd738b9U,
    0xc5b428efU,0x7d084f8aU,0x6fbde064U,0xd7018701U,
    0x4ad6bfb8U,0xf26ad8ddU,0xe0df7733U,0x58631056U,
    0x5019579fU,0xe8a530faU,0xfa109f14U,0x42acf871U,
    0xdf7bc0c8U,0x67c7a7adU,0x75720843U,0xcdce6f26U,
    0x95ad7f70U,0x2d111815U,0x3fa4b7fbU,0x8718d09eU,
    0x1acfe827U,0xa2738f42U,0xb0c620acU,0x087a47c9U,
    0xa032af3eU,0x188ec85bU,0x0a3b67b5U,0xb28700d0U,
    0x2f503869U,0x97ec5f0cU,0x8559f0e2U,0x3de59787U,
    0x658687d1U,0xdd3ae0b4U,0xcf8f4f5aU,0x7733283fU,
    0xeae41086U,0x525877e3U,0x40edd80dU,0xf851bf68U,
    0xf02bf8a1U,0x48979fc4U,0x5a22302aU,0xe29e574fU,
    0x7f496ff6U,0xc7f50893U,0xd540a77dU,0x6dfcc018U,
    0x359fd04eU,0x8d23b72bU,0x9f9618c5U,0x272a7fa0U,
    0xbafd4719U,0x0241207cU,0x10f48f92U,0xa848e8f7U,
    0x9b14583dU,0x23a83f58U,0x311d90b6U,0x89a1f7d3U,
    0x1476cf6aU,0xaccaa80fU,0xbe7f07e1U,0x06c36084U,
    0x5ea070d2U,0xe61c17b7U,0xf4a9b859U,0x4c15df3cU,
    0xd1c2e785U,0x697e80e0U,0x7bcb2f0eU,0xc377486bU,
    0xcb0d0fa2U,0x73b168c7U,0x6104c729U,0xd9b8a04cU,
    0x446f98f5U,0xfcd3ff90U,0xee66507eU,0x56da371bU,
    0x0eb9274dU,0xb6054028U,0xa4b0efc6U,0x1c0c88a3U,
    0x81dbb01aU,0x3967d77fU,0x2bd27891U,0x936e1ff4U,
    0x3b26f703U,0x839a9066U,0x912f3f88U,0x299358edU,
    0xb4446054U,0x0cf80731U,0x1e4da8dfU,0xa6f1cfbaU,
    0xfe92dfecU,0x462eb889U,0x549b1767U,0xec277002U,
    0x71f048bbU,0xc94c2fdeU,0xdbf98030U,0x6345e755U,
    0x6b3fa09cU,0xd383c7f9U,0xc1366817U,0x798a0f72U,
    0xe45d37cbU,0x5ce150aeU,0x4e54ff40U,0xf6e89825U,
    0xae8b8873U,0x1637ef16U,0x048240f8U,0xbc3e279dU,
    0x21e91f24U,0x99557841U,0x8be0d7afU,0x335cb0caU,
    0xed59b63bU,0x55e5d15eU,0x47507eb0U,0xffec19d5U,
    0x623b216cU,0xda874609U,0xc832e9e7U,0x708e8e82U,
    0x28ed9ed4U,0x9051f9b1U,0x82e4565fU,0x3a58313aU,
    0xa78f0983U,0x1f336ee6U,0x0d86c108U,0xb53aa66dU,
    0xbd40e1a4U,0x05fc86c1U,0x1749292fU,0xaff54e4aU,
    0x322276f3U,0x8a9e1196U,0x982bbe78U,0x2097d91dU,
    0x78f4c94bU,0xc048ae2eU,0xd2fd01c0U,0x6a4166a5U,
    0xf7965e1cU,0x4f2a3979U,0x5d9f9697U,0xe523f1f2U,
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
  },
};

uint32_t drms_crc32(const uint8_t *bytes, size_t length)
{
  uint32_t crc = 0xffffffffU;
  while (length >= 4)
  {
    crc ^= (uint32_t)bytes[0] | ((uint32_t)bytes[1] << 8) |
           ((uint32_t)bytes[2] << 16) | ((uint32_t)bytes[3] << 24);
    crc = crc32_table[3][crc & 0xffU] ^ crc32_table[2][(crc >> 8) & 0xffU] ^
          crc32_table[1][(crc >> 16) & 0xffU] ^ crc32_table[0][crc >> 24];
    bytes += 4;
    length -= 4;
  }
  while (length--)
    crc = (crc >> 8) ^ crc32_table[0][(crc ^ *bytes++) & 0xffU];
  return ~crc;
}

/* 把 3 个字节按大端拼成 24 位有符号整数。
 *
 * 符号扩展的做法：先把值左移 8 位到 32 位的高半区，再算术右移回来，
 * 这样最高位自然就填满了高位。比手工判断符号位更不容易写错。
 *
 * ADC 输出的是二进制补码，满量程 ±2^23。 */
static int32_t signed24(const uint8_t *bytes)
{
  uint32_t value = ((uint32_t)bytes[0] << 16) | ((uint32_t)bytes[1] << 8) | bytes[2];
  /* 用减法而不是把无符号转成有符号：后者的行为由实现定义，
   * 换编译器可能就变味了，而出错的位置恰恰是最难查的。 */
  return value & 0x800000U ? (int32_t)(value & 0x7fffffU) - 0x800000 : (int32_t)value;
}

/* 把一帧 12 字节原始数据拆成电压、电流和一组标志位。
 *
 * 帧结构（每帧 4 个字，每字 3 字节，共 12 字节）：
 *   字节 0-2  状态字（含各类故障标志）
 *   字节 3-5  通道 0，样品/参考电压
 *   字节 6-8  通道 1，Rsense 压降
 *   字节 9-10 CRC-16
 *   字节 11   保留（应为 0）
 *
 * 判据逐条都有明确来源：
 *   · CRC 不符 → CRC_ERROR，这帧的数据不可信；
 *   · 状态字首字节不是 0x22、次字节最高位为 1、保留字节非 0 → FORMAT_ERROR，
 *     说明帧错位或 ADC 配置与预期不符；
 *   · 状态字的故障位（0x6F 掩码）→ ADC_FAULT；
 *   · 数值贴边 → RANGE_ERROR（详见下方注释）。
 *
 * 注意 F_ADCIN 这一位被有意排除在掩码之外：本板 AIN2N 直接接 AVSS，
 * 低于最低比较器门限，这一位会常态置位。它属于"已知的、无害的"，
 * 而其余故障位（协议错、重同步、看门狗、溢出、饱和）才是真问题。
 *
 * 返回 1 表示这帧完全干净可用；0 表示有任一标志置位。 */
int drms_decode_frame(const uint8_t frame[12], DRMS_Sample *sample)
{
  sample->voltage = signed24(frame + 3);
  sample->sense = signed24(frame + 6);
  sample->status = (uint16_t)(((uint16_t)frame[0] << 8) | frame[1]);
  sample->flags = 0;
  if (drms_crc16(frame, 9) != (uint16_t)(((uint16_t)frame[9] << 8) | frame[10]))
    sample->flags |= DRMS_SAMPLE_CRC_ERROR;
  if (frame[0] != 0x22 || (frame[1] & 0x80) || frame[2] != 0 || frame[11] != 0)
    sample->flags |= DRMS_SAMPLE_FORMAT_ERROR;
  /* 本板上 F_ADCIN 单独置位属于正常现象，不算故障：AIN2N 被有意接到 AVSS，
   * 低于最低比较器门限，这一位会常态置位。
   * 所以原始状态字里保留它，但掩码 0x6F 把它排除在外——
   * 真正要拦的是协议错、重同步、看门狗、溢出和数字饱和。 */
  if (frame[1] & 0x6f)
    sample->flags |= DRMS_SAMPLE_ADC_FAULT;
  if (sample->voltage >= 8388606 || sample->voltage <= -8388607 ||
      sample->sense >= 8388606 || sample->sense <= 4096 || sample->voltage < -4096)
    sample->flags |= DRMS_SAMPLE_RANGE_ERROR;
  return sample->flags == 0;
}

/* 判断恒流激励是否处于正常工作状态。
 *
 * 这是一个**首板合理性护栏**，不是标定过的电流规格。判据来自设计值：
 *   VSET = 3.3 × 100/(180+100) ≈ 1.1786 V，允许 ±10%；
 *   V_Rsense = 8 µA × 150 kΩ = 1.2 V，对应 ADC 码约 4.05M；
 *   同时要求 V_sample + V_Rsense 不超过合规上限（预留 T 点 0.5 V 余量）。
 *
 * 三道条件同时成立才算正常：
 *   1. 帧本身无标志；
 *   2. Rsense 压降落在 [3.64M, 4.45M] 码值区间（对应 ±10%）；
 *   3. 两路压降之和不超过合规栈上限——超了说明恒流源已经退出恒流区。
 *
 * 为什么需要它：电阻比值在"没有电流"时也会算出一个数（0/0 附近的噪声），
 * 那个数看起来完全正常但毫无意义。这一层就是拦住这种情况。
 *
 * 返回 1 正常；0 表示激励异常，此时不应采信任何电阻读数。 */
int drms_excitation_ok(const DRMS_Sample *sample)
{
  /* 首板合理性护栏，不是标定过的电流规格。
   *   VSET = 3.3×100/(180+100) = 1.178571 V，允许 ±10%；
   *   内部基准 2.442 V；
   *   另外预留 0.5 V 合规余量（T 点设计最低 2.97 V 以下）。
   * 这三个数共同确定了下方的码值区间，改任何一个都要重新推导。 */
  return !sample->flags && sample->sense >= 3643701 && sample->sense <= 4453411 &&
         (int64_t)sample->voltage + sample->sense <= 8484791;
}

/* 算出电阻值：R = k × V_sample / V_Rsense。
 *
 * k 由参考校准给出（drms_reference_scale）。未校准时 k 取 Rsense 的名义值，
 * 此时结果只用于粗看，绝对精度没有保证——调用方应通过 cal 标志告知操作者。
 *
 * 拒绝计算的情形（任一成立即返回 0）：
 *   · 帧有标志（数据不可信）；
 *   · Rsense 压降过小（≤ 4096 码）——分母趋零，算出来的数没有意义；
 *   · 样品电压贴满量程或为负——已饱和或接反；
 *   · k 非法（非有限值或非正）。
 *
 * 这些判断不是防御性冗余：ΣΔ 在过载时输出会贴边，若不拦住，
 * 满量程除以一个很小的数会得到一个巨大的"电阻值"，看起来像断线但其实是 ADC 饱和。
 *
 * 返回 1 成功；0 表示这次算不出可信的电阻。 */
int drms_resistance(const DRMS_Sample *sample, double scale, double *ohms)
{
  if (sample->flags || sample->sense <= 4096 || sample->voltage >= 8388606 ||
      sample->voltage < -4096 || !isfinite(scale) || scale <= 0)
    return 0;
  *ohms = scale * (double)sample->voltage / (double)sample->sense;
  return isfinite(*ohms);
}

/* 由参考测量算出比例系数 k。
 *
 * 公式：k = R_ref × ΣV_Rsense / ΣV_ref
 *
 * 注意这里的除法方向：因为 k 将来要乘在 V_sample/V_Rsense 上，
 * 所以它必须包含 R_ref 与"电流对应的码值"之间的换算关系。
 * 直白地说：用已知的 R_ref 标定一次，就知道"一个码值代表多少欧姆"。
 *
 * 用累加和而不是逐点平均：4096 个样本累加后一次除法，
 * 避免逐点除法的舍入误差累积。
 *
 * 结果做合理性检查（100k–200k Ω 范围）：落在范围外说明参考支路或
 * 激励有问题，宁可校准失败也不能接受一个离谱的系数。
 *
 * 返回 1 成功；0 表示输入非法或结果不合理。 */
int drms_reference_scale(int64_t voltage_sum, int64_t sense_sum,
                         double reference_ohms, double *scale)
{
  if (voltage_sum <= 0 || sense_sum <= 0 || reference_ohms <= 0 || !isfinite(reference_ohms))
    return 0;
  double value = reference_ohms * (double)sense_sum / (double)voltage_sum;
  if (!isfinite(value) || value < 100000. || value > 200000.)
    return 0;
  *scale = value;
  return 1;
}

/* 采样率到 ADC 时钟寄存器的映射表——这是采样率支持的**唯一权威来源**。
 *
 * 每个档位对应一个 CLK2 寄存器值，它编码了两件事：
 *   ICLK_DIV[7:5]  ICLK 到调制器时钟 fMOD 的分频
 *   OSR[3:0]       过采样比，决定 fDATA = fMOD / OSR
 *
 * 本板 fICLK = 16.384 MHz（板载晶振），实测各档都落在设计值上：
 *   4 kSPS  → OSR 1024
 *   64 kSPS → OSR 64（这是无损采集的上限）
 *   128 kSPS → OSR 32（受读取时序限制，已在入口拒绝，见 drms_acq_start）
 *
 * 想加新档位必须同时确认 ADC 是否支持该 OSR、以及固件能否在该速率下
 * 完整搬运数据——不能只看寄存器能不能写。
 *
 * 返回 1 表示速率受支持，clk2 回填寄存器值；0 表示不支持。 */
int drms_rate_register(uint32_t rate, uint8_t *clk2)
{
  switch (rate)
  {
    case 1000: *clk2 = 0x20; return 1;
    case 4000: *clk2 = 0x22; return 1;
    case 8000: *clk2 = 0x25; return 1;
    case 16000: *clk2 = 0x28; return 1;
    case 32000: *clk2 = 0x2b; return 1;
    case 64000: *clk2 = 0x2d; return 1;
    case 128000: *clk2 = 0x2f; return 1;
    default: return 0;
  }
}
