chenxi-z/de-drms/firmware/DE-DRMS-Code/USBX/App/ux_device_msc.c

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

/* Includes ------------------------------------------------------------------*/
#include "ux_device_msc.h"

/* USER CODE BEGIN Includes */
#include "drms_msc.h"
#include "ux_device_class_storage.h"
/* USER CODE END Includes */

/**
  * @brief  USBD_STORAGE_Activate
  *         This function is called when insertion of a storage device.
  * @param  storage_instance: Pointer to the storage class instance.
  * @retval none
  */
VOID USBD_STORAGE_Activate(VOID *storage_instance)
{
  /* USER CODE BEGIN USBD_STORAGE_Activate */
  UX_PARAMETER_NOT_USED(storage_instance);
  /* USER CODE END USBD_STORAGE_Activate */

  return;
}

/**
  * @brief  USBD_STORAGE_Deactivate
  *         This function is called when extraction of a storage device.
  * @param  storage_instance: Pointer to the storage class instance.
  * @retval none
  */
VOID USBD_STORAGE_Deactivate(VOID *storage_instance)
{
  /* USER CODE BEGIN USBD_STORAGE_Deactivate  */
  UX_PARAMETER_NOT_USED(storage_instance);
  drms_msc_cancel();
  /* USER CODE END USBD_STORAGE_Deactivate */

  return;
}

/**
  * @brief  USBD_STORAGE_Read
  *         This function is invoked to read from media.
  * @param  storage_instance : Pointer to the storage class instance.
  * @param  lun: Logical unit number is the command is directed to.
  * @param  data_pointer: Address of the buffer to be used for reading or writing.
  * @param  number_blocks: number of sectors to read/write.
  * @param  lba: Logical block address is the sector address to read.
  * @param  media_status: should be filled out exactly like the media status
  *                       callback return value.
  * @retval status
  */
UINT USBD_STORAGE_Read(VOID *storage_instance, ULONG lun, UCHAR *data_pointer,
                       ULONG number_blocks, ULONG lba, ULONG *media_status)
{
  UINT status = UX_SUCCESS;

  /* USER CODE BEGIN USBD_STORAGE_Read */
  UX_PARAMETER_NOT_USED(storage_instance);
  if (media_status)
    *media_status = UX_DEVICE_CLASS_STORAGE_SENSE_STATUS(
        UX_SLAVE_CLASS_STORAGE_SENSE_KEY_NOT_READY, 0x3a, 0);
  if (lun != 0 || lba > UINT32_MAX || number_blocks > UINT32_MAX)
    return UX_ERROR;
  DRMS_Result result = drms_msc_read((uint32_t)lba, (uint32_t)number_blocks,
                                     (uint8_t *)data_pointer);
  if (result != DRMS_OK)
    return UX_ERROR;
  if (media_status)
    *media_status = 0;
  /* USER CODE END USBD_STORAGE_Read */

  return status;
}

/**
  * @brief  USBD_STORAGE_Write
  *         This function is invoked to write in media.
  * @param  storage_instance : Pointer to the storage class instance.
  * @param  lun: Logical unit number is the command is directed to.
  * @param  data_pointer: Address of the buffer to be used for reading or writing.
  * @param  number_blocks: number of sectors to read/write.
  * @param  lba: Logical block address is the sector address to read.
  * @param  media_status: should be filled out exactly like the media status
  *                       callback return value.
  * @retval status
  */
UINT USBD_STORAGE_Write(VOID *storage_instance, ULONG lun, UCHAR *data_pointer,
                        ULONG number_blocks, ULONG lba, ULONG *media_status)
{
  UINT status = UX_SUCCESS;

  /* USER CODE BEGIN USBD_STORAGE_Write */
  UX_PARAMETER_NOT_USED(storage_instance);
  UX_PARAMETER_NOT_USED(lun);
  UX_PARAMETER_NOT_USED(data_pointer);
  UX_PARAMETER_NOT_USED(number_blocks);
  UX_PARAMETER_NOT_USED(lba);
  if (media_status)
    *media_status = UX_DEVICE_CLASS_STORAGE_SENSE_STATUS(
        UX_SLAVE_CLASS_STORAGE_SENSE_KEY_DATA_PROTECT, 0x27, 0);
  return UX_ERROR; /* 只读导出：写回调返回保护错误，不触达 SD */
  /* USER CODE END USBD_STORAGE_Write */

  return status;
}

/**
  * @brief  USBD_STORAGE_Flush
  *         This function is invoked to flush media.
  * @param  storage_instance : Pointer to the storage class instance.
  * @param  lun: Logical unit number is the command is directed to.
  * @param  number_blocks: number of sectors to read/write.
  * @param  lba: Logical block address is the sector address to read.
  * @param  media_status: should be filled out exactly like the media status
  *                       callback return value.
  * @retval status
  */
UINT USBD_STORAGE_Flush(VOID *storage_instance, ULONG lun, ULONG number_blocks,
                        ULONG lba, ULONG *media_status)
{
  UINT status = UX_SUCCESS;

  /* USER CODE BEGIN USBD_STORAGE_Flush */
  UX_PARAMETER_NOT_USED(storage_instance);
  UX_PARAMETER_NOT_USED(lun);
  UX_PARAMETER_NOT_USED(number_blocks);
  UX_PARAMETER_NOT_USED(lba);
  UX_PARAMETER_NOT_USED(media_status);
  return drms_msc_media_ready() ? UX_SUCCESS : UX_ERROR;
  /* USER CODE END USBD_STORAGE_Flush */

  return status;
}

/**
  * @brief  USBD_STORAGE_Status
  *         This function is invoked to obtain the status of the device.
  * @param  storage_instance : Pointer to the storage class instance.
  * @param  lun: Logical unit number is the command is directed to.
  * @param  media_id: is not currently used.
  * @param  media_status: should be filled out exactly like the media status
  *                       callback return value.
  * @retval status
  */
UINT USBD_STORAGE_Status(VOID *storage_instance, ULONG lun, ULONG media_id,
                         ULONG *media_status)
{
  UINT status = UX_SUCCESS;

  /* USER CODE BEGIN USBD_STORAGE_Status */
  UX_PARAMETER_NOT_USED(media_id);
  uint32_t blocks;
  if (lun != 0 || !storage_instance || drms_msc_media_info(&blocks) != DRMS_OK || !blocks)
  {
    if (media_status)
      *media_status = UX_DEVICE_CLASS_STORAGE_SENSE_STATUS(
          UX_SLAVE_CLASS_STORAGE_SENSE_KEY_NOT_READY, 0x3a, 0);
    return UX_ERROR;
  }
  UX_SLAVE_CLASS_STORAGE *storage = (UX_SLAVE_CLASS_STORAGE *)storage_instance;
  storage->ux_slave_class_storage_lun[0].ux_slave_class_storage_media_last_lba = blocks - 1u;
  if (media_status)
    *media_status = 0;
  return UX_SUCCESS;
  /* USER CODE END USBD_STORAGE_Status */

  return status;
}

/**
  * @brief  USBD_STORAGE_Notification
  *         This function is invoked to obtain the notification of the device.
  * @param  storage_instance : Pointer to the storage class instance.
  * @param  lun: Logical unit number is the command is directed to.
  * @param  media_id: is not currently used.
  * @param  notification_class: specifies the class of notification.
  * @param  media_notification: response for the notification.
  * @param  media_notification_length: length of the response buffer.
  * @retval status
  */
UINT USBD_STORAGE_Notification(VOID *storage_instance, ULONG lun, ULONG media_id,
                               ULONG notification_class, UCHAR **media_notification,
                               ULONG *media_notification_length)
{
  UINT status = UX_SUCCESS;

  /* USER CODE BEGIN USBD_STORAGE_Notification */
  UX_PARAMETER_NOT_USED(storage_instance);
  UX_PARAMETER_NOT_USED(lun);
  UX_PARAMETER_NOT_USED(media_id);
  UX_PARAMETER_NOT_USED(notification_class);
  UX_PARAMETER_NOT_USED(media_notification);
  UX_PARAMETER_NOT_USED(media_notification_length);
  /* USER CODE END USBD_STORAGE_Notification */

  return status;
}

/**
  * @brief  USBD_STORAGE_GetMediaLastLba
  *         Get Media last LBA.
  * @param  none
  * @retval last lba
  */
ULONG USBD_STORAGE_GetMediaLastLba(VOID)
{
  ULONG LastLba = 0U;

  /* USER CODE BEGIN USBD_STORAGE_GetMediaLastLba */
  uint32_t blocks;
  if (drms_msc_media_info(&blocks) != DRMS_OK || blocks == 0)
    return 0;
  return (ULONG)(blocks - 1u); /* 最后合法 LBA = 块数 − 1 */
  /* USER CODE END USBD_STORAGE_GetMediaLastLba */

  return LastLba;
}

/**
  * @brief  USBD_STORAGE_GetMediaBlocklength
  *         Get Media block length.
  * @param  none.
  * @retval block length.
  */
ULONG USBD_STORAGE_GetMediaBlocklength(VOID)
{
  ULONG MediaBlockLen = 0U;

  /* USER CODE BEGIN USBD_STORAGE_GetMediaBlocklength */
  return 512u; /* 逻辑扇区恒 512；未导出时也不允许 0 块大小 */
  /* USER CODE END USBD_STORAGE_GetMediaBlocklength */

  return MediaBlockLen;
}
