chenxi-z/de-drms/firmware/DE-DRMS-Code/USBX/App/app_usbx_device.c

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

/* Includes ------------------------------------------------------------------*/
#include "app_usbx_device.h"
/* USER CODE BEGIN Includes */
#include "drms_usb.h"
#include "drms_cdc.h"

/* USER CODE END Includes */


static ULONG storage_interface_number;
static ULONG storage_configuration_number;
static ULONG cdc_acm_interface_number;
static ULONG cdc_acm_configuration_number;
static UX_SLAVE_CLASS_STORAGE_PARAMETER storage_parameter;
static UX_SLAVE_CLASS_CDC_ACM_PARAMETER cdc_acm_parameter;
static TX_THREAD ux_device_app_thread;
extern PCD_HandleTypeDef           hpcd_USB_OTG_FS;

static VOID app_ux_device_thread_entry(ULONG thread_input);
/**
  * @brief  Application USBX Device Initialization.
  * @param  memory_ptr: memory pointer
  * @retval status
  */

UINT MX_USBX_Device_Init(VOID *memory_ptr)
{
  UINT ret = UX_SUCCESS;
  UCHAR *pointer;
  TX_BYTE_POOL *byte_pool = (TX_BYTE_POOL*)memory_ptr;
  /* Allocate the stack for device application main thread */
  if (tx_byte_allocate(byte_pool, (VOID **) &pointer, UX_DEVICE_APP_THREAD_STACK_SIZE,
                       TX_NO_WAIT) != TX_SUCCESS)
  {
    /* USER CODE BEGIN MAIN_THREAD_ALLOCATE_STACK_ERROR */
    return TX_POOL_ERROR;
    /* USER CODE END MAIN_THREAD_ALLOCATE_STACK_ERROR */
  }

  /* Create the device application main thread */
  if (tx_thread_create(&ux_device_app_thread, UX_DEVICE_APP_THREAD_NAME, app_ux_device_thread_entry,
                       0, pointer, UX_DEVICE_APP_THREAD_STACK_SIZE, UX_DEVICE_APP_THREAD_PRIO,
                       UX_DEVICE_APP_THREAD_PREEMPTION_THRESHOLD, UX_DEVICE_APP_THREAD_TIME_SLICE,
                       UX_DEVICE_APP_THREAD_START_OPTION) != TX_SUCCESS)
  {
    /* USER CODE BEGIN MAIN_THREAD_CREATE_ERROR */
    return TX_THREAD_ERROR;
    /* USER CODE END MAIN_THREAD_CREATE_ERROR */
  }

  /* USER CODE BEGIN MX_USBX_Device_Init 2 */
  if (drms_cdc_start() != TX_SUCCESS)
    return TX_THREAD_ERROR;
  /* USER CODE END MX_USBX_Device_Init 2 */

  return ret;
}

/**
  * @brief  MX_USBX_Device_Stack_Init
  *         Intialization of USB Device.
  *         Initialize the device stack, register of device class stack
  *         Register of the usb device controller
  * @param  None
  * @retval ret
  */
UINT MX_USBX_Device_Stack_Init(void)
{
  UINT ret = UX_SUCCESS;
  UCHAR *device_framework_high_speed;
  UCHAR *device_framework_full_speed;
  ULONG device_framework_hs_length;
  ULONG device_framework_fs_length;
  ULONG string_framework_length;
  ULONG language_id_framework_length;
  UCHAR *string_framework;
  UCHAR *language_id_framework;

  /* Get Device Framework High Speed and get the length */
  device_framework_high_speed = USBD_Get_Device_Framework_Speed(USBD_HIGH_SPEED,
                                                                &device_framework_hs_length);

  /* Get Device Framework Full Speed and get the length */
  device_framework_full_speed = USBD_Get_Device_Framework_Speed(USBD_FULL_SPEED,
                                                                &device_framework_fs_length);

  /* Get String Framework and get the length */
  string_framework = USBD_Get_String_Framework(&string_framework_length);

  /* Get Language Id Framework and get the length */
  language_id_framework = USBD_Get_Language_Id_Framework(&language_id_framework_length);

  /* Install the device portion of USBX */
  if (ux_device_stack_initialize(device_framework_high_speed,
                                 device_framework_hs_length,
                                 device_framework_full_speed,
                                 device_framework_fs_length,
                                 string_framework,
                                 string_framework_length,
                                 language_id_framework,
                                 language_id_framework_length,
                                 UX_NULL) != UX_SUCCESS)
  {
    /* USER CODE BEGIN USBX_DEVICE_INITIALIZE_ERROR */
    return UX_ERROR;
    /* USER CODE END USBX_DEVICE_INITIALIZE_ERROR */
  }

  /* Initialize the storage class parameters for the device */
  storage_parameter.ux_slave_class_storage_instance_activate   = USBD_STORAGE_Activate;
  storage_parameter.ux_slave_class_storage_instance_deactivate = USBD_STORAGE_Deactivate;

  /* Store the number of LUN in this device storage instance */
  storage_parameter.ux_slave_class_storage_parameter_number_lun = STORAGE_NUMBER_LUN;

  /* Initialize the storage class parameters for reading/writing to the Flash Disk */
  storage_parameter.ux_slave_class_storage_parameter_lun[0].
    ux_slave_class_storage_media_last_lba = USBD_STORAGE_GetMediaLastLba();

  storage_parameter.ux_slave_class_storage_parameter_lun[0].
    ux_slave_class_storage_media_block_length = USBD_STORAGE_GetMediaBlocklength();

  storage_parameter.ux_slave_class_storage_parameter_lun[0].
    ux_slave_class_storage_media_type = 0;

  storage_parameter.ux_slave_class_storage_parameter_lun[0].
    ux_slave_class_storage_media_removable_flag = STORAGE_REMOVABLE_FLAG;

  storage_parameter.ux_slave_class_storage_parameter_lun[0].
    ux_slave_class_storage_media_read_only_flag = STORAGE_READ_ONLY;

  storage_parameter.ux_slave_class_storage_parameter_lun[0].
    ux_slave_class_storage_media_read = USBD_STORAGE_Read;

  storage_parameter.ux_slave_class_storage_parameter_lun[0].
    ux_slave_class_storage_media_write = USBD_STORAGE_Write;

  storage_parameter.ux_slave_class_storage_parameter_lun[0].
    ux_slave_class_storage_media_flush = USBD_STORAGE_Flush;

  storage_parameter.ux_slave_class_storage_parameter_lun[0].
    ux_slave_class_storage_media_status = USBD_STORAGE_Status;

  storage_parameter.ux_slave_class_storage_parameter_lun[0].
    ux_slave_class_storage_media_notification = USBD_STORAGE_Notification;

  /* Get storage configuration number */
  storage_configuration_number = USBD_Get_Configuration_Number(CLASS_TYPE_MSC, 0);

  /* Find storage interface number */
  storage_interface_number = USBD_Get_Interface_Number(CLASS_TYPE_MSC, 0);

  /* Initialize the device storage class */
  if (ux_device_stack_class_register(_ux_system_slave_class_storage_name,
                                     ux_device_class_storage_entry,
                                     storage_configuration_number,
                                     storage_interface_number,
                                     &storage_parameter) != UX_SUCCESS)
  {
    /* USER CODE BEGIN USBX_DEVICE_STORAGE_REGISTER_ERROR */
    return UX_ERROR;
    /* USER CODE END USBX_DEVICE_STORAGE_REGISTER_ERROR */
  }

  /* Initialize the cdc acm class parameters for the device */
  cdc_acm_parameter.ux_slave_class_cdc_acm_instance_activate   = USBD_CDC_ACM_Activate;
  cdc_acm_parameter.ux_slave_class_cdc_acm_instance_deactivate = USBD_CDC_ACM_Deactivate;
  cdc_acm_parameter.ux_slave_class_cdc_acm_parameter_change    = USBD_CDC_ACM_ParameterChange;

  /* Get cdc acm configuration number */
  cdc_acm_configuration_number = USBD_Get_Configuration_Number(CLASS_TYPE_CDC_ACM, 0);

  /* Find cdc acm interface number */
  cdc_acm_interface_number = USBD_Get_Interface_Number(CLASS_TYPE_CDC_ACM, 0);

  /* Initialize the device cdc acm class */
  if (ux_device_stack_class_register(_ux_system_slave_class_cdc_acm_name,
                                     ux_device_class_cdc_acm_entry,
                                     cdc_acm_configuration_number,
                                     cdc_acm_interface_number,
                                     &cdc_acm_parameter) != UX_SUCCESS)
  {
    /* USER CODE BEGIN USBX_DEVICE_CDC_ACM_REGISTER_ERROR */
    return UX_ERROR;
    /* USER CODE END USBX_DEVICE_CDC_ACM_REGISTER_ERROR */
  }

  /* Initialize and link controller HAL driver */
  ret = ux_dcd_stm32_initialize((ULONG)USB_OTG_FS, (ULONG)&hpcd_USB_OTG_FS);
  if (ret != UX_SUCCESS)
    return ret;
  /* USER CODE BEGIN MX_USBX_Device_Stack_Init_PostTreatment */
  _ux_system_slave->ux_system_slave_change_function = drms_usb_state_change;
  /* USER CODE END MX_USBX_Device_Stack_Init_PostTreatment */

  return ret;
}

/**
  * @brief  Function implementing app_ux_device_thread_entry.
  * @param  thread_input: User thread input parameter.
  * @retval none
  */
static VOID app_ux_device_thread_entry(ULONG thread_input)
{
  /* USER CODE BEGIN app_ux_device_thread_entry */
  TX_PARAMETER_NOT_USED(thread_input);
  if (drms_usb_init() != UX_SUCCESS)
    return; /* Inspect drms_usb_status; do not attach an incomplete stack. */
  for (;;)
  {
    /* USBX does not issue a configuration-change callback in this DCD.
       Poll that state; suspend/resume notifications arrive immediately. */
    {
      /* Read the state and apply its authorization atomically with reset IRQs;
         a stale pre-reset CONFIGURED snapshot must never restore USB500. */
      TX_INTERRUPT_SAVE_AREA
      TX_DISABLE
      drms_usb_state_change(_ux_system_slave->ux_system_slave_device.ux_slave_device_state);
      TX_RESTORE
    }
    drms_usb_poll();
    tx_thread_sleep((TX_TIMER_TICKS_PER_SECOND + 49) / 50);
  }
  /* USER CODE END app_ux_device_thread_entry */
}

/**
  * @brief  MX_USBX_Device_Stack_DeInit
  *         Unitialization of USB Device.
  *         uninitialize the device stack, unregister of device class stack
  *         unregister of the usb device controller
  * @retval ret
  */
UINT MX_USBX_Device_Stack_DeInit(void)
{
  UINT ret = UX_SUCCESS;

  /* USER CODE BEGIN MX_USBX_Device_Stack_DeInit_PreTreatment_0 */
  /* USER CODE END MX_USBX_Device_Stack_DeInit_PreTreatment_0 */

  /* Unregister USB device controller. */
  if (ux_dcd_stm32_uninitialize((ULONG)USB_OTG_FS, (ULONG)&hpcd_USB_OTG_FS) != UX_SUCCESS)
  {
    return UX_ERROR;
  }

/* Unregister storage class. */
  if (ux_device_stack_class_unregister(_ux_system_slave_class_storage_name,
                                       ux_device_class_storage_entry) != UX_SUCCESS)
  {
    return UX_ERROR;
  }

  /* Unregister CDC ACM class. */
  if (ux_device_stack_class_unregister(_ux_system_slave_class_cdc_acm_name,
                                     ux_device_class_cdc_acm_entry) != UX_SUCCESS)
  {
    return UX_ERROR;
  }

  /* The code below is required for uninstalling the device portion of USBX.  */
  if (ux_device_stack_uninitialize() != UX_SUCCESS)
  {
    return UX_ERROR;
  }

  /* USER CODE BEGIN MX_USBX_Device_Stack_DeInit_PreTreatment_1 */
  /* USER CODE END MX_USBX_Device_Stack_DeInit_PreTreatment_1 */

  /* USER CODE BEGIN MX_USBX_Device_Stack_DeInit_PostTreatment */
  /* USER CODE END MX_USBX_Device_Stack_DeInit_PostTreatment */

  return ret;
}
