chenxi-z/de-drms/firmware/DE-DRMS-Code/Core/Src/spi.c

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
/* Includes ------------------------------------------------------------------*/
#include "spi.h"

SPI_HandleTypeDef hspi1;
DMA_HandleTypeDef handle_GPDMA1_Channel1;
DMA_HandleTypeDef handle_GPDMA1_Channel0;

/* SPI1 init function */
void MX_SPI1_Init(void)
{

  SPI_AutonomousModeConfTypeDef HAL_SPI_AutonomousMode_Cfg_Struct = {0};

  hspi1.Instance = SPI1;
  hspi1.Init.Mode = SPI_MODE_MASTER;
  hspi1.Init.Direction = SPI_DIRECTION_2LINES;
  hspi1.Init.DataSize = SPI_DATASIZE_8BIT;
  hspi1.Init.CLKPolarity = SPI_POLARITY_LOW;
  hspi1.Init.CLKPhase = SPI_PHASE_2EDGE;
  hspi1.Init.NSS = SPI_NSS_SOFT;
  hspi1.Init.BaudRatePrescaler = SPI_BAUDRATEPRESCALER_2;
  hspi1.Init.FirstBit = SPI_FIRSTBIT_MSB;
  hspi1.Init.TIMode = SPI_TIMODE_DISABLE;
  hspi1.Init.CRCCalculation = SPI_CRCCALCULATION_DISABLE;
  hspi1.Init.CRCPolynomial = 0x7;
  hspi1.Init.NSSPMode = SPI_NSS_PULSE_DISABLE;
  hspi1.Init.NSSPolarity = SPI_NSS_POLARITY_LOW;
  hspi1.Init.FifoThreshold = SPI_FIFO_THRESHOLD_01DATA;
  hspi1.Init.MasterSSIdleness = SPI_MASTER_SS_IDLENESS_00CYCLE;
  hspi1.Init.MasterInterDataIdleness = SPI_MASTER_INTERDATA_IDLENESS_00CYCLE;
  hspi1.Init.MasterReceiverAutoSusp = SPI_MASTER_RX_AUTOSUSP_DISABLE;
  hspi1.Init.MasterKeepIOState = SPI_MASTER_KEEP_IO_STATE_DISABLE;
  hspi1.Init.IOSwap = SPI_IO_SWAP_DISABLE;
  hspi1.Init.ReadyMasterManagement = SPI_RDY_MASTER_MANAGEMENT_INTERNALLY;
  hspi1.Init.ReadyPolarity = SPI_RDY_POLARITY_HIGH;
  if (HAL_SPI_Init(&hspi1) != HAL_OK)
  {
    Error_Handler();
  }
  HAL_SPI_AutonomousMode_Cfg_Struct.TriggerState = SPI_AUTO_MODE_DISABLE;
  HAL_SPI_AutonomousMode_Cfg_Struct.TriggerSelection = SPI_GRP1_GPDMA_CH0_TCF_TRG;
  HAL_SPI_AutonomousMode_Cfg_Struct.TriggerPolarity = SPI_TRIG_POLARITY_RISING;
  if (HAL_SPIEx_SetConfigAutonomousMode(&hspi1, &HAL_SPI_AutonomousMode_Cfg_Struct) != HAL_OK)
  {
    Error_Handler();
  }
  /* USER CODE BEGIN SPI1_Init 2 */
  /* Medium slew rate on the SPI pins, applied here rather than in the
   * generated MSP block so CubeMX regeneration does not silently drop it.
   * PA5 (SCLK) is adjacent to PA3 (DRDY); at 128 kSPS the 20 MHz bursts were
   * coupling into DRDY and roughly quadrupling the observed edge rate.
   * DS13737 permits 55 MHz for this setting at CL=10 pF, 3.3 V. */
  {
    GPIO_InitTypeDef fast = {0};
    fast.Pin = GPIO_PIN_5 | GPIO_PIN_6 | GPIO_PIN_7;
    fast.Mode = GPIO_MODE_AF_PP;
    fast.Pull = GPIO_NOPULL;
    fast.Speed = GPIO_SPEED_FREQ_MEDIUM;
    fast.Alternate = GPIO_AF5_SPI1;
    HAL_GPIO_Init(GPIOA, &fast);
  }
  /* USER CODE END SPI1_Init 2 */

}

void HAL_SPI_MspInit(SPI_HandleTypeDef* spiHandle)
{

  GPIO_InitTypeDef GPIO_InitStruct = {0};
  RCC_PeriphCLKInitTypeDef PeriphClkInit = {0};
  if(spiHandle->Instance==SPI1)
  {
  /** Initializes the peripherals clock
  */
    PeriphClkInit.PeriphClockSelection = RCC_PERIPHCLK_SPI1;
    PeriphClkInit.Spi1ClockSelection = RCC_SPI1CLKSOURCE_MSIK;
    if (HAL_RCCEx_PeriphCLKConfig(&PeriphClkInit) != HAL_OK)
    {
      Error_Handler();
    }

    /* SPI1 clock enable */
    __HAL_RCC_SPI1_CLK_ENABLE();

    __HAL_RCC_GPIOA_CLK_ENABLE();
    /**SPI1 GPIO Configuration
    PA5     ------> SPI1_SCK
    PA6     ------> SPI1_MISO
    PA7     ------> SPI1_MOSI
    */
    GPIO_InitStruct.Pin = GPIO_PIN_5|GPIO_PIN_6|GPIO_PIN_7;
    GPIO_InitStruct.Mode = GPIO_MODE_AF_PP;
    GPIO_InitStruct.Pull = GPIO_NOPULL;
    GPIO_InitStruct.Speed = GPIO_SPEED_FREQ_HIGH;
    GPIO_InitStruct.Alternate = GPIO_AF5_SPI1;
    HAL_GPIO_Init(GPIOA, &GPIO_InitStruct);

    /* SPI1 DMA Init */
    /* GPDMA1_REQUEST_SPI1_RX Init */
    handle_GPDMA1_Channel1.Instance = GPDMA1_Channel1;
    handle_GPDMA1_Channel1.Init.Request = GPDMA1_REQUEST_SPI1_RX;
    handle_GPDMA1_Channel1.Init.BlkHWRequest = DMA_BREQ_SINGLE_BURST;
    handle_GPDMA1_Channel1.Init.Direction = DMA_PERIPH_TO_MEMORY;
    handle_GPDMA1_Channel1.Init.SrcInc = DMA_SINC_FIXED;
    handle_GPDMA1_Channel1.Init.DestInc = DMA_DINC_INCREMENTED;
    handle_GPDMA1_Channel1.Init.SrcDataWidth = DMA_SRC_DATAWIDTH_BYTE;
    handle_GPDMA1_Channel1.Init.DestDataWidth = DMA_DEST_DATAWIDTH_BYTE;
    handle_GPDMA1_Channel1.Init.Priority = DMA_HIGH_PRIORITY;
    handle_GPDMA1_Channel1.Init.SrcBurstLength = 1;
    handle_GPDMA1_Channel1.Init.DestBurstLength = 1;
    handle_GPDMA1_Channel1.Init.TransferAllocatedPort = DMA_SRC_ALLOCATED_PORT0|DMA_DEST_ALLOCATED_PORT1;
    handle_GPDMA1_Channel1.Init.TransferEventMode = DMA_TCEM_BLOCK_TRANSFER;
    handle_GPDMA1_Channel1.Init.Mode = DMA_NORMAL;
    if (HAL_DMA_Init(&handle_GPDMA1_Channel1) != HAL_OK)
    {
      Error_Handler();
    }

    __HAL_LINKDMA(spiHandle, hdmarx, handle_GPDMA1_Channel1);

    if (HAL_DMA_ConfigChannelAttributes(&handle_GPDMA1_Channel1, DMA_CHANNEL_NPRIV) != HAL_OK)
    {
      Error_Handler();
    }

    /* GPDMA1_REQUEST_SPI1_TX Init */
    handle_GPDMA1_Channel0.Instance = GPDMA1_Channel0;
    handle_GPDMA1_Channel0.Init.Request = GPDMA1_REQUEST_SPI1_TX;
    handle_GPDMA1_Channel0.Init.BlkHWRequest = DMA_BREQ_SINGLE_BURST;
    handle_GPDMA1_Channel0.Init.Direction = DMA_MEMORY_TO_PERIPH;
    handle_GPDMA1_Channel0.Init.SrcInc = DMA_SINC_INCREMENTED;
    handle_GPDMA1_Channel0.Init.DestInc = DMA_DINC_FIXED;
    handle_GPDMA1_Channel0.Init.SrcDataWidth = DMA_SRC_DATAWIDTH_BYTE;
    handle_GPDMA1_Channel0.Init.DestDataWidth = DMA_DEST_DATAWIDTH_BYTE;
    handle_GPDMA1_Channel0.Init.Priority = DMA_LOW_PRIORITY_HIGH_WEIGHT;
    handle_GPDMA1_Channel0.Init.SrcBurstLength = 1;
    handle_GPDMA1_Channel0.Init.DestBurstLength = 1;
    handle_GPDMA1_Channel0.Init.TransferAllocatedPort = DMA_SRC_ALLOCATED_PORT1|DMA_DEST_ALLOCATED_PORT0;
    handle_GPDMA1_Channel0.Init.TransferEventMode = DMA_TCEM_BLOCK_TRANSFER;
    handle_GPDMA1_Channel0.Init.Mode = DMA_NORMAL;
    if (HAL_DMA_Init(&handle_GPDMA1_Channel0) != HAL_OK)
    {
      Error_Handler();
    }

    __HAL_LINKDMA(spiHandle, hdmatx, handle_GPDMA1_Channel0);

    if (HAL_DMA_ConfigChannelAttributes(&handle_GPDMA1_Channel0, DMA_CHANNEL_NPRIV) != HAL_OK)
    {
      Error_Handler();
    }

    /* SPI1 interrupt Init */
    HAL_NVIC_SetPriority(SPI1_IRQn, 6, 0);
    HAL_NVIC_EnableIRQ(SPI1_IRQn);
  }
}

void HAL_SPI_MspDeInit(SPI_HandleTypeDef* spiHandle)
{

  if(spiHandle->Instance==SPI1)
  {
    /* Peripheral clock disable */
    __HAL_RCC_SPI1_CLK_DISABLE();

    /**SPI1 GPIO Configuration
    PA5     ------> SPI1_SCK
    PA6     ------> SPI1_MISO
    PA7     ------> SPI1_MOSI
    */
    HAL_GPIO_DeInit(GPIOA, GPIO_PIN_5|GPIO_PIN_6|GPIO_PIN_7);

    /* SPI1 DMA DeInit */
    HAL_DMA_DeInit(spiHandle->hdmarx);
    HAL_DMA_DeInit(spiHandle->hdmatx);

    /* SPI1 interrupt Deinit */
    HAL_NVIC_DisableIRQ(SPI1_IRQn);
  }
}
