chenxi-z/de-drms/firmware/DE-DRMS-Code/Core/Src/sdmmc.c

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
/* Includes ------------------------------------------------------------------*/
#include "sdmmc.h"

/* USER CODE BEGIN 0 */
/* Removable media failure is recoverable; exported to the FileX glue. */
HAL_StatusTypeDef sd_init_status = HAL_ERROR;

volatile uint32_t sd_bus_high_speed;

static HAL_StatusTypeDef sd_startup_init(SD_HandleTypeDef *sd)
{
  /* CLK48 starts at the default-speed limit. Never clock an unnegotiated
   * card at 48 MHz; CMD6 must succeed before CLKDIV=0 is allowed. */
  sd_bus_high_speed = 0;
  sd->Init.ClockDiv = 1;
  HAL_StatusTypeDef status = HAL_SD_Init(sd);
  if (status != HAL_OK)
    return status;
  if (HAL_SD_ConfigSpeedBusOperation(sd, SDMMC_SPEED_MODE_HIGH) == HAL_OK)
  {
    sd->Init.ClockDiv = 0;
    if (HAL_SD_ConfigWideBusOperation(sd, SDMMC_BUS_WIDE_4B) == HAL_OK)
    {
      sd_bus_high_speed = 1;
      return HAL_OK;
    }
  }
  /* Unsupported/failed negotiation is recoverable. Reinitialize completely
   * at 24 MHz so no partial switch or HAL error state leaks into FileX. */
  (void)HAL_SD_DeInit(sd);
  sd->Init.ClockDiv = 1;
  return HAL_SD_Init(sd);
}

/* USER CODE END 0 */

SD_HandleTypeDef hsd1;

/* SDMMC1 init function */

void MX_SDMMC1_SD_Init(void)
{

  /* USER CODE BEGIN SDMMC1_Init 0 */
  sd_init_status = HAL_ERROR;
  sd_bus_high_speed = 0;
  #if !DRMS_SD_DIAGNOSTIC_IGNORE_CD
  if (HAL_GPIO_ReadPin(SD_CD_GPIO_Port, SD_CD_Pin) != GPIO_PIN_RESET)
  {
    return;
  }
  #endif

  /* USER CODE END SDMMC1_Init 0 */

  hsd1.Instance = SDMMC1;
  hsd1.Init.ClockEdge = SDMMC_CLOCK_EDGE_RISING;
  hsd1.Init.ClockPowerSave = SDMMC_CLOCK_POWER_SAVE_DISABLE;
  hsd1.Init.BusWide = SDMMC_BUS_WIDE_4B;
  hsd1.Init.HardwareFlowControl = SDMMC_HARDWARE_FLOW_CONTROL_DISABLE;
  hsd1.Init.ClockDiv = 0;
  /* CubeMX regeneration guard: keep this failure nonfatal. */
  sd_init_status = sd_startup_init(&hsd1);
  if (sd_init_status != HAL_OK)
  {
    (void)HAL_SD_DeInit(&hsd1);
    return;
  }
}

void HAL_SD_MspInit(SD_HandleTypeDef* sdHandle)
{

  GPIO_InitTypeDef GPIO_InitStruct = {0};
  RCC_PeriphCLKInitTypeDef PeriphClkInit = {0};
  if(sdHandle->Instance==SDMMC1)
  {
  /** Initializes the peripherals clock
  */
    PeriphClkInit.PeriphClockSelection = RCC_PERIPHCLK_SDMMC|RCC_PERIPHCLK_CLK48;
    PeriphClkInit.IclkClockSelection = RCC_CLK48CLKSOURCE_HSI48;
    PeriphClkInit.SdmmcClockSelection = RCC_SDMMCCLKSOURCE_CLK48;
    if (HAL_RCCEx_PeriphCLKConfig(&PeriphClkInit) != HAL_OK)
    {
      Error_Handler();
    }

    /* SDMMC1 clock enable */
    __HAL_RCC_SDMMC1_CLK_ENABLE();

    __HAL_RCC_GPIOC_CLK_ENABLE();
    __HAL_RCC_GPIOD_CLK_ENABLE();
    /**SDMMC1 GPIO Configuration
    PC8     ------> SDMMC1_D0
    PC9     ------> SDMMC1_D1
    PC10     ------> SDMMC1_D2
    PC11     ------> SDMMC1_D3
    PC12     ------> SDMMC1_CK
    PD2     ------> SDMMC1_CMD
    */
    GPIO_InitStruct.Pin = GPIO_PIN_8|GPIO_PIN_9|GPIO_PIN_10|GPIO_PIN_11
                          |GPIO_PIN_12;
    GPIO_InitStruct.Mode = GPIO_MODE_AF_PP;
    GPIO_InitStruct.Pull = GPIO_NOPULL;
    GPIO_InitStruct.Speed = GPIO_SPEED_FREQ_HIGH;
    GPIO_InitStruct.Alternate = GPIO_AF12_SDMMC1;
    HAL_GPIO_Init(GPIOC, &GPIO_InitStruct);

    GPIO_InitStruct.Pin = GPIO_PIN_2;
    GPIO_InitStruct.Mode = GPIO_MODE_AF_PP;
    GPIO_InitStruct.Pull = GPIO_NOPULL;
    GPIO_InitStruct.Speed = GPIO_SPEED_FREQ_HIGH;
    GPIO_InitStruct.Alternate = GPIO_AF12_SDMMC1;
    HAL_GPIO_Init(GPIOD, &GPIO_InitStruct);

    /* SDMMC1 interrupt Init */
    HAL_NVIC_SetPriority(SDMMC1_IRQn, 8, 0);
    HAL_NVIC_EnableIRQ(SDMMC1_IRQn);
  }
}

void HAL_SD_MspDeInit(SD_HandleTypeDef* sdHandle)
{

  if(sdHandle->Instance==SDMMC1)
  {
    /* Peripheral clock disable */
    __HAL_RCC_SDMMC1_CLK_DISABLE();

    /**SDMMC1 GPIO Configuration
    PC8     ------> SDMMC1_D0
    PC9     ------> SDMMC1_D1
    PC10     ------> SDMMC1_D2
    PC11     ------> SDMMC1_D3
    PC12     ------> SDMMC1_CK
    PD2     ------> SDMMC1_CMD
    */
    HAL_GPIO_DeInit(GPIOC, GPIO_PIN_8|GPIO_PIN_9|GPIO_PIN_10|GPIO_PIN_11
                          |GPIO_PIN_12);

    HAL_GPIO_DeInit(GPIOD, GPIO_PIN_2);

    /* SDMMC1 interrupt Deinit */
    HAL_NVIC_DisableIRQ(SDMMC1_IRQn);
  }
}
