chenxi-z/de-drms/firmware/DE-DRMS-Code/Core/Inc/drms_time.h

#ifndef DRMS_TIME_H
#define DRMS_TIME_H
#include <stdint.h>

typedef struct {
  uint16_t year;
  uint8_t month, day, hour, minute, second, weekday, valid;
} DRMS_Time;
int drms_time_parse(const char *iso, DRMS_Time *time);
/* UTC epoch seconds, 2000-01-01 through 2099-12-31; out needs 20 bytes. */
int drms_time_epoch_to_iso(uint64_t epoch_s, char out[20]);
int drms_time_valid(const DRMS_Time *time);
int drms_time_set(const char *iso);
void drms_time_get(DRMS_Time *time);
void drms_aux_poll(void);
extern volatile uint32_t drms_battery_mv, drms_battery_valid;
#endif
