chenxi-z/de-drms/docs/design/diagram/_lib/gen_恒流源电路图.py

#!/usr/bin/env python3
"""直流首板说明图；依据主文档附录F，非EDA修改。"""
from scistyle import PrototypeDiagram

d=PrototypeDiagram('恒流源电路图','固定分压直流首板 · 连接关系示意 · Q3 保留，DAC 默认断开')
d.text(40,145,'AVCC 3.3 V');d.line(165,140,195,140);d.resistor(195,140,'R27 360 kΩ')
d.line(275,140,370,140);d.node(370,140);d.text(395,190,'VSET ≈ 1.17857 V',14)
d.resistor(430,140,'R28 200 kΩ');d.line(370,140,430,140);d.line(510,140,545,140);d.ground(545,140)
d.line(370,140,370,235);d.line(370,235,600,235)
d.box(600,200,220,['U13 OPA333','IN+ ← VSET','IN− ← AFE_B','OUT → Q2 G'])
d.box(870,200,195,['Q2 BSS138','D ← 回流节点 X','S → AFE_B','G ← U13 OUT'])
d.line(820,285,870,285)
d.box(600,390,465,['AFE_B → R26 150 kΩ → AGND','AFE_B 同时反馈 U13 IN− 并送电流通道缓冲'])
d.line(965,325,965,390)
d.box(35,340,495,['Q3：D→VSET，S→AGND，G→PB10','PB10 高：压低VSET；低：允许固定分压激励','R29 改100 kΩ：Q3 G上拉数字VCC','ANA_EN下拉；初始化保持模拟电源关闭'])
d.notes([
'R29原1 MΩ下拉取消。抑制激励不等同精确零电流，开路/零点/切换恢复仍需验证。',
'VSET固定分压到IN+之间留可断开0 Ω与测试点；PA4仅预留，不直接并联此VSET。',
'当前工程没有台架中的VSET 100 pF、Q2 G对地1 nF；不能未核验证就直接补入。',
'有限合规电压限制最大可测电阻；不能把600 kΩ当作约8 µA下的恒流量程。',
'图省略去耦与供电脚：原U13去耦保留；实际原理图/封装脚序由用户最终核对。'
],625)

d.save(__file__)
