chenxi-z/de-drms/docs/design/diagram/_lib/gen_整体方案框图.py

#!/usr/bin/env python3
"""直流首板说明图；依据主文档附录F，非EDA修改。"""
from scistyle import PrototypeDiagram

d=PrototypeDiagram('整体方案框图','首版直流测量工程验证 · 扫频为扩展预留，不承诺仅改固件即可实现')
d.box(35,140,285,['样品：两电极，优选四线引出','客户 R0 约 10–20 kΩ','最大电阻与爆炸动态需求待定'])
d.box(400,140,290,['OPA333 + BSS138 低边恒流','固定分压，约 7.857 µA','Rsense 150 kΩ；TMUX1134校准'])
d.line(320,185,400,185)
d.box(770,140,295,['三颗 OPA388 缓冲','T2 AAF候选，保留失败项','ADS131A02 双通道同步'])
d.line(690,185,770,185)
d.box(770,340,295,['STM32U545RET6Q','SPI1；CS=PA8','采集/DMA/校准应用待完成'])
d.line(920,240,920,340)
d.box(400,340,290,['TF：SDMMC1 4-bit','全量记录目标','持续吞吐/停顿与恢复待测'])
d.line(770,390,690,390)
d.box(35,340,285,['USB FS：控制与降采样显示','PC13独立VBUS检测','电源状态机与取电策略待完成'])
d.line(920,440,920,490);d.line(920,490,170,490);d.line(170,490,170,440)
d.box(35,530,1030,['PA4 预留 DAC；VSET / AGND 测试点和可断开固定分压连接','未来：直流偏置 + 小正弦 → 实测电压/电流相量之比 → 复阻抗/CPE模型辨识'])
d.notes([
'本版无TMP117、无TF电源开关；不能沿用旧低待机功耗预算。',
'128 kSPS仅双通道6字节原码已768 kB/s；12字节记录1.536 MB/s，USB FS不承诺全量。',
'24 bit位宽不等于24 bit有效分辨率；旧准确度、量程与动态断言须重新验证。',
'原理图/PCB由用户修改；本图与主文档附录F描述目标，不表示远端EDA已完成。'
],670)

d.save(__file__)
