chenxi-z/de-drms/test/test_application.py

"""Supervisor integration: real command, ADC, calibration and logging modules.

Only HAL/ThreadX/FileX/Flash/RTC boundaries are doubled. No physical board is used.
"""
import ctypes
from pathlib import Path
import shutil
import subprocess
import tempfile
import unittest
from test_acquisition import HEADER as ACQ_HEADER, MOCK as ACQ_MOCK
from test_logging import HEADER as FX_HEADER, MOCK as FX_MOCK
from test_calibration_journal import MOCK as CAL_MOCK
from test_user_config import build_body, with_baseline_policy
from test_config_wire import settings, tlv
from test_config_snapshot import View
import struct

ROOT = Path(__file__).resolve().parents[1]

class ControlRequest(ctypes.Structure):
    _fields_ = [('source', ctypes.c_uint32), ('session', ctypes.c_uint32),
                ('request_id', ctypes.c_uint64), ('operation', ctypes.c_int),
                ('value', ctypes.c_uint32), ('number', ctypes.c_double),
                ('payload', ctypes.c_void_p), ('payload_length', ctypes.c_uint32),
                ('expected_version', ctypes.c_uint64), ('record_id', ctypes.c_uint64)]

class Token(ctypes.Structure):
    _fields_ = [('operation_id', ctypes.c_uint64), ('generation', ctypes.c_uint32)]

class RecordView(ctypes.Structure):
    _fields_ = [('record', ctypes.c_uint64), ('capture_lost', ctypes.c_uint64),
                ('log_dropped', ctypes.c_uint64), ('result', ctypes.c_uint32),
                ('phase', ctypes.c_uint8), ('clean_end', ctypes.c_uint8),
                ('unknown_loss', ctypes.c_uint8)]

class FileView(ctypes.Structure):
    _fields_ = [('operation', ctypes.c_uint64), ('size', ctypes.c_uint64),
                ('session', ctypes.c_uint32), ('generation', ctypes.c_uint32),
                ('phase', ctypes.c_uint32), ('result', ctypes.c_uint32)]

class FileListView(ctypes.Structure):
    _fields_ = [('operation', ctypes.c_uint64), ('size', ctypes.c_uint64),
                ('session', ctypes.c_uint32), ('generation', ctypes.c_uint32),
                ('cursor', ctypes.c_uint32), ('file_id', ctypes.c_uint32),
                ('next_cursor', ctypes.c_uint32), ('phase', ctypes.c_uint32), ('result', ctypes.c_uint32)]

class StatusSnapshot(ctypes.Structure):
    _fields_ = [('revision', ctypes.c_uint64), ('mono_us', ctypes.c_uint64),
                ('running_version', ctypes.c_uint64), ('saved_version', ctypes.c_uint64),
                ('baseline_version', ctypes.c_uint64), ('calibration_version', ctypes.c_uint64),
                ('sample_index', ctypes.c_uint64), ('ohms', ctypes.c_double), ('ratio', ctypes.c_double),
                ('rate', ctypes.c_uint32), ('generation', ctypes.c_uint32),
                ('media_generation', ctypes.c_uint32), ('quality', ctypes.c_uint32), ('fault', ctypes.c_uint32),
                ('acquisition', ctypes.c_uint8), ('recording', ctypes.c_uint8), ('medium', ctypes.c_uint8),
                ('owner', ctypes.c_uint8), ('maintenance', ctypes.c_uint8), ('fresh', ctypes.c_uint8),
                ('classification', ctypes.c_uint8), ('rtc_valid', ctypes.c_uint8),
                ('ohms_valid', ctypes.c_uint8), ('ratio_valid', ctypes.c_uint8),
                ('level_valid', ctypes.c_uint8), ('level', ctypes.c_uint8), ('interval', ctypes.c_uint16),
                ('record_id', ctypes.c_uint64), ('record_result', ctypes.c_uint32), ('record_phase', ctypes.c_uint8)]
TX_HEADER = r'''
#ifndef TEST_TX_H
#define TEST_TX_H
typedef unsigned int UINT;
typedef unsigned long ULONG;
typedef struct { unsigned int head,tail,count;unsigned char messages[16][32]; } TX_QUEUE;
#define TX_NO_WAIT 0
#define TX_SUCCESS 0
UINT tx_queue_create(TX_QUEUE *,char *,UINT,void *,ULONG);
UINT tx_queue_send(TX_QUEUE *,void *,ULONG);
UINT tx_queue_receive(TX_QUEUE *,void *,ULONG);
UINT tx_queue_flush(TX_QUEUE *);
#endif
'''
APP_MOCK = r'''
#include "tx_api.h"
#include "drms_time.h"
#include "drms_cdc_v2.h"
#include <string.h>
volatile unsigned int drms_usb_status,drms_uart_rx_dropped,drms_uart_tx_dropped;
volatile uint32_t drms_battery_mv=3700,drms_battery_valid=1;
static DRMS_Time clock_value;
void drms_aux_poll(void) {}
unsigned int drms_usb_can_io(void) { return 0; }
int sd_card_present, measure_down, power_down;
int HAL_GPIO_ReadPin(int p,int n) {
  return n==18 ? (sd_card_present ? 0 : 1) : n==13 ? !measure_down : n==14 ? !power_down : 1;
}
uint64_t drms_boot_identity_get(void) { return 0x123456789abcdef0ULL; }
DRMS_Result drms_file_backend_open(uint32_t id,uint32_t s,uint32_t g,uint64_t *size) {
 (void)id;(void)s;(void)g; *size=123; return DRMS_OK; }
uint32_t file_read_result;
DRMS_Result drms_file_backend_read(uint32_t s,uint32_t g,uint64_t o,uint16_t n,uint8_t *p,uint16_t *actual,uint8_t *eof) {
 (void)s;(void)g;memset(p,'A',n);*actual=n;*eof=(o+n>=123);return (DRMS_Result)file_read_result; }
uint32_t file_close_result;
DRMS_Result drms_file_backend_close(uint32_t s,uint32_t g) { (void)s;(void)g;return (DRMS_Result)file_close_result; }
DRMS_Result drms_file_backend_list_step(uint32_t c,uint32_t g,uint32_t *id,uint64_t *size,uint32_t *next) {
 (void)g;*id=c;*size=123;*next=c+1;return DRMS_OK; }
int drms_power_backend_enter(void) { return 0; }
void drms_time_get(DRMS_Time *t) { *t=clock_value; }
int drms_time_set(const char *text) { return drms_time_parse(text,&clock_value); }
uint32_t HAL_GetUIDw0(void) { return 1; }
uint32_t HAL_GetUIDw1(void) { return 2; }
uint32_t HAL_GetUIDw2(void) { return 3; }
UINT tx_queue_create(TX_QUEUE *q,char *n,UINT z,void *m,ULONG size) { memset(q,0,sizeof(*q));return z*sizeof(ULONG)==32?0:1; }
UINT tx_queue_send(TX_QUEUE *q,void *item,ULONG wait) {
 if(q->count==16) return 1;
 memcpy(q->messages[q->head],item,32);q->head=(q->head+1)%16;++q->count;return 0;
}
UINT tx_queue_receive(TX_QUEUE *q,void *item,ULONG wait) {
 if(!q->count) return 1;
 memcpy(item,q->messages[q->tail],32);q->tail=(q->tail+1)%16;--q->count;return 0;
}
UINT tx_queue_flush(TX_QUEUE *q) { q->head=q->tail=q->count=0;return 0; }
/* 用户区 Flash 后端替身：RAM 页（真后端直写 0x080F8000，主机不可执行） */
static uint8_t user_pages[2][8192];
int fail_user_write;
int drms_user_backend_begin(void) { return !fail_user_write; }
void drms_user_backend_end(void) {}
int drms_user_backend_erase(unsigned int page) { memset(user_pages[page],0xFF,8192); return 1; }
int drms_user_backend_program(unsigned int page, unsigned int offset, const uint8_t q[16]) {
  if (offset+16 > 8192) return 0;
  memcpy(user_pages[page]+offset, q, 16); return 1; }
int drms_user_backend_read(unsigned int page, unsigned int offset, uint8_t *out, unsigned int len) {
  if (offset+len > 8192) return 0;
  memcpy(out, user_pages[page]+offset, len); return 1; }
int HAL_ICACHE_IsEnabled(void) { return 0; }
int HAL_ICACHE_Disable(void) { return 0; }
int HAL_ICACHE_Enable(void) { return 0; }
void HAL_ICACHE_Invalidate(void) {}
int HAL_FLASH_Unlock(void) { return 0; }
int HAL_FLASH_Lock(void) { return 0; }
int HAL_FLASHEx_Erase(void *e, uint32_t *err) { *err = 0xFFFFFFFFu; return 0; }
int HAL_FLASH_Program(int type, uint32_t addr, uint32_t data) { return 0; }
void __HAL_FLASH_CLEAR_FLAG(uint32_t f) {}
static DRMS_CDCV2 test_cdc;
uint8_t test_cdc_wire[1054];
uint32_t test_cdc_length;
static int test_entropy(void *c,uint64_t *v) { (void)c; *v=123; return 1; }
static void test_cdc_send(void *c,const uint8_t *data,size_t length,uint32_t priority) {
 (void)c;(void)priority;memcpy(test_cdc_wire,data,length);test_cdc_length=(uint32_t)length; }
static int test_cdc_room(void *c,uint32_t priority) { (void)c;(void)priority;return 1; }
void test_cdc_init(void) {
 uint32_t uid[3]={1,2,3};test_cdc_length=0;
 drms_cdc_v2_init(&test_cdc,test_entropy,0,uid,test_cdc_send,test_cdc_room,0); }
void test_cdc_feed(const uint8_t *data,uint32_t length) {
 test_cdc_length=0;for(uint32_t i=0;i<length;++i) drms_cdc_v2_feed(&test_cdc,data[i],0); }
'''


class ApplicationTest(unittest.TestCase):
    @classmethod
    def setUpClass(cls):
        cls.tmp = tempfile.TemporaryDirectory()
        p = Path(cls.tmp.name)
        extra = r'''
#define LED_GREEN_GPIO_Port 0
#define LED_GREEN_Pin 8
#define LED_YELLOW_GPIO_Port 0
#define LED_YELLOW_Pin 9
#define LED_ORANGE_GPIO_Port 0
#define LED_ORANGE_Pin 10
#define LED_RED_GPIO_Port 0
#define LED_RED_Pin 11
#define ADS_DRDY_Pin 12
#define MEAS_BTN_Pin 13
#define MEAS_BTN_GPIO_Port 0
#define PWR_BTN_Pin 14
#define PWR_BTN_GPIO_Port 0
#define USB_VBUS_N_GPIO_Port 0
#define USB_VBUS_N_Pin 15
#define BQ_PG_GPIO_Port 0
#define BQ_PG_Pin 16
#define BQ_CHG_GPIO_Port 0
#define BQ_CHG_Pin 17
int HAL_GPIO_ReadPin(int,int);
#define SD_CD_GPIO_Port 0
#define SD_CD_Pin 18
typedef struct { unsigned int TypeErase, Banks, Page, NbPages; } FLASH_EraseInitTypeDef;
#define FLASH_TYPEERASE_PAGES 1
#define FLASH_BANK_2 2u
#define FLASH_PAGE_NB 64u
#define FLASH_TYPEPROGRAM_QUADWORD 2u
#define FLASH_FLAG_ALL_ERRORS 0u
int HAL_ICACHE_IsEnabled(void);
int HAL_ICACHE_Disable(void);
int HAL_ICACHE_Enable(void);
void HAL_ICACHE_Invalidate(void);
int HAL_FLASH_Unlock(void);
int HAL_FLASH_Lock(void);
int HAL_FLASHEx_Erase(void *e, uint32_t *err);
int HAL_FLASH_Program(int type, uint32_t addr, uint32_t data);
void __HAL_FLASH_CLEAR_FLAG(uint32_t f);
#define FLASH_FLAG_ALL_ERRORS 0u
#define __alignas(x)
#define __get_PRIMASK() 0U
#define __disable_irq() ((void)0)
#define __set_PRIMASK(x) ((void)(x))
uint32_t HAL_GetUIDw0(void);
uint32_t HAL_GetUIDw1(void);
uint32_t HAL_GetUIDw2(void);
'''
        (p / 'main.h').write_text('#ifndef APP_MAIN_H\n#define APP_MAIN_H\n'
                                  + ACQ_HEADER + extra + '\n#endif\n')
        (p / 'spi.h').write_text('#include "main.h"')
        fxh = FX_HEADER.replace(
            'typedef struct { int unused; } FX_MEDIA;',
            'typedef struct { unsigned int fx_media_driver_request;\n'
            '    unsigned int fx_media_driver_logical_sector;\n'
            '    unsigned int fx_media_driver_sectors;\n'
            '    void *fx_media_driver_buffer;\n'
            '    unsigned int fx_media_driver_status;\n'
            '    unsigned int fx_media_total_sectors;\n'
            '    unsigned int fx_media_hidden_sectors; } FX_MEDIA;')
        fxh = fxh.replace('#define FX_IO_ERROR 1',
            '#define FX_IO_ERROR 1\n'
            '#define FX_DRIVER_UNINIT 9\n#define FX_DRIVER_INIT 4\n'
            '#define FX_NULL 0\n'
            '#define FX_SD_VOLUME_NAME "SD"\n'
            'UINT fx_media_open(FX_MEDIA *, const char *, void (*)(FX_MEDIA *), void *, void *, unsigned long);')
        fxh = fxh.replace('UINT fx_media_flush(FX_MEDIA *);',
            'UINT fx_media_flush(FX_MEDIA *);\n'
            'UINT fx_media_close(FX_MEDIA *);\n'
            'UINT fx_media_abort(FX_MEDIA *);\n'
            'void fx_stm32_sd_driver(FX_MEDIA *);\n'
            '#define FX_DRIVER_READ 2')
        (p / 'app_filex.h').write_text('#ifndef TEST_FX_H\n#define TEST_FX_H\n' + fxh + '\n#endif\n')
        (p / 'tx_api.h').write_text(TX_HEADER)
        fx = FX_MOCK.replace('volatile uint32_t drms_acq_overruns,drms_acq_queue_drops;', '')
        fx = fx.replace('uint32_t drms_msc_blocks_recording(void) { return mock_msc_blocked; }', '')
        fx = fx.replace('uint32_t HAL_GetTick(void) { return ticks; }', '')
        fx = fx.replace('ticks;', 'unused_log_ticks;')
        fx += '\n/* SD 驱动替身：UNINIT 计数，读请求按卡状态返回 */\n'
        fx += 'unsigned int sd_uninits;\n'
        fx += 'uint32_t fx_sd_media_memory[128];\n'
        fx += 'FX_MEDIA sdio_disk;\n'
        fx += 'unsigned int fx_flushes, fx_closes, fx_abort_calls, fx_open_result;\n'
        fx += 'UINT fx_media_close(FX_MEDIA *m) { ++fx_closes; return 0; }\n'
        fx += 'UINT fx_media_abort(FX_MEDIA *m) { ++fx_abort_calls; return 0; }\n'
        fx += 'UINT fx_media_open(FX_MEDIA *m, const char *n, void (*f)(FX_MEDIA *), void *d, void *b, unsigned long z) { m->fx_media_total_sectors = 64; return 0; }\n'
        fx += 'void fx_stm32_sd_driver(FX_MEDIA *m) { if (m->fx_media_driver_request==9) ++sd_uninits; if (m->fx_media_driver_request==4) m->fx_media_driver_status=0; }\n'
        # storage.c 已真编译：剥离 mock 中的介质状态定义（保留计数器）
        fx = fx.replace('volatile unsigned int drms_storage_mounted=1,drms_storage_status;\n',
                        'extern volatile unsigned int drms_storage_mounted,drms_storage_status;\n')
        fx = fx.replace('void drms_storage_invalidate(void) { ++invalidates;drms_storage_mounted=0;drms_log_removed(); }',
                        '')  # 真实 storage.c 提供定义；计数器归集成测试
        mock = ACQ_MOCK.replace('pins[8]', 'pins[16]')
        mock = mock.replace('int HAL_SPI_Abort(SPI_HandleTypeDef *s) { return 0; }',
                            'int abort_failure; int HAL_SPI_Abort(SPI_HandleTypeDef *s) { return abort_failure; }')
        (p / 'mock.c').write_text(mock + fx + CAL_MOCK + APP_MOCK)
        src = ROOT / 'firmware/DE-DRMS-Code/Core'
        names = ('application', 'command', 'acquisition', 'measurement', 'fifo', 'logging',
                 'log_codec', 'calibration_codec', 'calibration_journal', 'time_codec', 'power',
                 'control', 'record_session', 'monitor', 'filter', 'classifier', 'baseline', 'capture_time',
                 'user_config', 'config_snapshot', 'file_service', 'msc', 'storage')
        command = ['cc', '-shared', '-fPIC', '-Wall', '-Werror=implicit-function-declaration',
                        '-I', str(p), '-I', str(src / 'Inc'), '-I', str(src.parent / 'App/interfaces/cdc'),
                        *[str((src.parent / 'App/application/measurement' if name in ('monitor', 'filter', 'classifier', 'baseline') else src / 'Src') / f'drms_{name}.c') for name in names],
                        str(src.parent / 'App/interfaces/local_ui/drms_button.c'),
                        str(src.parent / 'App/interfaces/cdc/drms_config_wire.c'),
                        str(src.parent / 'App/interfaces/cdc/drms_cdc_frame.c'),
                        str(src.parent / 'App/interfaces/cdc/drms_cdc_v2.c'),
                        str(p / 'mock.c'), '-lm']
        subprocess.run(command + ['-o', str(p / 'app.so')], check=True)
        subprocess.run(command + ['-DDRMS_LOG_SEGMENT_RECORDS=2', '-o', str(p / 'app-segments.so')], check=True)
        cls.instance = 0

    @classmethod
    def tearDownClass(cls):
        cls.tmp.cleanup()

    def setUp(self):
        type(self).instance += 1
        p = Path(self.tmp.name)
        target = p / f'app-{self.instance}.so'
        shutil.copyfile(p / 'app.so', target)
        self.lib = ctypes.CDLL(str(target))
        self.lib.drms_console_dispatch.argtypes = [ctypes.c_char_p]
        self.lib.drms_application_status.argtypes = [ctypes.c_void_p, ctypes.c_size_t]
        self.lib.drms_application_status.restype = ctypes.c_size_t
        self.lib.reset_flash()
        self.lib.drms_log_init()
        self.lib.drms_file_service_init()
        self.lib.drms_application_init()

    def value(self, name):
        return ctypes.c_uint32.in_dll(self.lib, name)

    def insert_card(self):
        ctypes.c_int.in_dll(self.lib, 'sd_card_present').value = 1
        self.lib.drms_storage_poll()
        self.assertEqual(self.value('drms_storage_mounted').value, 1)

    def test_msc_export_retains_tf_lease_until_release(self):
        self.insert_card()
        request = ControlRequest(source=3, request_id=42, operation=2)
        self.assertEqual(self.lib.drms_control_submit(ctypes.byref(request)), 1)
        self.lib.drms_application_poll()
        self.assertEqual(self.lib.drms_msc_owner(), 1)
        self.lib.drms_msc_service()
        self.lib.drms_application_poll()
        self.assertEqual(self.lib.drms_msc_owner(), 2)
        token = Token()
        self.assertEqual(self.lib.drms_control_reserve(4, ctypes.byref(token)), 2)
        release = ControlRequest(source=3, request_id=43, operation=9)
        release_id = ctypes.c_uint64()
        self.lib.drms_control_submit_identified.argtypes = [ctypes.POINTER(ControlRequest), ctypes.POINTER(ctypes.c_uint64)]
        self.assertEqual(self.lib.drms_control_submit_identified(ctypes.byref(release), ctypes.byref(release_id)), 1)
        self.lib.drms_application_poll()
        self.assertEqual(self.lib.drms_msc_owner(), 3)
        self.lib.drms_msc_service()
        self.lib.drms_application_poll()
        self.assertEqual(self.lib.drms_control_reserve(4, ctypes.byref(token)), 1)
        self.lib.drms_control_complete(token, 0, 4)

    def test_download_open_retains_tf_lease_until_disconnect_cleanup(self):
        self.insert_card()
        generation = self.lib.drms_storage_media_generation()
        request = ControlRequest(source=3, session=4, request_id=42, operation=3,
                                 value=42, expected_version=generation)
        op = ctypes.c_uint64()
        self.lib.drms_control_submit_identified.argtypes = [ctypes.POINTER(ControlRequest), ctypes.POINTER(ctypes.c_uint64)]
        self.assertEqual(self.lib.drms_control_submit_identified(ctypes.byref(request), ctypes.byref(op)), 1)
        self.lib.drms_application_poll()
        held = Token()
        self.assertEqual(self.lib.drms_control_reserve(4, ctypes.byref(held)), 2)
        self.lib.drms_file_service_poll()
        self.lib.drms_application_poll()
        view = FileView()
        self.lib.drms_application_file_snapshot.argtypes = [ctypes.POINTER(FileView)]
        self.assertEqual(self.lib.drms_application_file_snapshot(ctypes.byref(view)), 1)
        self.assertEqual((view.operation,view.size,view.session,view.generation,view.phase,view.result),
                         (op.value,123,4,generation,1,0))
        self.lib.drms_file_service_disconnect(4)
        self.assertEqual(self.lib.drms_control_reserve(4, ctypes.byref(held)), 2)
        self.lib.drms_file_service_poll()
        self.lib.drms_application_poll()
        self.assertEqual(self.lib.drms_control_reserve(4, ctypes.byref(held)), 1)
        self.lib.drms_control_complete(held, 0, 4)

    def test_file_list_uses_short_tf_lease_and_returns_worker_result(self):
        self.insert_card()
        generation = self.lib.drms_storage_media_generation()
        request = ControlRequest(source=3, session=4, operation=11, value=42, expected_version=generation)
        op=ctypes.c_uint64()
        self.lib.drms_control_submit_identified.argtypes=[ctypes.POINTER(ControlRequest),ctypes.POINTER(ctypes.c_uint64)]
        self.assertEqual(self.lib.drms_control_submit_identified(ctypes.byref(request),ctypes.byref(op)),1)
        self.lib.drms_application_poll()
        self.assertEqual(self.lib.drms_control_reserve(4,ctypes.byref(Token())),2)
        self.lib.drms_file_service_poll();self.lib.drms_application_poll()
        view=FileListView()
        self.lib.drms_application_file_list_snapshot.argtypes=[ctypes.POINTER(FileListView)]
        self.assertEqual(self.lib.drms_application_file_list_snapshot(ctypes.byref(view)),1)
        self.assertEqual((view.operation,view.file_id,view.size,view.next_cursor,view.phase,view.result),
                         (op.value,42,123,43,2,0))
        self.assertEqual(self.lib.drms_control_reserve(4,ctypes.byref(Token())),1)

    def test_download_failed_cleanup_quarantines_tf_resource(self):
        from test_control_contract import Snapshot
        self.insert_card()
        generation = self.lib.drms_storage_media_generation()
        request = ControlRequest(source=3, session=4, operation=3, value=42, expected_version=generation)
        self.assertEqual(self.lib.drms_control_submit(ctypes.byref(request)), 1)
        self.lib.drms_application_poll(); self.lib.drms_file_service_poll(); self.lib.drms_application_poll()
        ctypes.c_uint32.in_dll(self.lib, 'file_close_result').value = 10
        self.lib.drms_file_service_disconnect(4)
        self.lib.drms_file_service_poll(); self.lib.drms_application_poll()
        snapshot = Snapshot()
        self.lib.drms_control_get_snapshot(ctypes.byref(snapshot))
        self.assertEqual(snapshot.quarantined_mask & 4, 4)
        self.assertEqual(self.lib.drms_control_reserve(4, ctypes.byref(Token())), 2)

    def test_download_close_releases_lease_only_after_worker_finishes(self):
        self.insert_card()
        generation = self.lib.drms_storage_media_generation()
        req = ControlRequest(source=3, session=4, operation=3, value=42, expected_version=generation)
        op=ctypes.c_uint64()
        self.lib.drms_control_submit_identified.argtypes=[ctypes.POINTER(ControlRequest),ctypes.POINTER(ctypes.c_uint64)]
        self.assertEqual(self.lib.drms_control_submit_identified(ctypes.byref(req),ctypes.byref(op)),1)
        self.lib.drms_application_poll(); self.lib.drms_file_service_poll(); self.lib.drms_application_poll()
        self.lib.drms_application_file_close.argtypes=[ctypes.c_uint32,ctypes.c_uint64]
        self.assertEqual(self.lib.drms_application_file_close(5,op.value),4)
        self.assertEqual(self.lib.drms_application_file_close(4,op.value),1)
        self.assertEqual(self.lib.drms_control_reserve(4,ctypes.byref(Token())),2)
        self.lib.drms_file_service_poll(); self.lib.drms_application_poll()
        self.assertEqual(self.lib.drms_control_reserve(4,ctypes.byref(Token())),1)

    def test_download_read_failure_is_not_reported_as_success(self):
        from test_file_service import Request, Reply
        self.insert_card()
        generation = self.lib.drms_storage_media_generation()
        request = ControlRequest(source=3, session=4, operation=3, value=42, expected_version=generation)
        self.assertEqual(self.lib.drms_control_submit(ctypes.byref(request)),1)
        self.lib.drms_application_poll(); self.lib.drms_file_service_poll(); self.lib.drms_application_poll()
        ctypes.c_uint32.in_dll(self.lib,'file_read_result').value=6
        item=Request(kind=3,session=4,generation=generation,count=1)
        ticket=ctypes.c_uint64()
        self.lib.drms_file_service_submit.argtypes=[ctypes.POINTER(Request),ctypes.POINTER(ctypes.c_uint64)]
        self.lib.drms_file_service_take.argtypes=[ctypes.c_uint64,ctypes.POINTER(Reply)]
        self.assertEqual(self.lib.drms_file_service_submit(ctypes.byref(item),ctypes.byref(ticket)),1)
        self.lib.drms_file_service_poll()
        reply=Reply(); self.assertEqual(self.lib.drms_file_service_take(ticket.value,ctypes.byref(reply)),0)
        self.assertEqual(reply.result,6)
        self.lib.drms_application_poll()
        view=FileView()
        self.assertEqual(self.lib.drms_application_file_snapshot(ctypes.byref(view)),1)
        self.assertEqual((view.phase,view.result),(2,6))
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
