chenxi-z/de-drms/test/test_acquisition.py

"""ADS131A02 register/frame emulator around the real acquisition/DMA code."""
import ctypes
from pathlib import Path
import subprocess
import tempfile
import unittest

ROOT = Path(__file__).resolve().parents[1]
HEADER = r'''
#ifndef MOCK_ACQ_H
#define MOCK_ACQ_H
#include <stdint.h>
#include <stddef.h>
typedef int HAL_StatusTypeDef;
/* The acquisition fast path programs the GPDMA channels and SPI registers
 * directly, so the stub has to model them: a DMA channel register block the
 * code can read and write, plus SPI registers with real bit positions so the
 * enable/CSTART/IFCR bookkeeping behaves like silicon. */
/* CSAR/CDAR hold addresses; on the 64-bit host used by the tests they must be
 * pointer-sized or the arming step truncates them and the mock crashes. */
/* CSAR/CDAR hold addresses; the target is 32-bit but this host is 64-bit, so
 * they are pointer-sized here or the armed buffer address is truncated. */
/* The target is 32-bit and the firmware stores addresses as uint32_t, so this
 * host cannot recover a pointer from the register value. The stub keeps a small
 * registry mapping the truncated value back to the real buffer. */
#define DMA_ADDR_SLOTS 8
typedef struct { volatile uint32_t CCR,CBR1,CSAR,CDAR,CSR,CFCR; } DMA_Channel_TypeDef;
extern uint8_t *dma_addr_map[DMA_ADDR_SLOTS];
static inline uint8_t *dma_addr_lookup(uint32_t v) {
  for (int i = 0; i < DMA_ADDR_SLOTS; ++i)
    if (dma_addr_map[i] && (uint32_t)(uintptr_t)dma_addr_map[i] == v) return dma_addr_map[i];
  return (uint8_t *)0;
}
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
