chenxi-z/de-drms/(commit log)

2026-10-10 chore: 初始化 DE-DRMS 工作区骨架
    双电极直流表面电阻测试仪研发工作区的目录骨架与仓库约定。
    - 建立上位机/下位机/硬件/结构/文档/校准/测试/生产/工具目录划分
    - hosts 目录更名为 host，与 firmware 形成对照
    - 新增 .gitignore：忽略固件产物、EDA/3D 输出、编辑器与系统临时文件
    - 新增 .gitattributes：文本统一 LF，Windows 脚本 CRLF，二进制禁止转换
    - 新增 .editorconfig：约束缩进、编码与行尾
    - 新增 README.md：说明目录职责、开发约定与待确认事项
    - 空目录以 .gitkeep 占位共 13 处
2026-10-10 docs(design): 双电极直流电阻测量仪 V2.0 设计草案
    V1.0 全面修订。测量对象从 0–10 Ω/cm² 静态表面电阻
    变更为 100 Ω–500 kΩ、<5 ms 单向瞬变过程记录。
    核心架构变更：
    - 激励 10 µA，采样率 ≥100 kSPS，V/I 同步采样
    - ADC 由 ΣΔ(ADS1220) 改为 SAR(AD4003/AD7942)，放弃跳档
    - 并联双通道(×1/×32)取代 PGA 换档
    - 电源反推为 9V+5V+3.3V 三轨，形态后议
    - 运放/开关耐压升级：MCP6001→OPA192, TS5A→TMUX61xx
    状态：草案，待评审。
2026-10-10 docs(design): 修订至 V2.1——落实测量对象为 MWCNTs 传感层
    根据用户提供的力—位移—ΔR/R₀ 试验曲线（图5.4）确认：
    - R₀ ~10 kΩ（非 100 Ω），变化 50×（非 5000×），上限 500 kΩ
    - 双工况：分钟级慢速拉伸 + <5 ms 快速断裂
    - 不采试验机力/位移信号，事后对齐
    架构修正：
    - 单窗口高速 → 双速率采集（抽取低速流 + 触发高速段）
    - 通道 B（×32 前置）由必须降级为可选
    - 数据吞吐重新核算（900 kB/s），MCU 需求上调至 STM32G4/H5/F7 级
    - 新增开路/超量程判定、USB 高速或抽取+触发策略
    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
2026-10-10 docs(design): 修订至 V2.2——依据论文实测参数重构
    依据文杰学位论文《基于多壁碳纳米管的紫外光/热双固化
    修复材料的力学及传感性能研究》落实参数：
    - 动态范围 50×→120×（ΔR/R₀=121.64，指数增长）
    - R₀ 固定10kΩ→几kΩ~200kΩ宽范围（几何放大+客户爆炸件）
    - 阶段I亚%分辨(0.5%)升为设计重心
    - 新增温度补偿：论文温度系数-4~-10%/℃远大于机械信号0.5%
    - 采样率≥100kSPS→10~1000SPS（论文用万用表，无高速瞬态）
    - ADC由SAR(AD4003)回归ΣΔ 24bit(ADS124S08)
    - 激励固定10µA→1µA~1mA自动选档
    - 废弃：双速率采集、5ms高速、通道B
    爆炸试验线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
2026-10-10 docs(design): 新增 V3.0 通用信号链方案，V2.2 挂起为其中一种配置
    需求存在多个冲突且未证实的版本（论文无绝对电阻、客户爆炸
    试验口头200kΩ、单位歧义致R₀估算差10倍），在确认前不锁定
    单一参数，改为可重构信号链：
    - 激励/增益/采样率全可编程：1µA–10mA、×1–×128、10SPS–100kSPS
    - 覆盖 R₀ 10Ω–1MΩ（5个数量级），ΔR/R₀≥100×
    - 宽带24bit ADC（ADS1262/3）兼顾准静态与较快瞬态
    - 双速率引擎：低速高分辨(论文SHM) / 高速触发(瞬态爆炸)
    - 温度传感+低漏电保护+电极根部取样
    - 全情形覆盖矩阵：一套硬件改配置覆盖全部设想情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
2026-10-11 docs(design): V3.0 信号链新增附录D——结构损伤分级监测仪配置
    客户2026-10-10确认需求，V3.0 下首个需求明确的落地配置：
    - R₀ 10-20kΩ（编程可设/每次实测），上限60-120kΩ（30mm时R/R₀≈6×）
    - 精度 R₀ 的 1%（10kΩ即100Ω）
    - 四档判定（绿/黄/橙/红），分档阈值留空待定
    - 判断基准用 R/R₀ 无量纲比值（解决个体离散）
    - 确认加温度传感
    配置推导：激励10µA固定、PGA×2-×4、ADS1220降级替代ADS1262、
    采样10-50SPS、无需动态切换/高压轨。
    关键结论：除温度外各项富余，温度补偿是达1%精度的决定性环节
    （材料温度系数-4~-10%/℃远超1%指标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
2026-10-11 docs(design): 附录D收敛——恒流测电阻拓扑 + ADC定ADS127L11
    被测对象确认为论文式两端MWCNTs传感层（导电银胶+铜电极电阻条），
    物理上无法成桥，故拓扑定为恒流测电阻、不做电桥：
    - 激励：外部OPA192+MOS恒流源（保留实测电流代入思想，不用ADC内置IDAC）
    - ADC定ADS127L11：24bit全差分、400kSPS宽带/1.067MSPS低延迟、
    5V模拟/3.3V数字直连、内置输入+基准缓冲、INL 0.9ppm
    - 采样率从10-50SPS升至最高400kSPS/1.067MSPS可设（双滤波模式）
    - 滤波约束：动态用低延迟无拖尾，静态用宽带+数字平均
2026-10-11 docs(design): 新增附录E——原理图方案（电源/恒流源/自校准/前端定稿）
    E.1 电源✅：1S锂电可充电、TP4056/BQ24040充电管理、双LDO
    (数字3.3V+模拟3.3V低噪LDO TPS7A)、数模天然隔离
    E.2 恒流源✅：OPA333/OPA388零漂运放(1S锂电下替代OPA192)、
    BSS138、10µA单档、Rsense 0.1%精密、VSET基准分压0.1V
    E.3 自校准✅：0.1% Rsense打底 + 板上R_ref标准电阻自检，
    校准Rsense+ADC综合系数(非恒流源电流)，存EEPROM
    E.4 前端✅：全差分进ADS127L11、抗混叠RC保留高速(fc~80kHz)、
    V/I复用采集、输入保护双线(BAV199默认/ESD阵列备选)、
    基准双线(REF5025默认/REF3025经济/REF602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
2026-10-12 docs(design): ADC定稿ADS131A02双通道同步实测，备选ADS131M02挂起
    主方案（附录E.4）：恒流源激励 + 跟随器 + ADS131A02双通道同步采样
    - 两通道同一时钟沿转换，恒流波动在除法中彻底抵消
    - ADS131A02：模拟3.0-5.5V、数字3.3V直连、内部1.2V基准6ppm/℃、
    SNR115.2dB、128kSPS、负电荷泵
    - 软件 R=(V_sample/V_Rsense)×Rsense，基准误差抵消
    - 每通道跟随器（OPA388/OPA320）驱动ADC
    备选（附录F单独文件）：ADS131M02挂起（高输入阻抗可省跟随器、
    最便宜.66、用户用过）；附完整选型决策链、被否决方案记录
    （ADS127L11比例式基准电流致命、分压激励不稳定等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
2026-10-12 docs(design): MCU定版STM32U575RGT6，并修正附录D/E数值不一致
    MCU 定版（附录E.5 + 新增 mcu-selection/README.md）：
    - STM32U575RGT6：M33 160MHz、1MB Flash、786KB SRAM、USB OTG FS、
    LQFP-64(10x10)、Shutdown 160nA（规格源自 ST 数据手册核实）
    - 立创 C5270980 ¥35.16、库存 64（低于用户参考的¥44+，采购前需复核）
    - 理由：786KB SRAM 满足大内存（G431仅32KB）、U5旗舰低功耗、
    USB OTG、库存可用；G4的内置模拟外设对本设计冗余
    - 记录 pin2pin 结论：U5与G4无官方兼容对（pin21 VCAP vs VDDA 致命冲突），
    故按单一型号定版
    修正附录 D/E 中我此前改ADC时留下的不一致：
    - D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
2026-10-12 docs: 建立设计文档索引，修正根 README 过时状态
    新增 docs/design/README.md 作为文档入口：
    - 明确权威性规则：主文档=通用信号链V3.0，硬件以附录E为准，
    附录D为需求来源；更早版本仅作决策历史
    - 被测对象与目标结论（两端MWCNTs传感层、R₀ 10-20kΩ、
    上限120kΩ、精度R₀的1%、四级分档、温度补偿必须）
    - 已定稿硬件决策汇总表（拓扑/激励/ADC/MCU/电源/温度/通信）
    - 关键决策与理由，含被否方案（电桥、比例式、分压激励、pin2pin）
    - 图的状态：frontend-ads131a02-final 有效，两张 ratiometric 已取代
    - 未决事项 7 条 + 外部资料（TI参数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
2026-10-12 docs: 新增交接提示词 HANDOFF.md，补推 STM32U575 手册并修正文档不实
    HANDOFF.md 含两条线的交接提示词：
    - 设计线：项目背景、已定稿选型、硬约束、被否方案、下一步、
    需外部输入的项、工作约定（含'规格必须查手册'的教训）
    - 归档线：Obsidian 库结构、本次新入库 10 份手册的清单与分类、
    ads131m02.pdf 双版本保留大文件等注意事项
    另：mcu-selection/README.md 原称 STM32U575.pdf 已推送 Obsidian，
    实为当时只推了 U545，U575 是在之后定版时才下载的——已将
    STM32U575.pdf（STM32U575xx，346 页，校验和一致）补推进
    Obsidian datasheets/，该表述现已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
2026-10-12 docs: 新增 AGENTS.md 工作区代理说明
2026-10-12 docs(mcu-selection): 手册号补注型号对应，DS14217 属 U535 非 U575
    §4 原以裸列编号引用手册（DS14217/DS14216/DS12589/DS12288/DS13122），
    未标注归属，易被误读为定版型号 U575 的手册号。
    逐份核对 ST 官方 PDF 页脚后改为'型号: 手册号'写法：
    - STM32U535: DS14217（Rev 5） ← 原最易误读的一处
    - STM32U545: DS14216（Rev 4）
    - STM32G431: DS12589（Rev 2）
    - STM32G474: DS12288（Rev 4）
    - STM32G491: DS13122（Rev 3）
    并补注：定版 STM32U575xx 的手册号是 DS13737（Rev 10），与 U535 的
    DS14217 不同；U575 未参与该逐引脚比对。
    五个编号全部核实成功，故 §5 无需新增'待复核'项。
    未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
2026-10-12 docs(design): 硬件设计定版——E.3 自校准电路细化、E.6–E.9 引脚/时钟/电源域/交互定稿
    - E.3：R_ref 切换电路细化（顶端共用双线同切，TMUX1101×2+TMUX1102×2，
    R_ref 100 kΩ 0.01%），含时序、触发与误差核算；示意图为占位终稿
    - 新增 E.6 引脚分配表（LQFP-64 全表）、E.7 时钟树（MCU 免晶振 + ADC 自挂
    16.384 MHz）、E.8 电源域与电池管理（BQ24040+双 LDO、监测与阈值 3.65/3.50 V）、
    E.9 交互与连接器、E.10 挂起项清单；E.5.5 三项待办销号
    - 勘误三处：ADS131A02 内部基准实为 2.442 V（原文 1.2 V 有误，同步 adc-selection
    与 AGENTS.md、frontend 图）；"电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
2026-10-12 docs(diagram): 恒流源运放正名 OPA333（原误标 OPA388），补 PC5/PB2 控制脚
2026-10-12 docs: AGENTS.md 补顶层目录/文件实测清单，新增「新文件先问用户」纪律
2026-10-12 chore(repo): 移除 adc_ds/ 手册副本，外部资料统一由 Obsidian 库管理（同步 AGENTS.md）
2026-10-12 chore(repo): 参数筛选表移入 Obsidian、移除两张已否决旧图（同步文档引用）
2026-10-12 chore(repo): 加预提交守卫（外部资料/大文件不入库）+ 入库约定与历史瘦身记录
2026-10-12 docs(design): 索引与定版对齐——4 颗 OPA388 跟随器、OPA333 标注待批（E.10#2）
2026-10-12 docs(design): E.10#1 定稿——VSET 360k/200k 分压 + BSS138 关断，信号正名 CURR_DIS（新增 E.2.1）
2026-10-12 docs(design): E.10#2–#5 定稿——运放落定 OPA333、BQ24040 TS 10kΩ、抗混叠 RC 1k+10nF、LED/按键参数
2026-10-12 docs(diagram): 前端图与定版对齐——跟随器 OPA388×2（去 OPA320 歧义）、通道脚名 AIN0P/N 与 AIN1P/N
2026-10-12 docs(design): E.10#6 收敛——设计侧规格/候选料号定稿，价格库存交由用户核实
2026-10-12 docs(design): 双 LDO 统一 TPS7A2033（SGM2210 因常开轨 36 µA 静态电流落选）；E.8.2 补 Iq 列
2026-10-12 docs(design): 换料后残留数值同步——E.8.3 压差 24 mV、VIN/UVLO/EN 改 TPS7A2033 手册值
2026-10-12 docs(design): 双 LDO 定案 B——数字 TPS7A0233（25 nA 常开）+ 模拟 TPS7A2033（7 µVrms，EN 受控）
2026-10-12 test(hardware): 恒流源拓扑 LTspice 定案——Rsense 移入源极路径，证伪漏极路径画法
    - 新增 hardware/sim/ccsource/：源极采样 vs 漏极路径两拓扑对比仿真；
    源极采样全 R 范围 I=7.857µA 恒定、VDS 裕量≥1.18V；漏极路径环路正反馈、
    锁死零电流（证伪）。CURR_DIS 暂态：关断 <0.2ms、残流 2% FS；
    使能建立 0.871ms（±0.1%，E.3.3 的 1ms 预算内）
    - 勘误 E.2 拓扑接法、E.3.1 电流回线/测量线（节点名对齐审查结论：
    B=BSS138 源极=Rsense 顶、E=Rsense 底=GND）、E.4 取样 AIN1P/AIN1N；
    销号 E.10#10（并发审查新增），#8 跟随器轨压余量/#9 ADC 失调仍待定案
    -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
2026-10-13 fix(design): 前端轨压余量 + ADC 失调校准 + 拓扑统一（2026-10-13 审查三项阻塞）
    - E.2/E.3.1：T 点加顶端偏置 R_top 10kΩ / R_b 150kΩ，跟随器 4→3 颗（AIN1N 直接经 RC）
    - E.3.2-E.3.4：新增零点模式（K1/K2 分控：SEL_K1=PC5、SEL_K2=PC3），消 ADC 失调 δ0
    - E.3.1 勘误：Rsense 在源极路径（B=Rsense 顶），漏极路径画法为正反馈（LTspice 证伪）
    - E.4/E.6/E.8：同步引脚、缓冲、合规电压（参考 T 点 ≥2.97V 而非 3.3V_A 轨）
    - E.10：#8-#10 销号（轨压余量 ≥0.199V、失调校准、拓扑统一）
    - 两张示意图重画：rref-calibration-circuit.svg（3 模式面板）、frontend-ads131a02-final.s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
2026-10-13 chore(docs): 删除 V2.2 旧设计文档（已被 V3.0 取代）
    - 移除 docs/design/2026-10-10-dual-electrode-dc-resistance-meter-design.md（268 行）
    - 更新 docs/design/README.md：阅读顺序去掉 ④，diagram/ 升为 ④
    - 删除"版本更早文档仅作决策历史"提示（已无旧版本保留）
2026-10-13 docs(design): 三张核心示意图定稿——整体方案框图、电源树、恒流源拓扑
    - 整体方案框图：五列正交布局（电源链 | MCU | ADC+TMP+USB | 模拟前端 | 样品）
    - 电源树：三列网格（电源链 | 双 LDO | 负载），全部正交连线
    - 恒流源拓扑：OPA333+BSS138 低边恒流源，Rsense 150 kΩ
    所有图通过 svg_schematic_check.py 门禁（XML 合法、无文字重叠/越界、
    无文字被线穿过、无缺字、marker 缩放正确、结点审计通过）
2026-10-13 docs(diagram): 示意图文件改中文名 + 索引同步
    - 整体方案框图.svg（原 system-block-diagram.svg）
    - 电源树.svg（原 power-tree.svg）
    - 恒流源拓扑.svg（原 constant-current-source.svg）
    - README.md §5 同步更新引用
2026-10-13 test(hardware): 恒流源性能指标六项仿真——PM 70°无需补偿，动态响应 µs 级
    cc2 套件（最新拓扑：R_top/R_b 顶端偏置 + K1 + 源极采样，行为级模型升级
    BSS138 电容与 OPA333 输入电容均按手册 typ）：
    - 负载调整率 1–130 kΩ：0.00000%（理想）
    - 电压调整率：电流 1:1 随轨（VSET 比例分压的设计特性，双通道同步采样
    下比值抵消，非精度误差项）
    - 环路增益：fc≈248 kHz、PM=70.1°、|T|@0.1Hz=123.7 dB——裕度充足，无需补偿
    - 电源纹波：ΔI/I=1/3.3 恒定至 10 kHz，与 ratiometric 理论精确吻合
    - 负载阶跃 10k↔120k（2µs）：峰值 ±3%、±0.1% 恢复 1.3 µs
    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
2026-10-13 feat(hardware): ccsource.asc——定稿恒流源 GUI 原理图（LTspice 可视化仿真）
    - gen_asc.py 程序化生成 .asc：引脚坐标/正交布线/T 接拆线全部显式计算，
    网表与 cc2_dc.net 逐节点一致（零 NC）
    - 仿真回归：I(Vsm)=+7.857 µA（与 cc2 套件吻合）、CURR_DIS 关断残流 0.163 µA、
    恢复 1.0 µs（±0.1%）；PULSE 5–10 ms 高电平，15 ms 窗口含完整关断+恢复
    - models.inc 新增 3 脚宏 opa333t3（LTspice opamp 符号引脚序为 invin/noninvin/out，
    宏极性按此对齐；内部固定 3.3 V 轨 + tanh 钳位）
    - 踩坑记录：导线穿过符号体=与该符号引脚相交即连接（x=288 竖线穿 R2 体导致
    R2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
2026-10-13 fix(hardware): ccsource.asc 可读性重排——横排标注、256px 列距、统一短接地
    - 去掉全部 VLeft 竖排 WINDOW（元件名/值恢复 LTspice 默认横排）
    - 列距 256px（V1/R1R2/M2VdisRg/R3R4/RsampRk1/M1Rsense），运放居中
    - 各接地改 48-64px 短脚 + 独立 GND 旗（去长地总线）
    - in+ 走线改走 x=240/x=880 通道，仅 1 处跨中交叉；X 标签归位 M1 漏极侧
    - 仿真回归：+7.8571 → 0.163（关断）→ +7.8570 µA（恢复）全部不变
    - 清理误入库的 ccsource_swap.net（生成物）
2026-10-13 fix(hardware): ccsource.asc 布局 v3——分区紧凑、反馈贴邻、零共线零交叉
    - M2/Vdis/Rg 关断支路归拢（Rg 移至 Vdis 右侧 y=688 分支，删底部绕行）
    - in+ 反馈改走 y=936 底部通道（零交叉）；in- 下行挪 x=1040 与 in+ 上升段
    x=1072 平行不共线（修复两输入 T 接短接）
    - B 反馈轨 y=864 直穿 Rsense.A 引脚（引脚在线上=合法连接），in- 到运放仅
    1 处跨中交叉
    - 接地统一 48px 短脚；网表零 NC；仿真回归 +7.8571/0.163/+7.8570 µA 不变
2026-10-13 docs(hardware): ccsource.asc 网名语义化+图例——回应审阅疑问标注
    - 网名对齐文档：SN→S（E.3.1 样品底节点）、TA→3V3A、VDIS→CURR_DIS（信号名）
    - 竖排标签挪到水平走线段：CURR_DIS/B/VG/X/VSET 共 5 处改横排
    - 图注新增：网名图例（3V3A/VSET/T/S/X/B/VG/CURR_DIS 各自含义）、
    Rg 栅极泄放作用（浮空复位安全=激励默认开）、in+/in- 反馈路径说明
2026-10-13 fix(hardware): VSET 标签归位 in+ 走线段（上一次挪动悬空）
2026-10-13 feat(hardware): ccsource.asc 布局 v4——按用户 GUI 排布规范化
    - M2/Vdis/Rg 关断支路顺 VSET 轨垂直下流（D 上接轨、G/S 下引），
    CURR_DIS 轨横向引出挂 Rg，消除原底部大绕行
    - Rsamp 转横放跨 T→S（用户样式），信号流 T→S→Rk1→X 轨→Vsm→M1
    - 整体压缩至 1936×960（原 2432×1320）；in+ 反馈通道 y=736 零交叉，
    B 反馈轨 y=656 直连 Rsense.A/M1.S
    - Vsm M90 放置 y 修正（416→432，M90 变换 y 不随 px 偏移）
    - 网表零 NC；仿真回归 +7.8571/0.163/+7.8570 µA
2026-10-13 fix(hardware): ccsource.asc 布局 v5——R3/R4 移至 M1 右侧竖列（按用户参考图）
    - T 偏置分压从右上角挪到 M1 右侧 x=1648 竖列（3V3A→R3→T→R4→GND 顺流）
    - T 节点与 Rsamp.B 用网名关联（无长走线），TA 轨缩短至 R1.A
    - 右上角清空；网表零 NC；仿真回归 +7.8571/0.163/+7.8570 µA 不变
2026-10-13 fix(hardware): ccsource.asc 布局 v6——T 横轨恢复可见、Rk1 对齐 Rsamp 正下方
    - T 轨恢复为可见走线：Rsamp.B(1120,272) 直拉 R3.B(1648,272)，
    从 Vsm/M1 符号体上方跨过（零交叉），连接关系肉眼可见（不再纯网名关联）
    - Rk1 列对齐 Rsamp.A 正下方（x=1200），消除 16px 错位台阶；
    S 标签随之居中
    - T 轨在 Rsamp.A 引脚处拆分为两端点（LTspice 规则：引脚须落在走线端点）
    - 修复一处被换行劈开的 WIRE 行；网表零 NC；
    仿真回归 +7.8571/0.163/+7.8570 µA
2026-10-13 fix(hardware): ccsource.asc 布局 v7——教科书信号流重排，无上行线零断点
    按用户约束整体重排：器件引脚不向上长距离引线（R1/R3 顶端直接贴 3V3A 轨），
    样品电流主干一条竖线自上而下 T→Rsamp→Rk1→Vsm→M1→Rsense，运放反馈走底部
    通道（in+ 沿 y=736 零交叉，in- 沿 y=688 经 M1.S 拆段端点接入），CURR_DIS
    支路挂 VSET 轨下顺流。
    新增自动化断点检查器逻辑（引脚须在走线端点/悬空 FLAG/对角线三项审计），
    本轮据此定位并修复：R4.B 接地脚漏画、Vsm 列错位（voltage 引脚 x 偏移=0）、
    M1.G 下行竖线漏画、S 标签悬空。
    网表零 NC；仿真回归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
2026-10-13 fix(hardware): ccsource.asc v8——运放区三通道平行重排，修复 in±T 接短接
    - U1 下移让出 Vdis 的 PULSE 文字带（文字不再压符号）
    - 反馈三通道平行：out y=704 / B 轨 y=736 / VSET 通道 y=768，各走各的
    - 修复第三个 LTspice 几何陷阱：in- 轨左端点落在 in+ 竖线中间=端点落线
    中间也是 T 接（两输入短接、电流异常 +14uA）——in- 下行改走 x=880 错开
    - 网表零 NC、in± 网分离专项审计通过；仿真回归 +7.8571/0.163/+7.8570 µA
2026-10-13 fix(hardware): ccsource.asc v9——运放输入改网络标签连接，删除全部反馈走线
    - in- pin 贴 flag B、in+ pin 贴 flag VSET（flag-on-pin 权威连接，
    probe5 实验已验证），删除 in± 全部走线（7 根）与绕行
    - B 节点标记保留在 M1.S drop 拆段处（y=736）
    - 运放区现仅一根出线（out->VG->M1 gate）
    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
2026-10-13 feat(hardware): ccsource.asc 布局 v10——用户 GUI 手工重排版（审查通过）
    - 用户在 LTspice GUI 手工重排：M2/Vdis/Rg 支路归拢 VSET 轨下、Rsamp 回归
    竖放、U1 移至底部居中、删去 B/X/VG 部分冗余标签
    - 审查结论：网表零 NC、拓扑正确、仿真回归 +7.8571/0.163/+7.8570 µA、
    M2.S 经 flag-on-pin 接地（审计器已补 flag-on-pin 判据）
    - 图例同步：删除已无标签的 X/B 两项，T 项补偏置电压说明
2026-10-13 docs(hardware): cc2 README 记录官方模型获取状态与人工路径
    行为级模型继续使用（手册典型参数，拓扑/DC 结论充分）；官方 OPA333/BSS138
    模型文件被各厂商下载保护阻挡（直链 403/加密/JS 渲染），记录全部已试路径
    与三条人工获取路径（TI/onsemi 官网点击下载或 SnapEDA），到手后两步接入
2026-10-13 feat(hardware): 接入 TI 官方 OPAx333 PSpice 宏（SBOC084G Final 1.3）
    - 官方 5 脚宏经 3 脚 wrapper 接入（内部固定 3.3V 轨），含真实
    Vos(-3uV+漂移)/Ib(70pA)/SR/Aol/PSRR/噪声/限流全套特性
    - 收敛方案：.ic 关键节点初值 + .tran uic（跳过病态 DC OP；
    TI 宏内部 1F 级建模电容在单电源高阻环路上 Direct Newton/Gmin/Source
    stepping 全部失败，uic 是官方宏在 LTspice 的可靠启动方式）
    - 仿真结果：I(Vsm)=+7.8562 uA（与理论 7.8571 差 0.9nA = 宏内建
    Vos/Ib 失调贡献，与 SBOS351 手册规格自洽）
    - models.inc 删除被取代的 3 脚行为宏；BSS138 官方模型仍缺（onsemi
    反爬），M1/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
2026-10-13 fix(hardware): 同步 gen_asc.py 指令块——.ic/.tran uic 入生成器
    上一提交只改了 .asc 未同步生成器，重生成后 .tran 指令丢失回退到病态 OP。
    现 .ic/.tran uic 已固化进 gen_asc.py；仿真回归 +7.8570 µA（官方宏）
2026-10-13 fix(hardware): ccsource.asc 指令块清理——修复多重替换叠加的坏行
2026-10-13 docs(hardware): ccsource 真实器件模型接入状态表（OPA333 官方宏/BSS138/TMUX）
2026-10-13 docs(hardware): 恒流源拓扑/运放选型评审结论——维持 OPA333 定稿；TI 官方宏在 LTspice 判不可用（DC 解非物理 +23uA）
    - 拓扑评审：Howland/专用恒流芯片/REF200/cascode/高边 PMOS 逐一排除，
    维持源极采样低边定稿
    - 运放评审：更快零漂无收益（恢复富余 3 个量级）、LPV821 记录为低功耗
    待验证候选（Iq 325nA 但 fc 降 8kHz）、非零漂劣
    - TI 官方 OPAx333 宏在 LTspice DC 解非物理（+23.3uA/V(b)=nan），判不可用，
    如需官方宏级验证用 PSpice for TI；cc3 官方宏测试网表与 OPAx333.LIB 入库
2026-10-13 docs(design): 信号链方案定版——恒流源终审封存 + 全链/极限/噪声仿真验证
    恒流源终审（2026-10-14 封存，四路证据收敛）：
    - OPA391 实测（cc4）：fc 564kHz/PM 60.8°，但使能建立 0.887→0.888ms
    无改善（瓶颈=栅极 1nF×M2 释放 RC，非 GBW）——维持 OPA333
    - Howland 深审修正否决理由：串流前提破坏/合规栈差/无使能
    （四电阻失配被比值抵消，原'失配直进误差'表述勘误）
    - REFEXT 外基准 ≥2.0V 下限（SBAS590E）：比例式三重出局
    - LM334 合规栈 3.1V、无 MOS 方案全否、LM7705 打不到本架构
    动态与冲击能力（cc5-cc11）：
    - 10ms 斜坡（用户实际场景）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
2026-10-14 docs(design): 手册复核勘误——SNR/INL/PSRR 三处误引更正 + ADC 必接脚补全 + E.10#11 缩窄
    逐项对 SBAS590E / DS13737 Rev 10 核实，修正上一轮定版中残留的规格误引：
    - SNR：原文"115.2 dB"手册查无此数（EC 表 115 dB 是 Dynamic range，条件
    AVDD−AVSS=5 V / VREF=4 V，不适用本配置）。改引 Table 1（3.3 V / 2.442 V /
    Gain=1）：119.5 dB @1 kSPS、85.1 dB @128 kSPS——动态范围随 OSR 变 34 dB，
    脱离 OSR 引单一数字会在高速工作点严重高估性能
    - INL：原文"~3–8 ppm FS"有误，DC PERFORMANCE 表实为 TYP 8 / MAX 20 ppm
    （把 TYP 当上限、3 ppm 查无出处）。折算按信号占 FS 比例反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
2026-10-14 docs(design): 五张示意图重画——日期更新至 2026-10-14 + 前端图补全 ADC 必接脚
    - frontend-ads131a02-final：右侧补全 RESV/CAP/NC(24)/NC(5-8)/AVDD/IOVDD/REFP/REFN/REFEXT/VNCP 必接脚标注
    - 整体方案框图：更新日期，ADC 框补动态范围 119.5 dB
    - 电源树/恒流源拓扑/rref 自校准：日期更新至 2026-10-14
    - 全部通过 svg_schematic_check.py 门禁（0 ERROR）
2026-10-14 docs(design): 新增引脚分配总表——MCU/ADC/连接器/信号网络四合一
    - MCU 引脚分配（E.6 定稿内容）+ 电源脚映射 + 预留脚
    - ADS131A02 信号引脚 + 必接脚（RESV/CAP/NC/AVDD/IOVDD/REFP/REFN/VNCP）
    - 连接器引脚（USB-C/被测件/调试口/TMP117/NTC 备选）
    - 信号网络汇总表（3.3V_D/A、T/S/M/B/E、VSET、CURR_DIS、ANA_EN）
2026-10-14 docs(design): MCU 定稿由 RGT6 改为 RET6Q（SMPS 版，同 LQFP-64 pin-to-pin 兼容）
    RET6Q 与 RGT6 同封装同引脚，仅内部电源架构不同（RET6Q 带 SMPS、RGT6 不带）。
    本设计用外部双 LDO 供电，MCU 内部 SMPS 未启用；两种型号可用同一 PCB。
    低功耗数据按 SMPS 版更新（DS13737 表 64/67/69 @3.3V）：
    Stop 3: 1.9 µA / 4.3 µA，Standby 0.21 µA，Shutdown 0.16 µA。
    同步更新：主文档 E.5.1/E.6、选型记录 v1.3、索引、交接提示词、引脚分配表、
    AGENTS.md、README.md、两张示意图（整体方案框图 + 前端图）。
2026-10-14 docs(design): MCU 定稿修正为 STM32U545RET6Q（512KB Flash / 274KB SRAM）
    用户确认定稿型号为 U545RET6Q（U545 系列 LQFP-64 SMPS 版），
    非此前误写的 U575RET6Q。U545 与 U575 同族同封装 pin-to-pin 兼容，
    区别在 Flash/SRAM 容量（512KB/274KB vs 1MB/786KB），本设计已足够。
    同步更新：主文档 E.5.1（规格/选型理由/手册号 DS14216）、E.6 引脚表、
    选型记录 v1.4（U545 从候选升为定版、U575 降为放弃）、索引、交接提示词、
    引脚分配表、AGENTS.md、README.md、四张示意图（整体框图/前端图/rref 图/电源树）。
    新增：firmware/DE-DRM/DE-DRM.ioc（CubeMX 工程文件，型号正确）。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
2026-10-14 feat(firmware): 完成 CubeMX IOC 全外设配置
    按设计文档 E.6-E.9 引脚分配配置全部外设：
    - SPI1 (PA5/6/7): ADS131A02, Mode 1 (CPOL=0/CPHA=1), 16 MHz
    - I2C1 (PB6/7): TMP117, Fast Mode
    - USB OTG FS (PA11/12 + VBUS PA9): Device 模式
    - USART2 (PA2/3): 调试日志 115200
    - ADC1 (PC0): 电池电压监测, 12-bit
    - GPIO 输出: ADC nCS/nRESET, TMUX 控制, 恒流源/模拟域 EN, LED×5
    - GPIO 输入/EXTI: ADC DRDY (EXTI4 下降沿), 按键×2 (WKUP1/4)
    - PWR: WKUP1 (PA0) + WKUP4 (PB1) 使能
    - NVIC: ADC1/EXTI4/SPI1/I2C1/USART2/USB 中断
    - 时钟: HSE 16MHz → PLL → SYSCLK 160 MHz, USB 48 MHz
2026-10-14 feat(firmware): IOC 添加 GPIO 标签名 + RTC 配置
    GPIO 标签：
    - PA0=MEAS_BTN, PA4=ADC_nCS, PA8=PWR_LED
    - PB0=ADC_nRESET, PB1=PWR_BTN, PB2=SEL_SENSE
    - PB4=ISET_HI, PB10=CURR_DIS
    - PC3=SEL_K2, PC6=LED_GREEN, PC7=LED_YELLOW
    - PC8=LED_ORANGE, PC9=LED_RED, PB8=TMP117_ALERT
    RTC 配置（LSE 32.768kHz 驱动）：
    - 24 小时格式，Binary 输出
    - 异步分频 127 + 同步分频 255 → 1 Hz 时基
2026-10-14 fix(firmware): 移除 TMP117 ALERT 引脚（PB8）
    外置 TMP117 探头为四线（VDD/GND/SCL/SDA），无 ALERT 线。
    PB8 释放为预留脚，同步更新设计文档引脚分配表。
2026-10-14 feat(firmware): IOC 补全 USB/USART/SPI/ADC/EXTI + 修复 PA0/PB1 黄灯
    补回被 CubeMX 重存时丢失的外设配置：
    - USB_OTG_FS: PA11/DM, PA12/DP, PA9/VBUS, Device 模式
    - USART2: PA2/PA3, 115200 异步
    - SPI1: 启用 IP，补 PA5/SCLK，Mode 1 (CPOL=0,CPHA=1), 16 MHz
    - ADC1: PC0/IN5, 12-bit, 47.5 cycles
    - EXTI4 (PC4 ADC_DRDY): 加内部上拉，避免悬空
    PA0/PB1 黄灯修复（GPIO_Pull-Up=ENABLE），加 PWR WKUP1/WKUP4 配置（PWR_WkUpPullUpPinE1/E4）。
    RTC 时钟源 LSE 显式声明，分频器键名改为 ASynchPrediv/SynchPrediv（CubeMX 标准格式）。
    PA1/PA15/PC13/PB8/PB9 等预留脚未启用，已从 Mcu.Pin 列表清除。
2026-10-14 revert(firmware): IOC 回滚到 cb91980 + 新增 CubeMX 配置清单
    IOC 回滚：手写的 SPI1/ADC1/USART2/USB_OTG_FS IP 块被 CubeMX 静默丢弃，
    证明 CubeMX 6.18 的 IOC 格式有内部"指纹"，不可靠。回滚到上一个能正常
    打开的版本（含 GPIO 标签、I2C1、RTC、SWD；不含我尝试加的外设）。
    新增 firmware/DE-DRM/CUBEMX_SETUP.md：完整 CubeMX GUI 操作清单，
    分 8 节（工程基础/时钟/外设/系统模块/GPIO/电源脚/生成代码后必查/排障）。
    逐项打勾即可把工程配齐到引脚零警告、可生成代码的状态。
    依据：主文档 E.6-E.9 + 引脚分配总表。
2026-10-14 docs(design): 新增 TF 记录子系统 E.11 + 引脚全表重排 + VBUS/BC1.2 两处失实勘误
    【新增】E.11 TF (micro SD) 卡数据记录：SDMMC1 4-bit（PC8-PC12 + PD2），
    CD=PB9、SD_PWR_EN=PB13 控制高边开关默认断电；否决 SPI 模式（250-500 KB/s
    < 768 KB/s 冲击采满需求）。E.5.4 存储改为两层：校准系数走 MCU Flash、
    测量数据走 TF 卡。
    【引脚重排】按「通信 AF 不动 + 辅助 GPIO 同端口聚堆」：
    ADC_nRESET PB0→PA8（凑成 PA4-PA8 连续 5 脚 ADC 簇）、PWR_LED PA8→PC7、
    SEL_K1 PC5→PB5、SEL_K2 PC3→PB8（TMUX 簇归 PB）、LED 簇改 PC2/3/5/6/7。
    原 SPI2 预留组消耗给 SDMMC（PT100 已否，预留本就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
2026-10-16 docs(diagram): 五张图按新 E.6 与手册值复核修正——引脚(PB15/PA9/PB5/PB8/LED簇/SD_CD)、恒流源参数(1.179V/7.86µA/Iq17µA/Rds3.8Ω)、新增 TF 卡与 3V3_SD 支路
2026-10-16 docs(diagram): 图名统一为中文（前端拓扑 / 自校准与零点电路）+ 版本日期戳更新至 2026-10-17
2026-10-16 docs(diagram): 合并前端拓扑+自校准为一张（模拟前端与自校准）；新增原理图施工级恒流源电路图（VSET 生成+OPA333引脚+BSS138+Rsense）；删已取代的恒流源拓扑
2026-10-16 docs(diagram): 恒流源电路图重画——VSET 节点移出器件边框、MOSFET 改规范符号(三段沟道+体箭号+D/S/G)、R_g 文字避让接地符号
2026-10-16 docs(diagram): 恒流源电路图重排重画——VSET节点移出边框、Q1/Q2统一为规范内联MOS符号(三段沟道+源体箭号+D/S/G)、运放注释拆行避让反馈线、修Q2源极接地符号平移遗漏
2026-10-16 docs(diagram): 恒流源电路图定点修——Q1/Q2 改标准 N-MOS 符号（三段沟道留隙+箭号移至源极引线指沟道）、U11 补 V+/V- 电源脚并让 -IN 反馈绕行三角形下方
2026-10-17 docs(diagram): 新增两电极四线制(Kelvin)接法图——4×SMA 分工/力线感线分离/两线四线误差对比/切换网络映射
2026-10-17 docs(diagram): 接线图重画为物理接线示意（板/端子/夹子/样品实体）+ 两线四线并排对比 + 板内连接表；4×SMA 改名 J5-J8 以避开已有 J1-J4
2026-10-17 docs(diagram): 模拟前端图补外部端子 J5-J8 插板（两线/四线兼容），接口块由 XH2.54-2P 改为 4×SMA
2026-10-17 docs(diagram): 模拟前端图把 J5-J8 直接标在样品两端（删掉外部端子插板与见下指引），补 T 结点与简短图例
2026-10-17 docs(diagram): 新增四线制前端接法图——J5=I+→T、J6=V+→OPA388(T)、J7=I−→K1/K2、J8=V−→K3/K4；含 Kelvin 汇合与 JP1/JP2 两线兼容
2026-10-17 chore: 换机前工作区快照——示意图索引/连接器(E.9+pin-assignment 4×SMA J5-J8)/前端文档同步，并含另一会话的 README、mcu-selection、CUBEMX_SETUP、DE-DRM.ioc 未完成改动
2026-10-18 docs(spec): 新增抗混叠与采集驱动子系统设计规格（跟随器输出→ADC输入）
    十维评分（D1-D10 短板制：DM/CM衰减@fMOD、@MCLK、通带平坦度@16kHz、
    建立时间、积分噪声、容差敏感度、CMRR@通带、Kickback回稳、群延迟平坦度），
    8条工程约束，M1-M7手册待核实项，V1-V9 LTspice复测清单（维度-仿真全覆盖），
    ADC采样开关模型构建规范，BOM可购性核查交付物，子代理分发说明。
    gitignore补LTspice产物规则（*.raw/*.op.raw/*.net）。
    信号规格：直流+单相正弦叠加，扫频上限16kHz（每周期8点@128kSPS），
    测相位（复阻抗谱）故D10为正式维度；测量范围按E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
2026-10-18 feat(sim): 抗混叠滤波器六轮仿真战役存档（hardware/sim/aaf）
    理论引擎（opt_engine.py：模态分解+MNA，与LTspice偏差≤0.2dB/~1.5%）、
    三轮探针+优化（opt_round4/snap_round4）、定稿验证（final_w10/verify_w9）、
    图纸生成器（gen_schematics.py：.asc+SVG+PNG三输出）、三候选方案
    （FIN1二级/V11四级/V10a六级）与完整README战役记录。
    仿真产物（.raw/.op.raw/.net）不入库。
2026-10-18 docs(diagram): TMUX1134前端图修正 + 新增抗混叠滤波电路示意图
    模拟前端与自校准.svg：K5/TMUX1134通道映射定稿（CH1 M/NO→V_N/NC→F、
    CH2 V_P↔T、CH3 S↔X、CH4 F↔X），真值表与通道映射面板，V_P跟随器重命名。
    抗混叠滤波电路.svg：新增（两级采样面板+频响表+图注自查）。
    两图均过 tools/svg_schematic_check.py 门禁。
2026-10-18 docs(spec): 抗混叠采集子系统实现计划（8任务+迭代回路）
2026-10-18 feat(sim): round5优化求解与三案冻结
2026-10-18 feat(sim): 方案C的V1-V9复测与十维实测（r5_results_C.json）
    - gen_netlists_r5.py：.net 直出（锁屏安全），V1-V9 全模板 + --rs 0/1 双口径
    - run_r5.py：LTspice -b -ascii 批处理，300s/个超时 + 锁屏探针
    - parse_r5.py：ASCII .raw 解析，D1-D10 提取 + 规格8同口径交叉验证
    - r5_results_C.json：C案实测（75 个仿真）
    C 案实测：D1 78.6 dB（差及格线 1.4）、D8 46.5 dB（差 33.5）→ min 分 0
    交叉验证通过（AC 最大偏 0.0004 dB、建立 0.07%）
2026-10-18 feat(sim): r5第2轮——真实模型口径重求解攻D8/D6
    口径纠正（第 1 轮遗留三处 bug）：
    - dim_scores()：D1/D2/D3/D5/D6/D8 误用 _lerp 线性插值，按 §5.1 改为
    min(x/满分,1) / min(满分/x,1)
    - power_mean(p=+8) 实际逼近 max，被当 min 用；改为负次幂 softmin(p=-32)
    - 噪声模型漏掉 sqrt(2)：单线 NTF 结果未折算到差分口径，被动项系统性偏低 41%
    源阻抗：从理想 0Ω / 引擎硬编码 1Ω 改为 OPA388 闭环输出阻抗复频表
    （TI 模型 1 mA 注入实测 700 点），并计入跟随器 G(f)=A_OL/(1+A_OL)。
    引擎与 LTspice V9a/V9b 对拍：D1/D2/D3/D4 最大偏差 0.35 dB，D6 偏差 0.14%。
    实测表保留了 1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
2026-10-19 docs(spec): v4修订——D6拆分为D6a/D6b、D8改R·C配对条件、评分口径改真实模型、新增C9 peaking约束、M1-M7核实回填
    用户裁决（2026-10-19）：D6选ab混合（无源增量硬指标≤10% + 总噪声软参考4.3LSB砖墙极限）、
    D8选R·C乘积异向配对（1%单体→110+dB）。物理依据：跟随器9.9nV/√Hz×16kHz通带
    ⇒ENBW≥14.3kHz⇒总噪声≥4.3LSB，1LSB阈值与D4冲突16.5倍不可达。
2026-10-19 feat(sim): r5第4轮——B案C9修复+D5极限环机理研判
2026-10-19 feat(sim): R5 四轮复测定档 B 案 + 抗混叠滤波电路定版图
    四轮迭代（deepseek-v4.1-flash 三路并行 + glm/qwen 双模型独立复核）：
    r1 三案复测全不及格→复核挖出口径错位（0Ω 理想源在 fMOD 偏差 16-22dB）；
    r2 引擎重写（修 dim_scores 插值/power_mean 方向/噪声√2 三 bug，源阻抗改真实
    OPA388 Zout 实测表），求解阶段停车：D6 物理不可达 16.5×（跟随器 9.9nV/√Hz ×
    16kHz 通带 ⇒ ENBW≥14.3kHz ⇒ ≥4.3LSB）；r3 规格 v4（用户裁决：D6 拆 D6a 无源
    增量/D6b 软参考、D8 改 R·C 乘积异向配对 1%单体→110+dB）+ 复核纠出 C 案 D8
    理想源冒充真实模型；r4 B 案定档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
2026-10-19 fix(diagram): 抗混叠定版图修五处视觉缺陷——res_h占位符bug致渲染器x=0穿框线、双白圆冗余、地符号斜搭、GND标签撞电容区、输出端子缺失
    门禁复跑 PASS + 分区目视复核（跟随器衔接/C7出口/顶母线三区）通过。
2026-10-19 docs(design): E.4 抗混叠定版 B 案——表格行更新 + 新增 E.4.4 扫频扩展与 R5 定档记录
    旧 1kΩ+10nF 方案标记作废（fc 15.9kHz 与 16kHz 扫频带重叠）；E.4.4 记录
    B 案参数/实测指标/R·C 配对工序/C9 修复/四轮迭代防重蹈要点。
2026-10-20 docs(design): 引脚分配 v3 重分配——PB5=BQ_TS 门控、PA10=ADC_DONE、HSE/LSE 定位扩展焊盘；回填 2026-10-20 网表终审（VNCP 反勘误 270nF、TF 卡区 TPS22917 定版、MCU 扇出缺口清单）
2026-10-20 docs(design): 引脚二次重排（就近原则）——ADC 簇收拢 PA1–PA7 物理连续（DONE=PA1/nRESET=PA2/DRDY=PA3·EXTI3）、调试口改 USART1(PA9/PA10·AF7) 与 SWD 同侧、J3 扩 8P、PA8 释放预留
2026-10-21 chore: gitignore 增补 .zcode/（会话元数据不入库）
2026-10-21 feat(sim): 采集页网表终审脚本与 B 案定版图入库——edacap 引脚/导线提取数据、网表重建与 B 案断言脚本、SCI 风格电路图
2026-10-21 feat(firmware): IOC 按引脚 v3 重配（CubeMX GUI）——新增 ADC1、移除 DAC1、GPIO 簇按新表重排；RCC 时钟源与 USART1 仍未配（E.10 #16 未清）
2026-10-21 docs: 引脚二次重排与抗混叠 B 案全局回填——消除旧值残留
    权威源：docs/design/pin-assignment.md（2026-10-20 v3 + 同日二次重排）、E.4.4（AAF B 案）
    引脚回填（旧 PA8/PA9/PA10 → PA1/PA2/PA3；LPUART1 → USART1）：
    - pin-assignment.md 自身：§2 ADS131A02 引脚表（DRDY/nRESET/DONE 三条仍是
    旧 PA9/PA8/PA10，与 §1.1 矛盾）+ §5 ADS_DONE(PA10→PA1)、USB 撤销注记
    - CUBEMX_SETUP.md：§2.2 LPUART1 整节改为 USART1(PA9/PA10, AF7)；§3.4 NVIC
    EXTI9_8→EXTI3、LPUART1→USART1；§4.1 ADC_nRESET PA8→PA2、PB5 SEL_K1→BQ_TS；
    §4.2 ADC_DRDY PA9→PA3、新增 PA1 ADC_DONE；§4.3 复用表；§4.4 不配置表
    - AGENTS.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
2026-10-21 refactor(pin): 通用 GPIO 三排——按 LQFP-64 封装物理就近聚簇
    用户反馈通用 GPIO 散在封装四边（最远 10↔61，隔半个封装）。按 CubeMX MCU XML
    逐脚核 LQFP-64 物理引脚序后重排；**通信/模拟/SDMMC/SWD/USB 簇全部不动**。
    重排结果（变体 B，用户选定）：
    - LED 5 灯 → 34–38 五连脚（PB13/PB14/PB15/PC6/PC7，2.5 mm；原跨左右两侧 13.5 mm）
    - TMUX/恒流控制 → 24–27 连续（PB0= SEL4、PB1、PB2、PB10；SEL4 由 PB8(61) 迁来）
    - SD_PWR_EN PB13 → PA8(41)，紧贴 SDMMC D0/D1 扇出
    - ANA_EN PB15 → PC3(11)，左侧模拟角（PC0/PC1 + PA1–PA7 同侧）
    - ISET_HI PB4 → PC2(10)，**消除 PB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
2026-10-21 docs(pin): 新增按封装物理序（1→64 脚）的完整分配表——PCB 布局首选视图
    pin-assignment.md 新增 §1.3：LQFP-64 逐脚 1→64 的完整表（IO + 电源 + 复位 +
    BOOT0），标注 ★ = 2026-10-21 三排改动的 14 个通用 GPIO，其余通信/模拟/SDMMC/
    SWD 簇全部未动。原 §1.3 电源脚顺延为 §1.4、§1.4 预留脚为 §1.5。
2026-10-21 fix(firmware): IOC 补 ADC 采样时间 68 周期 + 8 个 NVIC 中断 + SYS.Debug=SWO
    可自动修改项（用户已改完引脚部分后剩余）：
    - ADC1.SamplingTime-0: 5 → 68 Cycles（AGENTS 硬约束 VBAT/VBUS ≥64 周期；
    离散档仅 5/6/12/20/36/68/391/814，就近取大）
    - NVIC 补 8 个中断使能（沿用项目历史 9 字段格式）：
    EXTI15_10(pre4, SD_CD) / SDMMC1(pre4) / EXTI3(pre5, ADC_DRDY) /
    SPI1(pre6) / I2C1_EV+ER(pre7) / USART1(pre8) / ADC1(pre10)
    - SYS.Debug=Trace_Asynchronous_SW + Timebase=SysTick（SWO 才启用，J3-6 用）
    ⚠️ 未能在 CubeMX GUI 复存验证（无头模式 CLI 只加载不写盘），
    故 CUBEMX_SETUP 新增核对清单：首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
2026-10-21 feat(firmware): 建立 DE-DRM CubeMX 工程骨架（U545 + ThreadX + FileX + USBX CDC ACM）
    - MCU: STM32U545RET6Q (LQFP64 SMPS 版，外部双 LDO 供电)
    - RTOS: ThreadX (TX_APP_MEM_POOL_SIZE = 3 KB)
    - 文件系统: FileX (FX_SD_INTERFACE=1, GLUE_FUNCTIONS=DMA_API)
    - USB: USBX Device CDC ACM (VID=0483 PID=5740, EP IN=0x81/OUT=0x01/CMD=0x82)
    - 存储: SDMMC1 4-bit @ 48 MHz (片上 IDMA，不经 GPDMA)
    - 传感: SPI1 20 MHz Mode 1 (ADS131A02) + I2C1 400 kHz (TMP117)
    - 监测: ADC1 IN1(VBAT)/IN2(VBUS)/VREFINT(3 Rank)
    - 时钟: MSIS 16 MHz → PLL → 160 MHz；USB/SDMMC 用 HSI48 + CRS (USB SOF)
    - 中断: SDMMC=4 / EXTI15/3=5 / SPI1=6 / USB=7 / I2C1=8 / USART1=9 / ADC=10 / EXTI0/1=11
    - HAL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
2026-10-22 docs(power): 充电固定 500mA + BQ_PG/BQ_CHG 监测 + TS 简化 + SMPS 启用
    图纸核对后的文档同步（对应 EDA 图 2026-10-22 版）：
    - 充电电流固定 500 mA 档：删 ISET_HI 切 1A 链与 BC1.2 判 DCP 逻辑
    （R6=2k 挂 ISET1、ISET2 直连 GND）；PC2/PB5 改作 BQ_CHG/BQ_PG
    开漏监测输入（各 100k 上拉 VCC）
    - TS 简化：电芯选定带 NTC 引线版（25℃ 10k，经 CN4 3P 直连 TS）；
    原板载 NTC + 软件禁充链（Q1/R70/R13/BQ_TS）整链删除——
    并联方案经手册 TS 窗口 30%~70% VTTDM 验算否决
    - 引脚：PB5=BQ_PG、PC2=BQ_CHG；PB4/PB8 预留
    - SMPS 启用：IOC PWR.PowerMode=PWR_SMPS_SUPPLY（与图上 L1 2.2µH 一致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
2026-10-22 docs(rm0456): E.10 #16/#17 全清——IOC 时钟改 MSIS、SMPS 复位默认与 ADC 采样档查实
    - #16 销号：IOC PLL 源已改 MSIS（VCOInput=16 MHz → PLLRCLK=160 MHz），
    免晶振矛盾解除；SDMMCFreq=48 MHz（#14 顺带销号）
    - #17①② 作废：BC1.2 判 DCP 逻辑昨删、SMPS 已启用（PWR_SMPS_SUPPLY）
    - #17③ 查实（RM0456 §10.5.2）：复位后默认 LDO（范围 4），固件 REGSEL 切
    SMPS；切换前系统频率须先降至 110 MHz 以下
    - #17④ 查实（RM0456 §33 ADC12）：SMP[2:0] 8 档 = 5/6/12/20/36/68/391/814
    周期；对照判据 VBAT/VBUS 选 68 档、VREFINT 选 391 档；
    CubeMX 清单 47.5/247.5 Cycles 系误填
2026-10-22 docs(bom): 导出定稿 BOM——料号合并降 SMT 换料费
    - 100nF 两料号合一（22 颗统一 CC0603KRX7R9BB104）
    - 2k 改 2×1k 串联（ISET1/PRETERM），消 2k 料号
    - 10µF 改 2.2µF 并联（0805 X7R CL21B225KAFNNNE ×10），消 10µF 料号
    - AAF 信号链电容 C0G；R26=Rsense 150k 0.1%、R17=R_ref 100k 0.02%、
    R27/R28 VSET 0.1%；阻容料号 24→21，省 3 次换料费
2026-10-22 docs(bom): 阻容 0402 化 + 删 U1——BOM 定稿
    - 普通电阻 47 颗改 0402（1M/5.1k/1k/100k/33Ω/22Ω/4.7k，低频/直流路径）
    - 100nF×21 改 0402 X7R（CL05B104KB54PNC，Basic 件）
    - 删 U1（ESDA25P35 VBUS TVS）——VBUS 由 D16 肖特基 + BQ24040 VIN OVP 兜底
    - 精密/信号链位置保持大封装：Rsense/R30/R27/R28 0805 精密、
    R_ref 0805 0.02%、AAF 27n/12n 0805 C0G、68n 1206 C0G（0603 缺货）
    - 阻容料号维持 21 个
2026-10-24 docs(design): 选型/规格文档合一 + 示意图更新与脚本化
    - adc-selection/ 与 mcu-selection/ 两目录合并为 component-selection.md（内容原样保留）
    - spec/2026-10-18-aa-driver-design+plan 合一为 2026-10-18-aa-driver.md
    - 新增 spec/2026-10-23-signal-chain-variants.md（信号链变体）
    - diagram/ 八张图更新并新增归档版（一阶方案对比、k3b三级、旧版单档等）
    - 新增 diagram/_lib/：各示意图生成脚本（scistyle 统一样式）
    - .gitignore 增补仿真产物规则（*.db / *.runlog / **/*.op.raw，可由 gen_*.py 重跑再生）
    - README 索引与主文档链接同步
    （hardware/sim/ 下进行中的仿真变更按约定本次不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
2026-10-24 feat(hardware): 嘉立创EDA专业版原理图 V1.2 入库
    ProPrj_双电极电阻仪_2026-10-24_V1.2.epro2 —— 双电极电阻仪完整原理图工程
    （配套 BOM 已在库：hardware/BOM_Board1_Schematic1_2026-10-22.csv）。
    ---
    --no-verify 理由：文件 1.44 MiB 超过 1 MiB 守卫。该文件是嘉立创EDA专业版
    工程源文件（设计源件而非外部资料/手册），是硬件设计的单一事实来源，
    必须入库以便两台开发机与两个远端同步。V1.2 起按版本号滚动归档。
2026-10-24 docs(sim): 一阶RC四方案与六方案小封装 AAF 复核成果入库 + 仿真产物忽略规则
    入库内容：
    - 两份任务书：2026-10-23 一阶RC四方案复核、2026-10-24 小封装六方案复核
    - fo1_rc_review/（第一轮 T00–T12）：T00 基线回归六项锚定值全部复现
    （D1 -40.69/D2 -46.41/D3 -62.67/D4 0.223 dB、20.85µs、PM 98.57°）；
    四方案 D1–D3 全 FAIL 如实保留（一阶先天不足）；台架 run_all.py +
    fo_subs.inc（真实 OPAx388 宏 + Kelvin 接线）+ csv 证据 + REPORT/
    README/assumptions/bom_footprint_check
    - aaf_pkg_review/（第二轮 S0/S1/T1–T4）：推荐 T2（二阶 100+120Ω/10nF×2/
    820pF 全 0402），D2=61.05dB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
2026-10-24 fix: align DC prototype startup and design documentation
2026-10-24 docs(diagram): 新增二阶 T2 推荐方案示意图——100Ω+10nF→120Ω+10nF+Cd 820pF 全 0402
    - 拓扑：OPA388 跟随器 → R1→C_G1 → R2→C_G2 → ADS131A02，C_d 跨 AINxP/AINxN；
    每差分通道 9 件，两通道 18 件；CH1 AIN1N 为 Kelvin 无源 RC 直连（无跟随器）
    - 图内数据源 aaf_pkg_review/REPORT.md：D2 61.05dB 唯一跨线、D1 62.33/D3 94.74
    未过线如实标注、D4 0.412/A5 角 0.461、整线同 m 配对要求
    - svg_schematic_check.py PASS（重叠/穿线/缺字/结点 0 问题）；@2x.png 预览
2026-10-24 docs(hardware): V1.4 图纸入库 + 附录F/引脚表按实图对齐
    豁免说明：.epro2 为本项目自有设计工程（非外部资料/手册），1576KB 超 pre-commit
    1MiB 通用上限，按钩子提示 --no-verify 入库；同类 V1.2 工程已在库（1efa97a）。
    - 用户 V1.4 图纸（重编号）：R29 修正已落实为 R17=100kΩ 上拉 VCC（Q2 激励抑制），
    T2 18 件、USB NPN 检测、U8 换路、R33=PTFR0805Q100KN9（±0.01%/10ppm）齐备
    - F.5 SD_DAT0-3 上拉改文档为 10kΩ（用户决定不新增 47k 料）
    - Rref 精度冲突按 Q 档料号结案；R29/U10/R17 旧位号映射写入 V1.4 对齐记录
    - pin-assignment 同步 Q2/R17/U8 新位号
2026-10-25 docs(paper): 新颖性校准——SQ2 最近前作入库并收窄声明（第四轮 +4 条）
    - TI SBAA230（单级差分 RC 失配→CMRR 公式，app note）与 Hornero Ocaña 2021
    AEU（差分网络共模响应容差效应）确认为 SQ2 最接近前作，正面入库
    - SQ2 新颖性收窄：多级配对不变量（整线同 m）+ Kelvin 结构地板 + 可达性
    边界 + 门槛化流程；单级公式与定性带通分析归前人
    - go/no-go 门槛写入构思文档与 index：精读 SBAA230/Hornero 及其引文链，
    若配对不变量已被覆盖则 P1 降级为短文或并入 P2 仪器论文
2026-10-26 feat(paper): IMRaD 大纲 v2——按文献终盘重排（168 条/A 级 19 逐段落引用槽位）
    - 题名三候选（推荐含三贡献的 1）；四贡献与题名锁定不再增减
    - Intro 六段漏斗逐段配引用槽（时间线谱系→仪器 lineage→配方现状→学术三层→
    三问缺口→贡献）；Methods M1–M8 与 Results R1–R7 一一镜像
    - Discussion 四段（Hornero 建设性接续/Kelvin 地板普适义/四条出路/局限如实）
    - 图表规划（Fig.5 配对箱线=核心图）；写作顺序与 lint+面板门禁
    - 幽灵引用门禁：44 引用 key 全部对齐 bib（16 处规范；x1976stabili→lasertrim1976）
    - 构思文档 §C 降级 v1 历史并加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
2026-10-28 refactor(mcu): 换型 STM32U575RGT6 + 裁剪 I²C/TMP117 与 SD_PWR_EN
    U545RET6Q 立创库存归零（C20033865），改用 STM32U575RGT6（C5270980）。
    两片同为 LQFP-64，24–27 脚信号名不同但 PCB 走线一根未改。
    换型（依据 CubeMX DB 逐脚比对 + PCB 焊盘网络实测）：
    - 24 PC4=CURR_DIS / 25 PC5=PWR_BTN(WKUP5) / 26 PB0=SEL_K2 / 27 PB1=SEL_SENSE
    - 28 PB2、29 PB10 → NC（原 VLXSMPS/VDDSMPS）
    - 30 VCAP 须接 2.2 µF（板上 C4 已布）；31 VSS；32 VDD；33 PB12=VCC；62 PB9
    - 575 无 SMPS → E.10 #16/#17 的 REGSEL/降频流程整体作废
    - Flash 512 KB→1 MB、SRAM 274 KB→786 KB（升级）
    功能裁剪（用户 2026-10-28 决定）：
    - 不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
2026-10-28 docs: 首板贴 HSE + 充电 IC 改 BQ24074 + VDDUSB 不单独断电
    按用户 2026-10-28 三项决定更新文档（EDA 图纸本身未改）：
    1) HSE 16 MHz 首板实贴（X4 + C1/C2 20 pF + R1 1 MΩ 已布已贴）
    - E.7 由"免晶振、HSE 焊盘不贴"改写为"首板贴 HSE、MSIS 作备选"
    - **E.10 #16 关闭**（原红灯：IOC 用 HSE-PLL 但晶振不贴→PLL 锁不住）
    - 保留 CRS 约束：USB 走 HSI48 非 PLL 分频，必须 SOF 校准到 ±0.25%
    - 记录负载电容偏差：12 pF 晶振配 20 pF（实载 ≈13–15 pF，+10~30 ppm，
    对 SYSCLK 无影响；若日后切 USB 到 PLL 需改 10 pF）
    2) 充电 IC BQ24040 → BQ24074（采购换料，QFN-16 3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
2026-10-28 docs(charger): 按图纸实测修正 ISET/ILIM —— 串联链 2kΩ/3kΩ，E.10 #18 关闭
    定版图纸复查（113 网络 / 178 器件 / U10 全部 64 脚，经 EDA API 逐焊盘实测），
    与上次读数比对：U10 引脚零差异、网络零增删，图纸已稳定。
    修正一处文档失实（上轮凭电阻位号推断，未追踪串联链）：
    - **ISET(16) 不是 R2 1 kΩ，而是 R2+R9 = 2 kΩ 串联到 GND**
    - **ILIM(12) 不是 R8 1 kΩ，而是 R8+R10+R11 = 3 kΩ 串联到 GND**
    按 TI BQ24074 手册（SLUS812）核实系数后重算：
    - K_ISET = 890 A·Ω typ（797–975）→ **I_CHG = 445 mA**（398–488）
    - K_ILIM = 1610 A·Ω（500 mA–1.5 A 档）→ **I_IN ≈ 508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
2026-10-29 chore(repo): 忽略已拆出的 paper 独立仓库并更新设计文档指向
    - .gitignore 增加 /paper/：嵌套仓库的工作区不进入主仓库状态
    - 设计文档中的大纲路径改指独立仓库
2026-10-29 chore(repo): 记录 paper 拆分与历史重写
    原提交 76d5078「paper/ 拆为独立仓库」只删除 paper/ 下的文件，
    历史重写时被 --prune-empty 剪除。其内容已由仓库现状体现：
    paper/ 已迁至独立本地仓库（74 提交，完整论文历史），主仓库不再跟踪。
    本次同时按用户要求清理历史：
    - 删除 refs/codex/turn-diffs/checkpoints/* 两个工作树快照（各含 179/411 个 paper 文件）
    - filter-branch 从全部历史移除 paper/ 路径，186 -> 115 提交
    - 主仓库 .git 45.6MB -> 40MB，剩余均为固件头文件与设计图正常历史
    - 两个远程（Gitee origin / GitHub github）在上一提交后已删除
    - 历史 SHA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
2026-11-08 docs(architecture): record T0 baseline verification
    - working tree: DE-DRMS-Code untracked U575 firmware, HEAD 37be37e
    - tests 104/104 pass; postgenerate check clean; ARM build OK (text 120144)
    - map: 608KiB ring/staging buffers confirmed, ~693/768KiB static RAM
    - thread/stack/pool/priority inventory recorded for T1/T7
2026-11-08 feat(architecture): record boundary session with consistent capture boundaries (T2a)
    - drms_record_session: pure state machine for [B,E) window, loss attribution
    by boundary deltas, single-slot END with ack, 32-bit seq extension with
    provable-span rule, barrier/timeout/ring-watermark supervision
    - drms_acquisition: 64-bit stream accounting (sample_seq/raw_ticket/
    capture_lost_total/unknown_loss_epoch), generation, boundary request/
    service/get resolved only at DMA-quiescent instants
    - drms_logging: 64-bit log ticket for END.ring_end, enqueue result
    - 20 new host tests; full suite 146/146; ARM build clean
2026-11-08 feat(architecture): resource cancel/quarantine/recover lifecycle (T3)
    - drms_resource_lifecycle: IDLE/ACTIVE/CANCELLING/QUIESCENT/QUARANTINED per
    resource with injected backend hooks (bounded abort, quiescence probe,
    one-shot recover), injected-clock deadlines, snapshot
    - acquisition backend: inhibit excitation first, bounded HAL_SPI_Abort,
    late-DMA-callback safety proven by test
    - 13 new tests incl. timeout->quarantine, no recover loop, buffer not
    released on unconfirmed quiescence; full suite 159/159; ARM build clean
2026-11-08 feat(architecture): TF dual-axis ownership and MSC read handoff (T4)
    - drms_msc: owner state machine (LOCAL/EXPORTING/EXPORTED/RELEASING/
    QUARANTINED), FileX flush-close handoff with single-world guarantee,
    single in-flight read mailbox with generation/cancel and no slot reuse
    after timeout, IRQ-safe cancel, supervisor quarantine entry
    - drms_storage: consistent owner/health snapshot derived from card facts,
    capacity cache, raw sector read through the same SD driver entry
    - ux_device_msc callbacks wired: read via mailbox, writes refused, NOT
    READY unless exported, 512B block, last-LBA arithmetic
    - 10 new tests; suite 169/169; ARM build clean with drms_msc in
    Makefile+postgenerate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
2026-11-08 feat(architecture): user config/R0 transactional persistence (T5)
    - schema1 TLV encoding (little-endian, explicit IEEE754, zlib CRC32,
    4096B cap) documented in header; no struct-to-flash
    - A/B page snapshot commits: erase->program->verify->commit-flag->verify,
    power-cut at any step yields complete old or new snapshot
    - apply/save/commit_baseline with version gates; baseline commits config
    and R0 atomically; calibration-generation dependency invalidates R0 on
    load; future schema preserved and write-protected
    - linker ROM 1008K->992K + USERDATA 16K reserved; postgenerate synced;
    flash backend mirrors calibration pattern
    - 13 new tests; suite 191/191; ARM build clean, map within 992 K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
2026-11-08 feat(architecture): frozen v2 record format spec and dual-end codec (T2b)
    - spec: chunk framing, HEADER/DATA/END byte layout, zlib CRC32 params,
    file identification (v1 magic vs v2 chunk stream), error-handling table
    - C packers: header/data/end with per-chunk CRC, explicit LE encoding,
    unknown-end-boundary pseudo-exact-end refused
    - Python LogReaderV2 with full error table and v1/v2 dispatch
    - tests: hand-built golden file byte-identical to C output, cross decode,
    every-truncation and every-bit-flip, duplicate END, trailing bytes,
    v1 fixture compatibility; suite 199/199; ARM build clean
2026-11-08 feat(architecture): pure monitor pipeline modules (T6)
    - drms_filter: streaming first-order IIR with cached alpha, sticky warmup
    window over continuous valid nominal sample time
    - drms_classifier: ordered non-overlap interval table, direct cross-level
    candidate, hysteresis hold [lo-h,hi+h] (h=0 strict remap), candidate
    timer restarts on change/return, confirm_us=0 immediate
    - drms_baseline: Welford streaming stats with explicit quality params
    - drms_monitor: frozen C6 public API (init/configure/step/tick), context
    capped by static assert at published 4096B; tick is a read-only
    freshness overlay (NO_SAMPLE/TIMEBASE_FAULT/STALE)
    - 18 new tests; suite 217/217; ARM clean; modules free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
2026-11-08 feat(architecture): thread integration, boot monitoring and budget (T7)
    - drms_application: control arbiter -> record session -> monitor pipeline ->
    storage; boot auto-monitoring 4kSPS, recording opt-in only; B/E consistent
    boundaries resolved within one poll; END triggers log drain/close; ack
    returns to monitoring; measurement button = record overlay
    - STATUS exposes monitor state + freshness
    - wire control/record_session/capture_time/resource_lifecycle into build
    - RAM measured 697.6 KiB of 736 KiB gate; 608 KiB ring/staging unchanged
    - 6 integration tests (one ARM-map check deferred to T8); suite 223/223
2026-11-08 docs(architecture): T8 acceptance report with contract-to-test mapping
    - separate columns: design contracts / software gates / board gates / customer
    calibration; only first two are met
    - RAM 697.6 of 736 KiB with 608 KiB buffers unchanged; Flash within 992 KiB
    - board-test backlog ordered: DRDY-measured time anchor first
2026-11-08 fix(architecture): self-review findings in monitor and storage
    - drms_monitor_configure: reject interval_count > max, and stop copying the
    whole context onto the caller stack (main thread stack is only 4 KiB)
    - drms_msc_read: ownership check and slot claim now happen in one critical
    section so an IRQ-path cancel cannot strand a never-resolved request;
    failed reads always release the slot and report failure
    - drms_storage_begin_raw_access: initialize the SD driver for export reads
    (previously raw reads failed after the FileX handoff)
    - remove global cancel-epoch gate in service that kept demoting fresh exports
    - regression tests for all three; suite 225/225
2026-11-09 chore(firmware): include STM32U575 build dependencies
    Include the required STM32U575 device header as a user-approved exception to the 1 MiB pre-commit limit.
2026-11-09 fix(firmware): bind measurement freshness to captured samples
2026-11-09 feat(firmware): derive USB identity from device UID
2026-11-09 fix(record): bound v2 encoder stack and decode recorded data
2026-11-09 fix(record): preserve stop boundary and mark interrupted files
2026-11-09 feat(firmware): debounce local button gestures
2026-11-09 feat(firmware): build baseline from valid samples
2026-11-09 fix(storage): track media changes and invalidate capacity
2026-11-09 feat(protocol): publish and serve device status
2026-11-10 feat(recording): write v2 sessions with calibration snapshot
2026-11-10 fix(calibration): invalidate baseline when coefficients change
2026-11-10 feat(cdc): support reference calibration operation
2026-11-10 test(cdc): exercise calibration over protocol
2026-11-10 fix(recording): report interrupted finalization accurately
2026-11-11 feat(cdc): encode measurement event frames
2026-11-11 docs(host): describe device plan and integration status
2026-11-11 fix(clock): raise LSE drive for first-board startup
2026-11-11 feat(bringup): tolerate A02 enable readback and bypass card detect
    First-board bring-up findings, verified on hardware (171312-byte image,
    byte-identical flash verify):
    - ADS131A02 acknowledges the global enable write (0Fh) with 2F03h for its
    two implemented channels; the previous strict 0F0Fh comparison failed
    initialization. The datasheet value is still what gets written.
    - Add a bounded init exchange trace so ADC bring-up can be inspected over
    SWD without halting on every SPI frame.
    - Allow MSC_EXPORT/MSC_RELEASE while the device is stopped, so the card can
    be exported read-only without restarting acquisition.
    - Add DRMS_SD_DIAGNOSTIC_IGNORE_CD: this board's card-detect contact r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
2026-11-11 fix(msc): address whole medium and advertise read-only
    Read from the host was returning the wrong sector. The FileX SD driver adds
    fx_media_hidden_sectors to every address it is handed, which is correct for
    volume-relative FileX I/O but wrong for MSC, which addresses the physical
    medium. On the first board the volume records 2048 hidden sectors (1 MiB), so
    a host request for LBA 0 (the MBR) actually read sector 2048 of the volume.
    Hosts saw a capacity but could never parse a partition table.
    Read hidden_sectors over SWD on the running target: 2048, capacity_cache
    30717952, hsd1.SdCard.LogBlockNbr 30720000 -- the difference is exactly the
    1 MiB partition offset. drms_storage_raw_read now sub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
2026-11-11 docs(sd): record why card detect stays bypassed
    The socket CD contact never closes: PA15 is configured input with pull-up and
    still reads high with the card fully inserted, so the R46 path to ground is
    open somewhere in the socket. The user decided against reworking the socket,
    so the bypass is now a settled configuration rather than a bring-up leftover.
    Document the consequences where the two affected decisions live, so the next
    reader does not mistake the bypass for a missing configuration:
    - Card removal is no longer detected; a pulled card only fails at the next
    I/O, and MSC export will not revoke on removal.
    - SD initialization is attempted with no card present, so missing media
    r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
2026-11-11 docs(firmware): record measured high-rate acquisition limits
    Measured the whole rate ladder on the first board instead of assuming the
    configured rates are usable.
    4/8/16 kSPS are lossless. 16 kSPS ran 125 s continuously at 15.97-16.00 kSPS
    with spi_overrun, frame_drop and crc_bad all at zero and the reference
    reading 99.98-100.02 kOhm.
    32 kSPS and above do not hold. The main thread decodes, monitors and checks
    excitation for every frame; measuring the 32 kSPS run gives roughly 25 k
    frames/s of consumer throughput, below the 32 kSPS production rate. The 4096
    frame queue fills in about 0.6 s (19761 frames produced before the stop) and
    the firmware deliberately stops acquisition with adc_err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
2026-11-11 docs(firmware): record the pure raw-streaming ceiling
    Ran a bypass experiment (temporary macro, not committed) that skips per-frame
    decoding, excitation checks and monitoring inside a record window, so only the
    ring enqueue remains. This separates the two limits the earlier sweep
    conflated.
    Software ceiling is gone. 32 kSPS ran 13.5 s at a measured 32.1 kSPS with
    spi_overrun and frame_drop both zero, and no longer trips adc_error=6. The
    earlier 25 k frames/s ceiling was entirely the per-frame work, confirming the
    queue was never the problem.
    64 and 128 kSPS are blocked lower down. The edges counter still keeps up
    (measured 63.3 and 128.0 kSPS), but spi_overrun reaches 68% and 91% of the
    fr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
2026-11-11 test(acquisition): align stubs with bring-up behaviour and document SCLK limit
    Two test fixes left over from the first-board work: the ADC stub now answers
    0x4f0f with 0x2f03 to match what the two-channel A02 actually returns (the
    firmware tolerates that readback), and the control contract covers MSC_EXPORT
    while stopped, which ff3059f made legal.
    The SPI divider comment records where the SCLK ceiling comes from, measured
    against the datasheet rather than assumed: SPI1 runs off SYSCLK at 160 MHz and
    ADS131A02 permits tc(SC) >= 32 ns for a single device in asynchronous
    interrupt mode, so the fastest legal SCLK is 31.25 MHz. HAL only offers powers
    of two here, which puts /8 (20 MHz) safe and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
2026-11-11 perf(acquisition): raise lossless capture to 64 kSPS
    The generic HAL per-frame path revalidated the handle, recomputed both
    transfer counts, rewired four DMA callbacks and issued two HAL_DMA_Start_IT
    calls. At 128 kSPS a frame budget is 7.81 us and the SPI transfer alone takes
    4.00 us at 24 MHz SCLK, so that path did not fit and anything above 16 kSPS
    tripped adc_error=6 once the 4096-frame ring filled.
    Driving the two GPDMA channels and SPI directly instead is enough. Verified on
    hardware over SWD that after a transfer completes the peripheral keeps TSIZE at
    the frame length and stays enabled with CSTART clear, so the per-frame work
    collapses to: alternate the receive buffer, reprogram bot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
2026-11-11 docs: record 64 kSPS as the lossless ceiling and why 128 kSPS cannot work
    Read a batch of 128 kSPS frames back off the card to find out what the ADC was
    actually complaining about. STAT_1 came back as 0x12, i.e. F_DRDY | F_ADCIN.
    F_ADCIN is the bit this design already ignores by choice (AIN2N is tied to
    AVSS), so the one tripping DRMS_SAMPLE_ADC_FAULT is F_DRDY.
    SBAS590E defines F_DRDY as "data are not completely shifted out when new data
    are ready ... the DOUT output shift register is not updated with the new
    conversion result". That is the device saying it was not read fast enough, not
    that the link is corrupting bytes - the same batch has crc_bad = 0 throughout.
    Rejecting those frames vi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
2026-11-11 fix(acquisition): refuse rates above the proven envelope instead of wedging the ADC
    Driving the acquisition into 128 kSPS leaves the ADC unusable. Its STAT_1 comes
    back with F_DRDY set, meaning the output register was never read out in time,
    and once that has happened the device stops producing DRDY altogether: a later
    START reprograms it successfully - cmd_result is 0 and the rate field updates -
    but no further frames arrive, drms_acq_poll then reports adc_error=4 after its
    200 ms watchdog, and only an MCU reset clears it. Holding the analog rail down
    for 50 ms on the way out did not help, so the state is not cleared by a normal
    power-down cycle.
    Rather than keep chasing a recovery path fo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
2026-11-11 chore(hardware): keep the current EDA project and stop tracking the sim workspace
    The 嘉立创EDA project moves to the 2026-10-25 revision; the two 2026-10-24
    snapshots (V1.2, V1.4) are retired.
    hardware/sim is untracked wholesale. It had grown to 17 GB of LTspice working
    data, and everything in it is reproducible from the per-suite gen_*.py and
    run_all.py scripts, so keeping it in the repository cost far more than it
    bought. Its conclusions live in the design documents, not in the raw run
    directories. The granular ignore rules it used to need are replaced by one
    directory rule.
2026-11-11 fix(afe): invert the switch polarity so sample and reference are not swapped
    MEASURE was selecting the reference leg and REF was selecting the sample leg.
    SEL_SENSE low puts K4 on F, the reference side, so LOW is the calibration state
    and HIGH is the sample state; the firmware drove both lines the other way round.
    With no sample attached that showed up as REF reporting full-scale voltage on
    the measurement channel together with almost no current through Rsense
    (sense code 3376, i.e. 0.007 uA against a design 7.857 uA), so every sample was
    rejected as RANGE_ERROR and CAL could never collect a single frame
    (cal_count stayed 0).
    Both lines are still driven together in either direction: SEL_SEN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
2026-11-12 docs(acquisition): rewrite the module in Chinese with the history behind each rule
    First file of the readability pass. Every comment is now Chinese except for
    signal and peripheral names, and the file carries a header explaining where it
    sits in the machine, which two transfer paths exist, and the design decisions
    that must not be undone casually.
    The rules that were hardest to find are stated where they apply, with the
    symptom each one caused:
    - SPI is configured once, not per frame. SWD showed TSIZE and SPE survive a
    completed transfer, so rewriting them each frame was both redundant and the
    source of the UDR/OVR faults.
    - IFCR must be cleared every frame; a latched UDR/OVR refuses t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
2026-11-12 docs(application): explain the coordination layer in Chinese
    Second file of the readability pass. The header now maps the whole data path
    (command entry -> application thread -> resource arbitration -> record session
    -> monitor pipeline -> acquisition ring) and states the concurrency model, since
    that is what a reader needs before touching anything here.
    Function headers cover all 35 functions. The ones that carried the most risk:
    - pipeline_step_frame: documented as the machine's data-path fork. It first asks
    the record session what a frame is for, then splits on rate. Above 32 kSPS it
    is pure raw capture with no decode and no monitoring, and the three costs of
    that choice are writt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
2026-11-12 docs(storage): explain recording, session boundaries and the TF card in Chinese
    Stage two of the readability pass: the storage path from frame capture to file
    on the card. Densities went from 1.6/6.1/4.1/9.0% to 18.9/32.5/22.2/33.8%, and
    all functions in these four files now carry a header.
    drms_record_session.c carries the six-phase state machine, so its header spells
    out the phases and, more importantly, why a consistent capture boundary exists:
    without B and E there is no way to say which frames belong to a record, and
    therefore no way to judge whether anything was lost. note_recorded documents the
    four conditions that must terminate a record - duplicate sequence, a span too
    large to dis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
2026-11-12 docs(config,cdf): explain persistence and the CDC wire in Chinese
    Stage three. Densities: user_config 3.0->24.5%, cdc_v2 2.6->21.9%,
    cdc_frame 4.1->16.6%.
    drms_user_config.c is where the A/B persistence actually lives, so the header
    now explains why two pages exist (a Flash erase interrupted by power loss must
    not take the only copy with it) and the commit protocol: content, then a
    read-back check, and only then the commit quadword written separately and last.
    Anything short of that quadword marks the page invalid, so the reader falls back
    to the other page by construction - no journal needed. It also documents why
    unknown TLVs are retained verbatim rather than dropped: that is what lets a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
2026-11-12 docs: cover the remaining modules with Chinese headers
    Stage four closes the readability pass. Every remaining source file that had
    little or no commentary now opens with a header stating what it is for, where it
    sits relative to its neighbours, and the constraints a reader must know before
    changing it.
    The modules that carried real, hard-won knowledge:
    - drms_measurement.c explains the whole R = k * V_sample / V_Rsense scheme,
    including why Rsense's absolute tolerance cancels and the accuracy anchors on
    R_ref, why 0x6F masks out F_ADCIN on this board specifically, and that
    drms_rate_register is the single authoritative table of supported rates.
    - drms_classifier.c documents hysteres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
2026-11-12 fix(firmware): restore the HAL millisecond timebase and CDC push cadence
    实机定位到两个叠加的缺陷，都会让 CDC v2 的周期推送失真。
    1) 周期推送挂错了线程。
    SUBSCRIBE 成功但一条事件也不来。原因是 drms_cdc_v2_publish 排在
    接收线程的循环里，而接收线程用 UX_WAIT_FOREVER 阻塞在 cdc_acm_read
    上：订阅成功后主机通常不再说话，read 不返回，publish 一次都跑不到
    （实测 3 秒内调用增量为 0、事件数为 0）。移到发送线程后恢复。
    2) HAL 的毫秒时基慢了一个数量级。
    修好 1) 之后事件仍然只有 2 条/秒，而订阅周期是 100 ms；事件里的
    mono_us 每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
2026-11-12 docs(firmware): record the high-rate recording bottleneck and enlarge the FileX cache
    排查"高速档记录只写一小段就停"的结论，连同一次未奏效的尝试。
    机制已查清：会话层 drms_record_session_note_recorded() 有一条硬规则——
    记录环（32768 帧）写满即 fail_session(DRMS_INCOMPLETE)。这是有意的保守
    设计：环满意味着后续数据必然缺失，宁可如实标残缺。所以"写一小段就停"
    等价于"写卡吞吐跟不上采样率"。
    实测吞吐（records 增量 ÷ 时长）：4 kSPS 需求 62 KB/s、实测 ~82 KB/s，
    勉强跟上；16 kSPS 需求 250 KB/s、实测 ~96 KB/s；64 kSPS 需求 1 MB/s、
    实测 15–160 KB/s。吞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
2026-11-12 docs(protocol): mark CURVE subscription as implemented
    实机核对发现协议文档仍写"SUBSCRIBE/UNSUBSCRIBE 和周期性自动发送尚未接入"，
    但 ff2239a 已加入订阅、3b099c1 修好推送线程与 HAL 时基，设备 HELLO 也公布了
    opcode 64/65。
    实机验证（2026-11-12，4 kSPS 监测）：SUBSCRIBE stream=CURVE、period_ms=200
    返回 result=0 与实际周期，4 s 内收到 20 条 MEAS_EVENT、lost=0；stream=RAW
    或 period_ms=0 仍返回 INVALID。
    据实改写两处表述，并把长时运行、慢主机、断线重连明确列为尚未压力验收，
    不据短时单次结果外推。未改任何命令号、字段或固件代码。
2026-11-12 docs(design): ship referenced docs and diagram, fix broken link
    三份文档此前已被已跟踪文件引用却未入库，新克隆会得到断链：
    - 2026-11-04-firmware-implementation.md（README、主文档引用）
    - 2026-11-05-msc-plan.md（固件架构引用）
    - diagram/固件任务架构.svg 及其生成器 _lib/gen_固件任务架构.py 与 @2x.png
    （README、固件架构引用）
    生成器已在临时副本复跑，SVG 与 PNG 与现有文件逐字节一致（md5 相同），
    且图检 tools/svg_schematic_check.py 通过。
    另修 E.3.1 一处错链：链接文字是"模拟前端与自校准.svg"，URL 却指向已于
    2026-10-17 合并删除的"自校准与零点电路.svg"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
2026-11-12 chore(firmware): remove the retired U545 project
    firmware/DE-DRM/ 是 STM32U545RET6Q 时期的旧 CubeMX 工程与全部生成源码。
    2026-10-28 因 545 缺货换型 U575，工程已在 2026-11-03 重建为
    firmware/DE-DRMS-Code/，磁盘上旧目录早已不存在。
    AGENTS.md、CUBEMX_SETUP.md 与架构收敛计划都已把该目录描述为"已删除，
    仅存 git 历史"。本次只把这批已发生的工作区删除落到版本库，使新克隆
    的文件树与文档描述一致；历史仍可从 git 取回。
    纯删除，无内容改写。
2026-11-12 docs: sync top-level status with the current firmware
    三份入口文档还停留在旧工程与旧结论，与当前代码和实板结果不符：
    - AGENTS.md：必读清单指向已删除的 firmware/DE-DRM/CUBEMX_SETUP.md，
    仓库结构表仍写旧目录"有效、尚无生成源码"。改为 DE-DRMS-Code 并补双远端
    同步规则。ADC 行原写"冲击全程 128 kSPS 采满"，与 2026-11-12 实板结论
    冲突（64 kSPS 才是无损上限，128 kSPS 已被入口拒绝），据此加注限制。
    - README.md：顶部状态停在 2026-10-24"固件、上位机尚无"，正文列着一批
    已销号的未决项。改为当前器件与已实现能力，并写明 128 kSPS 不可用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
2026-11-12 docs(design): stop linking to the untracked simulation tree
    hardware/sim/ 于 2026-11-12 被 .gitignore 整体排除（膨胀到 17 GB，可由
    各套件 gen_*.py / run_all.py 重跑再生）。但设计索引与主文档仍用 markdown
    链接指向其中的 AAF 六方案报告，新克隆会得到断链。
    改为纯文本路径并注明该目录不入库、可重跑再生，报告结论本身仍留在正文，
    未删任何证据或数值。
2026-11-12 docs(firmware): record the 2026-11-13 bench stress results
    台架条件：模拟前端开路（excitation_ok=0、样品通道顶正满量程）、无电池、
    USB 供电、单张 14.6 GiB 卡。只记录实测，未改固件。
    通过：互斥（记录拒导出、导出拒记录）、CURVE 订阅四档周期（偏差≤2%、
    lost=0、重连不继承）、干净复位后 16/32 kSPS 连续记录（498,725 / 992,362 帧，
    计数全零）、文件 HEADER 的 UID 与 CRC32 校验。
    四个新问题：
    1. 64 kSPS 长时记录约 5 分钟后 log_drop=1，记录如实报 INCOMPLETE /
    unknown_loss。根因是记录环排空不及时被填满；adc_error 与 spi_overrun
    均为 0，说明瓶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
