chenxi-z/de-drms/(notices)

Notices in the files:
firmware/DE-DRMS-Code/USBX/App/ux_device_msc.c:
Copyright (c) 2026 STMicroelectronics.
All rights reserved.
This software is licensed under terms that can be found in the LICENSE file
